Valpatel/gyropup/software/README.md

# Software

Code that controls the robot, runs experiments and presents the project. Firmware belongs here alongside its host tools.

| Home | What belongs here |
|---|---|
| [firmware/](firmware/) | Balance and turret firmware; the Feather rig node |
| [control/rig/](control/rig/) | CAN drivers, bridge, calibration and bench control |
| [simulation/](simulation/) | Robot, leg and turret models and numerical studies |
| [learning/](learning/) | Learning environments, training and learning-owned vendor fixtures |
| [site/](site/) | Browser application and website assets |
| [deploy/jetson/](deploy/jetson/) | Checkout-based Jetson installation and services |

[Contributing](../.github/CONTRIBUTING.md) explains checks and previews. [Physical progress](../docs/program/physical-progress.md) records what is actually received, printed and tested; software results do not establish hardware qualification.
