Valpatel/gyropup/tools/README.md

# Tools

Project commands grouped by their job. Run them from the repository root; heavy CAD, builds and simulations use the recorded remote-run procedure.

| Home | Purpose |
|---|---|
| [engineering/](engineering/) | CAD builders, studies, drawings and robot/leg/turret/rig helpers |
| [evidence/](evidence/) | Manufacturing packages, media and interface evidence producers and guards |
| [site/](site/) | Allowlisted website build, source locations, previews and publication checks |
| [acquisition/](acquisition/) | Supplier input acquisition and quoting |
| [audio/](audio/) | Pronunciation, recorded voice and voice-service tools |
| [operations/](operations/) | Repository and deployment operations |

[Tests](../tests/README.md) are separate from producers. A successful command does not itself qualify a physical part or release a print package.
