Valpatel/gyropup/docs/dossier/README.md

# Turret dossier sources

Start with the [current location and evidence guide](../turret/turret-sections.md#the-dossier-cad-agents-process).

- [Project requirements and interfaces](project.yaml)
- [Section cards](sections/)
- [Decisions](decisions.yaml) and [gate declarations](gate-declarations.yaml)

These are source declarations, with unresolved engineering acceptance. Existing geometry/status/gate records
are historical and include failures; current reconciliation remains in [program #31](https://github.com/Valpatel/gyropup/issues/31).
This folder is readable on GitHub and stays outside the generated site's document and download listings.
