Valpatel/gyropup/.agents/plans/owning-hierarchy/README.md

# Owning hierarchy migration — 2026-11-06

Working implementation under [#219](https://github.com/Valpatel/gyropup/issues/219), based on dev776d5f44 (tree equal to reviewed949b73c2). Independent map review accepted isolated implementation; final source/artifact/CI review remains required. The staged move set reduces25 root entries to15: eight conventional anchors and seven homes (.agents, .github, docs, hardware, software, tests, tools). No merge or runnable-state claim follows from a rename.

[Every tracked file](complete-file-destinations.json) has a collision-free destination. [Direct ownership](direct-file-ownership.md) explicitly groups CAD73/docs64/tools136. Supplier SOURCE/raw/normalized/frame/page bundles stay together under hardware/vendor; firmware/control/site/simulation/learning belong under software. Existing physical specs, CAD source and generated manufacturing evidence remain separate children. Docs is the reading entrance; tools and tests have populated owning domains, not flat catch-all lists.

[Service contract](service-contract.json) retains checkout deployment and fixes software.control.rig with explicit regular parent packages and actual module-origin proof. It preserves nine existing public bridge URL boundaries through a source whitelist, never a broad software directory root. [Supplier reconciliation](ignored-vendor-reconciliation.json) records211 ignored inputs without copying them; they remain unpublished with their acquisition/license/provenance boundaries. Learning vendor fixtures remain learning-owned. [Original-work reconciliation](original-work-reconciliation.json) maps and hashes200 dirty/untracked paths without adopting their payloads or touching the original checkout. The user authorized recovering paused work; missing old leases are not an indefinite permission block.

One atomic final-layout source/consumer migration is chosen because CAD reads firmware, catalog/designs, references and research; manufacturing and media receipts bind those producers. Preserve former CAD-test closure members when their tests move. Map actual producer/control commands and inputs/outputs before heavy work, run genuinely required generation/capture/slicing at the final source head, and retain failures. Old reports/ZIP/media retain their original identities and historical scope. Never reseal or weaken a guard to obtain green.

The initial2550 moves preserve every moved file byte. Imports, root discovery, project/workflow commands, publication identities and source-bound products are subsequent implementation work; this first stage is not runnable or merge-ready. Root-owned compact navigation237 is integrated normally before changing its visual files. Public source/route identities are preserved explicitly; all new private/vendor/learning homes require real all-output exclusion and sibling/link controls. #31/#219 and physical fit/run/material/HIL gaps remain open.
