Valpatel/gyropup/software/firmware/balance/README.md

# firmware/balance: Gyropup's balance controller (Nucleo-G474RE)

C for the STM32G474RE: three FDCAN buses at 1 Mbit/s (the legs' RS-04s on A and B; the VESCs and the J501 on C), the
VN-100 at 800 Hz, the INA228, the radio stop's sense and MCU_RUN, and a 1 kHz loop ported from `sim/controller_v2.py`,
with the 10S pack's windows (D65: warn, sit, the 3.0 V a cell cut-off, the jump gate; all in `include/gp/gp_config.h`),
the bus current limit, the Jetson's heartbeat and the people-near caps.
**docs/body-firmware.md** is the reference: architecture, timing, every CAN message, the safety numbers, the pins.

| Path | What |
|---|---|
| `include/gp/`, `src/core/` | the portable core: the law, the five-bar, the devices' protocols, the supervisor (no HAL) |
| `include/gp/gp_model.h` | generated by `tools/gen_model.py` from `build/sim/v2` (do not edit) |
| `src/mcu/` | the Nucleo: clocks, FDCAN, UART + DMA, I2C, timers, watchdog, `main.c`; the linker script |
| `src/host/` | the core as `libgp_host.so` for the HIL |
| `cmake/` | the arm-none-eabi toolchain file; ST's HAL and CMSIS fetched at configure time (pinned, hash-checked) |
| `tests/` | the core's unit tests (CI) |
| `hil/` | the HIL on the leg rig's emulated RS-04s and MuJoCo rig, and the robot run; `hil-results.json` its numbers |

```
cmake -S firmware/balance -B build/fw-mcu -DCMAKE_TOOLCHAIN_FILE="$PWD/firmware/balance/cmake/arm-none-eabi.cmake"
cmake --build build/fw-mcu                         # balance.elf / .bin / .hex
cmake -S firmware/balance -B build/fw-host && cmake --build build/fw-host && ctest --test-dir build/fw-host
GP_FW_HOST_LIB=build/fw-host/libgp_host.so python -m pytest firmware/balance/hil -q   # needs MuJoCo; build/sim/v2 for the robot
```
