Valpatel/gyropup/hardware/exports/rig/sendcutsend/README.md

# Carriage plate: the SendCutSend order

Generated by `cad/build_rig.py` with the plate it describes. Upload one of the two files; both are the same plate.

| | |
|---|---|
| Files | `carriage_plate.dxf` (flat, mm, 1:1, one layer, no text) or `carriage_plate.step` |
| Material | Aluminium 6061-T6, 0.250 in (6.35 mm) |
| Size | 300 x 320 mm, 6 mm corner radii; 1.611 kg |
| Quantity | 1 |
| Finish | Deburring on (both faces carry parts); no anodise, no powder coat |
| Operations | None: every hole is a clearance hole (no tapping, no countersinks, no bends) |
| Units check | The upload must read 300 x 320 mm (11.81 x 12.60 in); if it reads 25.4 times too big or small, re-upload in mm |
| Price | The instant price shown at upload (D40: no quotes); the estimate is $60-90. Backup: Xometry, instant price from the STEP |

## The holes (plate coordinates: the hip axis at 0, 0; x across, z up; seen from the front)

| Holes | Size mm | Where (x, z mm) | For |
|---|---|---|---|
| 6 x M5 clearance | 5.50 | (-83.0, 70.0); (0.0, 70.0); (83.0, 70.0); (-83.0, -70.0); (0.0, -70.0); (83.0, -70.0) | the hip frame's six flange inserts (M5 x 16 + washer from the back) |
| 16 x M4 clearance | 4.50 | (-33.0, -138.0); (-33.0, -112.0); (-7.0, -138.0); (-7.0, -112.0); (-33.0, 112.0); (-33.0, 138.0); (-7.0, 112.0); (-7.0, 138.0); (7.0, -138.0); (7.0, -112.0); (33.0, -138.0); (33.0, -112.0); (7.0, 112.0); (7.0, 138.0); (33.0, 112.0); (33.0, 138.0) | the four HGH15CA blocks (M4 x 10 from the front, into the blocks) |
| 2 x 3/8 in clearance | 10.50 | (-138.0, 40.0); (138.0, 40.0) | the two ballast posts (3/8-16 x 1 in from the front) |
| 1 x pin hole | 10.20 | (125.0, 140.0) | the drop test's quick-release pin (S4) |
| 1 x tether hole | 12.50 | (-125.0, 140.0) | the carriage tether's screwgate carabiner |
| 2 x M4 clearance | 4.50 | (-138.0, -104.0); (-138.0, -136.0) | the ToF target arm |
| 1 slot | 32.0 x 22.0 | (127.4, 22.4) | the front motor's lead (XT30 and GH plug) |
| 1 slot | 32.0 x 22.0 | (-131.3, -9.1) | the rear motor's lead (XT30 and GH plug) |

## On arrival

- Measure the thickness (6.35 mm, +-0.25) and the outline (300 x 320).
- Hold an HGH15CA block on each group of four M4 holes: the four screws must start by hand.
- With the hip frame's inserts set, the frame sits on the plate with all six M5 screws starting by hand (5.5 mm holes).
- The harness slots pass an XT30 plug and a GH plug together.
