Valpatel/gyropup/.agents/domains/mechanical-release.md

# Mechanical release coherence

Review entry point: [mechanical readiness](../../docs/architecture/mechanical-readiness.md). Keep CAD source, selected hardware, installed instances, public meshes, print files and instructions bound to one explicit configuration. Imported reports remain historical until the affected geometry and gates are rebuilt on that configuration.

`cad-agent check` reads existing reports; it is not a CAD rebuild. Run the appropriate geometry build and affected gates on the committed candidate, record source/toolkit/input/output hashes, and inspect the evidence. Keep visual completeness, assembly/clearance, fabrication readiness and physical acceptance separate. A valid solid, a successful render or an unchanged bearing boundary does not establish the other outcomes.

For articulated exports, review both conflicting and automatically merged coordinate conversions. Every cartridge-to-joint conversion is applied once. Verify actual rendered vertices against independent mechanical datums after regeneration, including attachments and effects. Preserve archived geometry for its recorded trajectory.

Portal coverage checks must compare complete identities against the served revision and BOM, rather than a hard-coded historical count. New components require their own matching geometry and thumbnail receipts; do not suppress a missing-image failure because the older release looked correct. Keep private manufacturer CAD private and identify public authored representations honestly.

Assembly verification includes preassembly, tool access and service/removal in the finished machine. A checker that only fits individual parts cannot certify a preassembled module merely by rearranging its steps. Require explicit module evidence until generic tooling can express the actual sequence. Continue to report unrepresented cables, missing measurements and unperformed physical trials.

Print packaging must use verified immutable input copies, bind resolved slicer profiles and the actual executable, reject failed/non-finite results, and derive totals only from accepted rows. Geometry-file coverage, successful slicing and physical qualification are separate states. See [the packaging incident](../inbox/2026-10-29-print-preflight-is-not-a-generation-transaction.md) and `tools/test-print-provenance.py` / `tools/test-print-packaging-mesh.py` for adversarial controls.

Resolve included printer templates as well as inheritance, and retain the actual sliced archive and G-code. Verify executed thermal waits, machine/material mapping and sliced placement; a filament label or successful time estimate can coexist with wrong startup commands. See [the included-template incident](../inbox/2026-10-30-slicer-includes-control-executed-temperatures.md).

An updated generator does not label already-published historical print files or instructions. Check direct document links and portal consumers of old print metadata, place historical status before actionable instructions, and distinguish a current bounded coupon package from an archived full kit. Keep the component register and readiness summary aligned with completed reviews and still-open qualifications. See [historical print-page status](../inbox/2026-10-29-historical-print-pages-need-local-status.md).

When withdrawing a torque, dimension or qualification claim from a generated page,
correct and test the generator as well as the published prose. Preserve source
closure rules even for prose-only CAD-directory edits; do not re-sign older reports.
See [withdraw instructions in the generator too](../inbox/2026-10-31-withdraw-instructions-in-the-generator-too.md).

Detailed thread models need source-bound mating clocking, not a generic intended-overlap waiver. Sampling may diagnose phase but cannot establish complete mating; a timed-out global check stays inconclusive. Keep seating, holes, engagement, tip clearance and physical insert coupons separate from that diagnostic. See [thread sampling limits](../inbox/2026-10-29-thread-sampling-does-not-qualify-mating.md).

Every insert joint and every printed part clamped by metal is screened in `research/insert-joints/` (pilot vs the
maker's hole and depth, screw tip vs a blind pilot's floor, boss, layer orientation, clamped plastic, pull-out from the
studies' loads). Regenerate it when a bound source line changes. A new layer in a screw stack needs the receiving
pilot and the contract's datum re-checked on both sides of the interface. See [the TM bottoming lesson](../inbox/2026-11-01-a-new-layer-in-a-stack-needs-the-receivers-pilot.md).

Insert-fit specimens must preserve their parent's local geometry and print orientation. A vertical carrier boss and horizontal base anchor need separate measurements. Record requested recipes, actual process conditions and physical observations independently; geometry-only3MF packages contain no slicer settings. See [the specimen orientation lesson](../inbox/2026-10-29-fit-specimens-must-preserve-layer-orientation.md) and `research/carrier-insert-fit/`.

Motor fasteners require actual head-seat and mounting-face measurements against the
manufacturer screw, followed by the drawing's usable-thread constraint. A deeper
STEP drill hole does not enlarge that constraint. Preserve the full parent stack
in mounting coupons and review neighboring rotating parts before changing seats.
Nominal reserve and engagement are not physical tolerance or thread-strength proof.
See [the RS-04 mounting incident](../inbox/2026-10-29-lug-depth-needs-measured-seats.md).

Treat an axial fastener-support screen as its stated geometric assumption, not
as a contact/preload solution. An interrupted ray may require a load-spreading
study; adding a washer or quoting a scalar FEA safety factor does not supply it.
Keep failed screens and unknown tightening loads explicit until suitable evidence
resolves them. See [axial support and local contact](../inbox/2026-10-30-axial-support-is-not-a-contact-model.md).

Small labels and narrow walls need inspection in actual deposited toolpaths;
source mesh preservation does not prove feature deposition or readable markings.
Keep missing-feature limits and blank physical measurement records explicit.
See [the shaft-gauge label incident](../inbox/2026-10-31-inspect-deposition-of-small-gauge-labels.md).
