Valpatel/gyropup/hardware/carrier-packaging/electrical-envelope.md

# Electrical inventory and packaging constraints — work in progress

This document owns the electrical side of [issue96](https://github.com/Valpatel/gyropup/issues/96). It does not change the native circuit or fabrication geometry. The source contract remains 15–20.5 V stand /30–42 V robot input, 12 V PAN output and a 3.25 A screening load; charged-front-output and transient bounds remain unqualified.

The initial reproducible inventory contains **47 electronic items**: 28 retained cutoff/converter candidate parts after replacing its series diode, all ten items in the LTC4359 Figure10 reference network, and nine legacy control-board parts after replacing the old converter. It is deliberately **not** a complete physical BOM yet: harness protection, actual junctions/terminations, connectors/contacts, retention and the heat path must also be assigned. [Inventory](component-inventory.json), generated by `python hardware/carrier-packaging/inventory.py`, binds the current reviewed circuit, legacy component source and catalog. P.*, I.* and L.* keep the three designator namespaces separate.

## Physical negotiation

Prefer retaining the entire PAN electronics with the removable carrier. The existing control board remains occupied; no schematic placeholder or old U2 reservation supplies extra area. An initial 18 mm assembled-height budget is a design question, not a measured envelope. No contour or physical stack is frozen.

The mechanical author's source inspection found that the current parked C3 body **and its mandatory 19.1 mm straight wire exit** obstruct a tall +Y addition during +X withdrawal. Lowering the entire board below that reservation is not sufficient: the fixed pan-base drip skirt occupies Z0..18 and is also crossed during withdrawal. These are concrete constraints on this service path, not proof that every possible layout fails.

A single alternative is being negotiated: a 90° turn of the fixed C3 housing at the outboard service position before inward parking, paired with a trial electronics region X4..48, Y53..93, Z23..41 mm. This **44×40×18 mm overall region is not allocated or validated space**. It extends beyond the current bumper; full cable, retention, seated/removal/parked geometry and thermal constraints remain to be checked. Components must be placed with real lands, per-side heights, mounting and terminal zones before accepting any board dimensions. The manufacturer's 40×40 mm thermal example is not the proposed outline's justification.

## Verified package evidence collected so far

[Primary source record](primary-envelope-sources.json) preserves observations and limits. Exact part bodies, manufacturer solder recommendations, optional library courtyards and additional design clearances must remain distinct.

- Panasonic EEUFC2A220: exact 8×11.5 mm nominal case; FC drawing tolerances give **8.5 mm maximum diameter and 12.5 mm maximum body length**, before lead/mounting and vent clearances. This exceeds a casual nominal-height-only model.
- Pololu5577: the manufacturer drawing distinguishes **6.1 mm above the PCB, 1.57 mm PCB thickness, and 1.4 mm below it** for items5570–5577. All three regions matter; profile tolerances are not supplied. Twelve electrical holes and three mounting holes require separate orientation/numbering and access checks. A zero-bottom-height box is invalid.
- TNPW0805: maximum body **2.1×1.4×0.55 mm** from the current manufacturer drawing; land recommendations are a separate input.
- WSL2512 10/20 mΩ: maximum body **6.604×3.434×0.889 mm**; the manufacturer's applicable land row gives **7.36×3.68 mm** total span. Shared Kelvin endpoints and copper routing remain additional constraints.

## Open source and interface gates

The actual LTC4359 Rev F PDF and Figure10 pixels have now been inspected independently by three agents. [Reference contract](front-reference-contract.json) binds the document and rendered schematic/pin-page hashes, exact physical U1/Q1 pin identities and every diode polarity. No new native circuit is generated. The floating VSS is separate from system GND. The 47 nF capacitor returns to floating VSS; the separately drawn CLOAD returns to system GND. The retained P.C1 sits **after the cutoff pair**, so it cannot be treated as permanently connected front-output capacitance. The front load's effective capacitance/leakage by cutoff state remains a circuit-validation obligation.

The DCB6 exposed pad is electrically NC in this paper proposal, following page11's guidance to increase effective spacing above 30 V. Pin6 still returns to floating VSS; the physical exposed metal is not omitted from the land envelope. Actual creepage, contamination/leakage and thermal behavior remain unresolved. The SHDN pin remains open as drawn in Figure10, with its leakage condition visible. This is not approval to route a compact high-voltage board merely because the IC fits.

[Package records](package-envelopes.json) currently provide primary evidence for all 47 electronic items; they distinguish maximum body dimensions, nominal module profiles and manufacturer lands. They do not establish a complete footprint/terminal inventory or a placement. Newly bound records include exact Diodes SOD523/SOD123/SMA variants, Vishay high-power1206 and Yageo axial resistor families. KEMET reflow pad extents are recorded separately from its larger placement courtyards; through-hole lead forming and solder stacks remain unresolved. The Panasonic valve requires at least 2 mm of free space: its upright maximum body plus valve allowance alone is 14.5 mm, before mounting, PCB, underside solder and insulation. The18 mm trial stack therefore cannot be accepted from nominal component heights.

The mechanical investigation now also holds the region on the bumper teardown sequence. The existing C3 support obstructs a pure upward rigid bumper lift, while some carrier/support fasteners require the bumper removed for the currently modelled straight tools. The proposed electronics overhang adds an obstruction. No new board placement is frozen while a viable rigid teardown path or explicit retention redesign is missing.

The conditional CJT A2505 servo connector from the previous carrier note has a **3 A family rating**, so it does not yet satisfy the current 3.25 A screening contract. Its OEM conductor/cavity mapping is also unverified. Do not allocate its envelope as a qualified final servo termination. Shared C2/C3 BUS remains raw BUS_HEAD_FUSED; protected PAN_INPUT must never become the slip-ring bus. CAN and TTL bypass routes still require actual endpoints and insulated retention; no unassigned pad strip can stand in for them.

Next: resolve the remaining formed-lead/delivery specifications and physical terminations, resolve the mechanical teardown gate, then create one explicit component/terminal assignment and per-side stack in agreement with the mechanical envelope. No new native circuit/CAD, purchase, powered test or fit/thermal qualification is produced by this inventory checkpoint.

## Reproduce the current bounded checks

Run `python hardware/carrier-packaging/inventory.py`, then `python hardware/carrier-packaging/allocation.py`, `python hardware/carrier-packaging/check.py` and `python -m unittest discover -s hardware/carrier-packaging -p 'test_*.py'`. Twenty-three tests include dropped/duplicate items, stale source or dimensions, improper readiness promotion, reversed clamps, grounded floating reference/capacitor and mistaken direct load-capacitor assignment, protected-PAN substitution on the raw C3 bus and a 24 AWG wire substituted into the original 28 AWG ring contact, and an omitted existing shunt lead at a junction. Exact unique interface IDs, every pin/net, all bypasses and junction members, endpoint agreement and legacy/protection ports are required before totals; deletion, substitution and duplicate controls cover each group. These are inventory/reference controls, not EDA/ERC, physical collision, thermal or waveform validation.

## Complete external net inventory, physical terminals still open

The [terminal contract](terminal-contract.json) enumerates all 21 external connector positions, three continuous CAN/TTL bypasses, the raw BUS and return junctions, the protected12 V split, nine legacy control components and adjacent F4/D8/D14/fuse-holder obligations. This is a net-to-endpoint inventory, not21 invented solder pads. Every source/return junction, physical protection-board termination, reset interface and strain-relief location remains unallocated.

The fixed C3 female43030-0010 contacts belong to the original 28 AWG ring leads; the removable male43031-0001 contacts use24 AWG tails. There is no existing24 AWG-to-female0010 qualification. Root's Alpha6712/6716 wire candidates have manufacturer5D bend figures, recorded with their exact maximum diameters and limitations. They are not selected substitutions for Pololu/Remington wire, do not define repeated-flex life, and do not change the fixed ring lead or its contacts.

## Obtainability is a dated source record

Each applicable inventory row now links the exact same-day reviewed supplier observation by source-file hash and row index. These are carried forward from the 2026-10-29 protection and architecture records; they are not a newly refreshed or reserved stock claim. Critical examples are LTC4368IMS-2#PBF (1,295 listed; one-piece tube offer), LTC4359IDCB#TRPBF (1,712 listed; cut tape; factory10 weeks) and IPB200N25N3GATMA1 (10,794 indexed; cut tape; factory52 weeks). See the linked records for exact URLs, price, pack quantities and limits.

The actual build supply remains unresolved: DDZ9699T-7 had only one cached Mouser item with refresh403 and zero DigiKey stock; Pololu5577 is rationed with no confirmed count/lead time; several exact resistors have uncertain stock or packaging. COUT now carries the exact C1206C473F1GECAUTO as an **unselected packaging candidate**:47 nF,100 V,1%,C0G, with a bound maximum body and manufacturer land record. The actual OUTsense-to-floating-VSS waveform, maximum clamp, pulse and temperature limits are unknown. A 75 V zener label does not establish a 100 V capacitor pass; a changed required rating/body requires replacement and renewed placement review. Its qualified selection remains null. No substitute, carrier/catalog selection, purchase or procurement pass is produced here.

The exact MF-R300 drawing supplies a 12 mm maximum width, 18.3 mm top-to-coating-end span and 3 mm thickness. Its bare lead length is only a minimum, and the installed flat form is not dimensioned. The legacy 12×14×3.5 mm box therefore does not establish actual fit. Its guaranteed hold-current table also drops from 3 A at 23°C to 2.04 A at 60°C; the 3.25 A load screen does not establish continuous operation through this unchanged F1. No fuse or circuit substitution is made here.

Littelfuse SMCJ150A dimensions are visually bound to the authorized 2020 mirror, with 2025 text-only corroboration distinguished. Overall terminal span8.13, width6.22 and height2.62 mm use the correct axes. Its solder dimensions combine minima and a maximum gap:9×3.3 mm is a proposed pattern, not a manufacturer maximum. Source-axis/minimum-versus-maximum negative controls preserve these distinctions.

## Retained control-board envelopes also need correction

Retaining the control function does not validate its old drawn boxes. The source-bound `cad/turret_boards.py` currently uses these simplified reservations:

| Item | Existing reservation | Exact-source limit | Contract consequence |
|---|---|---|---|
| NE555P | DIP8 height4.5 mm | TI PDIP maximum5.08 mm above its seating plane | Reserve the larger height plus actual mounting; the old box is not a complete body bound. |
| R3 RSF100 and D1 group | Height3.5 mm | RSF100 maximum body diameter5 mm | A horizontal resistor can exceed the group height before lead stand-off; actual placement and clearance remain open. |
| F1 MF-R300 | Flat12×14×3.5 mm | Manufacturer dimensions include an 18.3 mm coated span and only a minimum bare lead length | Define and validate the formed part; no flat installed maximum follows from the source. |
| R1/R2/C2/C3 group |12×5×6 mm combined box | Exact individual bodies and lead forms have separate limits | Assign every body, formed lead and pad; a group box does not prove four-part packing or routing. |

These are reservation mismatches or missing assembly evidence, not demonstrated collisions. The global11 mm legacy board height limit, tool access and solder-side space still need evaluation using real component placement. The new power-board proposal cannot silently consume the old converter box, retained control area or unallocated termination strip.

The bounded [paper allocation](paper-allocation.md) assigns all 47 electronics and lists every proposed control/power wire pad. Membership, omitted ground wires, net substitutions, erased vent/underside space and invented zero tolerances are rejected. This remains an allocation proposal without actual component placement.

The final TDK FG24 record binds the actual 2024 family drawing and exact part row. Its5.5 mm dimension reaches a formed-lead datum, and its bent leads extend outside the 4.5 mm coating width. The family pitch range4..6 mm conflicts with the older individual-sheet text range4.8..5.8 mm; both are retained by revision, and delivery-specification selection remains open. S1B uses the actual Rev24-2 SMA maximum height2.40 mm, not the older2.30 mm or neighboring SMB row. Copper land extents do not replace the complete part/lead envelope.
