Valpatel/gyropup/.agents/plans/end-packs-poster/plan.md

# Capture a fresh poster through the actual current hero hook

Source-only preparation, 2026-11-10. This branch starts at the model owner's
composed6dd7944b (reviewed media sourcec12 plus campaign target correction).
It owns only `tools/site/render-hero-poster.mjs`, focused CLI/output/identity tests
and this guidance. The renderer, current authority/converter/data, motion test,
reel source, README291 and CI fixes remain with their owners.

The existing producer captures `window.__heroPreview.capturePoster(1024)` and
hard-writes the public robot-poster.png. The hook itself is already the desired
single renderer: it restores the source `robot.info.homeHeight`, zero explosion,
reference camera/lighting and actual render. Current266 computes115/190 and hence
legMM300. Preserve that implementation; do not draw or pose a second model.

Prepare a required `--output` seam with a fresh exclusive file outside the source
checkout, reserving before any browser and preserving a failed partial rather than
truncating an existing file. Make its CLI/output checks import-safe and testable
with Node builtins only; no browser or package installation is required. Reuse the
reviewed reel checker's pure current-byte contract before a real launch, and bind
the actual hero identity/224source names/sourcehome300 and applied base position
before writing a successful image. Keep the historical acknowledgement helper exact.

The static poster must use the canonical300mm home through the existing hook.
The reel deliberately animates variable height/roll/sway; current demo center.6
maps to299mm before authored variation. Root explicitly chose to preserve that
animation, not alter product behavior for1mm. Record actual pose values and limits
per action; shared body/battery/printed-leg/native authority does not mean every
video frame has the static poster pose.

Future action preconditions: complete corrected current motion campaign and
independent acceptance; exact composed source review; separate committed current
manifest/authority adoption; fresh byte/source/runtime/capacity checks; exact
one-action packet review. Native3a, collection7c2f1905, manifest31838706 and all80
printed-leg identities must remain unchanged. Default null authority still blocks
new capture. Chrome's earlier2e90 test target filename failure and its partial
geometry samples remain a failed campaign, not media/capture acceptance.

Use the existing ephemeral server and actual browser, PNG hook, fixed-step reel
recorder, FFmpeg encoder and validators. No new framework, geometry, physics,
installer or public adoption. Proposed separate poster phase90s and full reel
capture20min/encode10min/validation5min inside45min4CPU/8GiB rendering action are
bounded proposals, not measured new-model timings or execution permission.
Historical rig/E1 inserts and original dated source/receipts remain exact.
