Valpatel/gyropup/.agents/plans/hip-study/geometry-interface-proposal.md

# Issue 8: geometry/interface-only preparation proposal

Status: read-only proposal, not source or execution clearance. The published baseline is main cacdc2e3e8ce2ed40d0b8a2369aa5455b149f65a (tree f444d949eeaa0c8f127be02b87a04f10a0ae83d4, hardware 89ae8db4a748d5b19893293fbef3c1d49eeccc2f). PR261/262 repairs only input preflight; actual production and remote retirement are independently accepted. All exact-main workflows are independently accepted SUCCESS at issue #8 comment 6714250623. No CAD source has changed and no new native run has occurred.

The current E1 result remains SF 1.60 against 2.00 required. The retained 3 mm E1 gate is 1.40 and its y-layer screening result 1.36; R3o and other layer failures also remain. The regenerated field hotspot and retained print-ready element peak are in the same knee-out backing-block region, but have different exact coordinates. No threshold, material allowable, load, mask or convergence criterion is changed by this proposal.

First finite question: what is the actual continuous backing-block foot and which edges can accept the original whole-foot blend? The current source already names this unfinished task; knife-edge extensions and the earlier boss-side revolved fillet failed. Source inspection alone does not establish a safe complete edge selection. Do not choose numeric BREP edge indices or assume that a complete foot is a single closed loop. The existing 3.5 mm STOP_EAR_FILLET is only the first eventual screening radius, not an adopted correction.

Proposed first packet is ONE import-only topology inspection of the already accepted current STEP, not a new CAD build. Pin `hardware/exports/leg/rs04-mounting-fit/hip_frame.step` (3,139,533 bytes; SHA256 `7c181d5a524cb2fd432d49ed4a990aae9e163b08402bf06be516bb37d749c8dc`) together with its exact current receipt/Git blob. All 94 receipt source hashes match current main. The actual producer exports `fb.hip_frame()` without a STEP rotation (the print rotation applies to STL only); the file declares millimetres. Its opaque DATA bytes exactly equal the root leg STEP. This supports reuse of the retained solid, not a new parametric/physical equivalence claim. The lug receipt's actual failed checks and physical limitations remain unchanged.

Import that exact STEP into owned scratch with the existing pinned CadQuery/OCP runtime. Do not import the product CAD builder or invoke precheck/leg_parts in this first packet. Record import validity/solid count, volume/bounds and finite face/edge connectivity in the STEP frame. Preserve the original STEP bytes; do not re-export a replacement or write engineering outputs. CAD-derived mass, if reported from catalog density, is not a weighed value. This imported topology does not establish fresh interface clearance or an exact future parametric edge selector.

Fresh `source_hashes`, source `precheck`/`interfaces` and actual baseline parameters remain separate mandatory gates before any candidate evaluation or FEA. Before a future builder baseline imports the study/fivebar module, reject inherited `GYROPUP_` variables: `use_params(out,None)` does not clear `GYROPUP_HIP_PARAMS`. Bind explicit no-parameter-file/effective HIP defaults and require a native-blocked injected-override negative. Do not substitute an imported solid for that future source-based check, and preserve a failed baseline interface result without moving BODY_ZT or clearance limits to obtain green.

The later candidate source proposal should blend the whole foot on a local solid while keeping the motor-clearance cut, inserts/mount plane, old supported material, body and bed interfaces. It must be reviewed against the actual baseline topology first, reject ambiguous/missing selections and invalid/multiple solids, and report a bounded changed-volume region plus actual interfaces. No candidate implementation, fillet sweep or automatic fallback is selected here. Its geometry-only evaluation is a separate reviewed packet, before any baseline/candidate 3 mm E1 solves.

Operational proposal for the first inspection: the same existing compute-host OS-user boundary and strictly read-only recovered v0.6.0 runtime used for the genuine E1 solve, with exact package/toolkit/interpreter and actual mapped-library checks and complete before/after environment identities. No install or permission change. Four actual affinity CPUs, 24 GiB address-space ceiling, fresh at least 32 GiB MemAvailable, 600 s native wall and CPU budget consistent with four cores, 8 GiB owned scratch watcher, outer 1800 s. These are proposed bounds, not measured inspection requirements; exact source/config/runtime/command/operator and lifecycle controls still require independent review before one invocation. No local native import/build or live GUI.

The collector must enforce clean immutable source origin, complete current 94-member receipt binding plus exact STEP/receipt/driver/config/runtime identities, and whole hardware/tracked preservation before/after, owned caches only, quiescent process groups before archive/cleanup, preserved primary plus independent guard/archive errors, regular-only sealed outputs and a nonzero failure on missing final receipt. Keep actual failed output. No automatic repeat, adoption, engineering-receipt reseal, field/media regeneration, native FE solve or physical qualification is cleared by this document. After the retained-solid topology is reviewed, prepare the smallest builder-specific candidate-selection and fresh interface-check source proposal; strength/convergence work remains separately gated.
