Valpatel/gyropup/tools/evidence/manufacturing/fit-job-requirements.txt

# Lightweight mesh/package verification; no CAD kernel, solver or printer SDK.
numpy==2.5.4
trimesh==5.2.0
matplotlib==3.11.2
PyYAML==6.0.3
scipy==1.18.1
