Valpatel/gyropup/.agents/SYMPTOM-INDEX.md

# Symptom index

- Retained fit CI rejects an old full source closure after a body change: [separate historical integrity from current geometry correspondence](inbox/2026-11-10-archival-integrity-needs-explicit-input-ownership.md).

| Symptom | Canonical guidance |
| --- | --- |
| A current Print disclosure stalls at native actionability despite stationary visible samples | [Explicit pointer and keyboard coverage with exact-target checks](inbox/2026-11-10-browser-harnesses-need-current-and-archive-bindings.md#2026-11-11--diversify-redundant-print-disclosure-input-coverage) |
| A container build stops at Git dubious ownership before browser arms start | [Mounted workspace Git identity](inbox/2026-11-11-mounted-workspaces-need-git-identity.md) |
| Instructions are delivered to a completed worker but no new turn or progress follows | [Wake completed workers explicitly](inbox/2026-11-11-handoffs-must-wake-idle-workers.md) |
| Diagnostic controls pass but temporary paths, WebSocket endpoints or about-query values survive serialization | [Diagnostic redaction formats](domains/loading-readiness.md) |
| Layout completes its views but simulator readiness times out with no current scene or request evidence | [Readiness failure observations](domains/loading-readiness.md) |
| HTML has a deep evidence link but generated Markdown drops it after a semantic nav change | [Content navigation conversion](domains/static-build.md) |
| A capture packet pins the new source but a live phase still accepts an archived served revision | [Live phase source binding](domains/structural-media.md) |
| A functional homepage check passes but a resting capture shows a displaced skip link, blank canvas or lazy offscreen picture | [Landing capture preconditions and claim limits](domains/landing-preview.md) |
| A first-load failure route sees no request after a model round trip, and the selection never reverts | [Loading fixture cache ownership](domains/loading-readiness.md) |
| A cached CAD illustration has new source headers but old body membership, or native and projection runtimes are conflated | [Bind original collection and new projection consumer separately](inbox/2026-11-10-cached-projections-need-separate-consumer-provenance.md) |
| Small mode-switch doubles pass but recorded-only model construction fails or metadata remains on the previous body | [Exercise the real archived constructor and atomic holder](inbox/2026-11-10-atomic-model-switches-need-real-archive-construction.md) |
| A collection differs from an isolated module default, or sampled bounds suggest a changed nominal radius | [Trace effective overrides and actual bound geometry first](inbox/2026-11-10-collection-geometry-needs-effective-runtime-parameters.md) |
| Removing a model factory breaks unrelated quotes, a fresh-output guard breaks simulation callers, or pack bounds move sensor effects | [Trace actual caller contracts and canonical sensor datums](inbox/2026-11-10-current-labels-need-the-current-body-model.md#model-api-changes-need-real-consumer-call-paths) |
| A latest/current robot view retains a belly battery despite a front/rear-pack plan | [Trace actual current body geometry and preserve historical recordings](inbox/2026-11-10-current-labels-need-the-current-body-model.md) |
| A screenshot times out after “fonts loaded” while interaction observations pass | [Time the original capture phases without clearing its failure](inbox/2026-11-10-screenshot-deadlines-need-timed-capture-phases.md) |
| Fonts/layout return but Page.captureScreenshot has no observed reply at the deadline | [Localize the observed boundary without claiming a cause or retrying](inbox/2026-11-10-screenshot-deadlines-need-timed-capture-phases.md#a-sent-native-capture-without-an-observed-reply-localizes-only-a-boundary) |
| A preparation manifest preflight tries to open schema as a file | [Read the envelope before its file-hash entries](inbox/2026-11-11-review-preflights-must-follow-the-repository-contract.md#read-the-manifest-schema-before-iterating-its-file-hashes) |
| Screenshot production needs a different budget from product interaction readiness | [Keep a finite artifact bound and verify the actual timeout path](inbox/2026-11-10-screenshot-deadlines-need-timed-capture-phases.md#2026-11-11--distinguish-an-artifact-budget-from-product-readiness) |
| A held-font screenshot control times out in Chromium but returns an image in WebKit | [Treat demonstrated stalls as engine-specific evidence](inbox/2026-11-10-screenshot-deadlines-need-timed-capture-phases.md#a-demonstrated-stall-is-engine-specific) |
| A playing→paused contextual click moves even though status height and scroll range stay constant | [Preserve existing playback text nodes during genuine pause](inbox/2026-11-10-playing-pause-must-preserve-text-nodes.md) |
| Flip/Rotate miss after a capture-time pause refresh despite a valid initial hit | [Leave unchanged native controls untouched during playback refresh](inbox/2026-11-10-no-op-playback-renders-must-preserve-native-controls.md) |
| A Reset button gets pointerdown/focus but leaves old model or section state | [Keep pointer-focused actions fixed until native click completes](inbox/2026-11-10-pointer-focus-must-not-move-panel-actions.md) |
| Isolate succeeds, but the selected-part popup intercepts the real model point | [Keep selected details inside reserved viewer space](inbox/2026-11-10-selection-details-need-reserved-viewer-space.md) |
| Projected vertices are unoccluded and hit tests pass, but the model is still tiny | [Require useful model space as well as non-overlap](inbox/2026-11-10-camera-acceptance-needs-useful-model-space.md) |
| A sideways phone keeps three desktop panels despite touch emulation | [Use actual input and height when choosing the compact layout](inbox/2026-11-10-phone-landscape-needs-input-aware-layout.md) |
| Desktop instructions jump to a bottom sheet, an expanded card covers panel controls, or intermediate widths leave too little model space | [Budget all desktop docks together across window modes](inbox/2026-11-10-desktop-docks-need-a-shared-space-budget.md) |
| A CLI writes a failed gate report but its shell exit is zero | [Propagate failure returns through the actual process entry point](inbox/2026-11-10-cli-failure-returns-must-reach-the-process.md) |
| A build part passes through installed geometry despite a clean final pose, or flipping its direction hits a different obstruction | [Bind arrival paths to installed dependencies](inbox/2026-11-10-clean-final-assembly-pose-does-not-validate-arrivals.md) |
| A build viewer looks blank during mesh downloads, or a progress bar counts the pending part as complete | [Count validated loader completions](inbox/2026-11-10-loader-progress-must-count-completed-parts.md) |
| A robot is tiny despite a large canvas, stable guide rectangles hide controls, or narrow screenshots use desktop height | [Fit visible geometry and test actual overlay hit targets](inbox/2026-11-09-assembly-overlays-need-visible-bounds-and-hit-tests.md) |
| A named, hashed manufacturing original is offered as matching a newly collected assembly part | [Keep file identity separate from accepted geometry correspondence](inbox/2026-11-10-manufacturing-links-need-geometry-correspondence.md) |
| A native identity guard rejects a known package file after resolving it outside the venv | [Bind the predeclared file link and exact target identity](inbox/2026-11-07-native-origins-must-bind-declared-symlinks.md) |
| A baseline caller passes no parameters but inherits an earlier HIP variant | [Reject inherited scenario variables before CAD import](inbox/2026-11-07-baseline-builds-must-reject-inherited-parameters.md) |
| A fleet request with `--node cpu-a` is refused before a job exists | [Use the actual scheduler selector privately and the alias publicly](inbox/2026-11-05-ci-classification-needs-phase-evidence.md#fleet-aliases-are-reporting-labels-not-scheduler-selectors) |
| A current CAD package reader still dynamically imports an old flat module name | [Fix canonical consumers and refresh their actual source-bound evidence](inbox/2026-11-05-root-moves-need-consumer-and-publication-maps.md#dynamic-imports-need-canonical-package-paths-too) |
| A check summary says failed but the executed phase may be provisioning, a global cancellation, or a true assertion | [Classify phases and actual attempts before changing a check](inbox/2026-11-05-ci-classification-needs-phase-evidence.md) |
| A final retrieval still contains `probe-incomplete.json` from an earlier live fetch | [Preserve partials and extract the sealed final product freshly](inbox/2026-11-05-ci-classification-needs-phase-evidence.md#incremental-retrieval-can-retain-an-earlier-partial-product) |
| A native study reads current reports but fails while hashing legacy receipt paths afterward | [Preflight study input identities before native work](inbox/2026-11-05-root-moves-need-consumer-and-publication-maps.md#study-input-identities-must-be-checked-before-the-native-solve) |
| A passing media guard emits historical negative-control stderr before its JSON | [Keep structured output and diagnostics in separate streams](inbox/2026-11-05-ci-classification-needs-phase-evidence.md#structured-guard-output-must-stay-separate-from-seeded-negative-stderr) |
| A retrieved product omits nested `src` files, or generated engineering indexes differ only in version queries | [Verify complete retrieval and bound generated-query comparisons](inbox/2026-11-05-ci-classification-needs-phase-evidence.md#compare-generated-cache-queries-without-exempting-engineering-outputs) |
| Production reports a new version but a changed document still has preceding-source bytes | [Verify actual version, bytes and routes together](inbox/2026-11-05-ci-classification-needs-phase-evidence.md#a-new-version-response-is-not-complete-publication-evidence) |
| An asynchronous Playwright wait predicate returns false but polling finishes immediately | [Use synchronous acceptance polling and bounded native completion states](inbox/2026-11-05-layout-readiness-must-wait-for-fonts-not-global-load.md) |
| A paused PR says its dependency or implementation is missing, but later commits/reports may already exist | [Resume from the actual tree and reports](inbox/2026-11-05-paused-work-needs-the-actual-head.md) |
| A draft's numeric limits are described as already released on main | [Keep each limit tied to its own branch](inbox/2026-11-05-paused-work-needs-the-actual-head.md#keep-draft-limits-separate-from-the-published-branch) |
| A logical directory move changes public files/pages or breaks a module/service despite unchanged contents | [Map ownership, publication and import contracts before moving](inbox/2026-11-05-root-moves-need-consumer-and-publication-maps.md) |
| A research move turns a historical-file notice back into a broken catalogue link while text checks pass | [Check retired targets in their moved source context](inbox/2026-11-06-retired-links-need-their-moved-source-context.md) |
| Production RS-04 shutdown returns while its reader is alive, or Python 3.12 cancellation waits on connected clients | [Runtime ownership](domains/rs04-runtime-lifecycle.md), [production shutdown incident](inbox/2026-11-06-runtime-shutdown-must-finish-before-loop-closure.md) |
| Tests report OK, then Python aborts with `_enter_buffered_busy`, or teardown leaves daemon threads/accepted sockets alive | [Test-owned asynchronous resources](domains/test-lifecycle.md), [RS-04 shutdown incident](inbox/2026-11-06-test-close-must-finish-owned-threads.md) |
| A motor-day picture refresh changes STL bytes while keeping old slice estimates | [Preserve the independent mesh/slice snapshot](inbox/2026-11-05-picture-refresh-can-change-retained-slice-inputs.md) |
| `motor_day --no-render` keeps stale pictures after an explode-offset or camera edit | [Bind all step visual inputs before reuse](inbox/2026-11-05-render-reuse-needs-explode-and-camera-inputs.md) |
| Layout checks time out on a small pending resource despite visible content and loaded fonts | [Measure after real font readiness, not global load](inbox/2026-11-05-layout-readiness-must-wait-for-fonts-not-global-load.md) |
| `?sound=0` is briefly ignored while talk mounts and an optional import is delayed | [Apply the audio query before mounting consumers](inbox/2026-11-05-audio-query-must-precede-optional-imports.md) |
| Pages rejects a relocated Wrangler file with “custom paths” unsupported | [Find the config through the command working directory](inbox/2026-11-05-pages-deploy-needs-config-working-directory.md) |
| A README image is broken, oversized, or hides its ordinary navigation links on the site | [README images and single-URL picture alternatives](inbox/2026-11-02-readme-images-need-src-not-srcset.md) |
| A browser reports an untrusted certificate while a DNS firewall names a blocked domain or name server | [Failing-path evidence and domain-age limits](inbox/2026-10-30-dns-filter-warnings-need-the-failing-path.md), [public HTTPS receipt](../docs/validation/public-https.md) |
| Local services fill with old branch previews, or dependency symlinks look like unfinished work | [One shared preview and bounded test listeners](domains/site-preview.md), [incident](inbox/2026-10-29-preview-servers-need-one-owner.md) |
| Valid supplier connector solids overlap when mated or omit wire-entry holes, contacts or latch details | [Vendor solids can omit functional cavities](inbox/2026-10-29-valid-vendor-solids-can-omit-connector-cavities.md) |
| A TVS breakdown or nominal cutoff looks safe but peak voltage, recovery or shared-branch loads remain unbounded | [Electrical protection limits and evidence](domains/electrical-protection.md) |
| Reverse-input rating looks sufficient but a charged output violates differential limits, or startup trips despite a nominal current margin | [Charged reverse stress and actual startup budget](inbox/2026-10-29-charged-output-changes-reverse-input-stress.md) |
| Supervisor startup passes using a headline delay despite an installed delay capacitor or different pullup/loading | [Timing test conditions and actual topology](inbox/2026-10-29-charged-output-changes-reverse-input-stress.md#review-correction-startup-timing-depends-on-the-installed-delay-network) |
| A low-loss reference circuit appears to fit, but its floating clamps, startup or thermal copper are omitted | [Complete reference topology and actual thermal/fit boundaries](inbox/2026-10-29-reference-circuit-thermal-area-is-not-carrier-fit.md) |
| A datasheet supplies only flattened labels, or a PDF download returns an HTML viewer despite HTTP 200 | [Inspect actual schematic source pixels](inbox/2026-10-29-schematic-connectivity-needs-actual-source-pixels.md) |
| Hidden power pin, unexpected VIN net, generated schematic differs from intended net map | [Exported EDA connectivity](domains/electrical-protection.md), [incident and regression](inbox/2026-10-29-hidden-power-pins-can-create-unintended-global-nets.md) |
| Supplier stock exists but exact rating, wire seal, retail pack or part identity does not match the assembly | [Supplier evidence and exact part identity](domains/supplier-evidence.md) |
| CAD branches merge but the model, print kit, BOM or validation reports describe different revisions | [Mechanical release coherence](domains/mechanical-release.md) |
| A motor screw engagement comment disagrees with its actual seats, a drill-depth model overstates usable thread, or a fit coupon omits parent features | [Measure seats and preserve the parent specimen](inbox/2026-10-29-lug-depth-needs-measured-seats.md) |
| Regenerating an assembly page restores a withdrawn torque, dimension or qualification claim | [Withdraw instructions in their generator too](inbox/2026-10-31-withdraw-instructions-in-the-generator-too.md) |
| A fastener support ray crosses a factory recess, or an old torque value has no joint-validation source | [Axial support is not a contact model](inbox/2026-10-30-axial-support-is-not-a-contact-model.md) |
| Repeated exact relation queries stall without checkpoints, or a broad-phase bound is presented as measured clearance | [Batch relations with explicit distance bounds](inbox/2026-10-31-batch-relations-with-explicit-distance-bounds.md) |
| Entry warning loses focus, hides controls, or changes saved audio/scene state | [Prototype notice](domains/prototype-notice.md) |
| A page shows large blank stretches on a phone, or a full-page screenshot shows empty picture boxes | [Empty space is measured per screen](inbox/2026-11-03-empty-space-is-measured-per-screen.md) |
| Home repeats stale CAD, mass or study status despite intact source records | [Keep the entrance evergreen and the engineering state on its evidence routes](inbox/2026-11-10-home-should-link-to-engineering-state.md) |
| Motto or landing graphics feel cheesy despite passing layout checks | [Gyropup visual character](domains/brand-presentation.md) |
| A motor, wheel, feed dial or flap orbits outside its assembly while animating; static bounds still pass | [Rendered mechanism frames](domains/rendered-mechanisms.md) |
| A simulated motion sample wait times out after the applied pose passes | [Retain animation state and frame progress at the failed wait](inbox/2026-11-11-simulated-samples-need-frame-evidence.md) |
| Upper links move while output adapters or their screws remain fixed to the robot body | [Output-adapter ownership](inbox/2026-10-29-output-adapters-belong-to-upper-links.md) |
| Static build succeeds but a new simulator module returns 404 or the page never initializes | [Static build module references](domains/static-build.md) |
| A network-failure test passes but its fixture never intercepts a versioned module | [Versioned imports and verified fixtures](domains/static-build.md) |
| Buttons appear correct but keyboard, pause, overlays or reload behave differently | [Playground interactions](domains/playground-interactions.md) |
| A fresh simulator clips the robot above the screen, but resizing or switching models repairs it | [Late overlay layout and camera insets](domains/playground-interactions.md) |
| Loading poster and interactive hero jump in pose, scale or background | [Landing preview handoff](domains/landing-preview.md) |
| Hero handoff assertion changes by a fraction of a pixel after font loading or a screenshot | [Separate font/capture setup from the handoff](inbox/2026-10-29-measure-handoff-after-font-and-capture-setup.md) |
| Loading-hero test sees the hero move by whole pixels (e.g. 20 px at 844×390) only on CI or under load | [Take the baseline after the screenshot](inbox/2026-11-02-loading-hero-baseline-before-screenshot.md) |
| Current pages show different robot versions, or archived balls miss a newly swapped barrel | [Current models and physics archives](domains/rendered-mechanisms.md#current-models-and-physics-archives) |
| Model bounds pass but speech hides the robot, or a fresh wide phone looks worse than resized tests | [Visible mechanism layout checks](domains/rendered-mechanisms.md) |
| A Talk landscape check projects portrait model bounds into the new CSS canvas | [Observe the viewport change and a real draw before measuring](inbox/2026-10-29-fresh-layouts-must-test-fixed-overlays.md#resize-observations-need-the-committed-camera-and-draw) |
| A failed download looks unpublished, a partial model looks ready, or a retry overwrites newer data | [Loading readiness and report availability](domains/loading-readiness.md) |
| An immediate archived-model retry reuses a failed sibling download | [Finish the failed archive cohort before retry](inbox/2026-11-11-failed-archive-cohorts-must-settle-before-retry.md) |
| A study shows a zero-second player, or a valid encoded movie is frozen or mislabels static analysis as transient physics | [Structural media and recorded evidence](domains/structural-media.md) |
| Video works in local Chrome but CI Chromium reports no supported streams or never reaches ready | [Chrome and Chromium codec coverage](inbox/2026-10-29-chrome-and-chromium-do-not-share-video-codecs.md) |
| Highlights reject `Source changed: software/site/designer/kit/stage.js` after a lifecycle correction | [Capture changed renderer inputs freshly](inbox/2026-11-10-stage-lifecycle-changes-need-fresh-media.md) |
| Copied rendering dependencies match by hash but Node cannot resolve a sibling import | [Smoke-test the real staged package layout](inbox/2026-11-10-stage-lifecycle-changes-need-fresh-media.md#smoke-test-the-real-staged-package-layout) |
| A movie's neighboring report or current model has changed, or a capture has the wrong aspect ratio | [Recorded evidence and capture dimensions](domains/structural-media.md) |
| Video plays initially but WebKit replay fails with an unexpected HTTP 200 range response | [Local and production media ranges](domains/structural-media.md) |
| Isolated video tests pass but real-page autoplay stalls or times out CAD parts on a slow connection | [Integrated media loading and buffering](domains/structural-media.md) |
| Replay stalls with a full buffer, or late readiness starts an offscreen movie download | [Native recovery and current visibility](domains/structural-media.md) |
| A moving replay hits its recovery timeout, or a fresh motion preference precedes its change event | [Frame-progress watchdogs and current preferences](domains/structural-media.md) |
| Playback and replay work but the finished player presents duplicate actions or loses keyboard focus | [Distinct player-action ownership](inbox/2026-10-30-player-actions-need-distinct-state-ownership.md) |
| A second virtual-clock fixture fails inside Playwright before navigation | [Isolate virtual-clock browser contexts](inbox/2026-10-29-virtual-clocks-need-isolated-browser-contexts.md) |
| A native navigation works but its test rejects Cloudflare canonicalization or a queryless static Back link | [Exact canonical navigation routes](inbox/2026-10-29-hosted-navigation-must-accept-the-canonical-route.md) |
| An FEA gate differs between compute hosts, or a coarse-mesh peak passes and then fails when refined | [Name the mesher and check the winner finer](inbox/2026-10-31-a-gate-at-one-mesh-needs-its-mesher-and-a-finer-check.md) |
| A toolkit's material data change and the FEA safety factors are projected by rescaling the record, or a projection's counts do not match the repository | [Rescale the stress, re-run for the design](inbox/2026-11-01-rescale-the-stress-rerun-for-the-design.md) |
| A mesher fails with OpenSSL symbols despite gmsh-first imports, or runtime version lookup fails after solving | [Select the mesher runtime before Python starts](inbox/2026-10-29-mesher-runtime-must-be-selected-before-python-starts.md) |
| A STEP worker surfaces a null-reference error despite empty HTTP/page-error arrays, or a fresh rerun passes after a reader failure | [Imported assembly errors and unresolved WebKit investigation](inbox/2026-10-29-review-the-imported-assembly-not-only-the-export.md#a-later-passing-import-does-not-erase-an-intermittent-reader-error) |
| A model reports ready but disappears or contains non-finite transforms after valid JSON loads | [Loading readiness and report availability](domains/loading-readiness.md) |
| A viewer's error/retry controls clip off a phone despite hidden page overflow | [Grid tracks and header minimums](inbox/2026-10-29-shrink-grid-tracks-before-truncating-headers.md) |
| Build thumbnails are missing, show unrelated parts, or disappear after publishing | [Part image identity and provenance](domains/part-images.md) |
| Sheet thickness or dimensional bounds change after STL export without a CAD edit | [Tessellation bounds versus stock dimensions](inbox/2026-10-29-tessellated-bounds-are-not-stock-dimensions.md) |
| Part status moves to another row after sorting, retries duplicate controls, or a model preview loses its original download | [Parts retain their identity when their table changes](domains/build-portal.md) |
| A newly integrated CAD viewer opens but disposal throws or its animation keeps running after removal | [Parts retain their identity when their table changes](domains/build-portal.md) |
| A page or panel stays light in the dark theme, light text vanishes on a pale panel, the theme flashes on load, or a 3D sky/diagram ignores the theme button | [Light and dark themes from one token file](domains/site-theme.md) |
| The 3D file viewer looks unrelated to the main site or its controls lose contrast | [Original-file viewer theme](domains/file-viewer-theme.md) |
| Phone status checkboxes remain reachable but their part names disappear, despite sticky cell styling | [Sticky identity and the scroll wrapper](inbox/2026-10-29-sticky-part-identity-needs-the-scroll-wrapper.md) |
| Wheel tests fail after a fixed sleep under software rendering | [Wait for rendered camera targets](inbox/2026-10-29-camera-tests-must-wait-for-rendered-targets.md) |
| A PCB is seated without overlap but cannot be installed, reached with a driver, or removed | [Final pose does not prove electronics service](inbox/2026-10-29-final-pose-does-not-prove-electronics-service.md) |
| A removable board has wire lengths but no verified disconnect travel, retained slack or wire exit | [Cutting allowance is not service slack](inbox/2026-10-29-wire-allowance-is-not-service-slack.md) |
| A bounded CAD check stays green after a configuration edit, or invalid Boolean geometry reports zero overlap | [Full input closure and valid Booleans](inbox/2026-10-29-bounded-cad-checks-need-full-inputs-and-valid-booleans.md) |
| A manufacturer check turns green when its private CAD cache is missing | [Manufacturer checks must reject missing inputs](inbox/2026-10-29-manufacturer-checks-must-reject-missing-inputs.md) |
| A McMaster lookup reports no specification table or no CAD controls | [Verify the rendered cause](inbox/2026-10-29-missing-product-table-needs-rendered-evidence.md) |
| Print hashes pass but package mixes revisions, slicer settings or stale totals | [Preflight is not a generation transaction](inbox/2026-10-29-print-preflight-is-not-a-generation-transaction.md) |
| Slicer reports success but executable temperatures or placement differ from the declared profiles | [Included printer templates and executable checks](inbox/2026-10-30-slicer-includes-control-executed-temperatures.md) |
| Old print instructions look current even though source guards reject their exports | [Label historical print pages at their entry points](inbox/2026-10-29-historical-print-pages-need-local-status.md) |
| Demo hit counts increase but targets stay upright, detach, or clip through the floor | [Hits must produce visible, validated motion](inbox/2026-10-29-target-hits-need-visible-motion.md) |
| Published notes show Mermaid source instead of a diagram | [Validate the published diagram consumer](inbox/2026-10-29-mermaid-needs-the-published-renderer.md) |
| Thread-ray samples improve after rotation but the complete mating relation is unproved or times out | [Sampled thread alignment is not complete mating](inbox/2026-10-29-thread-sampling-does-not-qualify-mating.md) |
| A STEP loads but all parts/reservations look identical, or an unexplained ready-only timeout loses its diagnostics | [Review the imported assembly](inbox/2026-10-29-review-the-imported-assembly-not-only-the-export.md) |
| Native design files are downloadable but notes are unlisted, or a drawing opens cropped at paper width | [Engineering files need a usable portal](inbox/2026-10-29-downloadable-cad-notes-still-need-a-usable-portal.md) |
- Insert coupon passes but parent fit is unknown; horizontal versus vertical pilot; geometry-only3MF confused with a sliced print → [Preserve parent specimen orientation](inbox/2026-10-29-fit-specimens-must-preserve-layer-orientation.md), `research/carrier-insert-fit/`.
- A failed CAD receipt passes after its failed check or output manifest is deleted → [Require complete evidence membership](inbox/2026-10-29-receipt-coverage-must-not-be-optional.md), `tools/test-carrier-connector-support.py`.
| Progress looks stale, the useful simulation is buried, or links cannot open collapsed reports | [Progress publication and readable history](domains/progress-publication.md) |
| A leg-rig movie has the right scenario filename but may belong to an older report | [Recorded movies need report identity](inbox/2026-11-05-recorded-rig-movies-need-their-report-identity.md), [Progress publication](domains/progress-publication.md) |
- Terminal count stays correct after a CAN bypass, return, protected feed or interface identity is corrupted → [Require complete terminal membership](inbox/2026-10-29-receipt-coverage-must-not-be-optional.md#terminal-inventories-need-membership-checks-before-counts), `hardware/carrier-packaging/test_inventory.py`.
| A valid gauge STL and successful slice lose small raised labels | [Inspect actual small-feature deposition](inbox/2026-10-31-inspect-deposition-of-small-gauge-labels.md) |
| A screw stack gains a layer (plinth, spacer, washer) and its screws bottom in blind insert pilots; a mount contract's centre of mass or receiving depth disagrees with the parts on either side; insert, boss, orientation or clamped-plastic margins are unknown | [Re-check the receiving pilot](inbox/2026-11-01-a-new-layer-in-a-stack-needs-the-receivers-pilot.md), `research/insert-joints/` |
| A generated export, log or note names a home directory, compute host, LAN or tailnet address, or private repository; `npm run test:privacy` fails | [Write repository-relative paths and name machines by role](inbox/2026-11-01-generated-exports-carried-home-paths.md), `tools/privacy-ratchet.txt` |

| Exact helper hash fails on one newline, or linked-worktree ancestry loses parents after a depth fetch | [Materialize exact bytes and preserve shared Git history](inbox/2026-11-05-ci-classification-needs-phase-evidence.md#materialize-exact-helper-bytes-before-expensive-setup) |

| A fleet comparison worktree unexpectedly falls inside its run directory | [Select the temporary parent before setup](inbox/2026-11-05-ci-classification-needs-phase-evidence.md#select-the-temporary-worktree-parent-before-dependency-setup) |

| Isolated KiCad ERC raises footprint-link warnings; a verifier reports only the first stale binding; native replay leaves personal project state | [Prepare real library configuration and account for every output](inbox/2026-11-05-ci-classification-needs-phase-evidence.md#native-verification-needs-its-real-library-configuration-and-full-output-accounting) |

- A help-only edit is assumed to stale every generated study: distinguish archived collection membership from actual semantic/digest contracts in [CI phase evidence](inbox/2026-11-05-ci-classification-needs-phase-evidence.md#separate-the-collection-inventory-from-each-producers-actual-freshness-contract).

- `python -I` unexpectedly has `sitecustomize`/Apport: check the observed system startup identity and toolkit module origins in [CI phase evidence](inbox/2026-11-05-ci-classification-needs-phase-evidence.md#isolated-python-still-has-a-system-startup-identity).

- A relocated Python module works but a test rejects an old import spelling: [check the shared runtime object and checkout origin](inbox/2026-11-05-ci-classification-needs-phase-evidence.md#check-shared-runtime-identity-instead-of-a-particular-import-spelling).

- A post-adoption consumer fails because its toolkit is absent: [preflight every reader runtime before copying targets](inbox/2026-11-05-ci-classification-needs-phase-evidence.md#provision-every-post-adoption-reader-before-mutating-its-targets).

- A moved source directory sends an existing local listing link to GitHub despite a published index: [preserve directory navigation using actual index membership](inbox/2026-11-05-root-moves-need-consumer-and-publication-maps.md#preserve-existing-directory-navigation-through-actual-published-indexes).

- A model key looks ready but selecting a recorded activity does nothing: [wait for the selected model recording list](inbox/2026-11-06-recorded-activities-need-the-selected-model-list.md).

- A cold landing reel stays paused without a source while near-viewport history pictures download: [keep history previews out of the hero startup budget](inbox/2026-11-06-recorded-activities-need-the-selected-model-list.md#history-cards-must-not-consume-the-hero-startup-budget).
- A cold landing reel reaches Play now with the hero still downloading and no movie source: [verify the bounded override and measure the hero transfer budget](inbox/2026-11-10-cold-hero-transfers-need-a-separate-reel-contract.md).
- A manual reel test remains paused after its supposed Play click while the hero loads successfully: [observe and cancel automatic intent before activating the named Play action](inbox/2026-11-10-cold-hero-transfers-need-a-separate-reel-contract.md#manual-playback-tests-must-observe-the-action-they-activate).

- README scene JSON is unchanged but renderer parity/SVG digest differs: [persisted scene paint order](inbox/2026-11-05-ci-classification-needs-phase-evidence.md#render-the-persisted-scene-representation-before-claiming-parity).

- A local fleet runner or skill link disappears while a remote job is active: [check remote state before dispatching again](inbox/2026-11-05-ci-classification-needs-phase-evidence.md#a-missing-local-runner-does-not-establish-remote-job-state).

- Browser model placement is correct but a nested parser node-order assertion fails: [verify parser and browser order](inbox/2026-11-05-ci-classification-needs-phase-evidence.md#verify-parser-and-browser-ordering-with-the-same-actual-document).

- An image is visible but wall measurement counts no visual inside its inline picture wrapper: [match the real picture/image boxes](inbox/2026-11-02-readme-images-need-src-not-srcset.md#a-picture-wrapper-must-have-the-visible-images-real-box).

- A compact attribution badge overlaps the brand only without JavaScript: [use real no-script flow and boundary checks](inbox/2026-11-02-readme-images-need-src-not-srcset.md#test-badge-flow-with-scripting-disabled-as-well-as-a-delayed-script).

- A Made with badge link returns200 but belongs to an unrelated site: [verify the actual project origin](inbox/2026-11-02-readme-images-need-src-not-srcset.md#a-badge-link-needs-the-verified-project-origin-not-merely-http-success).

- A landing name sounds joined despite a correct pronunciation JSON field: [trace the selected recorded audio](inbox/2026-11-05-ci-classification-needs-phase-evidence.md#a-correct-spoken-text-field-does-not-establish-the-sound-a-visitor-hears).

- An unmerged historical branch reuses an already-decided ID: [preserve old evidence without overwriting current decisions](inbox/2026-11-07-historical-branches-need-decision-identity-checks.md).

- An issue must stay open but the PR description contains a closing keyword: [state the open scope directly and verify parsed references](inbox/2026-11-07-historical-branches-need-decision-identity-checks.md#keep-closing-keywords-out-of-prose-that-must-leave-an-issue-open).

- A recovered feature resurrects legacy root imports or new files miss the publication map: [reconcile feature additions with current ownership contracts](inbox/2026-11-05-root-moves-need-consumer-and-publication-maps.md#recover-feature-additions-into-the-current-package-and-publication-contracts).

- Recovered positive aim commands stay at level, or absent feed metadata widens firing permission: [check the applied servo and separate firing bounds](inbox/2026-11-05-root-moves-need-consumer-and-publication-maps.md#recovered-commands-must-reach-the-actual-servo-and-retain-separate-firing-bounds).

- Fleet submission says a public repository is not anonymously readable before any job is assigned: [classify the no-job boundary without bypassing authentication checks](inbox/2026-11-05-ci-classification-needs-phase-evidence.md#a-no-job-readability-refusal-is-not-a-producer-failure-or-an-authentication-diagnosis).

- A fresh scene would describe old stops, an unverified module class, or broader clearance than sampled: [freeze generated explanations with actual mechanical constraints](inbox/2026-11-05-root-moves-need-consumer-and-publication-maps.md#freeze-generated-explanations-alongside-mechanical-constraints).

- Independent pivots still permit a copied manifest owner or stale landmark indices: [bind source-audited ownership to actual loaded asset bytes](inbox/2026-10-28-rendered-joints-need-independent-datums.md#reference-ownership-and-asset-identity-must-also-be-independent).

- Cleanup or record-writing masks the original producer error: [persist phase evidence independently and retain the primary exception](inbox/2026-11-05-ci-classification-needs-phase-evidence.md#cleanup-failures-must-not-replace-the-producers-original-error).

- A clearance report matches height but omits the current upper stop or firmware bounds: [require both tilt boundaries and complete sampled grids](inbox/2026-10-28-rendered-joints-need-independent-datums.md#clearance-freshness-needs-both-current-tilt-boundaries-and-complete-sampled-grids).

- A private Xvfb run fails Snap cgroup tracking after private-bus systemd activation fails: [separate display isolation from session-bus setup](inbox/2026-11-05-ci-classification-needs-phase-evidence.md#a-private-display-and-a-private-session-bus-are-different-isolation-boundaries).
- A depth-one worker has the correct current files but `git show` cannot read its separately recorded component source: [fetch the exact recorded source object in the disposable clone](inbox/2026-11-05-ci-classification-needs-phase-evidence.md#an-isolated-depth-one-worker-needs-the-recorded-source-object-too).
- Native work never starts because an optional `/usr/bin/time` wrapper is absent: [separate measurement tooling from the actual bounded producer](inbox/2026-11-05-ci-classification-needs-phase-evidence.md#optional-measurement-tools-must-not-block-the-actual-producer).
- A valid sealed input archive is refused by fleet staging: [stage its verified unpacked files through the actual transport policy](inbox/2026-11-05-ci-classification-needs-phase-evidence.md#pass-the-actual-staging-policy-before-dispatching-an-archive-derived-input).
- Encoding completes but the E1 guard cannot read the renderer's historical commit: [derive both field and video receipt revisions before encoding](inbox/2026-11-05-ci-classification-needs-phase-evidence.md#fetch-both-the-solved-field-and-rendered-video-history-before-encoding).
- A notebook catalogue grows beyond the existing text-wall backlog: [fold optional navigation while preserving every link and strict measurements](inbox/2026-11-05-ci-classification-needs-phase-evidence.md#a-growing-navigation-catalogue-is-still-subject-to-the-text-wall-gate).
- Runtime uses current stops but an active introduction still asserts a zero-degree rule: [keep current descriptions tied to shared bounds](inbox/2026-11-05-root-moves-need-consumer-and-publication-maps.md#current-descriptions-must-follow-shared-limits-too).

- NaN or infinite requested motor torque becomes a limit command or a non-finite output: [reject it before saturation, and distinguish historical media validity from unfinished regeneration](inbox/2026-11-07-nonfinite-torque-is-not-a-saturation-command.md).
- Sparse finite-element assembly raises an allocation error under `RLIMIT_AS` despite host memory headroom: [distinguish virtual-address bounds from resident-memory evidence](inbox/2026-11-07-fem-address-space-cap-is-not-resident-memory.md).
- An adoption checksum raises `str has no attribute read_bytes` before intent/copy: [normalize the actual path argument at the checksum boundary](inbox/2026-11-07-nonfinite-torque-is-not-a-saturation-command.md#a-checksum-preflight-must-accept-the-path-type-actually-supplied).
- Reusing sealed frames fails only because a genuine E1 insert changed, or a pin test expects old literal revisions: [keep historical stage bindings separate from current inserts](inbox/2026-11-07-capture-history-and-refreshed-inserts-need-separate-bindings.md).
- A submit wrapper exits zero despite a failed client or cannot identify one accepted job: [propagate failure and preserve ambiguous submission state](inbox/2026-11-05-ci-classification-needs-phase-evidence.md#a-submission-wrapper-must-propagate-client-failure-and-identify-one-accepted-job).
- E1 rendering and full media validation pass but the joined rig companion test cannot read historical Git paths: [fetch both rig producer/converter objects before rendering](inbox/2026-11-05-ci-classification-needs-phase-evidence.md#a-joined-media-suite-needs-the-rig-producer-and-converter-history-too).
- Valid artifact tests pass but an adoption preservation guard rejects only intended changed targets: [align exclusions with the inventory root](inbox/2026-11-05-root-moves-need-consumer-and-publication-maps.md#inventory-exclusions-must-use-the-inventorys-own-relative-root).

- Assembly part IDs match but stop instructions/pictures are old; a guide aborts its active scene during switching, clamps an underside camera, a text-only version is blocked, touch emulation reports zero contacts, layout scans before the guide finishes, or a held-mesh test waits on incidental progress wording: [bind recipe and mesh snapshots together](inbox/2026-11-09-assembly-guides-need-recipe-and-mesh-binding.md).
- An invalid initial assembly URL cannot recover through enabled choices, mobile navigation covers those choices before a viewer exists, history/disposal disappears after recovery, or static Markdown omits hidden Buy/Setup panels: [initialize recovery independently and reveal intentional static workstreams](inbox/2026-11-09-assembly-overlays-need-visible-bounds-and-hit-tests.md#recover-initialization-before-the-first-successful-model).
- A fullscreen click is followed by a null mode even though a later capture fills the viewport: [await actual native fullscreen completion before Print assertions](inbox/2026-11-09-assembly-overlays-need-visible-bounds-and-hit-tests.md#recover-initialization-before-the-first-successful-model).

- A diagram inventory reports `13 !== 11`, or a full layout job reaches its time bound with only some page/size/theme views: [bind diagram sources and prove partition coverage](inbox/2026-11-05-ci-classification-needs-phase-evidence.md#diagram-inventories-must-name-the-sources-they-cover).

- A native checkbox Space assertion fails without focused-element or key-target evidence: [record focus and native event ownership](inbox/2026-11-05-ci-classification-needs-phase-evidence.md#native-keyboard-assertions-need-focus-and-event-ownership-evidence).

- Browser installation consumes most of a CI job, or the presentation command list reaches its time bound: [keep provisioning outside executable test budgets and preserve command unions](inbox/2026-11-05-ci-classification-needs-phase-evidence.md#browser-provisioning-must-leave-time-for-executable-checks).

- A playback observation loses its execution context while a later screenshot still looks coherent: [record document identity and navigation before changing runtime](inbox/2026-11-09-assembly-overlays-need-visible-bounds-and-hit-tests.md#2026-11-10-context-destruction-needs-document-identity-evidence).

- A retained input fails full inventory comparison with unchanged bytes after a fleet job ends: [check the documented post-job permission freeze](inbox/2026-11-10-retained-artifact-modes-follow-the-fleet-freeze.md).

- A native study is killed at its cap with no final unchecked IDs or CLI exit receipt: [derive coverage from the full plan and retained completed prefix](inbox/2026-11-10-capped-native-studies-need-observed-prefixes.md).
- A supplier-photo fallback times out while the screenshot shows a loaded image: [arm and witness the actual request failure before navigation](inbox/2026-11-10-photo-failure-tests-must-intercept-the-request.md).

- An audit accepts unrelated prior query IDs while reporting unchanged combined coverage: [bind the prior byte seal and ordered plan membership before counting](inbox/2026-11-10-combined-coverage-needs-sealed-prior-evidence.md).

- Browser speech is null after a volume adjustment while a scheduled greeting fires: [preserve conversation ownership across the real greeting deadline](inbox/2026-11-10-scheduled-greetings-must-respect-conversations.md).

- A held mesh request times out despite a rendered model, or an error fixture never intercepts its part: [resolve actual mesh filenames from the hash-bound manifest](inbox/2026-11-10-mesh-request-controls-need-manifest-file-identities.md).
- Talk becomes ready while an archived fault is armed, a badge samples equal animated frames, or a tilt sweep exhausts its wall deadline: [bind active requests and observe rendered frames or stage progress](inbox/2026-11-10-browser-controls-need-active-requests-and-observable-frames.md).
- A reel says current while only its turret names or legacy rig meshes are bound: [bind the complete current body and observe its actual holder](inbox/2026-11-10-current-captures-need-complete-body-bindings.md).

- A retry readiness wait throws on `document.body.dataset` during navigation: [wait through bodyless documents without suppressing page errors](inbox/2026-11-10-readiness-observers-must-wait-through-bodyless-documents.md).

- A ready simulator produces a blank recovery screenshot during its opening fade: [observe canvas visibility and real draw counters before visual capture](inbox/2026-11-10-canvas-readiness-needs-observed-presentation.md).
- A gamepad hop times out with wheels down but jump still recovering, or wall time diverges from clamped stage time: [observe the actual stage clock and keep separate completion/wall/stall caps](inbox/2026-11-10-hop-completion-needs-the-actual-stage-clock.md).
- The adopted Robot hop advances steadily and exceeds the CI wall cap: [compare the existing touch rendering profile at the same viewport](inbox/2026-11-10-hop-completion-needs-the-actual-stage-clock.md#exercise-gamepad-controls-with-the-existing-touch-renderer).

- Context-wide page-error capture finds sessionStorage denied only on about:blank initial documents: [guard the fixture's intended HTTP security origin before reading storage](inbox/2026-11-10-browser-init-fixtures-need-an-http-origin.md).
- A current Build browser test expects171/233 parts, waits for the recorded rig manifest, or confuses index order with the bare-page default: [bind current defaults separately from explicit archives](inbox/2026-11-10-browser-harnesses-need-current-and-archive-bindings.md).
- A fresh media candidate retains about:blank local/session storage errors despite successful child commands: [guard each actual init callback and bind the reused helper](inbox/2026-11-10-browser-init-fixtures-need-an-http-origin.md#a-fresh-media-capture-must-guard-every-context-init-before-storage-access).
- Highlight-media source validation rejects a newly edited shared test helper: [preserve recorded fixture bytes and narrow the caller fix](inbox/2026-11-10-browser-init-fixtures-need-an-http-origin.md#historical-capture-fixtures-can-require-a-narrower-caller-fix).
- A poster utility overwrites its public PNG before artifact review, or pure import starts a browser: [reserve fresh candidate output and preserve the actual hero hook](inbox/2026-11-10-poster-captures-need-fresh-candidate-output.md).

- A retired simulator option remains reachable through old queries or restored form state: [gate public availability at the actual loader and preserve historical fixtures](inbox/2026-11-11-public-retirement-needs-loader-enforcement.md).
- A dynamically constructed probe regex passes syntax checking but fails before capture, or collection mistakes a retained worker error for a missing terminal marker: [exercise actual extraction and separate byte verification from worker success](inbox/2026-11-10-browser-init-fixtures-need-an-http-origin.md#compile-the-actual-extractor-and-keep-byte-collection-separate-from-worker-success).

- A shared table adoption loses pagination/filtering despite syntax checks: [compare consumer extensions before replacement](inbox/2026-11-11-table-adoption-must-preserve-consumer-extensions.md).
- Header/cell alignment passes on a hidden table: [activate the actual panel and require positive box widths](inbox/2026-11-11-table-adoption-must-preserve-consumer-extensions.md#compare-real-visible-boxes-not-equal-zero-size-deltas).
- A PDF fits the page but splits numbers/short headers, or printable labels omit pending exports: [check actual token readability and retain row warnings](inbox/2026-11-11-table-adoption-must-preserve-consumer-extensions.md#staying-inside-pdf-bounds-does-not-establish-readable-numeric-cells).
- A successful transient job loses property readback after completion (`LoadState=not-found`, default infinity limits): [capture effective properties while loaded and preserve collector failure](inbox/2026-11-11-successful-transient-units-can-lose-readback.md).

- A BOM has complete IDs but hundreds of pages or one-character names: [budget annotated numbers and same-part sourcing notes](inbox/2026-11-11-table-adoption-must-preserve-consumer-extensions.md#rich-procurement-notes-need-their-own-printable-space).

- Complete IDs/layout pass while setup, uses or fabrication details disappear: [bind fidelity before adapter enhancement](inbox/2026-11-11-table-adoption-must-preserve-consumer-extensions.md#source-fidelity-must-be-measured-before-the-adapter-can-discard-it).

- Positive table widths pass but the PNG shows a footer, or root clip bottom becomes negative after scrolling: [distinguish root viewport and real nested clips](inbox/2026-11-10-screenshot-deadlines-need-timed-capture-phases.md#root-viewport-coordinates-and-nested-clips-are-different-evidence).
- Compiled HTML differs only after deployment while six JS/CSS hashes match: [bind exact deployment bytes before capture](plans/printable-parts/public-acceptance/README.md#bind-source-and-delivered-identity-separately).
- Required PNGs return but graceful browser close times out although the owned cgroup is empty: [retain the failed lifetime contract](inbox/2026-11-10-screenshot-deadlines-need-timed-capture-phases.md#a-completed-capture-does-not-establish-graceful-shutdown).
- One parallel worker returning accidentally releases the coordinator's combined issue lease: [checkpoint scope without releasing the shared claim](inbox/2026-11-11-successful-transient-units-can-lose-readback.md#shared-coordination-claims-outlive-one-worker).
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
