Valpatel/gyropup/hardware/exports/body/body-frame-iso.png

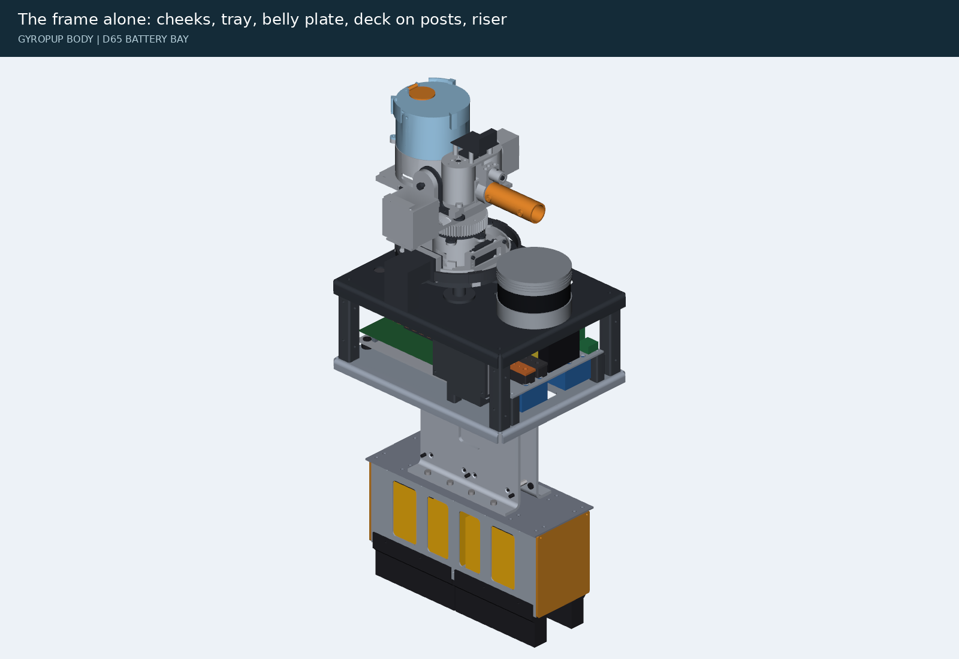
hardware/exports/body/body-frame-iso.png
