Valpatel/gyropup/hardware/exports/body/body-p1-front.png

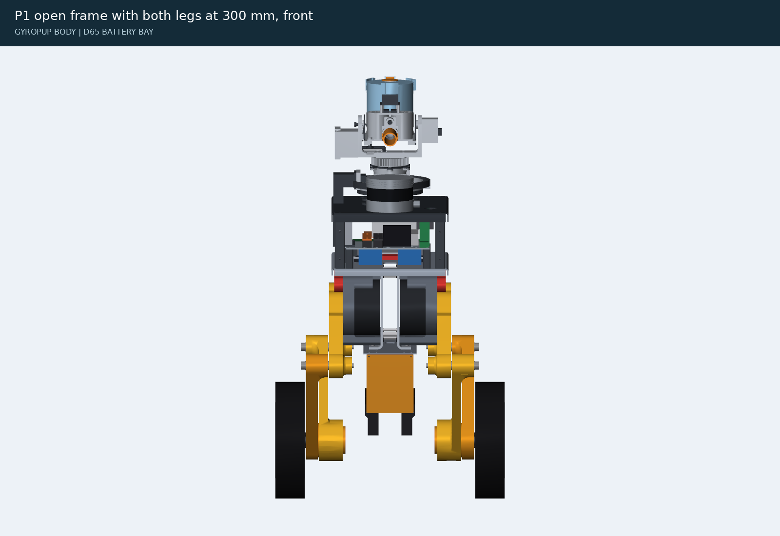
hardware/exports/body/body-p1-front.png
