Valpatel/gyropup/hardware/exports/body/body-p1-iso.png

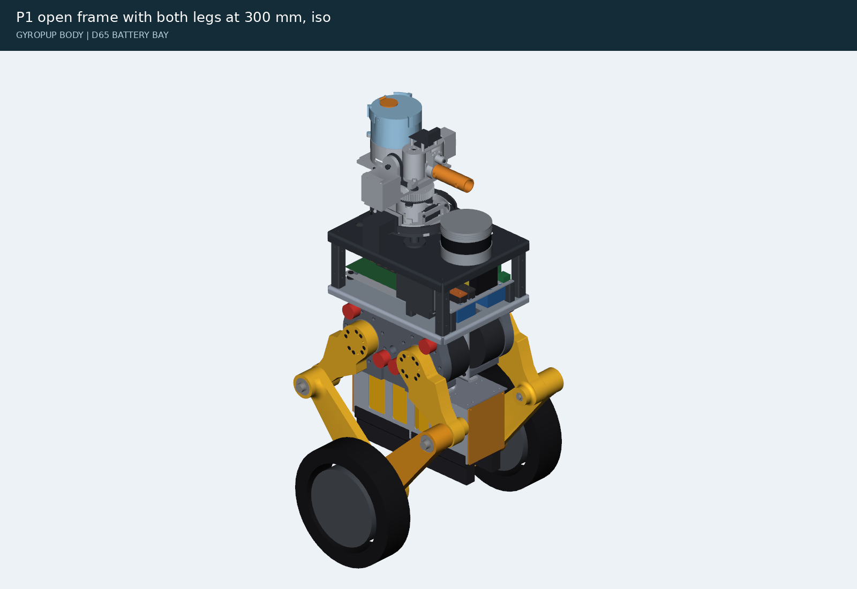
hardware/exports/body/body-p1-iso.png
