Valpatel/gyropup/hardware/exports/body/body-spine-iso.png

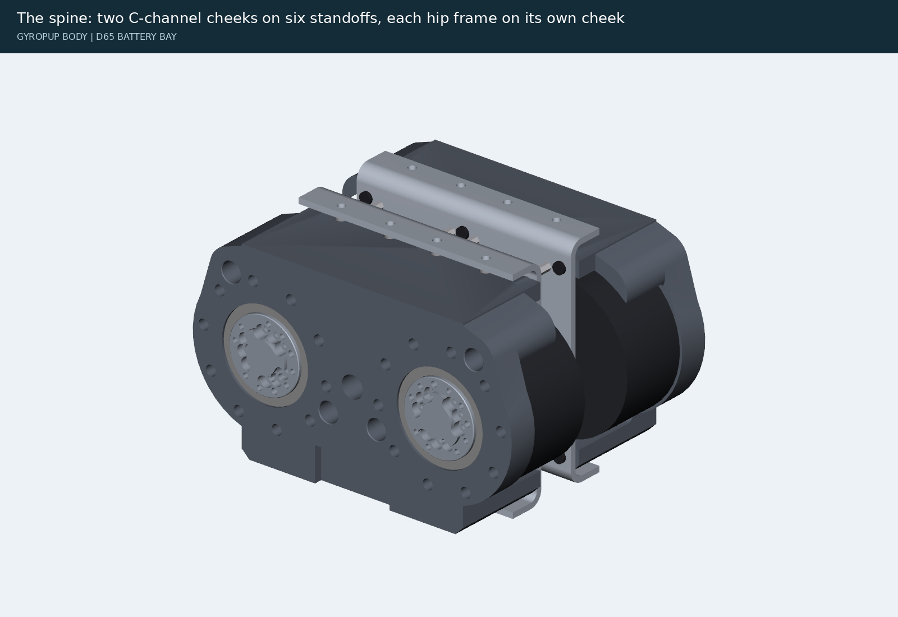
hardware/exports/body/body-spine-iso.png
