Valpatel/gyropup/hardware/exports/body/fea/D1-hand-front.png

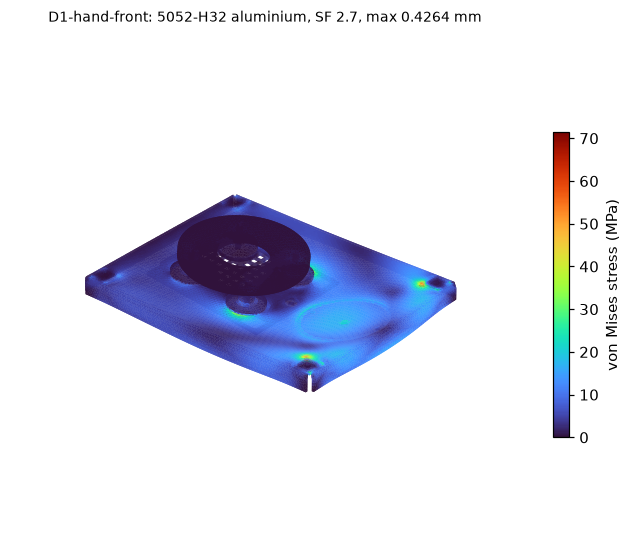
hardware/exports/body/fea/D1-hand-front.png
