Valpatel/gyropup/hardware/exports/body/fea/D2-turret-fall.png

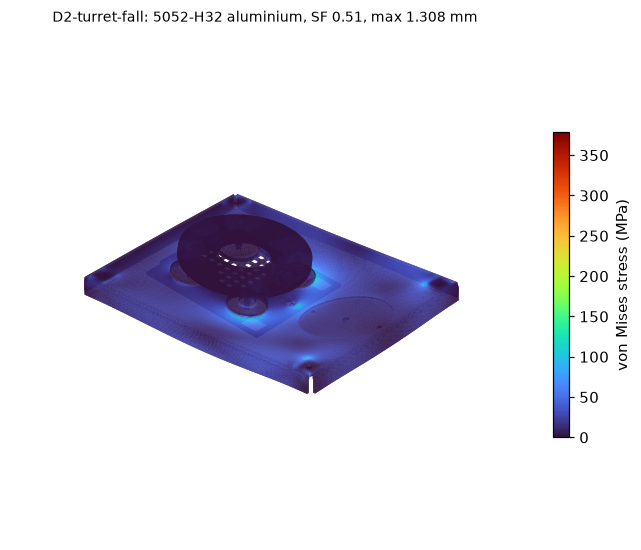
hardware/exports/body/fea/D2-turret-fall.png
