Valpatel/gyropup/hardware/exports/body/flat-bay_floor.png

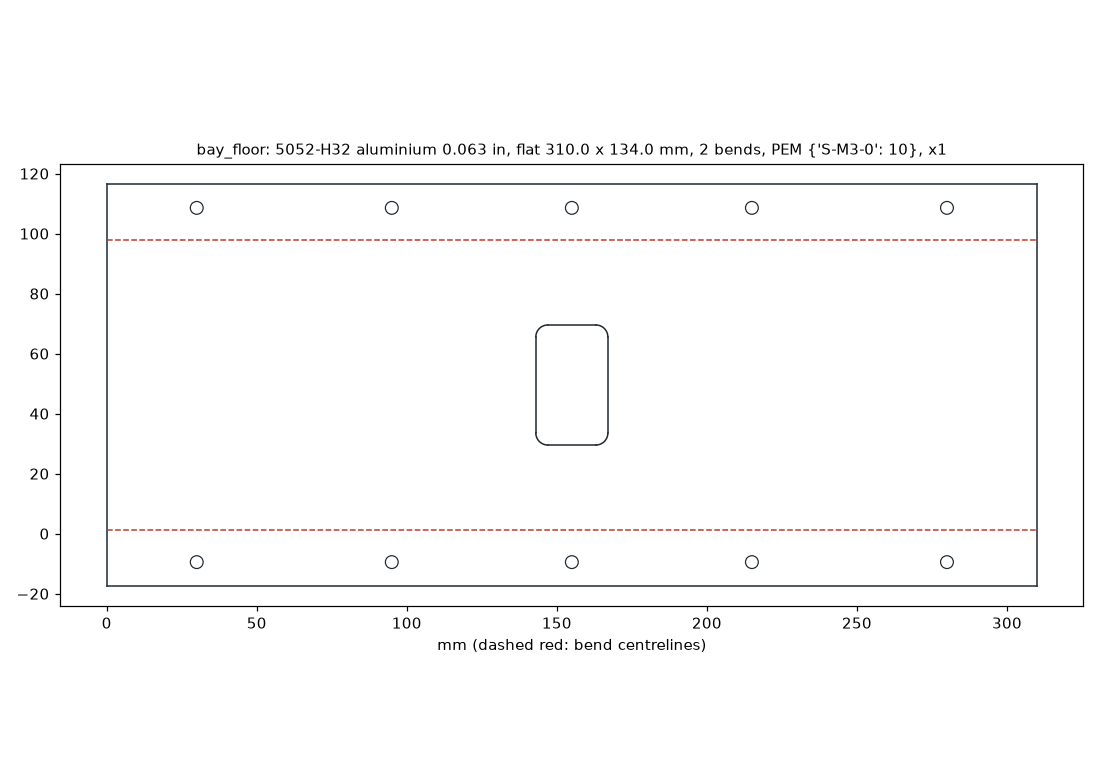
hardware/exports/body/flat-bay_floor.png
