Valpatel/gyropup/hardware/exports/body/flat-belly_plate.png

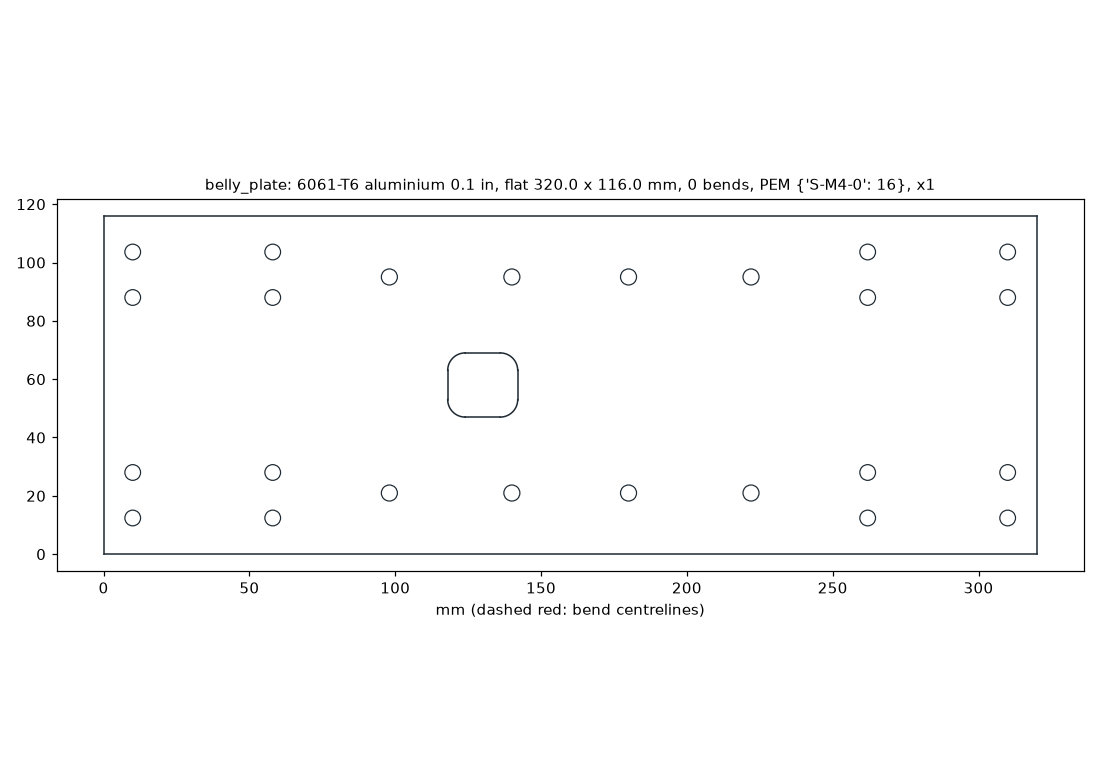
hardware/exports/body/flat-belly_plate.png
