Valpatel/gyropup/hardware/exports/body/flat-bus_bar.png

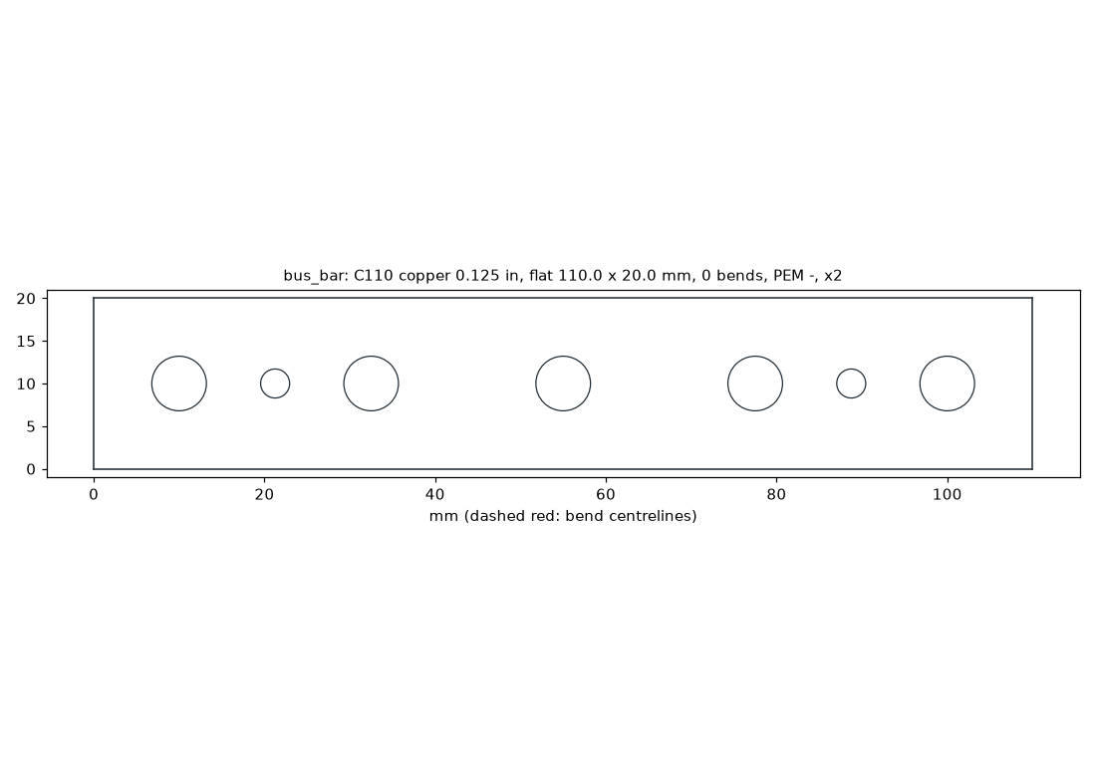
hardware/exports/body/flat-bus_bar.png
