Valpatel/gyropup/hardware/exports/body/flat-cheek.png

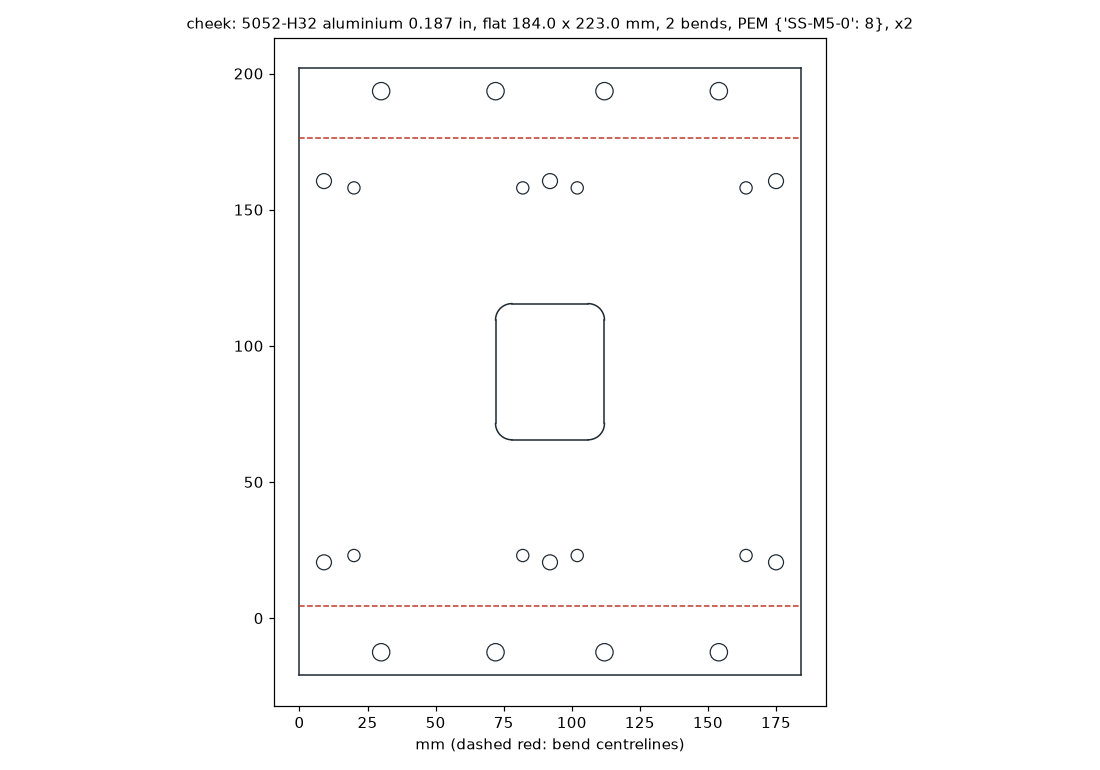
hardware/exports/body/flat-cheek.png
