Valpatel/gyropup/hardware/exports/body/flat-deck.png

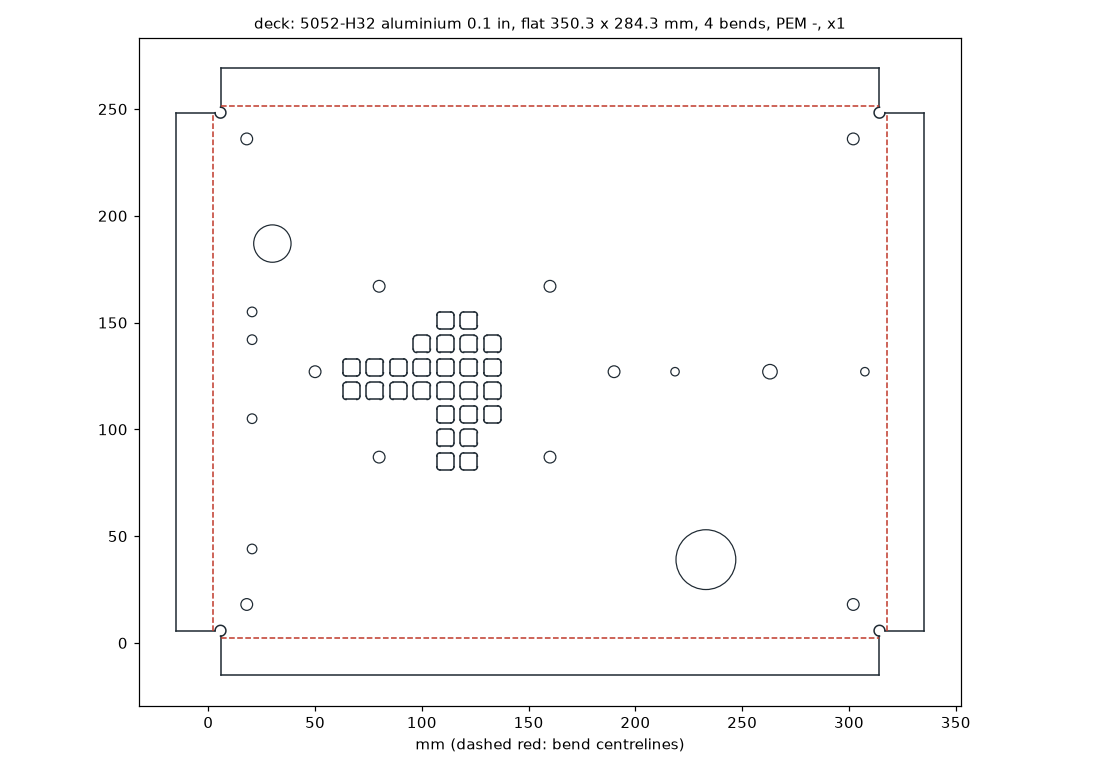
hardware/exports/body/flat-deck.png
