Valpatel/gyropup/hardware/exports/body/flat-floor_tray.png

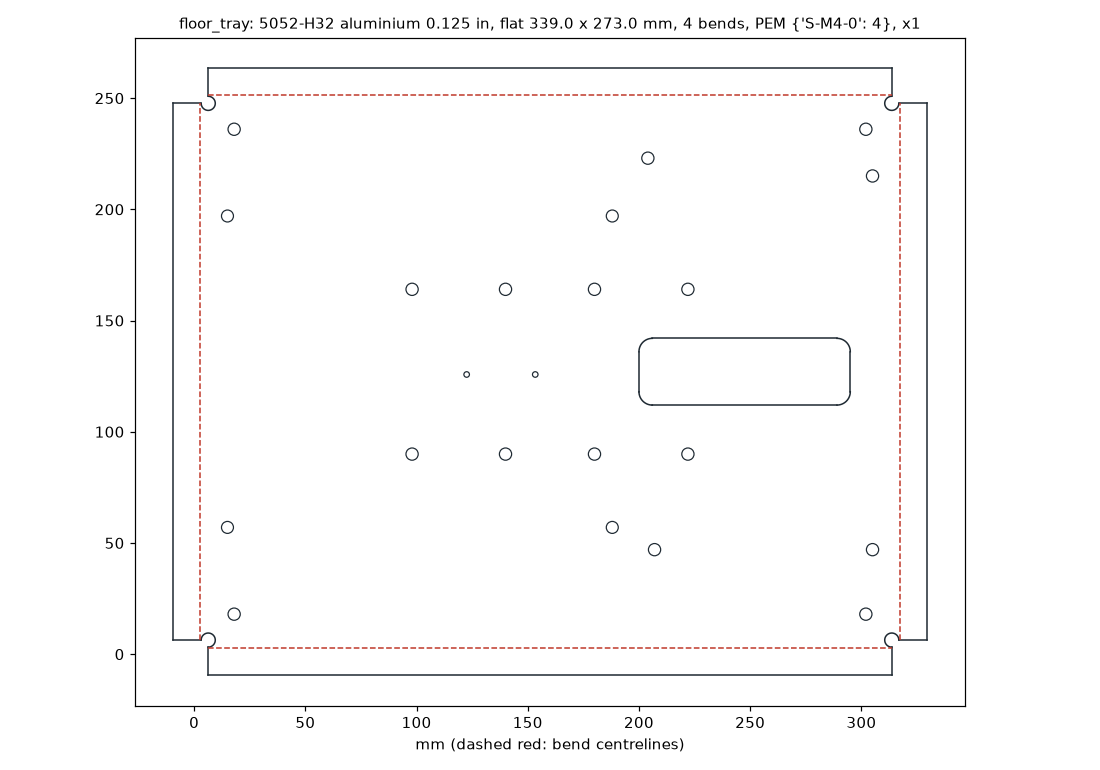
hardware/exports/body/flat-floor_tray.png
