Valpatel/gyropup/hardware/exports/body/flat-power_plate.png

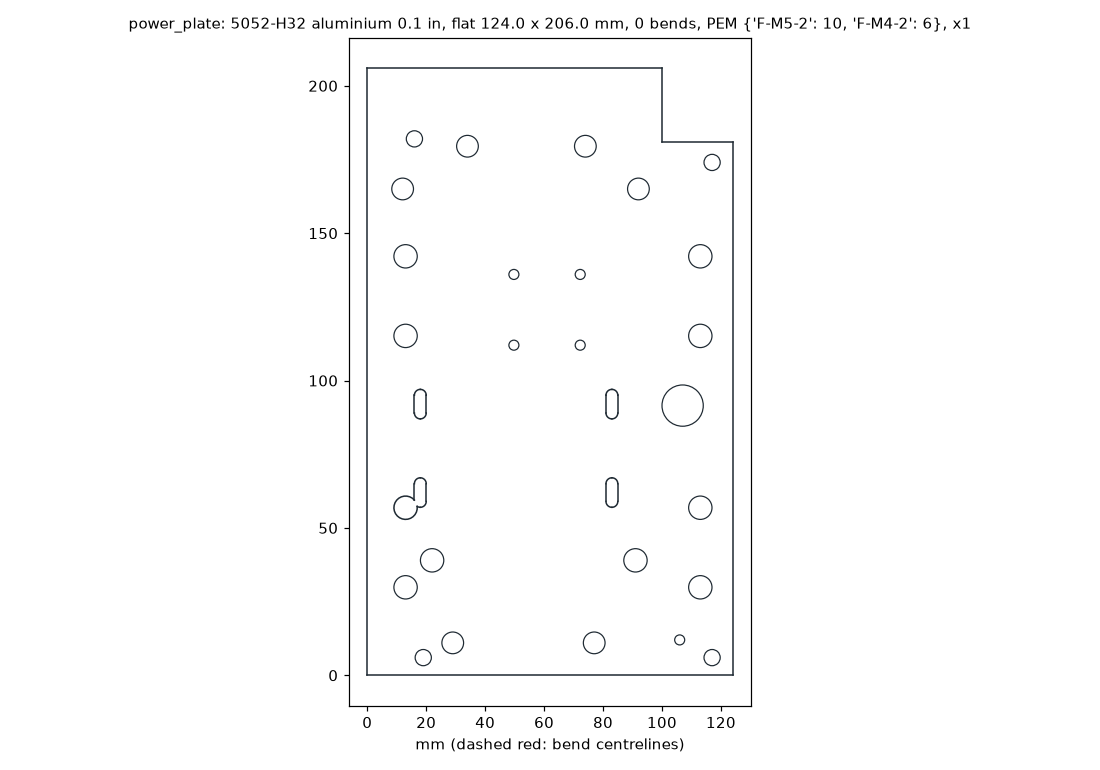
hardware/exports/body/flat-power_plate.png
