Valpatel/gyropup/hardware/exports/body/flat-turret_plate.png

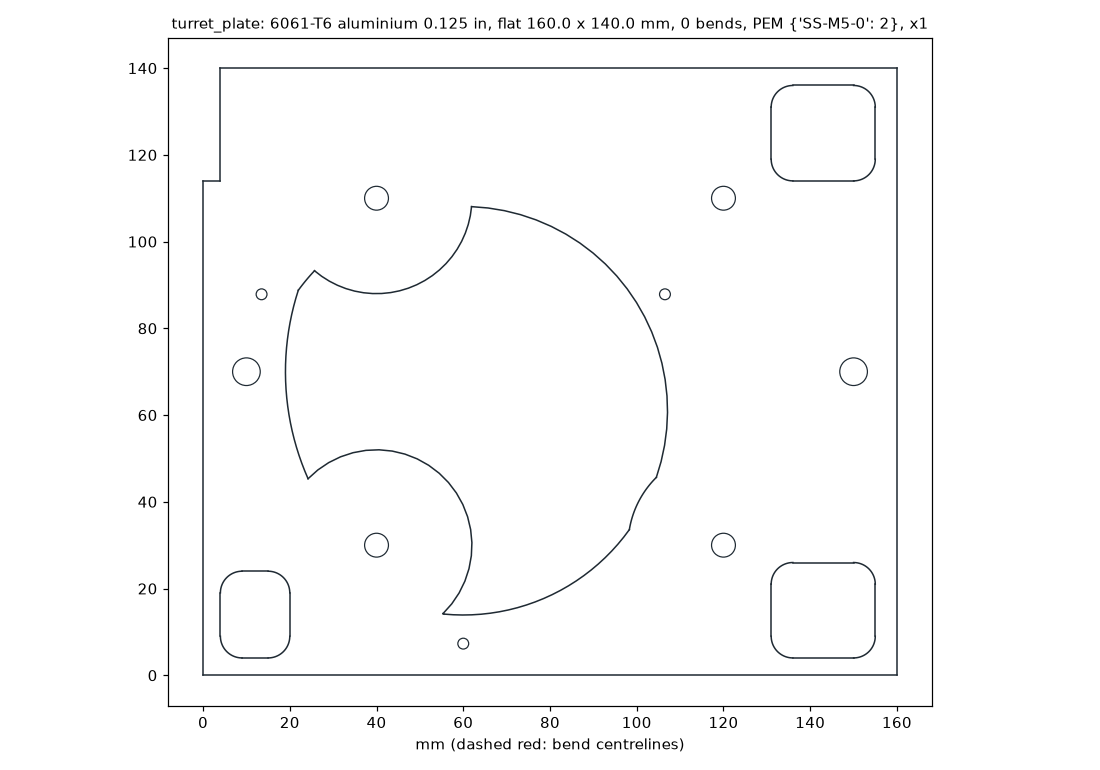
hardware/exports/body/flat-turret_plate.png
