Valpatel/gyropup/hardware/exports/body/views/exploded-bay.png

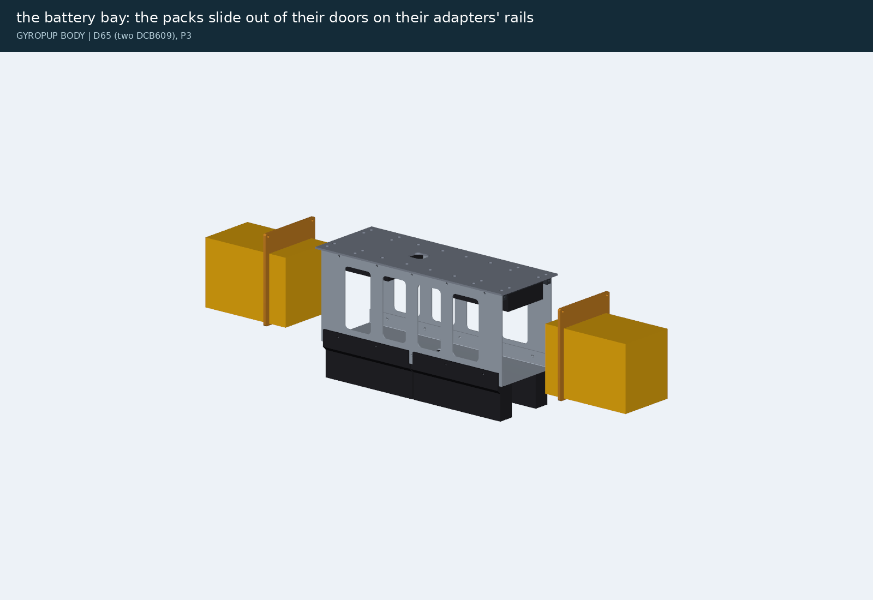
hardware/exports/body/views/exploded-bay.png
