Valpatel/gyropup/hardware/exports/fea/motor_plate-P1.png

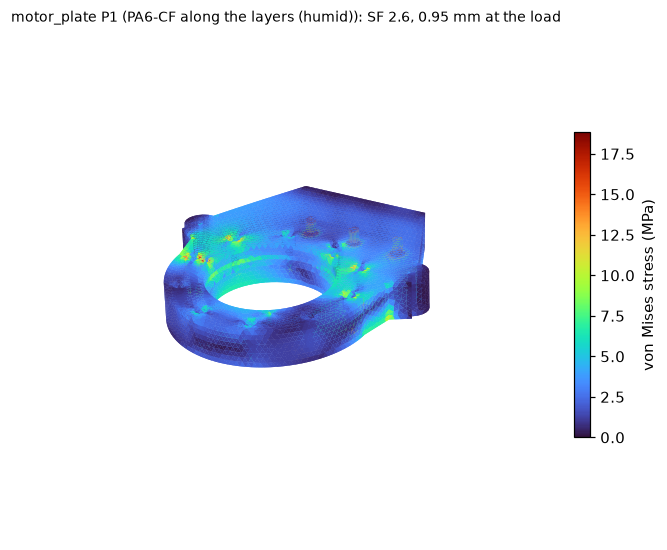
hardware/exports/fea/motor_plate-P1.png
