Valpatel/gyropup/hardware/exports/fea/output_adapter-A1.png

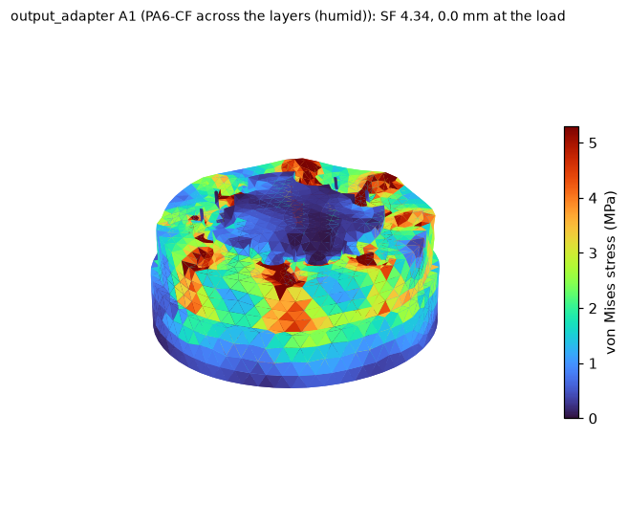
hardware/exports/fea/output_adapter-A1.png
