Valpatel/gyropup/hardware/exports/fea/shin-S1.png

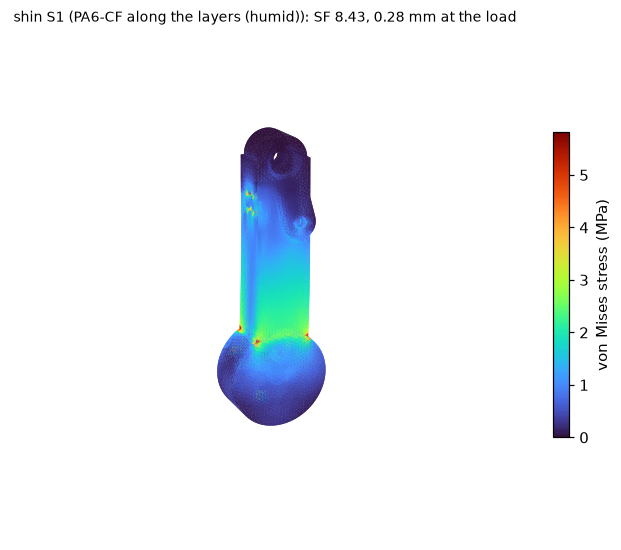
hardware/exports/fea/shin-S1.png
