Valpatel/gyropup/hardware/exports/fea/thigh-T1-fall.png

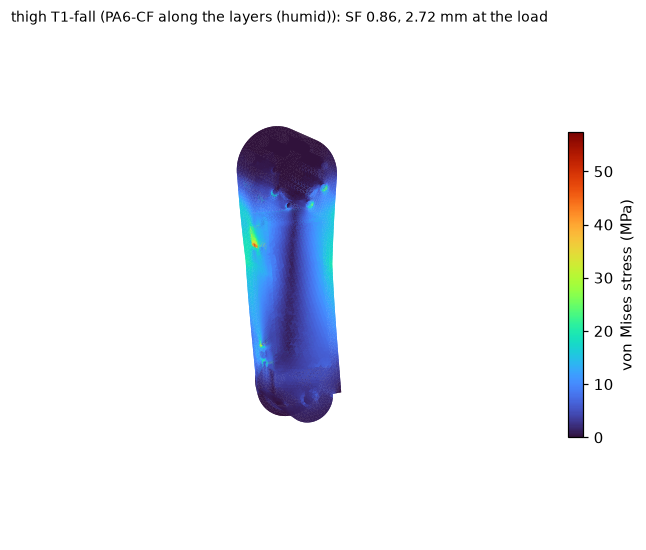
hardware/exports/fea/thigh-T1-fall.png
