Valpatel/gyropup/hardware/exports/fea/thigh-T2.png

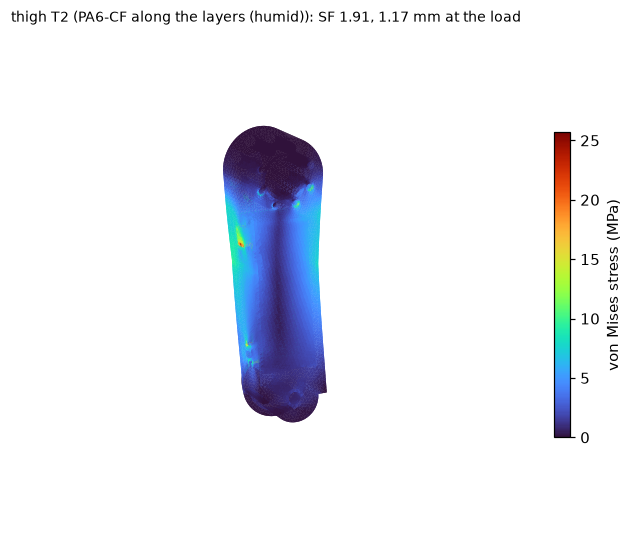
hardware/exports/fea/thigh-T2.png
