Valpatel/gyropup/hardware/exports/fea/yoke_bracket-Y1.png

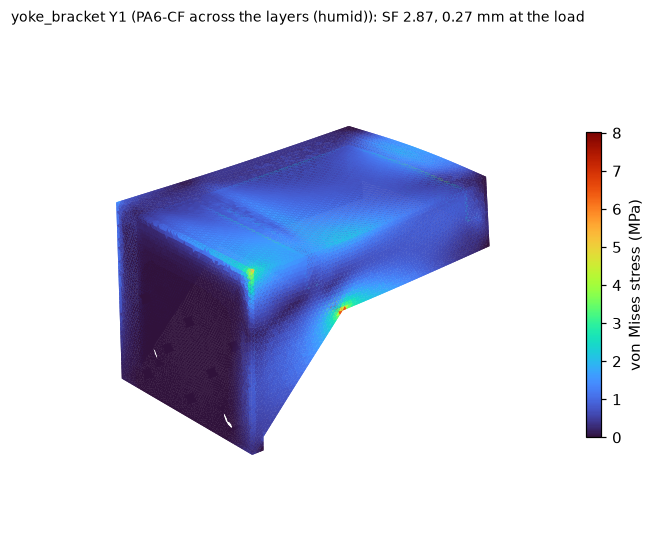
hardware/exports/fea/yoke_bracket-Y1.png
