Valpatel/gyropup/hardware/exports/leg/fea/front_link-R1.png

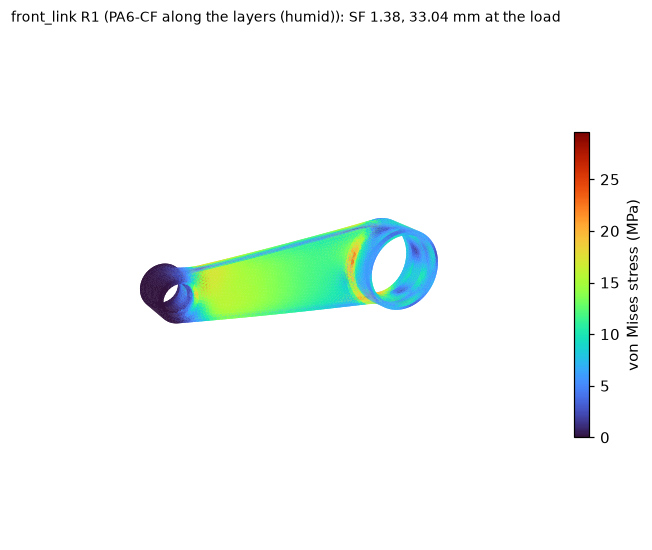
hardware/exports/leg/fea/front_link-R1.png
