Valpatel/gyropup/hardware/exports/leg/fea/hip-frame-29/hip_frame-E1-before-after.png

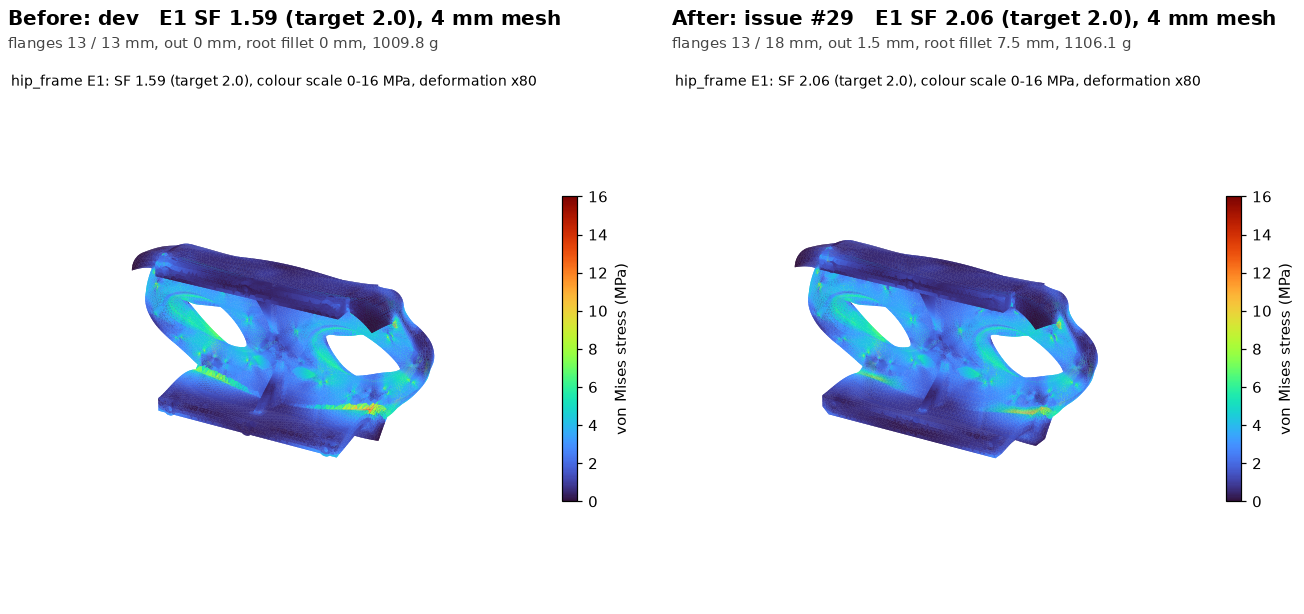
hardware/exports/leg/fea/hip-frame-29/hip_frame-E1-before-after.png
