Valpatel/gyropup/hardware/exports/leg/fea/hip-frame-29/hip_frame-R3o-before-after.png

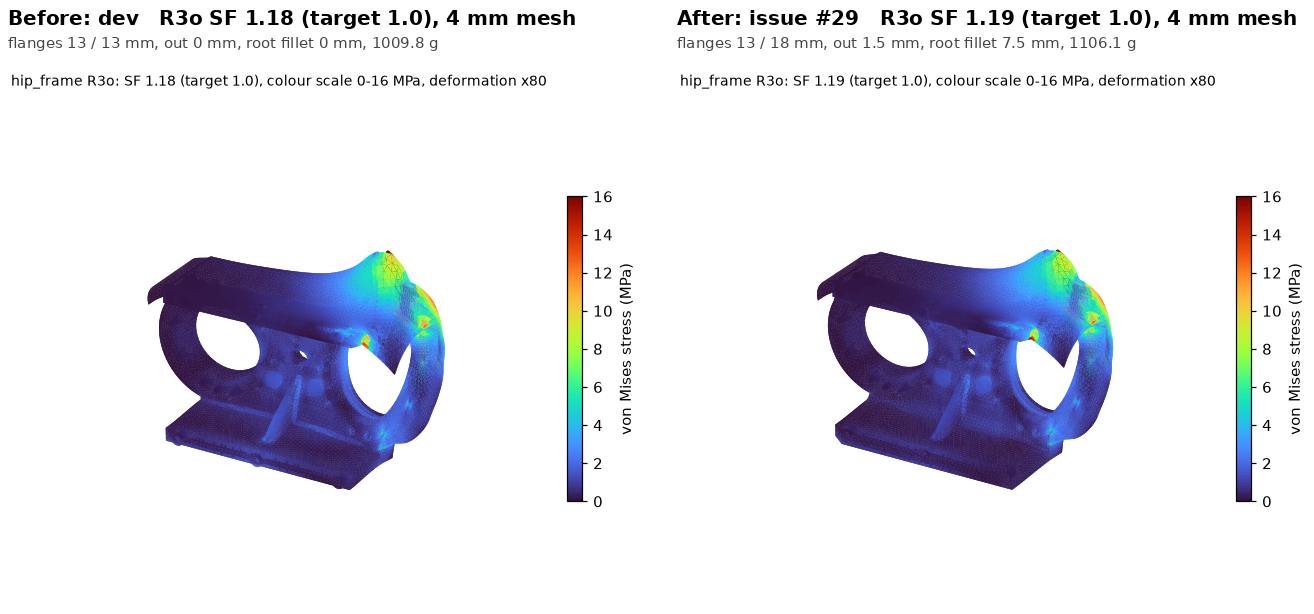
hardware/exports/leg/fea/hip-frame-29/hip_frame-R3o-before-after.png
