Valpatel/gyropup/hardware/exports/leg/fea/hip-frame-29/sweep-chart.png

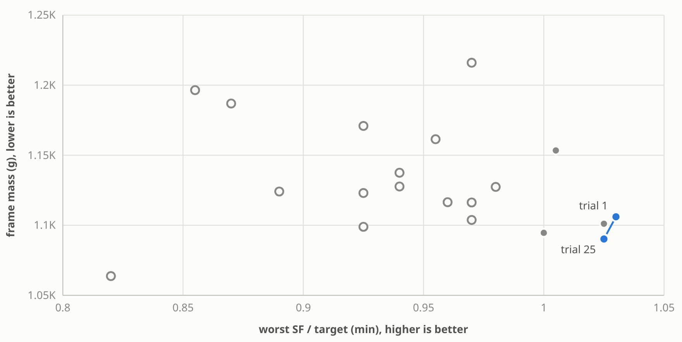
hardware/exports/leg/fea/hip-frame-29/sweep-chart.png
