Valpatel/gyropup/hardware/exports/leg/fea/hip-frame-e1-media/hip-frame-e1-poster.png

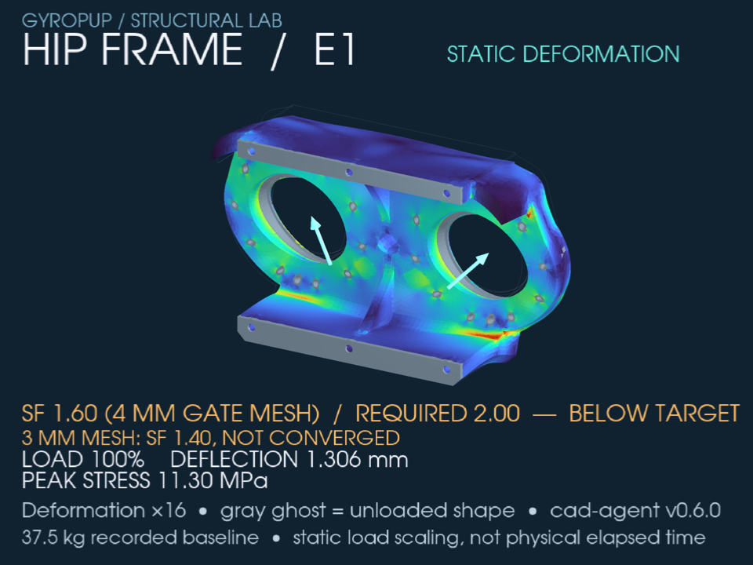
hardware/exports/leg/fea/hip-frame-e1-media/hip-frame-e1-poster.png
