Valpatel/gyropup/hardware/exports/leg/fea/hip_frame-E3o.png

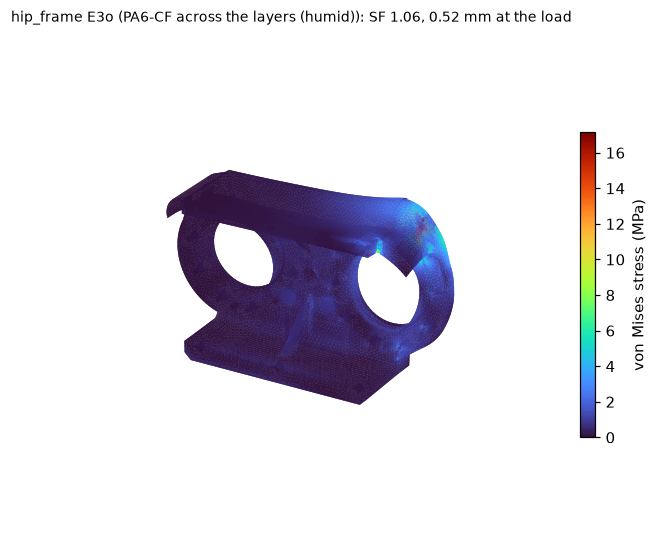
hardware/exports/leg/fea/hip_frame-E3o.png
