Valpatel/gyropup/hardware/exports/leg/fea/hip_frame-R1.png

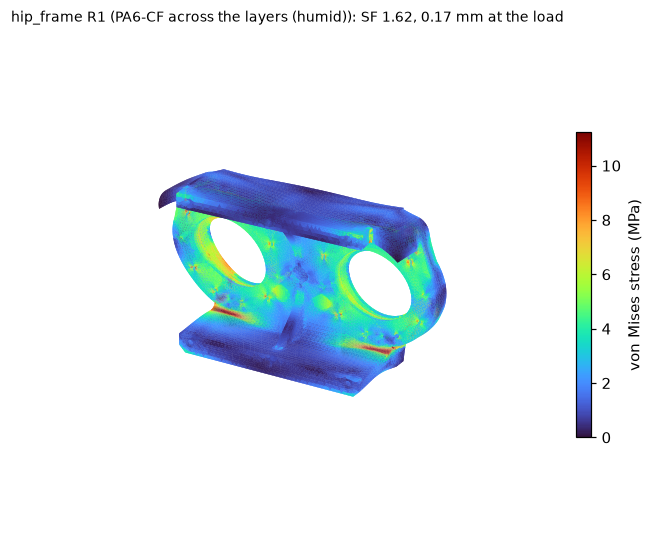
hardware/exports/leg/fea/hip_frame-R1.png
