Valpatel/gyropup/hardware/exports/leg/fea/leg-E1.png

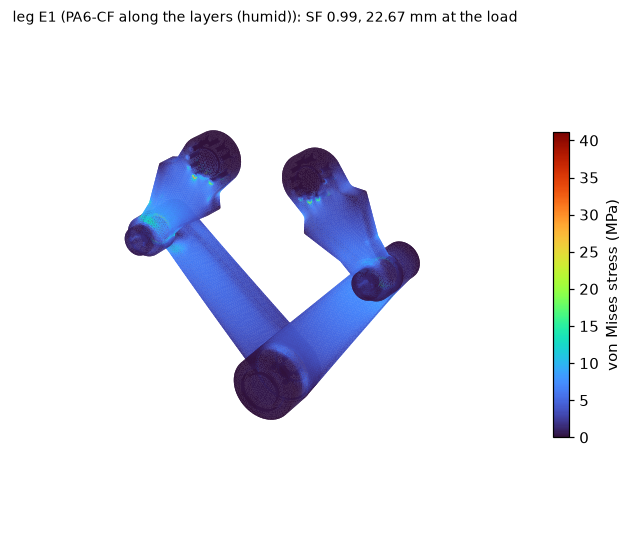
hardware/exports/leg/fea/leg-E1.png
