Valpatel/gyropup/hardware/exports/leg/fea/leg-R1.png

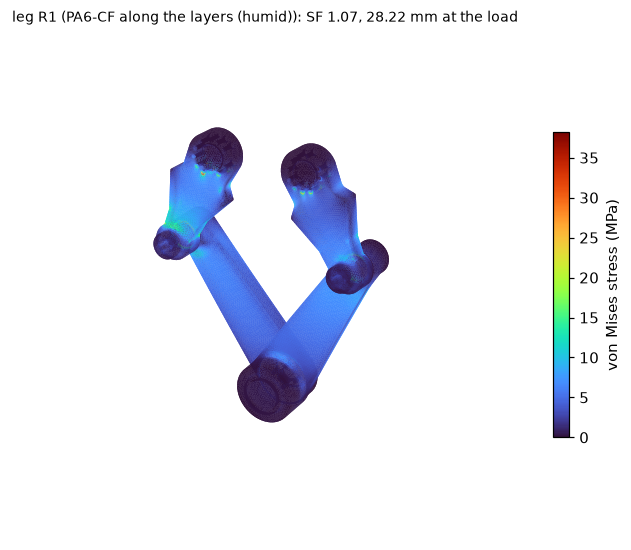
hardware/exports/leg/fea/leg-R1.png
