Valpatel/gyropup/hardware/exports/leg/fea/leg-R3.png

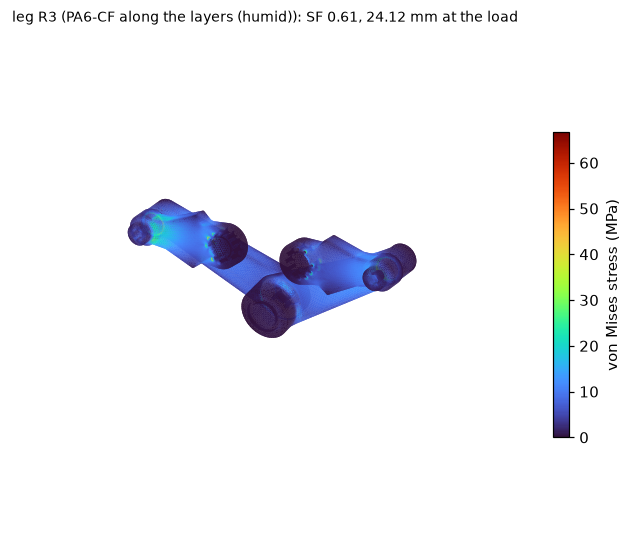
hardware/exports/leg/fea/leg-R3.png
