Valpatel/gyropup/hardware/exports/leg/fea/output_adapter-E1.png

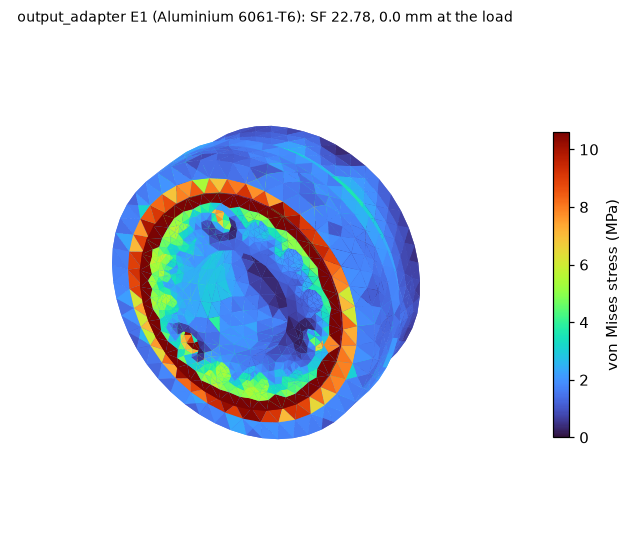
hardware/exports/leg/fea/output_adapter-E1.png
