Valpatel/gyropup/hardware/exports/leg/fea/output_adapter-R1.png

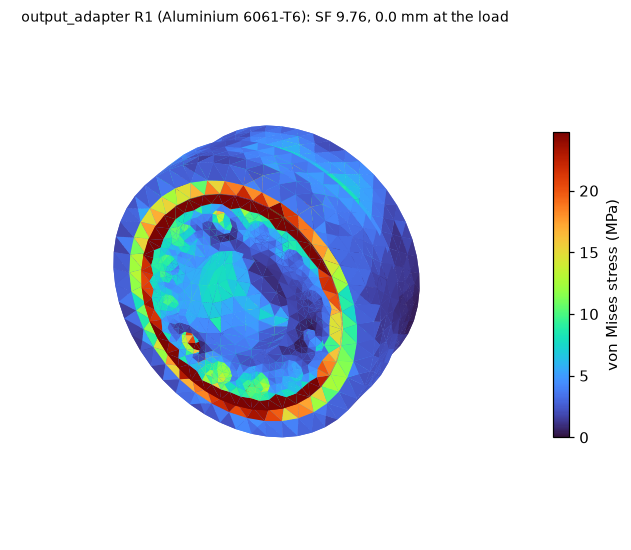
hardware/exports/leg/fea/output_adapter-R1.png
