Valpatel/gyropup/hardware/exports/leg/fea/output_adapter-R2.png

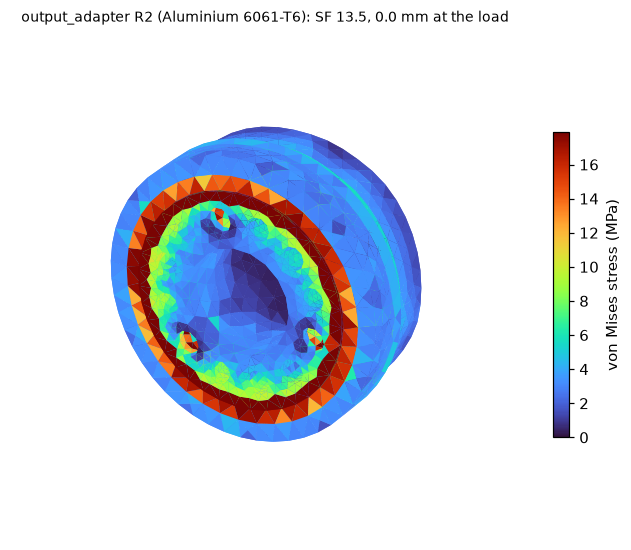
hardware/exports/leg/fea/output_adapter-R2.png
