Valpatel/gyropup/hardware/exports/leg/fea/upper_link-E1F.png

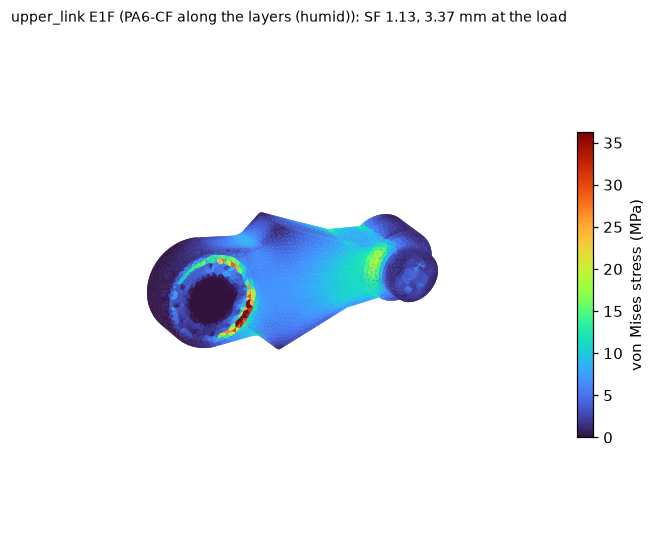
hardware/exports/leg/fea/upper_link-E1F.png
