Valpatel/gyropup/hardware/exports/leg/fea/upper_link-R2.png

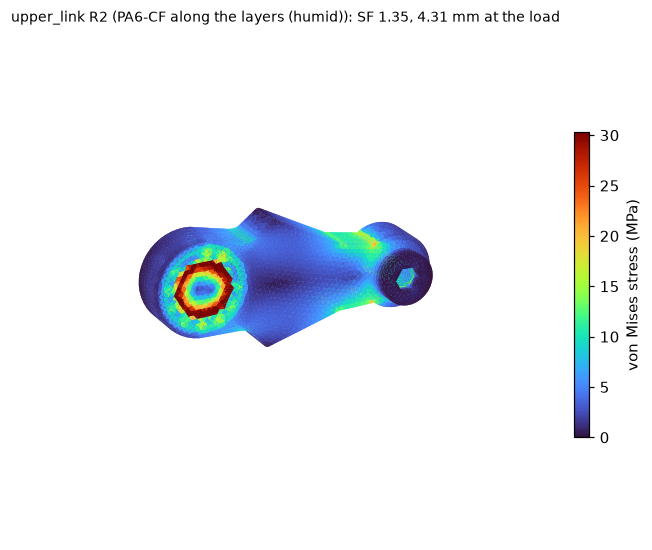
hardware/exports/leg/fea/upper_link-R2.png
