Valpatel/gyropup/hardware/exports/leg/leg-crouch-outside.png

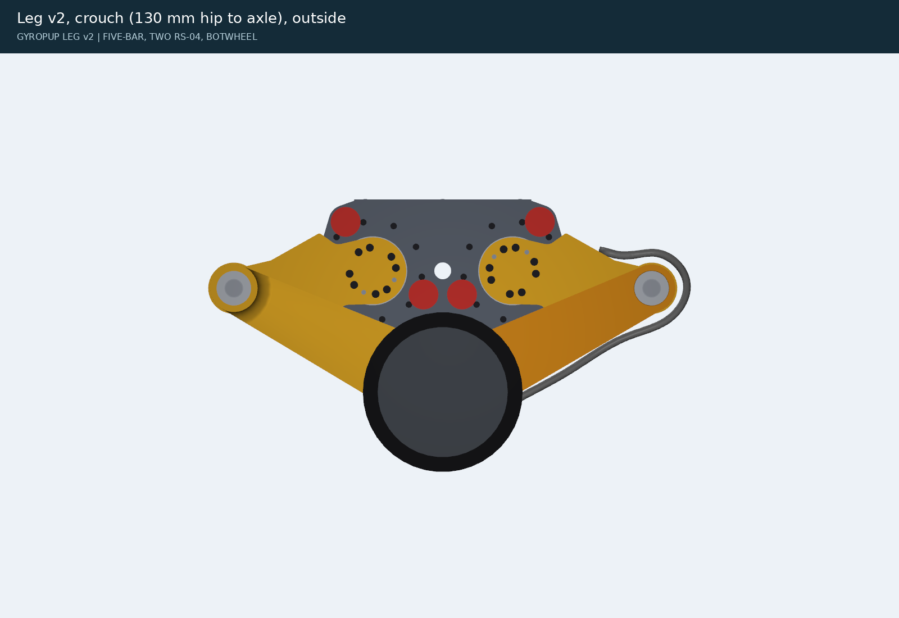
hardware/exports/leg/leg-crouch-outside.png
