Valpatel/gyropup/hardware/exports/leg/leg-exploded.png

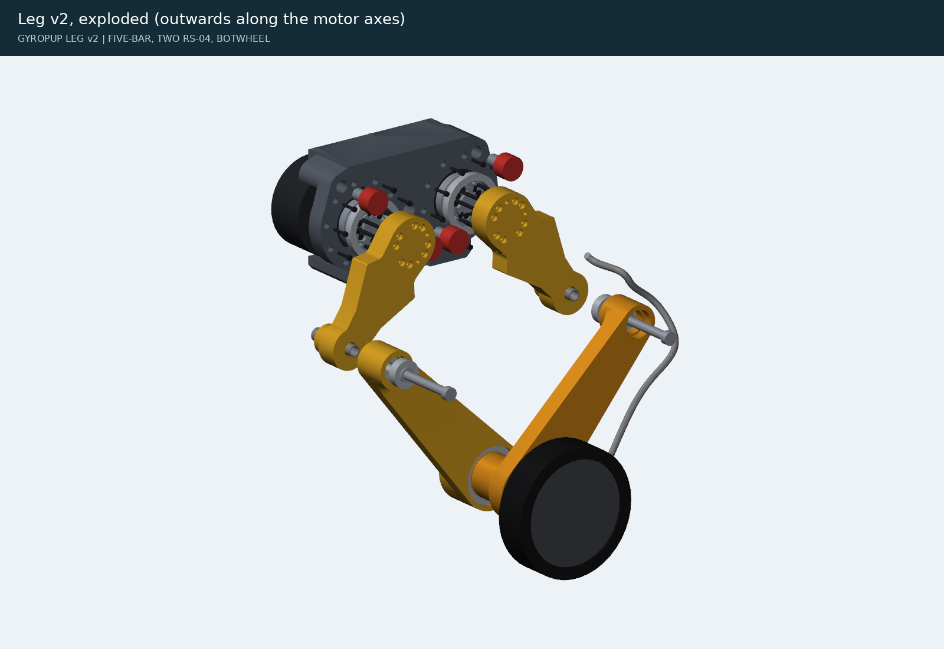
hardware/exports/leg/leg-exploded.png
