Valpatel/gyropup/hardware/exports/leg/leg-stand-front.png

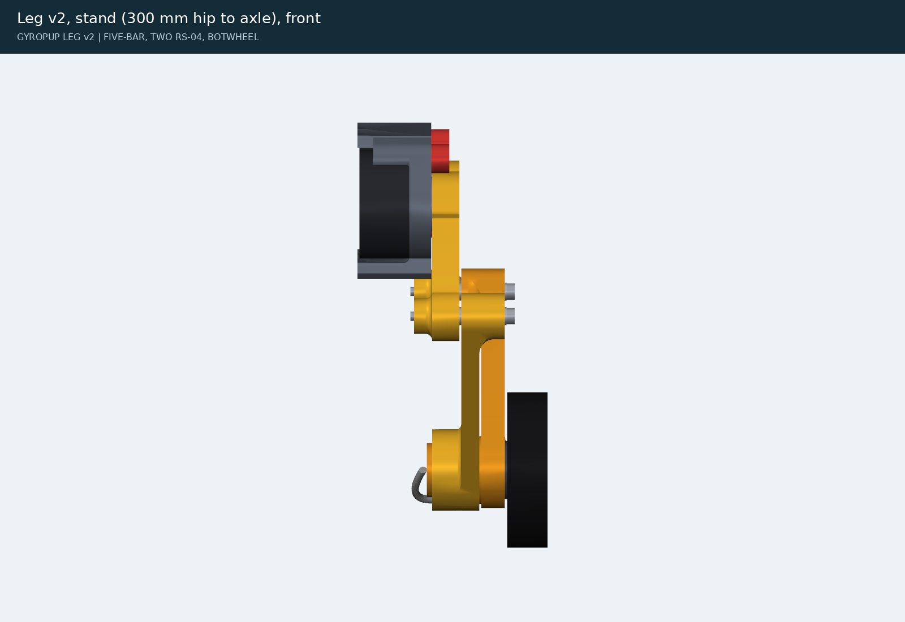
hardware/exports/leg/leg-stand-front.png
