Valpatel/gyropup/hardware/exports/leg/leg-stand-inside.png

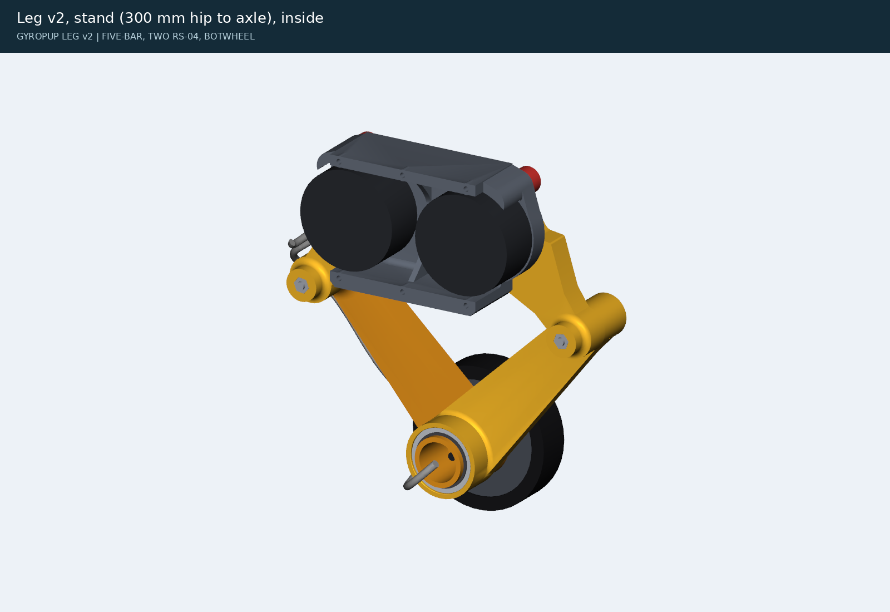
hardware/exports/leg/leg-stand-inside.png
