Valpatel/gyropup/hardware/exports/leg/leg-tall-outside.png

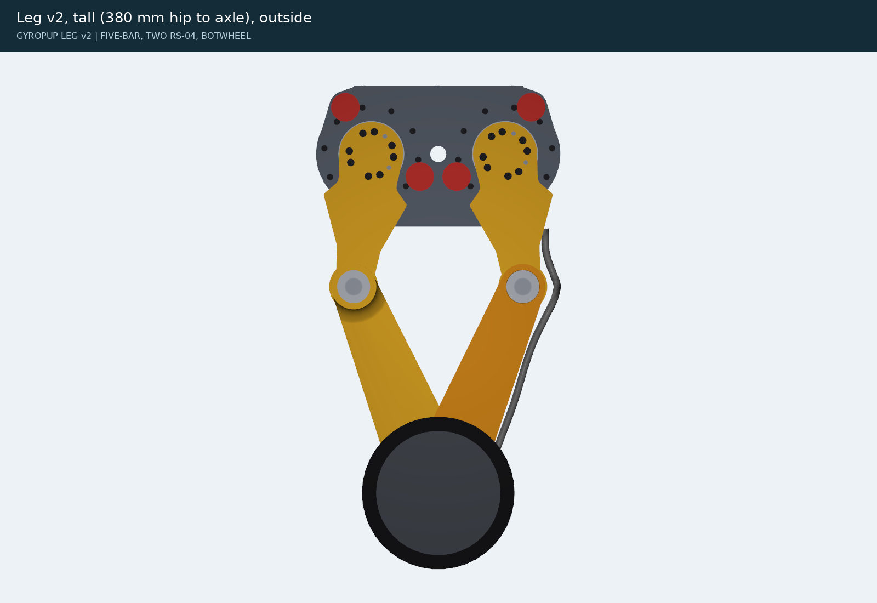
hardware/exports/leg/leg-tall-outside.png
