Valpatel/gyropup/hardware/exports/leg/rs04-fit-job/critical-layers.png

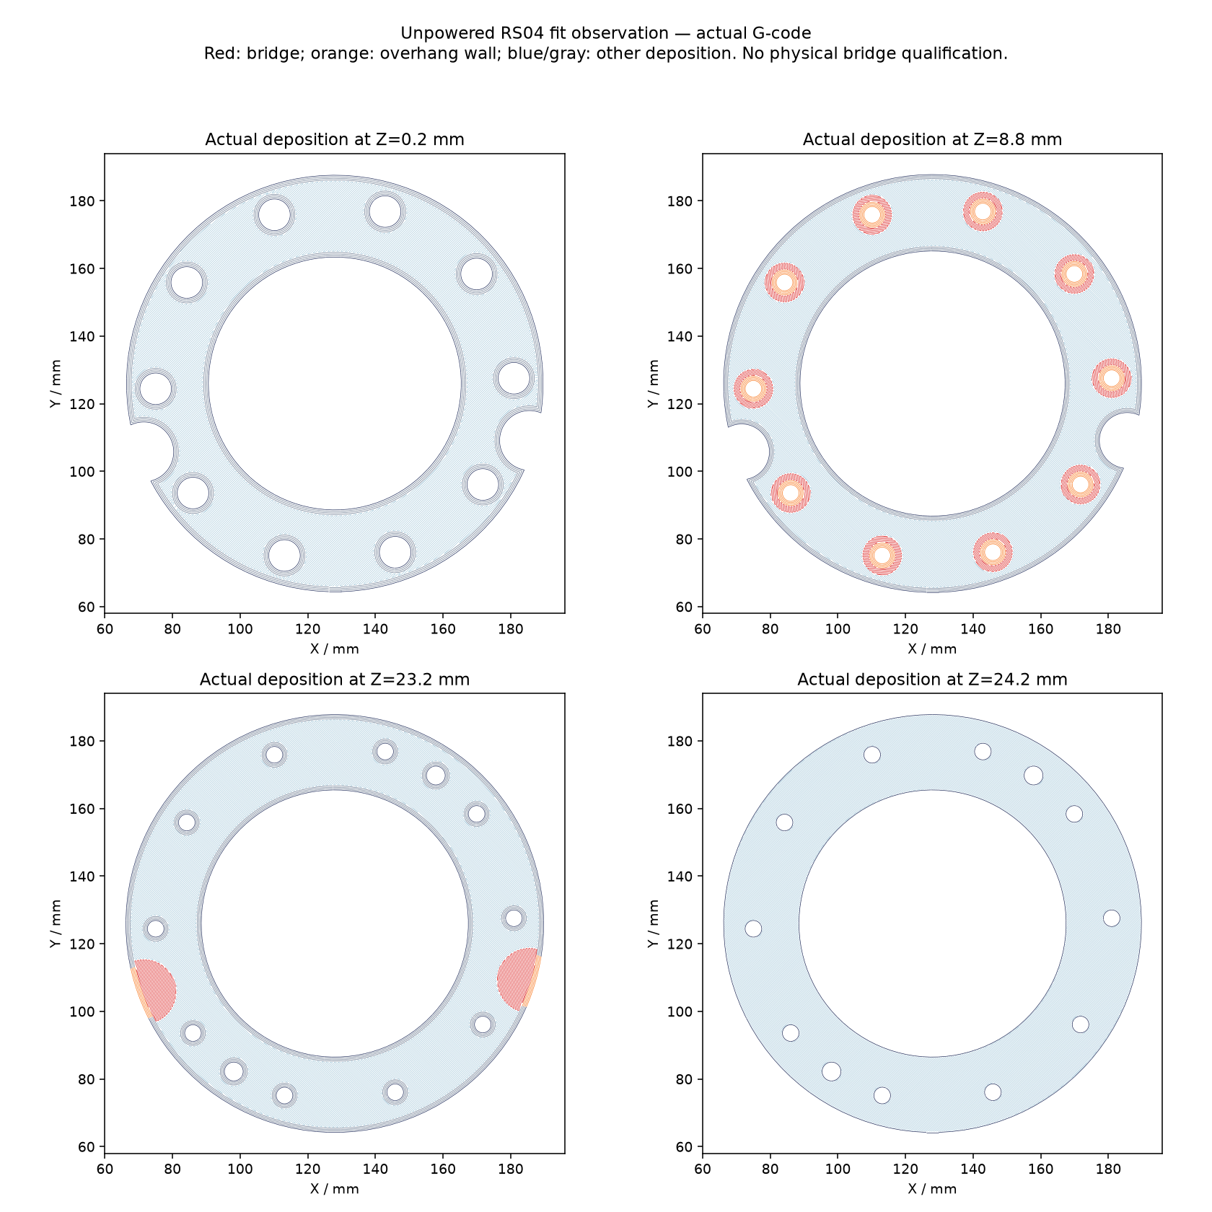
hardware/exports/leg/rs04-fit-job/critical-layers.png
