Valpatel/gyropup/hardware/exports/leg/springs/drop-scan-knee.png

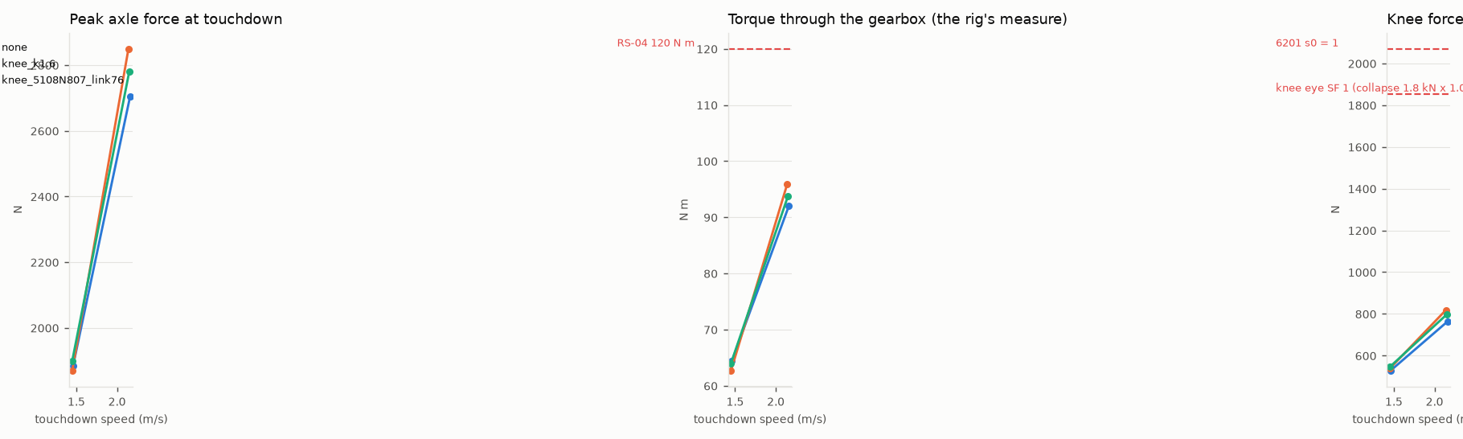
hardware/exports/leg/springs/drop-scan-knee.png
