Valpatel/gyropup/hardware/exports/leg/springs/drop-scan.png

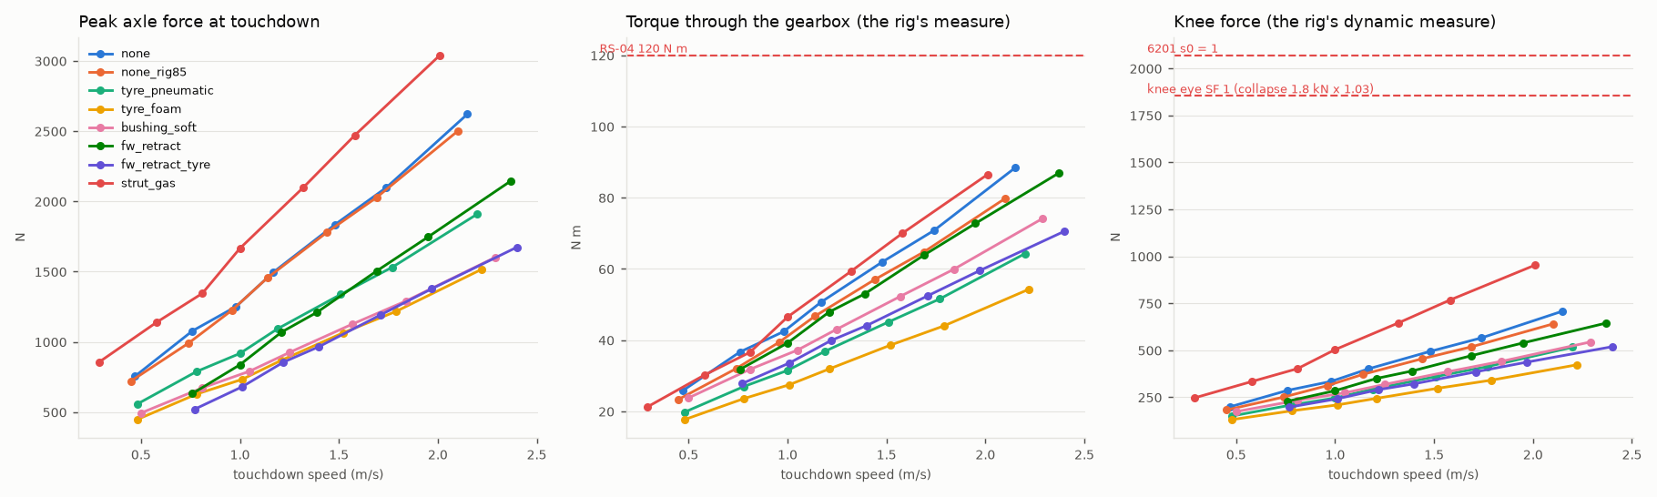
hardware/exports/leg/springs/drop-scan.png
