Valpatel/gyropup/hardware/exports/leg/springs/impact-150.png

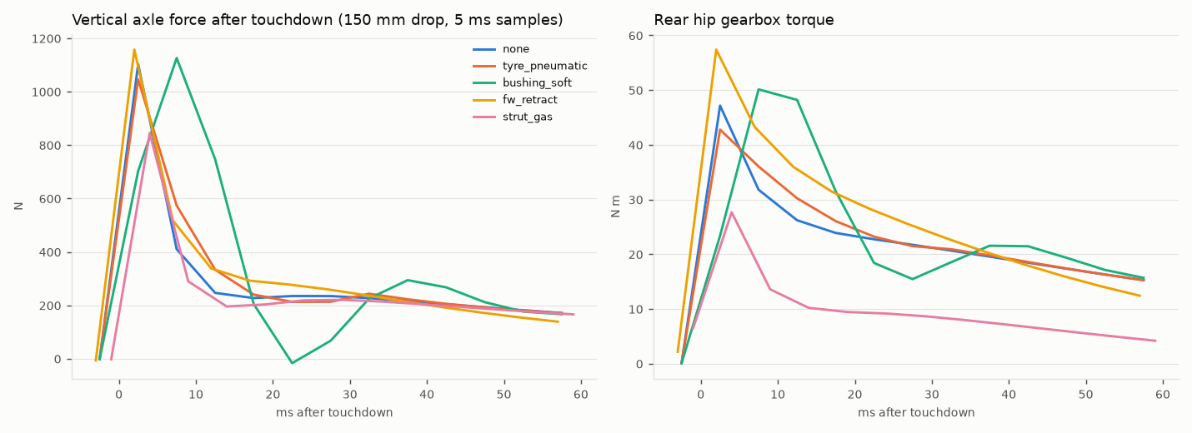
hardware/exports/leg/springs/impact-150.png
