Valpatel/gyropup/hardware/exports/leg/springs/knee-spring-layout.png

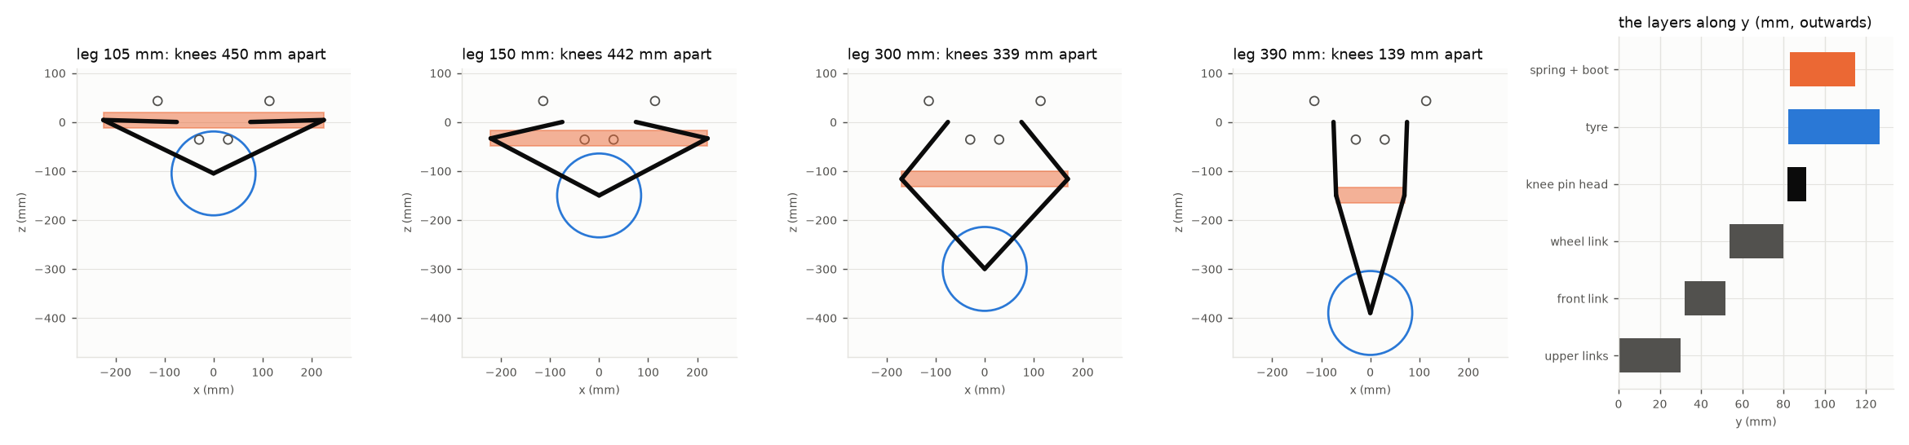
hardware/exports/leg/springs/knee-spring-layout.png
