Valpatel/gyropup/hardware/exports/leg/springs/ride-knee.png

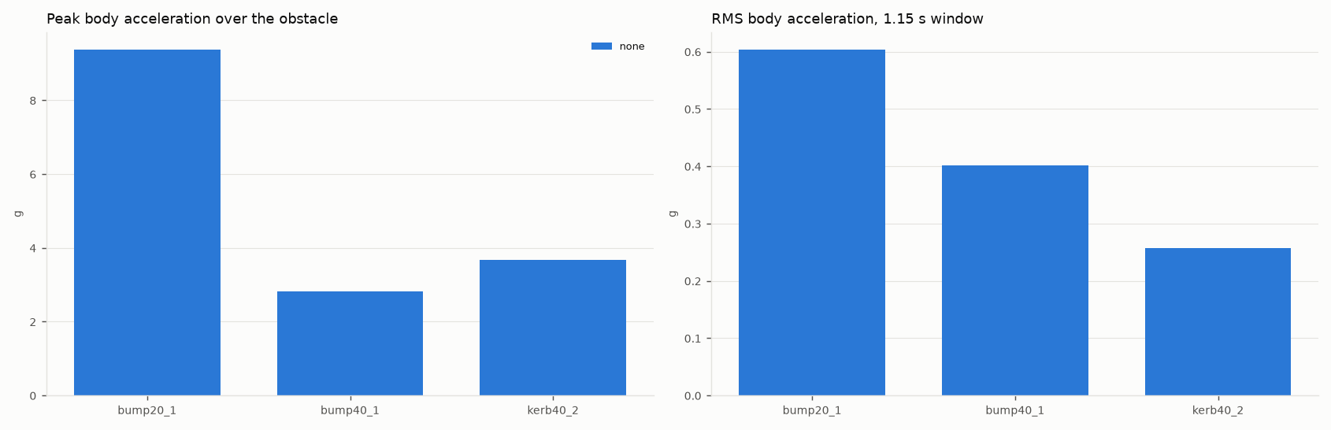
hardware/exports/leg/springs/ride-knee.png
