Valpatel/gyropup/hardware/exports/leg/springs/ride.png

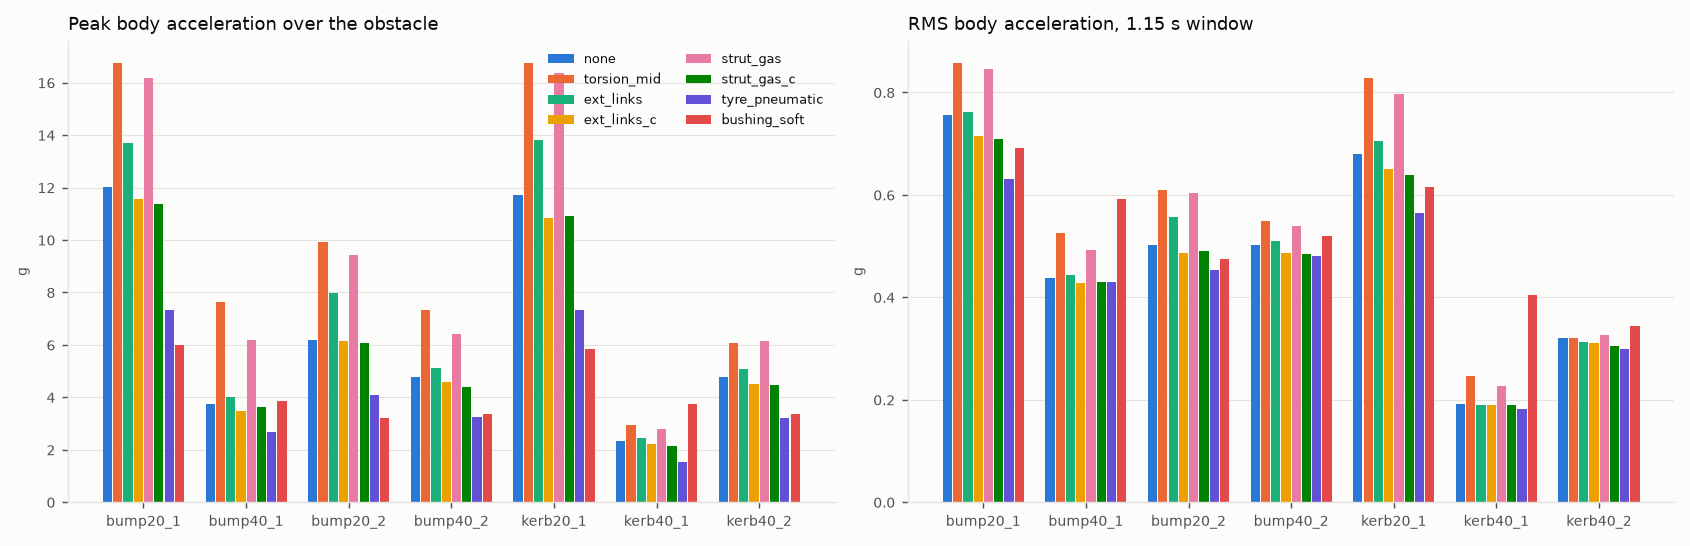
hardware/exports/leg/springs/ride.png
