Valpatel/gyropup/hardware/exports/leg/springs/scorecard-knee.png

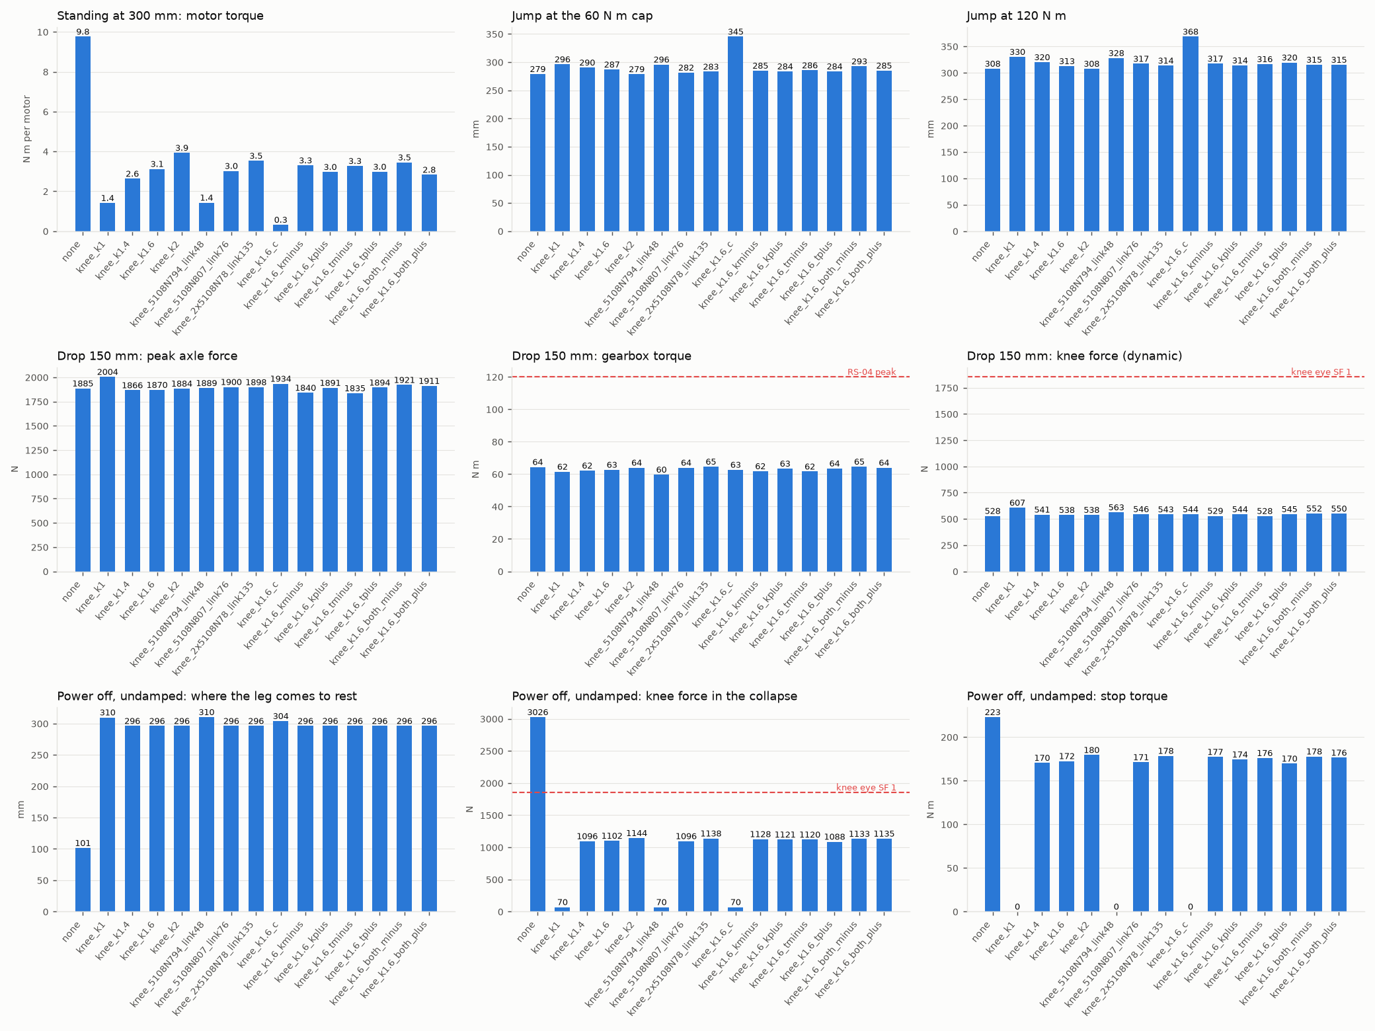
hardware/exports/leg/springs/scorecard-knee.png
