Valpatel/gyropup/hardware/exports/leg/springs/scorecard.png

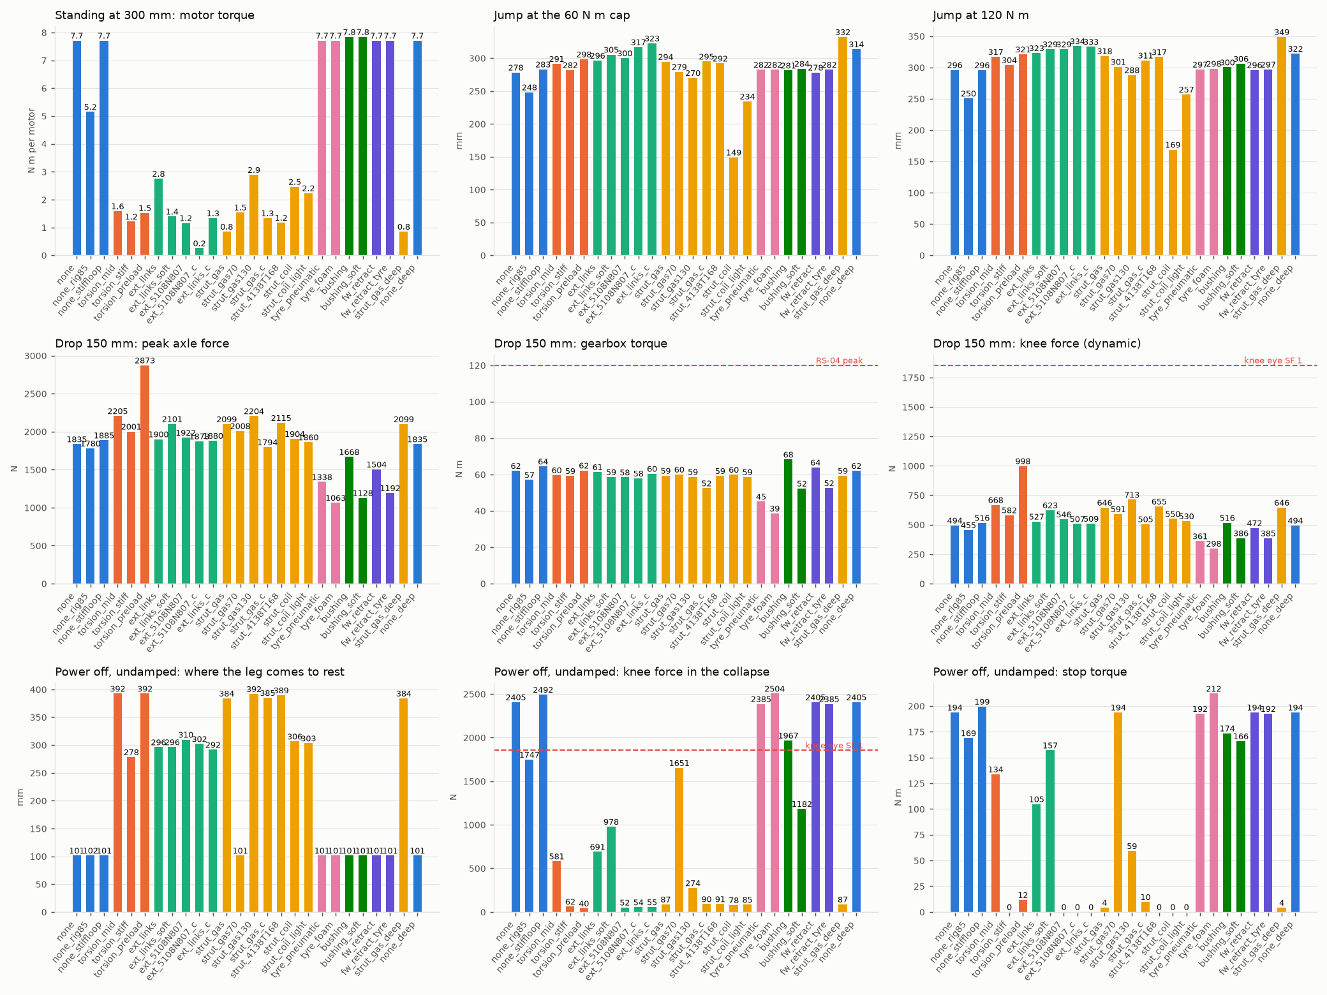
hardware/exports/leg/springs/scorecard.png
