Valpatel/gyropup/hardware/exports/leg/springs/static-curves-knee.png

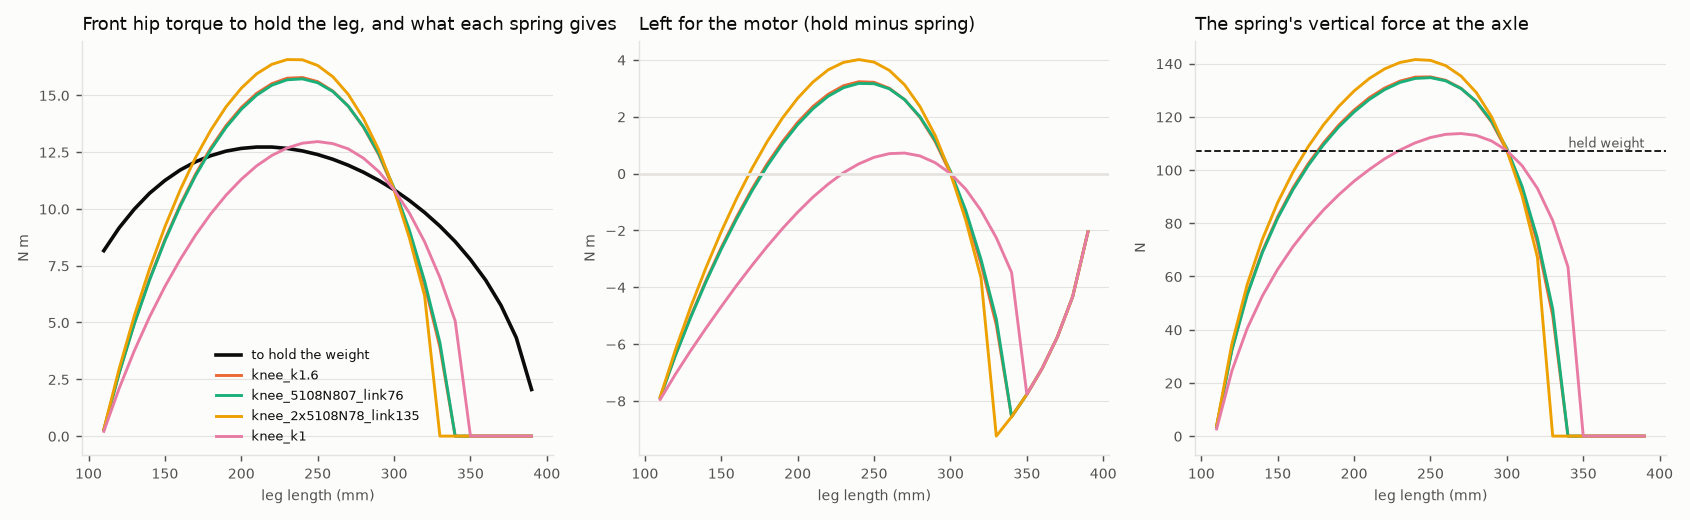
hardware/exports/leg/springs/static-curves-knee.png
