Valpatel/gyropup/hardware/exports/leg/springs/static-curves.png

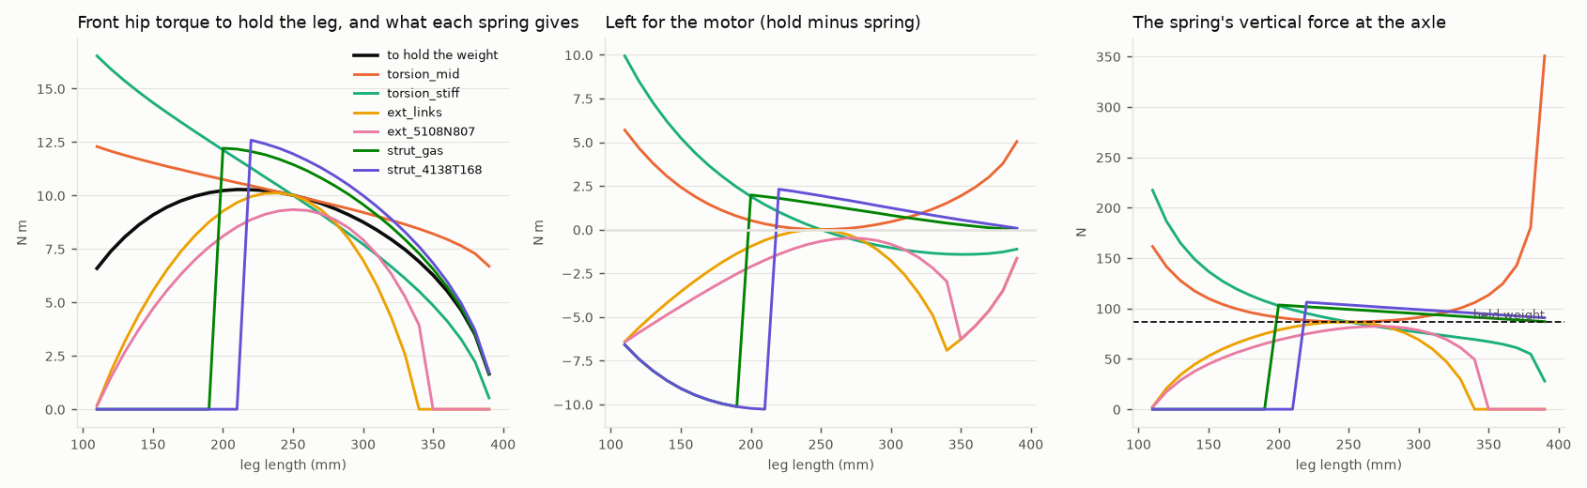
hardware/exports/leg/springs/static-curves.png
