Valpatel/gyropup/hardware/exports/leg/springs/sweep-ext.png

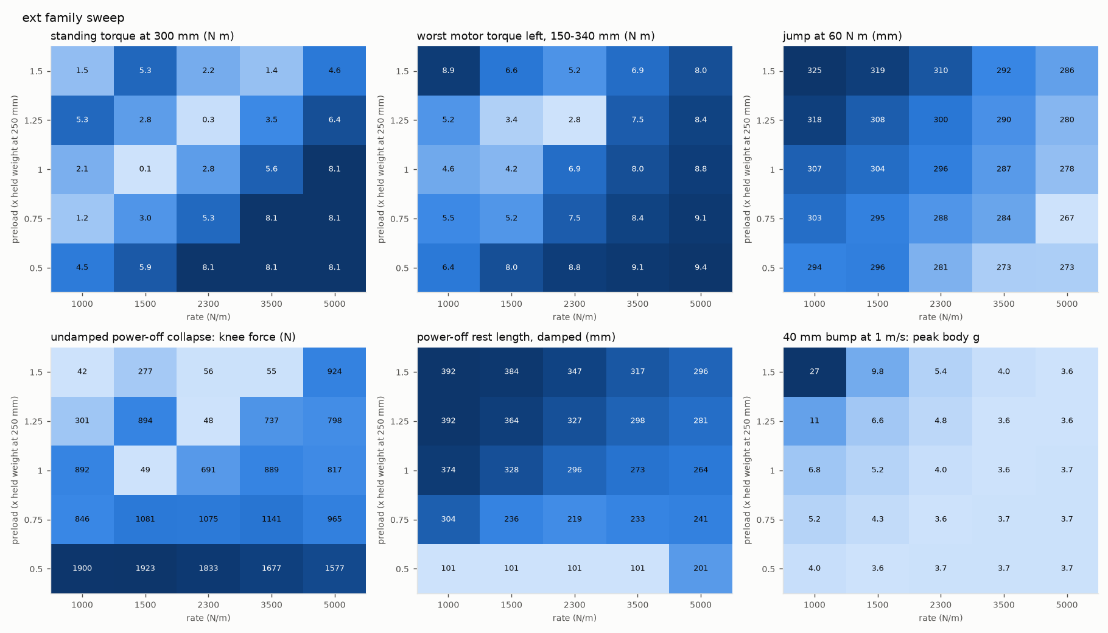
hardware/exports/leg/springs/sweep-ext.png
