Valpatel/gyropup/hardware/exports/leg/springs/sweep-knee-knee.png

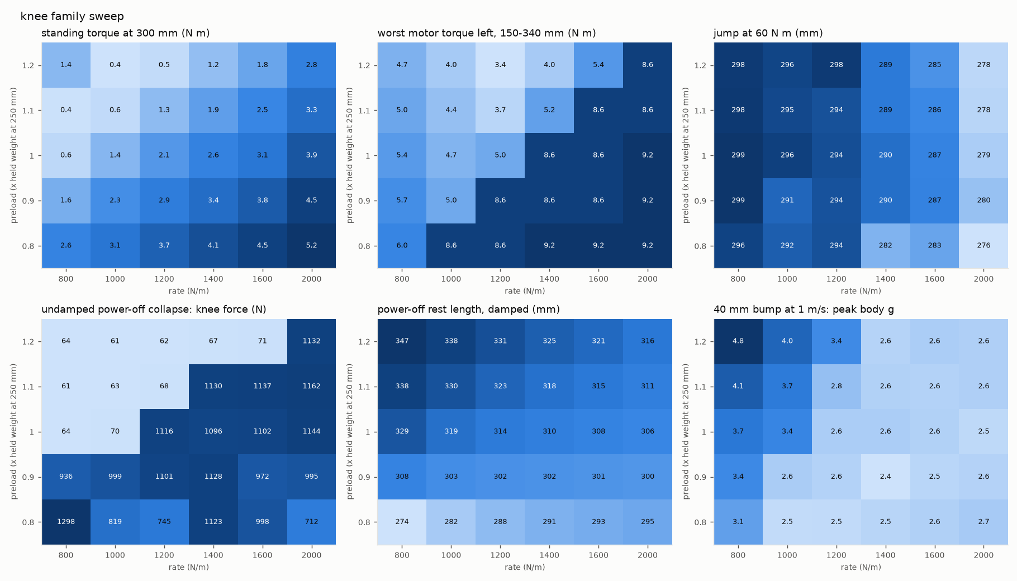
hardware/exports/leg/springs/sweep-knee-knee.png
