Valpatel/gyropup/hardware/exports/leg/springs/sweep-torsion.png

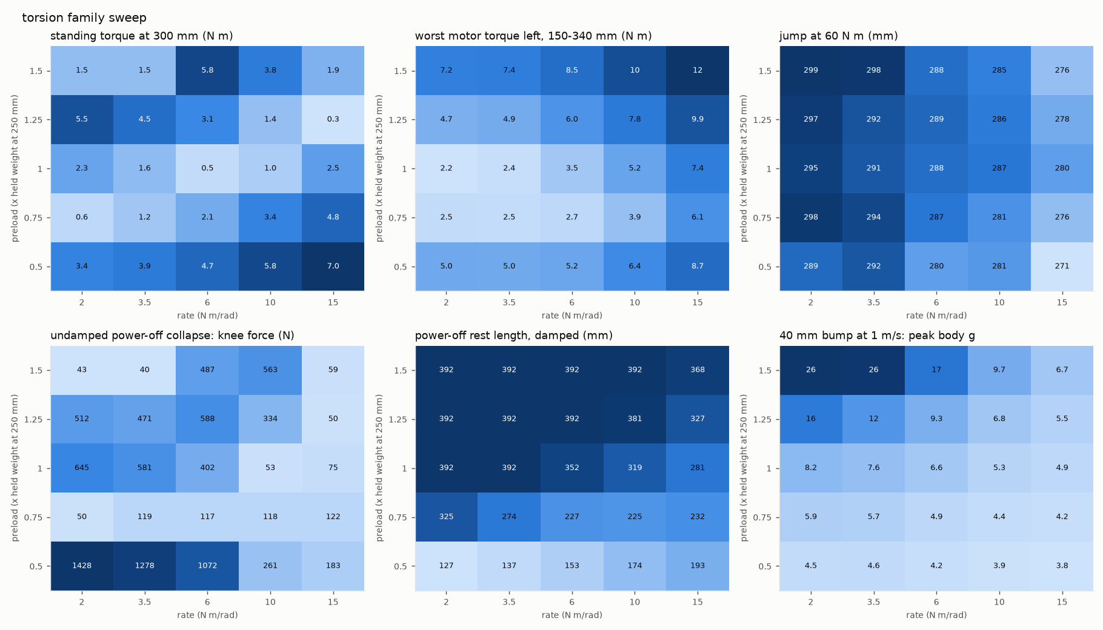
hardware/exports/leg/springs/sweep-torsion.png
