Valpatel/gyropup/hardware/exports/motor-day/drawings/MD-01.png

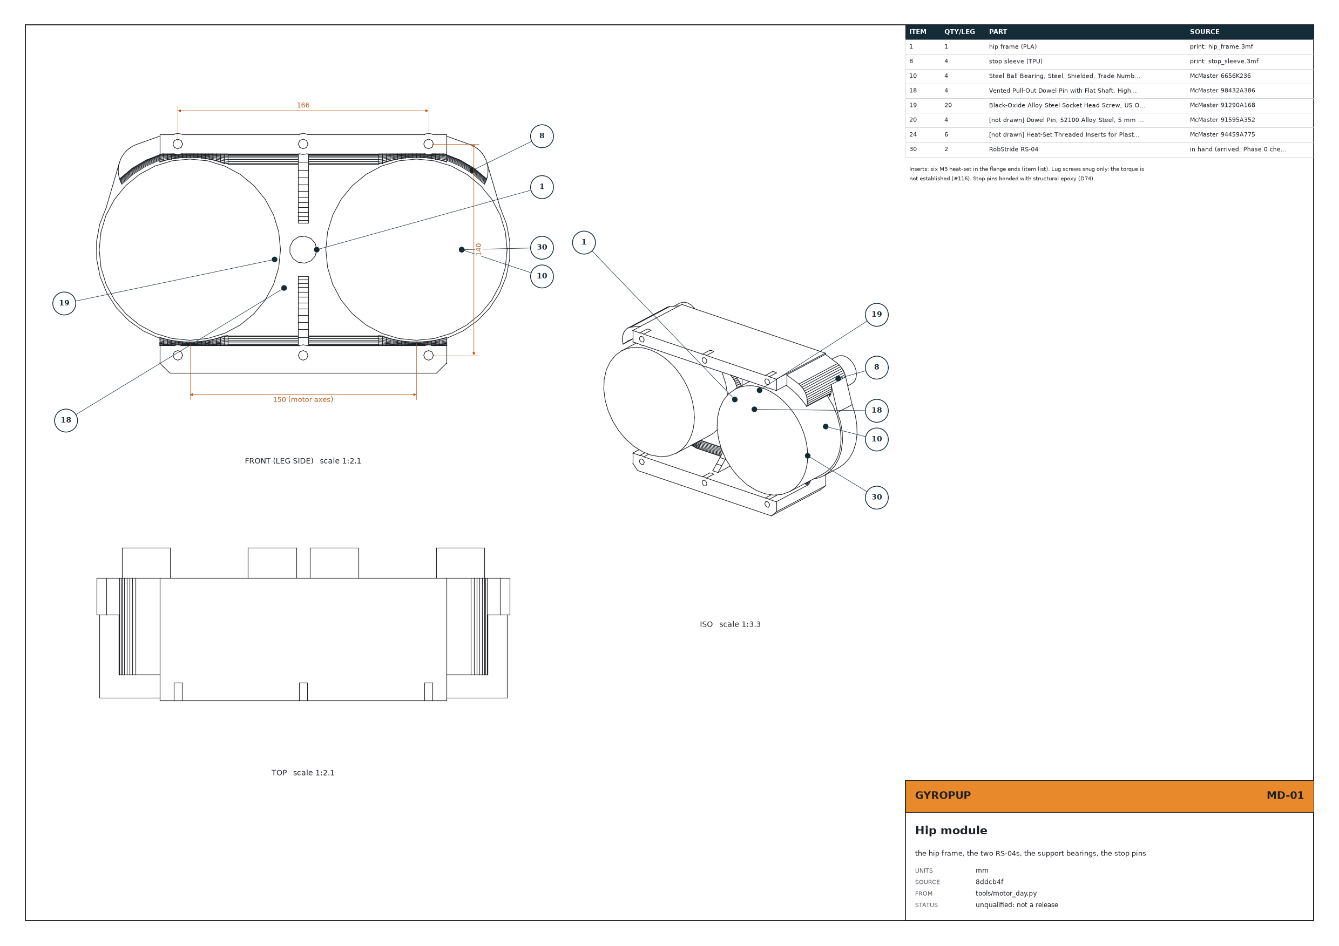
hardware/exports/motor-day/drawings/MD-01.png
