Valpatel/gyropup/hardware/exports/motor-day/drawings/MD-02.png

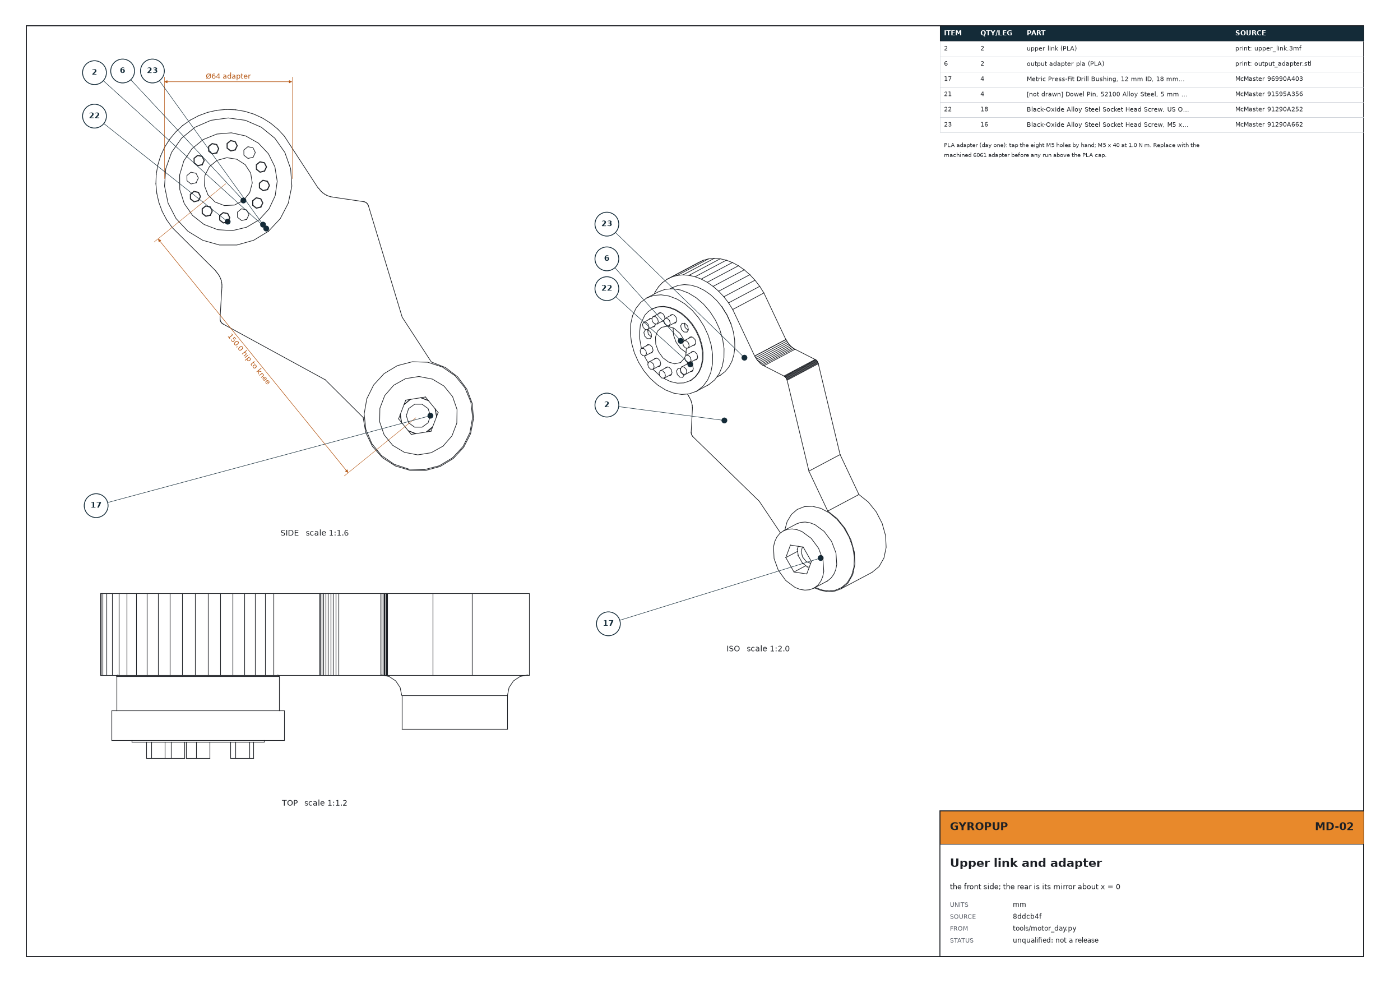
hardware/exports/motor-day/drawings/MD-02.png
