Valpatel/gyropup/hardware/exports/motor-day/drawings/MD-03.png

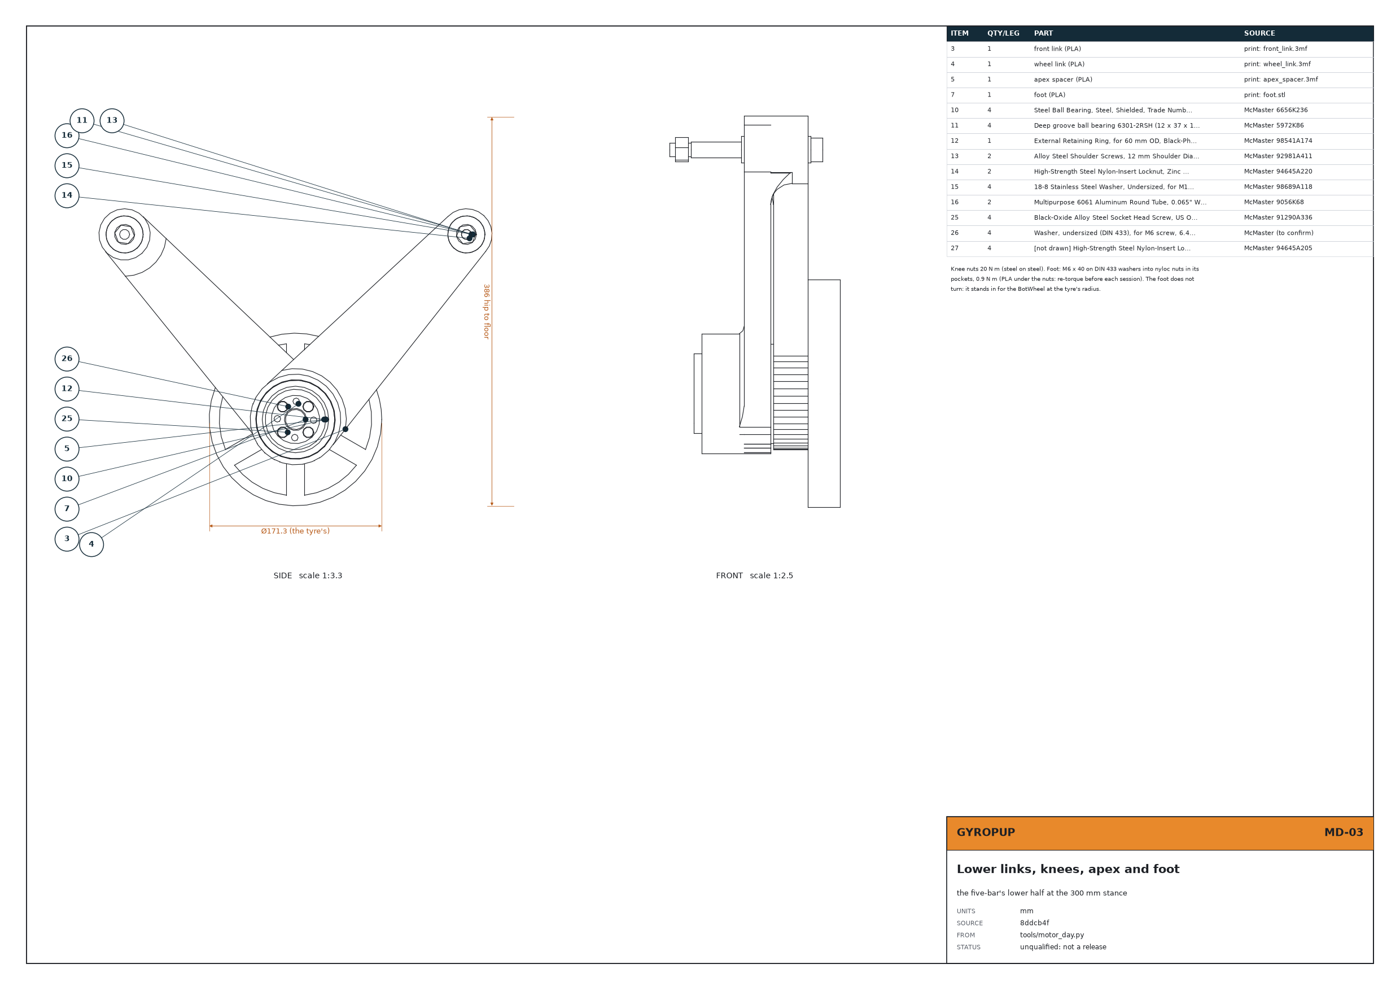
hardware/exports/motor-day/drawings/MD-03.png
