Valpatel/gyropup/hardware/exports/motor-day/drawings/MD-04.png

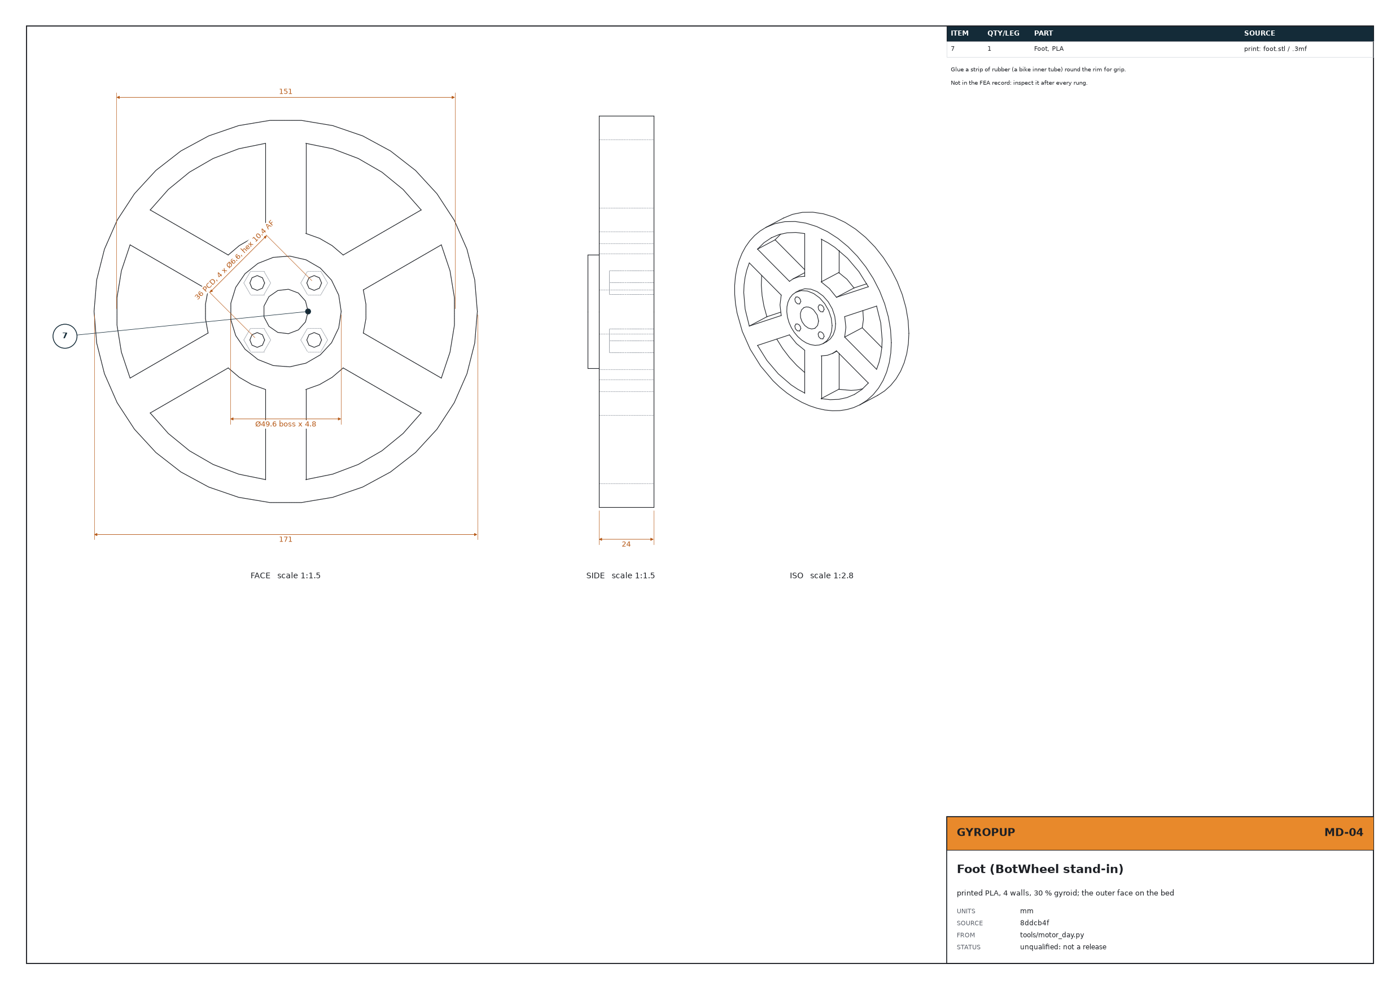
hardware/exports/motor-day/drawings/MD-04.png
