Valpatel/gyropup/hardware/exports/motor-day/drawings/MD-05.png

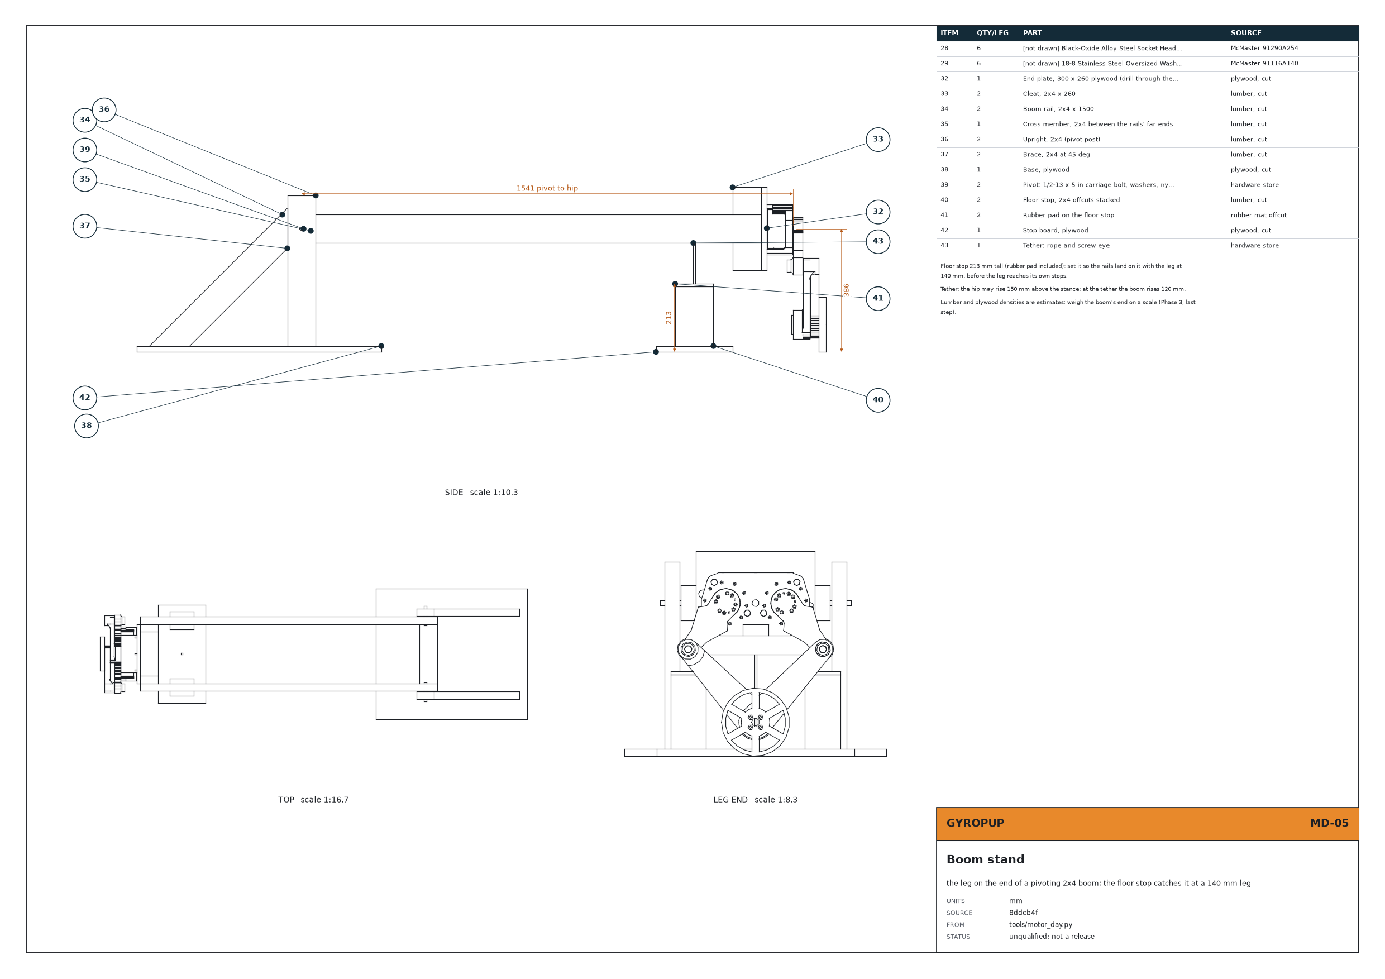
hardware/exports/motor-day/drawings/MD-05.png
