Valpatel/gyropup/hardware/exports/rig/rig-back.png

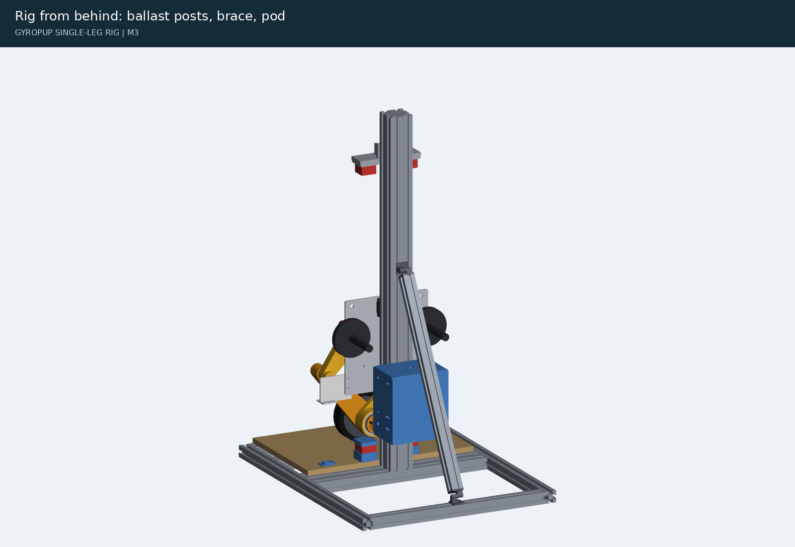
hardware/exports/rig/rig-back.png
