Valpatel/gyropup/hardware/exports/rig/rig-crouch.png

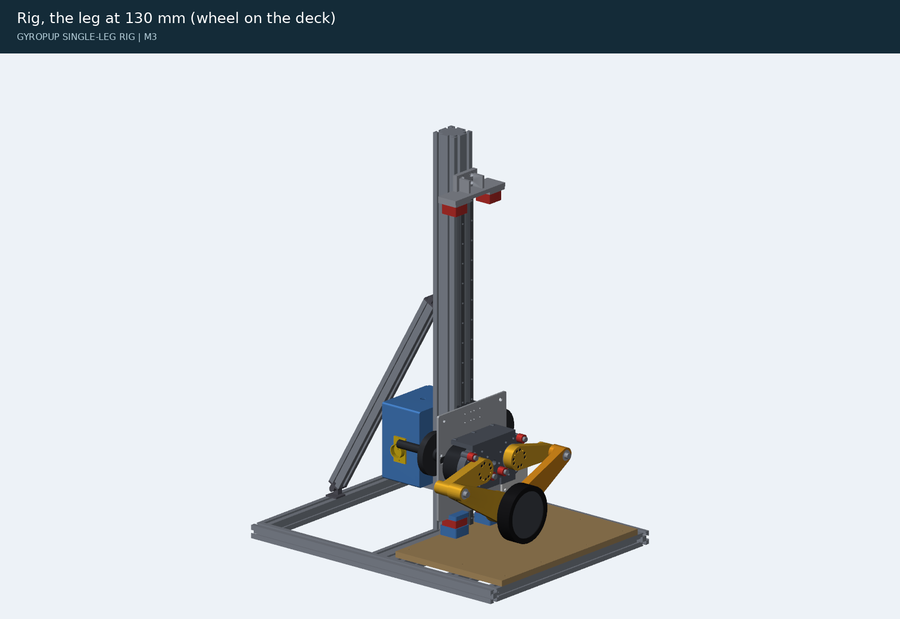
hardware/exports/rig/rig-crouch.png
