Valpatel/gyropup/hardware/exports/rig/runs/2026-11-02-200603-sim-jump-prediction.png

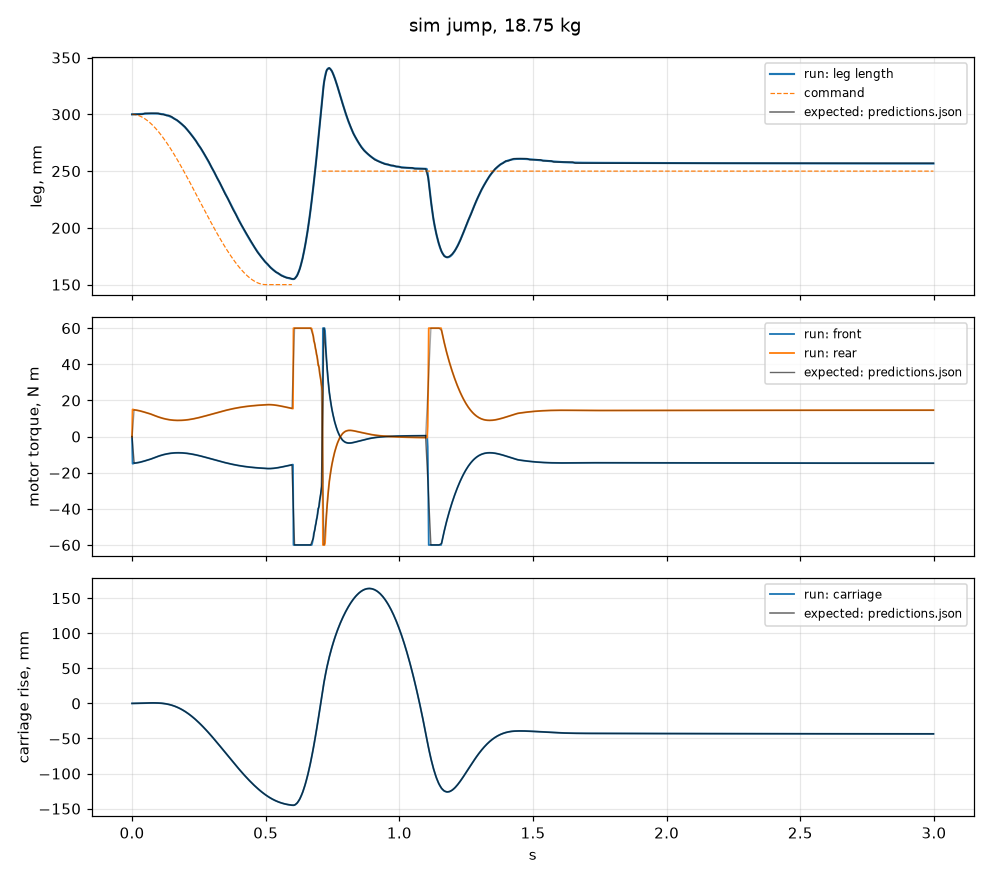
hardware/exports/rig/runs/2026-11-02-200603-sim-jump-prediction.png
