Valpatel/gyropup/hardware/exports/rig/views/carriage-front.png

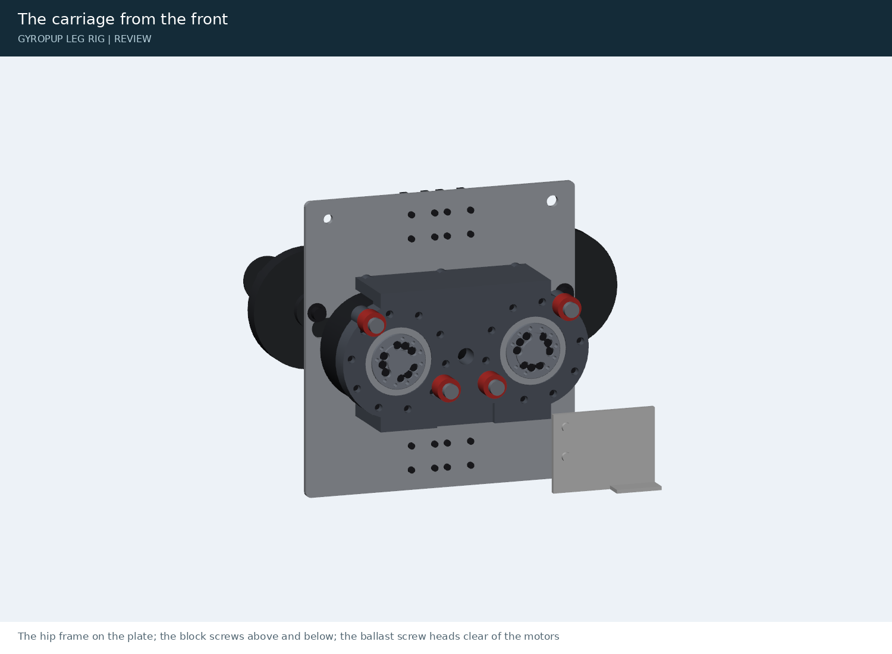
hardware/exports/rig/views/carriage-front.png
