Valpatel/gyropup/hardware/exports/rig/views/rig-exploded.png

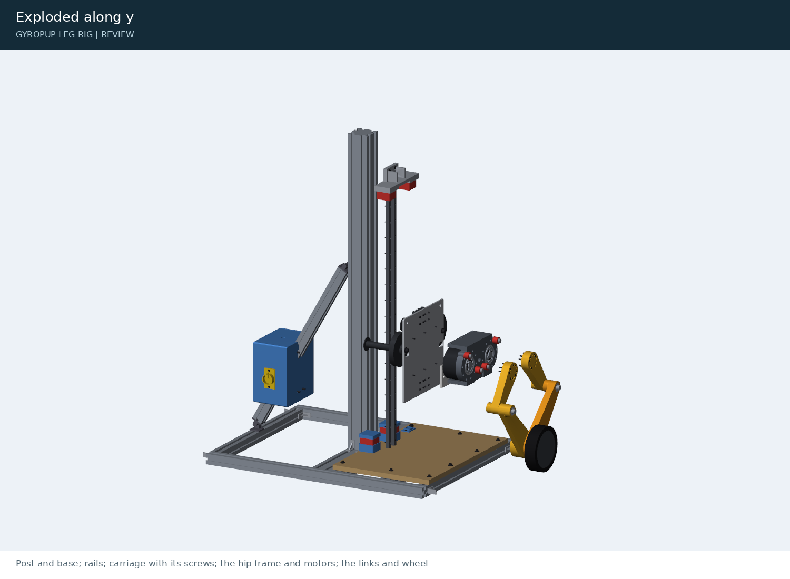
hardware/exports/rig/views/rig-exploded.png
