Valpatel/gyropup/hardware/exports/rig/views/rig-section-plan.png

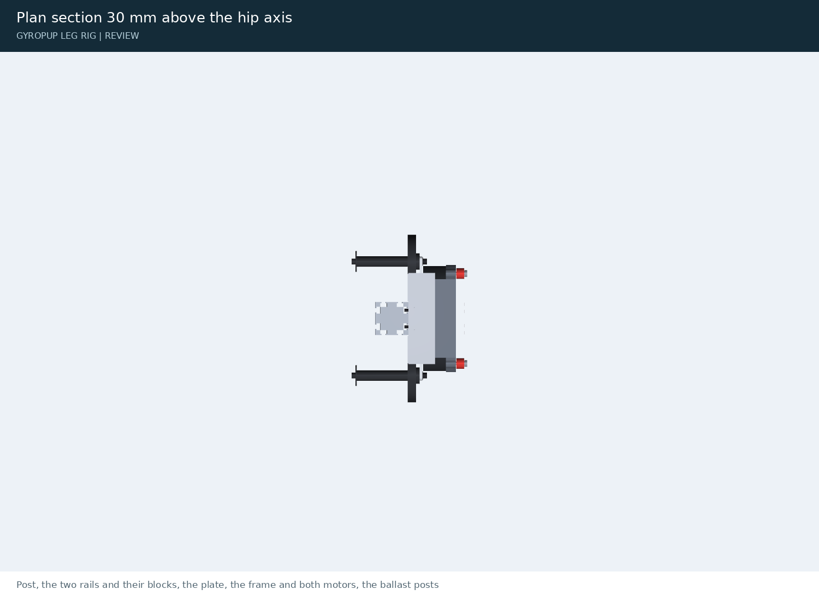
hardware/exports/rig/views/rig-section-plan.png
