Valpatel/gyropup/hardware/exports/rig/views/rig-section.png

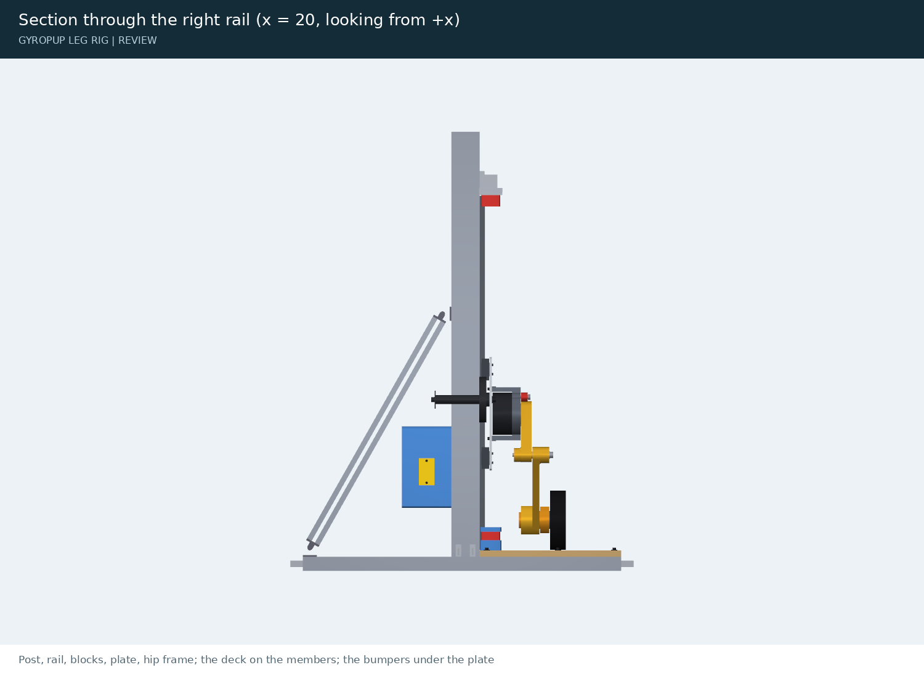
hardware/exports/rig/views/rig-section.png
