Valpatel/gyropup/hardware/exports/rig/views/rig-solid-back.png

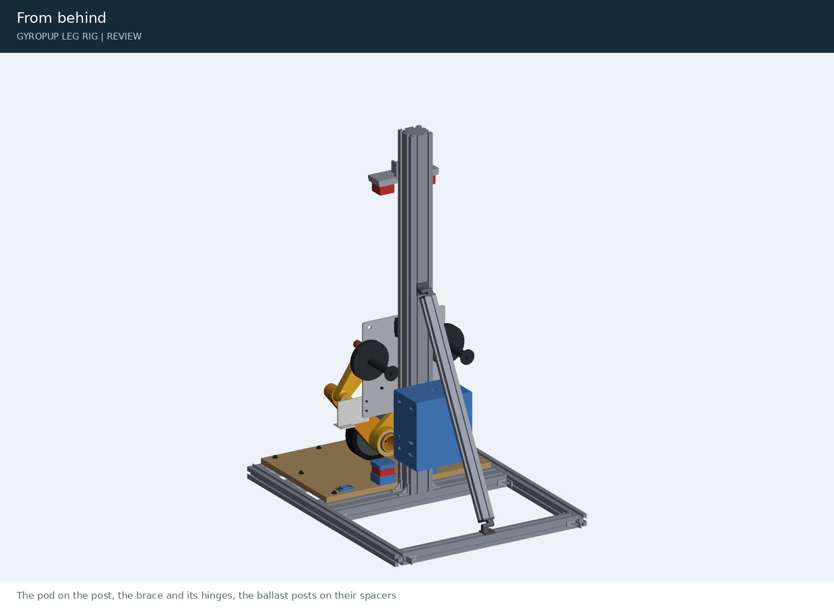
hardware/exports/rig/views/rig-solid-back.png
