Valpatel/gyropup/hardware/exports/thumbs/barrel.png

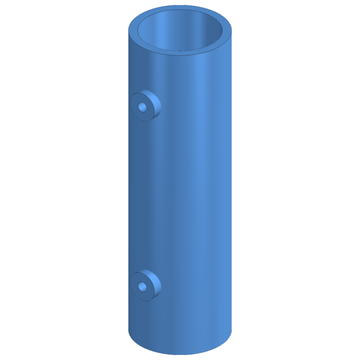
hardware/exports/thumbs/barrel.png
