Valpatel/gyropup/hardware/exports/thumbs/bearing_disc.png

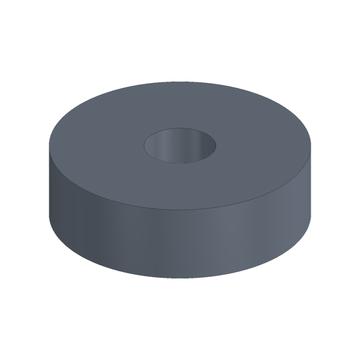
hardware/exports/thumbs/bearing_disc.png
