Valpatel/gyropup/hardware/exports/thumbs/board_bay.png

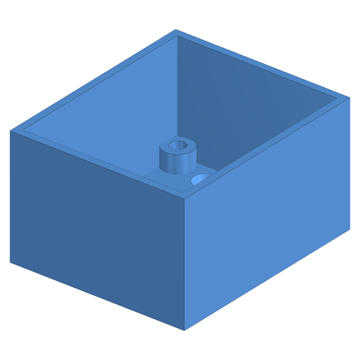
hardware/exports/thumbs/board_bay.png
