Valpatel/gyropup/hardware/exports/thumbs/body--adapter_plate_front.png

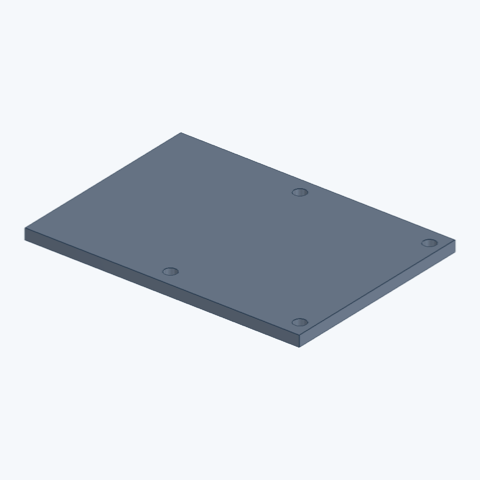
hardware/exports/thumbs/body--adapter_plate_front.png
