Valpatel/gyropup/hardware/exports/thumbs/body--bay_floor.png

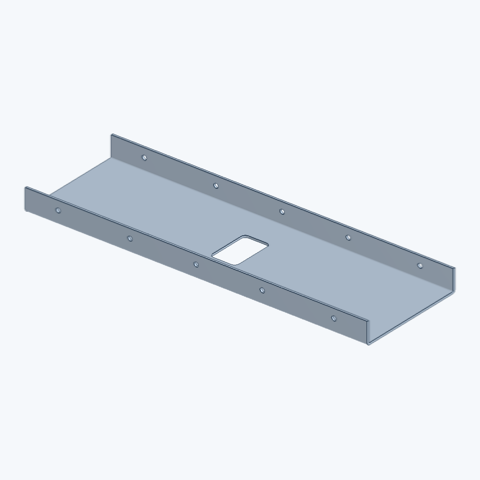
hardware/exports/thumbs/body--bay_floor.png
