Valpatel/gyropup/hardware/exports/thumbs/body--bay_rail_r.png

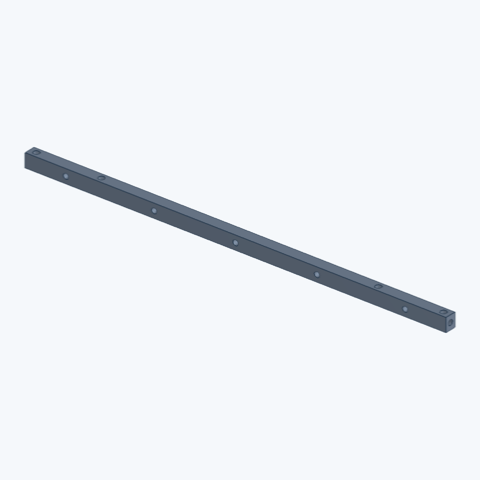
hardware/exports/thumbs/body--bay_rail_r.png
