Valpatel/gyropup/hardware/exports/thumbs/body--bay_skid.png

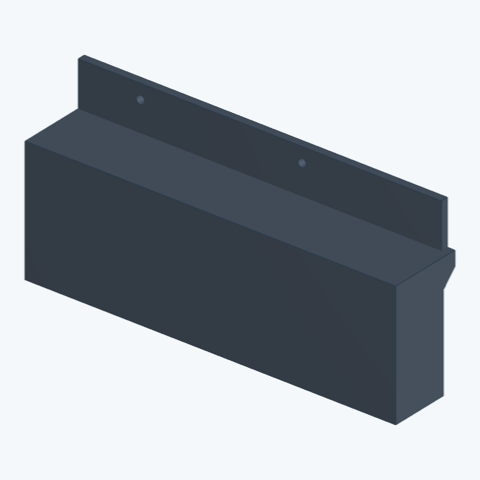
hardware/exports/thumbs/body--bay_skid.png
