Valpatel/gyropup/hardware/exports/thumbs/body--bus_insulator.png

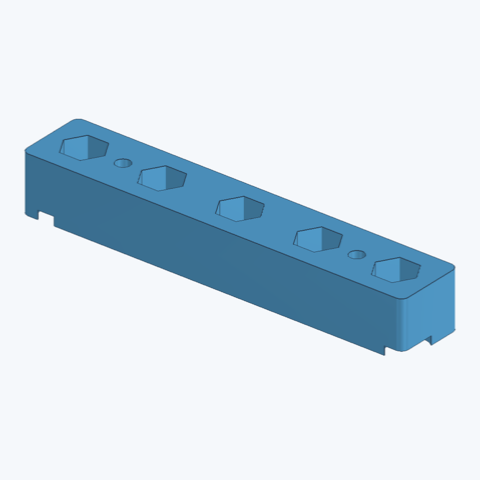
hardware/exports/thumbs/body--bus_insulator.png
