Valpatel/gyropup/hardware/exports/thumbs/body--cheek.png

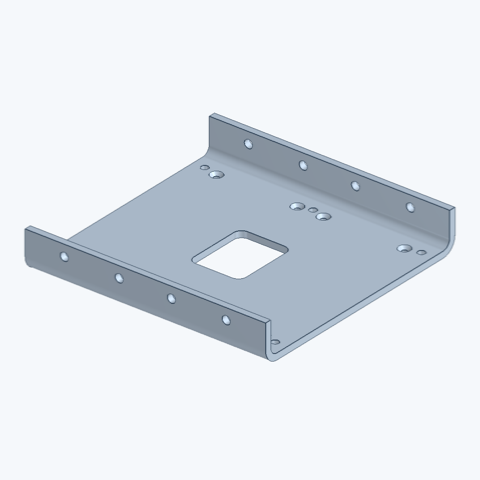
hardware/exports/thumbs/body--cheek.png
