Valpatel/gyropup/hardware/exports/thumbs/body--dcdc_bracket.png

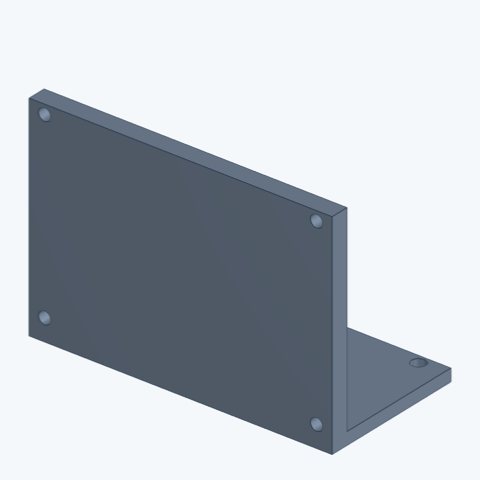
hardware/exports/thumbs/body--dcdc_bracket.png
