Valpatel/gyropup/hardware/exports/thumbs/body--plate_post.png

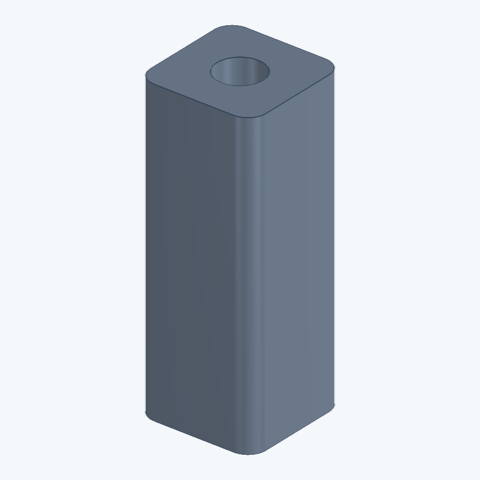
hardware/exports/thumbs/body--plate_post.png
