Valpatel/gyropup/hardware/exports/thumbs/body--power_plate.png

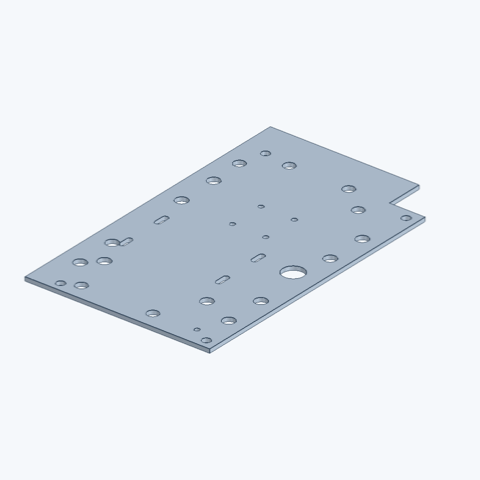
hardware/exports/thumbs/body--power_plate.png
