Valpatel/gyropup/hardware/exports/thumbs/body--riser.png

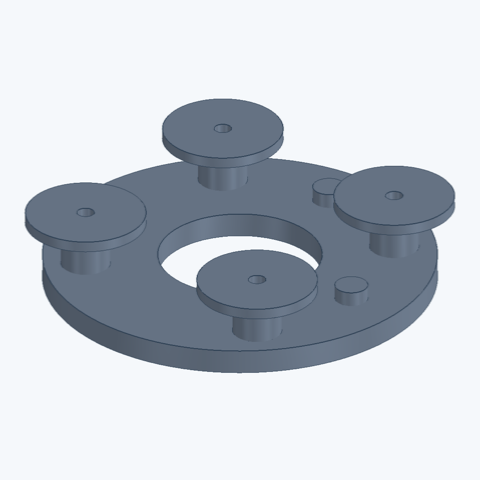
hardware/exports/thumbs/body--riser.png
