Valpatel/gyropup/hardware/exports/thumbs/bumper_base.png

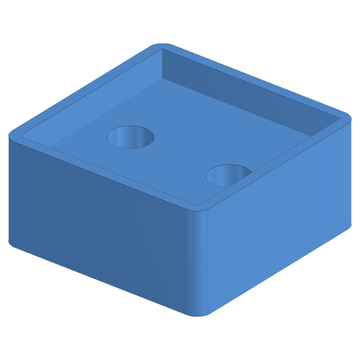
hardware/exports/thumbs/bumper_base.png
