Valpatel/gyropup/hardware/exports/thumbs/bumper_cap.png

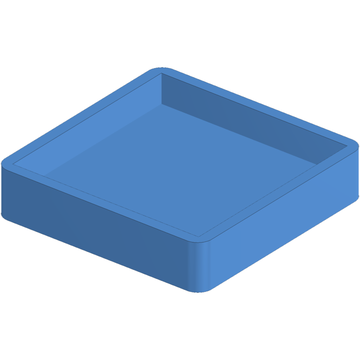
hardware/exports/thumbs/bumper_cap.png
