Valpatel/gyropup/hardware/exports/thumbs/bumper_tpu.png

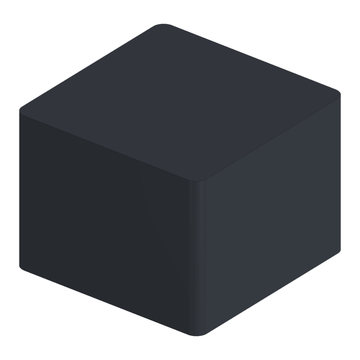
hardware/exports/thumbs/bumper_tpu.png
