Valpatel/gyropup/hardware/exports/thumbs/cartridge_body.png

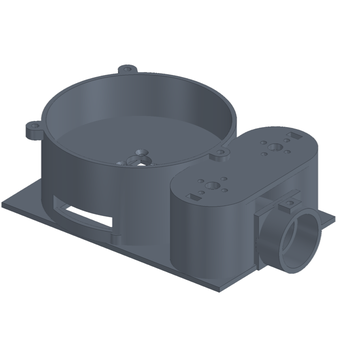
hardware/exports/thumbs/cartridge_body.png
