Valpatel/gyropup/hardware/exports/thumbs/coupon_apex_eye_m01.png

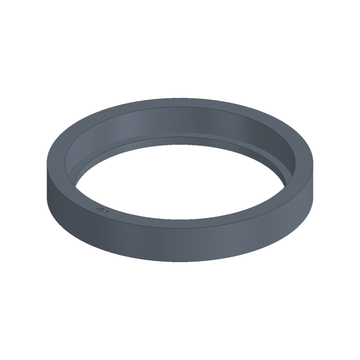
hardware/exports/thumbs/coupon_apex_eye_m01.png
