Valpatel/gyropup/hardware/exports/thumbs/coupon_frame_ring_nom.png

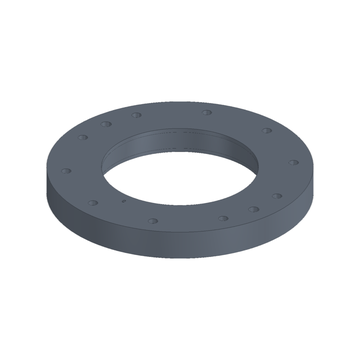
hardware/exports/thumbs/coupon_frame_ring_nom.png
