Valpatel/gyropup/hardware/exports/thumbs/coupon_hub_stub_nom.png

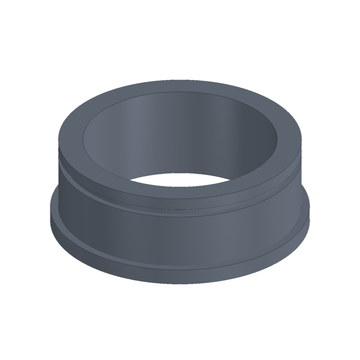
hardware/exports/thumbs/coupon_hub_stub_nom.png
