Valpatel/gyropup/hardware/exports/thumbs/coupon_knee_boss_m01.png

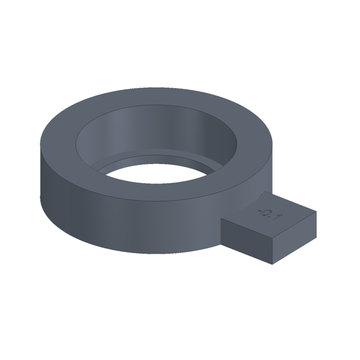
hardware/exports/thumbs/coupon_knee_boss_m01.png
