Valpatel/gyropup/hardware/exports/thumbs/coupon_knee_eye_m01.png

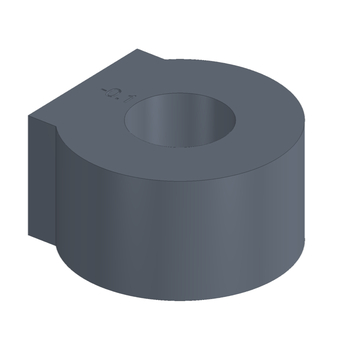
hardware/exports/thumbs/coupon_knee_eye_m01.png
