Valpatel/gyropup/hardware/exports/thumbs/dial.png

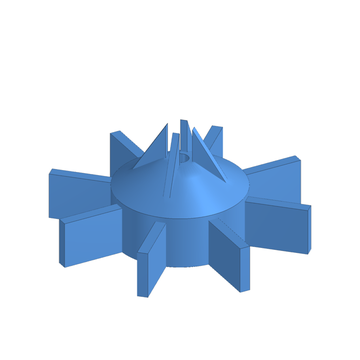
hardware/exports/thumbs/dial.png
