Valpatel/gyropup/hardware/exports/thumbs/drop_bracket.png

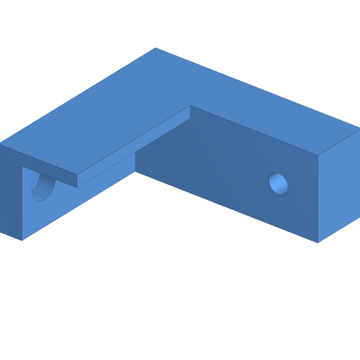
hardware/exports/thumbs/drop_bracket.png
