Valpatel/gyropup/hardware/exports/thumbs/dyno_lug_plate.png

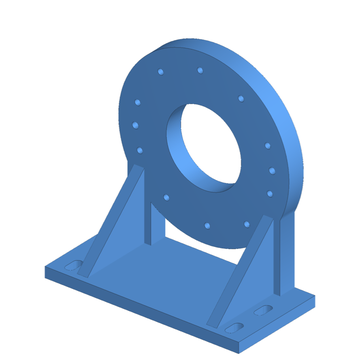
hardware/exports/thumbs/dyno_lug_plate.png
