Valpatel/gyropup/hardware/exports/thumbs/front_link.png

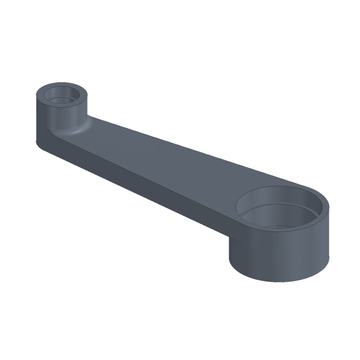
hardware/exports/thumbs/front_link.png
