Valpatel/gyropup/hardware/exports/thumbs/hopper.png

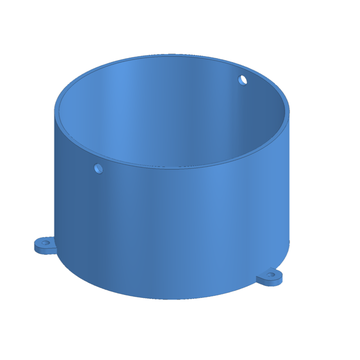
hardware/exports/thumbs/hopper.png
