Valpatel/gyropup/hardware/exports/thumbs/hopper_lid.png

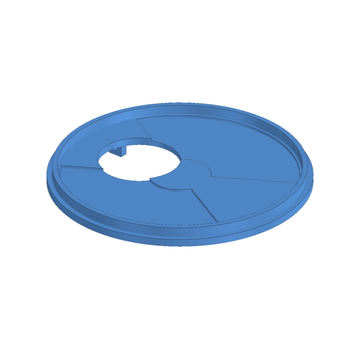
hardware/exports/thumbs/hopper_lid.png
