Valpatel/gyropup/hardware/exports/thumbs/leg--output_adapter.png

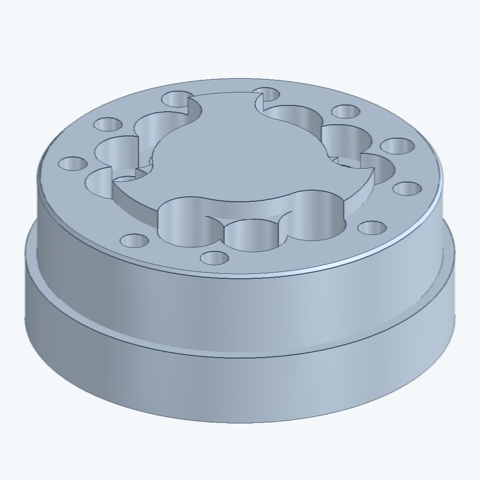
hardware/exports/thumbs/leg--output_adapter.png
