Valpatel/gyropup/hardware/exports/thumbs/load_cell_mount.png

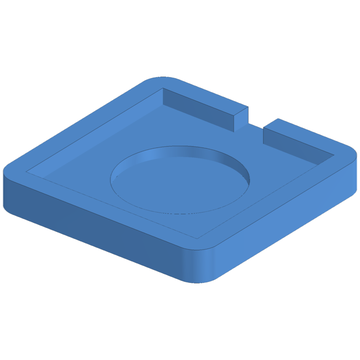
hardware/exports/thumbs/load_cell_mount.png
