Valpatel/gyropup/hardware/exports/thumbs/pan_base.png

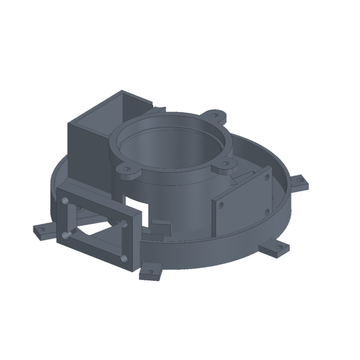
hardware/exports/thumbs/pan_base.png
