Valpatel/gyropup/hardware/exports/thumbs/pan_pinion.png

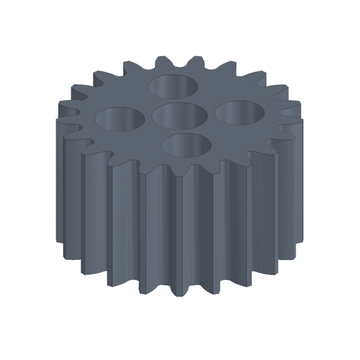
hardware/exports/thumbs/pan_pinion.png
