Valpatel/gyropup/hardware/exports/thumbs/pendant_clip.png

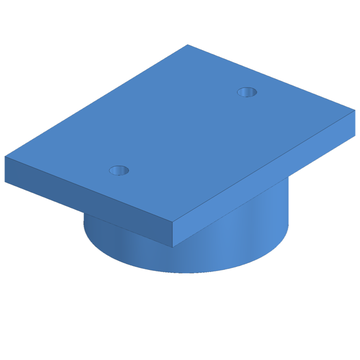
hardware/exports/thumbs/pendant_clip.png
