Valpatel/gyropup/hardware/exports/thumbs/pod.png

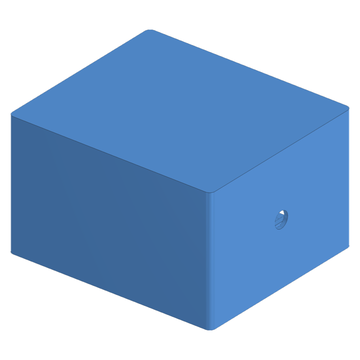
hardware/exports/thumbs/pod.png
