Valpatel/gyropup/hardware/exports/thumbs/pod_lid.png

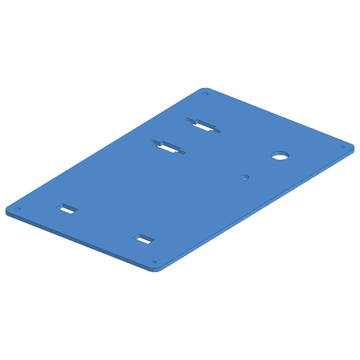
hardware/exports/thumbs/pod_lid.png
