Valpatel/gyropup/hardware/exports/thumbs/press_base.png

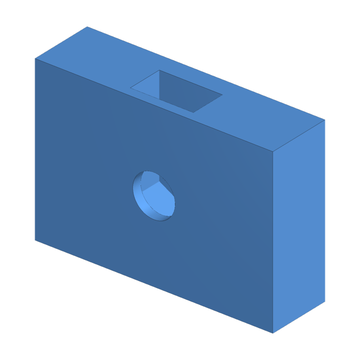
hardware/exports/thumbs/press_base.png
