Valpatel/gyropup/hardware/exports/thumbs/puller_m5.png

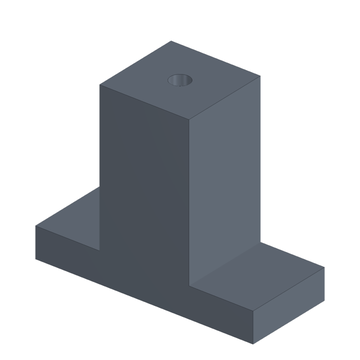
hardware/exports/thumbs/puller_m5.png
