Valpatel/gyropup/hardware/exports/thumbs/rig--carriage_plate.png

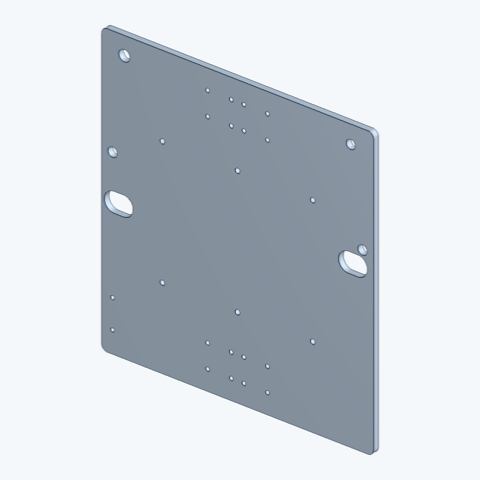
hardware/exports/thumbs/rig--carriage_plate.png
