Valpatel/gyropup/hardware/exports/thumbs/ring_driver.png

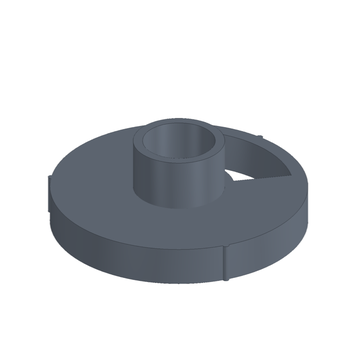
hardware/exports/thumbs/ring_driver.png
