Valpatel/gyropup/hardware/exports/thumbs/sleeve_anvil.png

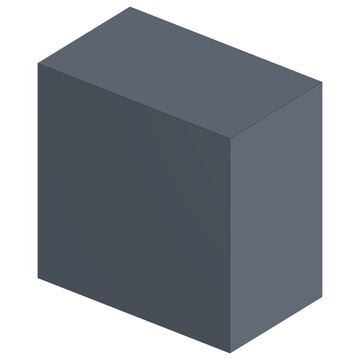
hardware/exports/thumbs/sleeve_anvil.png
