Valpatel/gyropup/hardware/exports/thumbs/sleeve_block.png

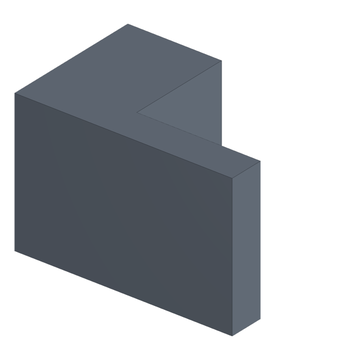
hardware/exports/thumbs/sleeve_block.png
