Valpatel/gyropup/hardware/exports/thumbs/stand_box.png

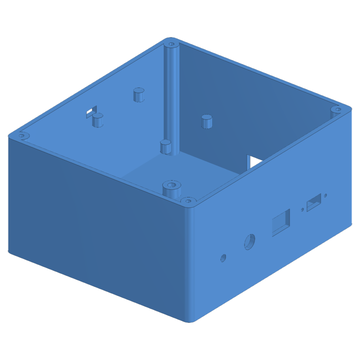
hardware/exports/thumbs/stand_box.png
