Valpatel/gyropup/hardware/exports/thumbs/tilt_yoke.png

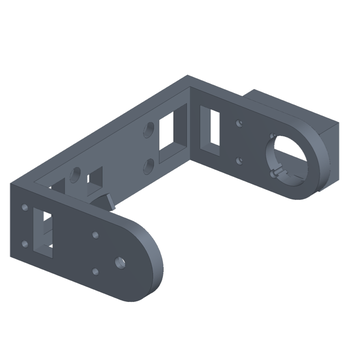
hardware/exports/thumbs/tilt_yoke.png
