Valpatel/gyropup/hardware/exports/thumbs/tof_arm.png

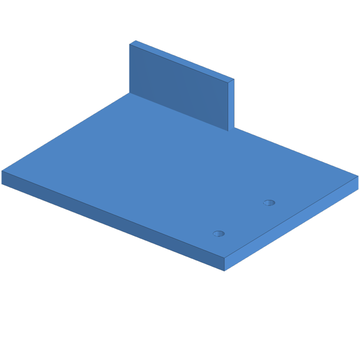
hardware/exports/thumbs/tof_arm.png
