Valpatel/gyropup/hardware/exports/thumbs/tof_mount.png

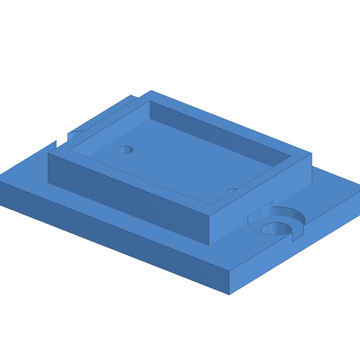
hardware/exports/thumbs/tof_mount.png
