Valpatel/gyropup/hardware/exports/thumbs/top_stop_bracket.png

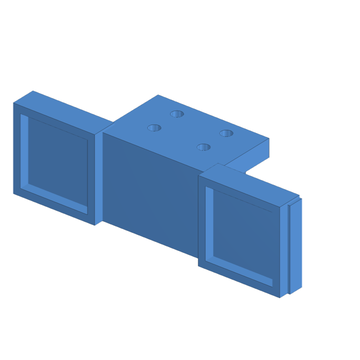
hardware/exports/thumbs/top_stop_bracket.png
