Valpatel/gyropup/hardware/exports/thumbs/turret--cradle_plate_l.png

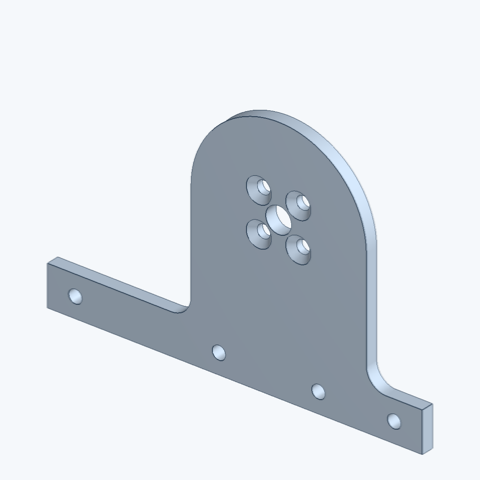
hardware/exports/thumbs/turret--cradle_plate_l.png
