Valpatel/gyropup/hardware/exports/thumbs/turret--pan_clamp.png

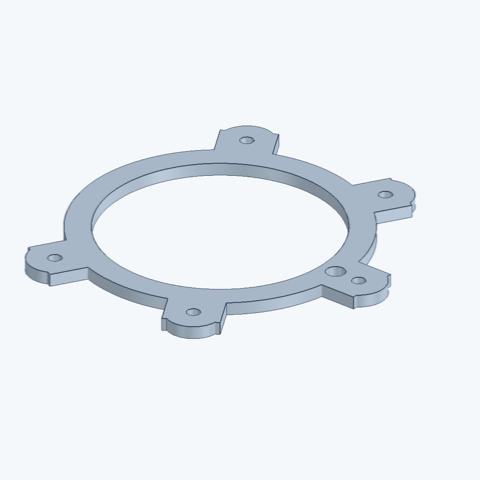
hardware/exports/thumbs/turret--pan_clamp.png
