Valpatel/gyropup/hardware/exports/thumbs/turret--stop_lug.png

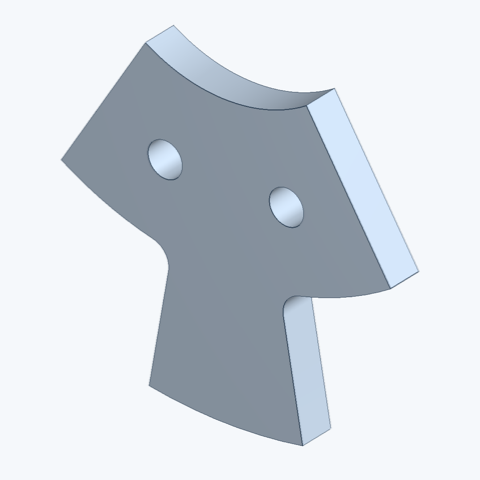
hardware/exports/thumbs/turret--stop_lug.png
