Valpatel/gyropup/hardware/exports/thumbs/upper_link.png

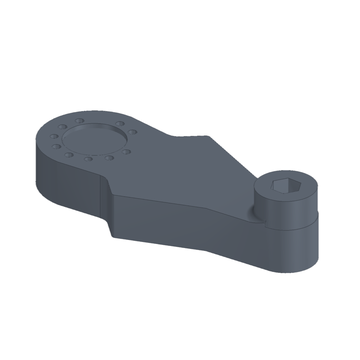
hardware/exports/thumbs/upper_link.png
