Valpatel/gyropup/hardware/exports/thumbs/wheel_link.png

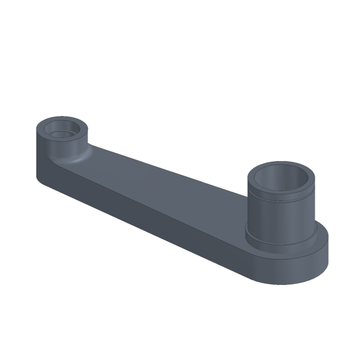
hardware/exports/thumbs/wheel_link.png
