Valpatel/gyropup/hardware/exports/turret/bench/turret-bench-aimed-iso.png

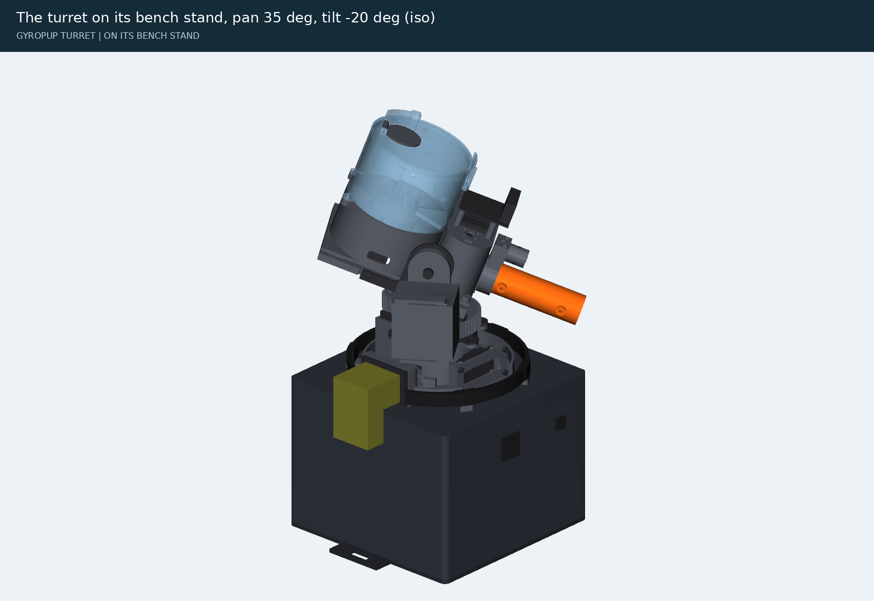
hardware/exports/turret/bench/turret-bench-aimed-iso.png
