Valpatel/gyropup/hardware/exports/turret/e2e/e2e.png

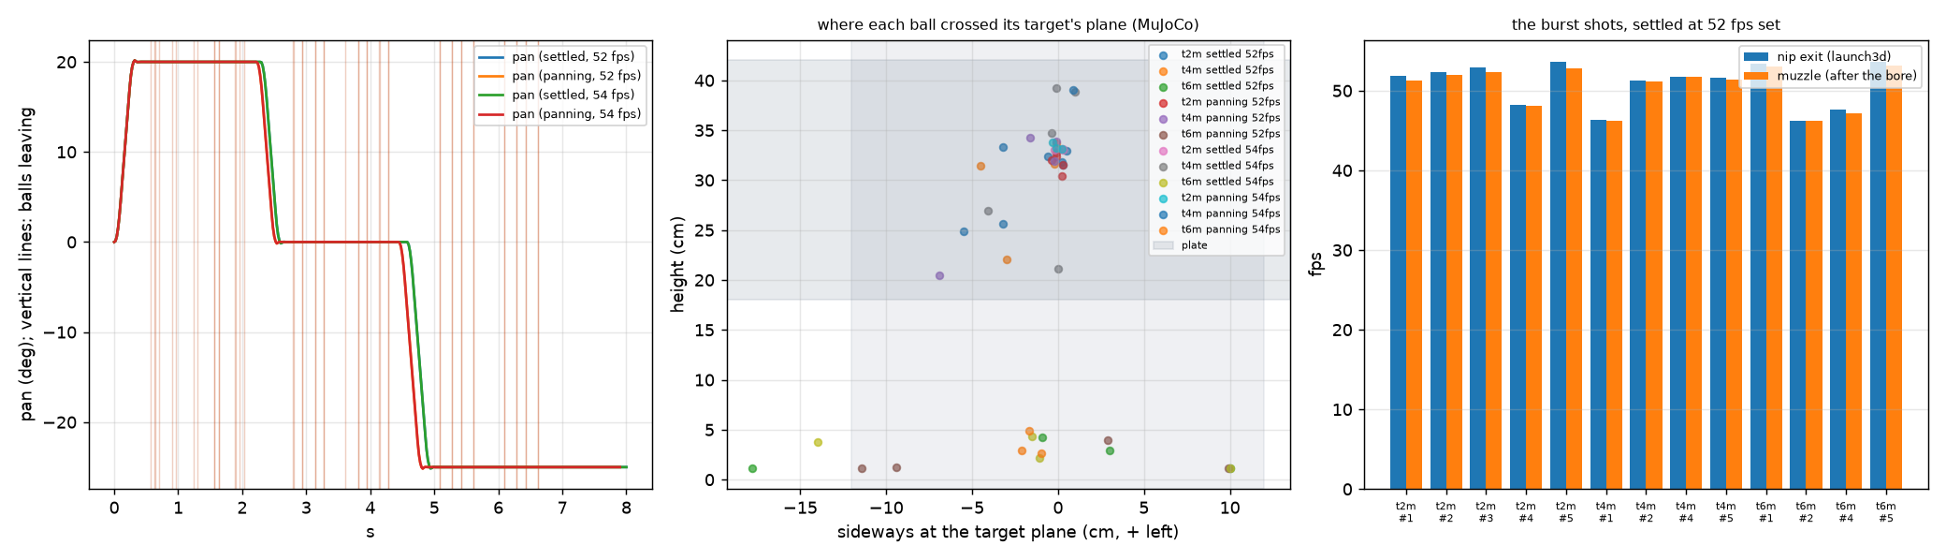
hardware/exports/turret/e2e/e2e.png
