Valpatel/gyropup/hardware/exports/turret/e2e/e2e_panning_55fps-frame-0061.png

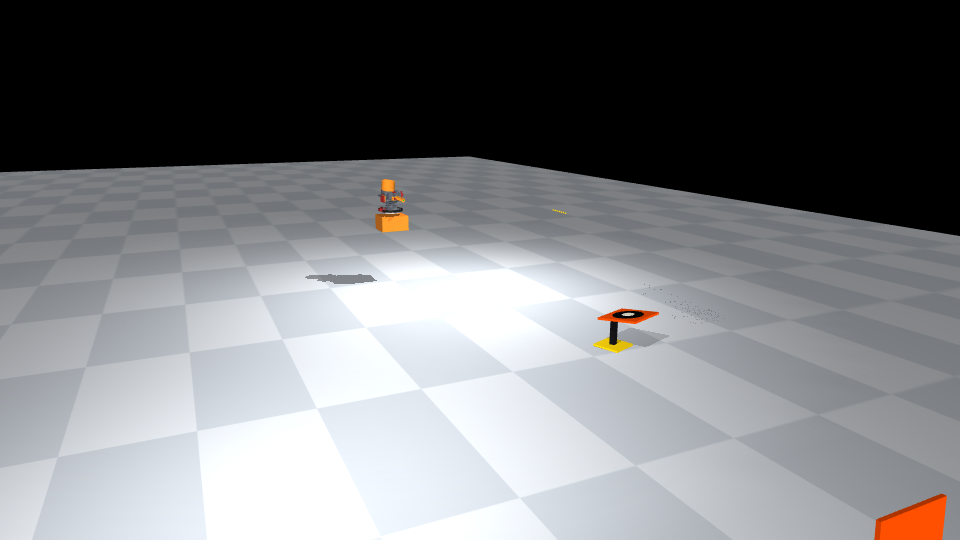
hardware/exports/turret/e2e/e2e_panning_55fps-frame-0061.png
