Valpatel/gyropup/hardware/exports/turret/e2e/power.png

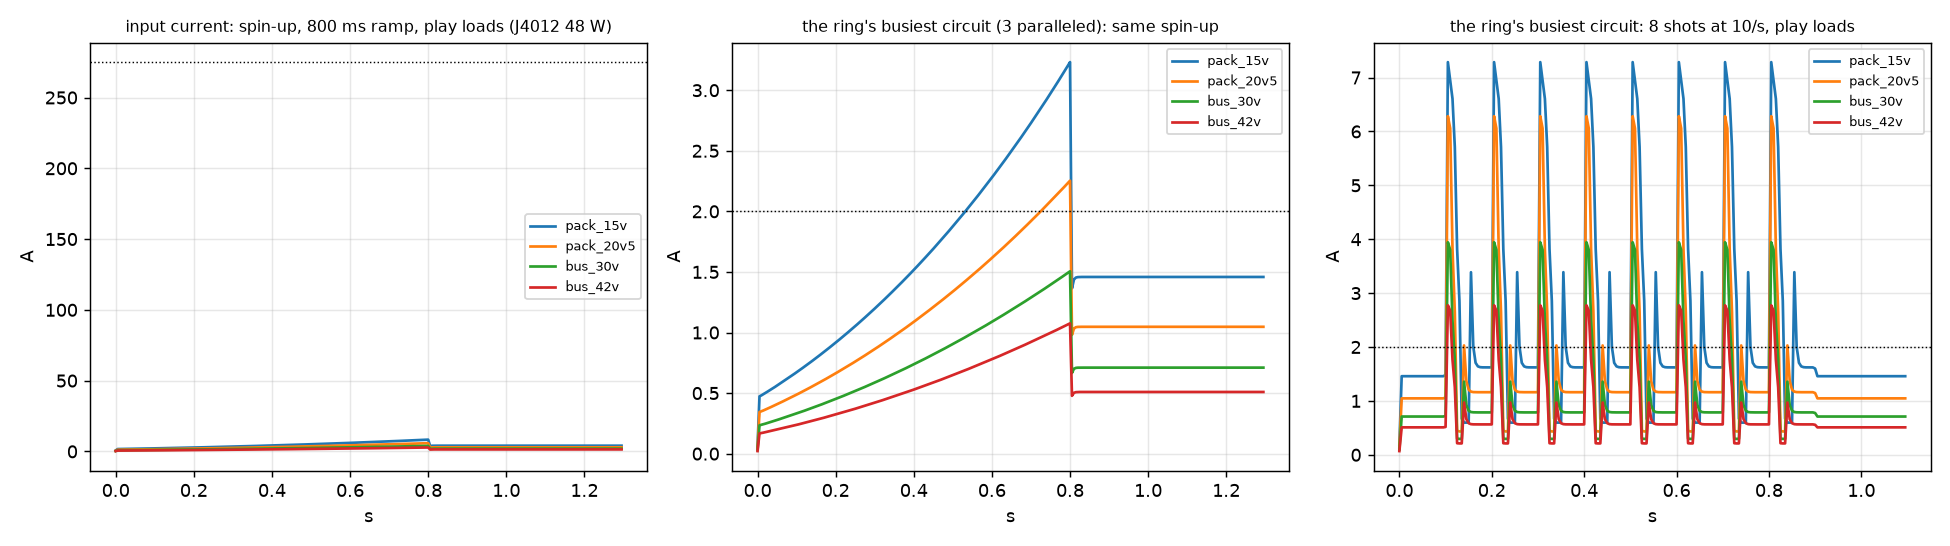
hardware/exports/turret/e2e/power.png
