Valpatel/gyropup/hardware/exports/turret/fea/cartridge_body-E-recoil.png

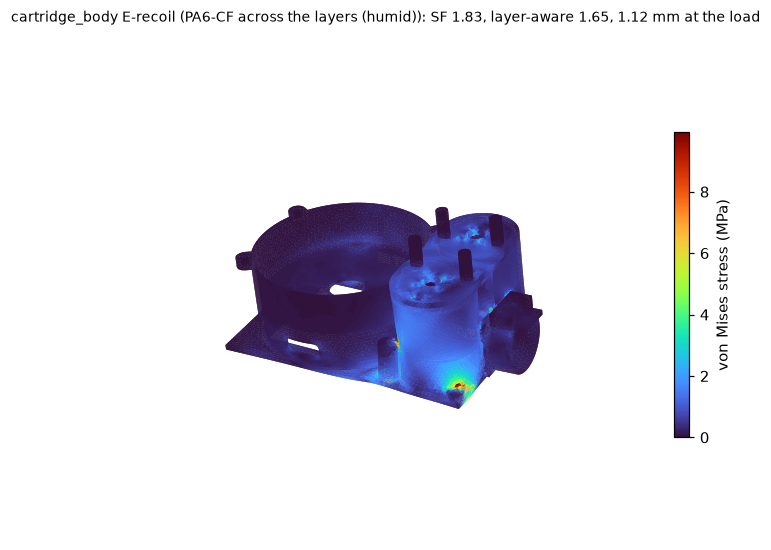
hardware/exports/turret/fea/cartridge_body-E-recoil.png
