Valpatel/gyropup/hardware/exports/turret/fea/cartridge_body-R-fall-down.png

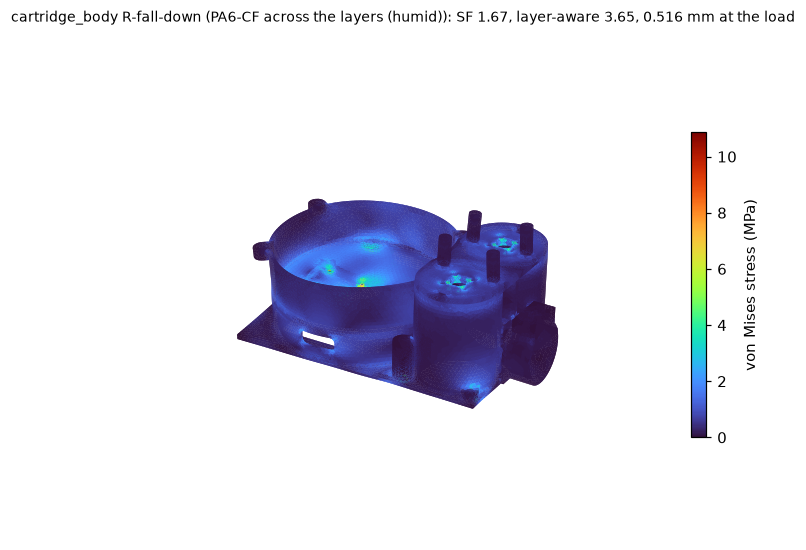
hardware/exports/turret/fea/cartridge_body-R-fall-down.png
