Valpatel/gyropup/hardware/exports/turret/fea/cradle-R-fall-down.png

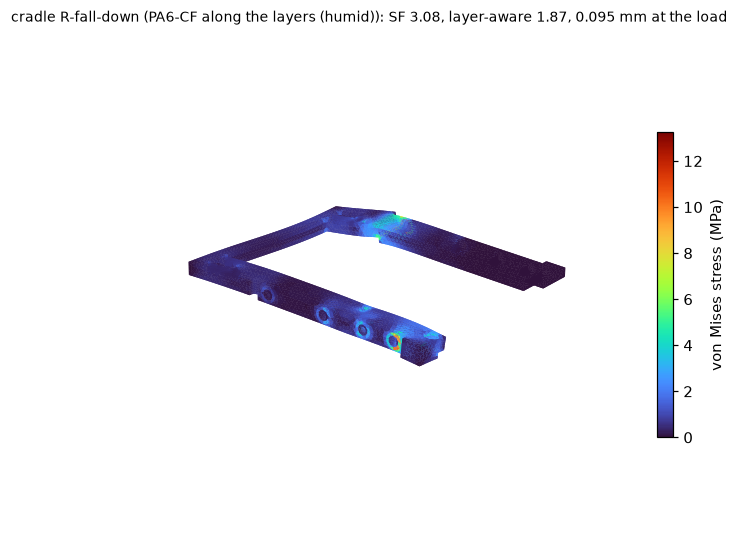
hardware/exports/turret/fea/cradle-R-fall-down.png
