Valpatel/gyropup/hardware/exports/turret/fea/cradle_plate_l-R-fall-down.png

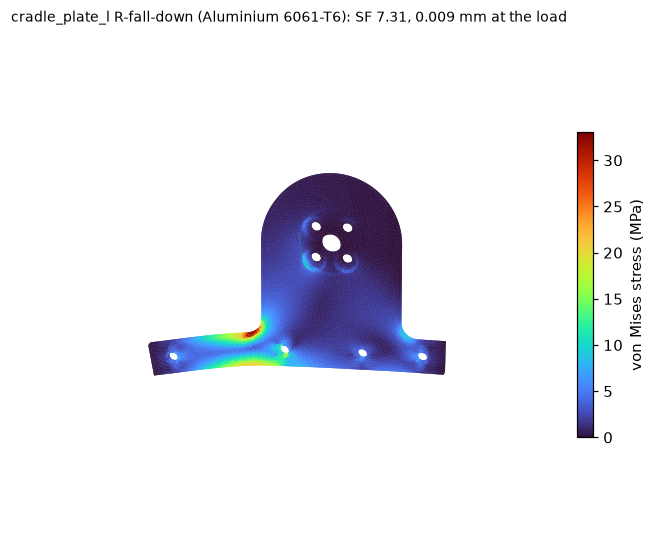
hardware/exports/turret/fea/cradle_plate_l-R-fall-down.png
