Valpatel/gyropup/hardware/exports/turret/fea/cradle_plate_l-R-fall-out.png

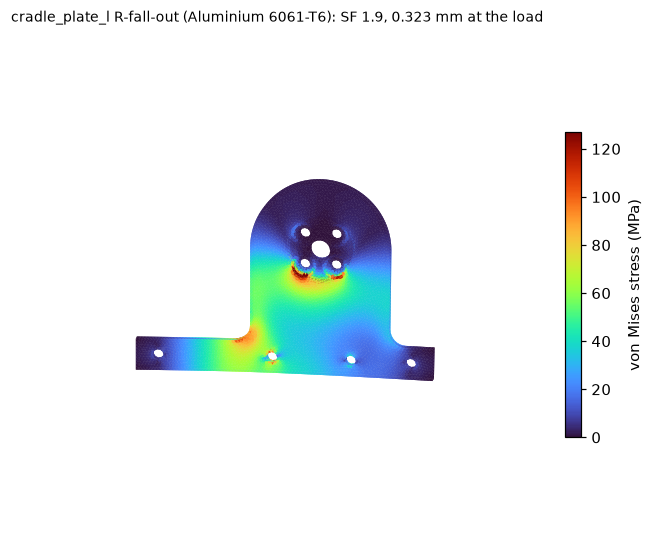
hardware/exports/turret/fea/cradle_plate_l-R-fall-out.png
