Valpatel/gyropup/hardware/exports/turret/fea/dial-E-jam-capped.png

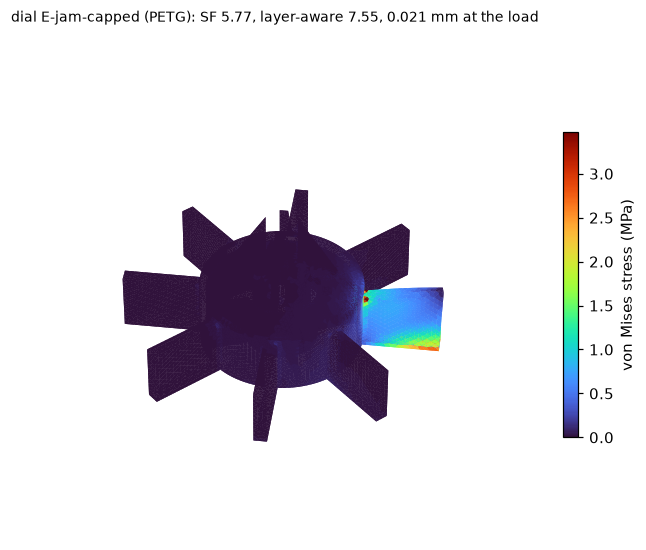
hardware/exports/turret/fea/dial-E-jam-capped.png
