Valpatel/gyropup/hardware/exports/turret/fea/pan_base-E-cap-servo.png

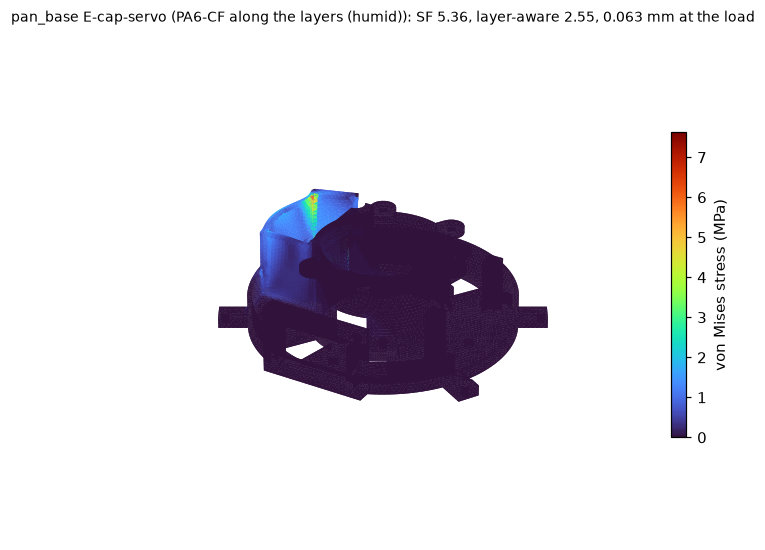
hardware/exports/turret/fea/pan_base-E-cap-servo.png
