Valpatel/gyropup/hardware/exports/turret/fea/pan_pinion-E-cap.png

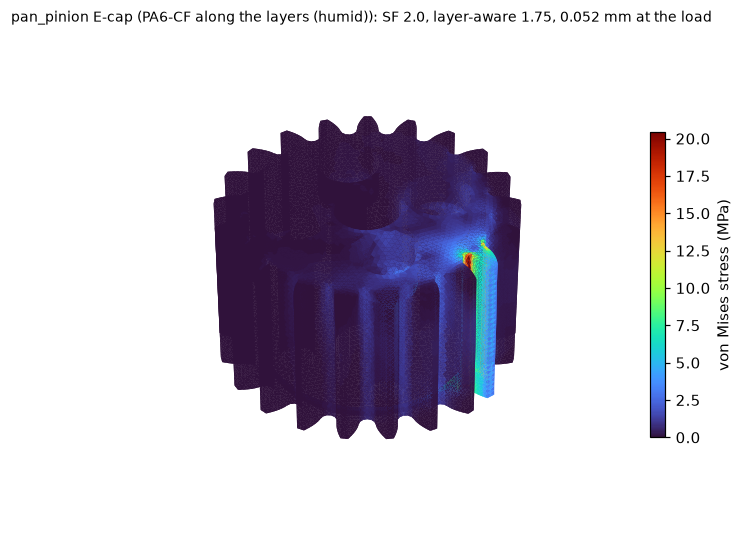
hardware/exports/turret/fea/pan_pinion-E-cap.png
