Valpatel/gyropup/hardware/exports/turret/fea/pan_pinion-R-stall.png

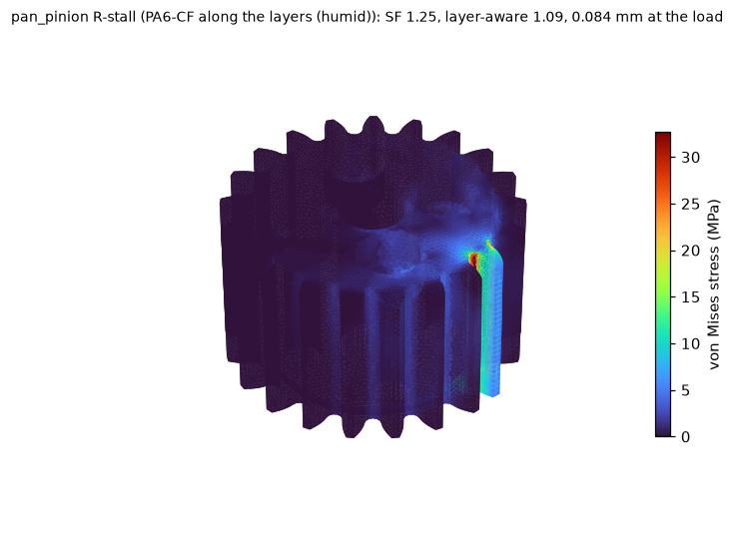
hardware/exports/turret/fea/pan_pinion-R-stall.png
