Valpatel/gyropup/hardware/exports/turret/fea/pan_ring-E-cap-teeth.png

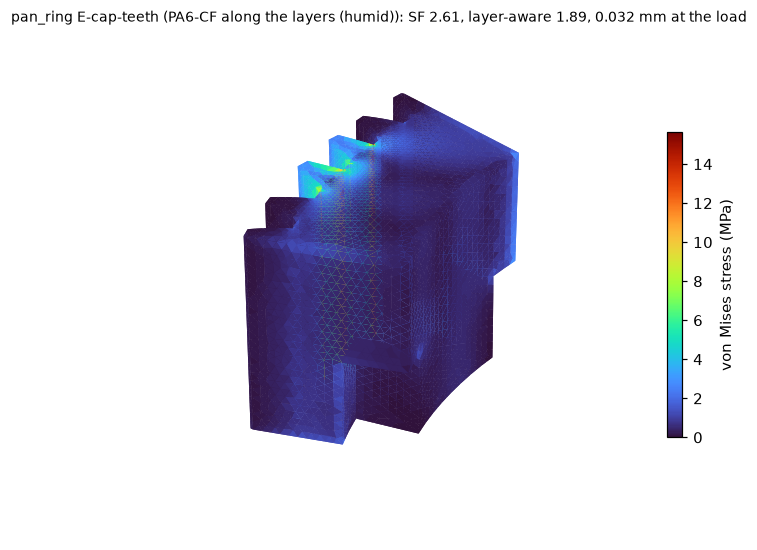
hardware/exports/turret/fea/pan_ring-E-cap-teeth.png
