Valpatel/gyropup/hardware/exports/turret/fea/pan_ring-R-fall-down.png

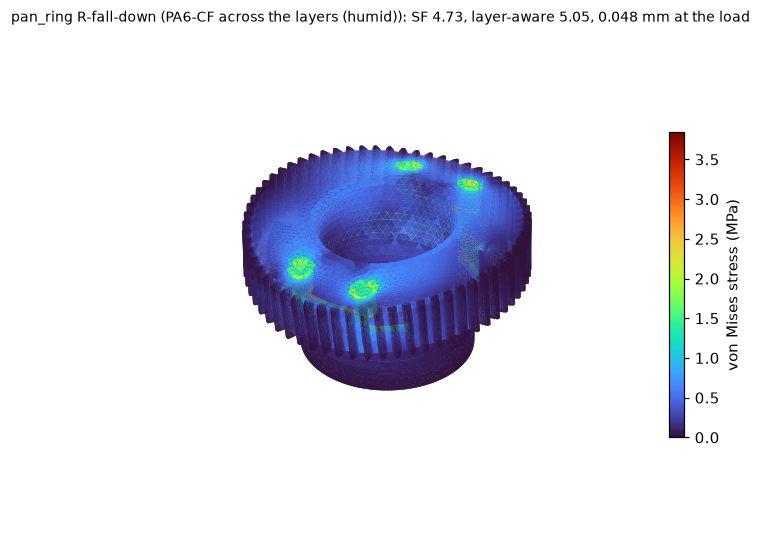
hardware/exports/turret/fea/pan_ring-R-fall-down.png
