Valpatel/gyropup/hardware/exports/turret/fea/pan_ring-R-fall-side.png

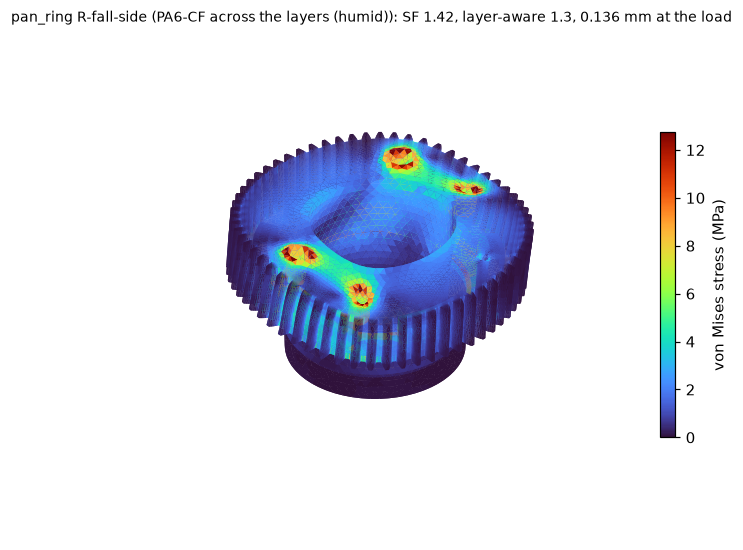
hardware/exports/turret/fea/pan_ring-R-fall-side.png
