Valpatel/gyropup/hardware/exports/turret/fea/stop_lug-E-push-up.png

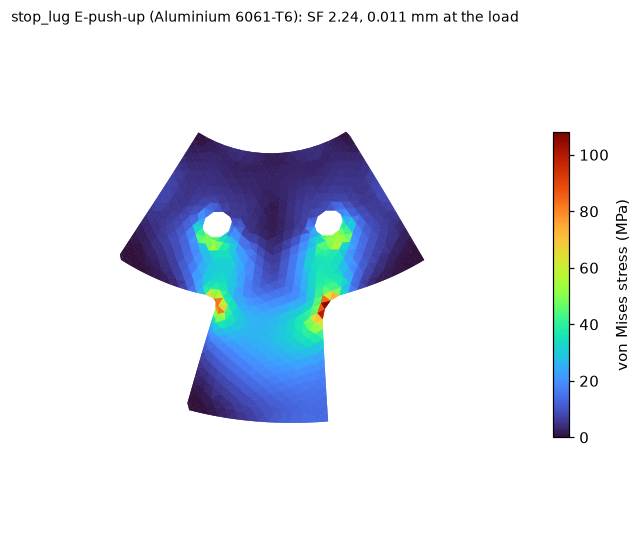
hardware/exports/turret/fea/stop_lug-E-push-up.png
