Valpatel/gyropup/hardware/exports/turret/fea/tilt_yoke-E-push-up.png

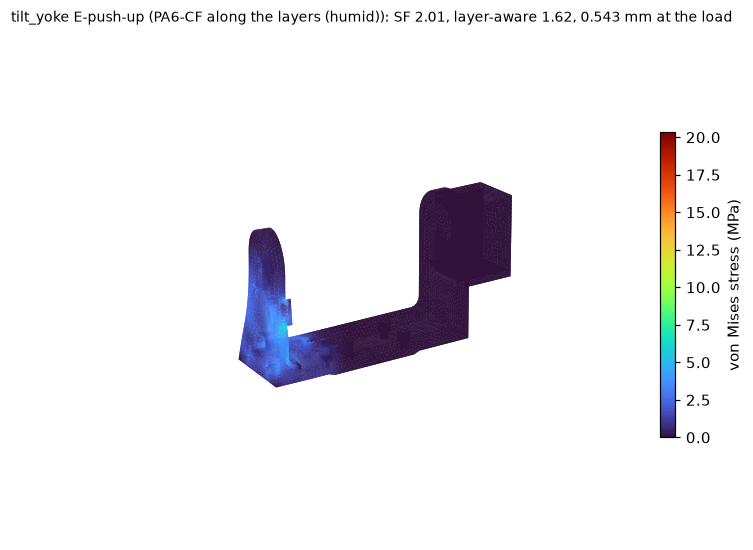
hardware/exports/turret/fea/tilt_yoke-E-push-up.png
