Valpatel/gyropup/hardware/exports/turret/fea/tilt_yoke-R-fall-side+.png

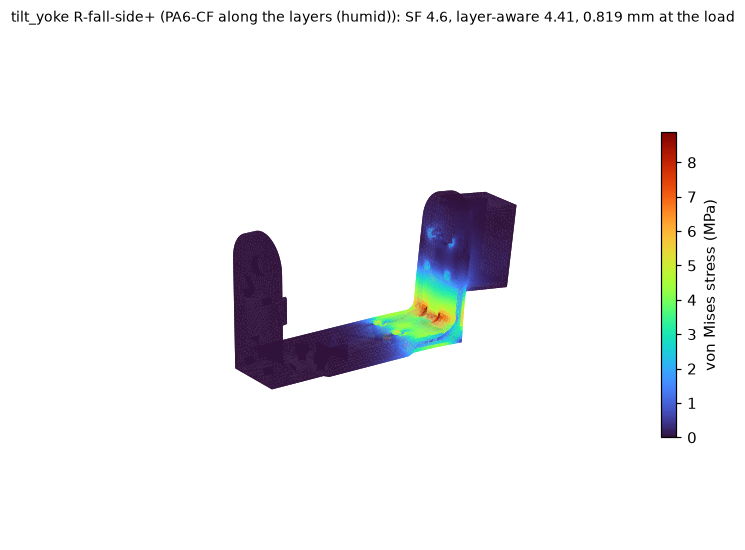
hardware/exports/turret/fea/tilt_yoke-R-fall-side+.png
