Valpatel/gyropup/hardware/exports/turret/feed/feed_dyn-frame-0000.png

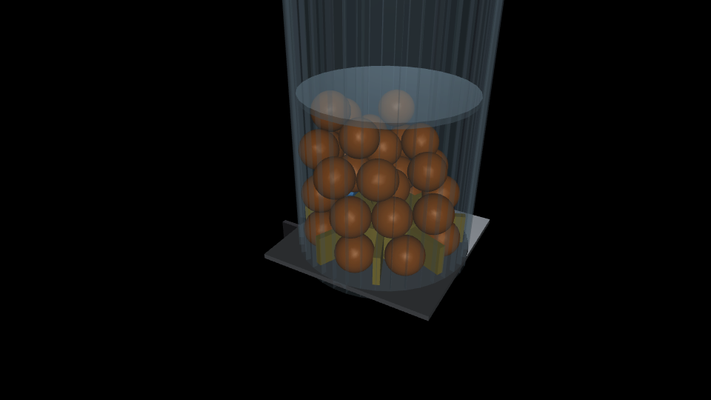
hardware/exports/turret/feed/feed_dyn-frame-0000.png
