Valpatel/gyropup/hardware/exports/turret/feed/feed_dyn.png

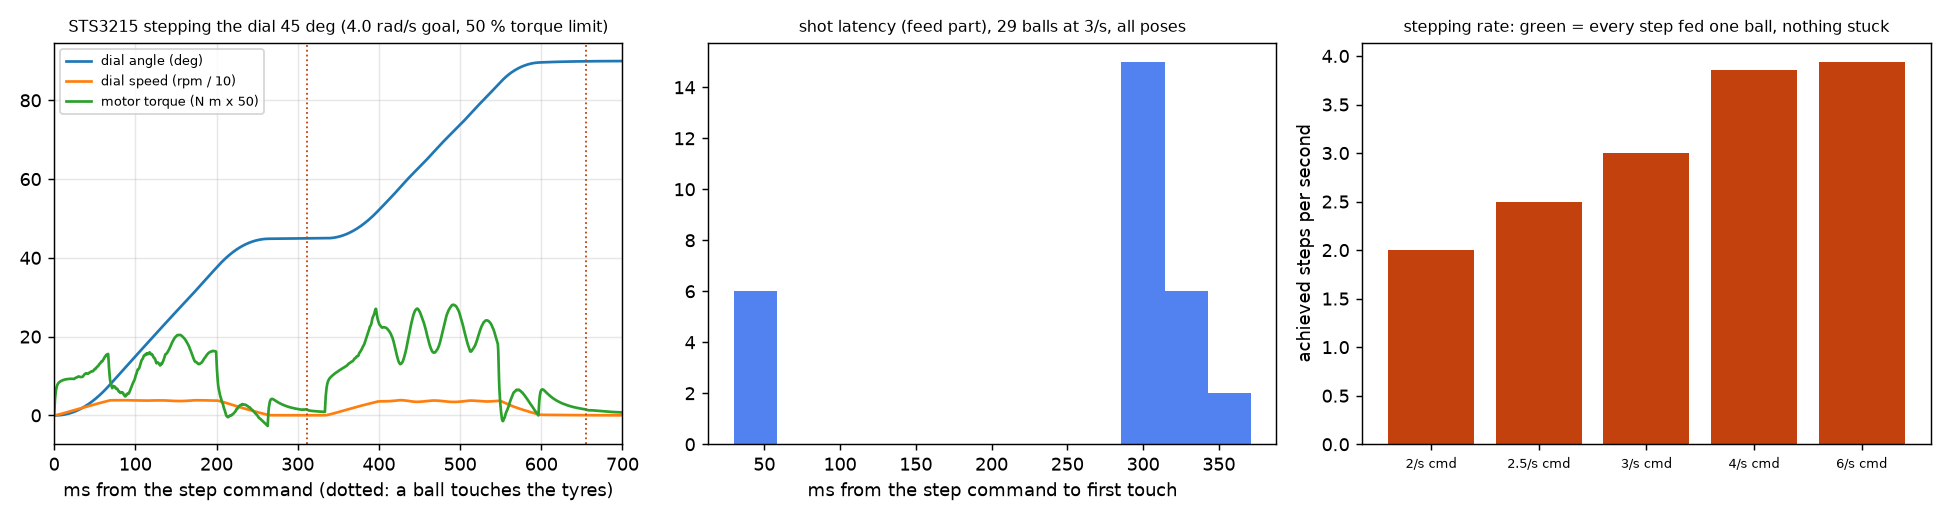
hardware/exports/turret/feed/feed_dyn.png
