Valpatel/gyropup/hardware/exports/turret/flight/flight.png

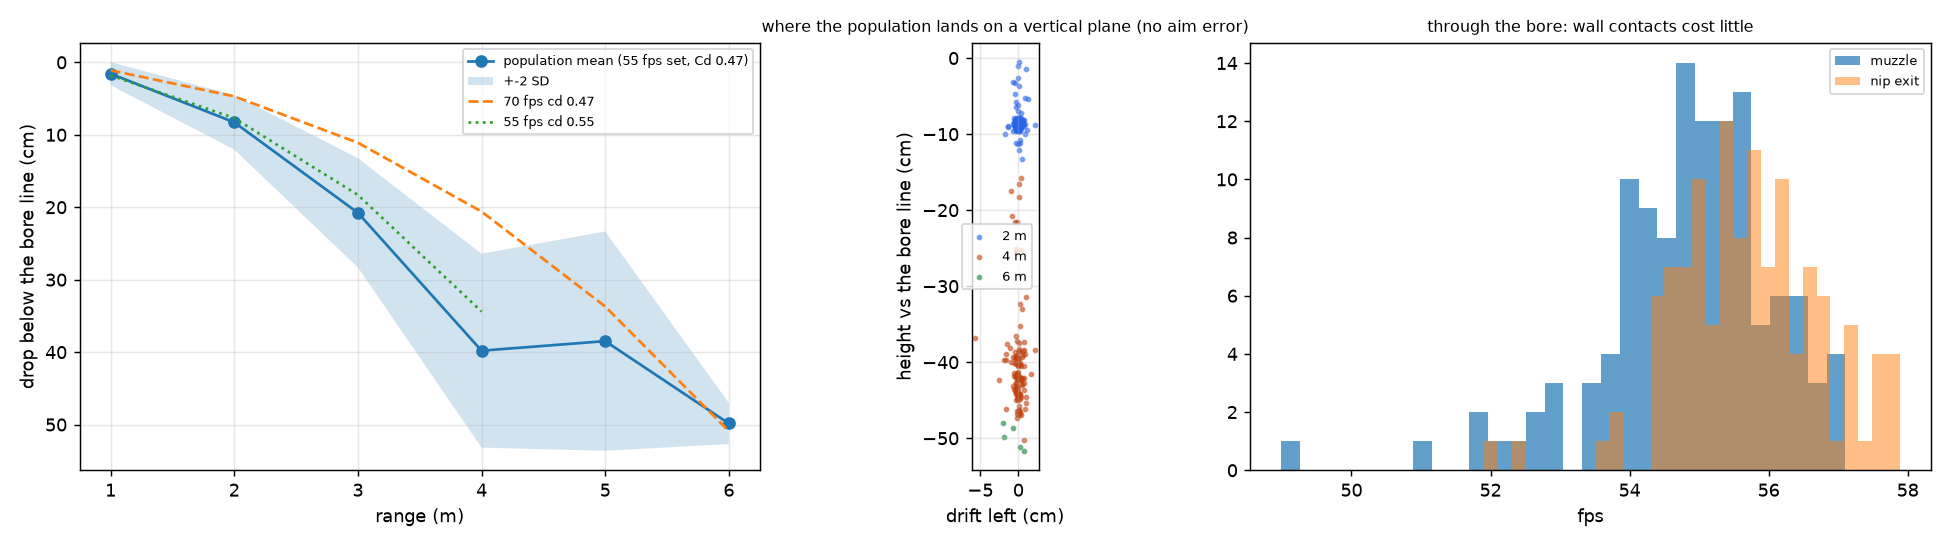
hardware/exports/turret/flight/flight.png
