Valpatel/gyropup/hardware/exports/turret/launch/launch3d.png

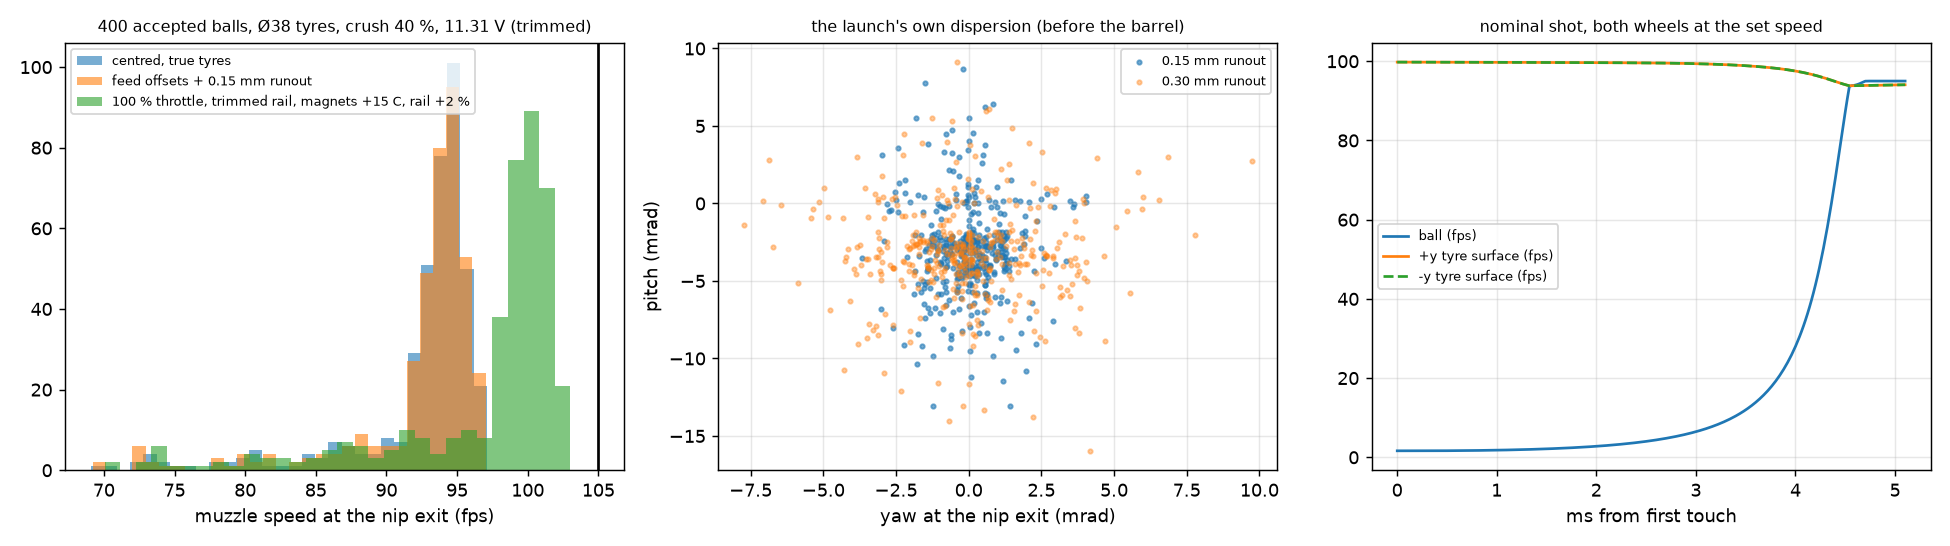
hardware/exports/turret/launch/launch3d.png
