Valpatel/gyropup/hardware/exports/turret/launch/launch-shot.png

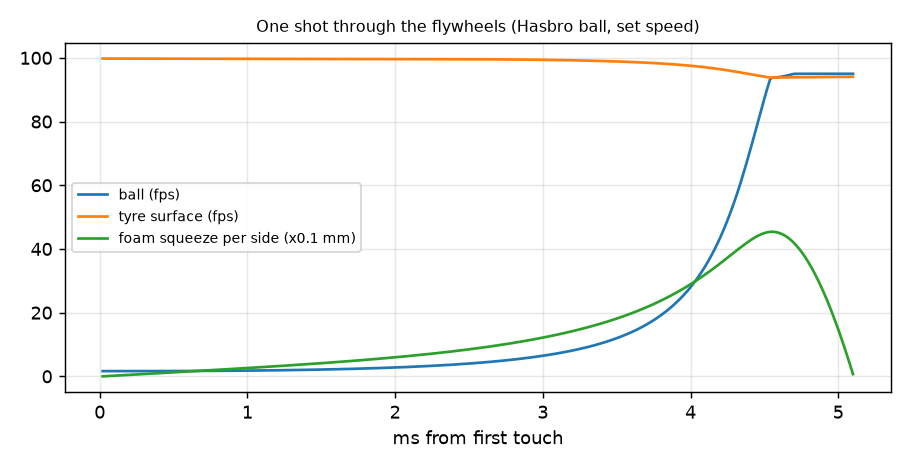
hardware/exports/turret/launch/launch-shot.png
