Valpatel/gyropup/hardware/exports/turret/launch/launch.png

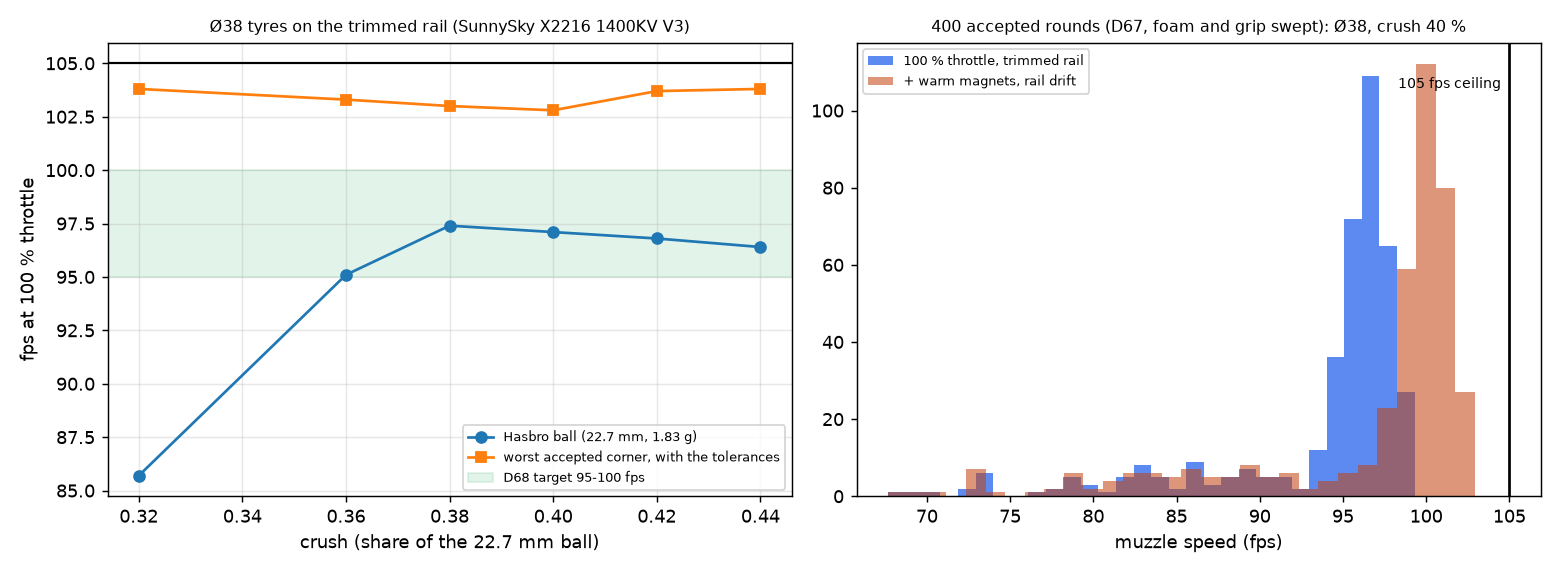
hardware/exports/turret/launch/launch.png
