Valpatel/gyropup/hardware/exports/turret/lidar/lidar-map.png

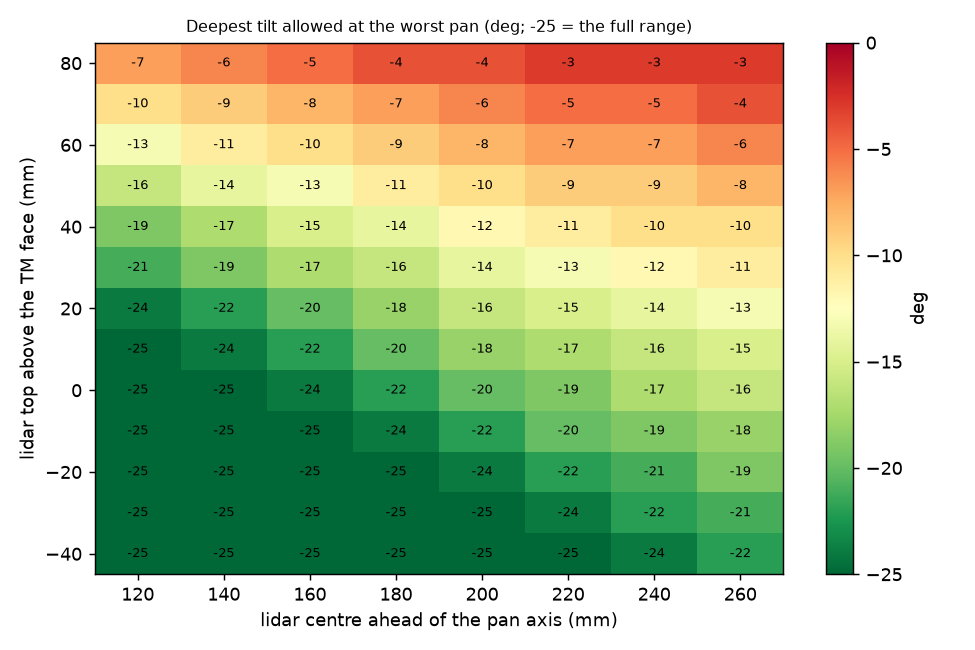
hardware/exports/turret/lidar/lidar-map.png
