Valpatel/gyropup/hardware/exports/turret/target/target.png

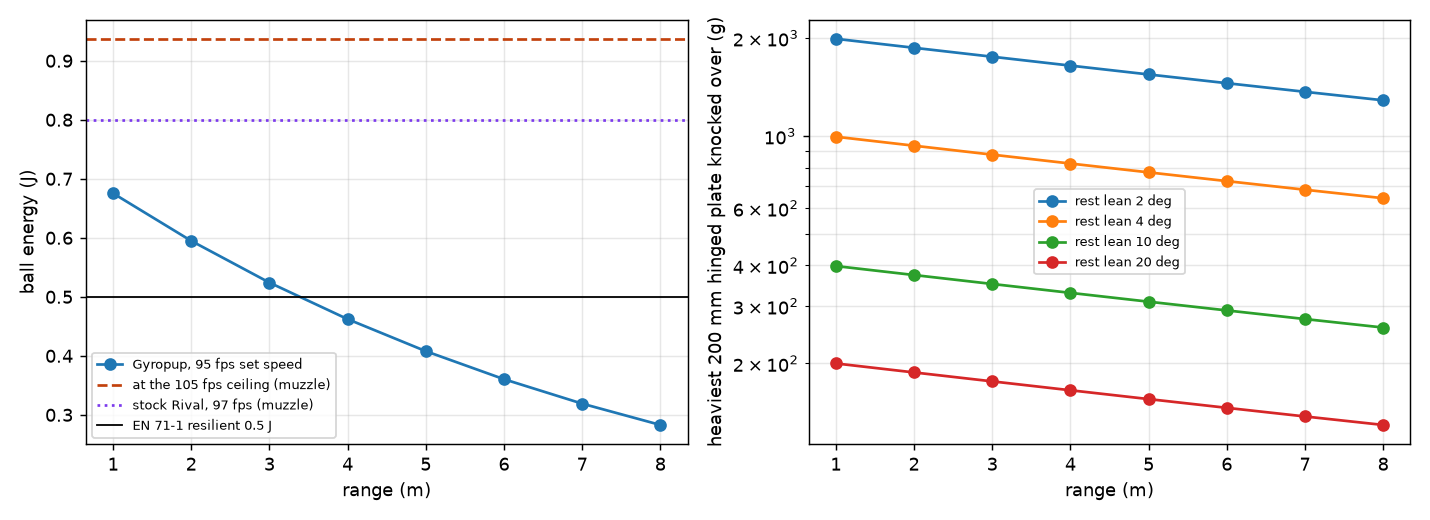
hardware/exports/turret/target/target.png
