Valpatel/gyropup/hardware/exports/turret/turret-pan-joint.png

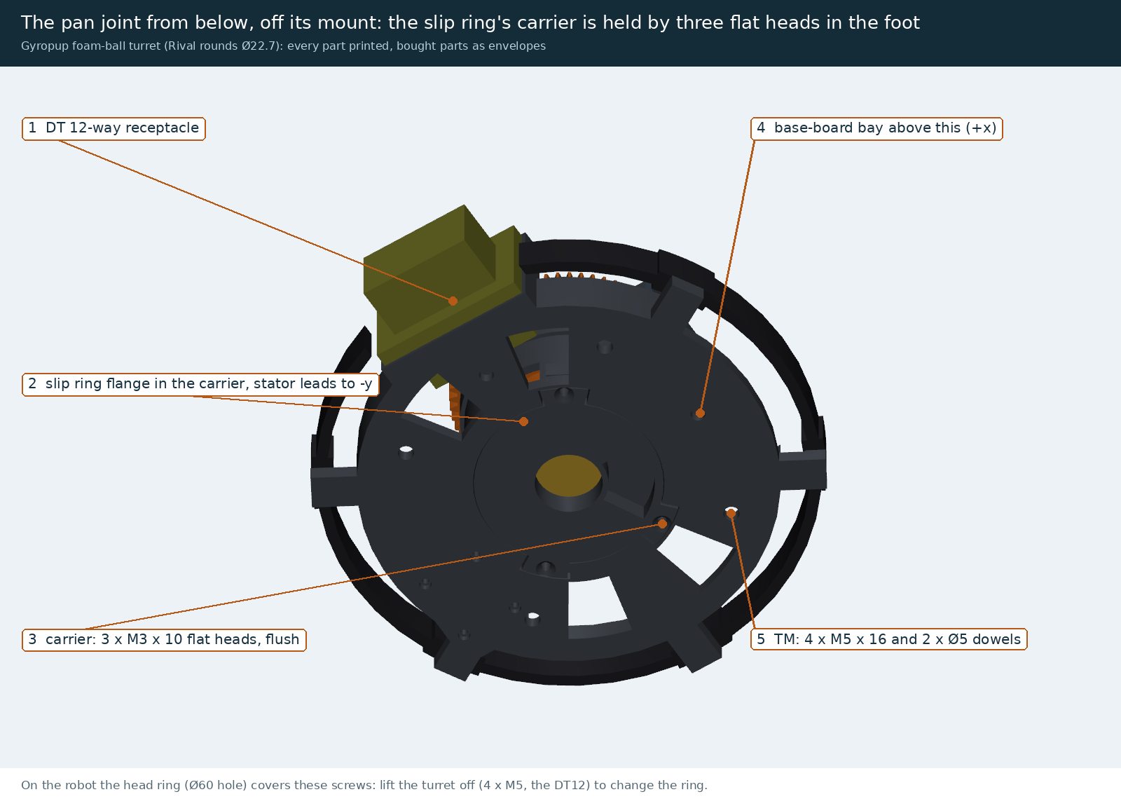
hardware/exports/turret/turret-pan-joint.png
