Valpatel/gyropup/hardware/exports/turret/turret-section.png

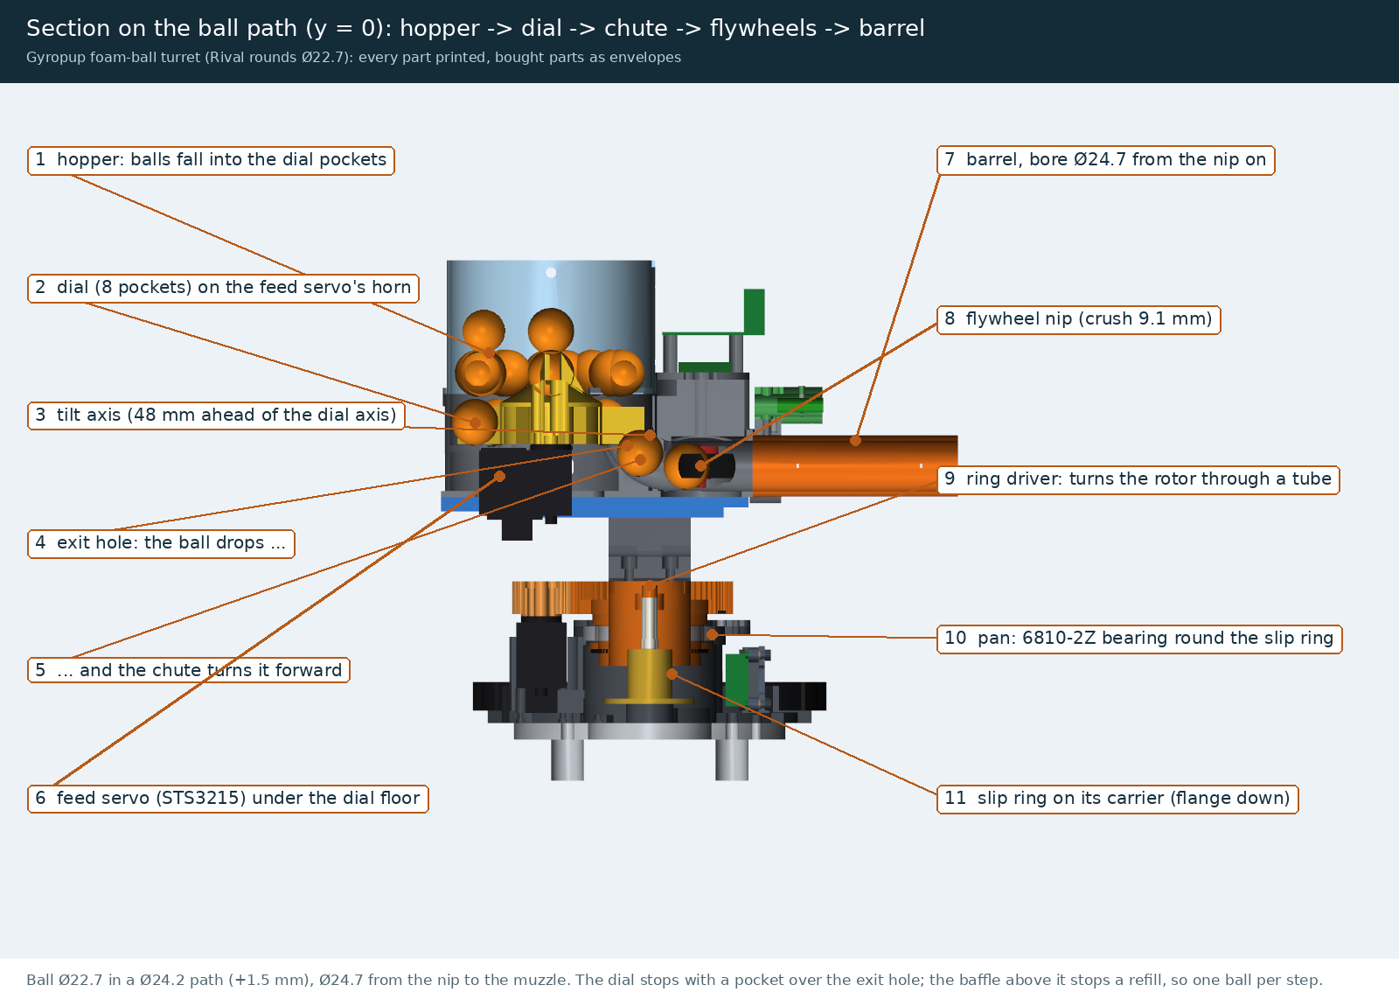
hardware/exports/turret/turret-section.png
