Valpatel/gyropup/hardware/fuse-board/pictures/angle.png

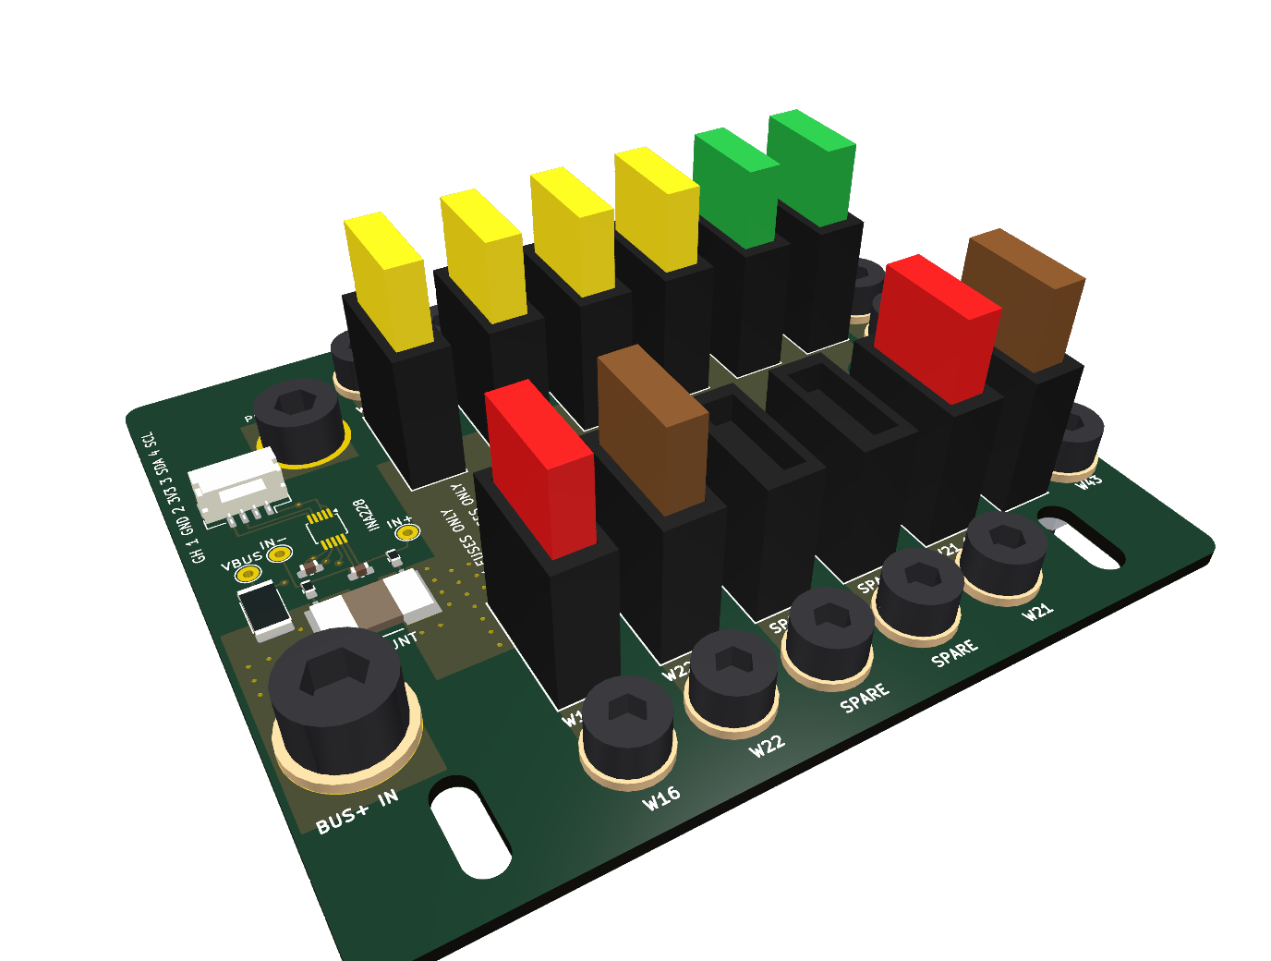
hardware/fuse-board/pictures/angle.png
