Valpatel/gyropup/hardware/fuse-board/pictures/bottom.png

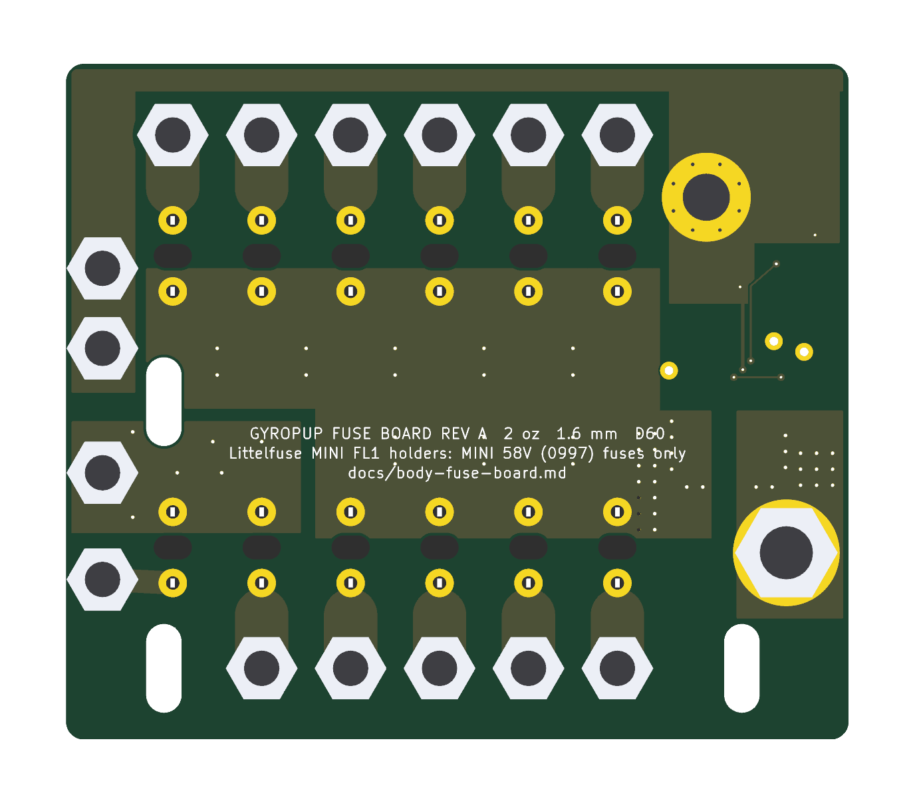
hardware/fuse-board/pictures/bottom.png
