Valpatel/gyropup/hardware/fuse-board/pictures/top.png

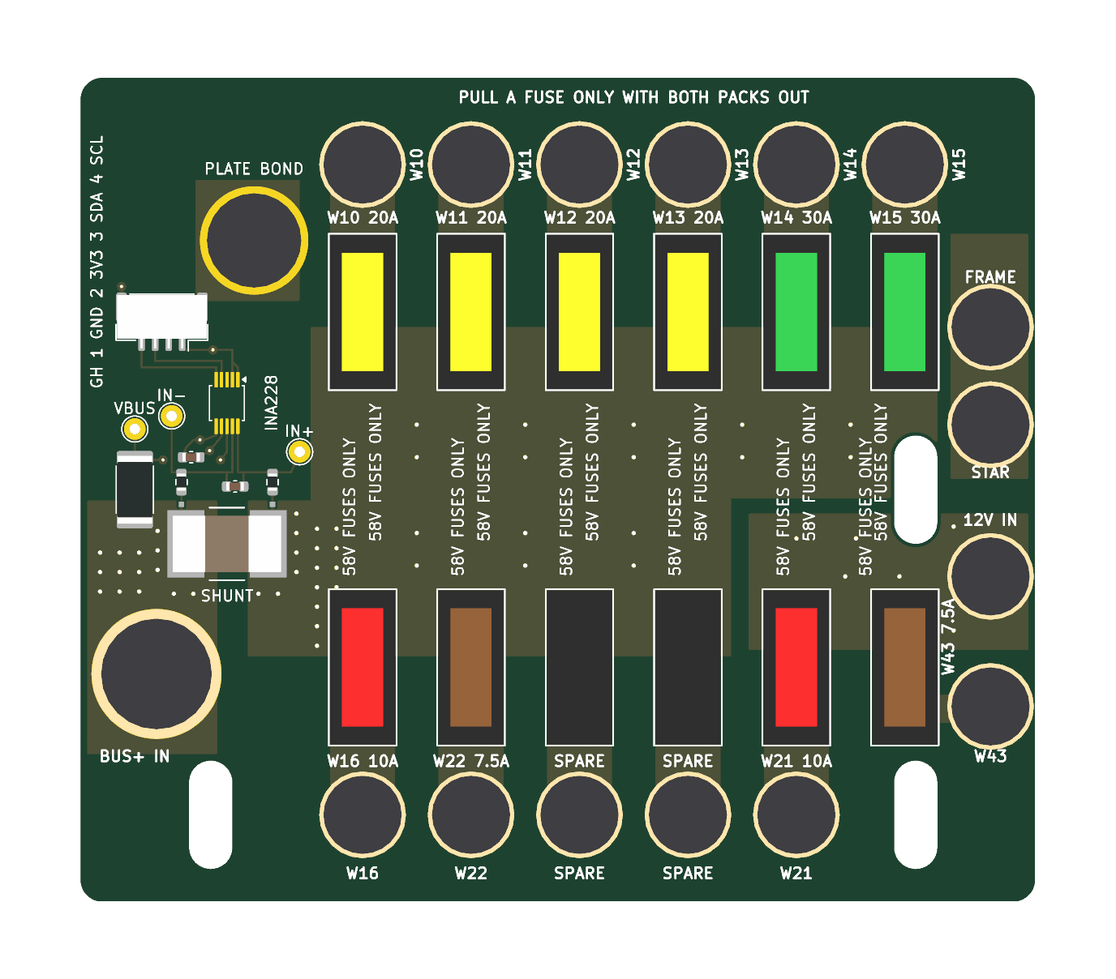
hardware/fuse-board/pictures/top.png
