Valpatel/gyropup/software/site/assets/robot-poster.png

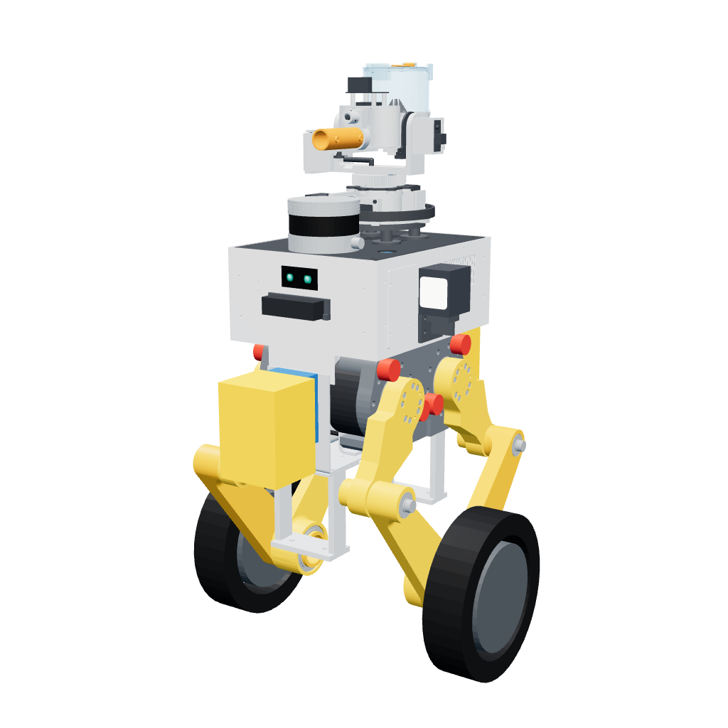
software/site/assets/robot-poster.png
