Valpatel/gyropup/docs/research/ordered-turret-motor/README.md

# Ordered turret motor: interface and unpowered fit preparation

The owner confirmed the **Deeahdah PRO 3115-900KV** motor from
[Amazon B0GJNX17YX](https://www.amazon.com/dp/B0GJNX17YX) on 2026-10-30.
This is the confirmation date, not an inferred order or delivery date. The listing
is a four-pack; the purchased pack quantity is unknown. See [purchases](../../program/purchases.md)
and [acceptance issue #124](https://github.com/Valpatel/gyropup/issues/124).

This lane establishes the exact motor's mounting, shaft and seating interfaces
before adapting the flywheel cartridge. It preserves seller claims separately
from manufacturer drawings and measurements of the delivered samples. Other
brands' 3115 dimensions, SunnySky's shaft adapter, and inferred thread pitch or
handedness are not evidence for this motor.

Existing candidate research remains in [draft PR #46](https://github.com/Valpatel/gyropup/pull/46).
The purchased identity is now settled; dimensional fit, retention, tolerances,
mass, wire exits, and physical acceptance remain open. An unpowered fit specimen
will not qualify rotating retention, balance, strength, electrical limits or
thermal performance. No current full-cartridge print is released by this work.

Start with the [human survey and design plan](../../turret/ordered-turret-motor.md).
The source packet is [seller-claims.json](seller-claims.json); actual observations
belong in a copy of [measurements.template.json](measurements.template.json).
The [mounting-pattern survey](mount-pattern-survey.svg) is a scale-checkable
measurement aid, not a qualified mounting drawing. Regenerate these with
`tools/ordered-turret-motor.py`; the kernel-free controls are in
`tools/test-ordered-turret-motor.py`.
