Valpatel/gyropup/docs/research/ordered-turret-motor/rejected-label-slice/README.md

# Rejected small-label slice

[Original complete job](job-1544582.zip), generated at `057c69f` and retained at
`1544582`, is **rejected for label printability; do not print it as the labelled
survey tool**. The original 2.8 mm regular width labels and 3.2 mm regular caption
mostly disappear with the 0.4 mm PA6-CF trial: only eleven tiny deposition segments
remain at each upper layer, Z=3.2 and 3.4 mm. The archived actual toolpaths/image,
settings and receipt preserve this failure. A successful slice and unchanged
source mesh did not prove the marked measuring-tool function.

The labelled replacement needs larger explicit bold-font geometry, a fresh remote
CAD export, per-label deposited-path coverage and direct visual reading. No motor
measurements, calibration, physical print or mounting qualification follow from
this diagnostic. Its old source receipt becomes stale when the gauge changes;
no identities in this archive were re-signed.
