Valpatel/gyropup/hardware/exports/turret/bench/orders/README.md

# Ordering the bench turret (v0)

Generated by `cad/turret_orders.py` from `exports/turret/bench/bom.json` and the catalogue: every bought line of the bench turret, its stand and the tools, by seller, in the order to place them. Nothing has been ordered. The robot-only (v1) lines are listed at the end and are not in the totals.

| Order | Seller | Lines | Total | When |
|---|---|---|---|---|
| [1](01-waveshare.md) | Waveshare | 2 | $70.96 | Day one |
| [2](02-sunnysky-usa.md) | SunnySky USA | 1 | $49.98 | Day one |
| [3](03-palm-beach-bots.md) | Palm Beach Bots | 1 | $49.98 | with the first batch |
| [4](04-racedayquads.md) | RaceDayQuads | 1 | $62.98 | Day one, with the Repeat ESCs (D51) |
| [5](05-pololu.md) | Pololu | 4 | $156.14 | with the first batch |
| [6](06-adafruit.md) | Adafruit | 2 | $34.95 | with the first batch |
| [7](07-sparkfun.md) | SparkFun | 3 | $56.95 | with the first batch |
| [8](08-digi-key.md) | Digi-Key | 31 | $198.71 | with the first batch |
| [9](09-mouser.md) | Mouser | 41 | $89.09 | with the first batch |
| [10](10-mcmaster-carr.md) | McMaster-Carr | 39 | $513.58 | with the first batch |
| [11](11-vxb-bearings.md) | VXB Bearings | 2 | $74.98 | with the first batch |
| [12](12-sendcutsend.md) | SendCutSend | 4 | on upload | Day one |
| [13](13-the-power-tool-store.md) | The Power Tool Store | 1 | $259.00 | with the first batch |
| [14](14-caldwell.md) | Caldwell | 1 | $168.99 | with the first batch |
| [15](15-ablenet.md) | AbleNet | 1 | $75.00 | with the first batch |
| [16](16-walmart.md) | Walmart | 3 | $67.10 | with the first batch |
| [17](17-out-of-darts.md) | Out of Darts | 1 | $29.98 | with the first batch |
| [18](18-iwiss.md) | IWISS | 1 | $24.99 | with the first batch |
| [19](19-fysetc.md) | FYSETC | 1 | $8.00 | with the first batch |
| [20](20-newark.md) | Newark | 2 | $4.04 | with the first batch |
| [21](21-rockauto.md) | RockAuto | 1 | $2.28 | with the first batch |
| [22](22-lcsc.md) | LCSC | 2 | $1.43 | with the first batch |
| [23](23-jameco.md) | Jameco | 1 | $0.99 | with the first batch |

**Total: $2,000.10** before shipping and tax (whole packs; the McMaster packs and the tools are most of the gap to the "parts used" figure).

## The custom parts (SendCutSend, one cart)

Each DXF is the part seen from the face its countersinks are cut in (the face a screw head goes into): upload it face up, as drawn, so the countersinks land on that face. Tapped holes are drawn at their tap drill (M5: Ø4.2, M3: Ø2.5).

- `pan_clamp`: upload `exports/turret/pan_clamp.dxf` at https://sendcutsend.com/materials/6061-t6-aluminum/ as **6061-T6 aluminium, 0.125 in (3.175 mm)**, quantity 1, deburred, no finish. The instant price shows on upload.
- `cradle_plate_l`: upload `exports/turret/cradle_plate_l.dxf` at https://sendcutsend.com/materials/6061-t6-aluminum/ as **6061-T6 aluminium, 0.125 in (3.175 mm)**, quantity 1, deburred, no finish; **4 holes countersunk 90 deg to Ø6.4 on the face drawn (the face on the rail; DIN 7991 M3 flat heads)**. The instant price shows on upload.
- `cradle_plate_r`: upload `exports/turret/cradle_plate_r.dxf` at https://sendcutsend.com/materials/6061-t6-aluminum/ as **6061-T6 aluminium, 0.125 in (3.175 mm)**, quantity 1, deburred, no finish; **the Ø4.2 hole tapped M5 x 0.8; 2 holes countersunk 90 deg to Ø6.4 on the face drawn (the face on the rail)**. The instant price shows on upload.
- `stop_lug`: upload `exports/turret/stop_lug.dxf` at https://sendcutsend.com/materials/6061-t6-aluminum/ as **6061-T6 aluminium, 0.1 in (2.54 mm)**, quantity 1, deburred, no finish; **2 holes tapped M3 x 0.5**. The instant price shows on upload.

## Bought outside the parts rule's seller list

No Digi-Key, Mouser, SparkFun, Adafruit, Pololu or McMaster listing was found for these sellers' lines (docs/decisions.yaml D40): Jameco, LCSC, Newark, Out of Darts, RockAuto, The Power Tool Store, Walmart. Each has a listed price and a link; check the backup column.

## Lines without a second seller yet

DCB609 FLEXVOLT 20V/60V MAX 9.0Ah.

## Not ordered now: the robot (v1) lines

| Part | For | Qty |
|---|---|---|
| Black-Oxide Alloy Steel Socket Head Screw, US Origin, M3 x 0.5 mm Thread Size, 20 mm Long | hw_bumper_screws | 5 |
| 18-8 Stainless Steel Oversized Washer, for M3 Screw, 3.2mm ID, 9.0mm OD, 0.7mm to 0.9mm Thick | hw_bumper_washers | 5 |
| Heat-Set Threaded Inserts for Plastic, Standard, Brass, M3 x 0.5 mm Thread Size, 4.3 mm Installed Length | hw_bumper_inserts | 5 |
| 316 Stainless Steel Dowel Pin, 2mm Diameter, 20mm Long | hw_flap_pin | 1 |
| Torsion Spring, 90 Degree Left-Hand Wound, 0.16" OD | hw_flap_spring | 1 |
| IR Break Beam Sensor - 3mm LEDs | el_hopper_beam | 1 |
| NeoPixel Ring - 12 x 5050 RGB LED | el_lights | 1 |
