Valpatel/gyropup/docs/body/body-orders.md

# Body orders: everything to buy, cut and print for the first prototype (P0 power skid, P1 open frame)

Generated by `cad/body_bom.py` from `exports/body/bom.json` (the CAD and `catalog/body.json`) and the print plan;
regenerate it rather than editing it. One robot. The task numbers are the body plan's (docs/body-plan.md section 5):
T2 the frame, T5 the electrics, T8 this list. Prices were read on the sellers' own pages (or their public store JSON)
on 2026-10-27; McMaster's one product page at a time (cadagent.mcmaster). Every line has a backup (D40): the second
seller in `bom.json`, shown in the last column.

How to order:

1. **SendCutSend** (section 1): upload each DXF from `exports/body/sendcutsend/` at app.sendcutsend.com, pick the
   material and thickness in its file name, add the bends (the app reads the DXF's BEND layer: 90 deg, UP), PEM nuts,
   countersinks and tapping listed, deburring, and the quantity. The prices below were read that way in the app
   (`tools/sendcutsend_quote.py`, no account needed for a price); re-read them before the cart goes.
2. **McMaster-Carr** (section 2, first table): one cart, next-day.
3. **The other sellers** (section 2): the ones that ship from China first (LCSC, Daly, Flipsky): one to three weeks.
4. **Print** (section 5) while the orders arrive.

## 1. SendCutSend (T2: the frame and the power plate): custom parts at an instant price

| Part | Qty | Material | Flat (mm) | Operations | Files | Price each | Line |
|---|---|---|---|---|---|---|---|
| cheek | 2 | 5052-H32 aluminium 0.187 in | 184.0 x 223.0 | 2 bends, 90 deg, SendCutSend's 0.25 in radius (K 0.43, bend deduction 0.356 in): the DXF's BEND layer marks the lines (the app reads them; each 90 deg UP); flanges as the STEP; 8 x PEM SS-M5-0 pressed by SendCutSend (hardware insertion), positions as the STEP; 8 x 90 deg countersinks for M4 flat heads (SendCutSend countersinking), the side the STEP shows | [DXF](../../hardware/exports/body/sendcutsend/cheek_5052-H32_0.187in_x2.dxf), [STEP](../../hardware/exports/body/sendcutsend/cheek_5052-H32_0.187in_x2.step) | $63.87 (read 2026-10-27) | $127.74 |
| floor_tray | 1 | 5052-H32 aluminium 0.125 in | 339.0 x 273.0 | 4 bends, 90 deg, SendCutSend's 0.125 in radius (K 0.44, bend deduction 0.216 in): the DXF's BEND layer marks the lines (the app reads them; each 90 deg UP); flanges as the STEP; 4 x PEM S-M4-0 pressed by SendCutSend (hardware insertion), positions as the STEP; tapping: the two Ø2.5 holes M3 x 0.5 (the VN-100) | [DXF](../../hardware/exports/body/sendcutsend/floor_tray_5052-H32_0.125in_x1.dxf), [STEP](../../hardware/exports/body/sendcutsend/floor_tray_5052-H32_0.125in_x1.step) | $80.62 (read 2026-10-27) | $80.62 |
| belly_plate | 1 | 6061-T6 aluminium 0.1 in | 320.0 x 116.0 | 16 x PEM S-M4-0 pressed by SendCutSend (hardware insertion), positions as the STEP | [DXF](../../hardware/exports/body/sendcutsend/belly_plate_6061-T6_0.100in_x1.dxf), [STEP](../../hardware/exports/body/sendcutsend/belly_plate_6061-T6_0.100in_x1.step) | $62.16 (read 2026-10-27) | $62.16 |
| deck | 1 | 5052-H32 aluminium 0.1 in | 350.3 x 284.3 | 4 bends, 90 deg, SendCutSend's 0.125 in radius (K 0.4, bend deduction 0.191 in): the DXF's BEND layer marks the lines (the app reads them; each 90 deg UP); flanges as the STEP | [DXF](../../hardware/exports/body/sendcutsend/deck_5052-H32_0.100in_x1.dxf), [STEP](../../hardware/exports/body/sendcutsend/deck_5052-H32_0.100in_x1.step) | $79.11 (read 2026-10-28) | $79.11 |
| compute_pallet | 1 | 6061-T6 aluminium 0.125 in | 194.0 x 158.0 | 8 x 90 deg countersinks for M3 flat heads (SendCutSend countersinking), the side the STEP shows | [DXF](../../hardware/exports/body/sendcutsend/compute_pallet_6061-T6_0.125in_x1.dxf), [STEP](../../hardware/exports/body/sendcutsend/compute_pallet_6061-T6_0.125in_x1.step) | $49.40 (read 2026-10-27) | $49.40 |
| power_plate | 1 | 5052-H32 aluminium 0.1 in | 124.0 x 206.0 | 10 x PEM F-M5-2 pressed by SendCutSend (hardware insertion), positions as the STEP; 6 x PEM F-M4-2 pressed by SendCutSend (hardware insertion), positions as the STEP | [DXF](../../hardware/exports/body/sendcutsend/power_plate_5052-H32_0.100in_x1.dxf), [STEP](../../hardware/exports/body/sendcutsend/power_plate_5052-H32_0.100in_x1.step) | $47.48 (read 2026-10-27) | $47.48 |
| bus_bar | 2 | C110 copper 0.125 in | 110.0 x 20.0 | cut only: the five Ø6.4 holes take the lugs' M6 screws into nuts held in the printed insulator (SendCutSend does no service on a part under 1 in wide) | [DXF](../../hardware/exports/body/sendcutsend/bus_bar_C110_0.125in_x2.dxf), [STEP](../../hardware/exports/body/sendcutsend/bus_bar_C110_0.125in_x2.step) | $18.22 (read 2026-10-27) | $36.44 |
| bay_floor | 1 | 5052-H32 aluminium 0.063 in | 310.0 x 134.0 | 2 bends, 90 deg, SendCutSend's 0.035 in radius (K 0.42, bend deduction 0.096 in): the DXF's BEND layer marks the lines (the app reads them; each 90 deg UP); flanges as the STEP; 10 x PEM S-M3-0 pressed by SendCutSend (hardware insertion), positions as the STEP | [DXF](../../hardware/exports/body/sendcutsend/bay_floor_5052-H32_0.063in_x1.dxf), [STEP](../../hardware/exports/body/sendcutsend/bay_floor_5052-H32_0.063in_x1.step) | $51.12 (read 2026-10-27) | $51.12 |
| bay_side | 2 | 5052-H32 aluminium 0.063 in | 310.0 x 128.6 |  | [DXF](../../hardware/exports/body/sendcutsend/bay_side_5052-H32_0.063in_x2.dxf), [STEP](../../hardware/exports/body/sendcutsend/bay_side_5052-H32_0.063in_x2.step) | $22.05 (read 2026-10-27) | $44.10 |

**SendCutSend: $578.17** for the set (instant prices read 2026-10-27 in SendCutSend's app); the plan's estimate was ~$459. Shipping is free over SendCutSend's threshold. Backup: OSH Cut (oshcut.com), which prices the same DXF instantly and also bends and inserts PEM nuts. The bus bars can instead be two Victron VBB115040020 (150 A, 70 V, $17.82 each, in catalog/body.json), which need no insulators.

## 2. Bought parts, by seller

### McMaster-Carr (mcmaster.com): $176.50

| Task | Part | Used | Order | Price | Line | For | Backup |
|---|---|---|---|---|---|---|---|
| T2 | [94459A140](https://www.mcmaster.com/94459A140/): Heat-Set Threaded Inserts for Plastic, Standard, Brass, M3 x 0.5 mm Thread Size, 5.7 mm In | 26 | 1 x 50-pack | $10.91 | $10.91 | P1: 4 power dcdc, 2 bus insulator 1, 2 bus bar 1, 2 bus insulator 2, 2 bus bar 2, 5 bay side l high, | 3DJake $11.18 ([link](https://www.3djake.com/cnc-kitchen/threaded-inserts-m3-standard)): In stock |
| T2 | [94459A775](https://www.mcmaster.com/94459A775/): Heat-Set Threaded Inserts for Plastic, Standard, Brass, M5 x 0.8 mm Thread Size, 7.9 mm In | 32 | 2 x 25-pack | $6.82 | $13.64 | P1: 6 hip frame left, 6 hip frame right, 1 post 1 foot, 1 post 1 head, 1 post 2 foot, 1 post 2 head, | 3DJake $11.18 ([link](https://www.3djake.com/cnc-kitchen/threaded-inserts-m5-short)): In stock |
| T2 | [91290A111](https://www.mcmaster.com/91290A111/): Black-Oxide Alloy Steel Socket Head Screw, US Origin, M3 x 0.5 mm Thread Size, 6 mm Long | 20 | 1 x 100-pack | $11.59 | $11.59 | P1: 4 power dcdc, 1 bay side l low, 5 bay side l high, 1 bay side r low, 5 bay side r high (cad/body | Belmetric $0.12 ([link](https://belmetric.com/m3x0-5-socket-head-cap-screw-din-912-class-12-9/)): in stock |
| T2 | [91290A113](https://www.mcmaster.com/91290A113/): Black-oxide alloy steel socket head screw, M3 x 0.5 x 8 mm (the bus bars to their insulato | 8 | 1 x 100-pack | $13.28 | $13.28 | P1: 2 bus insulator 1, 2 bus bar 1, 2 bus insulator 2, 2 bus bar 2 (cad/body_joints.py) | McMaster-Carr $13.23 ([link](https://www.mcmaster.com/91290A115/)): M3 x 10 of the same series |
| T2 | [91294A190](https://www.mcmaster.com/91294A190/): Black-oxide alloy steel flat head hex drive screw, 90 deg, M4 x 0.7 x 10 mm (the spine sta | 16 | 1 x 100-pack | $6.38 | $6.38 | P1: 8 standoff left, 8 standoff right (cad/body_joints.py) | McMaster-Carr $6.25 ([link](https://www.mcmaster.com/91294A188/)): M4 x 8 of the same series (engages 3.3 mm in the standoff) |
| T2 | [91290A148](https://www.mcmaster.com/91290A148/): Black-oxide alloy steel socket head screw, M4 x 0.7 x 12 mm | 10 | 1 x 100-pack | $12.30 | $12.30 | P1: 2 dcdc bracket, 4 adapter plate front, 4 adapter plate rear (cad/body_joints.py) | McMaster-Carr $14.23 ([link](https://www.mcmaster.com/91290A150/)): M4 x 14 of the same series (a stack of three lugs) |
| T2 | [91290A168](https://www.mcmaster.com/91290A168/): Black-Oxide Alloy Steel Socket Head Screw, US Origin, M4 x 0.7 mm Thread Size, 20 mm Long | 12 | 1 x 100-pack | $14.47 | $14.47 | P1: 1 isolator 1, 1 isolator 2, 1 isolator 3, 1 isolator 4, 4 bay rail l, 4 bay rail r (cad/body_joi | Belmetric $0.20 ([link](https://belmetric.com/m4x0-7-socket-head-cap-screw-din-912-class-12-9/)): In stock |
| T2 | [91239A224](https://www.mcmaster.com/91239A224/): Black-oxide class 10.9 button head hex drive screw, ISO 7380, M5 x 0.8 x 10 mm (tray, bell | 16 | 1 x 100-pack | $11.79 | $11.79 | P1: 1 plate post 1 foot, 1 plate post 1 head, 1 plate post 2 foot, 1 plate post 2 head, 1 plate post | McMaster-Carr $12.06 ([link](https://www.mcmaster.com/91239A228/)): M5 x 12 of the same series |
| T2 | [91239A228](https://www.mcmaster.com/91239A228/): Black-oxide class 10.9 button head hex drive screw, ISO 7380, M5 x 0.8 x 12 mm (the hip fr | 40 | 1 x 100-pack | $12.06 | $12.06 | P1: 6 hip frame left, 4 tray flange left, 4 belly flange left, 6 hip frame right, 4 tray flange righ | McMaster-Carr $11.79 ([link](https://www.mcmaster.com/91239A224/)): M5 x 10 of the same series (engages 5.3 mm: only if the 12 is out) |
| T2 | [91290A115](https://www.mcmaster.com/91290A115/): Black-Oxide Alloy Steel Socket Head Screw, US Origin, M3 x 0.5 mm Thread Size, 10 mm Long | 8 | 1 x 100-pack | $13.23 | $13.23 | P1: 2 bay pad 1, 2 bay pad 2, 2 bay pad 3, 2 bay pad 4 (cad/body_joints.py) | Belmetric $0.14 ([link](https://belmetric.com/m3x0-5-socket-head-cap-screw-din-912-class-12-9/)): in stock |
| T2 | [91116A120](https://www.mcmaster.com/91116A120/): 18-8 Stainless Steel Oversized Washer, for M3 Screw, 3.2mm ID, 9.0mm OD, 0.7mm to 0.9mm Th | 8 | 1 x 100-pack | $4.81 | $4.81 | P1: 2 bay pad 1 (washer), 2 bay pad 2 (washer), 2 bay pad 3 (washer), 2 bay pad 4 (washer) (cad/body | Belmetric $0.08 ([link](https://belmetric.com/fender-washer-a2-stainless-din-9021/)): in stock |
| T2 | [95947A065](https://www.mcmaster.com/95947A065/): Lightweight aluminium female-threaded hex standoff, 6 mm hex, M4 x 31 mm (the spine: betwe | 8 | 8 | $1.46 | $11.68 | the spine: between the cheeks in the hip frames' bolt rows | McMaster-Carr $1.35 ([link](https://www.mcmaster.com/95947A062/)): M4 x 30 of the same series, with a printed 1 mm washer at one end |
| T2 | [95947A048](https://www.mcmaster.com/95947A048/): Lightweight aluminium female-threaded hex standoff, 6 mm hex, M3 x 16 mm (the J501 carrier | 4 | 4 | $0.81 | $3.24 | the J501 carrier on the compute pallet | McMaster-Carr $0.81 ([link](https://www.mcmaster.com/95947A051/)): M3 x 19 of the same series (the carrier 3 mm higher) |
| T2 | [91294A126](https://www.mcmaster.com/91294A126/): Black-Oxide Alloy Steel Hex-Drive Flat Head Screw, 90 Degree Countersink, M3 x 0.5 mm Thre | 4 | 1 x 100-pack | $5.45 | $5.45 | the carrier standoffs up through the pallet's countersinks | Belmetric $0.18 ([link](https://belmetric.com/m3x0-5-flat-head-cap-screw-steel-10-9-din-7991/)): in stock |
| T2 | [9307K884](https://www.mcmaster.com/9307K884/): Buna-N Rubber Grommet, for 11/16" Hole Diameter and 1/4" Material Thickness, 7/16" ID | 1 | 1 x 10-pack | $10.82 | $10.82 | the turret harness through the deck | printed $0.00 ([link](https://www.mcmaster.com/9307K884/)): print a split TPU 95A grommet (as the deck's lidar pass) |
| T2 | [91290A667](https://www.mcmaster.com/91290A667/): Black-Oxide Alloy Steel Socket Head Screw, M6 x 1 mm Thread Size, 16 mm Long, Fully Thread | 10 | 1 x 100-pack | $8.59 | $8.59 | the bus bars' lug stacks: down through the lug(s) and the bar into the insulator's nut | Belmetric $0.20 ([link](https://belmetric.com/m6x1-0-socket-head-cap-screw-din-912-class-12-9/)): in stock: DIN 912 class 12.9, black oxide, fully threaded (the |
| T2 | [94645A205](https://www.mcmaster.com/94645A205/): High-Strength Steel Nylon-Insert Locknut, Zinc Plated, M6 x 1 mm Thread Size | 10 | 1 x 100-pack | $12.26 | $12.26 | held in the bus insulators' hex pockets under the bars' holes (they cannot turn) | Global Industrial $25.95 ([link](https://www.globalindustrial.com/p/m6-x-1-0-nylon-insert-lock-nut-304-stainless-steel-din-985-pkg-of-100)): ships in 2 business |

### The Power Tool Store (thepowertoolstore.com): $518.00

| Task | Part | Used | Order | Price | Line | For | Backup |
|---|---|---|---|---|---|---|---|
| T5 | [DCB609 FLEXVOLT 20V/60V MAX 9.0Ah](https://thepowertoolstore.com/products/dewalt-dcb609): DeWalt DCB609 FLEXVOLT 20V/60V MAX 9.0Ah | 2 | 2 | $259.00 | $518.00 | the battery (D65): two FLEXVOLT 9.0 Ah packs in 20 V mode, in series (10S, 30-41 V); the user's own  | Ace Tool $259.00 ([link](https://acetool.com/Dewalt-DCB609-p/dew-dcb609.htm)): listed |

### Newark (newark.com): $275.99

| Task | Part | Used | Order | Price | Line | For | Backup |
|---|---|---|---|---|---|---|---|
| T5 | [TEP 150-4812WI](https://www.newark.com/search?st=TEP%20150-4812WI): TRACO TEP 150-4812WI DC-DC converter, 18-75 V in (4:1), 12 V 12.5 A (150 W), isolated 2,25 | 1 | 1 | $275.99 | $275.99 | 12 V 12.5 A, 18-75 V in, isolated (D65): the J501 and the 12 V rail, in place of the DDR-120C-24 and | Farnell $222.65 ([link](https://www.farnell.com/search?st=TEP%20150-4812WI)): listed (via the same aggregator) |

### go2marine (go2marine.com): $121.24

| Task | Part | Used | Order | Price | Line | For | Backup |
|---|---|---|---|---|---|---|---|
| T5 | [5191 MRBF Terminal Fuse Block 30-300A](https://www.go2marine.com/products/mrbf-terminal-fuse-block-30-to-300a): Blue Sea Systems 5191 MRBF Terminal Fuse Block 30-300A | 1 | 1 | $31.50 | $31.50 | the main fuse's block on the bay's + lead (on 3 mm printed PETG spacers; its M8 post insulated from  | go2marine $17.25 ([link](https://www.go2marine.com/products/mrbf-terminal-fuse-block-single-output-30-300-a-retail-pack)): available; Egis MRBF block, single ou |
| T5 | [5181](https://www.go2marine.com/products/mrbf-terminal-fuses-30-to-300-amps): Blue Sea 5181 MRBF terminal fuse 80 A, 58 V DC, 2 kA at 58 V | 2 | 2 | $20.50 | $41.00 | the main fuse (80 A, 58 V DC, 2 kA at 58 V); one spare | go2marine $13.50 ([link](https://www.go2marine.com/products/mrbf-terminal-fuse-80-a-retail-pack)): available; Egis MRBF 80 A, 58 V DC |
| T5 | [analog meter shunt 150 A / 50 mV (UPC 632085092313)](https://www.go2marine.com/products/analog-meter-shunt-150a-50mv): Blue Sea meter shunt 150 A / 50 mV (manganin), in the battery negative | 1 | 1 | $48.74 | $48.74 | the current shunt in the + lead after the MRBF (high side: the INA228 survives the switch opening) | The Solar Store $59.00 ([link](https://www.thesolarstore.com/products/shunt-mkb-100-100-100amp-100mv-shunt)): available; Deltec MKB-100-100 (100 A / 100 mV) |

### Haisstronica (haisstronica.com): $99.98

| Task | Part | Used | Order | Price | Line | For | Backup |
|---|---|---|---|---|---|---|---|
| T5 | [5000 pcs AWG 22-7](https://www.haisstronica.com/products/5000pcs-wire-ferrules-awg-22-7): Wire ferrules, 5000 pcs, AWG 22-7 (every screw terminal) | 1 | 1 | $65.99 | $65.99 | every screw terminal (the converter, the switch) | Haisstronica $33.99 ([link](https://www.haisstronica.com/products/ferrule-crimping-tool-awg-24-8)): available (the tool) |
| T5 | [HX1574](https://www.haisstronica.com/products/ferrule-crimping-tool-awg-24-8): Haisstronica ratcheting ferrule crimper, AWG 24-8 | 1 | 1 | $33.99 | $33.99 | the ferrules (once) | Haisstronica $65.99 ([link](https://www.haisstronica.com/products/5000pcs-wire-ferrules-awg-22-7)): available (the ferrule kit) |

### BNTECHGO (bntechgo.com): $96.90

| Task | Part | Used | Order | Price | Line | For | Backup |
|---|---|---|---|---|---|---|---|
| T5 | [8 AWG silicone black 10 ft](https://bntechgo.com/bntechgo-8-gauge-silicone-wire-black-10-feet-ultra-flexible-high-temp-200-c-600v-8-awg-silicone-rubber-wire-with-1650-strands-of-tinned-copper-w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): BNTECHGO 8 AWG silicone wire, black, 10 ft (the pack leads, the MRBF, the shunt, the switc | 1 | 1 | $17.98 | $17.98 | the bay's lead to the MRBF, the shunt, the switch and the bus bars (about 1.5 m; red heat-shrink on  | BNTECHGO $24.98 ([link](https://bntechgo.com/bntechgo-10-gauge-silicone-wire-spool-black-25-feet-ultra-flexible-high-temp-200-c-600v-10-awg-silicone-rubber-wire |
| T5 | [12 AWG silicone red + black 25 + 25 ft](https://bntechgo.com/): BNTECHGO 12 AWG silicone wire, red and black (VESC leads) | 1 | 1 | $32.98 | $32.98 | the two VESC branches (about 1.2 m red + black) | RaceDayQuads $2.99 ([link](https://www.racedayquads.com/products/silicone-wire-2-ft-red-and-black-pair)): 12 AWG sold out on 2026-10-27; 16/18/20 AWG in stock |
| T5 | [14 AWG silicone red + black 25 + 25 ft](https://bntechgo.com/): BNTECHGO 14 AWG silicone wire, red and black (RS-04 branches) | 1 | 1 | $24.98 | $24.98 | the four RS-04 branches, the frame bond (W33), the turret's branch and the J501's 12 V (about 4 m re | RaceDayQuads $2.99 ([link](https://www.racedayquads.com/products/silicone-wire-2-ft-red-and-black-pair)): 14 AWG sold out on 2026-10-27 |
| T5 | [18 AWG silicone red + black 10 + 10 ft](https://bntechgo.com/): BNTECHGO 18 AWG silicone wire, red and black (converters, 24 V and 12 V) | 1 | 1 | $9.48 | $9.48 | the converter's input, the 12 V loads (about 2 m red + black) | RaceDayQuads $1.99 ([link](https://www.racedayquads.com/products/silicone-wire-2-ft-red-and-black-pair)): 18 AWG in stock |
| T5 | [22 AWG silicone red + black 25 + 25 ft](https://bntechgo.com/): BNTECHGO 22 AWG silicone wire, red and black (5 V, signals; twist the CAN pairs by hand) | 1 | 1 | $11.48 | $11.48 | 5 V and signal wiring; the CAN pairs twisted by hand (about 6 m) | RaceDayQuads $1.99 ([link](https://www.racedayquads.com/products/silicone-wire-2-ft-red-and-black-pair)): 22 AWG sold out on 2026-10-27; 20 AWG in stock |

### Amazon (Terrafirma Technology) (amazon.com): $64.00

| Task | Part | Used | Order | Price | Line | For | Backup |
|---|---|---|---|---|---|---|---|
| T5 | [4pack 10AWG Adapter for DeWALT 20V (Amazon B07HYJ628S)](https://www.amazon.com/dp/B07HYJ628S): Terrafirma Technology DeWalt 20 V battery adapter, 10 AWG leads (1 ft), 30 A stated, no fu | 1 | 1 x 4-pack | $64.00 | $64.00 | the packs' rail adapters (4-pack: two used, two spare): 10 AWG leads, 30 A stated | Amazon (Terrafirma, 12 AWG single) $19.00 ([link](https://www.amazon.com/dp/B07TQFBZ6N)): listed; 12 AWG, M4/#6 mounting holes, current not stated |

### Flipsky (flipsky.net): $52.00

| Task | Part | Used | Order | Price | Line | For | Backup |
|---|---|---|---|---|---|---|---|
| T5 | [ANSIFS20SH](https://flipsky.net/products/flipsky-anti-spark-switch-smart-enhanced-300a-v2-0-for-electric-skateboard-ebike-scooter-robots): Flipsky Anti Spark Switch Smart Enhanced 300A V2.0, 12-84 V (3-20S), 100 A continuous, 16  | 1 | 1 | $52.00 | $52.00 | the main switch: low side, between the bay's - and the - bus; momentary mode (D54) | Flipsky $48.00 ([link](https://flipsky.net/products/flipsky-antispark-switch-pro-with-aluminum-pcb-case-200a-for-electric-skateboard-ebike-scooter-robots)): ava |

### Pololu (pololu.com): $43.90

| Task | Part | Used | Order | Price | Line | For | Backup |
|---|---|---|---|---|---|---|---|
| T5 | [D36V28F5 (#3782)](https://www.pololu.com/product/3782): Pololu 5 V 3.2 A step-down regulator D36V28F5 (from the 12 V rail) | 1 | 1 | $23.95 | $23.95 | 5 V from the 12 V rail: the MCU, VN-100, CAN transceivers, radio receiver | Pololu $26.95 ([link](https://www.pololu.com/product/2858)): Rationed; D24V22F5 5 V 2.5 A, 5.3-36 V in |
| T5 | [2804](https://www.pololu.com/product/2804): Pololu RC switch with relay (the radio stop: its dry contact is the STOP loop to the MCU;  | 1 | 1 | $19.95 | $19.95 | the radio's switch: its contact feeds the stop relay's coil (closed = run, open on the failsafe) | Pololu ([link](https://www.pololu.com/product/2803)): the digital-output version (no relay): backup through a MOSFET on the MCU board |

### Selterm (selterm.com): $31.16

| Task | Part | Used | Order | Price | Line | For | Backup |
|---|---|---|---|---|---|---|---|
| T5 | [MD0814P](https://selterm.com/products/8-awg-1-4-stud-tinned-copper-battery-cable-ends-wire-lugs-marine-grade-md0814p): Selterm tinned copper lug 8 AWG, 1/4 in (M6) stud, 10 pcs (crimped on 10 AWG with a sleeve | 10 | 1 x 10-pack | $15.01 | $15.01 | the bus bars' M6 taps | go2marine $4.95 ([link](https://www.go2marine.com/products/ring-terminals-adhesive-lined-heat-shrink-ancor)): available; Ancor adhesive heat-shrink rings 12-10  |
| T5 | [MD0856P](https://selterm.com/products/8-awg-5-16-stud-tinned-copper-battery-cable-ends-wire-lugs-marine-grade-md0856p): Selterm tinned copper lug 8 AWG, 5/16 in (M8) stud, 10 pcs (the MRBF block) | 4 | 1 x 10-pack | $16.15 | $16.15 | the MRBF block's M8 studs and the shunt | go2marine $4.95 ([link](https://www.go2marine.com/products/ring-terminals-adhesive-lined-heat-shrink-ancor)): available; Ancor 12-10 AWG M8 |

### RockAuto (rockauto.com): $27.36

| Task | Part | Used | Order | Price | Line | For | Backup |
|---|---|---|---|---|---|---|---|
| T5 | [HHM](https://www.rockauto.com/en/moreinfo.php?pk=1474944): Bussmann HHM inline MINI fuse holder, 2-30 A (rated 32 V DC: the 58 V fuse does the interr | 12 | 12 | $2.28 | $27.36 | one per branch (11) and a spare: labelled "58 V fuses only"; pull only with the packs out | LCSC $0.30 ([link](https://www.lcsc.com/product-detail/C3207515.html)): 0 (Keystone 3570 PCB holder: the fuse-board upgrade) |

### Adafruit (adafruit.com): $26.80

| Task | Part | Used | Order | Price | Line | For | Backup |
|---|---|---|---|---|---|---|---|
| T5 | [5832](https://www.adafruit.com/product/5832): Adafruit INA228 85 V 20-bit power monitor breakout (remove its 15 mOhm shunt; wire it to t | 1 | 1 | $14.95 | $14.95 | pack voltage and current to the MCU over I2C (its own 15 mOhm shunt removed, wired to the external s | Adafruit $10.95 ([link](https://www.adafruit.com/product/6349)): In stock; INA238 (16-bit), same board |
| T5 | [5708](https://www.adafruit.com/product/5708): Adafruit CAN Pal (TJA1051T/3) CAN transceiver, switchable 120 Ohm | 3 | 3 | $3.95 | $11.85 | CAN transceivers for the MCU's buses A, B, C | Waveshare $4.99 ([link](https://www.waveshare.com/sn65hvd230-can-board.htm)): InStock; SN65HVD230 board |

### ST eStore (estore.st.com): $19.90

| Task | Part | Used | Order | Price | Line | For | Backup |
|---|---|---|---|---|---|---|---|
| T5 | [NUCLEO-G474RE](https://estore.st.com/en/nucleo-g474re-cpn.html): ST Nucleo-64 NUCLEO-G474RE (the balance and power MCU: 3 FDCAN) | 1 | 1 | $19.90 | $19.90 | the balance and power MCU (three FDCAN: buses A, B, C) | SparkFun $31.50 ([link](https://www.sparkfun.com/teensy-4-1.html)): In stock; Teensy 4.1 (3 CAN) as the backup MCU |

### Pyrodrone (pyrodrone.com): $17.95

| Task | Part | Used | Order | Price | Line | For | Backup |
|---|---|---|---|---|---|---|---|
| T5 | [XT60H-F](https://www.pyrodrone.com/products/amass-xt60h-connector-5pcs-female): Amass XT60H female, 5-pack (the robot's live ends: the charge port and the 48 V branch lea | 6 | 2 x 5-pack | $3.99 | $7.98 | sockets on the robot, no live pins (D58, hazard 11): the six bus branch leads' ends (W10-W15) | RaceDayQuads $0.99 ([link](https://www.racedayquads.com/products/xt60-connector-1pc-choose-your-version)): available (single) |
| T5 | [XT60H-M 5-pack](https://www.pyrodrone.com/products/xt60h-male-xt60-upgrade-amass): Amass XT60H male, 5-pack (the devices' end: the VESC leads; D58) | 2 | 1 x 5-pack | $3.99 | $3.99 | the two VESC leads' plugs (the devices carry the pins; the RS-04 pigtails' XT60H-M come with the leg | RaceDayQuads $0.99 ([link](https://www.racedayquads.com/products/xt60-connector-1pc-choose-your-version)): available (single) |
| T5 | [XT30U-F 8-pack](https://www.pyrodrone.com/products/yellow-xt30u-f-8-pack-female-battery): Amass XT30U female, 8-pack (the robot's live ends: the 24 V and 12 V branch leads; D58) | 3 | 1 x 8-pack | $2.99 | $2.99 | sockets on the robot: the J501 (W21), the lidar box (W24); one spare (D76: the turret takes its powe | RaceDayQuads $0.99 ([link](https://www.racedayquads.com/products/xt30-connector-male-or-female)): available (single) |
| T5 | [XT30U-M 8-pack](https://www.pyrodrone.com/products/yellow-xt30u-m-8-pack-male-device): Amass XT30U male, 8-pack (the devices' end: the J501 and lidar box adapter leads; D58) | 4 | 1 x 8-pack | $2.99 | $2.99 | the devices' pins: the J501's DC-IN and the lidar box's adapter leads, two spare | RaceDayQuads $0.99 ([link](https://www.racedayquads.com/products/xt30-connector-male-or-female)): available (single) |

### RadioMaster (radiomasterrc.com): $16.99

| Task | Part | Used | Order | Price | Line | For | Backup |
|---|---|---|---|---|---|---|---|
| T5 | [ER3C-i 2.4 GHz ELRS PWM](https://radiomasterrc.com/products/er3c-i-2-4ghz-elrs-pwm-receiver): RadioMaster ER3C-i ExpressLRS 2.4 GHz PWM receiver (the radio stop, D37: one PWM channel d | 1 | 1 | $16.99 | $16.99 | the radio stop's receiver (D37), on the 5 V rail | RadioMaster $18.99 ([link](https://radiomasterrc.com/products/rp1-expresslrs-2-4ghz-nano-receiver)): available; RP1 V2 nano, PWM on its UART pads (ELRS 3 settin |

### Sky RC Hobby on Amazon (amazon.com): $12.98

| Task | Part | Used | Order | Price | Line | For | Backup |
|---|---|---|---|---|---|---|---|
| T5 | [XT90-S](https://www.amazon.com/dp/B074PTHZ3M): Amass XT90-S anti-spark connector, male + female, 5 pairs | 2 | 1 x 5-pack | $12.98 | $12.98 | the bay's lead (anti-spark: female on the bay, male on the robot) and the series link between the pa | FLYRC on Amazon $14.99 ([link](https://www.amazon.com/dp/B08L3S2ZK8)): In Stock; 3 pairs with 150 mm 10 AWG pigtails |

### LCSC (lcsc.com): $10.59

| Task | Part | Used | Order | Price | Line | For | Backup |
|---|---|---|---|---|---|---|---|
| T5 | [0997020.WXN](https://www.lcsc.com/product-detail/C207028.html): Littelfuse MINI 58V blade fuse 20 A (the RS-04 branches) | 8 | 8 | $0.61 | $4.88 | the four RS-04 branches (14 AWG); four spares | element14 ([link](https://nz.element14.com/littelfuse/0997020-wxn/auto-blade-fuse-2a-58v/dp/2748837)): listed (snippet) |
| T5 | [0997030.WXN](https://www.lcsc.com/product-detail/C207030.html): Littelfuse MINI 58V blade fuse 30 A (the VESC branches) | 4 | 4 | $0.44 | $1.76 | the two VESC branches (12 AWG; the VESCs' battery current limit 20 A); two spares | LCSC $0.49 ([link](https://www.lcsc.com/product-detail/C207029.html)): 1,743 (25 A) |
| T5 | [0997010.WXN](https://www.lcsc.com/product-detail/C207026.html): Littelfuse MINI 58V blade fuse 10 A (DDR-120C-24 input, the charge port) | 4 | 4 | $0.41 | $1.64 | the TRACO input (W16) and the J501 (W21); two spares | LCSC $0.66 ([link](https://www.lcsc.com/product-detail/C207027.html)): 2,950 (15 A) |
| T5 | [099707.5WXN](https://www.lcsc.com/product-detail/C2680610.html): Littelfuse MINI 58V blade fuse 7.5 A (the turret's feed W22 and the 12 V rail W43, D66) | 4 | 4 | $0.58 | $2.31 | the turret's branch (W22: the stop relay's contact carries 8 A) and the 12 V loads (W43); two spares | LCSC (other suppliers) $0.31 ([link](https://www.lcsc.com/product-detail/C2680610.html)): 3,000 (5-7 business days) |

### DigiKey (digikey.com): $8.28

| Task | Part | Used | Order | Price | Line | For | Backup |
|---|---|---|---|---|---|---|---|
| T5 | [G2RL-2-DC12](https://www.digikey.com/en/products/detail/omron-electronics-inc-emc-div/G2RL-2-DC12/368870): Omron G2RL-2 DC12 power relay, DPDT, 12 V coil, 8 A at 30 V DC (the stop relay: the turret | 2 | 2 | $4.14 | $8.28 | the stop relay (one spare): pole A the turret's safety loop, pole B its bus branch (D66); on the MCU | LCSC ([link](https://www.lcsc.com/product-detail/C61458.html)): listed as C61458 (price shown on the live page) |

### TLC Electronics (tlcelectronics.com): $4.16

| Task | Part | Used | Order | Price | Line | For | Backup |
|---|---|---|---|---|---|---|---|
| T5 | [AGHGH28K305](https://tlcelectronics.com/products/detail/JST/AGHGH28K305): JST GH 1.25 pre-crimped lead, socket to socket, 300 mm (CAN, UART) | 8 | 8 | $0.52 | $4.16 | CAN and I2C leads to the transceivers and the INA228 | TLC Electronics $0.48 ([link](https://tlcelectronics.com/products/detail/JST/AGHGH28K152)): 6,000 (150 mm) |

### Farnell (il.farnell.com): $1.96

| Task | Part | Used | Order | Price | Line | For | Backup |
|---|---|---|---|---|---|---|---|
| T5 | [0997005.WXN](https://il.farnell.com/littelfuse/0997005-wxn/auto-blade-fuse-5a-58v/dp/2748834): Littelfuse MINI 58V blade fuse 5 A (DDR-60L-12 input; the 24 V J501 and turret branches) | 2 | 2 | $0.98 | $1.96 | the INA228's VBUS sense lead (W32, 22 AWG); one spare | Dasenic $0.39 ([link](https://www.dasenic.com/product/littelfuse-0997005wxn)): 17,902 in stock, $0.3878 at 25+ (search result, 2026-10-27) |

**Bought parts: $1626.64** (whole packs at the first seller's price; shipping and tax extra).

## 3. Listed, not in this order

- Seeed Studio / NVIDIA reServer Industrial J501 carrier + Jetson AGX Orin 32GB + Seeed heatsink with fan, in the j501-agx printed enclosure x 1: the compute (R13: listed at retail, bought with the sensor head) ($1,328.00 at Seeed Studio (carrier))
- Velodyne Lidar (now Ouster) VLP-16 Puck (datasheet 63-9229 Rev K) x 1: the lidar (R13) ($4,000.00 at eBay (used))
- VectorNav VN-100 Rugged x 1: the balance IMU (R13, R17)
- Flipsky 75100 (single) x 2: the wheels' drivers, hung under the power plate: on the leg workstream's order (docs/body-plan.md 8) ($65.00 at Flipsky)

## 4. Still to source (not tied to a listed product page yet)

- M3 x 35 flat head, ISO 10642 (the cooler tie-down: the j501-agx rule, 4 mm into the module-to-heatsink standoffs) x 4: the J501 cooler tie-down up through the pallet. McMaster's 91294A flat heads stop at M3 x 25 (91294A138); the fallback is an M3 x 35 socket head (DIN 912: Belmetric BSH3X35 on its M3 page, belmetric.com/m3x0-5-socket-head-cap-screw-din-912-class-12-9/) with its head under the pallet, in the 8 mm the isolators leave
- 1/4-20 UNC x 3/8 in socket button head (the VLP-16 to the deck) x 1: the lidar. any hardware store
- 5/16-18 nylon-insert locknut (the SSC1 pods' feet in the ear brackets, P3) x 2: the ears. McMaster's 95615A (grade 5, zinc) has it; the product page for 5/16-18 is still to read (A120 is 1/4-20, A140 3/8-16)
- Switchcraft TB4M mini-XLR 4-pin panel receptacle (the radio-stop jack, P3: STOP A/B, +12 V, GND) x 1: the rear face. a listed part (DigiKey, Mouser); price to read; the turret's pendant uses its 3-pin TB3M (catalog/turret.json)
- RP-SMA bulkhead pigtails x 4 (the J501's radios to the rear face, P3) x 4: the rear face's D-flat holes. with the J501's Wi-Fi module when it is chosen (the j501-agx project's antenna note)
- Ø4 x 10 mm dowel pin (the VLP-16's two locating holes) x 2: the lidar. McMaster 98381A series
- thumbscrew_m3x10 x 4: the bay's two doors (two each, into the rails' end inserts): tool-free. not in the catalogue yet: a product page to read (D40)
- vhb_tape_25mm x 1: the bay's TPU skids (3M VHB 5952, 25 mm). not in the catalogue yet: a product page to read (D40)
- thumbscrew_m3x10 x 4: P1: 1 bay door front l, 1 bay door front r, 1 bay door rear l, 1 bay door rear r (cad/body_joints.py). not in the catalogue yet: a product page to read (D40)
- screw_m5x16_button x 4: P2: 4 riser (cad/body_joints.py). not in the catalogue yet: a product page to read (D40)

## 5. Printed (Bambu P1S, 256 mm bed)

| Part | Qty | Material | Size (mm) | g each | Hours | How |
|---|---|---|---|---|---|---|
| post | 4 | pa6-cf | 22 x 22 x 120 | 44 | 11.4 | PA6-CF, 100 % solid, printed standing; 2 x M5 inserts |
| riser | 1 | pa6-cf | 144 x 144 x 30 | 175 | 11.4 | PA6-CF, 100 % solid, printed on its top face; 8 x M5 inserts, 2 x Ø5 dowels |
| isolator | 4 | tpu95 | 16 x 16 x 13 | 2 | 0.9 | TPU 95A: the pallet's isolator foot, neck and cap |
| plate_post | 4 | pa6-cf | 16 x 16 x 42 | 11 | 2.8 | PA6-CF, 100 %; M5 inserts both ends; printed standing |
| bus_insulator | 2 | petg | 110 x 20 x 16 | 38 | 3.0 | PETG, 100 % (never a carbon-filled filament: carbon conducts, and the plate is bonded to the - bus); 4 x M3 inserts; test: > 10 MOhm at 50 V from every lug screw to the plate before power |
| dcdc_bracket | 1 | pa6-cf | 98 x 48 x 69 | 61 | 4.0 | PA6-CF; two M4 x 12 down into the power plate's flush nuts; the converter on four M3 x 6 into the upright's inserts |
| bay_rail_l | 1 | pa6-cf | 310 x 8 x 10 | 26 | 1.7 | PA6-CF; four M4 x 20 up into the belly's nuts, five M3 inserts, two in its ends |
| bay_rail_r | 1 | pa6-cf | 310 x 8 x 10 | 26 | 1.7 | PA6-CF; four M4 x 20 up into the belly's nuts, five M3 inserts, two in its ends |
| adapter_plate_front | 1 | pa6-cf | 102 x 72 x 4 | 31 | 2.1 | PA6-CF; four M4 x 12 up into the belly's nuts; the adapter's screws into inserts set on arrival |
| bay_door_front | 1 | petg | 128 x 102 x 4 | 66 | 2.6 | PETG; two knurled M3 x 10 thumbscrews into the rails' ends |
| adapter_plate_rear | 1 | pa6-cf | 102 x 72 x 4 | 31 | 2.1 | PA6-CF; four M4 x 12 up into the belly's nuts; the adapter's screws into inserts set on arrival |
| bay_door_rear | 1 | petg | 128 x 102 x 4 | 66 | 2.6 | PETG; two knurled M3 x 10 thumbscrews into the rails' ends |
| bay_skid | 4 | tpu95-gyroid | 149 x 30 x 68 | 64 | 51.7 | crush pad (#19): TPU 95A HF gyroid lattice, 50 mm free, 30 mm stroke, 600 N plateau, on 3M VHB tape, its solid lip under the side plate's two low M3 x 10 (#26); the robot sits on these |

By material: pa6-cf 0.57 kg, 37.2 h, $45.36; tpu95 0.01 kg, 0.9 h, $0.35; petg 0.21 kg, 8.2 h, $2.91; tpu95-gyroid 0.26 kg, 51.7 h, $10.75. STLs beside the plan in `exports/body/`.

## 6. The P2 cart (the head: order it once P1 balances on its tether)

The turret's mount plate (D59) goes under the deck at the riser: the riser's four screws grow to M5 x 16 through it, and its two ends are screwed down through the deck into its PEM nuts. **In the P1 deck, drill the two Ø5.5 holes by hand** at (x, y) = (-110, 0) and (30, 0) mm (robot frame): hold the plate on the riser's four screws and spot through its PEM nuts with an M5 transfer punch. A Rev B deck (lever 3) gets them cut.

| Part | Qty | Made | Price each | Line | For |
|---|---|---|---|---|---|
| [turret_plate](../../hardware/exports/body/sendcutsend/turret_plate_6061-T6_0.125in_x1.dxf) | 1 | SendCutSend: 6061-T6 aluminium 0.125 in, 2 x PEM SS-M5-0 pressed by SendCutSend (hardware insertion), positions as the STEP | $44.11 (read 2026-10-28) | $44.11 | D59 |
| [94459A775](https://www.mcmaster.com/94459A775/): Heat-Set Threaded Inserts for Plastic, Standard, Brass, M5 x 0.8 mm Th | 4 | McMaster-Carr (1 x 25-pack) | $6.82 | $6.82 | P2: 4 riser (cad/body_joints.py) |
| [91239A224](https://www.mcmaster.com/91239A224/): Black-oxide class 10.9 button head hex drive screw, ISO 7380, M5 x 0.8 | 2 | McMaster-Carr (1 x 100-pack) | $11.79 | $11.79 | P2: 2 turret plate ends (cad/body_joints.py) |

**P2 cart: $62.72** (whole packs; a line marked as taken from an earlier pack costs nothing here).

## 6b. The P3 cart (the shell, the tub, the guards: order it with P3)

The shell and the tub's printed parts are in `exports/body/shell/` with their own print plan; the leg's knee wedges and apex fillets are envelopes for the leg workstream (`exports/body/shell/*_envelope.step`).

| Part | Qty | Made | Price each | Line | For |
|---|---|---|---|---|---|
| [94459A140](https://www.mcmaster.com/94459A140/): Heat-Set Threaded Inserts for Plastic, Standard, Brass, M3 x 0.5 mm Th | 22 | McMaster-Carr (1 x 50-pack) | $10.91 | $10.91 | P3: 2 wall l front, 2 wall l rear, 2 wall r front, 2 wall r rear, 2 shell front post l, 2 shell front post r,  |
| [90592A085](https://www.mcmaster.com/90592A085/): Steel Hex Nut, Medium-Strength, Class 8, M3 x 0.5 mm (held in the P3 s | 10 | McMaster-Carr (1 x 100-pack) | $2.94 | $2.94 | P3: 2 splice l, 2 splice r, 4 shell door, 2 shell hatch (cad/body_joints.py) |
| [94645A102](https://www.mcmaster.com/94645A102/): High-Strength Steel Nylon-Insert Locknut, Zinc Plated, M5 x 0.8 mm Thr | 8 | McMaster-Carr (1 x 100-pack) | $15.66 | $15.66 | P3: 4 ear bracket l, 4 ear bracket r (cad/body_joints.py) |
| [91290A120](https://www.mcmaster.com/91290A120/): Black-Oxide Alloy Steel Socket Head Screw, M3 x 0.5 x 16 mm (the P3 sh | 16 | McMaster-Carr (1 x 100-pack) | $12.22 | $12.22 | P3: 2 wall l front, 2 wall l rear, 2 wall r front, 2 wall r rear, 2 shell front post l, 2 shell front post r,  |
| [91290A111](https://www.mcmaster.com/91290A111/): Black-Oxide Alloy Steel Socket Head Screw, US Origin, M3 x 0.5 mm Thre | 5 | McMaster-Carr (1 x 100-pack) | $11.59 | $11.59 | P3: 2 eyes clip, 3 fan duct (cad/body_joints.py) |
| [91290A113](https://www.mcmaster.com/91290A113/): Black-oxide alloy steel socket head screw, M3 x 0.5 x 8 mm (the bus ba | 18 | McMaster-Carr (1 x 100-pack) | $13.28 | $13.28 | P3: 2 splice l, 2 splice r, 2 d435 cradle front feet, 2 d435 front back, 2 d435 cradle rear feet, 2 d435 rear  |
| [91290A230](https://www.mcmaster.com/91290A230/): Black-oxide alloy steel socket head screw, M5 x 0.8 x 14 mm (the fuse  | 8 | McMaster-Carr (1 x 100-pack) | $17.43 | $17.43 | P3: 4 ear bracket l, 4 ear bracket r (cad/body_joints.py) |

**P3 cart: $84.03** (whole packs; the bought shell parts (the SSC1 pods, the D435s, the DualEye) are in the sensor head's order).

## 7. Totals

| | |
|---|---|
| Bought (section 2) | $1626.64 |
| SendCutSend (section 1, instant prices) | $578.17 |
| Filament used (section 5) | $59.37 |
| **Body P0 + P1** | **$2264.18** |
| P2 cart (section 6) | $62.72 |
| P3 cart (section 6b) | $84.03 |

Not included: the compute and sensors (section 3, R13), the legs and their VESCs (the leg workstream's order), the turret (the turret workstream's), the shell (P3), shipping and tax.
