Valpatel/gyropup/docs/electronics/base-board-component-checklist.md

# Carrier component checklist

Audit date: 2026-10-29. Current integrated checkpoint: `fa459d09aebe416be21edc1c11ceb37fe41c3f7e`, including PR67/86/88/90/92. The original audit used `faed5f510586ab282db4a27f6453165ac56f70d2`; historical line references below still identify that original source, not current line numbers.

The [C2 interface candidate](base-board-interfaces.md) implements a wiring window and strain-relief anchors; the [C3 support candidate](carrier-service-connectors.md) adds exact screw/nut stacks, exterior disconnect/park poses and a 34-part inspectable assembly. PR86 regenerated the affected C2 and insert-specimen receipts against its complete CAD source closure. These are bounded candidates: full module/harness, printed strength, retention and physical qualification remain open. The next shared board/terminal/thermal packaging contract is [#66](https://github.com/Valpatel/gyropup/issues/66), which took over #85 and #96.

The [unpowered insert-fit specimens](../research/carrier-insert-fit/README.md) extract the actual local carrier boss and base anchor in their different print orientations. Their source-bound STEP/STL and geometry-only 3MF files provide a blank measurement workflow; no physical measurements or fit acceptance are claimed.

Scope remains the passive pan-base opening and removable electronics carrier. The original read-only audit and missing-cache reproduction are historical; subsequent PR67/86 compute runs provide the bounded source-bound evidence described here. They do not establish complete hardware fit or service. No launcher, motor, rail, torque, or other turret/leg redesign is included. Subsequent implementation must regenerate affected evidence from its own source head.

### Exact mounting inventory and placements

Coordinates are millimetres in turret frame T, not measured fit. Instance order is `(negative y, z9)`, `(negative y, z33)`, `(positive y, z9)`, `(positive y, z33)`.

| Component | Quantity / placement | Evidence and remaining gap |
|---|---|---|
| PA6-CF carrier | 1; plate x53..56, y±35, z5.5..37.5; four inward bosses x48..53, radius3.5 | `cad/turret_base_board.py:48–56`; public candidate STEP and source-derived insert-fit specimens exist. Complete print planning, measured fit and physical clearance remain unqualified. |
| PCB | 1; x46.4..48, y±25.4, z6..36; holes y±22.4, z9/33 | Resolved to custom Ø3.2 holes in cut SparkFun Wombat PRT-08619 stock; Ø3.4 remains the printed carrier retainer clearance. See the [source-backed drill plan](base-board-stock.md). Actual thickness, copper clearance and insulating hardware remain unqualified. |
| PCB screws | 4 × McMaster 91290A111 M3×6; head bearing faces `(46.4, ±22.4, 9/33)`, shaft direction +X | `cad/turret_base_board.py:108–113`; private STEP cached. Public model is authored simplified hardware. Four existing screws transfer to the carrier; not four extra purchases. |
| Carrier retainers | 4 × McMaster 91290A113 M3×8; head bearing faces `(56, ±31, 9/33)`, shaft direction −X | Same source; four additional screws. Exact private manufacturer STEP was acquired and normalized on 2026-10-29 in PR86; [source, specification and hashes](../research/carrier-service-connectors/support-hardware-catalog.json). Acquisition does not qualify detailed thread mating, torque or physical fit. |
| Board inserts | 4 × McMaster 94459A140; mouths `(48, ±22.4, 9/33)`, bodies extend +X | `cad/turret_base_board.py:130–132`; existing four transfer to carrier. Nominal total model length 5.74; recorded useful thread 5.53 with 0.105 lead-in. Heat-setting tool and actual fit not yet checked. |
| Base-anchor inserts | 4 × 94459A140; mouths `(53, ±31, 9/33)`, bodies extend −X into anchor rails x45..53 | `cad/turret_base_board.py:32–45,130–132`; four additional inserts. Ø4 pilot bores x46.5..53.1; source-derived orientation-specific specimen exists; measurements, insertion-tool access and renewed anchor/base strength qualification remain absent. |

The original carrier mounting hardware is **8 screws + 8 inserts**, three SKUs. Historical useful engagement calculations are 4.295 mm for PCB screws and 4.895 mm for carrier retainers, against the declared 3 mm minimum; these are not new measured or complete manufacturer qualification results.

The opt-in C3 support adds **2 × 91290A113 M3×8 screws and 2 × 90592A085 M3 nuts**. Screw bearing seats are `(58, ±10, 10)`, shafts toward −X; the nut bodies span X50.6..53. The nominal grip is 2 mm support + 3 mm carrier, with 2.4 mm nuts and 0.6 mm screw projection. This candidate therefore has **10 screws + 8 inserts + 2 nuts** (four SKUs); these are 20 public authored hardware shapes in the 34-part inspection assembly. Its private input catalogue records both exact supplier models. The support remains a separate candidate, not default fabrication geometry or a qualified printed load path.

The 58 bounded support checks cover original-mount preservation, screw/nut clearances, containment, tool order and exterior housing paths. A conservative 96 N connector mating-load screen is recorded separately; no conditioned printed allowable, snap-retention strength or creep qualification exists. Do not substitute geometry clearance for those missing results.

Protected regions remain foot z≤5; central tube radius≤35.5, z≤38; bearing seat x±43/y±50/z38..60; servo pocket x−85..−25/y−50..60/z0..65 (`docs/base-board-service.md:11`). The recorded symmetric-difference checks are historical and must be regenerated from the eventual final candidate.

### Required assembly and service order

1. Verify the board stock/cut size, hole diameter, screw/insert dimensions and measured printer coupons. Install four inserts in the carrier and four in the base using a specified heat-setting tip and accessible axial route. **Heat-setting access is not covered by the current screw-driver test.**
2. If using the separate C3 support candidate, install/hold its inward-facing nuts and attach the support before the PCB. The installed PCB blocks straight nut removal; the PCB must come off first for that operation. Then assemble the PCB/component assembly to the carrier with the four M3×6 screws. Components face −X. Complete soldering and strain relief while both board faces are accessible; backside solder/jumper volume in the x48..53 gap is currently unmodelled.
3. Remove the TPU bumper and its retainers before module insertion or external carrier-driver access. The bumper uses five existing M3×20 screws, five washers and five short inserts (`cad/build_turret.py:127`); the current carrier checker assumes the bumper has already been removed and does not prove its teardown/tool route.
4. With the interfaces unplugged and loose fixed tails parked clear, insert the rigid carrier/PCB/attached PCB screws/inserts along −X; then fit the four external M3×8 retainers from +X. The released generic rigid-module API is available, but the complete product route has not integrated it yet.
5. With the module mechanically retained and all sources still isolated, mate C3, the pan-servo interface and C2 at their accessible positions; secure the qualified strain relief/keeper and refit the bumper. The [C2 candidate](base-board-interfaces.md) defines its positions, straight exits and release poses. Actual retention, bends, solder insulation, C3/servo access and tail parking remain unqualified; this is not a complete installation/removal claim.
6. For removal: isolate all sources and verify stored energy is discharged under the project procedure; remove bumper; release connector keepers/ties and unplug C2, C3 and the pan-servo interface while the carrier is still retained. Park the loose fixed tails clear, remove the four external retainers, then withdraw the complete PCB/carrier along +X. Only then undo the inward-facing PCB screws on the bench. This matches S1 disconnect before S2 retainer removal/withdrawal in the C2 candidate.

The historical `cad/check_base_board_service.py` checker moves a fused module against only the base, pan ring, pan clamp and pan pinion. It is not the released rigid-module API and must not be rerun as current complete-service qualification. Its historical base route travel is 42.8772 mm, derived per obstacle by the sweep; it **does not explicitly prove a 60 mm service stroke**. The retained-bumper negative is blocked over its 50.1 mm query. A proposed service stroke must be declared and checked with the real harness/connector configuration. Pan servo, stator connector/leads, fuse holder, DT rear tails and strain-relief features are not all present in that route obstacle set.

Driver envelope currently assumed: Ø6×60mm shaft plus Ø25 × 80 mm handle, straight axial approach, no hand/finger or ratchet swing envelope (`cad/check_base_board_service.py:27`). PCB drive approach is from−X on the bench; external-retainer drive approach is from+X with the bumper removed. Match an actual tool or record this as a conservative design envelope; do not call it verified user access yet.

### Electronics and harness completeness

| Interface / group | Existing source contract | Missing hard evidence / next action |
|---|---|---|
| Board components | One each U1 NE555P; U2 D36V50F12; F1 MF-R300; R1/R2/R3; C1/C2/C3; D1, from `cad/turret_boards.py:128–142` | Seven legacy footprint/group envelopes are present; actual solder tails, leads and component retention are absent. The separate electrical candidates do not fit merely because these envelopes exist. Model the complete proposed physical inventory and terminations without shrinking their extents. |
| PAN supply candidates | [Native circuit candidate B](../../hardware/carrier-pan-protection/README.md), 29 parts / 102 leads, and the [lower-loss comparison](../research/protection/carrier-practical-architecture.md) | No protection-board area is allocated. The full reference front end, cutoff, converter, terminations and thermal assembly need one concrete packaging contract in issue96. Candidate B startup/heat margins and the proposed alternative remain unqualified; no catalogue substitution is selected. |
| Board backside | PCB rear x48, carrier front x53 (nominal5mm gap away from bosses) | No solder joints, jumper wire, insulation, or strain-relief relief pockets are represented. A bare 5 mm gap is not evidence that the wired board fits. |
| C2 incoming bundle | 2 power + 4 signal conductors; original 18/24 AWG trunk | [Candidate](base-board-interfaces.md) now specifies XT30 power with16 AWG tails and a separate4-way Micro-Fit signal interface. Window, anchors, release reservations and retained lengths exist. Real solder terminations, clamp/keeper, bend radii, complete installed termination geometry and physical fit remain open. |
| C2 protection parts | One each MF-R010,1N5408,P6KE51A in adjacent harness;10A MINI58V fuse and holder | Exact bare0FHM0001ZXJ voltage is unqualified because manufacturer revisions/distributor data conflict. It is not conclusively only32V. 0FHM0003ZXJS is a documented58V candidate, not selected. D14 maximum clamp70.1V versus U2 maximum50V is separately unresolved. |
| C3 stator plug | One43020-1200 board plug +12 × 43031-0001 male contacts on12 × 24 AWG, 60 mm tails; mates one 43025-1200 +12 × 43030-0010 on ring's28AWG leads (`docs/turret-wiring.md:177–183,240`) | PR86 records exact housing/female-contact models, mirrored cavity maps, candidate mated/unplugged/parked poses and continuous conservative housing-box sweeps. The public connector is still explicitly incomplete. Exact male-contact/installed-crimp geometry, latch qualification, routed loops and physical retention remain open. Rotor-side duplicates are outside this inventory. |
| Pan servo connection | Selected 12 V C018 / Waveshare SKU22414 supplied three-pin lead; FEETECH sheet calls out 5264-3P and 150 mm | Primary sources disagree on 2.50/2.54 mm pitch; OEM gauge/OD and minimum bend radius remain unknown. A matched CJT A2505 carrier-end retermination is conditional, not assumed cross-mating compatibility. It needs a real support/footprint, terminal mapping and service route. This is not a CAN-servo substitution. |
| DT12 interface | DT04-12PA-L012, W12P, catalog pin0460-202-16141; only signals5–8 active under current wiring | Catalog pin describes 14–16 AWG; the supplier audit reports [TE primary documentation](https://www.te.com/en/product-0460-202-16141.html) specifies 16–20 AWG, still incompatible with the planned 24 AWG signals. Reconcile the selected contact and unused-cavity policy before harness release; no alternate is selected here. DT outer envelope does not prove rear-tail/crimp access. |
| Wire bend radius | Catalog24AWG UL1007 OD1.4mm;18AWG PTFE OD1.75mm | No source-backed minimum static/service bend radius is defined for these installed bundles. Obtain wire/connector limits; reserve geometry using that radius and measured assembly, not an invented universal multiplier. |
| Slack and strain relief | C2 candidate retains 55 mm fixed / 40 mm module tails. C3 proposes 145 mm fixed / 30 mm module tails from explicit anchors | C2 necessary length bounds are sampled at 33 release positions with failing short/still-mated negatives. C3 necessary bounds peak at 135.30 / 22.11 mm, preserving a 19.1 mm straight exit; ring-to-anchor and PCB-to-anchor lengths are additional. These are not obstacle-cleared cable routes or bend-radius proof. Unknown bends and unqualified keeper/clamp prevent a harness pass; cutting allowance is not service slack. |

### Acceptance blockers and adversarial checks

- [x] Independent review confirms missing/partial manufacturer caches fail closed at the exact source head (`faed5f5`; [review](https://github.com/Valpatel/gyropup/pull/67#pullrequestreview-5695909038)). No empty-cache fallback can turn a geometry qualification green.
- [x] Acquire and normalize the exact 91290A113 private STEP and the candidate 90592A085 nut; PR86 binds their supplier files/specifications and checks the bounded support stack. Availability, detailed thread mating and physical fit remain separate.
- [ ] Integrate the reviewed generic rigid-module API, retaining exact instance identities and ordinary bench sequence; do not fuse away attached-fastener identities or use broad collision waivers.
- [x] Use the released v0.4.2 adaptive-volume/source guards in the bounded PR67/86 checks; uncertain/invalid relations fail closed. This resolves the numerical mechanism, not every intended thread mate or a full-service pass. Historical red receipts are preserved.
- [ ] Include all installed neighboring hardware/electrical envelopes in seated/insertion/removal/tool checks. Keep originals, retained bumper, attached external screws, wrong direction, missing holes, wrong screw lengths, too-short lead, blocked latch and unremoved tie as intentional failing variants.
- [ ] Prove insertion and removal independently with actual service prerequisites, explicit stroke, connector release access and no trapped module. A declared prerequisite is not teardown evidence.
- [ ] Specify and check heat-setting tip access, backing wall, PCB solder-side clearance, fastener stack and thread engagement against real hardware.
- [ ] Reconcile board/pilot/drill dimensions, print orientation/material and measurable fit-coupon acceptance; physical board/insert/PCB-hole checks remain unperformed.
- [ ] Renew affected pan-base structural qualification after the opening/anchor change. Preserved bearing surfaces alone do not establish unchanged load paths.
- [ ] Regenerate source-bound public project-authored exports after all above implementation changes, independently inspect them, and keep release_ready/physical_fit_verified false until their separate real-world evidence exists.

The reviewed [supplier audit](../research/supply/turret-carrier-2026-10-29.md) records dated stock indications and source conflicts separately from selected parts. New support inputs and conditional connector/circuit candidates retain their own source records. Continue the complete packaging contract in issue96 before a new circuit/layout generation; do not add invisible board area or ignore the parked connector and straight-wire exits. No other turret/leg redesign is part of this checkpoint.
