Valpatel/gyropup/docs/program/purchases.md

# Purchases: what has actually been ordered

The plans and the Build page list what to buy. This file records what the user has **ordered**, so no one orders a
part twice and the build plans can count on it. Add a row whenever something is ordered or arrives.

| Date | Part | Qty | Seller | Status | For | Notes |
|---|---|---|---|---|---|---|
| 2026-10-27 | RobStride RS-04 actuator | 4 | Seeed Studio (ships from CN) | arrived 2026-11-03 (4); not scanned yet: [inventory](../../hardware/actuators/rs04/inventory.json) | the robot's 4 leg motors; the single-leg rig uses 2 of them first | Ordered 4, not 5: a fifth would have put the whole order on backorder (Seeed had 11 on hand and 80 due 2026-11-14 when last read). **No spare yet**: order a fifth once Seeed's stock is back (issue #22). |
| 2026-10-30 (confirmation date) | Deeahdah PRO 3115-900KV, threaded shaft, [Amazon B0GJNX17YX](https://www.amazon.com/dp/B0GJNX17YX) | Number of packs unknown | Amazon; exact seller not recorded | ordered; arrival not confirmed | turret flywheel motor interface work, [issue #124](https://github.com/Valpatel/gyropup/issues/124) | The owner confirmed this exact previously shared listing. The listing describes four motors per pack; that does not establish the number of packs or motors purchased. Actual order date, delivery date and sample measurements remain unknown. Purchase confirmation does not establish fit with the historical SunnySky mount/hub or authorize powered operation. |
