Valpatel/gyropup/exports/turret/bench/orders/14-the-power-tool-store.md

# Order 14: The Power Tool Store

1 lines, **$259.00** before shipping and tax (whole packs). Prices as the catalogue read them (the date is per line in `catalog/*.json`); check the cart against this sheet. Each line has a backup seller in the last column.

| # | Part | Seller part no. | For | Need | Buy | Each | Line | Backup |
|---|---|---|---|---|---|---|---|---|
| 1 | [DCB609 FLEXVOLT 20V/60V MAX 9.0Ah](https://thepowertoolstore.com/products/dewalt-dcb609) | DCB609 FLEXVOLT 20V/60V MAX 9.0Ah | bench | 1 | 1 | $259.00 | $259.00 | none found |
