Valpatel/gyropup/exports/turret/bench/orders/16-ablenet.md

# Order 16: AbleNet

1 lines, **$75.00** before shipping and tax (whole packs). Prices as the catalogue read them (the date is per line in `catalog/*.json`); check the cart against this sheet. Each line has a backup seller in the last column.

| # | Part | Seller part no. | For | Need | Buy | Each | Line | Backup |
|---|---|---|---|---|---|---|---|---|
| 1 | [Specs IC switch - 1 3/8 in (3.5 cm) momentary button, 3.5 mm mono plug, 6 ft (183 cm) cord](https://www.ablenetinc.com/specs-ic/) | Product Number 10000114 (newsletter: 1000114) | bench | 1 | 1 | $75.00 | $75.00 | [Adafruit Product ID 423 (+ Product ID 2790 plug)](https://www.adafruit.com/product/423) $10.00 (not a drop-in: a foot switch (Adafruit 423, momentary, 250 VAC 10 A) wired to an Adafruit 2790 ) |
