Valpatel/gyropup/exports/turret/bench/orders/17-walmart.md

# Order 17: Walmart

3 lines, **$67.10** before shipping and tax (whole packs). Prices as the catalogue read them (the date is per line in `catalog/*.json`); check the cart against this sheet. Each line has a backup seller in the last column.

| # | Part | Seller part no. | For | Need | Buy | Each | Line | Backup |
|---|---|---|---|---|---|---|---|---|
| 1 | [DeWalt 20 V MAX battery dock adapter, 12 AWG leads (takes a FLEXVOLT pack in its 20 V mode)](https://www.walmart.com/c/kp/dewalt-adapter) | DeWalt 18/20 V MAX battery dock adapter, 12 AWG leads | bench | 1 | 1 | $12.95 | $12.95 | [Etsy (search)](https://www.etsy.com/listing/838361833) $13.50 |
| 2 | [Nerf Rival 60 Accu-Round Refill (Hasbro F5052), 60 official Rival rounds](https://www.walmart.com/c/kp/nerf-rival-balls) | F5052 | ammo | 1 | 1 | $19.99 | $19.99 | [eBay (search)](https://www.ebay.com/p/13055032602) $16.95 |
| 3 | [m-Series Mini ON-OFF battery switch, single circuit, 48 V DC, 275-300 A continuous (D70: the stand's DC power switch, 15 A or more)](https://www.walmart.com/ip/Blue-Sea-6006200-Battery-Switch-Mini-ON-OFF-Black/931742861) | 6006 | bench | 1 | 1 | $34.16 | $34.16 | [NavStore (search)](https://navstore.com/products/blue-sea-6006-m-series-mini-battery-switch-single-circuit-on-off-red-6006) $27.95 |
