Valpatel/gyropup/exports/turret/bench/orders/19-iwiss.md

# Order 19: IWISS

1 lines, **$24.99** before shipping and tax (whole packs). Prices as the catalogue read them (the date is per line in `catalog/*.json`); check the cart against this sheet. Each line has a backup seller in the last column.

| # | Part | Seller part no. | For | Need | Buy | Each | Line | Backup |
|---|---|---|---|---|---|---|---|---|
| 1 | [IWISS IWD-1620 crimper for Deutsch DT size-16 solid contacts, 16-20 AWG (tool)](https://www.iwiss.com/products/iwd-1620-deutsch-size-16-crimper-solid-barrel-contact-circular-connector-contacts-crimping-tool-8-indents-wire-crimper-awg16-20) | IWD-1620 (Shopify variant 40373778415729) | tool | 1 | 1 | $24.99 | $24.99 | [McMaster-Carr 6084T3](https://www.mcmaster.com/6084T3/) $64.98 |
