Valpatel/gyropup/exports/turret/bench/orders/20-fysetc.md

# Order 20: FYSETC

1 lines, **$8.00** before shipping and tax (whole packs). Prices as the catalogue read them (the date is per line in `catalog/*.json`); check the cart against this sheet. Each line has a backup seller in the last column.

| # | Part | Seller part no. | For | Need | Buy | Each | Line | Backup |
|---|---|---|---|---|---|---|---|---|
| 1 | [UCAN Board Based on STM32F072 USB to CAN Adapter Support with CAnable / CandleLight / Klipper firmware](https://www.fysetc.com/products/fysetc-ucan-board) | MM-U2CAN-0001 (variant 42187830067375) | bench | 1 | 1 | $8.00 | $8.00 | [BIQU / BIGTREETECH 1030000107 (variant 39762747949154, '1 Pc / U2C V2.1 -3 CAN Output')](https://biqu.equipment/products/bigtreetech-ebb36-42-can-bus-u2c-v2-1-klipper-board?variant=39762747949154) $23.99 |
