Valpatel/gyropup/exports/turret/bench/orders/23-newark.md

# Order 23: Newark

2 lines, **$4.04** before shipping and tax (whole packs). Prices as the catalogue read them (the date is per line in `catalog/*.json`); check the cart against this sheet. Each line has a backup seller in the last column.

| # | Part | Seller part no. | For | Need | Buy | Each | Line | Backup |
|---|---|---|---|---|---|---|---|---|
| 1 | [Resistor 10.0 R 1 % 1/4 W metal film (Yageo MFR-25FBF52)](https://www.newark.com/search?st=MFR-25FBF52-10R) | 49AK5972 | boards: resistors | 2 | 2 | $0.10 | $0.20 | [Quest Components (search)](https://www.questcomp.com/) $0.07 |
| 2 | [TVS diode 600 W unidirectional, 43.6 V standoff, 70.1 V clamp, DO-15 (P6KE51A)](https://www.newark.com/search?st=P6KE51A) | 99AC4212 | boards: diodes | 3 | 3 | $1.28 | $3.84 | [TME P6KE51A-DIO](https://www.tme.eu/en/details/p6ke51a-dio/) $0.47 |
