Valpatel/gyropup/exports/turret/bench/orders/25-jameco.md

# Order 25: Jameco

1 lines, **$0.99** before shipping and tax (whole packs). Prices as the catalogue read them (the date is per line in `catalog/*.json`); check the cart against this sheet. Each line has a backup seller in the last column.

| # | Part | Seller part no. | For | Need | Buy | Each | Line | Backup |
|---|---|---|---|---|---|---|---|---|
| 1 | [XT60E-M panel-mount plug (male), 2 screw holes](https://www.jameco.com/z/XT60E-M-Amass-XT60-Socket-Male-Terminals-30A-500V-2-Pin-Flanged-for-Panel-Mount_2844431.html) | 2844431 | bench | 1 | 1 | $0.99 | $0.99 | [PyroDrone F3-13155-BLK](https://pyrodrone.com/collections/electronics/products/amass-xt60e-m-mountable-xt60-male-plug-w-mounting-screws-choose-color) $11.99 |
