Valpatel/gyropup/hardware/exports/turret/wiring/parts.md

# The turret's boards, part by part (v0)

Generated by `cad/turret_boards.py` from its COMPONENTS list; the circuit is docs/turret-wiring.md section 3 and the placements are the board pictures beside this file. Resistors are 1/4 W 1 % metal film unless the value says 1 W; "X7R" capacitors are 50 V radial ceramics; "film" capacitors are the timing parts. The catalogue key is the parts list's (exports/turret/bench/bom.json).

## Base board

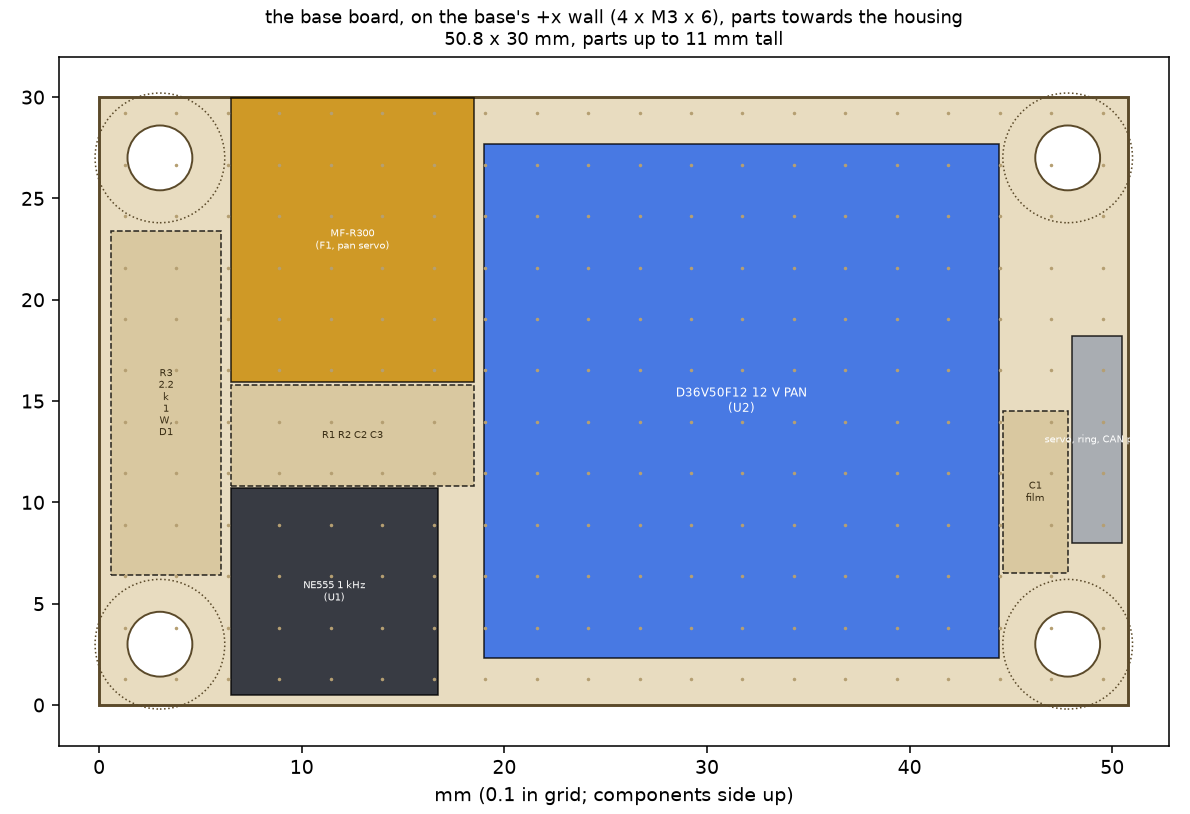
[picture p168: hardware/exports/turret/wiring/board-base.png]
base


| Ref | Value | Part (catalogue key) | Where it goes |
|---|---|---|---|
| U1 | NE555P | `ti-ne555p` | astable: 1.44 / ((R1 + 2 R2) C1) = 986 Hz, 53 %; VCC = the pendant loop (DT12 8), pin 4 to VCC |
| R1 | 1.00 k 1 % | `yageo-mfr-25fbf52-1k` | VCC to pin 7 |
| R2 | 6.8 k 1 % | `yageo-mfr-25fbf52-6k8` | pin 7 to pins 2 and 6 |
| C1 | 100 nF film 5 % | `cap-film-100n-5pct` | pins 2 and 6 to GND: the timing capacitor |
| C2 | 100 nF X7R | `cap-mlcc-100n-50v` | pin 5 (CTRL) to GND |
| C3 | 1 uF X7R | `cap-mlcc-1u-50v` | VCC to GND at pin 8 |
| D1 | 1N4148 | `onsemi-1n4148` | pin 3 (anode) to R3: a BUS fault on the line cannot drive back into the 555 |
| R3 | 2.2 k 1 W | `yageo-rsf100jb-73-2k2` | D1 to ring 7 (SAFETY+); ring 8 (SAFETY-) is the base's GND |
| U2 | D36V50F12 | `pololu-d36v50f12-4095` | 12 V PAN from BUS after the 10 A fuse |
| F1 | MF-R300 | `bourns-mf-r300` | 12 V PAN to the pan servo |

## Bay level 0

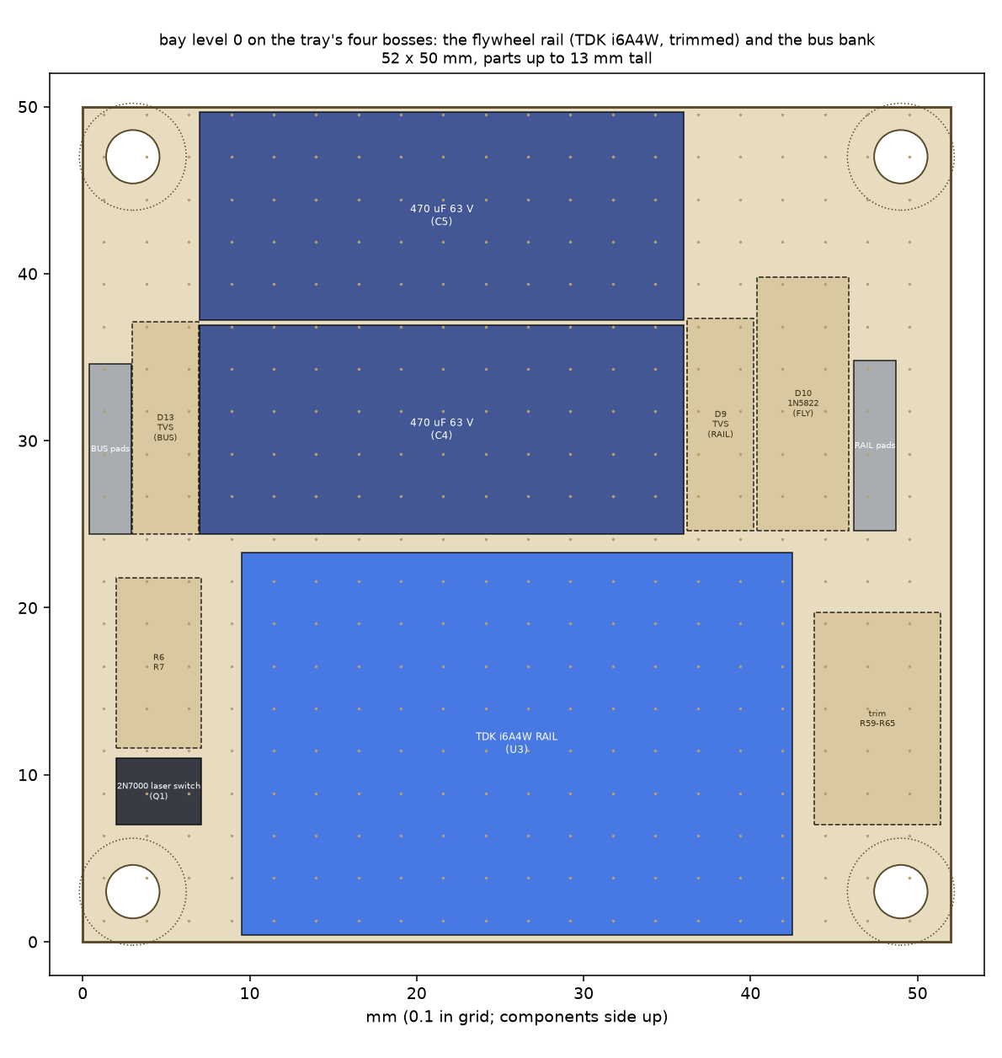
[picture p169: hardware/exports/turret/wiring/board-level0.png]
level0


| Ref | Value | Part (catalogue key) | Where it goes |
|---|---|---|---|
| U3 | i6A4W020A033V-001-R | `tdk-lambda-i6a4w020a033v-001-r` | RAIL, always on: VIN+ (1) BUS, VIN- (3) GND, ON/OFF (2) to VIN- (negative logic: on), VOUT+ (8) and SENSE+ (7) joined at the pins, VOUT- (4) GND, TRIM (6) through R59-R65 to VOUT- (4) |
| R59 | 1.33 k 1 % | `yageo-mfr-25fbf52-1k33` | TRIM (6) to R60: the trim string's fixed part (TDK i6A: Ru = 0.6 x 36.5 k / (Vo - 0.6) - 511 R; 1.53 k for 11.31 V) |
| R60 | 10.0 R 1 % | `yageo-mfr-25fbf52-10r` | in series in the trim string, a solder bridge across it: bridged = 10 R out (the rail up ~0.06 V) |
| R61 | 20.0 R 1 % | `yageo-mfr-25fbf52-20r` | likewise, 20 R |
| R62 | 40.2 R 1 % | `yageo-mfr-25fbf52-40r2` | likewise, 40.2 R |
| R63 | 80.6 R 1 % | `yageo-mfr-25fbf52-80r6` | likewise, 80.6 R |
| R64 | 162 R 1 % | `yageo-mfr-25fbf52-162r` | likewise, 162 R |
| R65 | 324 R 1 % | `yageo-mfr-25fbf52-324r` | likewise, 324 R; its far end to VOUT- (4). Bench test 4.1 starts with no bridge (1.97 k: ~9.5 V) and bridges from the largest down until the faster motor, warm, turns at or under 15,722 rpm; then the bridges are sealed (conformal coat) |
| C4 | 470 uF 63 V low ESR | `panasonic-eeu-fr1j471b` | BUS to GND at U3's VIN pins (TDK: 100 uF at the input) |
| C5 | 470 uF 63 V low ESR | `panasonic-eeu-fr1j471b` | BUS to GND |
| D13 | P6KE51A | `tvs-p6ke51a` | across BUS and GND at the BUS pads (cathode to BUS): 43.6 V standoff, 48.5-53.6 V breakdown |
| Q1 | 2N7000 | `onsemi-2n7000` | the laser's low side: drain to the laser's -, source GND; the laser's + on 5 V |
| R6 | 100 R | `yageo-mfr-25fbf52-100r` | LASER_5V (U11 2Y, level 2) to Q1's gate |
| R7 | 100 k | `yageo-mfr-25fbf52-100k` | Q1's gate to GND |
| D9 | P6KE15A | `tvs-p6ke15a` | across RAIL and GND (cathode to RAIL): the 2815's input (12.8 V standoff over the 11.9 V top of the trim) |
| D10 | 1N5822 | `schottky-1n5822` | across FLY and GND (cathode to FLY): the 2815's output when it opens on a running load |

## Bay level 1

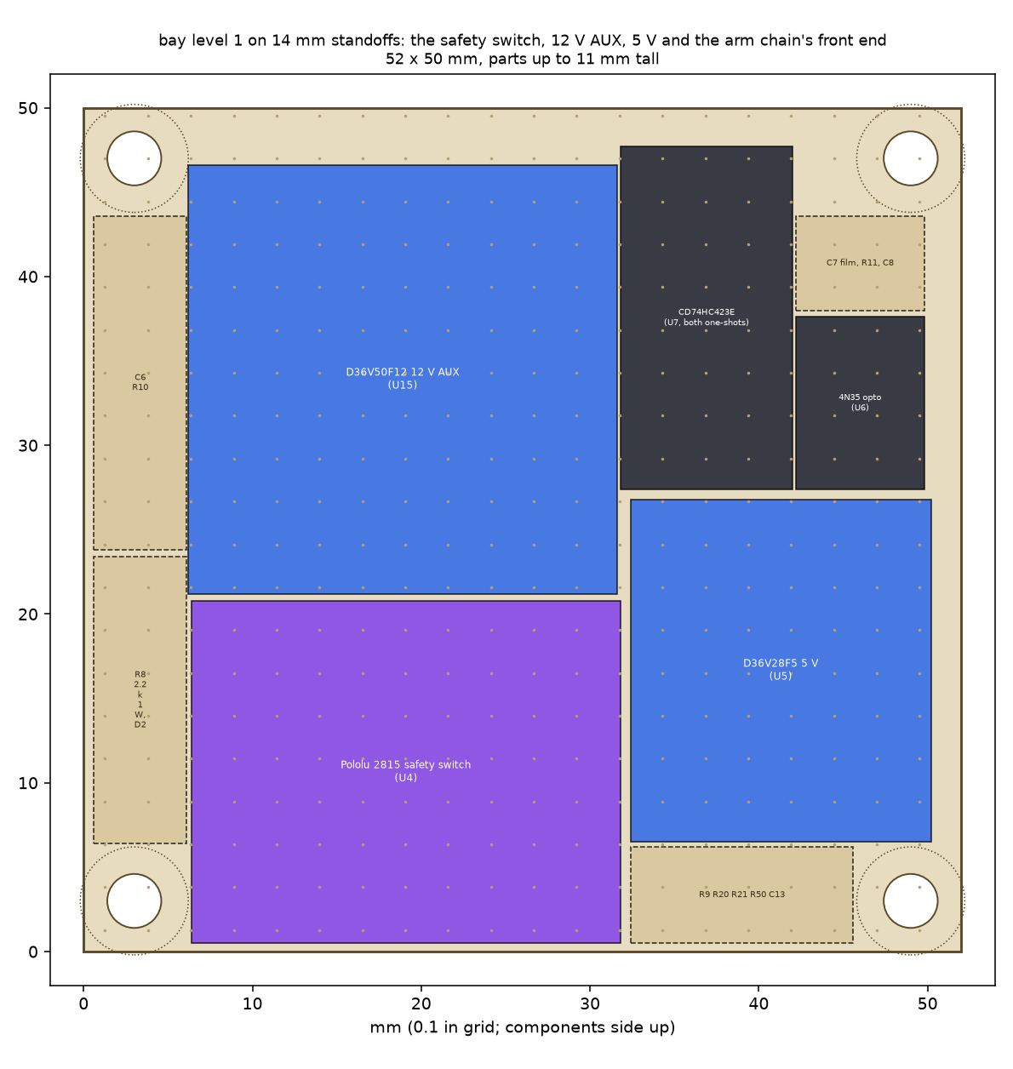
[picture p170: hardware/exports/turret/wiring/board-level1.png]
level1


| Ref | Value | Part (catalogue key) | Where it goes |
|---|---|---|---|
| U4 | Pololu 2815 | `pololu-2815` | RAIL in, FLY out, ON = ARM; the slide switch OFF (glue it there). On RAIL (<= 11.9 V), never on BUS: its 32 V maximum |
| U5 | D36V28F5 | `pololu-d36v28f5-3782` | 5 V from BUS (5.3-50 V in) |
| U15 | D36V50F12 | `pololu-d36v50f12-4095` | 12 V AUX from BUS (50 V max): the tilt servo, through an MF-R300 in its lead |
| F2 | MF-R250 | `bourns-mf-r250` | in line in the 5 V |
| U6 | 4N35 | `vishay-4n35` | pin 1 (anode) from R8, pin 2 (cathode) to ring 8; pin 5 (collector) = PULSE; pin 4 (emitter) GND; pin 6 open |
| R8 | 2.2 k 1 W | `yageo-rsf100jb-73-2k2` | ring 7 (SAFETY+) to U6 pin 1: a BUS fault on the line drives a steady 6-19 mA (0.76 W in R8 at 42 V), so no edges |
| D2 | 1N4148 | `onsemi-1n4148` | across U6's LED reversed (anode at pin 2): the LED never sees a reverse voltage |
| R9 | 39 k | `yageo-mfr-25fbf52-39k` | PULSE to 3.3 V (0.085 mA: the 4N35 at 2 mA sinks over 0.36 mA even hot) |
| R50 | 100 k | `yageo-mfr-25fbf52-100k` | PULSE to the Feather's A3 (PULSE_MON): the Feather can read PULSE but not drive it |
| U7 | CD74HC423E | `ti-cd74hc423e` | on 3.3 V. 1A (1) = PULSE, 1B (2) = 3.3 V, 1/R (3) = /CLR_PU, 1Q (13) = Q_A; 2A (9) = GND, 2B (10) = GATE_1, 2/R (11) = 3.3 V, 2Q (5) = Q_B. The 423 (not the 123): a rising /R never triggers it |
| R10 | 39 k 1 % | `yageo-mfr-25fbf52-39k` | 3.3 V to pin 15: one-shot A, K x 39 k x 1 uF = 18.5 ms (16-21 ms; K = 0.475 at 3.3 V) |
| C6 | 1 uF X7R | `cap-mlcc-1u-50v` | pin 14 to pin 15 |
| R11 | 63.4 k 1 % (from 60.4-73.2 k) | `yageo-mfr-25fbf52-63k4` | 3.3 V to pin 7: one-shot B, 0.475 x 63.4 k x 100 nF = 3.01 ms (bench test 3.3 picks it) |
| R11a | 60.4 k 1 % | `yageo-mfr-25fbf52-60k4` | one-shot B's choice, bench test 3.3 |
| R11b | 66.5 k 1 % | `yageo-mfr-25fbf52-66k5` | one-shot B's choice |
| R11c | 69.8 k 1 % | `yageo-mfr-25fbf52-69k8` | one-shot B's choice |
| R11d | 73.2 k 1 % | `yageo-mfr-25fbf52-73k2` | one-shot B's choice |
| C7 | 100 nF film 5 % | `cap-film-100n-5pct` | pin 6 to pin 7 |
| C8 | 100 nF X7R | `cap-mlcc-100n-50v` | U7 pin 16 to pin 8 |
| R20 | 182 k 1 % | `yageo-mfr-25fbf52-182k` | BUS to BUS_V |
| R21 | 10 k | `yageo-mfr-25fbf52-10k` | BUS_V to GND (19.2 : 1 to the Feather's A0: 0.78 V at 15 V, 2.19 V at 42 V, 2.81 V at D66's 54 V) |
| C13 | 100 nF X7R | `cap-mlcc-100n-50v` | across R21 |

## Bay level 2

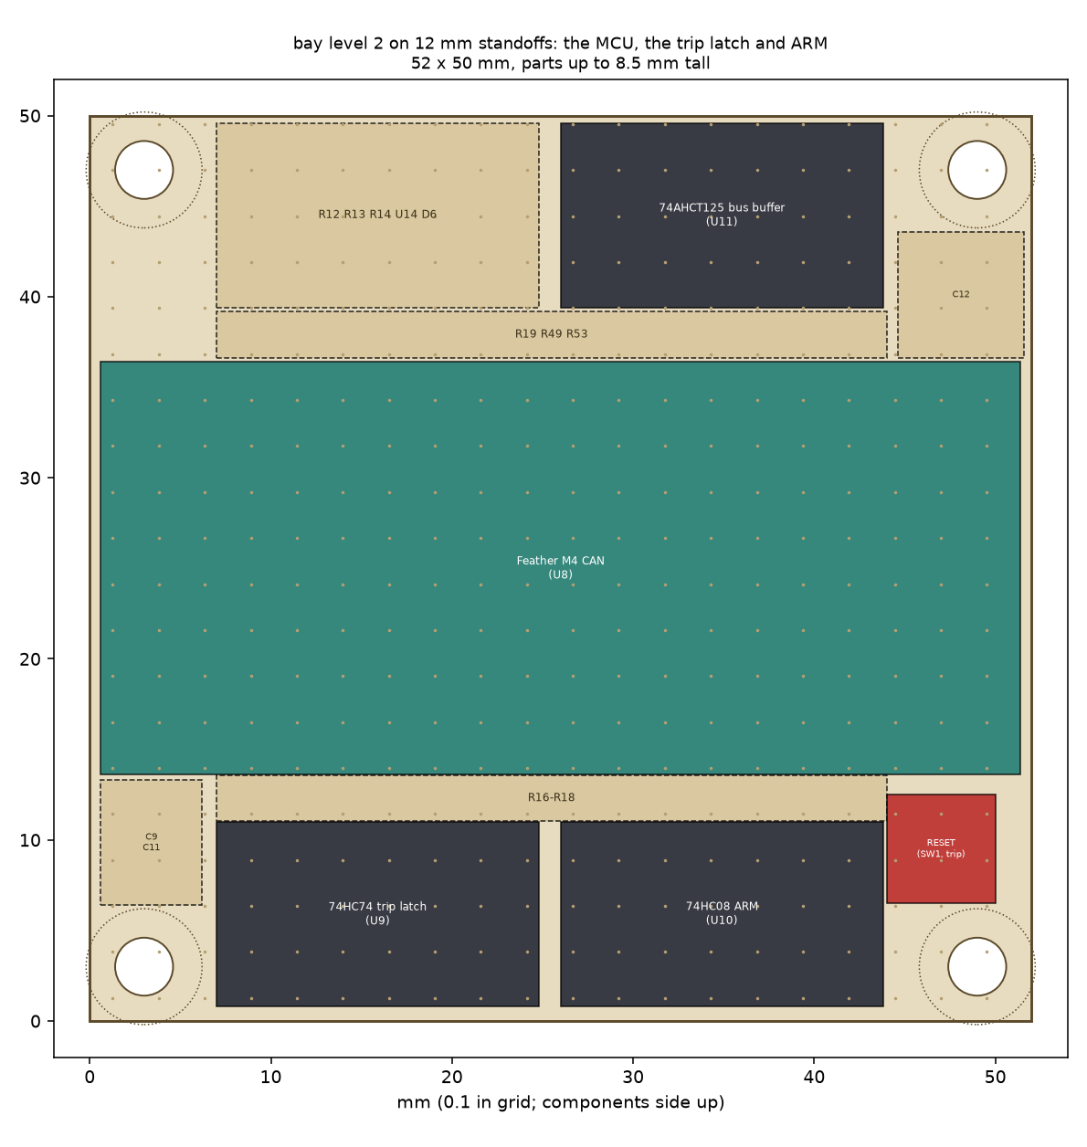
[picture p171: hardware/exports/turret/wiring/board-level2.png]
level2


| Ref | Value | Part (catalogue key) | Where it goes |
|---|---|---|---|
| U8 | Feather M4 CAN | `adafruit-feather-m4-can-4759` | USB pin from 5 V through D7; 3V pin = the logic's 3.3 V (U7, U9, U10, U14 and the pull-ups); CAN to ring 5/6 (its own 120 R) |
| U9 | SN74HC74N | `ti-sn74hc74n` | on 3.3 V, a set-only latch. 1D (2) = 3.3 V, 1CLK (3) = TRIP_CLK, 1/PRE (4) = 3.3 V, 1/CLR (1) = /CLR_PU, 1Q (5) = TRIP to A1 (TRIP_IN, polled), 1/Q (6) = /TRIP; the second flip-flop's D and CLK to GND, /PRE and /CLR to 3.3 V |
| U10 | SN74HC08N | `ti-sn74hc08n` | on 3.3 V. 1A = Q_A, 1B = /TRIP, 1Y = ARM (to U4 ON, CT signal 5, and D12 through R53); 2A = GATE_2, 2B = Q_B, 2Y = TRIP_CLK (gate 2 while the window is open clocks the latch); 3 and 4: inputs to GND |
| U14 | MCP120 (3.0 V) | `microchip-mcp120` | the power-up reset: VDD 3.3 V, its open-drain output = /CLR_PU, held low until 3.3 V is up |
| R12 | 10 k | `yageo-mfr-25fbf52-10k` | /CLR_PU to 3.3 V (also U7 pin 3) |
| SW1 | B3F-1000 | `omron-b3f-1000` | /CLR_PU to GND: the recessed RESET |
| R53 | 100 k | `yageo-mfr-25fbf52-100k` | ARM to the Feather's D12 (ARM_IN): the Feather can read ARM but not drive it |
| U11 | SN74AHCT125N | `ti-sn74ahct125n` | on 5 V. 1A = TX (D1), 1/OE = SERVO_DIR (D4), 1Y = SERVO_BUS; 2A = LASER_EN (A5), 2/OE = GND, 2Y = LASER_5V to R6 on level 0 (the 2N7000 wants 5 V on its gate: its threshold is up to 3 V); 3 and 4: A to GND, /OE to 5 V |
| R49 | 100 k | `yageo-mfr-25fbf52-100k` | LASER_EN (A5) to GND: the laser stays off while the Feather boots |
| R13 | 10 k | `yageo-mfr-25fbf52-10k` | SERVO_DIR to 3.3 V: the buffer is off until the firmware drives it |
| R14 | 4.7 k | `yageo-mfr-25fbf52-4k7` | SERVO_BUS to 5 V |
| D6 | BAT85 | `vishay-bat85` | RX (D0, anode) to SERVO_BUS (cathode): the bus pulls RX low; a high bus (3.3 or 5 V) leaves R16's 3.3 V |
| R16 | 10 k | `yageo-mfr-25fbf52-10k` | RX (D0) to 3.3 V |
| R17 | 1 k | `yageo-mfr-25fbf52-1k` | GATE_1 to 3.3 V (fast edges into the latch's clock and the one-shot) |
| R18 | 1 k | `yageo-mfr-25fbf52-1k` | GATE_2 to 3.3 V |
| R19 | 10 k | `yageo-mfr-25fbf52-10k` | PAN_INDEX to 3.3 V |
| C9 | 100 nF X7R | `cap-mlcc-100n-50v` | U9 decoupling |
| C11 | 100 nF X7R | `cap-mlcc-100n-50v` | U10 decoupling |
| C12 | 100 nF X7R | `cap-mlcc-100n-50v` | U11 decoupling |

## Cartridge board

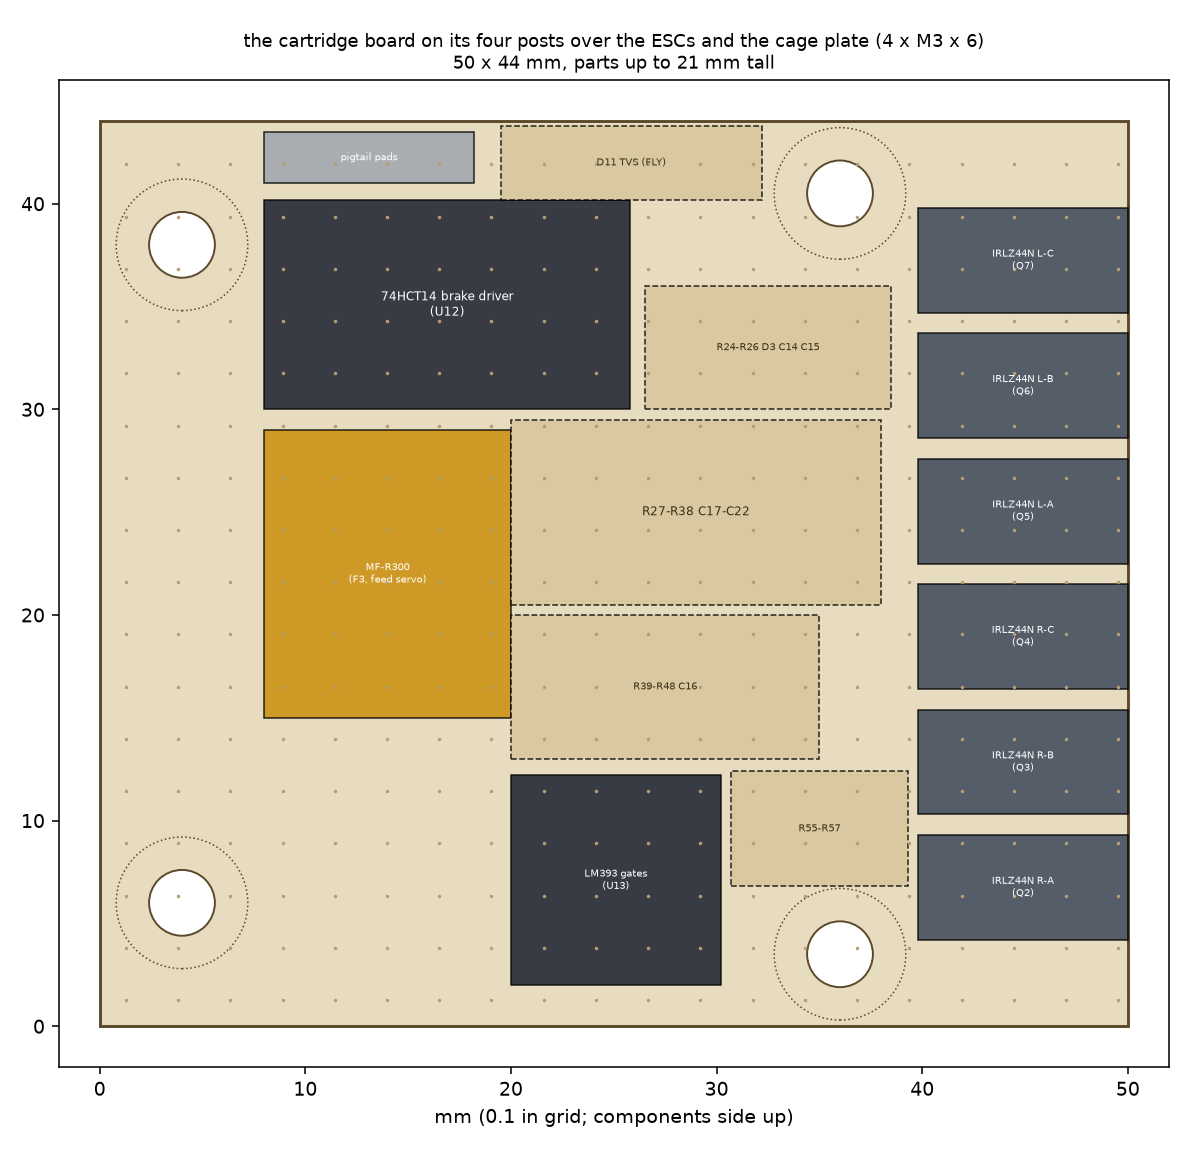
[picture p172: hardware/exports/turret/wiring/board-cartridge.png]
cartridge


| Ref | Value | Part (catalogue key) | Where it goes |
|---|---|---|---|
| U12 | SN74HCT14N | `ti-sn74hct14n` | on 5 V (CT signal 6). 1A, 2A, 3A (1, 3, 5) all = BRK_RC; 1Y, 2Y, 3Y (2, 4, 6) = BRAKE_A, _B, _C, each driving two gates; 4A-6A to GND |
| R24 | 100 k | `yageo-mfr-25fbf52-100k` | ARM (CT signal 5) to GND: unplugged reads as released |
| R25 | 6.8 k | `yageo-mfr-25fbf52-6k8` | ARM to BRK_RC: the delay, 6.8 ms x ln(3.3 / V_T-) = 5-14 ms |
| D3 | 1N4148 | `onsemi-1n4148` | anode at ARM, in series with R26 to BRK_RC: the release |
| R26 | 1 k | `yageo-mfr-25fbf52-1k` | D3 to BRK_RC (the short opens 0.6-1.4 ms after ARM rises) |
| C15 | 1 uF X7R | `cap-mlcc-1u-50v` | BRK_RC to GND |
| C14 | 100 nF X7R | `cap-mlcc-100n-50v` | U12 decoupling |
| D11 | P6KE15A | `tvs-p6ke15a` | across FLY and GND at the pigtail pads (cathode to FLY) |
| R55 | 1 k | `yageo-mfr-25fbf52-1k` | ESC_L (CT signal 1) to the left ESC's signal lead |
| R56 | 1 k | `yageo-mfr-25fbf52-1k` | ESC_R (CT signal 2) to the right ESC's signal lead |
| R57 | 1 k | `yageo-mfr-25fbf52-1k` | FEED_TTL (CT signal 3) to the feed servo's signal: an unpowered servo is not fed from the bus |
| Q2 | IRLZ44N | `infineon-irlz44npbf` | drain to the right motor's phase A, source GND |
| Q3 | IRLZ44N | `infineon-irlz44npbf` | drain to the right motor's phase B, source GND |
| Q4 | IRLZ44N | `infineon-irlz44npbf` | drain to the right motor's phase C, source GND |
| Q5 | IRLZ44N | `infineon-irlz44npbf` | drain to the left motor's phase A, source GND |
| Q6 | IRLZ44N | `infineon-irlz44npbf` | drain to the left motor's phase B, source GND |
| Q7 | IRLZ44N | `infineon-irlz44npbf` | drain to the left motor's phase C, source GND |
| R27 | 1 k | `yageo-mfr-25fbf52-1k` | BRAKE_A to Q2's gate |
| R28 | 1 k | `yageo-mfr-25fbf52-1k` | BRAKE_A to Q3's gate |
| R29 | 1 k | `yageo-mfr-25fbf52-1k` | BRAKE_B to Q4's gate |
| R30 | 1 k | `yageo-mfr-25fbf52-1k` | BRAKE_B to Q5's gate |
| R31 | 1 k | `yageo-mfr-25fbf52-1k` | BRAKE_C to Q6's gate |
| R32 | 1 k | `yageo-mfr-25fbf52-1k` | BRAKE_C to Q7's gate |
| R33 | 100 k | `yageo-mfr-25fbf52-100k` | Q2's gate to GND |
| R34 | 100 k | `yageo-mfr-25fbf52-100k` | Q3's gate to GND |
| R35 | 100 k | `yageo-mfr-25fbf52-100k` | Q4's gate to GND |
| R36 | 100 k | `yageo-mfr-25fbf52-100k` | Q5's gate to GND |
| R37 | 100 k | `yageo-mfr-25fbf52-100k` | Q6's gate to GND |
| R38 | 100 k | `yageo-mfr-25fbf52-100k` | Q7's gate to GND |
| C17 | 100 nF X7R | `cap-mlcc-100n-50v` | Q2's gate to source: the ESC's phase edges cannot lift the gate |
| C18 | 100 nF X7R | `cap-mlcc-100n-50v` | Q3's gate to source: the ESC's phase edges cannot lift the gate |
| C19 | 100 nF X7R | `cap-mlcc-100n-50v` | Q4's gate to source: the ESC's phase edges cannot lift the gate |
| C20 | 100 nF X7R | `cap-mlcc-100n-50v` | Q5's gate to source: the ESC's phase edges cannot lift the gate |
| C21 | 100 nF X7R | `cap-mlcc-100n-50v` | Q6's gate to source: the ESC's phase edges cannot lift the gate |
| C22 | 100 nF X7R | `cap-mlcc-100n-50v` | Q7's gate to source: the ESC's phase edges cannot lift the gate |
| F3 | MF-R300 | `bourns-mf-r300` | FLY to the feed servo |
| D4 | TSAL4400 | `vishay-tsal4400` | gate 1's emitter: anode from R39, cathode GND |
| D5 | TSAL4400 | `vishay-tsal4400` | gate 2's emitter |
| R39 | 100 R | `yageo-mfr-25fbf52-100r` | 5 V to D4 (37 mA) |
| R40 | 100 R | `yageo-mfr-25fbf52-100r` | 5 V to D5 |
| Q8 | TEFT4300 | `vishay-teft4300` | gate 1's receiver: collector to R41 and R43, emitter GND |
| Q9 | TEFT4300 | `vishay-teft4300` | gate 2's receiver |
| R41 | 10 k | `yageo-mfr-25fbf52-10k` | 5 V to Q8's collector (39 k if bench test 3.10's clear level stays over 1 V) |
| R42 | 10 k | `yageo-mfr-25fbf52-10k` | 5 V to Q9's collector (likewise) |
| R41a | 39 k | `yageo-mfr-25fbf52-39k` | R41's alternate, bench test 3.10 (D51: in the first order) |
| R42a | 39 k | `yageo-mfr-25fbf52-39k` | R42's alternate, bench test 3.10 |
| U13 | LM393P | `ti-lm393p` | on 5 V. IN+ (3, 5) from the collectors through R43/R44, IN- (2, 6) = REF; OUT (1, 7) = GATE_1, GATE_2 (open collector) |
| R43 | 10 k | `yageo-mfr-25fbf52-10k` | Q8's collector to U13 pin 3 |
| R44 | 10 k | `yageo-mfr-25fbf52-10k` | Q9's collector to U13 pin 5 |
| R45 | 10 k | `yageo-mfr-25fbf52-10k` | 5 V to REF |
| R46 | 10 k | `yageo-mfr-25fbf52-10k` | REF to GND (2.5 V) |
| R47 | 100 k | `yageo-mfr-25fbf52-100k` | U13 pin 1 to pin 3: 0.3 V of hysteresis |
| R48 | 100 k | `yageo-mfr-25fbf52-100k` | U13 pin 7 to pin 5 |
| C16 | 100 nF X7R | `cap-mlcc-100n-50v` | U13 decoupling |

## In the harness (soldered in line, heat-shrunk)

| Ref | Value | Part (catalogue key) | Where it goes |
|---|---|---|---|
| F4 | MF-R010 | `bourns-mf-r010` | in line in the wire from the base board's 12 V PAN to DT12 7 (the pendant loop out), heat-shrunk: a short of the loop to GND trips it |
| D8 | 1N5408 | `diode-1n5408g` | across BUS and GND right after the 10 A in-line fuse, at the base board's input pads (cathode to BUS): a reversed supply blows the fuse (1000 V, 200 A surge; the 1N5822 it replaces is a 40 V part) |
| D14 | P6KE51A | `tvs-p6ke51a` | across BUS and GND beside D8 at the base board's input pads (cathode to BUS): clamps a bus spike before U2 (50 V max) |
| D7 | 1N5817 | `schottky-1n5817` | in line in the 5 V wire to the Feather's USB pin (anode at the 5 V, cathode at the USB pin), heat-shrunk: a laptop on the USB-C port and the turret's 5 V never feed each other |
| C23 | 100 nF X7R | `cap-mlcc-100n-50v` | across the A1120's VCC and GND at the sensor, on its leads |
