Valpatel/gyropup/hardware/exports/turret/bench/orders/10-mcmaster-carr.md

# Order 10: McMaster-Carr

39 lines, **$513.58** before shipping and tax (whole packs). Prices as the catalogue read them (the date is per line in `catalog/*.json`); check the cart against this sheet. Each line has a backup seller in the last column.

| # | Part | Seller part no. | For | Need | Buy | Each | Line | Backup |
|---|---|---|---|---|---|---|---|---|
| 1 | [18-8 Stainless Steel Hex-Drive Flat Head Screw, M2 x 0.4 mm Thread Size, 6 mm Long](https://www.mcmaster.com/92125A052/) | 92125A052 | flat m2x6 | 4 | 1 x 50 | $0.24 | $12.00 | [Metric Specialties 2C6MXF2](https://metricspecialties.com/products/2c6mxf2) $0.07 |
| 2 | [18-8 Stainless Steel Hex-Drive Flat Head Screw, M3 x 0.5 mm Thread Size, 14 mm Long](https://www.mcmaster.com/92125A133/) | 92125A133 | flat m3x14 | 4 | 1 x 100 | $0.11 | $10.65 | [Belmetric SF3X14CLZ](https://belmetric.com/m3x0-5-flat-head-cap-screw-steel-10-9-din-7991/) $0.18 |
| 3 | [18-8 Stainless Steel Oversized Washer, for M3 Screw, 3.2mm ID, 9.0mm OD, 0.7mm to 0.9mm Thick](https://www.mcmaster.com/91116A120/) | 91116A120 | washer m3 large | 3 | 1 x 100 | $0.05 | $4.81 | [Belmetric WFE3X9SS](https://belmetric.com/fender-washer-a2-stainless-din-9021/) $0.08 |
| 4 | [Alloy Steel Shoulder Screws, 6 mm Shoulder Diameter, 12 mm Shoulder Length, M5 x 0.8 mm Thread](https://www.mcmaster.com/92981A101/) | 92981A101 | shoulder screw | 1 | 1 | $2.82 | $2.82 | [Aspen Fasteners ME343-508X12X6-00080](https://www.aspenfasteners.com/m5-0-8-x-12mm-shoulder-6mm-iso-7379-metric-hex-socket-drive-shoulder-screws-class-12-9-steel-plain/) $2.39 |
| 5 | [Aluminum Male-Female Threaded Hex Standoff, 4.5mm Hex, 12mm Long, M3 x 0.50 mm Thread](https://www.mcmaster.com/98952A110/) | 98952A110 | standoff m3x12 | 4 | 4 | $0.83 | $3.32 | [Mouser 761-M2107-3005-AL](https://www.mouser.com/ProductDetail/761-M2107-3005-AL) $0.53 |
| 6 | [Aluminum Male-Female Threaded Hex Standoff, 4.5mm Hex, 14mm Long, M3 x 0.50 mm Thread](https://www.mcmaster.com/98952A112/) | 98952A112 | standoff m3x14 | 4 | 4 | $0.84 | $3.36 | [Mouser 761-M2109-3005-AL](https://www.mouser.com/ProductDetail/761-M2109-3005-AL) $1.42 |
| 7 | [Black-Oxide Alloy Steel Hex-Drive Flat Head Screw, 90 Degree Countersink, M3 x 0.5 mm Thread Size, 10 mm Long](https://www.mcmaster.com/91294A130/) | 91294A130 | flat m3x10 | 3 | 1 x 100 | $0.06 | $6.36 | [Belmetric SF3X10](https://belmetric.com/m3x0-5-flat-head-cap-screw-steel-10-9-din-7991/) $0.18 |
| 8 | [Black-Oxide Alloy Steel Hex-Drive Flat Head Screw, 90 Degree Countersink, M3 x 0.5 mm Thread Size, 6 mm Long](https://www.mcmaster.com/91294A126/) | 91294A126 | flat m3x6 | 2 | 1 x 100 | $0.05 | $5.45 | [Belmetric SF3X6](https://belmetric.com/m3x0-5-flat-head-cap-screw-steel-10-9-din-7991/) $0.18 |
| 9 | [Black-Oxide Alloy Steel Hex-Drive Flat Head Screw, 90 Degree Countersink, M3 x 0.5 mm Thread Size, 8 mm Long](https://www.mcmaster.com/91294A128/) | 91294A128 | flat m3x8 | 4 | 1 x 100 | $0.06 | $5.82 | [Belmetric SF3X8](https://belmetric.com/m3x0-5-flat-head-cap-screw-steel-10-9-din-7991/) $0.18 |
| 10 | [Black-Oxide Alloy Steel Socket Head Screw, M2 x 0.4 mm Thread Size, 20 mm Long](https://www.mcmaster.com/91290A049/) | 91290A049 | screw m2x20 | 4 | 1 x 100 | $0.17 | $16.58 | [The Nutty Company MSHC220](https://www.nutty.com/m2-x-0-4-x-20-socket-head-cap-screw-12-9-din-912-blk-ox/) $0.18 |
| 11 | [Black-Oxide Alloy Steel Socket Head Screw, US Origin, M2 x 0.4 mm Thread Size, 10 mm Long](https://www.mcmaster.com/91290A017/) | 91290A017 | screw m2x10 | 4 | 1 x 100 | $0.16 | $15.89 | [The Nutty Company MSHC210](https://www.nutty.com/m2-x-0-4-x-10-socket-head-cap-screw-12-9-din-912-blk-ox/) $0.13 |
| 12 | [Black-Oxide Alloy Steel Socket Head Screw, US Origin, M3 x 0.5 mm Thread Size, 10 mm Long](https://www.mcmaster.com/91290A115/) | 91290A115 | screw m3x10 | 2 | 1 x 100 | $0.13 | $13.23 | [Belmetric BSH3X10](https://belmetric.com/m3x0-5-socket-head-cap-screw-din-912-class-12-9/) $0.14 |
| 13 | [Black-Oxide Alloy Steel Socket Head Screw, US Origin, M3 x 0.5 mm Thread Size, 16 mm Long](https://www.mcmaster.com/91290A120/) | 91290A120 | screw m3x16 | 4 | 1 x 100 | $0.12 | $12.22 | [Belmetric BSH3X16](https://belmetric.com/m3x0-5-socket-head-cap-screw-din-912-class-12-9/) $0.16 |
| 14 | [Black-Oxide Alloy Steel Socket Head Screw, US Origin, M3 x 0.5 mm Thread Size, 6 mm Long](https://www.mcmaster.com/91290A111/) | 91290A111 | screw m3x6 | 20 | 1 x 100 | $0.12 | $11.59 | [Belmetric BSH3X6](https://belmetric.com/m3x0-5-socket-head-cap-screw-din-912-class-12-9/) $0.12 |
| 15 | [Black-Oxide Alloy Steel Socket Head Screw, US Origin, M3 x 0.5 mm Thread Size, 8 mm Long](https://www.mcmaster.com/91290A113/) | 91290A113 | bench, screw m3x8 | 23 | 1 x 100 | $0.13 | $13.28 | [Belmetric BSH3X8](https://belmetric.com/m3x0-5-socket-head-cap-screw-din-912-class-12-9/) $0.13 |
| 16 | [Black-Oxide Alloy Steel Socket Head Screw, US Origin, M4 x 0.7 mm Thread Size, 10 mm Long](https://www.mcmaster.com/91290A144/) | 91290A144 | screw m4x10 | 4 | 1 x 100 | $0.14 | $13.55 | [Belmetric BSH4X10](https://belmetric.com/m4x0-7-socket-head-cap-screw-din-912-class-12-9/) $0.14 |
| 17 | [Black-Oxide Alloy Steel Socket Head Screw, US Origin, M5 x 0.8 mm Thread Size, 16 mm Long](https://www.mcmaster.com/91290A232/) | 91290A232 | tm screws | 4 | 1 x 100 | $0.17 | $17.27 | [Belmetric BSH5X16](https://belmetric.com/m5x0-8-socket-head-cap-screw-din-912-class-12-9/) $0.17 |
| 18 | [Black-oxide alloy steel socket head screw, M4 x 0.7 x 12 mm](https://www.mcmaster.com/91290A148/) | 91290A148 | screw m4x12 | 4 | 1 x 100 | $0.12 | $12.30 | [McMaster-Carr 91290A150](https://www.mcmaster.com/91290A150/) $14.23 |
| 19 | [Class 10.9 Screw, M3 x 0.5 mm Thread Size, 8 mm Long](https://www.mcmaster.com/91239A113/) | 91239A113 | button m3x8 | 8 | 1 x 100 | $0.10 | $9.82 | [Fastener Superstore 227258](https://www.fastenersuperstore.com/products/227258/button-head-socket-cap-screws) $0.31 |
| 20 | [Continuous-Flex Tpv Rubber Tube for Chemicals, 3/16" ID, 5/16" OD](https://www.mcmaster.com/51225K24/) | 51225K24 | ring coupling | 1 | 1 | $0.62 | $0.62 | [Zoro Zoro Select ZUSA-HT-3487 (Zoro # G8076328)](https://www.zoro.com/zoro-select-tubing-silicone-516-in-id-716-in-od-zusa-ht-3487/i/G8076328/) $12.49 |
| 21 | [Corrosion-Resistant 440C Stainless Steel Ball Bearing, Shielded, Trade No. 126-2Z, for 6 mm Shaft Diameter](https://www.mcmaster.com/7804K112/) | 7804K112 | tilt bearing | 1 | 1 | $8.89 | $8.89 | [Bearings Direct MR126-2RS](https://bearingsdirect.com/mr126-2rs-mini-ball-bearing-6x12x4-sealed-r1260-2rs/) $4.56 |
| 22 | [Dowel Pin, 52100 Alloy Steel, 4 mm Diameter, 8 mm Long](https://www.mcmaster.com/91595A150/) | 91595A150 | dow4x8 | 2 | 1 x 50 | $0.24 | $12.10 | [WDS Components 662-20208](https://www.wdscomponents.com/en-us/4mm-x-8mm-steel-precision-dowel-pin) $0.49 |
| 23 | [Dowel Pin, 52100 Alloy Steel, 5 mm Diameter, 16 mm Long](https://www.mcmaster.com/91595A352/) | 91595A352 | tm dowels | 2 | 1 x 50 | $0.38 | $19.22 | [WDS Components 662-20316](https://www.wdscomponents.com/en-us/5mm-x-16mm-steel-precision-dowel-pin) $0.60 |
| 24 | [External Retaining Ring, for 50 mm OD, Black-Phosphate Spring Steel](https://www.mcmaster.com/98541A167/) | 98541A167 | circlip 50 | 1 | 1 x 5 | $3.10 | $15.50 | [Metric Specialties 50NCRE](https://metricspecialties.com/products/50ncre) $0.71 |
| 25 | [Heat-Set Threaded Inserts for Plastic, Standard, Brass, M3 x 0.5 mm Thread Size, 5.7 mm Installed Length](https://www.mcmaster.com/94459A140/) | 94459A140 | bench, insert m3 | 49 | 1 x 50 | $0.22 | $10.91 | [ruthex RX-M3x5.7 (SKU GE-M3x57-001)](https://www.ruthex.de/products/ruthex-gewindeeinsatz-m3-100-stuck-rx-m3x5-7-messing-gewindebuchsen) |
| 26 | [Heat-Set Threaded Inserts for Plastic, Standard, Brass, M4 x 0.7 mm Thread Size, 6.4 mm Installed Length](https://www.mcmaster.com/94459A160/) | 94459A160 | insert m4 | 9 | 1 x 50 | $0.23 | $11.73 | [ruthex RX-M4x8.1 (SKU GE-M4x81-001)](https://www.ruthex.de/products/ruthex-gewindeeinsatz-m4-50-stuck-rx-m4x8-1-messing-gewindebuchsen) (not a drop-in: NOT drop-in: 8.1 mm long vs McMaster 6.4 mm (1.7 mm longer, needs a deeper boss)) |
| 27 | [High-Strength Steel Nylon-Insert Locknut, Zinc Plated, M5 x 0.8 mm Thread Size](https://www.mcmaster.com/94645A102/) | 94645A102 | hub nuts | 2 | 1 x 100 | $0.16 | $15.66 | [Belmetric NN5CLZ](https://belmetric.com/nylon-locking-nut-class-8-steel-din-985/) $0.09 |
| 28 | [Neodymium Magnet, Magnetized Through Thickness, 1/8" Thick, 3/16" OD](https://www.mcmaster.com/5862K102/) | 5862K102 | index magnet | 1 | 1 | $1.00 | $1.00 | [K&J Magnetics D32-N52](https://www.kjmagnetics.com/d32-n52-neodymium-disc-magnet) $0.35 |
| 29 | [Nylon-Tip 18-8 Stainless Steel Set Screw, M3 x 0.5 mm Thread, 6 mm Long](https://www.mcmaster.com/93285A115/) | 93285A115 | setscrew m3x6 | 4 | 1 x 5 | $3.46 | $17.31 | [Belmetric SS3X6NYTPSS](https://belmetric.com/m3x0-5-nylon-point-allen-set-screw-stainless/) $3.25 |
| 30 | [Oil-Resistant Buna-N O-Ring, 1/16 Fractional Width, Dash Number 006](https://www.mcmaster.com/9452K14/) | 9452K14 | oring ct | 1 | 1 x 100 | $0.03 | $2.79 | [The O-Ring Store LLC B70006](https://www.theoringstore.com/store/index.php?main_page=product_info&products_id=1102) $0.03 |
| 31 | [Steel Raised Knurled-Head Thumb Screw, M4 x 0.7mm Thread Size, 12mm Long](https://www.mcmaster.com/92581A250/) | 92581A250 | ct thumbscrew | 1 | 1 | $4.64 | $4.64 | [Belmetric BTHUMB4X12SS](https://belmetric.com/m4x0-7-thumb-screw-knurled-a2-stainless-din-464-high-type/) $2.46 |
| 32 | [Black-Oxide Alloy Steel Socket Head Screw, US Origin, M2.5 x 0.45 mm Thread Size, 8 mm Long](https://www.mcmaster.com/91290A102/) | 91290A102 | bench | 2 | 1 x 50 | $0.25 | $12.30 | [The Nutty Company MSHC2.58](https://www.nutty.com/m2-5-x-0-45-x-8-socket-head-cap-screw-12-9-din-912-blk-ox/) $0.12 |
| 33 | [Chucking reamer, 5 mm, turned by hand in a tap wrench (tool)](https://www.mcmaster.com/8851A18/) | 8851A18 | tool | 1 | 1 | $26.23 | $26.23 | [McMaster-Carr 2822A37](https://www.mcmaster.com/2822A37/) $106.53 |
| 34 | [Corrosion-Resistant 18-8 Stainless Steel Hex Nut, M2.5 x 0.45 mm Thread Size](https://www.mcmaster.com/91828A113/) | 91828A113 | bench | 2 | 1 x 100 | $0.07 | $7.10 | [Belmetric NR2.5SS](https://belmetric.com/hex-nut-a2-stainless-din-934/) $0.06 |
| 35 | [Dial indicator with a jointed-arm magnetic base (tool)](https://www.mcmaster.com/products/dial-indicators/economy-dial-plunger-variance-indicators-with-jointed-arm-magnetic-base-holder~~/) | 5518N11 | tool | 1 | 1 | $79.62 | $79.62 | [McMaster-Carr 6302N12](https://www.mcmaster.com/products/dial-indicators/economy-dial-plunger-variance-indicators-with-flexible-arm-magnetic-base-holder~~/) $84.93 |
| 36 | [External retaining-ring pliers for a 50 mm ring (tool)](https://www.mcmaster.com/5449A83/) | 5449A83 | tool | 1 | 1 | $37.25 | $37.25 | [McMaster-Carr 5449A82](https://www.mcmaster.com/5449A82/) $33.48 |
| 37 | [Heat-Set Threaded Inserts for Plastic, Standard, Brass, M3 x 0.5 mm Thread Size, 4.3 mm Installed Length](https://www.mcmaster.com/94459A130/) | 94459A130 | bench | 2 | 1 x 50 | $0.22 | $10.91 | [ruthex RX-M3Sx4.0 (SKU GE-M3Sx40-002)](https://www.ruthex.de/products/ruthex-gewindeeinsatz-m3s-100stuck-rx-m3x4-0-short-messing-gewindebuchsen-fur-3d-druck) |
| 38 | [Heat-Set Threaded Inserts for Plastic, Standard, Brass, M5 x 0.8 mm Thread Size, 7.9 mm Installed Length](https://www.mcmaster.com/94459A775/) | 94459A775 | bench | 4 | 1 x 25 | $0.27 | $6.82 | [ruthex RX-M5x9.5 (SKU GE-M5x95-001)](https://www.ruthex.de/products/ruthex-gewindeeinsatz-m5-50-stuck-rx-m5x9-5-messing-gewindebuchsen) (not a drop-in: NOT drop-in: 9.5 mm long vs McMaster 7.9 mm (1.6 mm longer). The short version R) |
| 39 | [Heat-set insert installation tip set, M2-M8, for a Hakko 900M-style iron (tool)](https://www.mcmaster.com/8915N111/) | 8915N111 | tool | 1 | 1 | $22.66 | $22.66 | [McMaster-Carr 97338A140](https://www.mcmaster.com/97338A140/) $74.43 |
