Valpatel/gyropup/hardware/exports/turret/bench/orders/21-rockauto.md

# Order 21: RockAuto

1 lines, **$2.28** before shipping and tax (whole packs). Prices as the catalogue read them (the date is per line in `catalog/*.json`); check the cart against this sheet. Each line has a backup seller in the last column.

| # | Part | Seller part no. | For | Need | Buy | Each | Line | Backup |
|---|---|---|---|---|---|---|---|---|
| 1 | [Bussmann HHM inline MINI fuse holder, 2-30 A (rated 32 V DC: the 58 V fuse does the interrupting; label it "58 V fuses only")](https://www.rockauto.com/en/moreinfo.php?pk=1474944) | HHM | bench | 1 | 1 | $2.28 | $2.28 | [LCSC (search)](https://www.lcsc.com/product-detail/C3207515.html) $0.30 |
