Valpatel/gyropup/hardware/exports/turret/bench/orders/22-lcsc.md

# Order 22: LCSC

2 lines, **$1.43** before shipping and tax (whole packs). Prices as the catalogue read them (the date is per line in `catalog/*.json`); check the cart against this sheet. Each line has a backup seller in the last column.

| # | Part | Seller part no. | For | Need | Buy | Each | Line | Backup |
|---|---|---|---|---|---|---|---|---|
| 1 | [Littelfuse MINI 58V blade fuse 10 A (DDR-120C-24 input, the charge port)](https://www.lcsc.com/product-detail/C207026.html) | C207026 | fuse | 2 | 2 | $0.41 | $0.82 | [LCSC C207027](https://www.lcsc.com/product-detail/C207027.html) $0.66 |
| 2 | [Littelfuse MINI 58V blade fuse 20 A (the RS-04 branches)](https://www.lcsc.com/product-detail/C207028.html) | C207028 | bench | 1 | 1 | $0.61 | $0.61 | [element14 (search)](https://nz.element14.com/littelfuse/0997020-wxn/auto-blade-fuse-2a-58v/dp/2748837) |
