Valpatel/gyropup/hardware/exports/turret/bench/orders/02-sunnysky-usa.md

# Order 2: SunnySky USA

Day one: the flywheel motors (the cartridge is printed after the motor is measured in hand, plan T2).

1 lines, **$49.98** before shipping and tax (whole packs). Prices as the catalogue read them (the date is per line in `catalog/*.json`); check the cart against this sheet. Each line has a backup seller in the last column.

| # | Part | Seller part no. | For | Need | Buy | Each | Line | Backup |
|---|---|---|---|---|---|---|---|---|
| 1 | [SunnySky X2216 1400KV V3 outrunner, short shaft, with its bolt-on prop adapter and X-mount](https://sunnyskyusa.com/products/sunnysky-x2216?variant=27868073427038) | SS-XV3-X2216-S-1400-V3 (variant 27868073427038, '1400 Short') | flywhemotor l, flywhemotor r | 2 | 2 | $24.99 | $49.98 | [ReadyMadeRC SS-XV3-X2216-S-1400-V3 (RMRC 84546, GTIN 680306447800)](https://www.readymaderc.com/products/details/sunnysky-x-series-v3-x2216-brushless-motor-short-shaft-1400kv) $24.99 |
