Valpatel/gyropup/hardware/exports/turret/bench/orders/04-racedayquads.md

# Order 4: RaceDayQuads

Day one, with the Repeat ESCs (D51): the backup AM32 pair, so the first bench hour (plan N10) can pick the pair that returns eRPM.

1 lines, **$62.98** before shipping and tax (whole packs). Prices as the catalogue read them (the date is per line in `catalog/*.json`); check the cart against this sheet. Each line has a backup seller in the last column.

| # | Part | Seller part no. | For | Need | Buy | Each | Line | Backup |
|---|---|---|---|---|---|---|---|---|
| 1 | [Lumenier Razor Pro F4 45A 2-6S AM32 single ESC (the flywheel ESC's backup)](https://www.racedayquads.com/products/lumenier-razor-pro-f4-45a-2-6s-am32-esc) | 22300 (UPC 724376363650) | esc backup pair | 2 | 2 | $31.49 | $62.98 | [GetFPV not read](https://www.getfpv.com/lumenier-razor-pro-f4-45a-2-6s-am32-esc.html) $31.49 |
