Valpatel/gyropup/hardware/exports/turret/bench/orders/05-pololu.md

# Order 5: Pololu

4 lines, **$156.14** before shipping and tax (whole packs). Prices as the catalogue read them (the date is per line in `catalog/*.json`); check the cart against this sheet. Each line has a backup seller in the last column.

| # | Part | Seller part no. | For | Need | Buy | Each | Line | Backup |
|---|---|---|---|---|---|---|---|---|
| 1 | [12V, 4.5A Step-Down Voltage Regulator D36V50F12](https://www.pololu.com/product/4095) | 4095 (D36V50F12) | 12v regulators | 2 | 2 | $39.95 | $79.90 | [Pololu 5577](https://www.pololu.com/product/5577) $47.95 |
| 2 | [5V, 3.2A Step-Down Voltage Regulator D36V28F5](https://www.pololu.com/product/3782) | 3782 (D36V28F5) | 5v regulator | 1 | 1 | $23.95 | $23.95 | [Pololu 2858](https://www.pololu.com/product/2858) $26.95 (not a drop-in: D24V22F5: 2.5 A against 3.2 A, input at most 36 V (fine on 24 V); a different fo) |
| 3 | [Big MOSFET Slide Switch with Reverse Voltage Protection, HP](https://www.pololu.com/product/2815) | 2815 | safety switch | 1 | 1 | $8.49 | $8.49 | [Pololu 2813](https://www.pololu.com/product/2813) $8.95 (not a drop-in: the 2813 Big Pushbutton Power Switch HP: the same HP ratings, but its control is) |
| 4 | [Stranded hook-up wire, 24 AWG UL1007, 60 ft spool](https://www.pololu.com/product/2630) | 2630 | wire 24awg | 4 | 4 | $10.95 | $43.80 | [Digi-Key (search)](https://www.digikey.com/en/products/detail/remington-industries/24UL1007STRKIT/11613669) $31.63 |
