Valpatel/gyropup/hardware/exports/turret/bench/orders/07-sparkfun.md

# Order 7: SparkFun

3 lines, **$56.95** before shipping and tax (whole packs). Prices as the catalogue read them (the date is per line in `catalog/*.json`); check the cart against this sheet. Each line has a backup seller in the last column.

| # | Part | Seller part no. | For | Need | Buy | Each | Line | Backup |
|---|---|---|---|---|---|---|---|---|
| 1 | [Double-sided prototype board 50 x 70 mm, cut to size](https://www.sparkfun.com/protoboard-wombat-pth.html) | PRT-08619 | base board, cartridge board, turret board | 5 | 3 x 2 | $3.62 | $21.75 | [Tayda Electronics (search)](https://www.taydaelectronics.com/double-side-prototyping-board-50x70mm.html) |
| 2 | [Slip Ring - 12 Wire (2A)](https://www.sparkfun.com/products/13065) | ROB-13065 | slip ring | 1 | 1 | $27.95 | $27.95 | [Adafruit 1196](https://www.adafruit.com/product/1196) $19.95 |
| 3 | [Double Side Prototyping Board 50x70mm](https://www.sparkfun.com/protoboard-wombat-pth.html) | PRT-08619 | bench | 1 | 1 | $7.25 | $7.25 | [Tayda Electronics (search)](https://www.taydaelectronics.com/double-side-prototyping-board-50x70mm.html) |
