Valpatel/gyropup/hardware/exports/turret/bench/orders/08-digi-key.md

# Order 8: Digi-Key

31 lines, **$198.71** before shipping and tax (whole packs). Prices as the catalogue read them (the date is per line in `catalog/*.json`); check the cart against this sheet. Each line has a backup seller in the last column.

| # | Part | Seller part no. | For | Need | Buy | Each | Line | Backup |
|---|---|---|---|---|---|---|---|---|
| 1 | [Aluminium electrolytic, 470 uF, 63 V, low ESR (FR), 12.5 x 25 mm radial](https://www.digikey.com/en/products/result?keywords=EEU-FR1J471B) | P15300CT-ND | capacitors | 2 | 2 | $1.54 | $3.08 | [Newark 62W8085](https://www.newark.com/search?st=EEU-FR1J471B) $2.13 |
| 2 | [CONN PLUG HSG 12POS - DT 12-way plug (socket side), key A](https://www.digikey.com/en/products/detail/te-connectivity-deutsch-ict-connectors/DT06-12SA/6566568) | DT06-12SA (+ W12S wedge + 12 x 0462-201-16141 sockets) | dt plug | 1 | 1 | $8.50 | $8.50 | [Chief Enterprises AT06-12SA plug + AW12S wedge + 12 x AT62-201-16141 sockets (Amphenol Sine Systems)](https://www.chiefenterprises.com/amphenol-sine-at06-12sa-12pos-plug-connector) $3.22 |
| 3 | [DT size 16 pin contact, nickel, 14-16 AWG](https://www.digikey.com/en/products/detail/te-connectivity-deutsch-ict-connectors/0460-202-16141/7200926) | 1734-1328-ND | dt pins | 12 | 12 | $0.45 | $5.40 | [Mouser 571-0460-202-16141](https://www.mouser.com/ProductDetail/571-0460-202-16141) $0.45 |
| 4 | [DT wedgelock for the 12-way receptacle](https://www.digikey.com/en/products/detail/te-connectivity-deutsch-ict-connectors/W12P/6566598) | 1734-1034-ND | dt wedge | 1 | 1 | $0.88 | $0.88 | [Mouser 571-W12P-P004](https://www.mouser.com/ProductDetail/571-W12P-P004) $0.88 |
| 5 | [Dual D flip-flop, DIP-14](https://www.digikey.com/en/products/detail/texas-instruments/SN74HC74N/277248) | 296-1602-5-ND | trip latch | 1 | 1 | $1.13 | $1.13 | [Mouser 595-SN74HC74N](https://www.mouser.com/ProductDetail/595-SN74HC74N) $1.11 |
| 6 | [Dual comparator, DIP-8](https://www.digikey.com/en/products/detail/texas-instruments/LM393P/277045) | 296-1398-5-ND | gate comparator | 1 | 1 | $0.53 | $0.53 | [Mouser 595-LM393P](https://www.mouser.com/ProductDetail/595-LM393P) $0.53 |
| 7 | [Hook-up wire 18 AWG stranded PTFE, 600 V, 25 ft](https://www.digikey.com/en/products/detail/remington-industries/18PTFESTRBLA25/11613433) | 18PTFESTRBLA25 (black) / 18PTFESTRRED25 (red) | wire 18awg | 1 | 1 | $64.56 | $64.56 | [Mouser 602-6825-100-02](https://www.mouser.com/ProductDetail/602-6825-100-02) $120.87 |
| 8 | [IR emitting diode 940 nm, T-1 (3 mm)](https://www.digikey.com/en/products/detail/vishay-semiconductor-opto-division/TSAL4400/1681336) | 751-1201-ND | gate emitters | 2 | 2 | $0.48 | $0.96 | [Mouser 782-TSAL4400](https://www.mouser.com/ProductDetail/782-TSAL4400) $0.48 |
| 9 | [Logic-level N-MOSFET 55 V 47 A, TO-220](https://www.digikey.com/en/products/detail/infineon-technologies/IRLZ44NPBF/811808) | IRLZ44NPBF-ND | brake fets | 6 | 6 | $1.80 | $10.80 | [Mouser 942-IRLZ44NPBF](https://www.mouser.com/ProductDetail/942-IRLZ44NPBF) $1.80 |
| 10 | [Micro-Fit 3.0 female crimp terminal, 18 AWG, tin, 8.5 A](https://www.digikey.com/en/products/detail/molex/0430300038/6098602) | WM13070CT-ND | microfit f18 | 8 | 8 | $0.16 | $1.28 | [Mouser 538-43030-0038-LP](https://www.mouser.com/ProductDetail/538-43030-0038-LP) $0.16 |
| 11 | [Micro-Fit 3.0 female crimp terminal, 20-24 AWG, tin](https://www.digikey.com/en/products/detail/molex/0430300001/467796) | WM1837CT-ND | microfit f24 | 14 | 14 | $0.07 | $1.05 | [Mouser 538-43030-0001-CT](https://www.mouser.com/ProductDetail/538-43030-0001-CT) $7.50 |
| 12 | [Micro-Fit 3.0 male crimp terminal, 18 AWG, tin, 8.5 A](https://www.digikey.com/en/products/detail/molex/0430310021/9520956) | WM22521CT-ND | microfit m18 | 8 | 8 | $0.16 | $1.28 | [Mouser 538-43031-0021-LP](https://www.mouser.com/ProductDetail/538-43031-0021-LP) $0.16 |
| 13 | [Micro-Fit 3.0 male crimp terminal, 20-24 AWG, tin](https://www.digikey.com/en/products/detail/molex/0430310001/467798) | WM1841CT-ND | microfit m24 | 40 | 40 | $0.09 | $3.40 | [Mouser 538-43031-0001-CT](https://www.mouser.com/ProductDetail/538-43031-0001-CT) $8.50 |
| 14 | [Micro-Fit 3.0 plug housing, dual row, 10 circuits](https://www.digikey.com/en/products/detail/molex/0430201000/252494) | WM1781-ND | ct signal plug | 1 | 1 | $0.97 | $0.97 | [Mouser 538-43020-1000](https://www.mouser.com/ProductDetail/538-43020-1000) $0.97 |
| 15 | [Micro-Fit 3.0 plug housing, dual row, 12 circuits](https://www.digikey.com/en/products/detail/molex/0430201200/252495) | WM1782-ND | ring plugs | 2 | 2 | $0.82 | $1.64 | [Mouser 538-43020-1200](https://www.mouser.com/ProductDetail/538-43020-1200) $0.82 |
| 16 | [Micro-Fit 3.0 plug housing, dual row, 6 circuits](https://www.digikey.com/en/products/detail/molex/0430200600/252492) | WM1779-ND | ct power plug | 1 | 1 | $0.40 | $0.40 | [Mouser 538-43020-0600](https://www.mouser.com/ProductDetail/538-43020-0600) $0.40 |
| 17 | [Micro-Fit 3.0 receptacle housing, dual row, 10 circuits](https://www.digikey.com/en/products/detail/molex/0430251000/252500) | WM1787-ND | ct signal receptacle | 1 | 1 | $0.75 | $0.75 | [Mouser 538-43025-1000](https://www.mouser.com/ProductDetail/538-43025-1000) $0.75 |
| 18 | [Micro-Fit 3.0 receptacle housing, dual row, 12 circuits](https://www.digikey.com/en/products/detail/molex/0430251200/252501) | WM1788-ND | ring receptacles | 2 | 2 | $0.81 | $1.62 | [Mouser 538-43025-1200](https://www.mouser.com/ProductDetail/538-43025-1200) $0.81 |
| 19 | [Micro-Fit 3.0 receptacle housing, dual row, 6 circuits](https://www.digikey.com/en/products/detail/molex/0430250600/252498) | WM1785-ND | ct power receptacle | 1 | 1 | $0.51 | $0.51 | [Mouser 538-43025-0600](https://www.mouser.com/ProductDetail/538-43025-0600) $0.51 |
| 20 | [N-channel MOSFET 60 V 200 mA, TO-92](https://www.digikey.com/en/products/detail/onsemi/2N7000/244278) | 2N7000FS-ND | laser switch | 1 | 1 | $1.23 | $1.23 | [Mouser 512-2N7000](https://www.mouser.com/ProductDetail/512-2N7000) $1.23 |
| 21 | [Optocoupler, phototransistor output, DIP-6](https://www.digikey.com/en/products/detail/vishay-semiconductor-opto-division/4N35/1738522) | 4N35-ND | opto | 1 | 1 | $1.58 | $1.58 | [Mouser 859-4N35](https://www.mouser.com/ProductDetail/859-4N35) $0.64 |
| 22 | [PTC resettable fuse, 30 V, 2.5 A hold, 5.0 A trip, radial](https://www.digikey.com/en/products/detail/bourns-inc/MF-R250/1232772) | MF-R250-ND | polyfuse 2a | 1 | 1 | $0.49 | $0.49 | [Mouser 652-MFR250](https://www.mouser.com/ProductDetail/652-MFR250) $0.49 |
| 23 | [Precision timer, DIP-8](https://www.digikey.com/en/products/detail/texas-instruments/NE555P/277057) | 296-NE555P-ND | 555 | 1 | 1 | $0.59 | $0.59 | [Mouser 595-NE555P](https://www.mouser.com/ProductDetail/595-NE555P) $0.59 |
| 24 | [Quad 2-input AND, DIP-14](https://www.digikey.com/en/products/detail/texas-instruments/SN74HC08N/277216) | 296-1570-5-ND | and | 1 | 1 | $0.79 | $0.79 | [Mouser 595-SN74HC08N](https://www.mouser.com/ProductDetail/595-SN74HC08N) $0.78 |
| 25 | [Quad buffer, 3-state, TTL inputs, DIP-14](https://www.digikey.com/en/products/detail/texas-instruments/SN74AHCT125N/375798) | 296-4655-5-ND | bus buffer | 1 | 1 | $0.95 | $0.95 | [Mouser 595-SN74AHCT125N](https://www.mouser.com/ProductDetail/595-SN74AHCT125N) $0.98 |
| 26 | [Red dot laser module 650 nm, < 1 mW (Class 2), 2.6-6 V, Ø7 x 22.5 mm](https://www.digikey.com/en/products/detail/quarton-inc/VLM-650-03-LPT/1010454) | VLM-650-03-LPT-ND | laser | 1 | 1 | $25.03 | $25.03 | [Digi-Key VLM-635-03LPT-ND](https://www.digikey.com/en/products/result?keywords=VLM-635-03LPT-ND) $28.91 |
| 27 | [Resettable PTC fuse, 3 A hold, 30 V](https://www.digikey.com/en/products/detail/bourns-inc/MF-R300/259975) | MF-R300-ND | polyfuse 3a | 3 | 3 | $0.50 | $1.50 | [Mouser 652-MFR300](https://www.mouser.com/ProductDetail/652-MFR300) $0.50 |
| 28 | [Silicon NPN phototransistor, T-1 (3 mm)](https://www.digikey.com/en/products/detail/vishay-semiconductor-opto-division/TEFT4300/1681175) | 751-1041-ND | gate receivers | 2 | 2 | $0.70 | $1.40 | [Mouser 782-TEFT4300](https://www.mouser.com/ProductDetail/782-TEFT4300) $0.70 |
| 29 | [Unipolar hall-effect switch, 3-24 V, SIP-3 (UA)](https://www.digikey.com/en/products/detail/allegro-microsystems/A1120LUA-T/2075330) | 620-1330-ND | hall switch | 1 | 1 | $1.79 | $1.79 | [Mouser 250-A1120LUA-T](https://www.mouser.com/ProductDetail/250-A1120LUA-T) $1.79 |
| 30 | [i6A4W 250 W non-isolated buck, 9-53 V in, 3.3-15 V out by one trim resistor, 20 A (1/16 brick, horizontal through-hole)](https://www.digikey.com/en/ptm/t/tdk-lambda-americas-inc/i6a-series-of-non-isolated-dc-dc-converters) | I6A4W020A033V-001-R | flywheregulator | 1 | 1 | $47.46 | $47.46 | [Newark 81Y1493](https://www.newark.com/tdk-lambda/i6a4w020a033v-001-r/dc-dc-converter-3-3v-to-40v-20a/dp/81Y1493) $40.32 |
| 31 | [FUSE HLDR CART 250V 10A PNL MNT - 345 series shock-safe panel holder, 5 x 20 mm, low-profile body, screwdriver-slot knob, 3/16 in right-angle dual-purpose solder/QC terminals](https://www.digikey.com/en/products/detail/littelfuse-inc/03455LS1H/553826) | 03455LS1H | bench | 1 | 1 | $7.16 | $7.16 | [LCSC 03455LS1HX020 (Littelfuse; LCSC C206937)](https://www.lcsc.com/product-detail/C206937.html) $1.40 (not a drop-in: Same 345-series holder as the primary (the page does not explain the X020 suffix) |
