Valpatel/gyropup/hardware/exports/turret/bench/orders/09-mouser.md

# Order 9: Mouser

41 lines, **$89.09** before shipping and tax (whole packs). Prices as the catalogue read them (the date is per line in `catalog/*.json`); check the cart against this sheet. Each line has a backup seller in the last column.

| # | Part | Seller part no. | For | Need | Buy | Each | Line | Backup |
|---|---|---|---|---|---|---|---|---|
| 1 | [Capacitor 1 uF 50 V X7R radial ceramic, 5 mm leads](https://www.mouser.com/ProductDetail/810-FG24X7R1H105KRT6) | 810-FG24X7R1H105KRT6 | boards: capacitors | 4 | 4 | $0.54 | $2.16 | [Digi-Key 445-173374-1-ND](https://www.digikey.com/en/products/detail/tdk/FG24X7R1H105KRT06/5802988) $0.51 |
| 2 | [Capacitor 100 nF 50 V X7R radial ceramic, 2.5 mm leads](https://www.mouser.com/ProductDetail/594-K104K15X7RF53L2) | 594-K104K15X7RF53L2 | boards: capacitors | 18 | 18 | $0.25 | $4.50 | [Digi-Key BC3324-ND](https://www.digikey.com/en/products/detail/vishay-beyschlag-draloric-bc-components/K104K15X7RF53L2/2820506) $0.29 |
| 3 | [Capacitor 100 nF 63 V +-5 % PET film, 5 mm leads](https://www.mouser.com/ProductDetail/WIMA/MKS2-1-63-5/?qs=ISKKXg98%252B1lWN2VQKHfGJg%3D%3D) | 505-MKS2.1/63/5 | boards: capacitors | 3 | 3 | $0.70 | $2.10 | [Newark 46T6775](https://www.newark.com/search?st=46T6775) $0.45 |
| 4 | [DT 12-way receptacle (pin side), key A, grey, flange mount (L012 mod) - LCSC C6423585](https://www.mouser.com/ProductDetail/571-DT04-12PA-L012) | 571-DT04-12PA-L012 | dt receptacle | 1 | 1 | $7.38 | $7.38 | [LCSC C6423585](https://www.lcsc.com/product-detail/C6423585.html) $10.36 |
| 5 | [Diode 1N4148 (DO-35)](https://www.mouser.com/ProductDetail/512-1N4148) | 512-1N4148 | boards: diodes | 4 | 4 | $0.10 | $0.40 | [Digi-Key 1N4148FS-ND](https://www.digikey.com/en/products/detail/onsemi/1N4148/458603) $0.10 |
| 6 | [Dual retriggerable monostable, 74HC423 (no trigger on a rising reset), PDIP-16](https://www.mouser.com/ProductDetail/595-CD74HC423E) | 595-CD74HC423E | monostables | 1 | 1 | $1.25 | $1.25 | [Digi-Key 296-9229-5-ND](https://www.digikey.com/en/products/detail/texas-instruments/CD74HC423E/376955) $1.22 |
| 7 | [Hex Schmitt-trigger inverter SN74HCT14N (DIP-14)](https://www.mouser.com/ProductDetail/595-SN74HCT14N) | 595-SN74HCT14N | brake driver | 1 | 1 | $0.92 | $0.92 | [Digi-Key 296-8394-5-ND](https://digikey.com/product-detail/en/texas-instruments/SN74HCT14N/296-8394-5-ND/376852) $0.87 |
| 8 | [In-line holder for a MINI blade fuse, black leads (MINI FHM series)](https://www.mouser.com/ProductDetail/576-0FHM0001ZXJ) | 576-0FHM0001ZXJ | fuse holder | 1 | 1 | $9.47 | $9.47 | [Digi-Key (search)](https://www.digikey.com/en/products/detail/littelfuse-commercial-vehicle-products/0FHM0001ZXJ/2004060) |
| 9 | [Micro-Fit 3.0 female crimp terminal, tin, 26-30 AWG](https://www.mouser.com/ProductDetail/538-43030-0010) | 538-43030-0010 | microfit f28 | 30 | 30 | $0.20 | $6.00 | [Digi-Key WM1838-ND](https://www.digikey.com/en/products/detail/molex/0430300010/252480) |
| 10 | [Rectifier 3 A 1000 V, DO-201AD (1N5408)](https://www.mouser.com/ProductDetail/863-1N5408G) | 863-1N5408G | boards: diodes | 2 | 2 | $0.58 | $1.16 | [Newark 42K2941](https://www.newark.com/search?st=1N5408G) $0.62 |
| 11 | [Resettable PTC fuse 0.10 A hold, 60 V, radial (MF-R010)](https://www.mouser.com/ProductDetail/652-MFR010) | 652-MFR010 | polyfuse loop | 2 | 2 | $0.33 | $0.66 | [Digi-Key MF-R010-ND](https://www.digikey.com/en/products/detail/bourns-inc/MF-R010/259959) $0.40 |
| 12 | [Resistor 1.00 k 1 % 1/4 W metal film (Yageo MFR-25FBF52)](https://www.mouser.com/ProductDetail/603-MFR-25FBF52-1K) | 603-MFR-25FBF52-1K | boards: resistors | 16 | 16 | $0.10 | $1.60 | [Digi-Key 1.00KXBK-ND](https://www.digikey.com/en/products/detail/yageo/MFR-25FBF52-1K/1.00KXBK-ND/13011) $0.10 |
| 13 | [Resistor 1.33 k 1 % 1/4 W metal film (Yageo MFR-25FBF52)](https://www.mouser.com/ProductDetail/603-MFR-25FBF52-1K33) | 603-MFR-25FBF52-1K33 | boards: resistors | 2 | 2 | $0.10 | $0.20 | [Arrow V99:2348_17668792](https://www.arrow.com/en/products/mfr-25fbf52-1k33/yageo) $0.02 |
| 14 | [Resistor 10 k 1 % 1/4 W metal film (Yageo MFR-25FBF52)](https://www.mouser.com/ProductDetail/603-MFR-25FBF52-10K) | 603-MFR-25FBF52-10K | boards: resistors | 14 | 14 | $0.10 | $1.40 | [Digi-Key 10.0KXBK-ND](https://www.digikey.com/en/products/detail/yageo/MFR-25FBF52-10K/13219) $0.10 |
| 15 | [Resistor 100 R 1 % 1/4 W metal film (Yageo MFR-25FBF52)](https://www.mouser.com/ProductDetail/603-MFR-25FBF52-100R) | 603-MFR-25FBF52-100R | boards: resistors | 4 | 4 | $0.10 | $0.40 | [Digi-Key 100XBK-ND](https://digikey.com/product-detail/en/yageo/MFR-25FBF52-100R/100XBK-ND/12795) |
| 16 | [Resistor 100 k 1 % 1/4 W metal film (Yageo MFR-25FBF52)](https://www.mouser.com/ProductDetail/603-MFR-25FBF52-100K) | 603-MFR-25FBF52-100K | boards: resistors | 16 | 16 | $0.10 | $1.60 | [Digi-Key 100KXBK-ND](https://www.digikey.com/en/products/detail/yageo/MFR-25FBF52-100K/100KXBK-ND/13473) |
| 17 | [Resistor 162 R 1 % 1/4 W metal film (Yageo MFR-25FBF52)](https://www.mouser.com/ProductDetail/603-MFR-25FBF52-162R) | 603-MFR-25FBF52-162R | boards: resistors | 2 | 2 | $0.10 | $0.20 | [Arrow V99:2348_17733694](https://www.arrow.com/en/products/mfr-25fbf52-162r/yageo) $0.02 |
| 18 | [Resistor 182 k 1 % 1/4 W metal film (Yageo MFR-25FBF52)](https://www.mouser.com/ProductDetail/603-MFR-25FBF52-182K) | 603-MFR-25FBF52-182K | boards: resistors | 2 | 2 | $0.10 | $0.20 | [Quest Components (search)](https://www.questcomp.com/) $0.04 |
| 19 | [Resistor 2.2k 1 W 5 % metal oxide (RSF100)](https://www.mouser.com/ProductDetail/603-RSF100JB-73-2K2) | 603-RSF100JB-73-2K2 | boards: resistors | 3 | 3 | $0.20 | $0.60 | [Digi-Key 2.2KW-1-ND](https://www.digikey.com/product-detail/en/yageo/RSF100JB-73-2K2/2.2KW-1-ND/18091) |
| 20 | [Resistor 20.0 R 1 % 1/4 W metal film (Yageo MFR-25FBF52)](https://www.mouser.com/ProductDetail/603-MFR-25FBF52-20R) | 603-MFR-25FBF52-20R | boards: resistors | 2 | 2 | $0.10 | $0.20 | [Arrow V99:2348_17665225](https://www.arrow.com/en/products/mfr-25fbf52-20r/yageo) $0.02 |
| 21 | [Resistor 324 R 1 % 1/4 W metal film (Yageo MFR-25FBF52)](https://www.mouser.com/ProductDetail/603-MFR-25FBF52-324R) | 603-MFR-25FBF52-324R | boards: resistors | 2 | 2 | $0.10 | $0.20 | [Arrow V99:2348_17662115](https://www.arrow.com/en/products/mfr-25fbf52-324r/yageo) $0.02 |
| 22 | [Resistor 39 k 1 % 1/4 W metal film (Yageo MFR-25FBF52)](https://www.mouser.com/ProductDetail/603-MFR-25FBF52-39K) | 603-MFR-25FBF52-39K | boards: resistors | 5 | 5 | $0.10 | $0.50 | [Digi-Key 39.0KXBK-ND](https://www.digikey.com/en/products/result?keywords=MFR-25FBF52-39K) |
| 23 | [Resistor 4.7 k 1 % 1/4 W metal film (Yageo MFR-25FBF52)](https://www.mouser.com/ProductDetail/603-MFR-25FBF52-4K7) | 603-MFR-25FBF52-4K7 | boards: resistors | 2 | 2 | $0.11 | $0.22 | [Digi-Key (search)](https://www.digikey.com/en/products/result?keywords=MFR-25FBF52-4K7) |
| 24 | [Resistor 40.2 R 1 % 1/4 W metal film (Yageo MFR-25FBF52)](https://www.mouser.com/ProductDetail/603-MFR-25FBF52-40R2) | 603-MFR-25FBF52-40R2 | boards: resistors | 2 | 2 | $0.10 | $0.20 | [Quest Components (search)](https://www.questcomp.com/) $0.06 |
| 25 | [Resistor 6.8 k 1 % 1/4 W metal film (Yageo MFR-25FBF52)](https://www.mouser.com/ProductDetail/603-MFR-25FBF52-6K8) | 603-MFR-25FBF52-6K8 | boards: resistors | 3 | 3 | $0.10 | $0.30 | [Digi-Key 13-MFR-25FRF52-6K8CT-ND](https://www.digikey.com/en/products/detail/yageo/MFR-25FRF52-6K8/MFR-25FRF52-6K8-ND/9139107) $0.10 |
| 26 | [Resistor 60.4 k 1 % 1/4 W metal film (Yageo MFR-25FBF52)](https://www.mouser.com/ProductDetail/603-MFR-25FBF52-60K4) | 603-MFR-25FBF52-60K4 | boards: resistors | 2 | 2 | $0.10 | $0.20 | [Digi-Key 60.4KXBK-ND](https://www.digikey.com/en/products/detail/yageo/MFR-25FBF52-60K4/13430) |
| 27 | [Resistor 63.4 k 1 % 1/4 W metal film (Yageo MFR-25FBF52)](https://www.mouser.com/ProductDetail/603-MFR-25FBF52-63K4) | 603-MFR-25FBF52-63K4 | boards: resistors | 2 | 2 | $0.10 | $0.20 | [Digi-Key (search)](https://www.digikey.com/en/products/result?keywords=MFR-25FBF52-63K4) |
| 28 | [Resistor 66.5 k 1 % 1/4 W metal film (Yageo MFR-25FBF52)](https://www.mouser.com/ProductDetail/603-MFR-25FBF52-66K5) | 603-MFR-25FBF52-66K5 | boards: resistors | 2 | 2 | $0.10 | $0.20 | [Digi-Key 66.5KXBK-ND](https://www.digikey.com/product-detail/en/yageo/MFR-25FBF52-66K5/66.5KXBK-ND/13437) |
| 29 | [Resistor 69.8 k 1 % 1/4 W metal film (Yageo MFR-25FBF52)](https://www.mouser.com/ProductDetail/603-MFR-25FBF52-69K8) | 603-MFR-25FBF52-69K8 | boards: resistors | 2 | 2 | $0.10 | $0.20 | [Digi-Key 13-MFR-25FBF52-69K8-ND](https://www.digikey.com/en/products/detail/yageo/MFR-25FBF52-69K8/13442) |
| 30 | [Resistor 73.2 k 1 % 1/4 W metal film (Yageo MFR-25FBF52)](https://www.mouser.com/ProductDetail/603-MFR-25FBF52-73K2) | 603-MFR-25FBF52-73K2 | boards: resistors | 2 | 2 | $0.10 | $0.20 | [Digi-Key 13-MFR-25FBF52-73K2-ND](https://www.digikey.com/en/products/detail/yageo/MFR-25FBF52-73K2/13447) |
| 31 | [Resistor 80.6 R 1 % 1/4 W metal film (Yageo MFR-25FBF52)](https://www.mouser.com/ProductDetail/603-MFR-25FBF52-80R6) | 603-MFR-25FBF52-80R6 | boards: resistors | 2 | 2 | $0.10 | $0.20 | [Digi-Key (search)](https://www.digikey.com/en/products/result?keywords=MFR-25FBF52-80R6) |
| 32 | [Schottky diode 30 V 200 mA, DO-35 (BAT85S)](https://www.mouser.com/ProductDetail/78-BAT85S-TAP) | 78-BAT85S-TAP | boards: diodes | 2 | 2 | $0.50 | $1.00 | [Digi-Key BAT85S-TAPCT-ND](https://www.digikey.com/en/products/result?keywords=BAT85S-TAP) $0.50 |
| 33 | [Schottky rectifier 1 A 20 V, DO-41 (1N5817)](https://www.mouser.com/ProductDetail/621-1N5817) | 621-1N5817 | boards: diodes | 2 | 2 | $0.37 | $0.74 | [Digi-Key 1N5817DICT-ND](https://www.digikey.com/en/products/result?keywords=1N5817-T) $0.37 |
| 34 | [Schottky rectifier 3 A 40 V, DO-201AD (1N5822)](https://www.mouser.com/ProductDetail/863-1N5822G) | 863-1N5822G | boards: diodes | 2 | 2 | $0.83 | $1.66 | [Digi-Key 1N5822-E3/54GICT-ND](https://www.digikey.com/en/products/result?keywords=1N5822-E3%2F54) $0.91 |
| 35 | [TVS diode 600 W unidirectional, 12.8 V standoff, 21.2 V clamp, DO-15 (P6KE15A)](https://www.mouser.com/ProductDetail/625-P6KE15A-E3) | 625-P6KE15A-E3 | boards: diodes | 3 | 3 | $0.96 | $2.88 | [Digi-Key P6KE15A-E3/54GICT-ND](https://www.digikey.com/en/products/result?keywords=P6KE15A-E3%2F54) $0.96 |
| 36 | [Tactile switch 6x6 mm, 4.3 mm, 100 gf (B3F-1000)](https://www.mouser.com/ProductDetail/653-B3F-1000) | 653-B3F-1000 | boards: reset | 2 | 2 | $0.35 | $0.70 | [Digi-Key SW400-ND](https://digikey.com/product-detail/en/B3F-1000/SW400-ND/33150) $0.35 |
| 37 | [Voltage supervisor 2.93 V, open-drain active-low reset, TO-92](https://www.mouser.com/ProductDetail/579-MCP120-300DI/TO) | 579-MCP120-300DI/TO | supervisor | 1 | 1 | $0.60 | $0.60 | [Digi-Key MCP120-300DI/TO-ND](https://www.digikey.com/en/products/detail/microchip-technology/MCP120-300DI-TO/275231) $0.60 |
| 38 | [3M Bumpon SJ5003 - hemisphere, 0.440 in (11.2 mm) diameter x 0.200 in (5.1 mm) high](https://www.mouser.com/ProductDetail/517-SJ-5003BK) | 517-SJ-5003BK | bench | 4 | 1 x 56 | $0.13 | $7.17 | [Digi-Key (search)](https://www.digikey.com/en/products/detail/3m/SJ5003/26770367) |
| 39 | [5 x 20 mm time-lag fuse, 5 A, 500 V AC / 400 V DC (477 series)](https://www.mouser.com/ProductDetail/576-0477005.MXP) | 576-0477005.MXP | bench | 2 | 2 | $1.00 | $2.00 | [Digi-Key (search)](https://www.digikey.com/en/products/detail/littelfuse-inc/0477005-MXP/1979192) |
| 40 | [Mini-XLR 3-pin female cable plug (TA3FLX), latching, cable <= 4.32 mm](https://www.mouser.com/ProductDetail/502-TA3FLX) | 502-TA3FLX | bench | 1 | 1 | $14.22 | $14.22 | [Digi-Key TA3FLX-ND](https://www.digikey.com/en/products/detail/switchcraft-inc/TA3FLX/TA3FLX-ND/1290022) $14.22 |
| 41 | [Mini-XLR 3-pin male panel receptacle (TB3M), latching, keyed](https://www.mouser.com/ProductDetail/502-TB3M) | 502-TB3M | bench | 1 | 1 | $13.10 | $13.10 | [Digi-Key TB3M-ND](https://www.digikey.com/en/products/detail/switchcraft-inc/TB3M/137715) $13.24 |
