Valpatel/gyropup/hardware/exports/turret/bench/orders/11-vxb-bearings.md

# Order 11: VXB Bearings

2 lines, **$74.98** before shipping and tax (whole packs). Prices as the catalogue read them (the date is per line in `catalog/*.json`); check the cart against this sheet. Each line has a backup seller in the last column.

| # | Part | Seller part no. | For | Need | Buy | Each | Line | Backup |
|---|---|---|---|---|---|---|---|---|
| 1 | [6810-2RS Bearing 50x65x7mm - Sealed Ball Bearing - Thin Section (chrome steel)](https://vxb.com/products/6810-2rs-bearing-50x65x7mm-sealed) | Kit7458 (6810-2RS) | pan bearing | 1 | 1 | $24.99 | $24.99 | [McMaster-Carr 6656K229](https://www.mcmaster.com/6656K229/) $33.29 |
| 2 | [USB linker / ESC programming card for AM32 and BLHeli_32 ESCs (tool)](https://vxb.com/products/usb-linker-esc-programming-card-for-am32-bl32-brus) | VXB0FNQW93SR (Shopify variant 48952943968491) | tool | 1 | 1 | $49.99 | $49.99 | [Amazon ASIN B0FNQW93SR](https://www.amazon.com/dp/B0FNQW93SR) |
