Valpatel/gyropup/hardware/exports/turret/bench/orders/12-sendcutsend.md

# Order 12: SendCutSend

Day one: upload the four drawings (two thicknesses) for an instant price; 3-5 days.

4 lines, **$0.00** before shipping and tax (whole packs). Prices as the catalogue read them (the date is per line in `catalog/*.json`); check the cart against this sheet. Each line has a backup seller in the last column.

| # | Part | Seller part no. | For | Need | Buy | Each | Line | Backup |
|---|---|---|---|---|---|---|---|---|
| 1 | [Cradle cheek plate, +y (the servo's side), laser-cut 6061-T6 aluminium 0.125 in, 90 x 62 mm, 9 holes, 4 countersunk](https://sendcutsend.com/materials/6061-t6-aluminum/) | cradle_plate_l.dxf (6061-T6, 0.125 in) | cradle plate l | 1 | 1 |  | instant price on upload | [Xometry cradle_plate_l.dxf, 6061-T6 0.125 in, sheet cutting](https://www.xometry.com/capabilities/sheet-metal-manufacturing/) |
| 2 | [Cradle cheek plate, -y (the pivot's side), laser-cut 6061-T6 aluminium 0.125 in, 90 x 62 mm, 7 holes, 1 tapped M5, 2 countersunk](https://sendcutsend.com/materials/6061-t6-aluminum/) | cradle_plate_r.dxf (6061-T6, 0.125 in) | cradle plate r | 1 | 1 |  | instant price on upload | [Xometry cradle_plate_r.dxf, 6061-T6 0.125 in, sheet cutting](https://www.xometry.com/capabilities/sheet-metal-manufacturing/) |
| 3 | [Pan clamp ring, laser-cut 6061-T6 aluminium 0.125 in, 86 x 87 mm, 7 holes](https://sendcutsend.com/materials/6061-t6-aluminum/) | pan_clamp.dxf (6061-T6, 0.125 in) | pan clamp | 1 | 1 |  | instant price on upload | [Xometry pan_clamp.dxf, 6061-T6 0.125 in, sheet cutting](https://www.xometry.com/capabilities/sheet-metal-manufacturing/) |
| 4 | [Tilt hard-stop lug, laser-cut 6061-T6 aluminium 0.100 in, 24 x 23 mm, 2 holes tapped M3](https://sendcutsend.com/materials/6061-t6-aluminum/) | stop_lug.dxf (6061-T6, 0.100 in) | stop lug | 1 | 1 |  | instant price on upload | [Xometry stop_lug.dxf, 6061-T6 0.100 in, sheet cutting](https://www.xometry.com/capabilities/sheet-metal-manufacturing/) |
