Valpatel/gyropup/hardware/exports/turret/bench/orders/01-waveshare.md

# Order 1: Waveshare

Day one: the three servos are the critical path (Waveshare ships in about 3 business days, then 3-8 working days by UPS/DHL).

2 lines, **$70.96** before shipping and tax (whole packs). Prices as the catalogue read them (the date is per line in `catalog/*.json`); check the cart against this sheet. Each line has a backup seller in the last column.

| # | Part | Seller part no. | For | Need | Buy | Each | Line | Backup |
|---|---|---|---|---|---|---|---|---|
| 1 | [STS3215 / ST3215 12 V 30 kg-cm serial bus servo](https://www.waveshare.com/st3215-servo.htm?sku=22414) | 22414 | feed motor, pan servo, tilt servo | 3 | 3 | $21.99 | $65.97 | [Amazon ASIN B0CFY52HVV](https://www.amazon.com/dp/B0CFY52HVV) $30.99 |
| 2 | [USB / UART adapter for Feetech serial bus servos](https://www.waveshare.com/bus-servo-adapter-a.htm) | 25514 (MPN 'Bus Servo Adapter (A)') | tool | 1 | 1 | $4.99 | $4.99 | [Amazon ASIN B0CJ6TP3TP](https://www.amazon.com/dp/B0CJ6TP3TP) $12.99 |
