Valpatel/gyropup/hardware/exports/turret/bench/orders/03-palm-beach-bots.md

# Order 3: Palm Beach Bots

1 lines, **$49.98** before shipping and tax (whole packs). Prices as the catalogue read them (the date is per line in `catalog/*.json`); check the cart against this sheet. Each line has a backup seller in the last column.

| # | Part | Seller part no. | For | Need | Buy | Each | Line | Backup |
|---|---|---|---|---|---|---|---|---|
| 1 | [AM32 Brushless Drive ESC 35 A (bi-directional)](https://palmbeachbots.com/products/repeat-robotics-am32-brushless-drive-esc-bi-directional) | AM32 Brushless Drive ESC 35 A (bi-directional) | esc l, esc r | 2 | 2 | $24.99 | $49.98 | [Repeat Robotics RR-03-3340 (AM32 35a Single Drive ESC)](https://repeat-robotics.com/products/repeat-am32-drive-esc) $25.00 |
