Valpatel/gyropup/.agents/plans/printable-parts/amended-gyropup-A4.pdf

# Original leg prototype (milestone M3) + The single-leg test rig print queue

Gyropup retained prototype workstreams · Revision: 0b7b5f0c0ef094898259c0b6f8a6ac52cd3a5feb

### Matching parts, all pages: 54 of 54

Original leg, rig, turret and earlier body planning lists. Current front/rear-pack robot manufacturing plan remains incomplete. Checklist marks track parts, not purchased quantities. This list does not qualify fit, strength or a complete robot.

Done | Part ID | Order | Part | Material | Quantity | Grams | Hours | Printed
☐ | print/rig/pod | 1 | pod | petg | 1 | 493 | 19.7 | ☑
☐ | print/rig/dyno_lug_plate | 2 | dyno_lug_plate | petg | 2 | 417 | 16.7 | ☐
☐ | print/leg/stop_sleeve | 3 | stop_sleeve | tpu95 | 4 | 62 | 6.4 | ☐
☐ | print/leg/upper_link | 4 | upper_link | pa6-cf | 2 | 848 | 55.6 | ☐
☐ | print/leg/front_link | 5 | front_link | pa6-cf | 1 | 463 | 30.3 | ☐
☐ | print/leg/wheel_link | 6 | wheel_link | pa6-cf | 1 | 647 | 42.4 | ☐
☐ | print/leg/hip_frame | 7 | hip_frame | pa6-cf | 1 | 1106 | 72.5 | ☐
☐ | print/leg/apex_spacer | 8 | apex_spacer | pa6-cf | 1 | 14 | 0.9 | ☐
☐ | print/rig/bumper_tpu | 9 | bumper_tpu | tpu95 | 4 | 303 | 31 | ☐
☐ | print/rig/coupon_c4_pr2 | 10 | coupon_c4_pr2 | pa6-cf | 2 | 452 | 29.6 | ☐
☐ | print/rig/coupon_c4_today | 11 | coupon_c4_today | pa6-cf | 2 | 402 | 26.3 | ☐
☐ | print/rig/press_cage | 12 | press_cage | petg | 1 | 335 | 13.4 | ☐
☐ | print/rig/dyno_hub | 13 | dyno_hub | petg | 2 | 292 | 11.7 | ☐
☐ | print/rig/coupon_frame_ring_nom | 14 | coupon_frame_ring_nom | pa6-cf | 1 | 177 | 11.6 | ☐
☐ | print/rig/drop_bracket | 15 | drop_bracket | petg | 1 | 199 | 7.9 | ☐
☐ | print/rig/puller_m5 | 16 | puller_m5 | pa6-cf | 3 | 115 | 7.5 | ☐
☐ | print/rig/top_stop_bracket | 17 | top_stop_bracket | petg | 1 | 186 | 7.4 | ☐

Done | Part ID | Order | Part | Material | Quantity | Grams | Hours | Printed
☐ | print/rig/dyno_spider | 18 | dyno_spider | tpu95 | 2 | 68 | 7 | ☐
☐ | print/rig/bumper_cap | 19 | bumper_cap | petg | 4 | 116 | 4.7 | ☐
☐ | print/rig/coupon_c3_sleeved | 20 | coupon_c3_sleeved | pa6-cf | 2 | 67 | 4.4 | ☐
☐ | print/rig/coupon_c3_plain | 21 | coupon_c3_plain | pa6-cf | 2 | 67 | 4.4 | ☐
☐ | print/rig/bumper_base | 22 | bumper_base | petg | 2 | 105 | 4.2 | ☐
☐ | print/rig/sleeve_block | 23 | sleeve_block | pa6-cf | 1 | 53 | 3.5 | ☐
☐ | print/rig/pod_lid | 24 | pod_lid | petg | 1 | 65 | 2.6 | ☐
☐ | print/rig/coupon_c3_wheel | 25 | coupon_c3_wheel | pa6-cf | 2 | 39 | 2.6 | ☐
☐ | print/rig/press_base | 26 | press_base | petg | 1 | 48 | 1.9 | ☐
☐ | print/rig/coupon_frame_pins_m01 | 27 | coupon_frame_pins_m01 | pa6-cf | 1 | 29 | 1.9 | ☐
☐ | print/rig/coupon_frame_pins_nom | 28 | coupon_frame_pins_nom | pa6-cf | 1 | 28 | 1.9 | ☐
☐ | print/rig/coupon_frame_pins_p01 | 29 | coupon_frame_pins_p01 | pa6-cf | 1 | 28 | 1.9 | ☐
☐ | print/rig/tof_arm | 30 | tof_arm | petg | 1 | 46 | 1.8 | ☐
☐ | print/rig/coupon_hub_stub_p01 | 31 | coupon_hub_stub_p01 | pa6-cf | 1 | 27 | 1.8 | ☐
☐ | print/rig/coupon_knee_eye_m01 | 32 | coupon_knee_eye_m01 | pa6-cf | 1 | 25 | 1.7 | ☐
☐ | print/rig/coupon_hub_stub_m01 | 33 | coupon_hub_stub_m01 | pa6-cf | 1 | 26 | 1.7 | ☐
☐ | print/rig/coupon_hub_stub_nom | 34 | coupon_hub_stub_nom | pa6-cf | 1 | 27 | 1.7 | ☐
☐ | print/rig/coupon_frame_ring_m01 | 35 | coupon_frame_ring_m01 | pa6-cf | 1 | 25 | 1.6 | ☐
☐ | print/rig/coupon_frame_ring_p01 | 36 | coupon_frame_ring_p01 | pa6-cf | 1 | 25 | 1.6 | ☐
☐ | print/rig/coupon_knee_eye_nom | 37 | coupon_knee_eye_nom | pa6-cf | 1 | 25 | 1.6 | ☐
☐ | print/rig/coupon_knee_eye_p01 | 38 | coupon_knee_eye_p01 | pa6-cf | 1 | 25 | 1.6 | ☐
☐ | print/rig/coupon_apex_eye_m01 | 39 | coupon_apex_eye_m01 | pa6-cf | 1 | 25 | 1.6 | ☐
☐ | print/rig/coupon_apex_eye_nom | 40 | coupon_apex_eye_nom | pa6-cf | 1 | 25 | 1.6 | ☐
☐ | print/rig/coupon_apex_eye_p01 | 41 | coupon_apex_eye_p01 | pa6-cf | 1 | 25 | 1.6 | ☐

Done | Part ID | Order | Part | Material | Quantity | Grams | Hours | Printed
☐ | print/rig/coupon_hub_face_m01 | 42 | coupon_hub_face_m01 | pa6-cf | 1 | 21 | 1.4 | ☐
☐ | print/rig/coupon_hub_face_nom | 43 | coupon_hub_face_nom | pa6-cf | 1 | 21 | 1.3 | ☐
☐ | print/rig/coupon_hub_face_p01 | 44 | coupon_hub_face_p01 | pa6-cf | 1 | 21 | 1.3 | ☐
☐ | print/rig/press_slider | 45 | press_slider | petg | 1 | 29 | 1.1 | ☐
☐ | print/rig/coupon_knee_boss_m01 | 46 | coupon_knee_boss_m01 | pa6-cf | 1 | 17 | 1.1 | ☐
☐ | print/rig/coupon_knee_boss_nom | 47 | coupon_knee_boss_nom | pa6-cf | 1 | 17 | 1.1 | ☐
☐ | print/rig/coupon_knee_boss_p01 | 48 | coupon_knee_boss_p01 | pa6-cf | 1 | 16 | 1.1 | ☐
☐ | print/rig/sleeve_anvil | 49 | sleeve_anvil | pa6-cf | 1 | 13 | 0.9 | ☐
☐ | print/rig/pendant_clip | 50 | pendant_clip | petg | 1 | 18 | 0.7 | ☐
☐ | print/rig/ballast_spacer | 51 | ballast_spacer | petg | 2 | 17 | 0.7 | ☐
☐ | print/rig/load_cell_mount | 52 | load_cell_mount | petg | 4 | 17 | 0.7 | ☐
☐ | print/rig/bearing_disc | 53 | bearing_disc | pa6-cf | 3 | 6 | 0.4 | ☐
☐ | print/rig/tof_mount | 54 | tof_mount | petg | 1 | 6 | 0.2 | ☐
