Valpatel/gyropup/.agents/plans/printable-parts/amended-gyropup-pending-A4.pdf

# Turret v0 on its bench stand print queue

Gyropup retained prototype workstreams · Revision: 0b7b5f0c0ef094898259c0b6f8a6ac52cd3a5feb

### All parts: 23 of 23

Original leg, rig, turret and earlier body planning lists. Current front/rear-pack robot manufacturing plan remains incomplete. Checklist marks track parts, not purchased quantities. This list does not qualify fit, strength or a complete robot.

Done | Part ID | Order | Part | Material | Quantity | Grams | Hours | Printed
☐ | print/turret/stand_box | 1 | stand_box | petg | 1 | 402 | 16.1 | ☐
☐ | print/turret/cartridge_body | 2 | cartridge_body — Model export pending | pa6-cf | 1 | 169 | 11.1 | ☐
☐ | print/turret/tilt_yoke | 3 | tilt_yoke — Model export pending | pa6-cf | 1 | 126 | 8.3 | ☐
☐ | print/turret/pan_ring | 4 | pan_ring — Model export pending | pa6-cf | 1 | 78 | 5.1 | ☐
☐ | print/turret/pan_base | 5 | pan_base — Model export pending | pa6-cf | 1 | 70 | 4.6 | ☐
☐ | print/turret/stand_bottom | 6 | stand_bottom | petg | 1 | 98 | 3.9 | ☐
☐ | print/turret/cradle | 7 | cradle — Model export pending | pa6-cf | 1 | 48 | 3.1 | ☐
☐ | print/turret/ring_carrier | 8 | ring_carrier — Model export pending | pa6-cf | 1 | 30 | 2 | ☐
☐ | print/turret/dial | 9 | dial — Model export pending | petg | 1 | 22 | 0.9 | ☐
☐ | print/turret/flywheel | 10 | flywheel — Model export pending | pa6-cf | 2 | 12 | 0.8 | ☐
☐ | print/turret/hopper | 11 | hopper — Model export pending | petg | 1 | 20 | 0.8 | ☐
☐ | print/turret/flywheel_tyre | 12 | flywheel_tyre — Model export pending | tpu95 | 2 | 6 | 0.6 | ☐
☐ | print/turret/barrel | 13 | barrel — Model export pending | petg | 1 | 13 | 0.5 | ☐
☐ | print/turret/board_bay | 14 | board_bay — Model export pending | petg | 1 | 13 | 0.5 | ☐
☐ | print/turret/hopper_lid | 15 | hopper_lid — Model export pending | petg | 1 | 12 | 0.5 | ☐
☐ | print/turret/pan_pinion | 16 | pan_pinion — Model export pending | pa6-cf | 1 | 8 | 0.5 | ☐
☐ | print/turret/ring_driver | 17 | ring_driver — Model export pending | pa6-cf | 1 | 8 | 0.5 | ☐

Done | Part ID | Order | Part | Material | Quantity | Grams | Hours | Printed
☐ | print/turret/base_board_carrier | 18 | base_board_carrier — Model export pending | pa6-cf | 1 | 5 | 0.3 | ☐
☐ | print/turret/board_bay_lid | 19 | board_bay_lid — Model export pending | petg | 1 | 6 | 0.3 | ☐
☐ | print/turret/horn_boss | 20 | horn_boss — Model export pending | pa6-cf | 1 | 2 | 0.2 | ☐
☐ | print/turret/pan_spacer | 21 | pan_spacer — Model export pending | pa6-cf | 1 | 3 | 0.2 | ☐
☐ | print/turret/laser_mount | 22 | laser_mount — Model export pending | petg | 1 | 4 | 0.1 | ☐
☐ | print/turret/pivot_spacer | 23 | pivot_spacer — Model export pending | pa6-cf | 1 | 1 | 0.1 | ☐
