Valpatel/gyropup/.agents/plans/printable-parts/amended-shared-A4.pdf

# Assembly parts

### Fixture project · Revision: fixture-v1

### All parts: 75 of 75

### Unqualified fixture

Done | Part ID | Part | Quantity | Cost | Ordered | In hand
☐ | part-001 | Long assembly component 1 with source-specific description | 1 | $2.00 | ☑ | ☐
☐ | part-002 | Long assembly component 2 with source-specific description | 2 | $2.00 | ☑ | ☐
☐ | part-003 | Long assembly component 3 with source-specific description | 3 | $2.00 | ☑ | ☐
☐ | part-004 | Long assembly component 4 with source-specific description | 4 | $2.00 | ☑ | ☐
☐ | part-005 | Long assembly component 5 with source-specific description | 5 | $2.00 | ☑ | ☐
☐ | part-006 | Long assembly component 6 with source-specific description | 6 | $2.00 | ☑ | ☐
☐ | part-007 | Long assembly component 7 with source-specific description | 7 | $2.00 | ☑ | ☐
☐ | part-008 | Long assembly component 8 with source-specific description | 8 | $2.00 | ☑ | ☐
☐ | part-009 | Long assembly component 9 with source-specific description | 9 | $2.00 | ☑ | ☐
☐ | part-010 | Long assembly component 10 with source-specific description | 10 | $2.00 | ☑ | ☐
☐ | part-011 | Long assembly component 11 with source-specific description | 11 | $2.00 | ☑ | ☐
☐ | part-012 | Long assembly component 12 with source-specific description | 12 | $2.00 | ☑ | ☐
☐ | part-013 | Long assembly component 13 with source-specific description | 13 | $2.00 | ☑ | ☐
☐ | part-014 | Long assembly component 14 with source-specific description | 14 | $2.00 | ☑ | ☐
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
☐ | part-057 | Long assembly component 57 with source-specific description | 57 | $2.00 | ☑ | ☐
☐ | part-058 | Long assembly component 58 with source-specific description | 58 | $2.00 | ☑ | ☐
☐ | part-059 | Long assembly component 59 with source-specific description | 59 | $2.00 | ☑ | ☐
☐ | part-060 | Long assembly component 60 with source-specific description | 60 | $2.00 | ☑ | ☐
☐ | part-061 | Long assembly component 61 with source-specific description | 61 | $2.00 | ☑ | ☐
☐ | part-062 | Long assembly component 62 with source-specific description | 62 | $2.00 | ☑ | ☐
☐ | part-063 | Long assembly component 63 with source-specific description | 63 | $2.00 | ☑ | ☐
☐ | part-064 | Long assembly component 64 with source-specific description | 64 | $2.00 | ☑ | ☐
☐ | part-065 | Long assembly component 65 with source-specific description | 65 | $2.00 | ☑ | ☐

Done | Part ID | Part | Quantity | Cost | Ordered | In hand
☐ | part-066 | Long assembly component 66 with source-specific description | 66 | $2.00 | ☑ | ☐
☐ | part-067 | Long assembly component 67 with source-specific description | 67 | $2.00 | ☑ | ☐
☐ | part-068 | Long assembly component 68 with source-specific description | 68 | $2.00 | ☑ | ☐
☐ | part-069 | Long assembly component 69 with source-specific description | 69 | $2.00 | ☑ | ☐
☐ | part-070 | Long assembly component 70 with source-specific description | 70 | $2.00 | ☑ | ☐
☐ | part-071 | Long assembly component 71 with source-specific description | 71 | $2.00 | ☑ | ☐
☐ | part-072 | Long assembly component 72 with source-specific description | 72 | $2.00 | ☑ | ☐
☐ | part-073 | Long assembly component 73 with source-specific description | 73 | $2.00 | ☑ | ☐
☐ | part-074 | Long assembly component 74 with source-specific description | 74 | $2.00 | ☑ | ☐
☐ | part-075 | Long assembly component 75 with source-specific description | 75 | $2.00 | ☑ | ☐
