Valpatel/gyropup/.agents/plans/printable-parts/orders-accepted/orders-matched-A4.pdf

# All orders

Gyropup retained prototype workstreams · Revision: a781e8e1965101d5e2cd40e62bae6cb7040928f1

Matching parts, all pages: 1 of 279 · Search: tapped linear shaft 1 in x 6 in, 1050 steel, 3/8-16 x 3/4 in deep both ends

Original leg, rig, turret and earlier body planning lists. Current front/rear-pack robot manufacturing plan remains incomplete. Checklist marks track parts, not purchased quantities. This list does not qualify fit, strength or a complete robot.

Done | Part ID | Part | Supplier part number | Quantity needed | Unit price | Order cost | Alternates | Ordered | In hand
☐ | buy/ballast_ shaft | Tapped linear shaft 1 in x 6 in, 1050 steel, 3/8-16 x 3/4 in deep both ends | 6649K433 seller's no. 6649K433 McMaster-Carr | 2 | $52.94 | $105.88 | 1 alternate · 1 drop-in DROP-IN McMaster-Carr 4162N31 + 6435K18 collar · $38.42 checked 2026-10-27 | ☑ | ☐
