Valpatel/gyropup/.agents/plans/printable-parts/orders-original/orders-matched-A4.pdf

# All orders

Gyropup retained prototype workstreams · Revision: 0b7b5f0c0ef094898259c0b6f8a6ac52cd3a5feb

Matching parts, all pages: 1 of 279 · Search: tapped linear shaft 1 in x 6 in, 1050 steel, 3/8-16 x 3/4 in deep both ends

Original leg, rig, turret and earlier body planning lists. Current front/rear-pack robot manufacturing plan remains incomplete. Checklist marks track parts, not purchased quantities. This list does not qualify fit, strength or a complete robot.

Done | Part ID | Part | Supplier part number | Quantity needed | Unit price | Order cost | Alternates | Ordered | In hand
☐ | buy/balla st_shaft | Tapped linear shaft 1 in x 6 in, 1050 steel, 3/8-16 x 3/4 in deep both ends | 6649K433seller's no. 6649K433McMaster-Carr | qty2 | each$52.94 | line$105.88 | 1 alternate · 1 drop-inDROP-IN McMaster-Carr 4162N31 + 6435K18 collar · $38.42checked 2026-10-27 | ☑ | ☐
