Valpatel/gyropup/.agents/plans/printable-parts/shared-rich-accepted/rich-A4.pdf

# Annotated procurement list

### Fixture project · Revision: rich-v1

### All parts: 40 of 40

### Model export pending remains a per-part warning

Done | Part ID | Part | Supplier part number | Quantity needed | Unit price | Order cost | Alternates | Ordered | In hand
☐ | rich-001 | Tapped linear shaft with threaded ends and full source-specific assembly description — Model export pending | 6649K433 — primary supplier | 12 — buy 2 packs of 10, cut 4 per length | $9.60 — $0.096 per piece | $19.20 — used $11.52 | See note below | ☑ | ☐

Alternates: Sourcing record 001 — Source alternative retains the recorded procurement limits. Source alternative retains the recorded procurement limits. Source alternative retains the recorded procurement limits. Source alternative retains the recorded procurement limits. Source alternative retains the recorded procurement limits. Source alternative retains the recorded procurement limits. Source alternative retains the recorded procurement limits. Source alternative retains the recorded procurement limits. Source alternative retains the recorded procurement limits. Source alternative retains the recorded procurement limits. Source alternative retains the recorded procurement limits. Source alternative retains the recorded procurement limits. Source alternative retains the recorded procurement limits. Source alternative retains the recorded procurement limits. Source alternative retains the recorded procurement limits.

☐ | rich-002 | Tapped linear shaft with threaded ends and full source-specific
assembly description — Model export pending

6649K433 — primary
supplier

12 — buy

### 2 packs

of 10, cut

### 4 per

length

$9.60
—
$0.096
per
piece

$19.20
—
used
$11.52
See note below | ☑ | ☐

Alternates: Sourcing record 002 — Source alternative retains the recorded procurement limits. Source alternative retains the recorded procurement limits. Source alternative retains the recorded procurement limits. Source alternative retains the recorded procurement limits. Source alternative retains the recorded procurement limits. Source alternative retains the recorded procurement limits. Source alternative retains the recorded procurement limits. Source alternative retains the recorded procurement limits. Source alternative retains the recorded procurement limits. Source alternative retains the recorded procurement limits. Source alternative retains the recorded procurement limits. Source alternative retains the recorded procurement limits. Source alternative retains the recorded procurement limits. Source alternative retains the recorded procurement limits. Source alternative retains the recorded procurement limits.

Done | Part ID | Part | Supplier part number | Quantity needed | Unit price | Order cost | Alternates | Ordered | In hand
☐ | rich-003 | Tapped linear shaft with threaded ends and full source-specific assembly description — Model export pending | 6649K433 — primary supplier | 12 — buy 2 packs of 10, cut 4 per length | $9.60 — $0.096 per piece | $19.20 — used $11.52 | See note below | ☑ | ☐

Alternates: Sourcing record 003 — Source alternative retains the recorded procurement limits. Source alternative retains the recorded procurement limits. Source alternative retains the recorded procurement limits. Source alternative retains the recorded procurement limits. Source alternative retains the recorded procurement limits. Source alternative retains the recorded procurement limits. Source alternative retains the recorded procurement limits. Source alternative retains the recorded procurement limits. Source alternative retains the recorded procurement limits. Source alternative retains the recorded procurement limits. Source alternative retains the recorded procurement limits. Source alternative retains the recorded procurement limits. Source alternative retains the recorded procurement limits. Source alternative retains the recorded procurement limits. Source alternative retains the recorded procurement limits.

☐ | rich-004 | Tapped linear shaft with threaded ends and full source-specific
assembly description — Model export pending

6649K433 — primary
supplier

12 — buy

### 2 packs

of 10, cut

### 4 per

length

$9.60
—
$0.096
per
piece

$19.20
—
used
$11.52
See note below | ☑ | ☐

Alternates: Sourcing record 004 — Source alternative retains the recorded procurement limits. Source alternative retains the recorded procurement limits. Source alternative retains the recorded procurement limits. Source alternative retains the recorded procurement limits. Source alternative retains the recorded procurement limits. Source alternative retains the recorded procurement limits. Source alternative retains the recorded procurement limits. Source alternative retains the recorded procurement limits. Source alternative retains the recorded procurement limits. Source alternative retains the recorded procurement limits. Source alternative retains the recorded procurement limits. Source alternative retains the recorded procurement limits. Source alternative retains the recorded procurement limits. Source alternative retains the recorded procurement limits. Source alternative retains the recorded procurement limits.

☐ | rich-005 | Tapped linear shaft with threaded ends and full source-specific
assembly description — Model export pending

6649K433 — primary
supplier

12 — buy

### 2 packs

of 10, cut

### 4 per

length

$9.60
—
$0.096
per
piece

$19.20
—
used
$11.52
See note below | ☑ | ☐

Alternates: Sourcing record 005 — Source alternative retains the recorded procurement limits. Source alternative retains the recorded procurement limits. Source alternative retains the recorded procurement limits. Source alternative retains the recorded procurement limits. Source alternative retains the recorded procurement limits. Source alternative retains the recorded procurement limits. Source alternative retains the recorded procurement limits. Source alternative retains the recorded procurement limits. Source alternative retains the recorded procurement limits. Source alternative retains the recorded procurement limits. Source alternative retains the recorded procurement limits. Source alternative retains the recorded procurement limits. Source alternative retains the recorded procurement limits. Source alternative retains the recorded procurement limits. Source alternative retains the recorded procurement limits.

| | | number | needed | price | cost
☐ | rich-006 | Tapped linear shaft with threaded ends and full source-specific assembly description — Model export pending | 6649K433 — primary supplier | 12 — buy 2 packs of 10, cut 4 per length | $9.60 — $0.096 per piece | $19.20 — used $11.52 | See note below | ☑ | ☐

Alternates: Sourcing record 006 — Source alternative retains the recorded procurement limits. Source alternative retains the recorded procurement limits. Source alternative retains the recorded procurement limits. Source alternative retains the recorded procurement limits. Source alternative retains the recorded procurement limits. Source alternative retains the recorded procurement limits. Source alternative retains the recorded procurement limits. Source alternative retains the recorded procurement limits. Source alternative retains the recorded procurement limits. Source alternative retains the recorded procurement limits. Source alternative retains the recorded procurement limits. Source alternative retains the recorded procurement limits. Source alternative retains the recorded procurement limits. Source alternative retains the recorded procurement limits. Source alternative retains the recorded procurement limits.

☐ | rich-007 | Tapped linear shaft with threaded ends and full source-specific
assembly description — Model export pending

6649K433 — primary
supplier

12 — buy

### 2 packs

of 10, cut

### 4 per

length

$9.60
—
$0.096
per
piece

$19.20
—
used
$11.52
See note below | ☑ | ☐

Alternates: Sourcing record 007 — Source alternative retains the recorded procurement limits. Source alternative retains the recorded procurement limits. Source alternative retains the recorded procurement limits. Source alternative retains the recorded procurement limits. Source alternative retains the recorded procurement limits. Source alternative retains the recorded procurement limits. Source alternative retains the recorded procurement limits. Source alternative retains the recorded procurement limits. Source alternative retains the recorded procurement limits. Source alternative retains the recorded procurement limits. Source alternative retains the recorded procurement limits. Source alternative retains the recorded procurement limits. Source alternative retains the recorded procurement limits. Source alternative retains the recorded procurement limits. Source alternative retains the recorded procurement limits.

☐ | rich-008 | Tapped linear shaft with threaded ends and full source-specific
assembly description — Model export pending

6649K433 — primary
supplier

12 — buy

### 2 packs

of 10, cut

### 4 per

length

$9.60
—
$0.096
per
piece

$19.20
—
used
$11.52
See note below | ☑ | ☐

Alternates: Sourcing record 008 — Source alternative retains the recorded procurement limits. Source alternative retains the recorded procurement limits. Source alternative retains the recorded procurement limits. Source alternative retains the recorded procurement limits. Source alternative retains the recorded procurement limits. Source alternative retains the recorded procurement limits. Source alternative retains the recorded procurement limits. Source alternative retains the recorded procurement limits. Source alternative retains the recorded procurement limits. Source alternative retains the recorded procurement limits. Source alternative retains the recorded procurement limits. Source alternative retains the recorded procurement limits. Source alternative retains the recorded procurement limits. Source alternative retains the recorded procurement limits. Source alternative retains the recorded procurement limits.

| | | number | needed | price | cost
☐ | rich-009 | Tapped linear shaft with threaded ends and full source-specific assembly description — Model export pending | 6649K433 — primary supplier | 12 — buy 2 packs of 10, cut 4 per length | $9.60 — $0.096 per piece | $19.20 — used $11.52 | See note below | ☑ | ☐

Alternates: Sourcing record 009 — Source alternative retains the recorded procurement limits. Source alternative retains the recorded procurement limits. Source alternative retains the recorded procurement limits. Source alternative retains the recorded procurement limits. Source alternative retains the recorded procurement limits. Source alternative retains the recorded procurement limits. Source alternative retains the recorded procurement limits. Source alternative retains the recorded procurement limits. Source alternative retains the recorded procurement limits. Source alternative retains the recorded procurement limits. Source alternative retains the recorded procurement limits. Source alternative retains the recorded procurement limits. Source alternative retains the recorded procurement limits. Source alternative retains the recorded procurement limits. Source alternative retains the recorded procurement limits.

☐ | rich-010 | Tapped linear shaft with threaded ends and full source-specific
assembly description — Model export pending

6649K433 — primary
supplier

12 — buy

### 2 packs

of 10, cut

### 4 per

length

$9.60
—
$0.096
per
piece

$19.20
—
used
$11.52
See note below | ☑ | ☐

Alternates: Sourcing record 010 — Source alternative retains the recorded procurement limits. Source alternative retains the recorded procurement limits. Source alternative retains the recorded procurement limits. Source alternative retains the recorded procurement limits. Source alternative retains the recorded procurement limits. Source alternative retains the recorded procurement limits. Source alternative retains the recorded procurement limits. Source alternative retains the recorded procurement limits. Source alternative retains the recorded procurement limits. Source alternative retains the recorded procurement limits. Source alternative retains the recorded procurement limits. Source alternative retains the recorded procurement limits. Source alternative retains the recorded procurement limits. Source alternative retains the recorded procurement limits. Source alternative retains the recorded procurement limits.

☐ | rich-011 | Tapped linear shaft with threaded ends and full source-specific
assembly description — Model export pending

6649K433 — primary
supplier

12 — buy

### 2 packs

of 10, cut

### 4 per

length

$9.60
—
$0.096
per
piece

$19.20
—
used
$11.52
See note below | ☑ | ☐

Alternates: Sourcing record 011 — Source alternative retains the recorded procurement limits. Source alternative retains the recorded procurement limits. Source alternative retains the recorded procurement limits. Source alternative retains the recorded procurement limits. Source alternative retains the recorded procurement limits. Source alternative retains the recorded procurement limits. Source alternative retains the recorded procurement limits. Source alternative retains the recorded procurement limits. Source alternative retains the recorded procurement limits. Source alternative retains the recorded procurement limits. Source alternative retains the recorded procurement limits. Source alternative retains the recorded procurement limits. Source alternative retains the recorded procurement limits. Source alternative retains the recorded procurement limits. Source alternative retains the recorded procurement limits.

| | | number | needed | price | cost
☐ | rich-012 | Tapped linear shaft with threaded ends and full source-specific assembly description — Model export pending | 6649K433 — primary supplier | 12 — buy 2 packs of 10, cut 4 per length | $9.60 — $0.096 per piece | $19.20 — used $11.52 | See note below | ☑ | ☐

Alternates: Sourcing record 012 — Source alternative retains the recorded procurement limits. Source alternative retains the recorded procurement limits. Source alternative retains the recorded procurement limits. Source alternative retains the recorded procurement limits. Source alternative retains the recorded procurement limits. Source alternative retains the recorded procurement limits. Source alternative retains the recorded procurement limits. Source alternative retains the recorded procurement limits. Source alternative retains the recorded procurement limits. Source alternative retains the recorded procurement limits. Source alternative retains the recorded procurement limits. Source alternative retains the recorded procurement limits. Source alternative retains the recorded procurement limits. Source alternative retains the recorded procurement limits. Source alternative retains the recorded procurement limits.

☐ | rich-013 | Tapped linear shaft with threaded ends and full source-specific
assembly description — Model export pending

6649K433 — primary
supplier

12 — buy

### 2 packs

of 10, cut

### 4 per

length

$9.60
—
$0.096
per
piece

$19.20
—
used
$11.52
See note below | ☑ | ☐

Alternates: Sourcing record 013 — Source alternative retains the recorded procurement limits. Source alternative retains the recorded procurement limits. Source alternative retains the recorded procurement limits. Source alternative retains the recorded procurement limits. Source alternative retains the recorded procurement limits. Source alternative retains the recorded procurement limits. Source alternative retains the recorded procurement limits. Source alternative retains the recorded procurement limits. Source alternative retains the recorded procurement limits. Source alternative retains the recorded procurement limits. Source alternative retains the recorded procurement limits. Source alternative retains the recorded procurement limits. Source alternative retains the recorded procurement limits. Source alternative retains the recorded procurement limits. Source alternative retains the recorded procurement limits.

☐ | rich-014 | Tapped linear shaft with threaded ends and full source-specific
assembly description — Model export pending

6649K433 — primary
supplier

12 — buy

### 2 packs

of 10, cut

### 4 per

length

$9.60
—
$0.096
per
piece

$19.20
—
used
$11.52
See note below | ☑ | ☐

Alternates: Sourcing record 014 — Source alternative retains the recorded procurement limits. Source alternative retains the recorded procurement limits. Source alternative retains the recorded procurement limits. Source alternative retains the recorded procurement limits. Source alternative retains the recorded procurement limits. Source alternative retains the recorded procurement limits. Source alternative retains the recorded procurement limits. Source alternative retains the recorded procurement limits. Source alternative retains the recorded procurement limits. Source alternative retains the recorded procurement limits. Source alternative retains the recorded procurement limits. Source alternative retains the recorded procurement limits. Source alternative retains the recorded procurement limits. Source alternative retains the recorded procurement limits. Source alternative retains the recorded procurement limits.

| | | number | needed | price | cost
☐ | rich-015 | Tapped linear shaft with threaded ends and full source-specific assembly description — Model export pending | 6649K433 — primary supplier | 12 — buy 2 packs of 10, cut 4 per length | $9.60 — $0.096 per piece | $19.20 — used $11.52 | See note below | ☑ | ☐

Alternates: Sourcing record 015 — Source alternative retains the recorded procurement limits. Source alternative retains the recorded procurement limits. Source alternative retains the recorded procurement limits. Source alternative retains the recorded procurement limits. Source alternative retains the recorded procurement limits. Source alternative retains the recorded procurement limits. Source alternative retains the recorded procurement limits. Source alternative retains the recorded procurement limits. Source alternative retains the recorded procurement limits. Source alternative retains the recorded procurement limits. Source alternative retains the recorded procurement limits. Source alternative retains the recorded procurement limits. Source alternative retains the recorded procurement limits. Source alternative retains the recorded procurement limits. Source alternative retains the recorded procurement limits.

☐ | rich-016 | Tapped linear shaft with threaded ends and full source-specific
assembly description — Model export pending

6649K433 — primary
supplier

12 — buy

### 2 packs

of 10, cut

### 4 per

length

$9.60
—
$0.096
per
piece

$19.20
—
used
$11.52
See note below | ☑ | ☐

Alternates: Sourcing record 016 — Source alternative retains the recorded procurement limits. Source alternative retains the recorded procurement limits. Source alternative retains the recorded procurement limits. Source alternative retains the recorded procurement limits. Source alternative retains the recorded procurement limits. Source alternative retains the recorded procurement limits. Source alternative retains the recorded procurement limits. Source alternative retains the recorded procurement limits. Source alternative retains the recorded procurement limits. Source alternative retains the recorded procurement limits. Source alternative retains the recorded procurement limits. Source alternative retains the recorded procurement limits. Source alternative retains the recorded procurement limits. Source alternative retains the recorded procurement limits. Source alternative retains the recorded procurement limits.

☐ | rich-017 | Tapped linear shaft with threaded ends and full source-specific
assembly description — Model export pending

6649K433 — primary
supplier

12 — buy

### 2 packs

of 10, cut

### 4 per

length

$9.60
—
$0.096
per
piece

$19.20
—
used
$11.52
See note below | ☑ | ☐

Alternates: Sourcing record 017 — Source alternative retains the recorded procurement limits. Source alternative retains the recorded procurement limits. Source alternative retains the recorded procurement limits. Source alternative retains the recorded procurement limits. Source alternative retains the recorded procurement limits. Source alternative retains the recorded procurement limits. Source alternative retains the recorded procurement limits. Source alternative retains the recorded procurement limits. Source alternative retains the recorded procurement limits. Source alternative retains the recorded procurement limits. Source alternative retains the recorded procurement limits. Source alternative retains the recorded procurement limits. Source alternative retains the recorded procurement limits. Source alternative retains the recorded procurement limits. Source alternative retains the recorded procurement limits.

| | | number | needed | price | cost
☐ | rich-018 | Tapped linear shaft with threaded ends and full source-specific assembly description — Model export pending | 6649K433 — primary supplier | 12 — buy 2 packs of 10, cut 4 per length | $9.60 — $0.096 per piece | $19.20 — used $11.52 | See note below | ☑ | ☐

Alternates: Sourcing record 018 — Source alternative retains the recorded procurement limits. Source alternative retains the recorded procurement limits. Source alternative retains the recorded procurement limits. Source alternative retains the recorded procurement limits. Source alternative retains the recorded procurement limits. Source alternative retains the recorded procurement limits. Source alternative retains the recorded procurement limits. Source alternative retains the recorded procurement limits. Source alternative retains the recorded procurement limits. Source alternative retains the recorded procurement limits. Source alternative retains the recorded procurement limits. Source alternative retains the recorded procurement limits. Source alternative retains the recorded procurement limits. Source alternative retains the recorded procurement limits. Source alternative retains the recorded procurement limits.

☐ | rich-019 | Tapped linear shaft with threaded ends and full source-specific
assembly description — Model export pending

6649K433 — primary
supplier

12 — buy

### 2 packs

of 10, cut

### 4 per

length

$9.60
—
$0.096
per
piece

$19.20
—
used
$11.52
See note below | ☑ | ☐

Alternates: Sourcing record 019 — Source alternative retains the recorded procurement limits. Source alternative retains the recorded procurement limits. Source alternative retains the recorded procurement limits. Source alternative retains the recorded procurement limits. Source alternative retains the recorded procurement limits. Source alternative retains the recorded procurement limits. Source alternative retains the recorded procurement limits. Source alternative retains the recorded procurement limits. Source alternative retains the recorded procurement limits. Source alternative retains the recorded procurement limits. Source alternative retains the recorded procurement limits. Source alternative retains the recorded procurement limits. Source alternative retains the recorded procurement limits. Source alternative retains the recorded procurement limits. Source alternative retains the recorded procurement limits.

☐ | rich-020 | Tapped linear shaft with threaded ends and full source-specific
assembly description — Model export pending

6649K433 — primary
supplier

12 — buy

### 2 packs

of 10, cut

### 4 per

length

$9.60
—
$0.096
per
piece

$19.20
—
used
$11.52
See note below | ☑ | ☐

Alternates: Sourcing record 020 — Source alternative retains the recorded procurement limits. Source alternative retains the recorded procurement limits. Source alternative retains the recorded procurement limits. Source alternative retains the recorded procurement limits. Source alternative retains the recorded procurement limits. Source alternative retains the recorded procurement limits. Source alternative retains the recorded procurement limits. Source alternative retains the recorded procurement limits. Source alternative retains the recorded procurement limits. Source alternative retains the recorded procurement limits. Source alternative retains the recorded procurement limits. Source alternative retains the recorded procurement limits. Source alternative retains the recorded procurement limits. Source alternative retains the recorded procurement limits. Source alternative retains the recorded procurement limits.

| | | number | needed | price | cost
☐ | rich-021 | Tapped linear shaft with threaded ends and full source-specific assembly description — Model export pending | 6649K433 — primary supplier | 12 — buy 2 packs of 10, cut 4 per length | $9.60 — $0.096 per piece | $19.20 — used $11.52 | See note below | ☑ | ☐

Alternates: Sourcing record 021 — Source alternative retains the recorded procurement limits. Source alternative retains the recorded procurement limits. Source alternative retains the recorded procurement limits. Source alternative retains the recorded procurement limits. Source alternative retains the recorded procurement limits. Source alternative retains the recorded procurement limits. Source alternative retains the recorded procurement limits. Source alternative retains the recorded procurement limits. Source alternative retains the recorded procurement limits. Source alternative retains the recorded procurement limits. Source alternative retains the recorded procurement limits. Source alternative retains the recorded procurement limits. Source alternative retains the recorded procurement limits. Source alternative retains the recorded procurement limits. Source alternative retains the recorded procurement limits.

☐ | rich-022 | Tapped linear shaft with threaded ends and full source-specific
assembly description — Model export pending

6649K433 — primary
supplier

12 — buy

### 2 packs

of 10, cut

### 4 per

length

$9.60
—
$0.096
per
piece

$19.20
—
used
$11.52
See note below | ☑ | ☐

Alternates: Sourcing record 022 — Source alternative retains the recorded procurement limits. Source alternative retains the recorded procurement limits. Source alternative retains the recorded procurement limits. Source alternative retains the recorded procurement limits. Source alternative retains the recorded procurement limits. Source alternative retains the recorded procurement limits. Source alternative retains the recorded procurement limits. Source alternative retains the recorded procurement limits. Source alternative retains the recorded procurement limits. Source alternative retains the recorded procurement limits. Source alternative retains the recorded procurement limits. Source alternative retains the recorded procurement limits. Source alternative retains the recorded procurement limits. Source alternative retains the recorded procurement limits. Source alternative retains the recorded procurement limits.

☐ | rich-023 | Tapped linear shaft with threaded ends and full source-specific
assembly description — Model export pending

6649K433 — primary
supplier

12 — buy

### 2 packs

of 10, cut

### 4 per

length

$9.60
—
$0.096
per
piece

$19.20
—
used
$11.52
See note below | ☑ | ☐

Alternates: Sourcing record 023 — Source alternative retains the recorded procurement limits. Source alternative retains the recorded procurement limits. Source alternative retains the recorded procurement limits. Source alternative retains the recorded procurement limits. Source alternative retains the recorded procurement limits. Source alternative retains the recorded procurement limits. Source alternative retains the recorded procurement limits. Source alternative retains the recorded procurement limits. Source alternative retains the recorded procurement limits. Source alternative retains the recorded procurement limits. Source alternative retains the recorded procurement limits. Source alternative retains the recorded procurement limits. Source alternative retains the recorded procurement limits. Source alternative retains the recorded procurement limits. Source alternative retains the recorded procurement limits.

| | | number | needed | price | cost
☐ | rich-024 | Tapped linear shaft with threaded ends and full source-specific assembly description — Model export pending | 6649K433 — primary supplier | 12 — buy 2 packs of 10, cut 4 per length | $9.60 — $0.096 per piece | $19.20 — used $11.52 | See note below | ☑ | ☐

Alternates: Sourcing record 024 — Source alternative retains the recorded procurement limits. Source alternative retains the recorded procurement limits. Source alternative retains the recorded procurement limits. Source alternative retains the recorded procurement limits. Source alternative retains the recorded procurement limits. Source alternative retains the recorded procurement limits. Source alternative retains the recorded procurement limits. Source alternative retains the recorded procurement limits. Source alternative retains the recorded procurement limits. Source alternative retains the recorded procurement limits. Source alternative retains the recorded procurement limits. Source alternative retains the recorded procurement limits. Source alternative retains the recorded procurement limits. Source alternative retains the recorded procurement limits. Source alternative retains the recorded procurement limits.

☐ | rich-025 | Tapped linear shaft with threaded ends and full source-specific
assembly description — Model export pending

6649K433 — primary
supplier

12 — buy

### 2 packs

of 10, cut

### 4 per

length

$9.60
—
$0.096
per
piece

$19.20
—
used
$11.52
See note below | ☑ | ☐

Alternates: Sourcing record 025 — Source alternative retains the recorded procurement limits. Source alternative retains the recorded procurement limits. Source alternative retains the recorded procurement limits. Source alternative retains the recorded procurement limits. Source alternative retains the recorded procurement limits. Source alternative retains the recorded procurement limits. Source alternative retains the recorded procurement limits. Source alternative retains the recorded procurement limits. Source alternative retains the recorded procurement limits. Source alternative retains the recorded procurement limits. Source alternative retains the recorded procurement limits. Source alternative retains the recorded procurement limits. Source alternative retains the recorded procurement limits. Source alternative retains the recorded procurement limits. Source alternative retains the recorded procurement limits.

☐ | rich-026 | Tapped linear shaft with threaded ends and full source-specific
assembly description — Model export pending

6649K433 — primary
supplier

12 — buy

### 2 packs

of 10, cut

### 4 per

length

$9.60
—
$0.096
per
piece

$19.20
—
used
$11.52
See note below | ☑ | ☐

Alternates: Sourcing record 026 — Source alternative retains the recorded procurement limits. Source alternative retains the recorded procurement limits. Source alternative retains the recorded procurement limits. Source alternative retains the recorded procurement limits. Source alternative retains the recorded procurement limits. Source alternative retains the recorded procurement limits. Source alternative retains the recorded procurement limits. Source alternative retains the recorded procurement limits. Source alternative retains the recorded procurement limits. Source alternative retains the recorded procurement limits. Source alternative retains the recorded procurement limits. Source alternative retains the recorded procurement limits. Source alternative retains the recorded procurement limits. Source alternative retains the recorded procurement limits. Source alternative retains the recorded procurement limits.

| | | number | needed | price | cost
☐ | rich-027 | Tapped linear shaft with threaded ends and full source-specific assembly description — Model export pending | 6649K433 — primary supplier | 12 — buy 2 packs of 10, cut 4 per length | $9.60 — $0.096 per piece | $19.20 — used $11.52 | See note below | ☑ | ☐

Alternates: Sourcing record 027 — Source alternative retains the recorded procurement limits. Source alternative retains the recorded procurement limits. Source alternative retains the recorded procurement limits. Source alternative retains the recorded procurement limits. Source alternative retains the recorded procurement limits. Source alternative retains the recorded procurement limits. Source alternative retains the recorded procurement limits. Source alternative retains the recorded procurement limits. Source alternative retains the recorded procurement limits. Source alternative retains the recorded procurement limits. Source alternative retains the recorded procurement limits. Source alternative retains the recorded procurement limits. Source alternative retains the recorded procurement limits. Source alternative retains the recorded procurement limits. Source alternative retains the recorded procurement limits.

☐ | rich-028 | Tapped linear shaft with threaded ends and full source-specific
assembly description — Model export pending

6649K433 — primary
supplier

12 — buy

### 2 packs

of 10, cut

### 4 per

length

$9.60
—
$0.096
per
piece

$19.20
—
used
$11.52
See note below | ☑ | ☐

Alternates: Sourcing record 028 — Source alternative retains the recorded procurement limits. Source alternative retains the recorded procurement limits. Source alternative retains the recorded procurement limits. Source alternative retains the recorded procurement limits. Source alternative retains the recorded procurement limits. Source alternative retains the recorded procurement limits. Source alternative retains the recorded procurement limits. Source alternative retains the recorded procurement limits. Source alternative retains the recorded procurement limits. Source alternative retains the recorded procurement limits. Source alternative retains the recorded procurement limits. Source alternative retains the recorded procurement limits. Source alternative retains the recorded procurement limits. Source alternative retains the recorded procurement limits. Source alternative retains the recorded procurement limits.

☐ | rich-029 | Tapped linear shaft with threaded ends and full source-specific
assembly description — Model export pending

6649K433 — primary
supplier

12 — buy

### 2 packs

of 10, cut

### 4 per

length

$9.60
—
$0.096
per
piece

$19.20
—
used
$11.52
See note below | ☑ | ☐

Alternates: Sourcing record 029 — Source alternative retains the recorded procurement limits. Source alternative retains the recorded procurement limits. Source alternative retains the recorded procurement limits. Source alternative retains the recorded procurement limits. Source alternative retains the recorded procurement limits. Source alternative retains the recorded procurement limits. Source alternative retains the recorded procurement limits. Source alternative retains the recorded procurement limits. Source alternative retains the recorded procurement limits. Source alternative retains the recorded procurement limits. Source alternative retains the recorded procurement limits. Source alternative retains the recorded procurement limits. Source alternative retains the recorded procurement limits. Source alternative retains the recorded procurement limits. Source alternative retains the recorded procurement limits.

| | | number | needed | price | cost
☐ | rich-030 | Tapped linear shaft with threaded ends and full source-specific assembly description — Model export pending | 6649K433 — primary supplier | 12 — buy 2 packs of 10, cut 4 per length | $9.60 — $0.096 per piece | $19.20 — used $11.52 | See note below | ☑ | ☐

Alternates: Sourcing record 030 — Source alternative retains the recorded procurement limits. Source alternative retains the recorded procurement limits. Source alternative retains the recorded procurement limits. Source alternative retains the recorded procurement limits. Source alternative retains the recorded procurement limits. Source alternative retains the recorded procurement limits. Source alternative retains the recorded procurement limits. Source alternative retains the recorded procurement limits. Source alternative retains the recorded procurement limits. Source alternative retains the recorded procurement limits. Source alternative retains the recorded procurement limits. Source alternative retains the recorded procurement limits. Source alternative retains the recorded procurement limits. Source alternative retains the recorded procurement limits. Source alternative retains the recorded procurement limits.

☐ | rich-031 | Tapped linear shaft with threaded ends and full source-specific
assembly description — Model export pending

6649K433 — primary
supplier

12 — buy

### 2 packs

of 10, cut

### 4 per

length

$9.60
—
$0.096
per
piece

$19.20
—
used
$11.52
See note below | ☑ | ☐

Alternates: Sourcing record 031 — Source alternative retains the recorded procurement limits. Source alternative retains the recorded procurement limits. Source alternative retains the recorded procurement limits. Source alternative retains the recorded procurement limits. Source alternative retains the recorded procurement limits. Source alternative retains the recorded procurement limits. Source alternative retains the recorded procurement limits. Source alternative retains the recorded procurement limits. Source alternative retains the recorded procurement limits. Source alternative retains the recorded procurement limits. Source alternative retains the recorded procurement limits. Source alternative retains the recorded procurement limits. Source alternative retains the recorded procurement limits. Source alternative retains the recorded procurement limits. Source alternative retains the recorded procurement limits.

☐ | rich-032 | Tapped linear shaft with threaded ends and full source-specific
assembly description — Model export pending

6649K433 — primary
supplier

12 — buy

### 2 packs

of 10, cut

### 4 per

length

$9.60
—
$0.096
per
piece

$19.20
—
used
$11.52
See note below | ☑ | ☐

Alternates: Sourcing record 032 — Source alternative retains the recorded procurement limits. Source alternative retains the recorded procurement limits. Source alternative retains the recorded procurement limits. Source alternative retains the recorded procurement limits. Source alternative retains the recorded procurement limits. Source alternative retains the recorded procurement limits. Source alternative retains the recorded procurement limits. Source alternative retains the recorded procurement limits. Source alternative retains the recorded procurement limits. Source alternative retains the recorded procurement limits. Source alternative retains the recorded procurement limits. Source alternative retains the recorded procurement limits. Source alternative retains the recorded procurement limits. Source alternative retains the recorded procurement limits. Source alternative retains the recorded procurement limits.

| | | number | needed | price | cost
☐ | rich-033 | Tapped linear shaft with threaded ends and full source-specific assembly description — Model export pending | 6649K433 — primary supplier | 12 — buy 2 packs of 10, cut 4 per length | $9.60 — $0.096 per piece | $19.20 — used $11.52 | See note below | ☑ | ☐

Alternates: Sourcing record 033 — Source alternative retains the recorded procurement limits. Source alternative retains the recorded procurement limits. Source alternative retains the recorded procurement limits. Source alternative retains the recorded procurement limits. Source alternative retains the recorded procurement limits. Source alternative retains the recorded procurement limits. Source alternative retains the recorded procurement limits. Source alternative retains the recorded procurement limits. Source alternative retains the recorded procurement limits. Source alternative retains the recorded procurement limits. Source alternative retains the recorded procurement limits. Source alternative retains the recorded procurement limits. Source alternative retains the recorded procurement limits. Source alternative retains the recorded procurement limits. Source alternative retains the recorded procurement limits.

☐ | rich-034 | Tapped linear shaft with threaded ends and full source-specific
assembly description — Model export pending

6649K433 — primary
supplier

12 — buy

### 2 packs

of 10, cut

### 4 per

length

$9.60
—
$0.096
per
piece

$19.20
—
used
$11.52
See note below | ☑ | ☐

Alternates: Sourcing record 034 — Source alternative retains the recorded procurement limits. Source alternative retains the recorded procurement limits. Source alternative retains the recorded procurement limits. Source alternative retains the recorded procurement limits. Source alternative retains the recorded procurement limits. Source alternative retains the recorded procurement limits. Source alternative retains the recorded procurement limits. Source alternative retains the recorded procurement limits. Source alternative retains the recorded procurement limits. Source alternative retains the recorded procurement limits. Source alternative retains the recorded procurement limits. Source alternative retains the recorded procurement limits. Source alternative retains the recorded procurement limits. Source alternative retains the recorded procurement limits. Source alternative retains the recorded procurement limits.

☐ | rich-035 | Tapped linear shaft with threaded ends and full source-specific
assembly description — Model export pending

6649K433 — primary
supplier

12 — buy

### 2 packs

of 10, cut

### 4 per

length

$9.60
—
$0.096
per
piece

$19.20
—
used
$11.52
See note below | ☑ | ☐

Alternates: Sourcing record 035 — Source alternative retains the recorded procurement limits. Source alternative retains the recorded procurement limits. Source alternative retains the recorded procurement limits. Source alternative retains the recorded procurement limits. Source alternative retains the recorded procurement limits. Source alternative retains the recorded procurement limits. Source alternative retains the recorded procurement limits. Source alternative retains the recorded procurement limits. Source alternative retains the recorded procurement limits. Source alternative retains the recorded procurement limits. Source alternative retains the recorded procurement limits. Source alternative retains the recorded procurement limits. Source alternative retains the recorded procurement limits. Source alternative retains the recorded procurement limits. Source alternative retains the recorded procurement limits.

| | | number | needed | price | cost
☐ | rich-036 | Tapped linear shaft with threaded ends and full source-specific assembly description — Model export pending | 6649K433 — primary supplier | 12 — buy 2 packs of 10, cut 4 per length | $9.60 — $0.096 per piece | $19.20 — used $11.52 | See note below | ☑ | ☐

Alternates: Sourcing record 036 — Source alternative retains the recorded procurement limits. Source alternative retains the recorded procurement limits. Source alternative retains the recorded procurement limits. Source alternative retains the recorded procurement limits. Source alternative retains the recorded procurement limits. Source alternative retains the recorded procurement limits. Source alternative retains the recorded procurement limits. Source alternative retains the recorded procurement limits. Source alternative retains the recorded procurement limits. Source alternative retains the recorded procurement limits. Source alternative retains the recorded procurement limits. Source alternative retains the recorded procurement limits. Source alternative retains the recorded procurement limits. Source alternative retains the recorded procurement limits. Source alternative retains the recorded procurement limits.

☐ | rich-037 | Tapped linear shaft with threaded ends and full source-specific
assembly description — Model export pending

6649K433 — primary
supplier

12 — buy

### 2 packs

of 10, cut

### 4 per

length

$9.60
—
$0.096
per
piece

$19.20
—
used
$11.52
See note below | ☑ | ☐

Alternates: Sourcing record 037 — Source alternative retains the recorded procurement limits. Source alternative retains the recorded procurement limits. Source alternative retains the recorded procurement limits. Source alternative retains the recorded procurement limits. Source alternative retains the recorded procurement limits. Source alternative retains the recorded procurement limits. Source alternative retains the recorded procurement limits. Source alternative retains the recorded procurement limits. Source alternative retains the recorded procurement limits. Source alternative retains the recorded procurement limits. Source alternative retains the recorded procurement limits. Source alternative retains the recorded procurement limits. Source alternative retains the recorded procurement limits. Source alternative retains the recorded procurement limits. Source alternative retains the recorded procurement limits.

☐ | rich-038 | Tapped linear shaft with threaded ends and full source-specific
assembly description — Model export pending

6649K433 — primary
supplier

12 — buy

### 2 packs

of 10, cut

### 4 per

length

$9.60
—
$0.096
per
piece

$19.20
—
used
$11.52
See note below | ☑ | ☐

Alternates: Sourcing record 038 — Source alternative retains the recorded procurement limits. Source alternative retains the recorded procurement limits. Source alternative retains the recorded procurement limits. Source alternative retains the recorded procurement limits. Source alternative retains the recorded procurement limits. Source alternative retains the recorded procurement limits. Source alternative retains the recorded procurement limits. Source alternative retains the recorded procurement limits. Source alternative retains the recorded procurement limits. Source alternative retains the recorded procurement limits. Source alternative retains the recorded procurement limits. Source alternative retains the recorded procurement limits. Source alternative retains the recorded procurement limits. Source alternative retains the recorded procurement limits. Source alternative retains the recorded procurement limits.

| | | number | needed | price | cost
☐ | rich-039 | Tapped linear shaft with threaded ends and full source-specific assembly description — Model export pending | 6649K433 — primary supplier | 12 — buy 2 packs of 10, cut 4 per length | $9.60 — $0.096 per piece | $19.20 — used $11.52 | See note below | ☑ | ☐

Alternates: Sourcing record 039 — Source alternative retains the recorded procurement limits. Source alternative retains the recorded procurement limits. Source alternative retains the recorded procurement limits. Source alternative retains the recorded procurement limits. Source alternative retains the recorded procurement limits. Source alternative retains the recorded procurement limits. Source alternative retains the recorded procurement limits. Source alternative retains the recorded procurement limits. Source alternative retains the recorded procurement limits. Source alternative retains the recorded procurement limits. Source alternative retains the recorded procurement limits. Source alternative retains the recorded procurement limits. Source alternative retains the recorded procurement limits. Source alternative retains the recorded procurement limits. Source alternative retains the recorded procurement limits.

☐ | rich-040 | Tapped linear shaft with threaded ends and full source-specific
assembly description — Model export pending

6649K433 — primary
supplier

12 — buy

### 2 packs

of 10, cut

### 4 per

length

$9.60
—
$0.096
per
piece

$19.20
—
used
$11.52
See note below | ☑ | ☐

Alternates: Sourcing record 040 — Source alternative retains the recorded procurement limits. Source alternative retains the recorded procurement limits. Source alternative retains the recorded procurement limits. Source alternative retains the recorded procurement limits. Source alternative retains the recorded procurement limits. Source alternative retains the recorded procurement limits. Source alternative retains the recorded procurement limits. Source alternative retains the recorded procurement limits. Source alternative retains the recorded procurement limits. Source alternative retains the recorded procurement limits. Source alternative retains the recorded procurement limits. Source alternative retains the recorded procurement limits. Source alternative retains the recorded procurement limits. Source alternative retains the recorded procurement limits. Source alternative retains the recorded procurement limits.
