Valpatel/gyropup/.agents/plans/build-workspace-evidence/phone-bom-chromium-a76.png

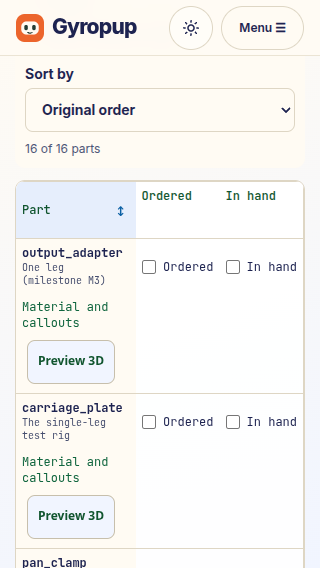
.agents/plans/build-workspace-evidence/phone-bom-chromium-a76.png
