Valpatel/gyropup/.agents/plans/build-workspace-evidence/phone-bom-webkit-a76.png

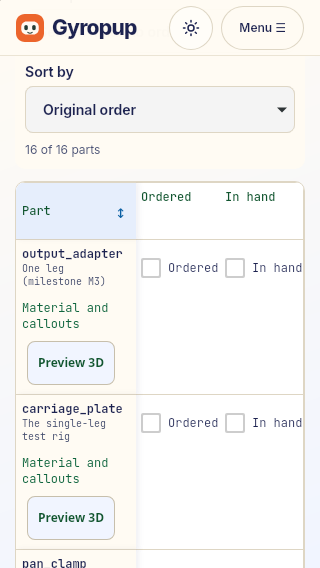
.agents/plans/build-workspace-evidence/phone-bom-webkit-a76.png
