Valpatel/gyropup/.agents/plans/printable-parts/orders-accepted/first-Letter.png

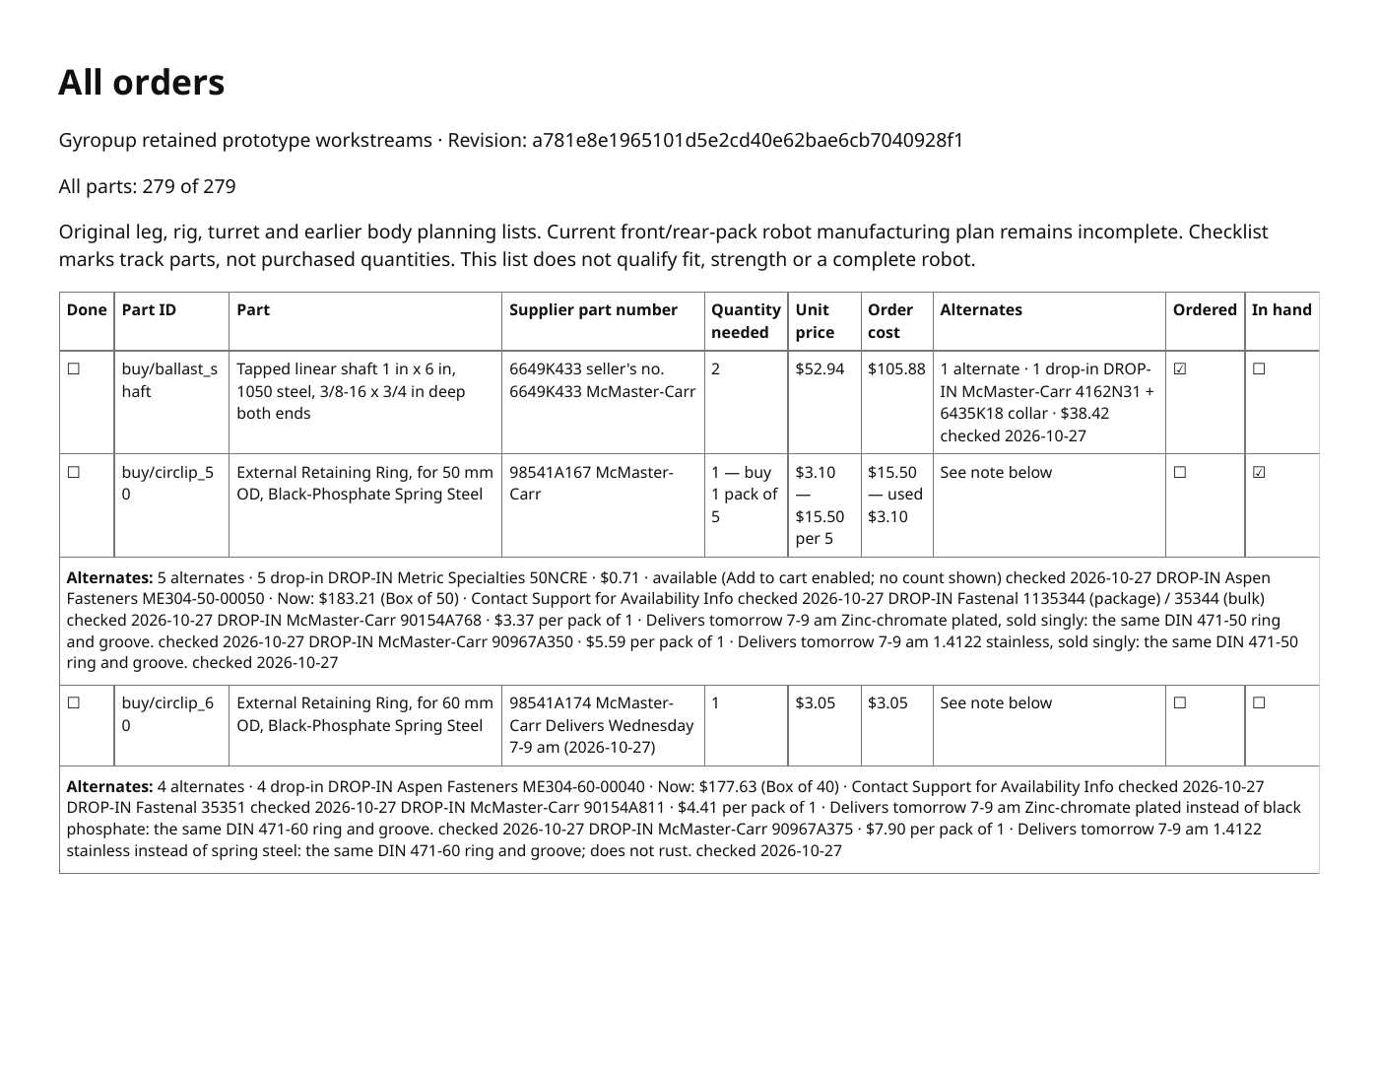
.agents/plans/printable-parts/orders-accepted/first-Letter.png
