Valpatel/gyropup/.agents/plans/printable-parts/orders-accepted/longest-A4.png

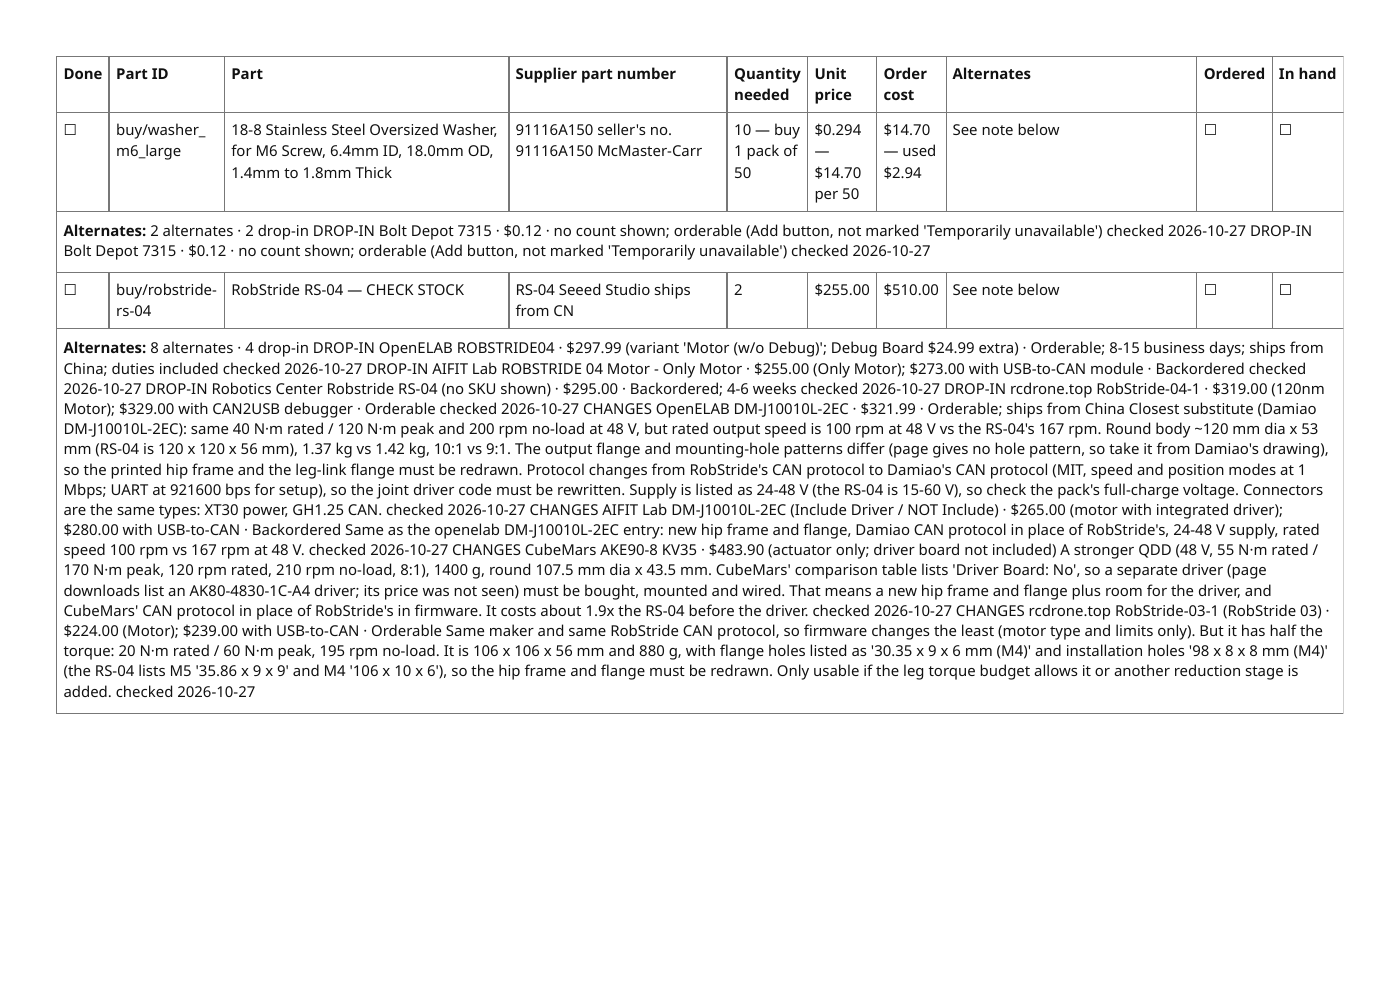
.agents/plans/printable-parts/orders-accepted/longest-A4.png
