Valpatel/gyropup/.agents/plans/printable-parts/orders-accepted/planner.png

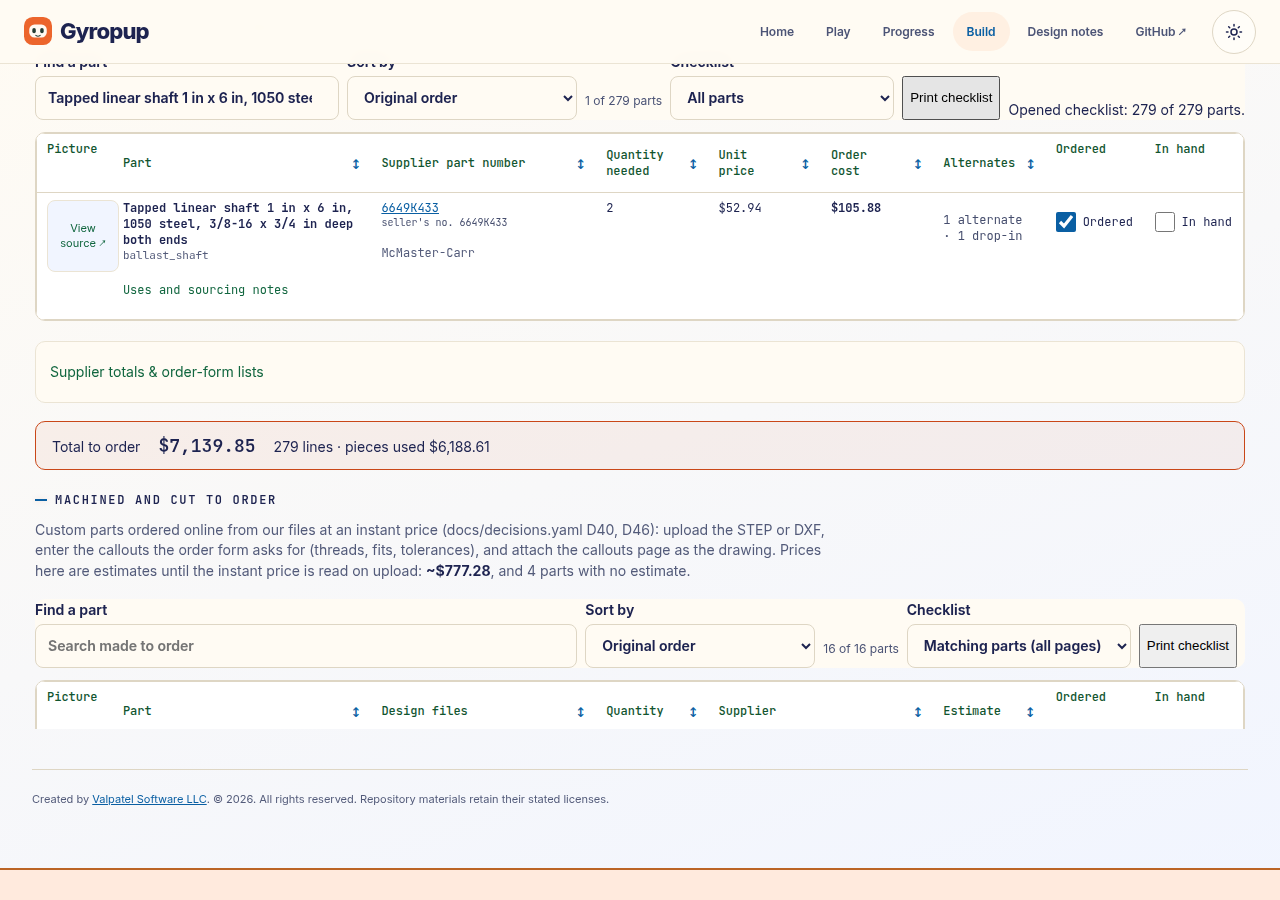
.agents/plans/printable-parts/orders-accepted/planner.png
