Valpatel/gyropup/.agents/plans/printable-parts/orders-width-only/first.png

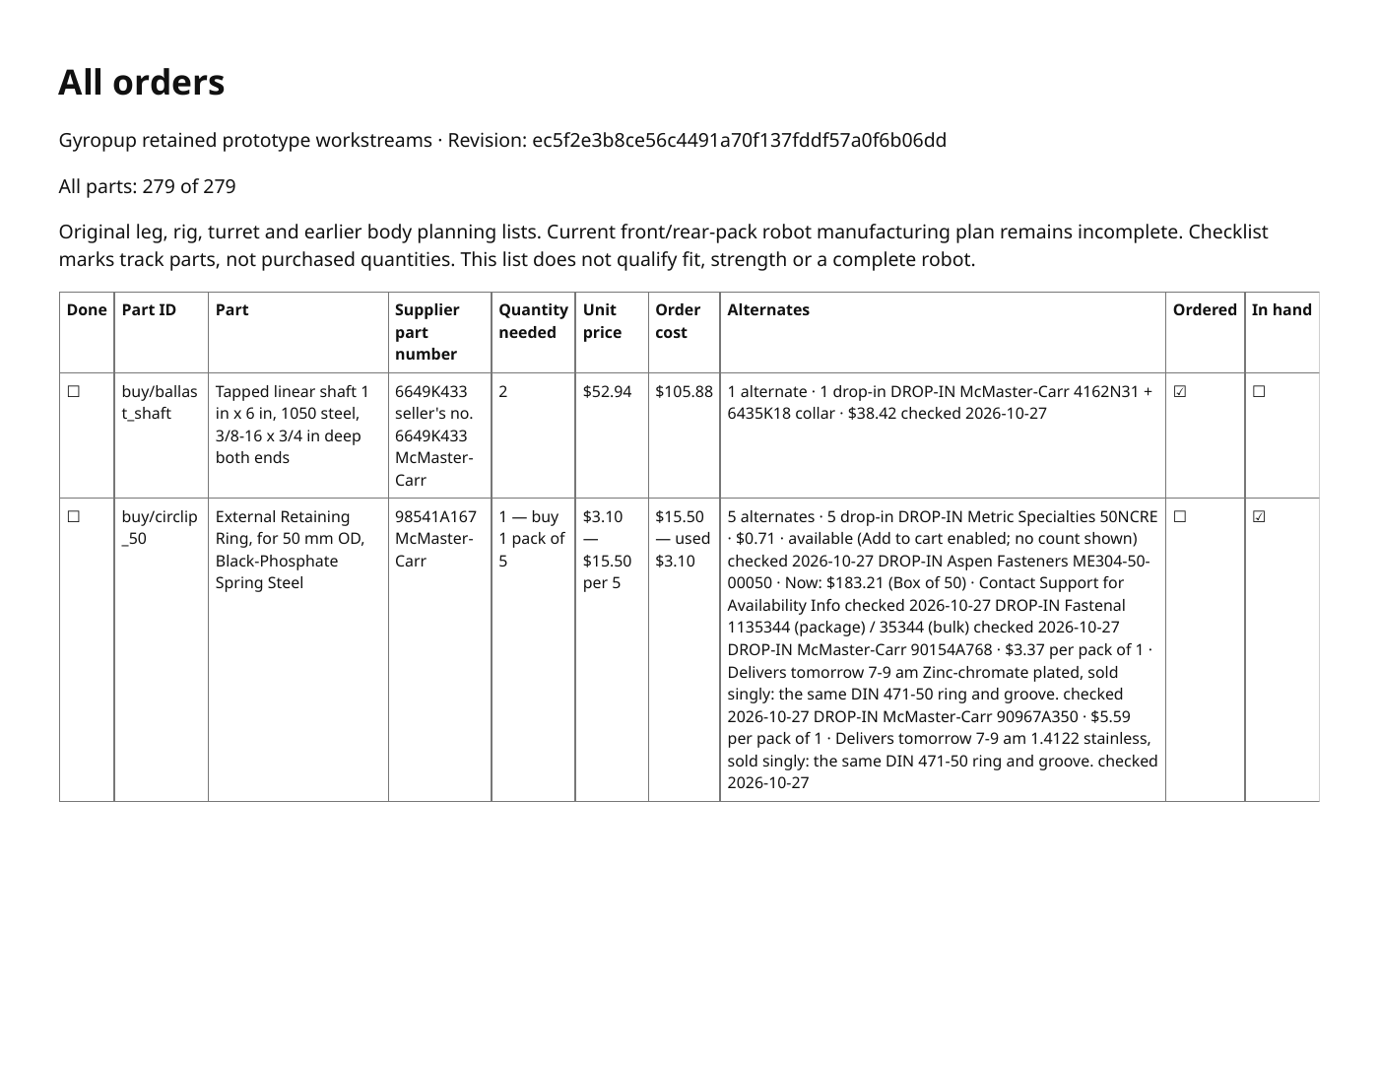
.agents/plans/printable-parts/orders-width-only/first.png
