Valpatel/gyropup/.agents/plans/printable-parts/public-observation/attempt-A-queue-misframed.png

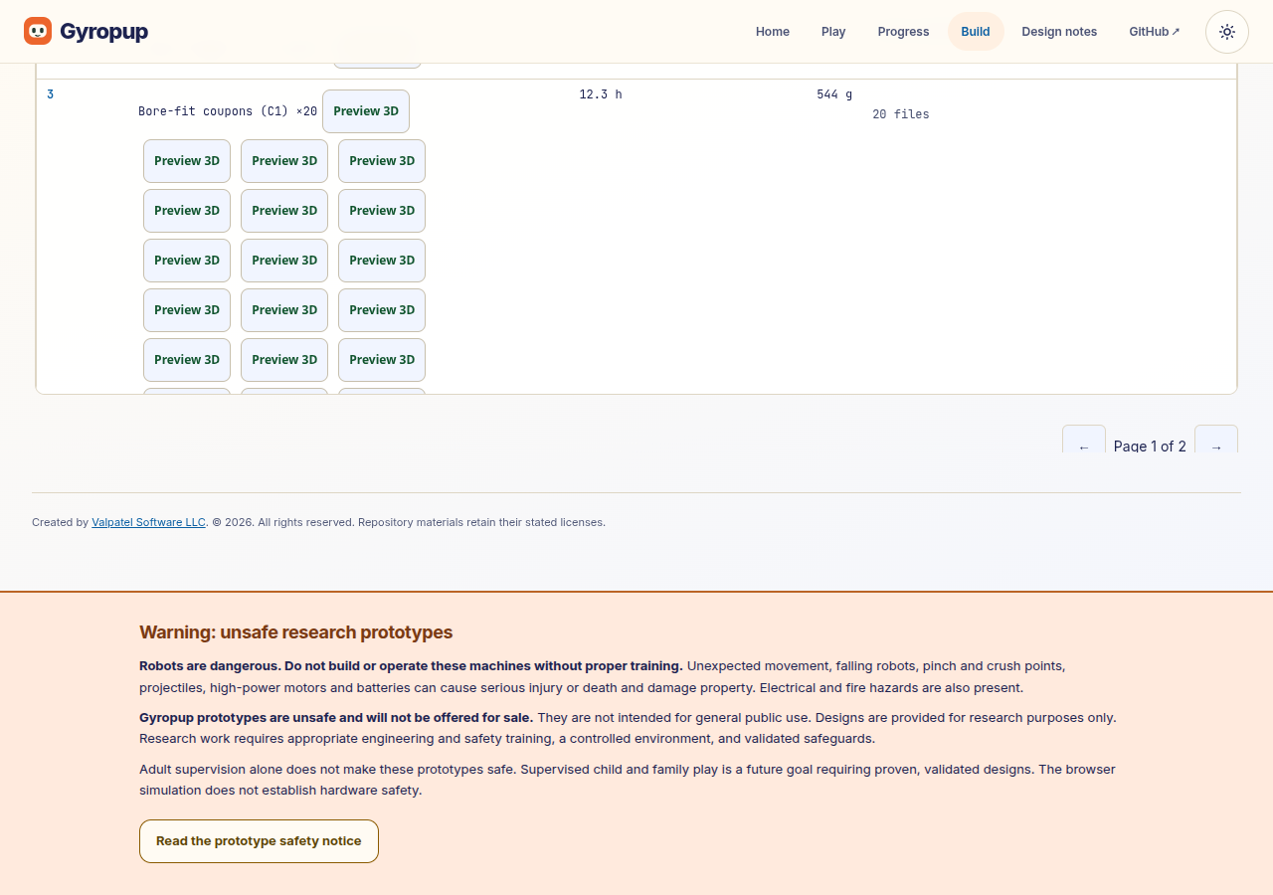
.agents/plans/printable-parts/public-observation/attempt-A-queue-misframed.png
