Valpatel/gyropup/.agents/plans/printable-parts/public-observation/V3-queue-1280.png

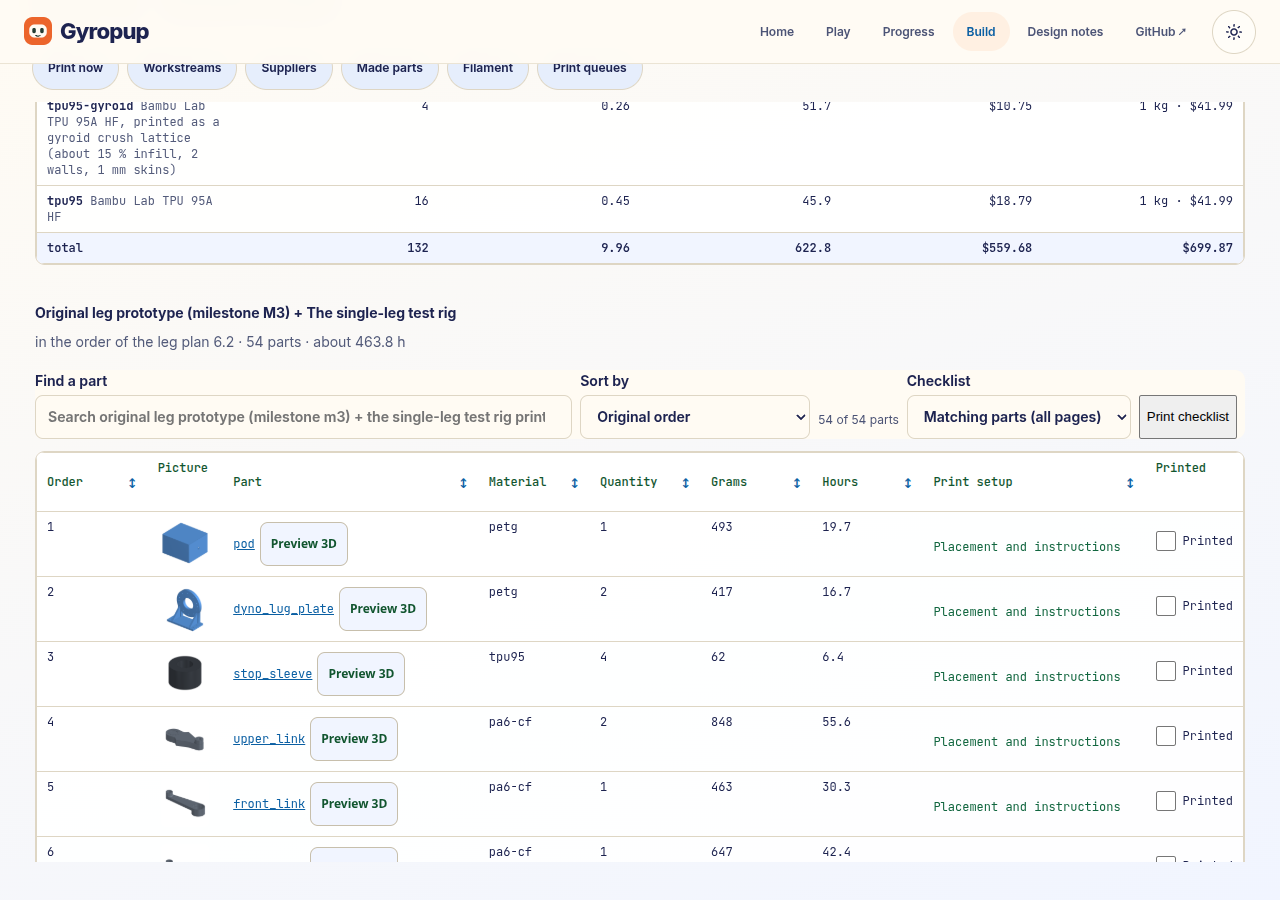
.agents/plans/printable-parts/public-observation/V3-queue-1280.png
