Valpatel/gyropup/.agents/plans/printable-parts/source-fidelity/callouts-A4.png

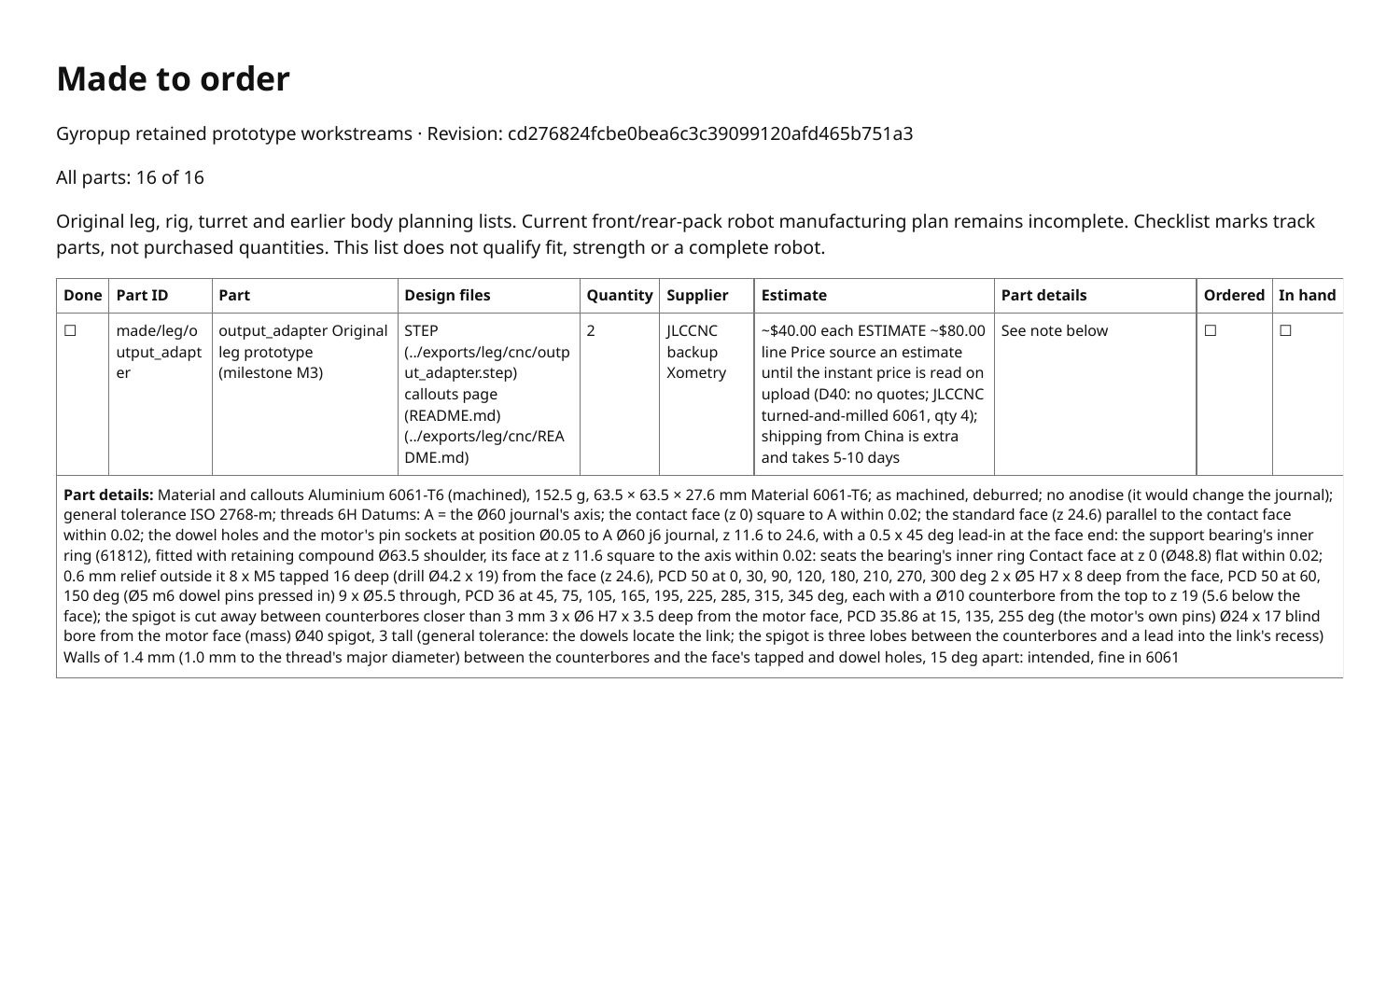
.agents/plans/printable-parts/source-fidelity/callouts-A4.png
