Valpatel/gyropup/.agents/plans/printable-parts/source-fidelity/callouts-Letter.png

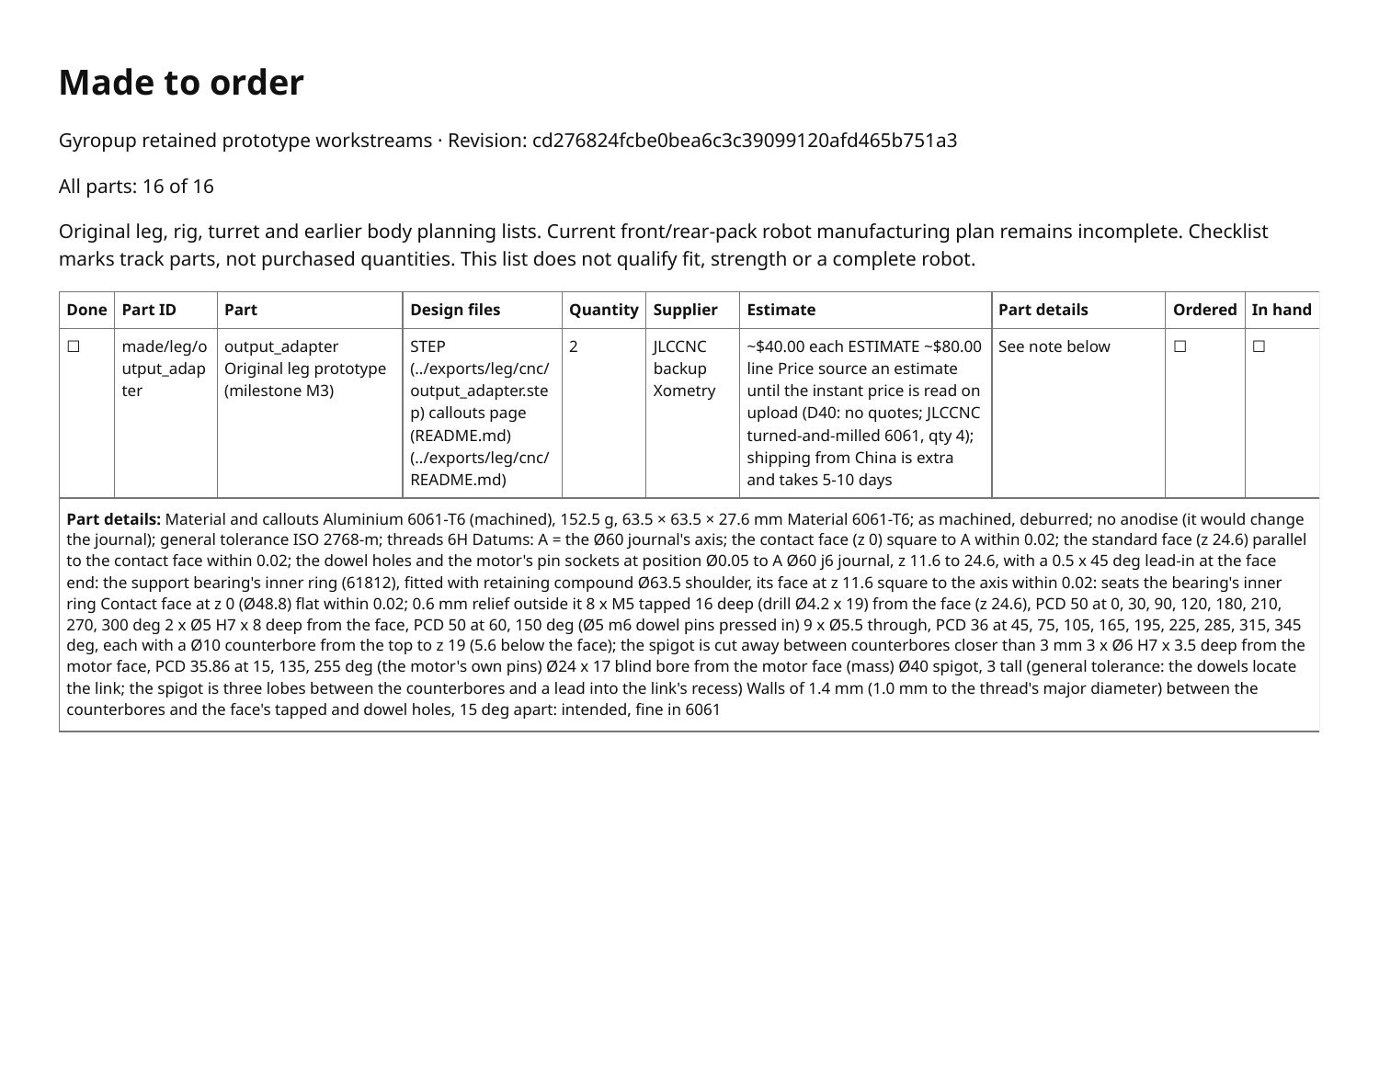
.agents/plans/printable-parts/source-fidelity/callouts-Letter.png
