Valpatel/gyropup/.agents/plans/printable-parts/source-fidelity/hip-A4.png

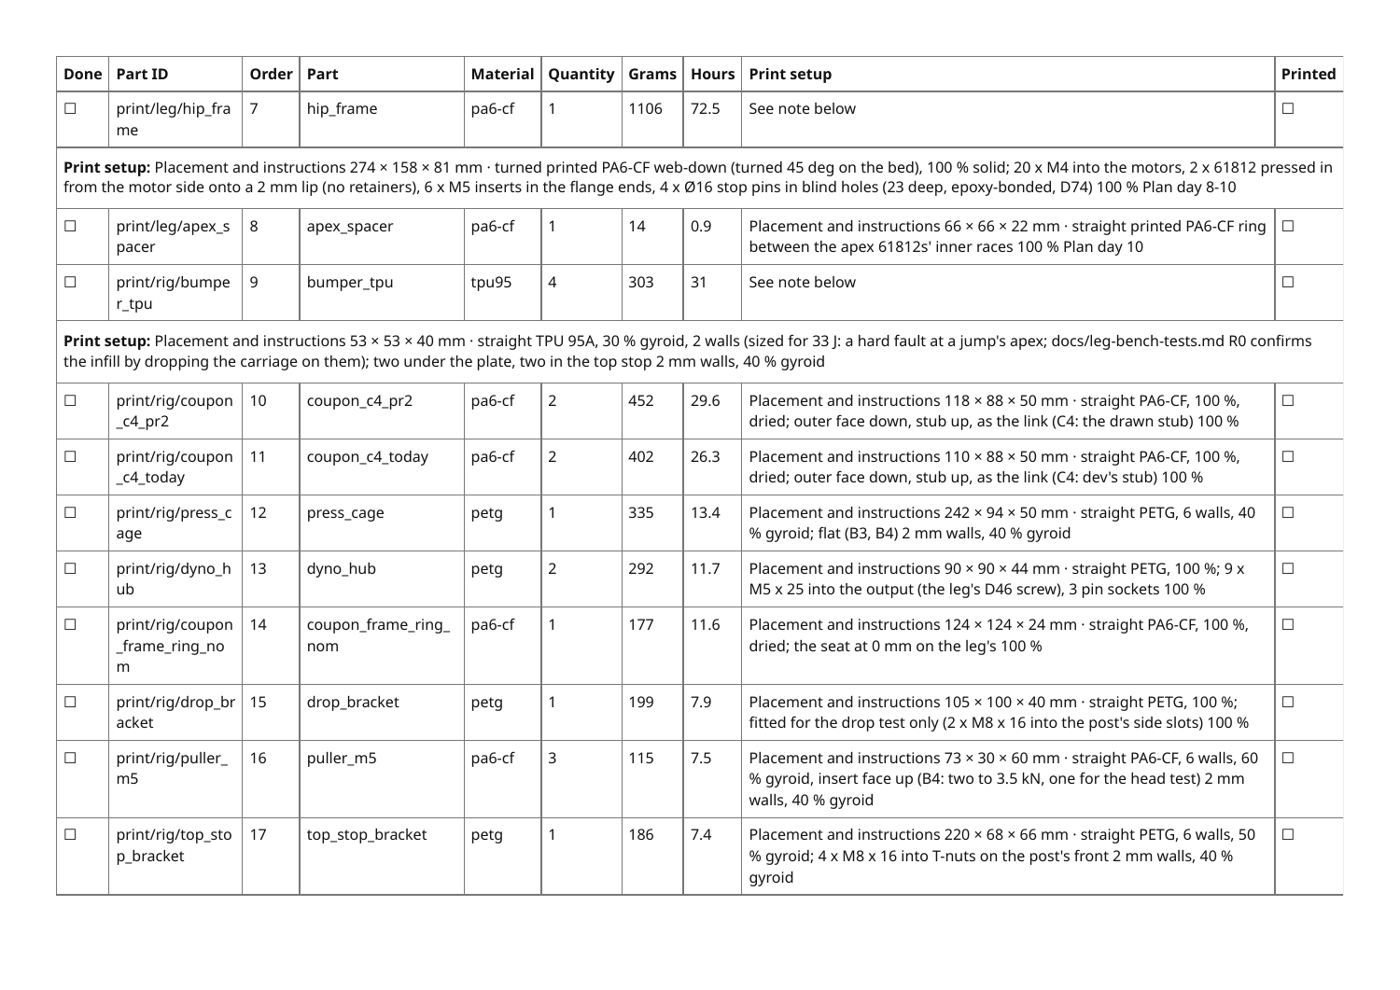
.agents/plans/printable-parts/source-fidelity/hip-A4.png
