Valpatel/gyropup/.agents/plans/printable-parts/source-fidelity/hip-Letter.png

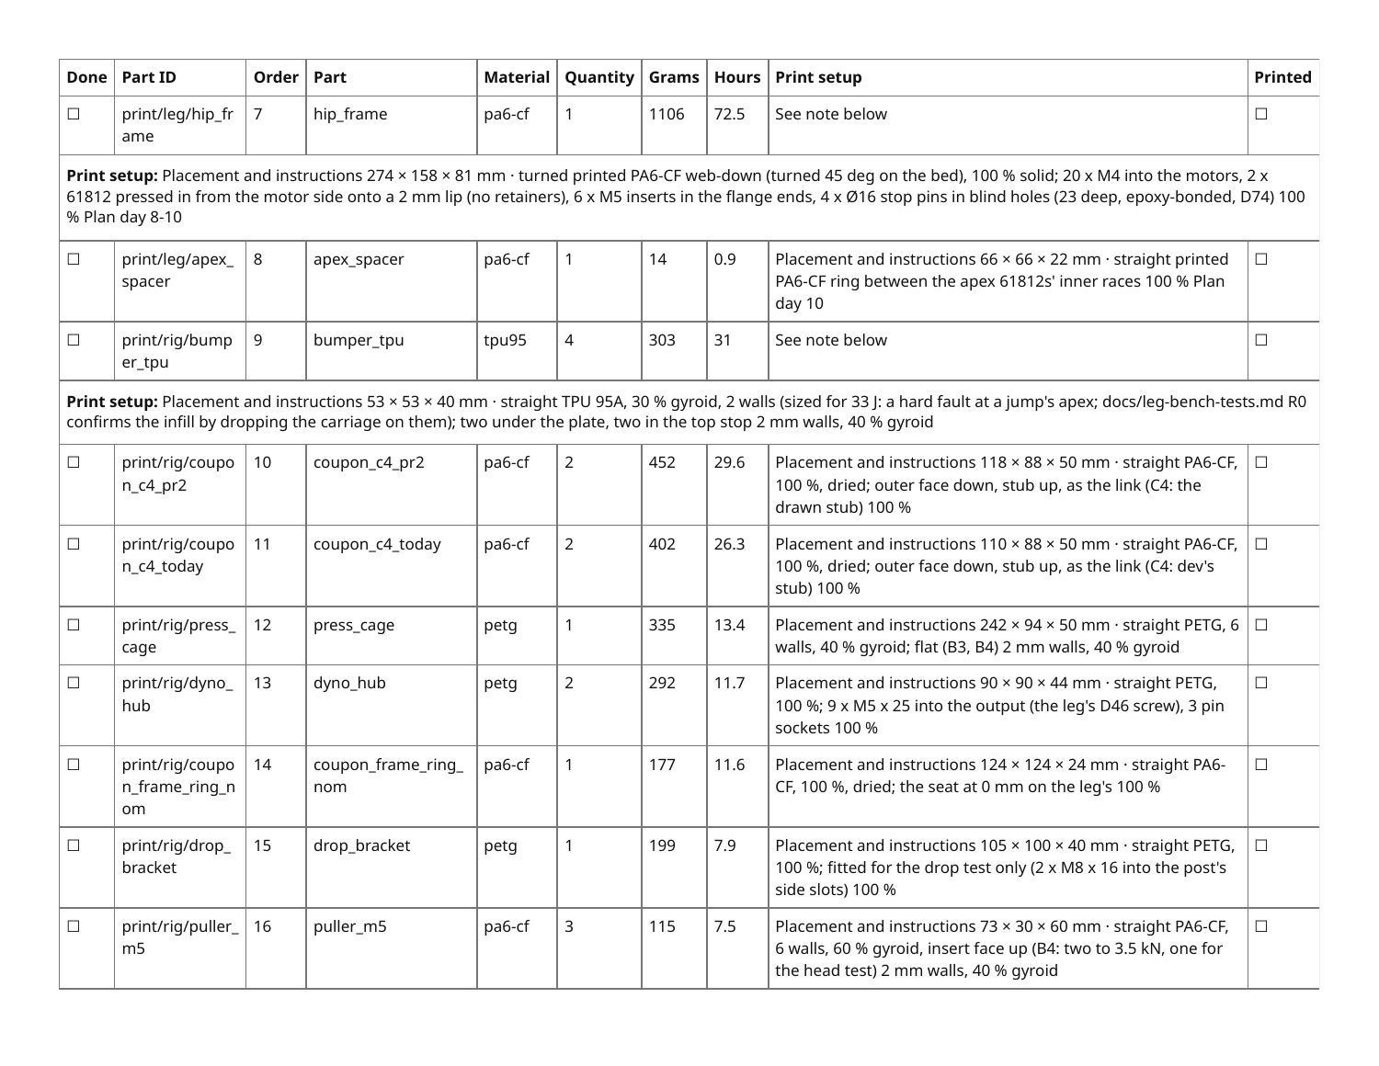
.agents/plans/printable-parts/source-fidelity/hip-Letter.png
