Valpatel/gyropup/hardware/exports/asm_hip_motor_r.step

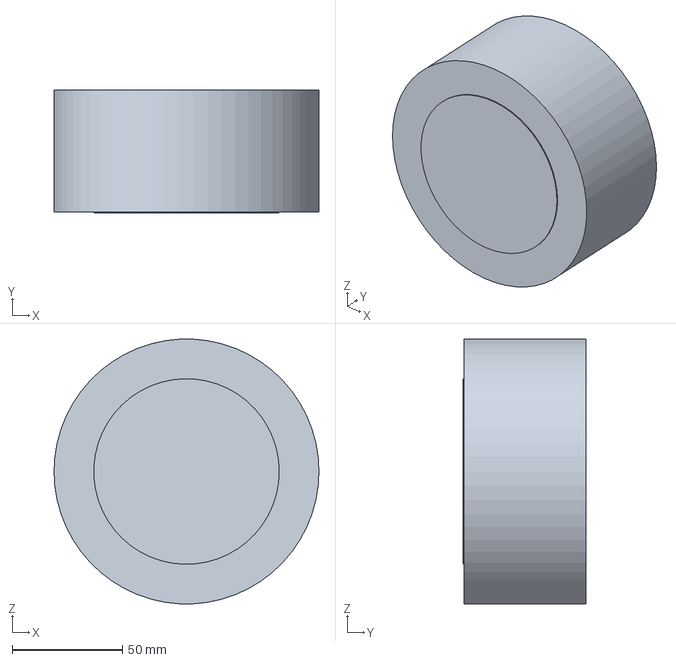
[picture p185: CAD file, 2026-10-26]
hardware/exports/asm_hip_motor_r.step
120.0 x 55.7 x 119.8 mm
