Valpatel/gyropup/hardware/exports/asm_laser_mount.step

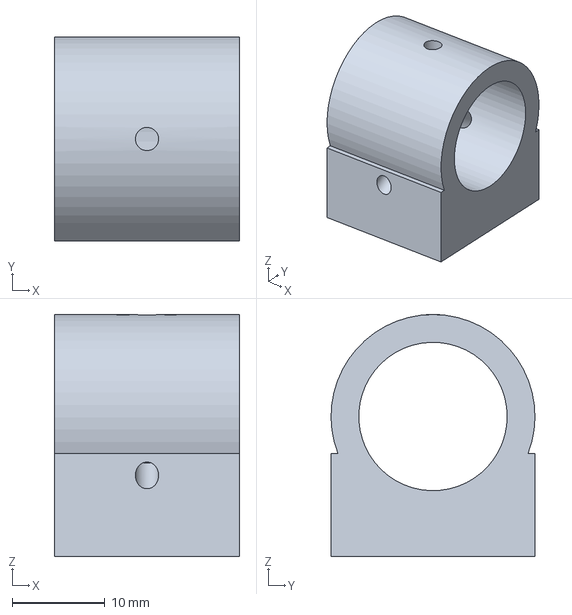
[picture p186: CAD file, 2026-10-26]
hardware/exports/asm_laser_mount.step
20.0 x 22.0 x 26.1 mm
