Valpatel/gyropup/hardware/exports/asm_pan_ring.step

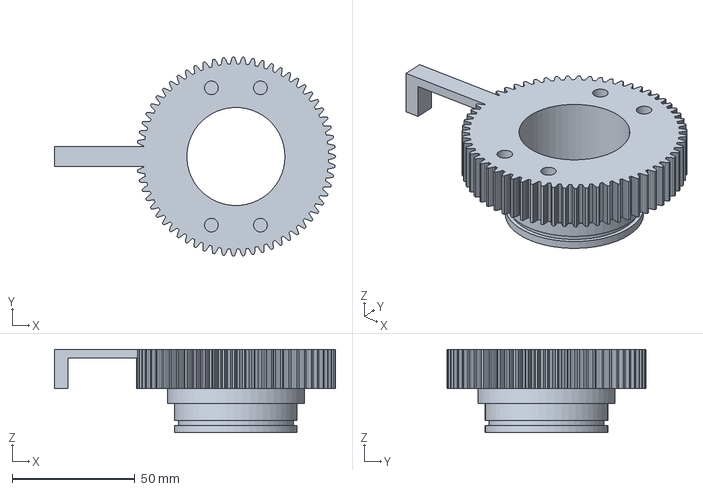
[picture p187: CAD file, 2026-10-26]
hardware/exports/asm_pan_ring.step
114.6 x 81.2 x 34.0 mm
