Valpatel/gyropup/hardware/exports/asm_thigh_r.step

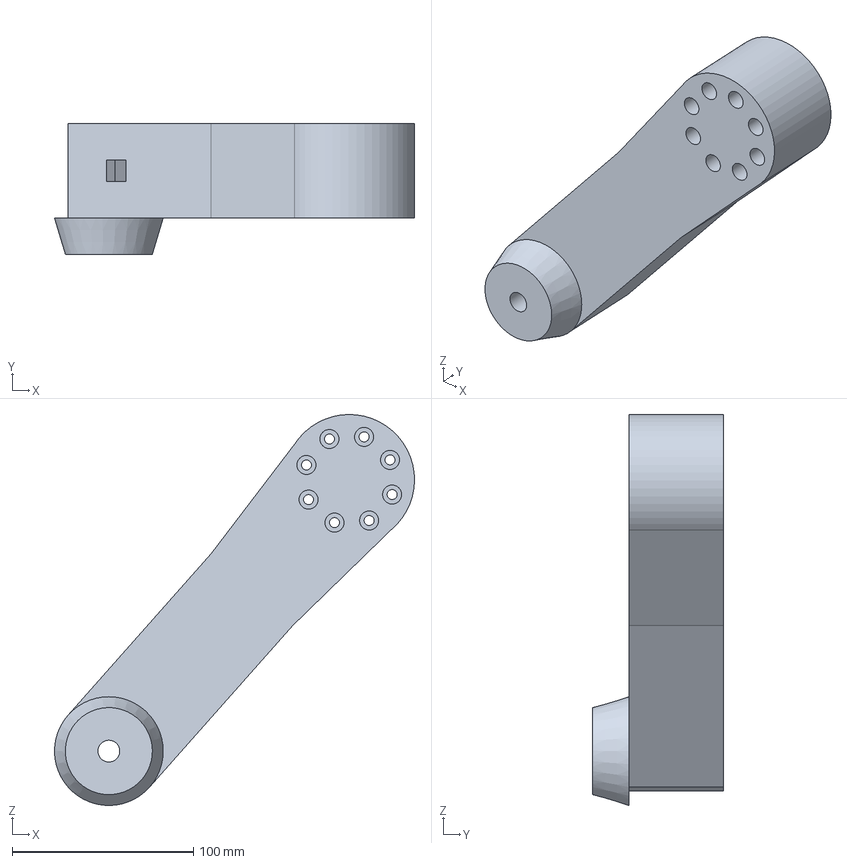
[picture p188: CAD file, 2026-10-26]
hardware/exports/asm_thigh_r.step
198.6 x 72.0 x 215.7 mm
