Valpatel/gyropup/hardware/exports/asm_pan_base.step

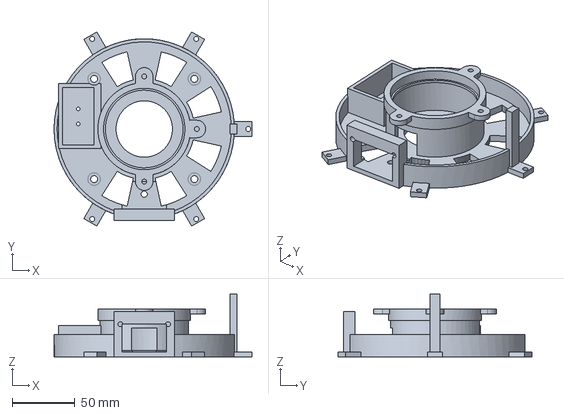
[picture p189: CAD file, 2026-10-26]
hardware/exports/asm_pan_base.step
158.0 x 155.0 x 50.0 mm
