Valpatel/gyropup/hardware/exports/asm_chassis.step

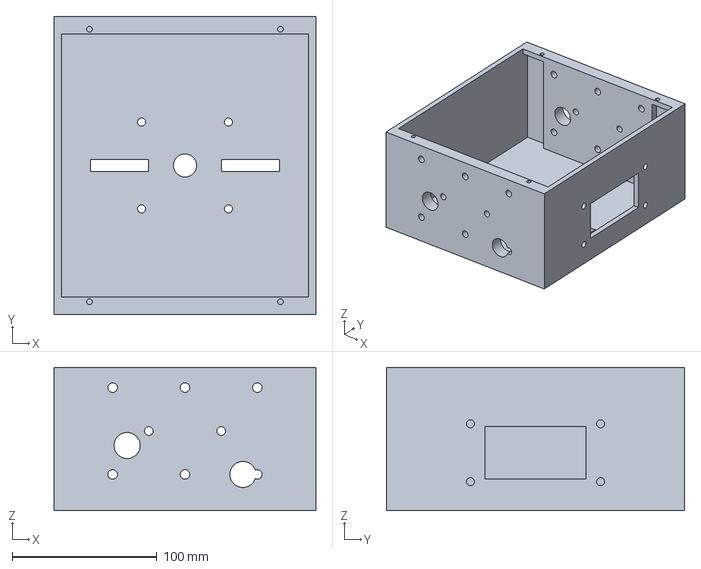
[picture p190: CAD file, 2026-10-26]
hardware/exports/asm_chassis.step
181.0 x 206.0 x 99.0 mm
