Valpatel/gyropup/hardware/exports/asm_yoke_bracket_r.step

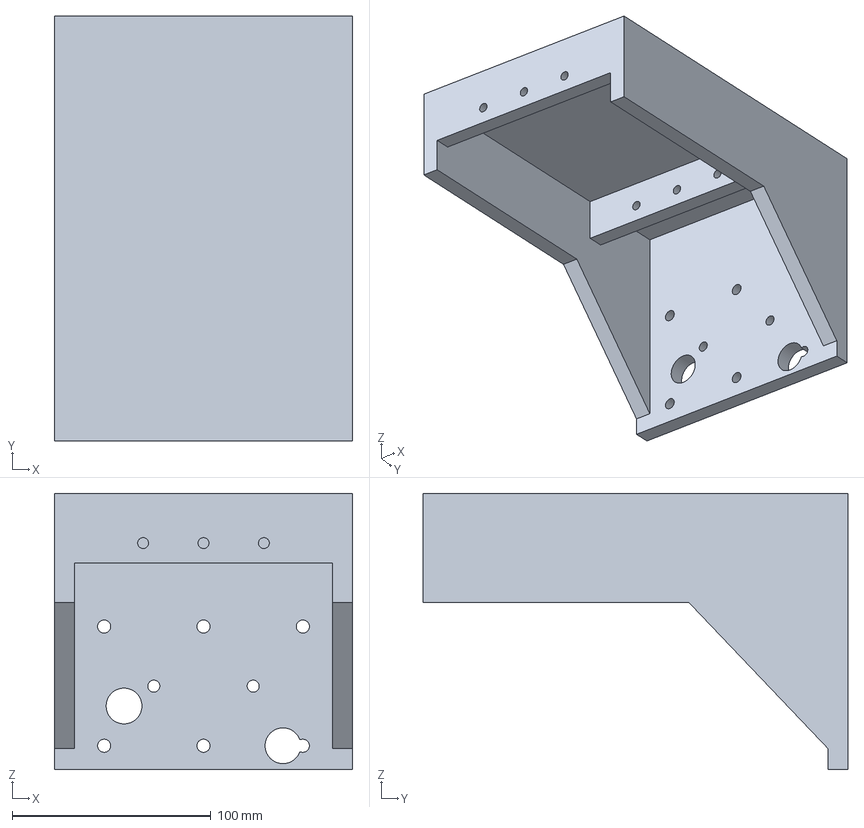
[picture p191: CAD file, 2026-10-26]
hardware/exports/asm_yoke_bracket_r.step
150.0 x 213.9 x 139.0 mm
