Valpatel/gyropup/hardware/exports/asm_hopper_flap.step

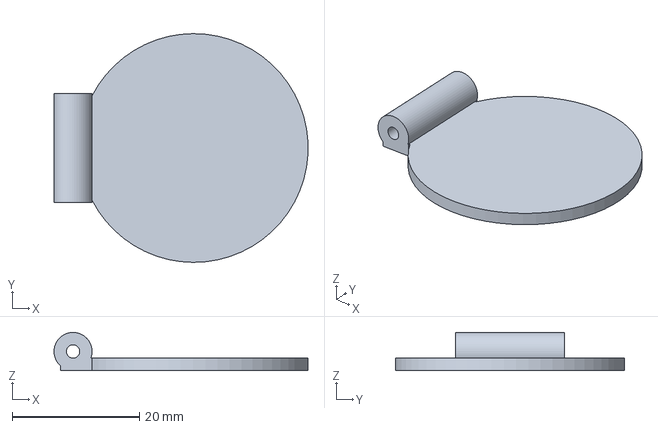
[picture p192: CAD file, 2026-10-26]
hardware/exports/asm_hopper_flap.step
40.0 x 36.0 x 5.99 mm
