Valpatel/gyropup/hardware/exports/asm_knee_output_adapter_r.step

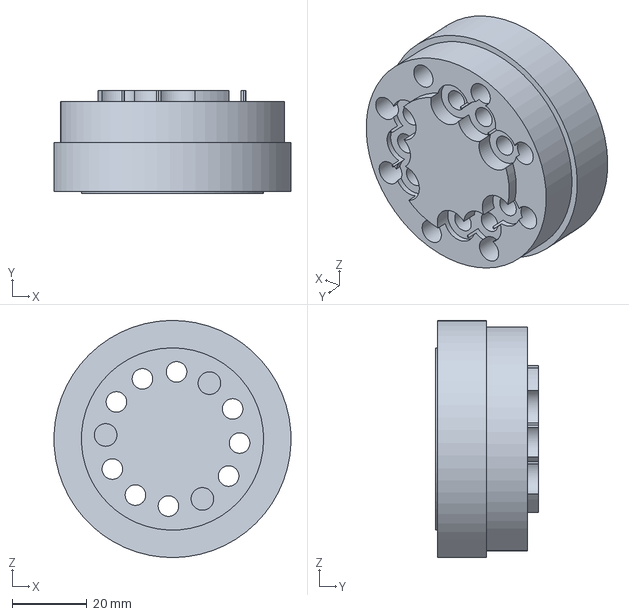
[picture p193: CAD file, 2026-10-26]
hardware/exports/asm_knee_output_adapter_r.step
63.5 x 27.6 x 63.5 mm
