Valpatel/gyropup/hardware/exports/asm_lidar.step

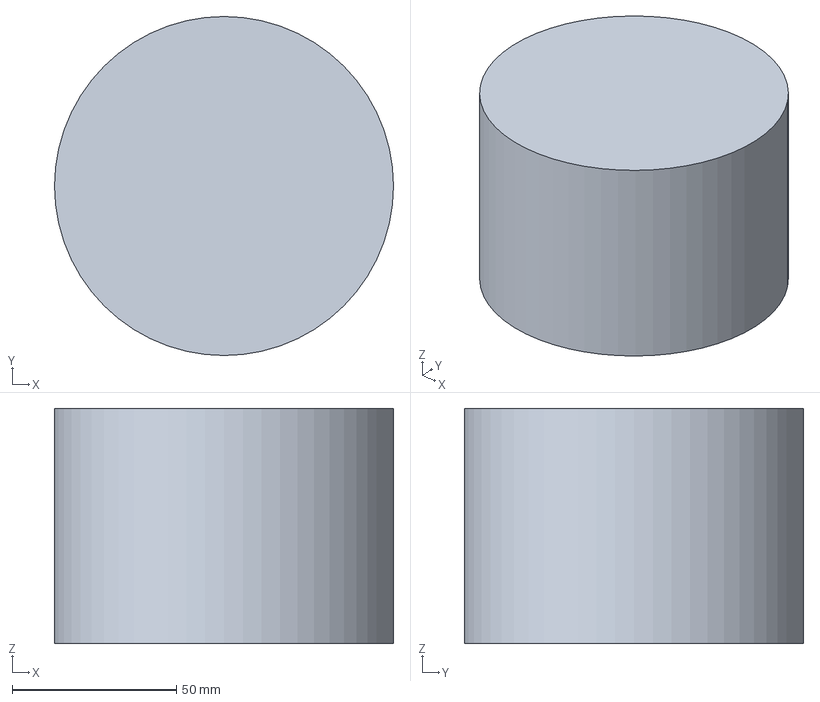
[picture p194: CAD file, 2026-10-26]
hardware/exports/asm_lidar.step
103.3 x 103.3 x 71.7 mm
