Valpatel/gyropup/hardware/exports/asm_pan_pinion.step

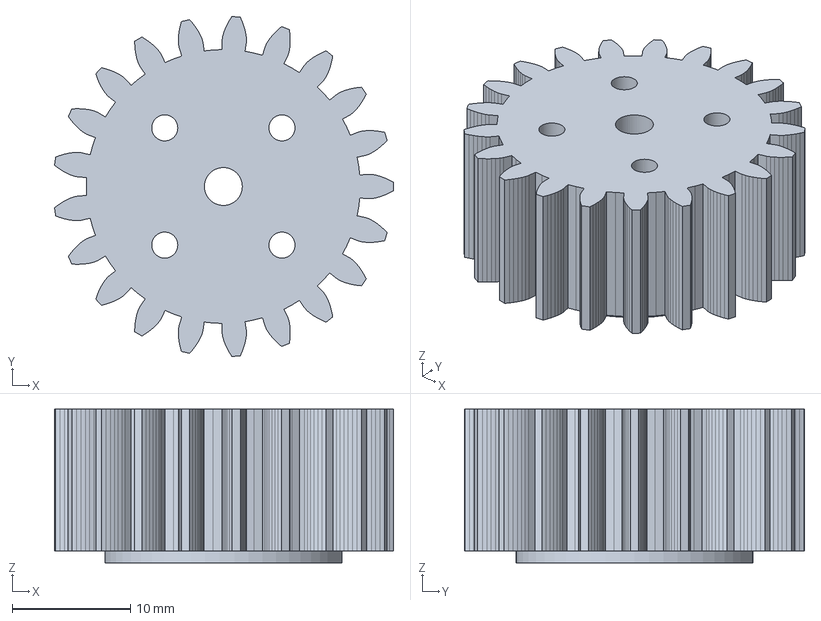
[picture p195: CAD file, 2026-10-26]
hardware/exports/asm_pan_pinion.step
28.6 x 28.7 x 13.0 mm
