Valpatel/gyropup/hardware/exports/asm_hopper.step

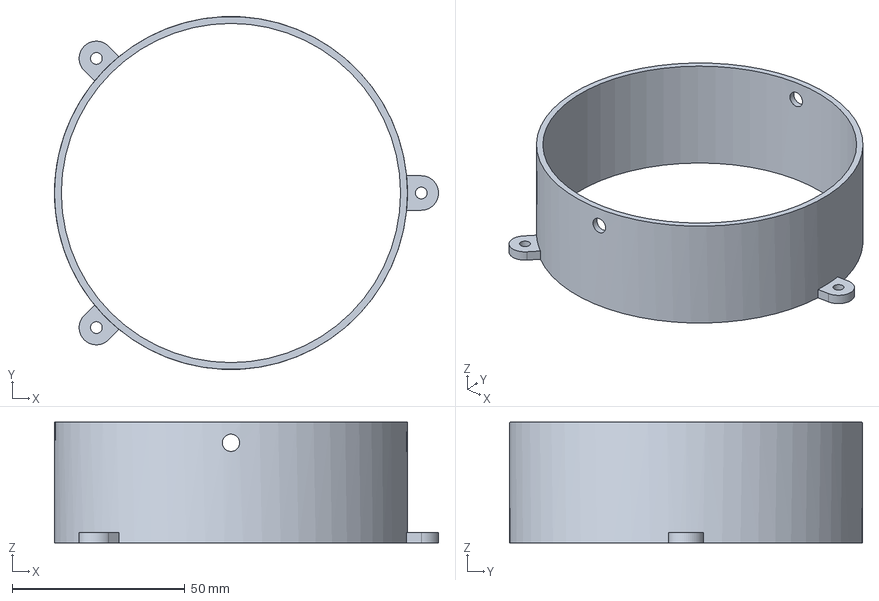
[picture p196: CAD file, 2026-10-26]
hardware/exports/asm_hopper.step
111.2 x 102.2 x 35.0 mm
