Valpatel/gyropup/hardware/exports/asm_shin_l.step

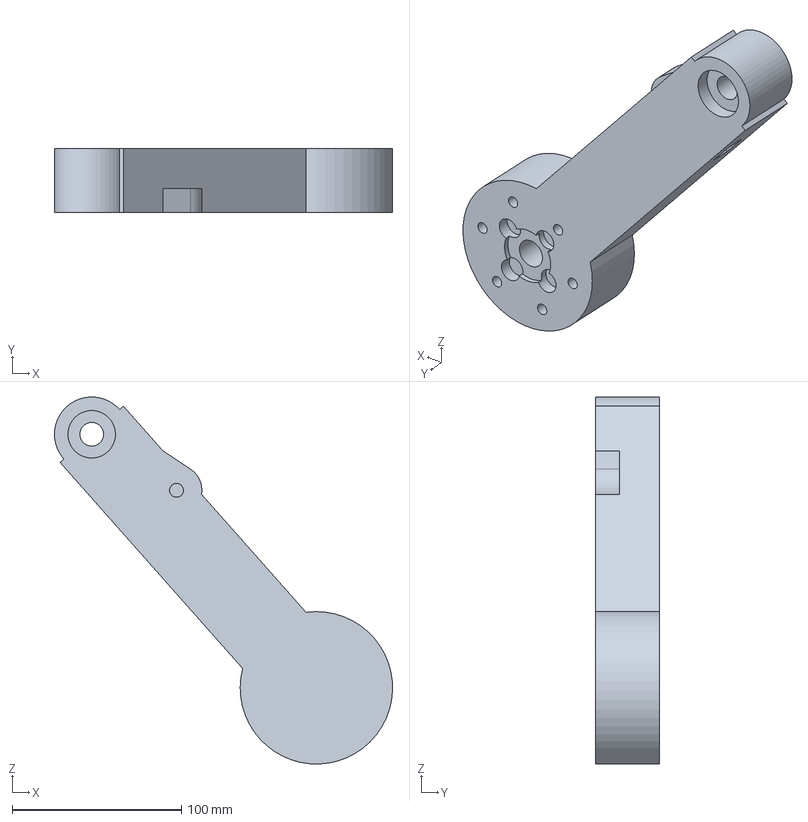
[picture p197: CAD file, 2026-10-26]
hardware/exports/asm_shin_l.step
199.6 x 37.5 x 216.7 mm
