Valpatel/gyropup/hardware/exports/asm_barrel.step

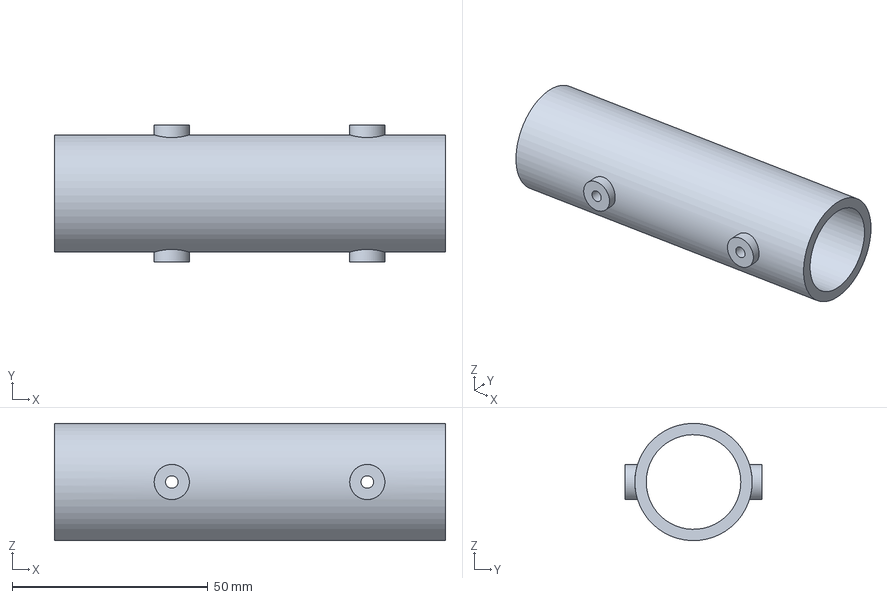
[picture p198: CAD file, 2026-10-26]
hardware/exports/asm_barrel.step
100.0 x 35.0 x 30.0 mm
