Valpatel/gyropup/hardware/exports/asm_face.step

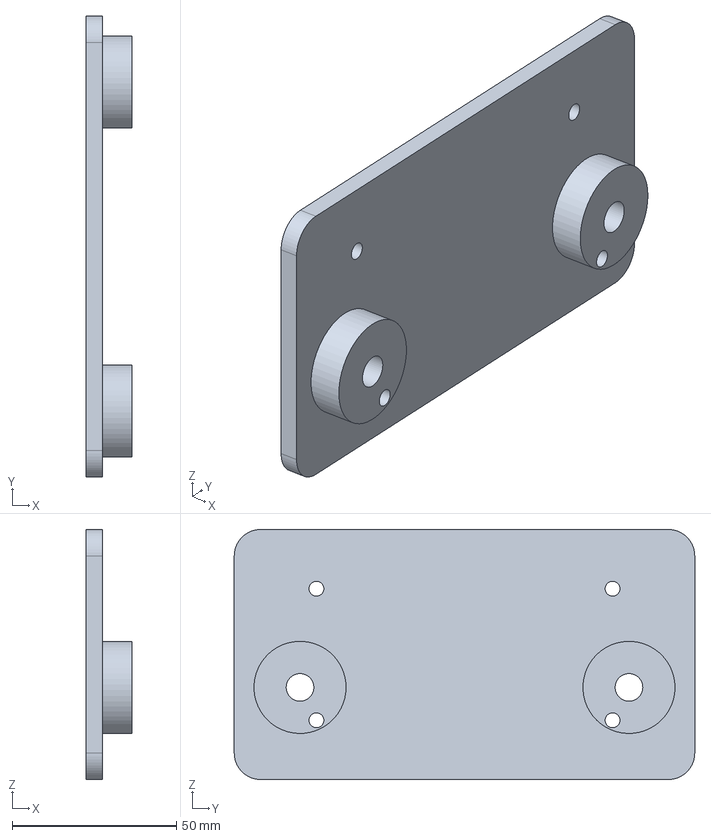
[picture p199: CAD file, 2026-10-26]
hardware/exports/asm_face.step
14.0 x 140.0 x 76.0 mm
