Valpatel/gyropup/hardware/exports/asm_lidar_guard.step

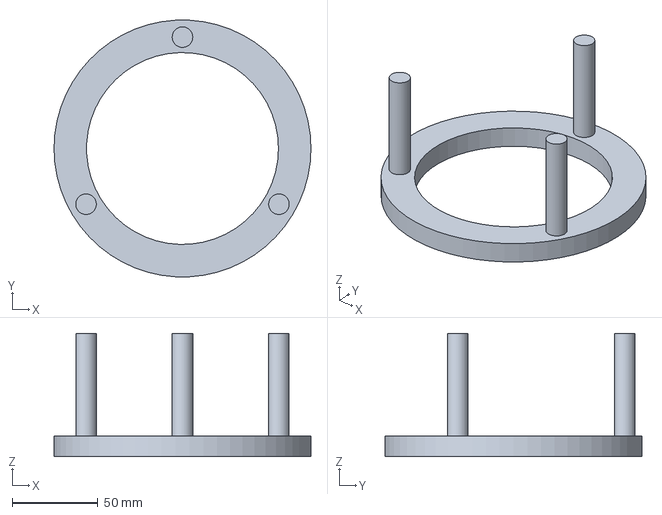
[picture p200: CAD file, 2026-10-26]
hardware/exports/asm_lidar_guard.step
150.0 x 149.8 x 72.0 mm
