Valpatel/gyropup/hardware/exports/asm_battery_cradle.step

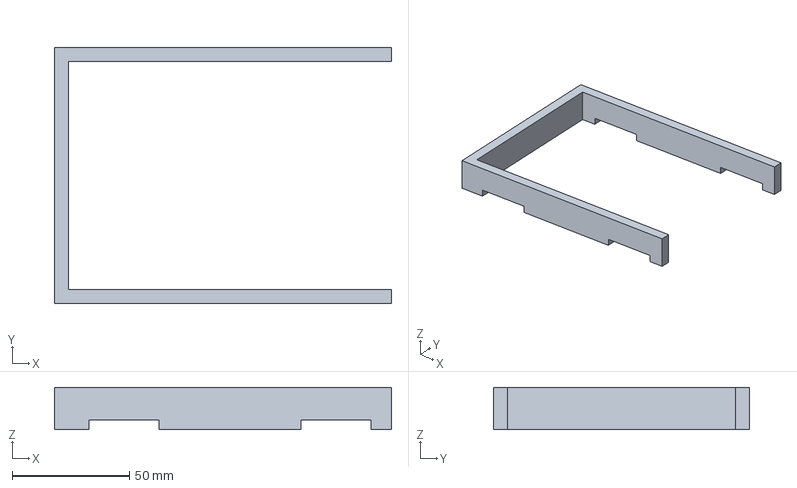
[picture p202: CAD file, 2026-10-26]
hardware/exports/asm_battery_cradle.step
144.0 x 109.4 x 18.0 mm
