Valpatel/gyropup/hardware/exports/asm_j501_box.step

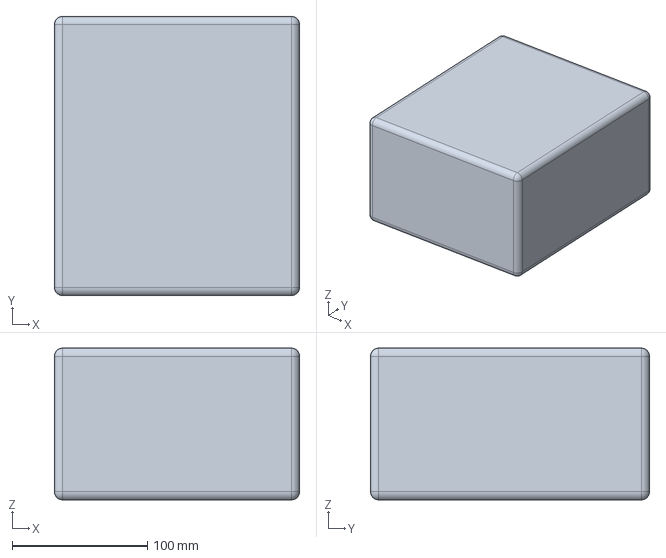
[picture p203: CAD file, 2026-10-26]
hardware/exports/asm_j501_box.step
181.0 x 206.0 x 112.0 mm
