Valpatel/gyropup/hardware/exports/asm_wheel_adapter_l.step

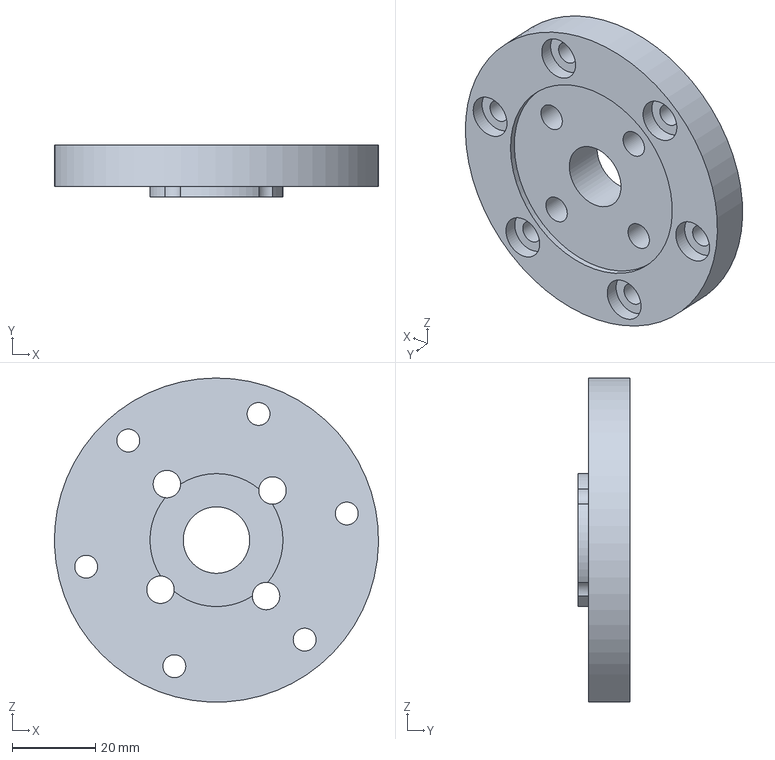
[picture p204: CAD file, 2026-10-26]
hardware/exports/asm_wheel_adapter_l.step
78.0 x 12.5 x 78.0 mm
