Valpatel/gyropup/hardware/exports/asm_cartridge_body.step

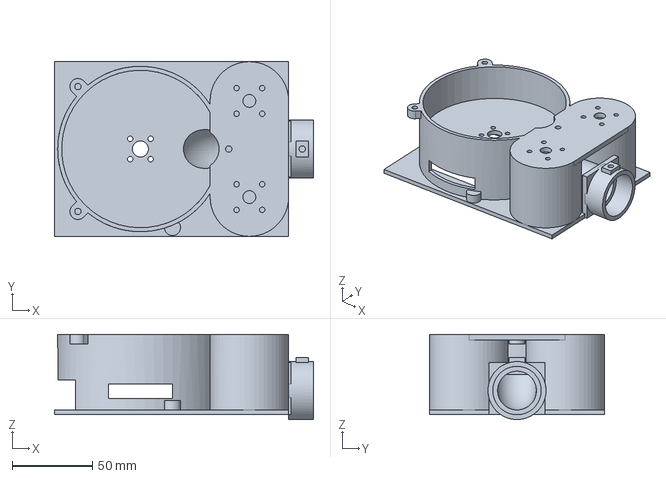
[picture p205: CAD file, 2026-10-26]
hardware/exports/asm_cartridge_body.step
161.6 x 109.0 x 53.1 mm
