Valpatel/gyropup/hardware/exports/asm_posts_r.step

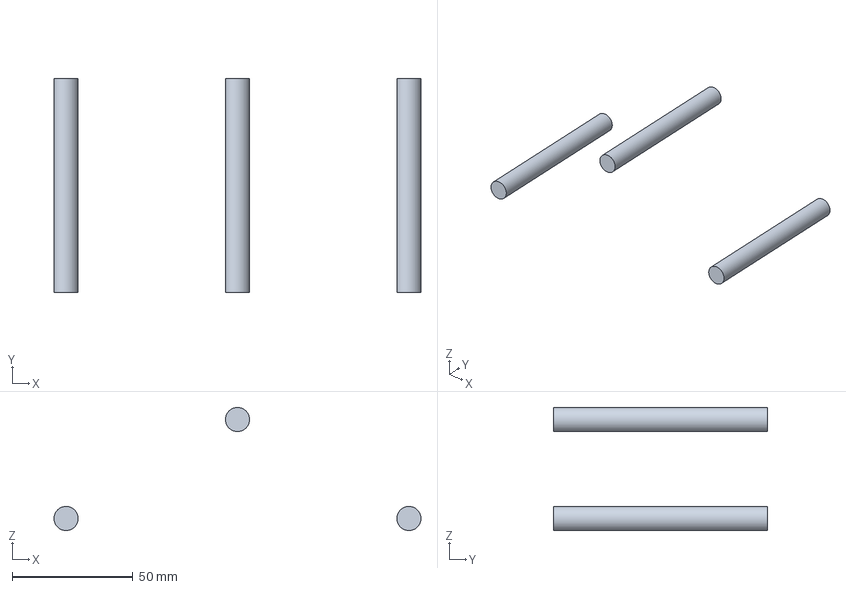
[picture p206: CAD file, 2026-10-26]
hardware/exports/asm_posts_r.step
152.0 x 88.5 x 51.0 mm
