Valpatel/gyropup/hardware/exports/asm_electronics_bay.step

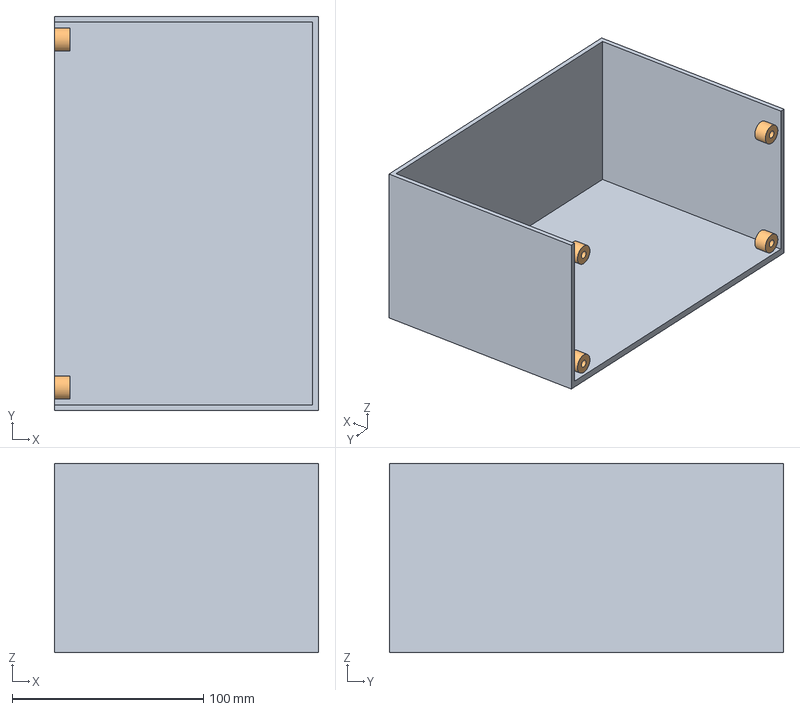
[picture p207: CAD file, 2026-10-26]
hardware/exports/asm_electronics_bay.step
138.0 x 206.0 x 99.0 mm
