Valpatel/gyropup/hardware/exports/asm_camera_cradle.step

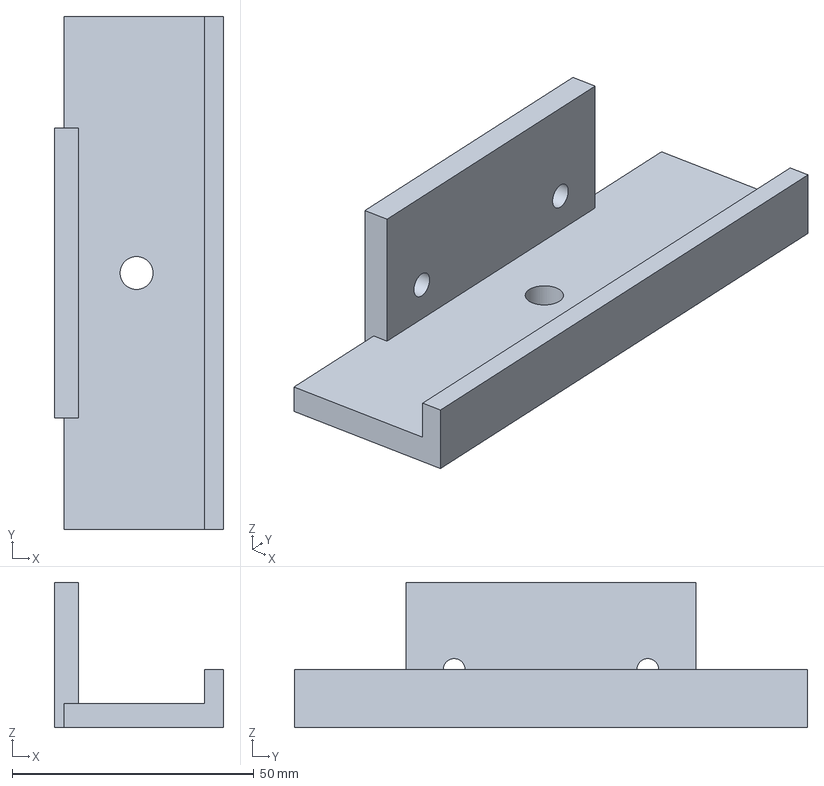
[picture p208: CAD file, 2026-10-26]
hardware/exports/asm_camera_cradle.step
35.0 x 106.0 x 30.0 mm
