Valpatel/gyropup/hardware/exports/asm_head_saddle.step

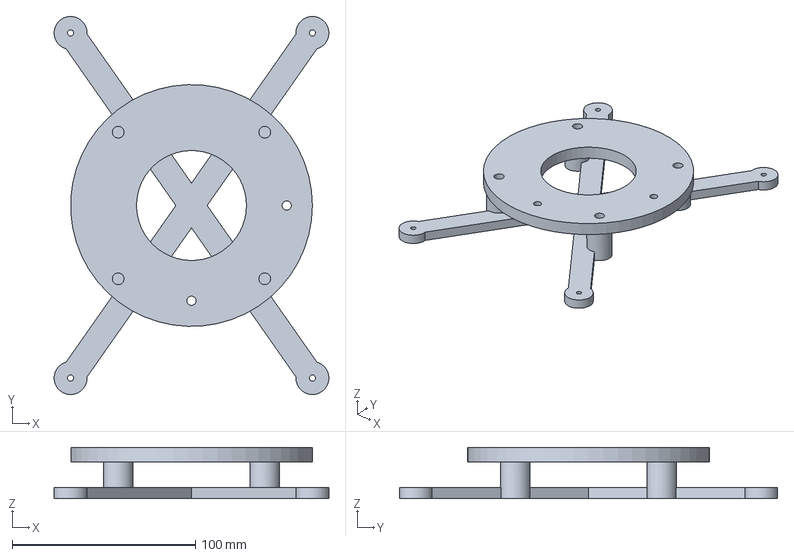
[picture p209: CAD file, 2026-10-26]
hardware/exports/asm_head_saddle.step
150.0 x 206.4 x 28.0 mm
