Valpatel/gyropup/hardware/exports/asm_tilt_yoke.step

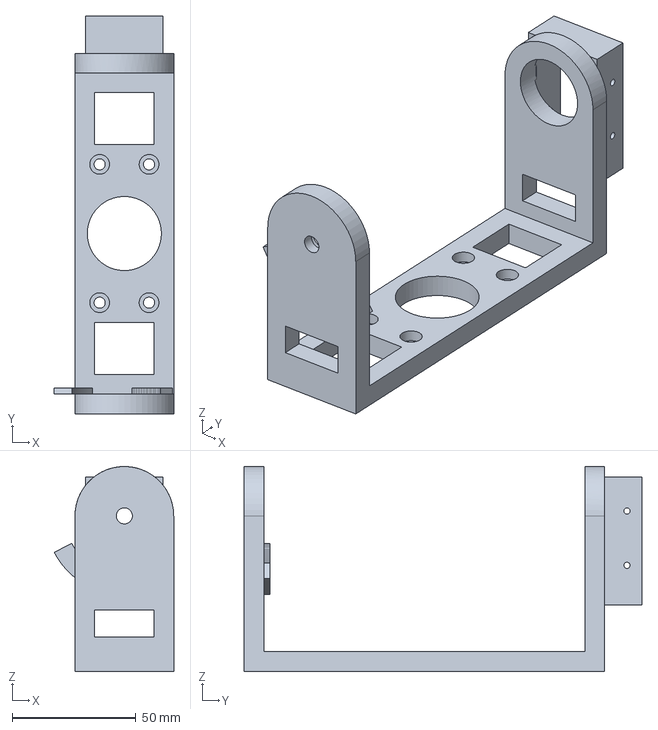
[picture p210: CAD file, 2026-10-26]
hardware/exports/asm_tilt_yoke.step
48.4 x 161.0 x 83.0 mm
