Valpatel/gyropup/hardware/exports/asm_flywheel_tyre.step

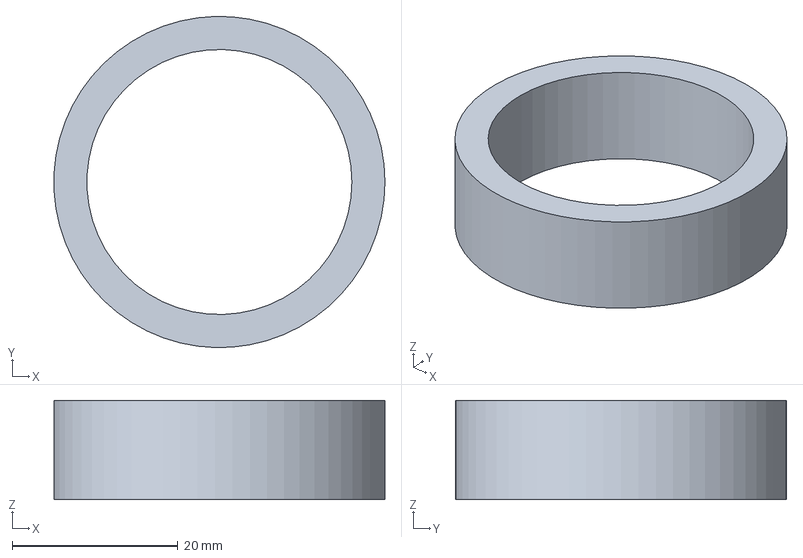
[picture p211: CAD file, 2026-10-26]
hardware/exports/asm_flywheel_tyre.step
40.0 x 40.0 x 12.0 mm
