Valpatel/gyropup/hardware/exports/asm_knee_motor_plate_l.step

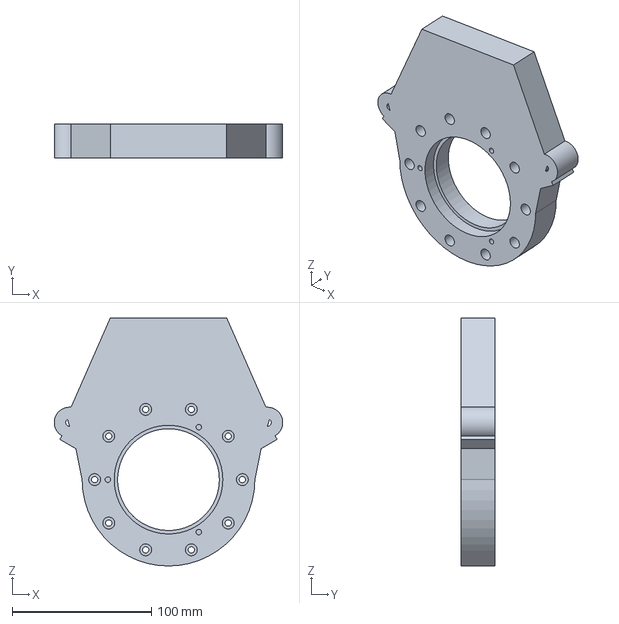
[picture p212: CAD file, 2026-10-26]
hardware/exports/asm_knee_motor_plate_l.step
164.0 x 24.1 x 178.0 mm
