Valpatel/gyropup/hardware/exports/asm_camera_front.step

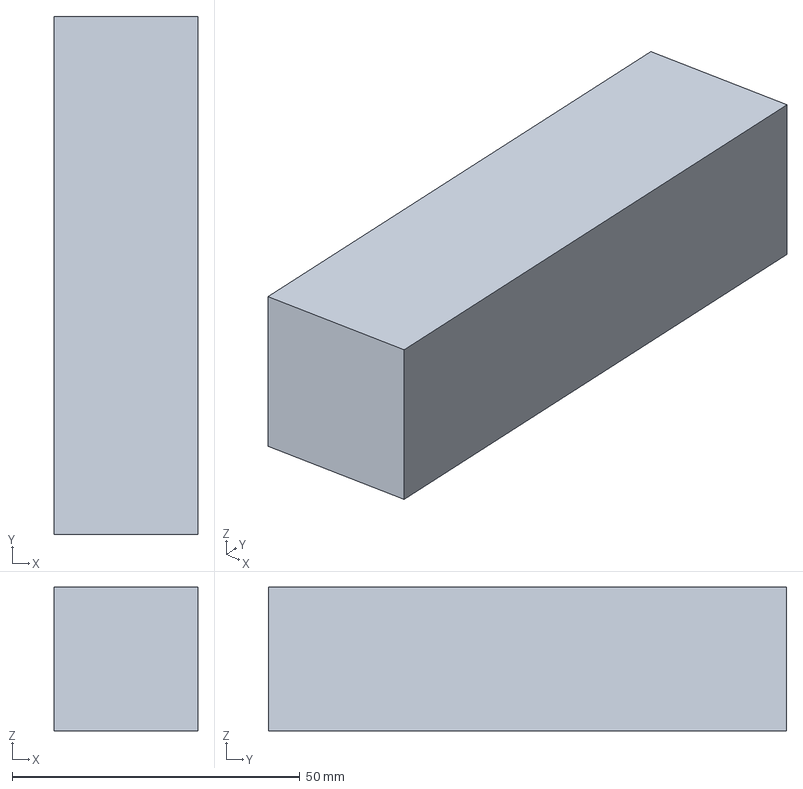
[picture p213: CAD file, 2026-10-26]
hardware/exports/asm_camera_front.step
25.0 x 90.0 x 25.0 mm
