Valpatel/gyropup/hardware/exports/asm_pushrod_l.step

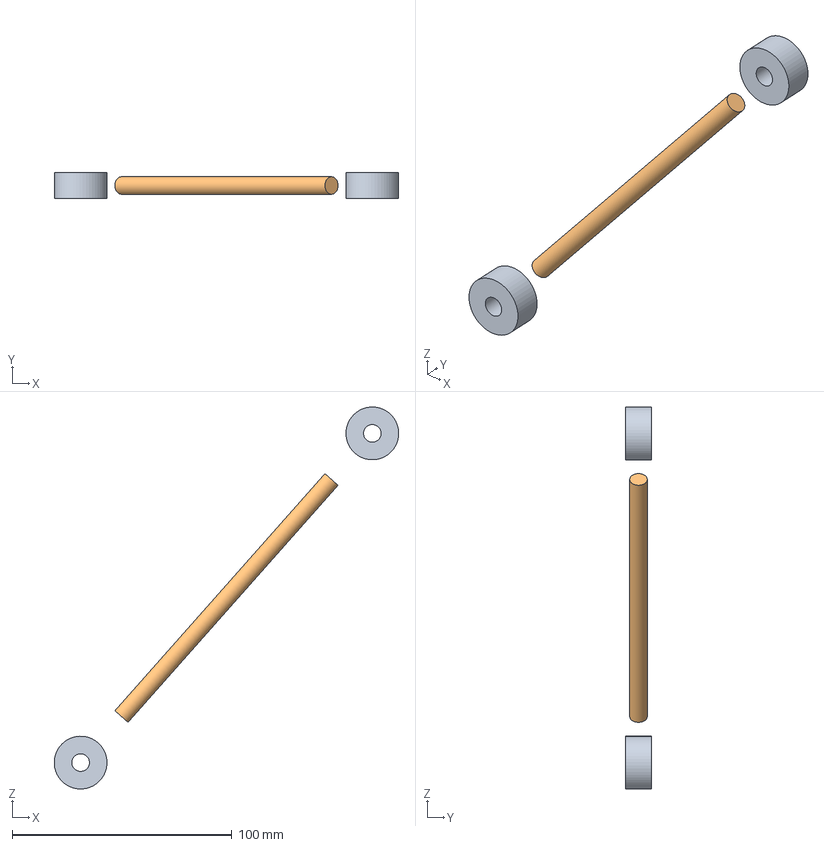
[picture p214: CAD file, 2026-10-26]
hardware/exports/asm_pushrod_l.step
156.6 x 12.0 x 173.7 mm
