Valpatel/gyropup/hardware/exports/asm_dial.step

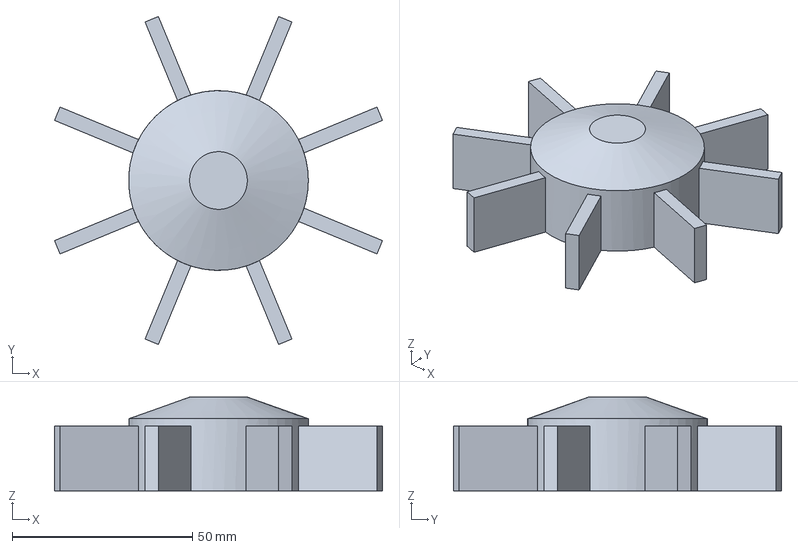
[picture p215: CAD file, 2026-10-26]
hardware/exports/asm_dial.step
90.9 x 90.9 x 26.0 mm
