Valpatel/gyropup/hardware/exports/asm_knee_crank_l.step

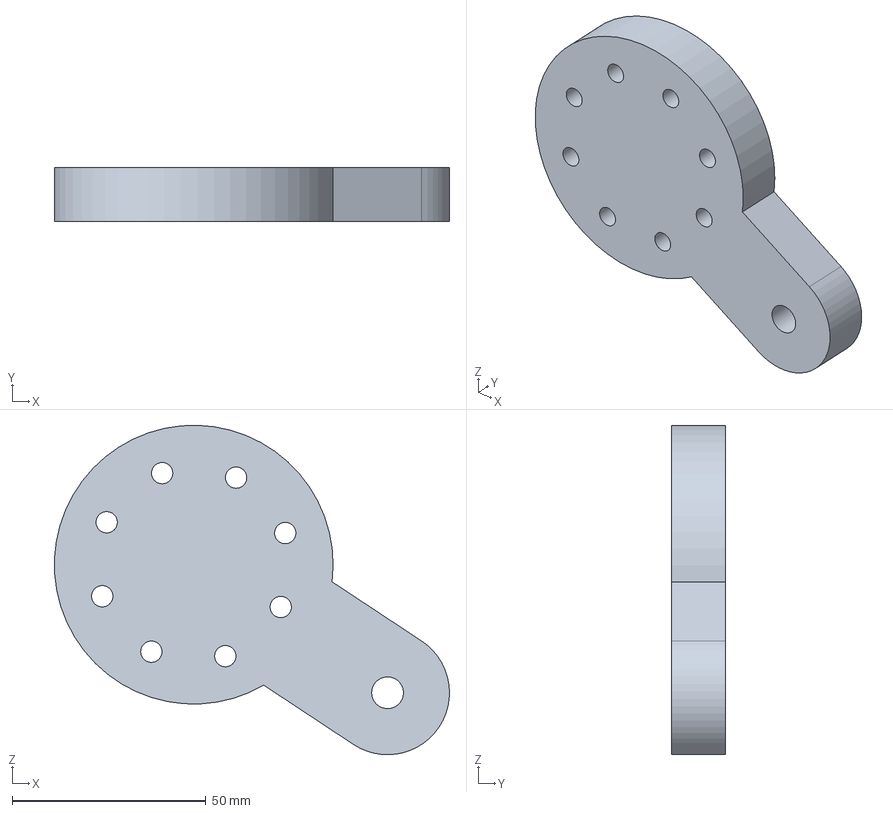
[picture p216: CAD file, 2026-10-26]
hardware/exports/asm_knee_crank_l.step
102.0 x 14.0 x 85.1 mm
