Valpatel/gyropup/hardware/exports/asm_flywheel.step

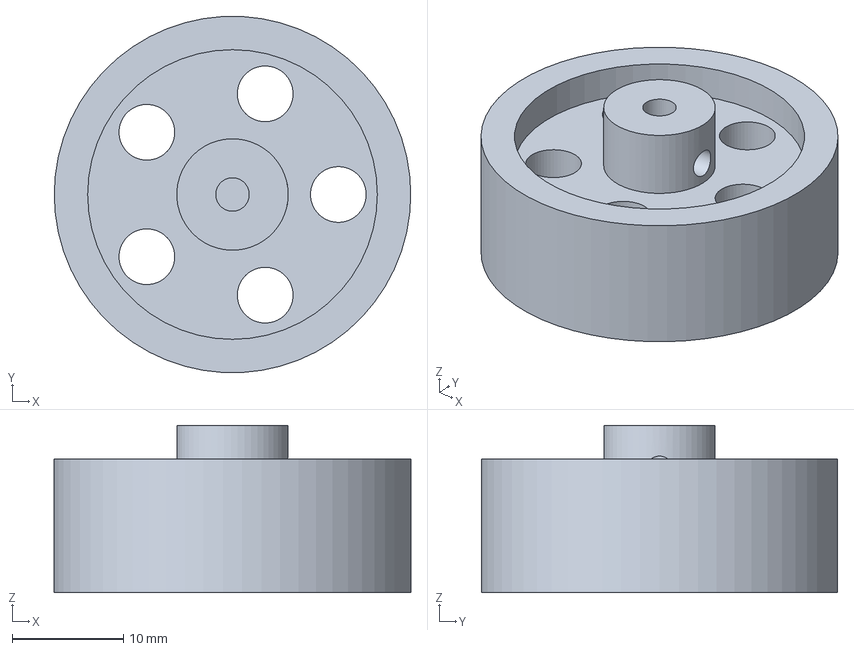
[picture p217: CAD file, 2026-10-26]
hardware/exports/asm_flywheel.step
32.0 x 32.0 x 15.0 mm
