Valpatel/gyropup/hardware/exports/asm_pan_clamp.step

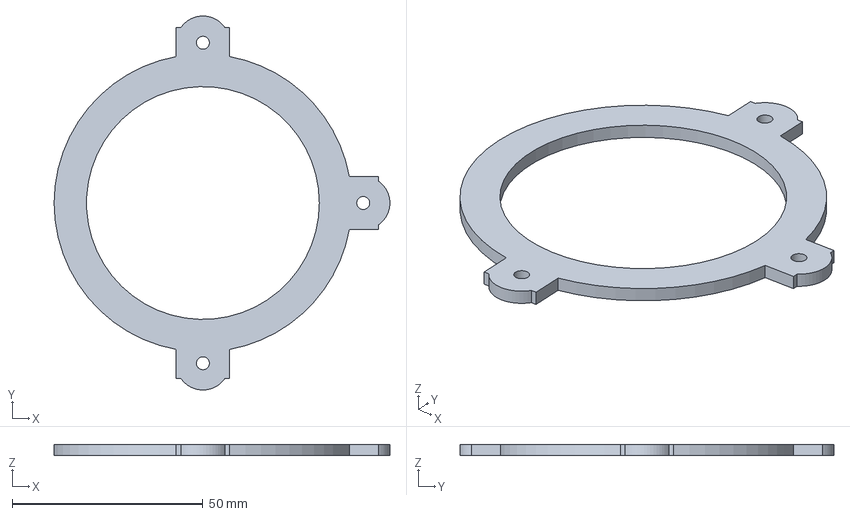
[picture p218: CAD file, 2026-10-26]
hardware/exports/asm_pan_clamp.step
88.0 x 98.0 x 3.00 mm
