Valpatel/gyropup/hardware/exports/asm_bumper_ring.step

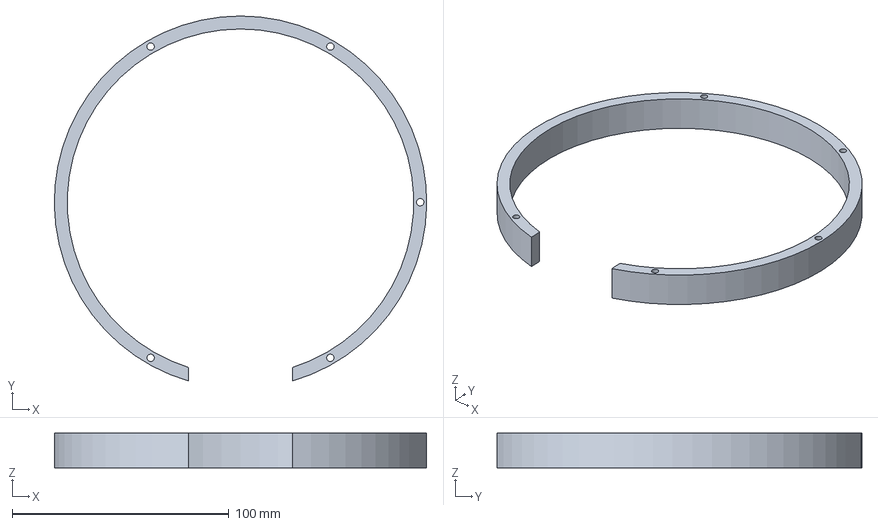
[picture p219: CAD file, 2026-10-26]
hardware/exports/asm_bumper_ring.step
172.0 x 168.6 x 16.0 mm
