Valpatel/gyropup/hardware/exports/asm_wheel_l.step

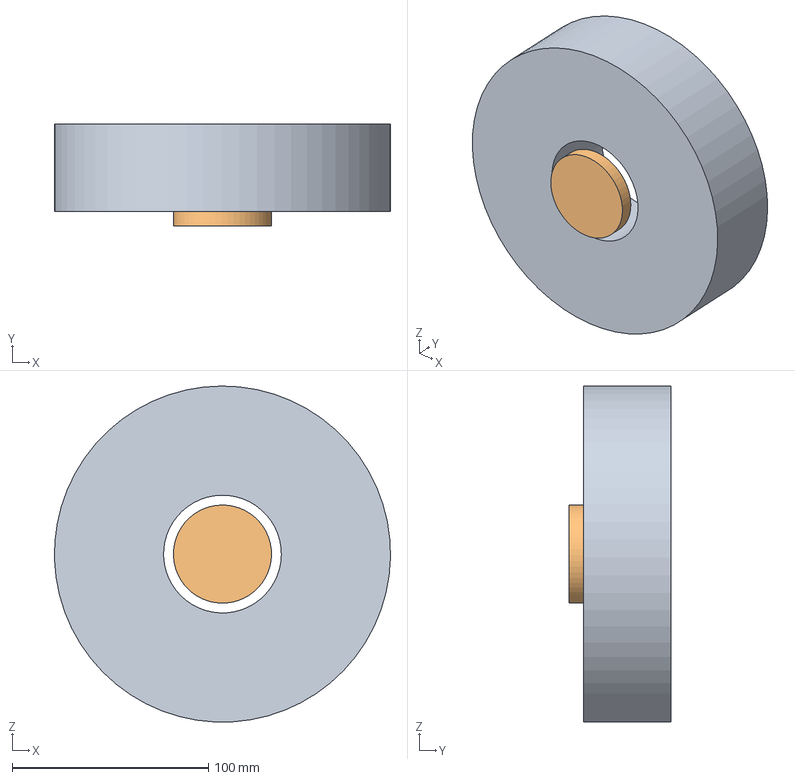
[picture p220: CAD file, 2026-10-26]
hardware/exports/asm_wheel_l.step
171.2 x 52.1 x 171.2 mm
