Valpatel/gyropup/hardware/exports/asm_lidar_hanger.step

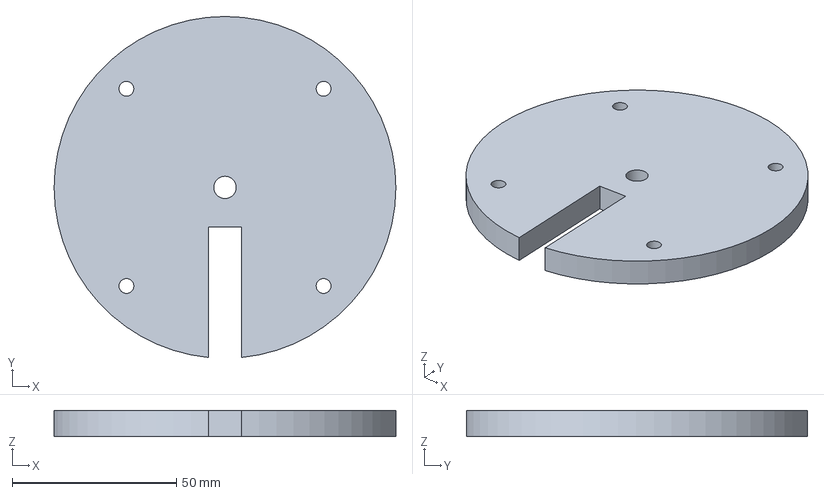
[picture p221: CAD file, 2026-10-26]
hardware/exports/asm_lidar_hanger.step
104.0 x 103.8 x 8.00 mm
