Valpatel/gyropup/hardware/exports/asm_battery_1.step

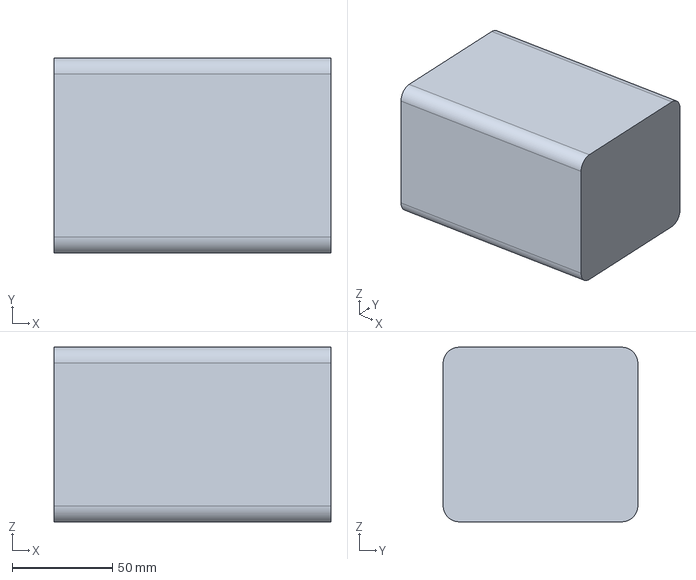
[picture p222: CAD file, 2026-10-26]
hardware/exports/asm_battery_1.step
138.0 x 97.0 x 87.0 mm
