Valpatel/gyropup/hardware/exports/asm_cradle.step

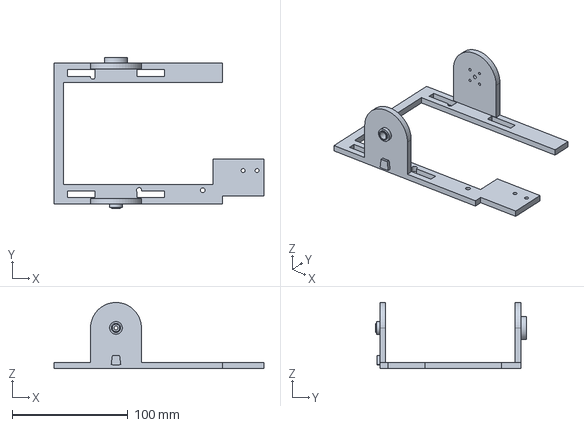
[picture p223: CAD file, 2026-10-26]
hardware/exports/asm_cradle.step
181.6 x 131.0 x 57.1 mm
