Valpatel/gyropup/hardware/exports/asm_hopper_lid.step

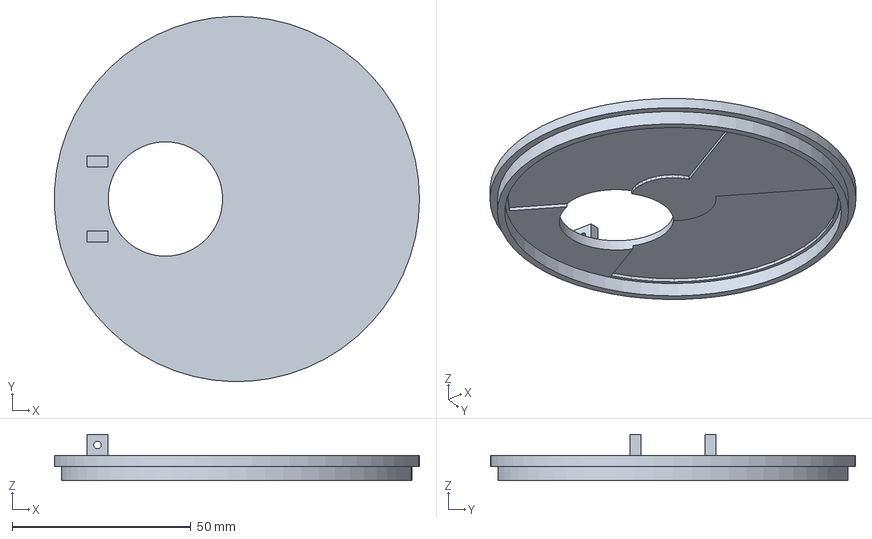
[picture p224: CAD file, 2026-10-26]
hardware/exports/asm_hopper_lid.step
102.1 x 102.2 x 13.0 mm
