Valpatel/gyropup/software/site/assets/build-guides/robot-wip-3a40891962b0/meshes/item__plate_main_switch.stl

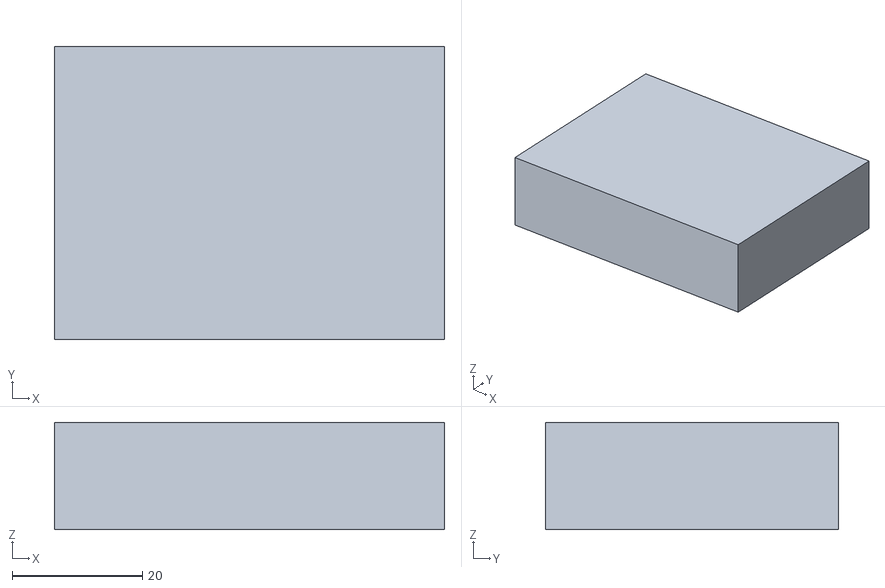
[picture p225: CAD file, 2026-11-10]
software/site/assets/build-guides/robot-wip-3a40891962b0/meshes/item__plate_main_switch.stl
60.0 x 45.0 x 16.5
