Valpatel/gyropup/docs/research/body-sheet-metal/dxf/floor_tray_5052-0.125_x1.dxf

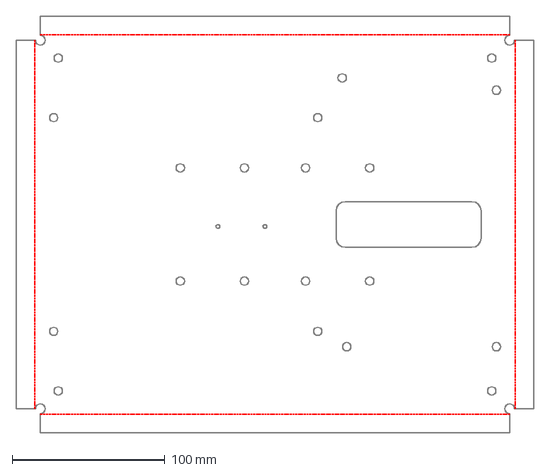
[picture p226: CAD file, 2026-11-07]
docs/research/body-sheet-metal/dxf/floor_tray_5052-0.125_x1.dxf
339.0 x 273.0 mm
