Valpatel/gyropup/docs/research/rs04-support/results/od120-id94-t2.032.step

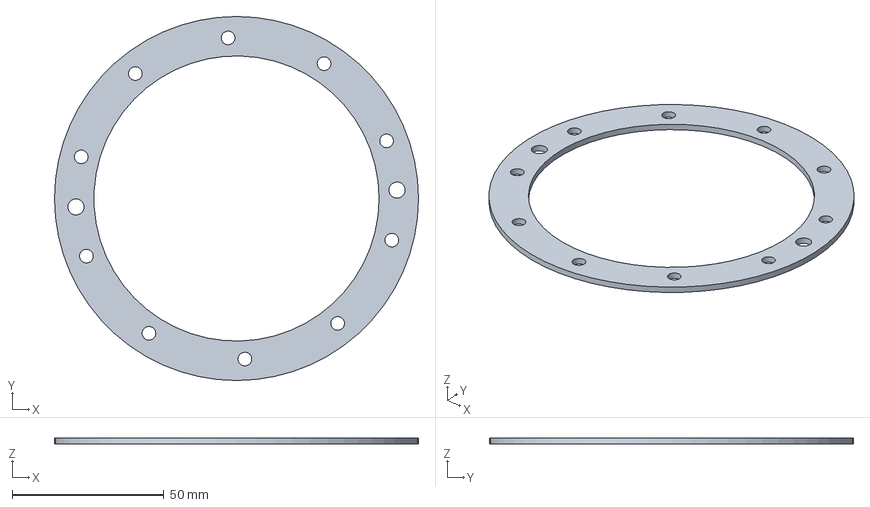
[picture p227: CAD file, 2026-11-07]
docs/research/rs04-support/results/od120-id94-t2.032.step
120.0 x 120.0 x 2.03 mm
