Valpatel/gyropup/hardware/exports/body/adapter_plate_front.step

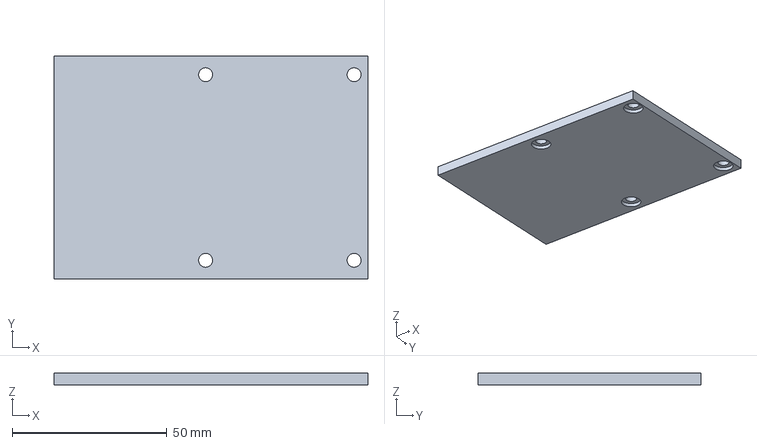
[picture p228: CAD file, 2026-11-05]
hardware/exports/body/adapter_plate_front.step
101.5 x 72.0 x 4.00 mm
