Valpatel/gyropup/hardware/exports/body/sendcutsend/bay_side_5052-H32_0.063in_x2.step

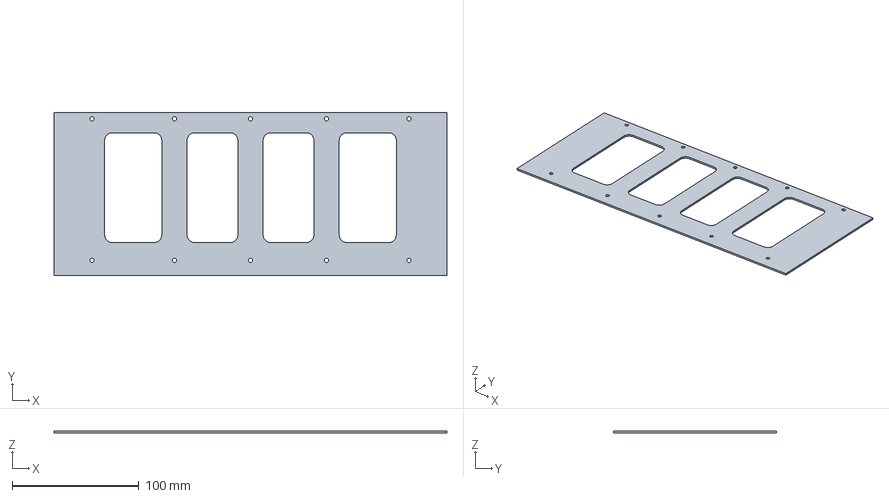
[picture p229: CAD file, 2026-11-05]
hardware/exports/body/sendcutsend/bay_side_5052-H32_0.063in_x2.step
310.0 x 128.6 x 1.60 mm
