Valpatel/gyropup/hardware/exports/body/shell/eyes_clip.step

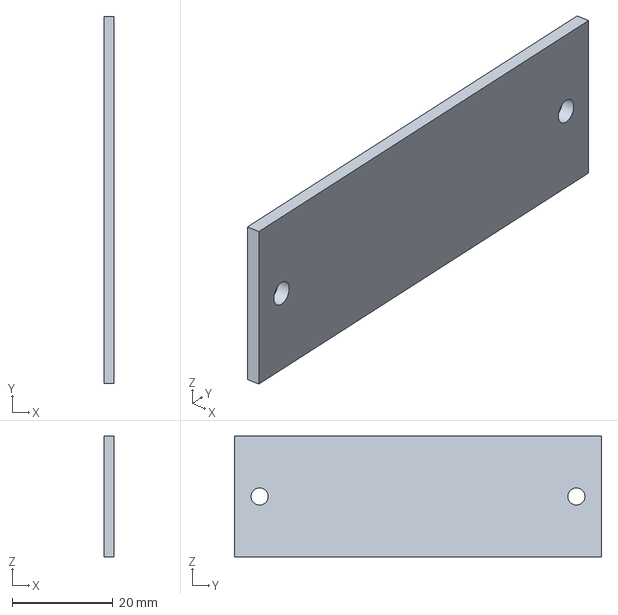
[picture p230: CAD file, 2026-11-05]
hardware/exports/body/shell/eyes_clip.step
2.00 x 73.0 x 24.0 mm
