Valpatel/gyropup/hardware/exports/leg/cnc/output_adapter.step

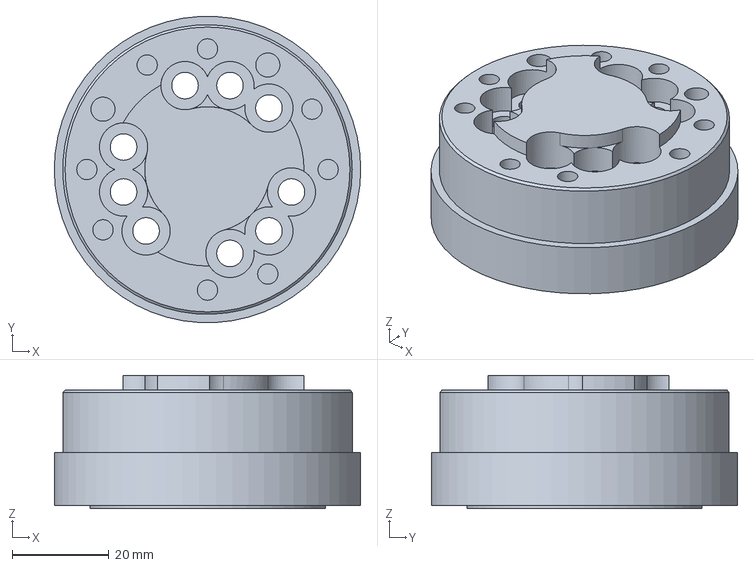
[picture p231: CAD file, 2026-10-28]
hardware/exports/leg/cnc/output_adapter.step
63.5 x 63.4 x 27.6 mm
