Valpatel/gyropup/hardware/exports/leg/rs04-fit-job/geometry.3mf

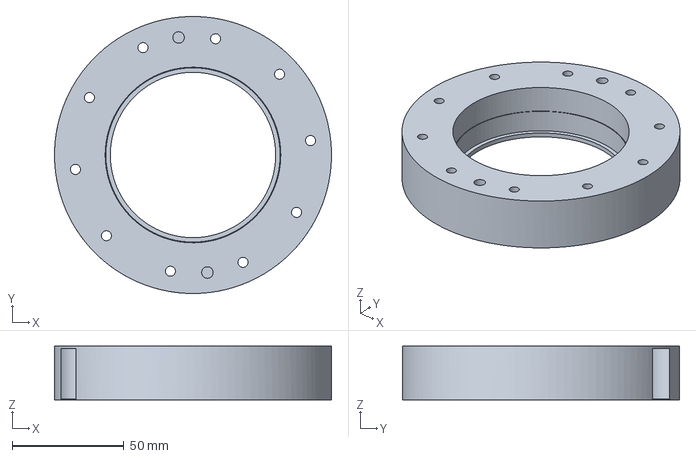
[picture p232: CAD file, 2026-11-06]
hardware/exports/leg/rs04-fit-job/geometry.3mf
124.0 x 124.0 x 24.1 mm
