Valpatel/gyropup/hardware/exports/leg/rs04-mounting-fit/hip_frame.step

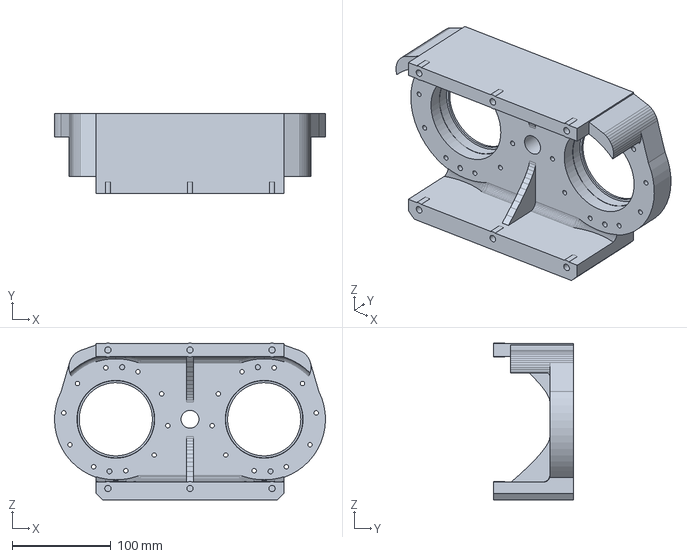
[picture p233: CAD file, 2026-11-07]
hardware/exports/leg/rs04-mounting-fit/hip_frame.step
274.0 x 81.3 x 158.5 mm
