Valpatel/gyropup/hardware/exports/leg/upper_link.step

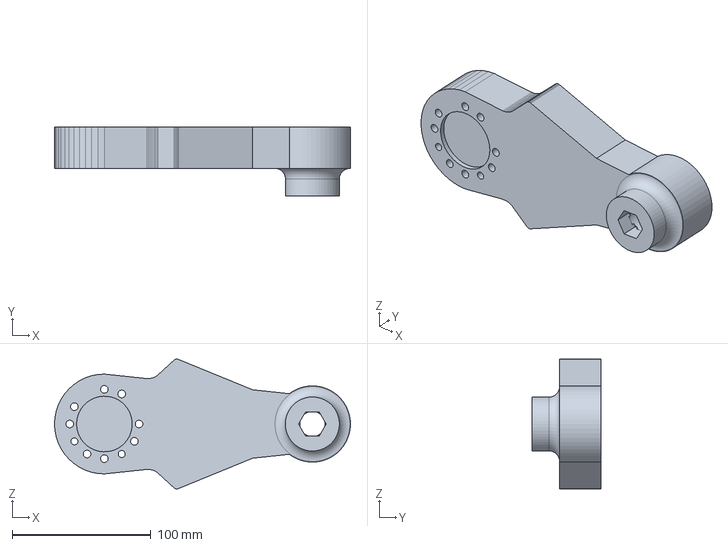
[picture p234: CAD file, 2026-11-02]
hardware/exports/leg/upper_link.step
213.5 x 50.0 x 93.6 mm
