Valpatel/gyropup/hardware/exports/motor-day/parts/foot.step

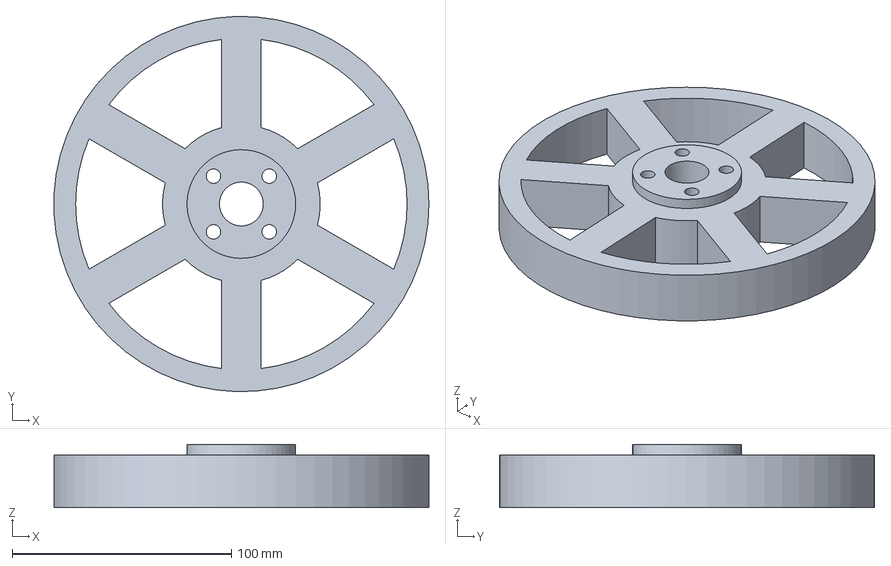
[picture p235: CAD file, 2026-11-03]
hardware/exports/motor-day/parts/foot.step
171.2 x 171.2 x 28.8 mm
