Valpatel/gyropup/hardware/exports/rig/bench/coupon_c4_today.step

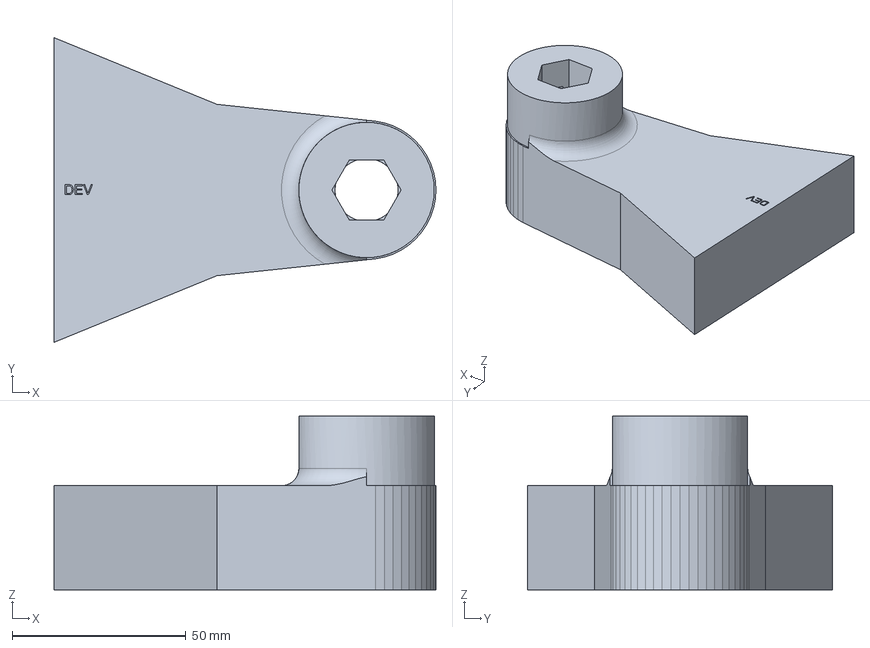
[picture p236: CAD file, 2026-11-02]
hardware/exports/rig/bench/coupon_c4_today.step
110.0 x 87.8 x 50.0 mm
