Valpatel/gyropup/hardware/exports/rig/pod.step

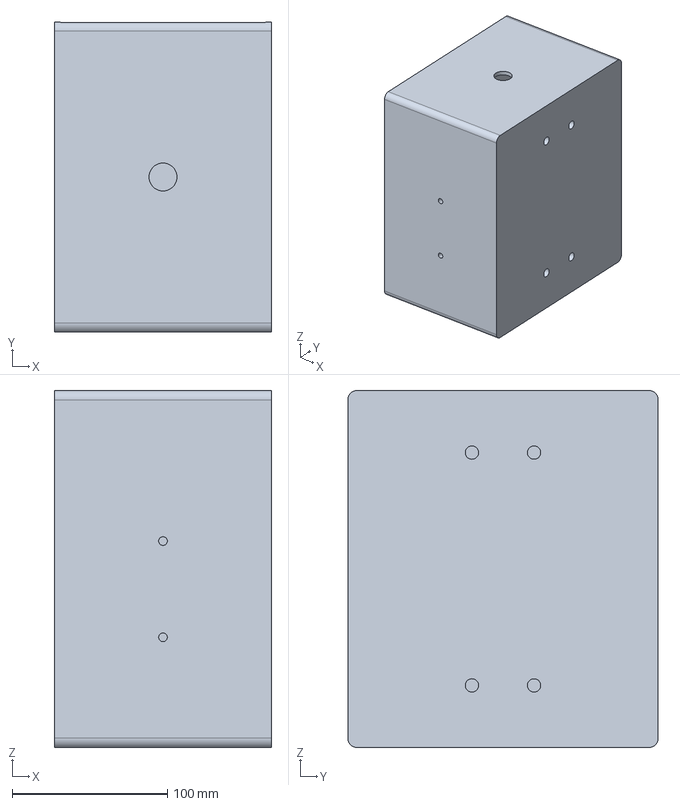
[picture p237: CAD file, 2026-10-28]
hardware/exports/rig/pod.step
140.0 x 200.0 x 230.0 mm
