Valpatel/gyropup/hardware/exports/rig/sendcutsend/carriage_plate.step

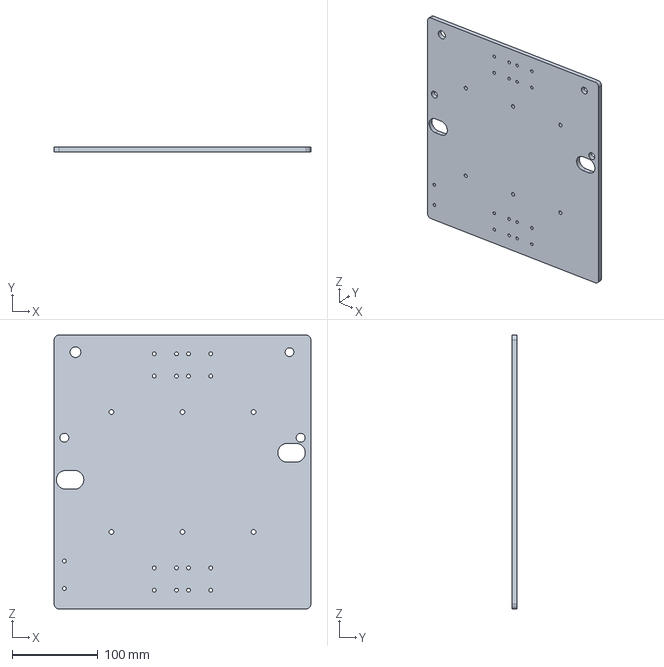
[picture p238: CAD file, 2026-10-28]
hardware/exports/rig/sendcutsend/carriage_plate.step
300.0 x 6.35 x 320.0 mm
