Valpatel/gyropup/hardware/exports/robot/lidar.step

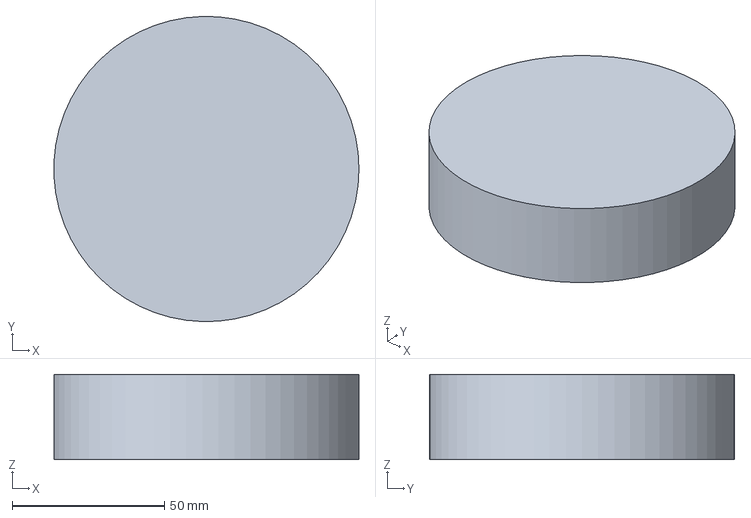
[picture p239: CAD file, 2026-11-05]
hardware/exports/robot/lidar.step
100.2 x 100.3 x 28.0 mm
