Valpatel/gyropup/hardware/exports/sim/turret_box/hopper_lid.stl

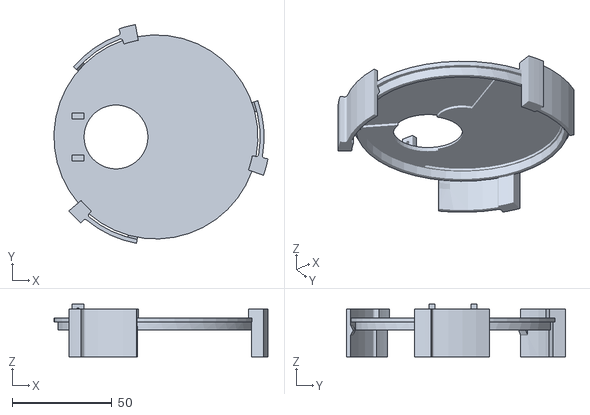
[picture p240: CAD file, 2026-11-07]
hardware/exports/sim/turret_box/hopper_lid.stl
107.2 x 109.6 x 26.5
