Valpatel/gyropup/hardware/exports/sim/v2/rig/body__fuse.stl

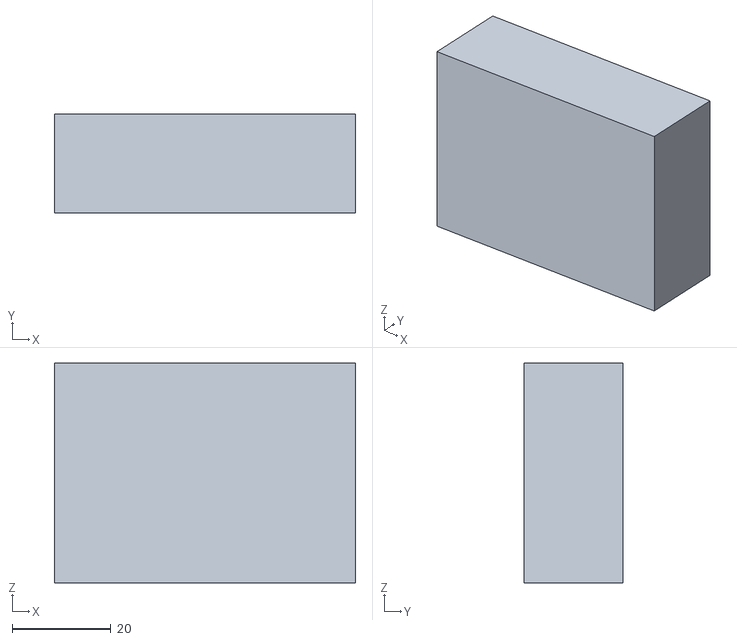
[picture p241: CAD file, 2026-10-28]
hardware/exports/sim/v2/rig/body__fuse.stl
60.9 x 20.0 x 44.5
