Valpatel/gyropup/hardware/exports/turret/base-board-service/base_board_carrier.step

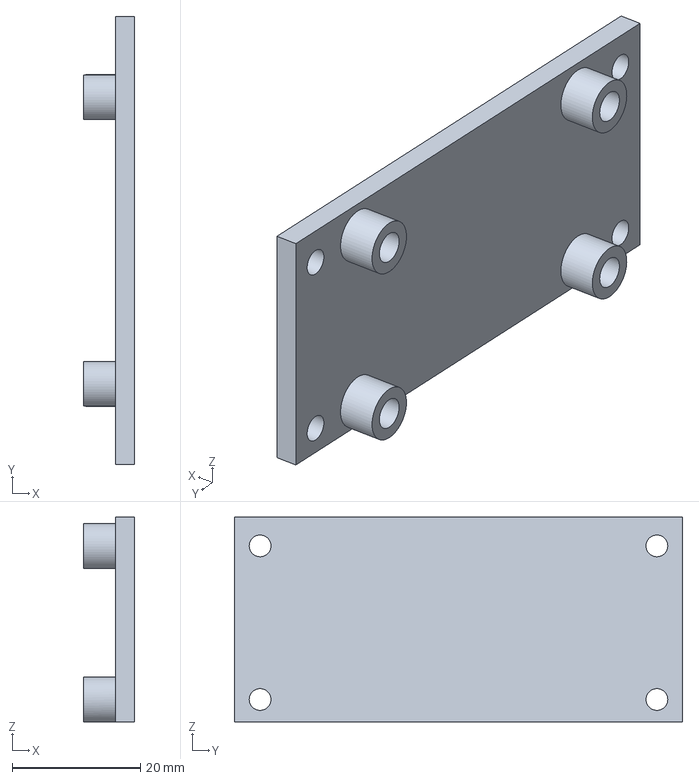
[picture p242: CAD file, 2026-10-29]
hardware/exports/turret/base-board-service/base_board_carrier.step
8.00 x 70.0 x 32.0 mm
