Valpatel/gyropup/hardware/exports/turret/base-board-service/connectors/C3-support-layout.step

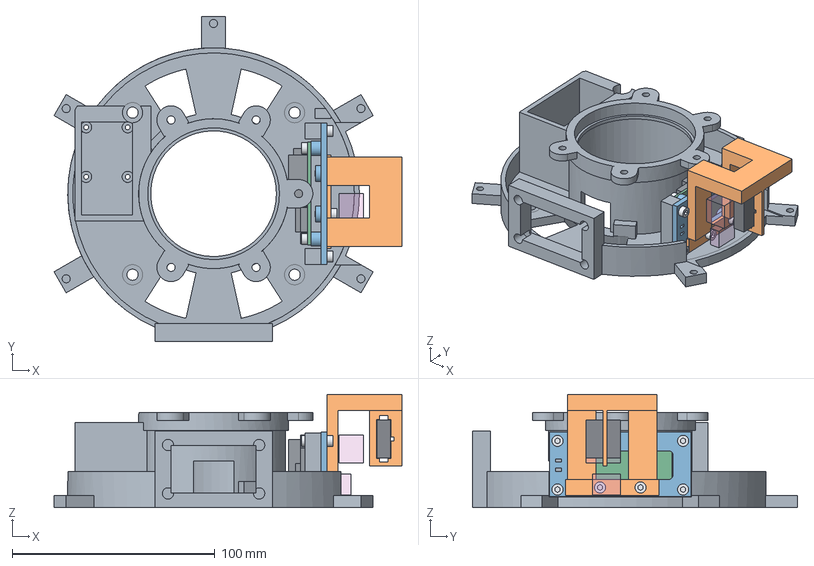
[picture p243: CAD file, 2026-11-07]
hardware/exports/turret/base-board-service/connectors/C3-support-layout.step
171.8 x 160.5 x 56.0 mm
pan_base_authored
carrier_candidate_authored
C3_support_candidate_authored
cut_PCB_nominal_stock
component_ENVELOPE_0_D36V50F12 12 V PAN (U2)
component_ENVELOPE_1_NE555 1 kHz (U1)
component_ENVELOPE_2_R1 R2 C2 C3
component_ENVELOPE_3_MF-R300 (F1, pan servo)
component_ENVELOPE_4_R3 2.2 k 1 W, D1
component_ENVELOPE_5_C1 film
component_ENVELOPE_6_servo, ring, CAN pads
authored_public_base_board_screws#0
authored_public_base_board_screws#1
authored_public_base_board_screws#2
authored_public_base_board_screws#3
authored_public_base_carrier_screws#0
authored_public_base_carrier_screws#1
authored_public_base_carrier_screws#2
authored_public_base_carrier_screws#3
authored_public_base_board_inserts#0
authored_public_base_board_inserts#1
authored_public_base_board_inserts#2
authored_public_base_board_inserts#3
authored_public_base_carrier_inserts#0
authored_public_base_carrier_inserts#1
authored_public_base_carrier_inserts#2
authored_public_base_carrier_inserts#3
authored_public_c3_support_screws#0
authored_public_c3_support_nuts#0
authored_public_c3_support_screws#1
authored_public_c3_support_nuts#1
C3_BODY_DIMENSION_ONLY_not_complete_hardware
RESERVATION_ONLY_C2_power_module
RESERVATION_ONLY_C2_signal_module
