Valpatel/gyropup/hardware/exports/turret/base-board-service/interfaces/carrier-wiring-layout.step

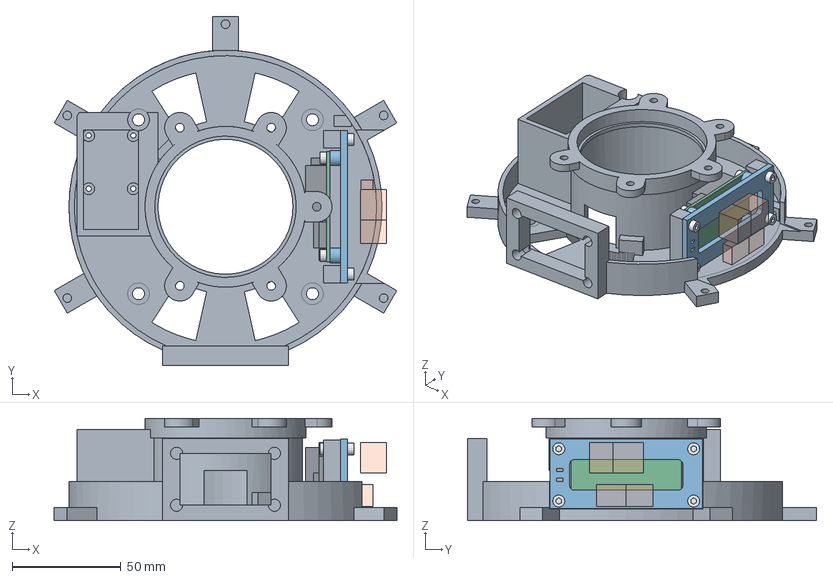
[picture p244: CAD file, 2026-11-07]
hardware/exports/turret/base-board-service/interfaces/carrier-wiring-layout.step
157.6 x 160.5 x 47.0 mm
pan_base_authored
carrier_authored
cut_PCB_nominal_stock
component_envelope_0_D36V50F12 12 V PAN (U2)
component_envelope_1_NE555 1 kHz (U1)
component_envelope_2_R1 R2 C2 C3
component_envelope_3_MF-R300 (F1, pan servo)
component_envelope_4_R3 2.2 k 1 W, D1
component_envelope_5_C1 film
component_envelope_6_servo, ring, CAN pads
authored_public_base_board_screws#0
authored_public_base_board_screws#1
authored_public_base_board_screws#2
authored_public_base_board_screws#3
authored_public_base_carrier_screws#0
authored_public_base_carrier_screws#1
authored_public_base_carrier_screws#2
authored_public_base_carrier_screws#3
authored_public_base_board_inserts#0
authored_public_base_board_inserts#1
authored_public_base_board_inserts#2
authored_public_base_board_inserts#3
authored_public_base_carrier_inserts#0
authored_public_base_carrier_inserts#1
authored_public_base_carrier_inserts#2
authored_public_base_carrier_inserts#3
RESERVATION_ONLY_C2_power_module
RESERVATION_ONLY_C2_power_fixed
RESERVATION_ONLY_C2_signal_module
RESERVATION_ONLY_C2_signal_fixed
