Valpatel/gyropup/hardware/exports/turret/bench/stand_box.step

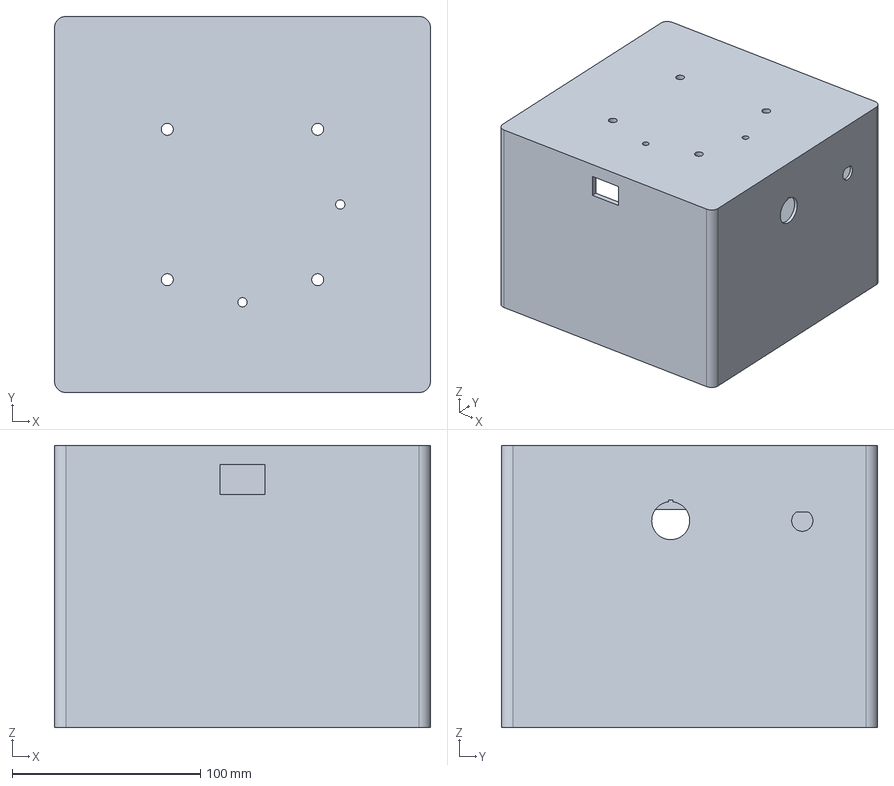
[picture p245: CAD file, 2026-11-05]
hardware/exports/turret/bench/stand_box.step
200.0 x 200.0 x 150.0 mm
