Valpatel/gyropup/hardware/exports/turret/box/pod_cover.step

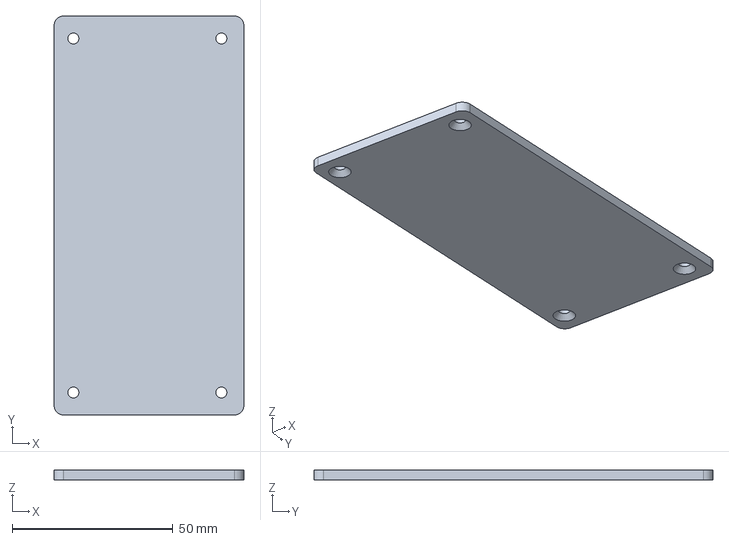
[picture p246: CAD file, 2026-11-07]
hardware/exports/turret/box/pod_cover.step
59.0 x 124.0 x 3.00 mm
