Valpatel/gyropup/hardware/exports/turret/carrier-insert-fit/base-anchor.step

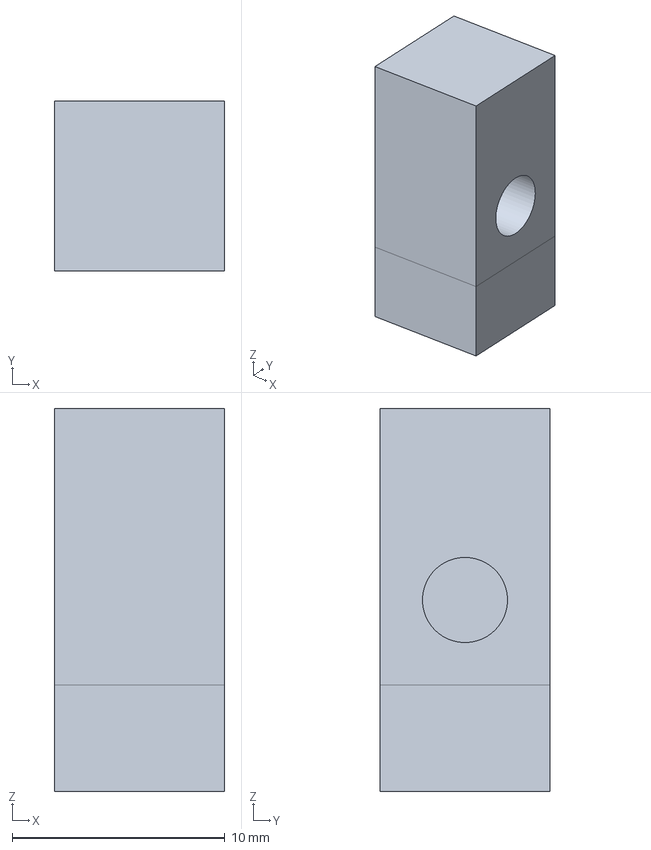
[picture p247: CAD file, 2026-11-07]
hardware/exports/turret/carrier-insert-fit/base-anchor.step
8.00 x 8.00 x 18.0 mm
