Valpatel/gyropup/hardware/exports/turret/component-preview/cradle_plate_r.step

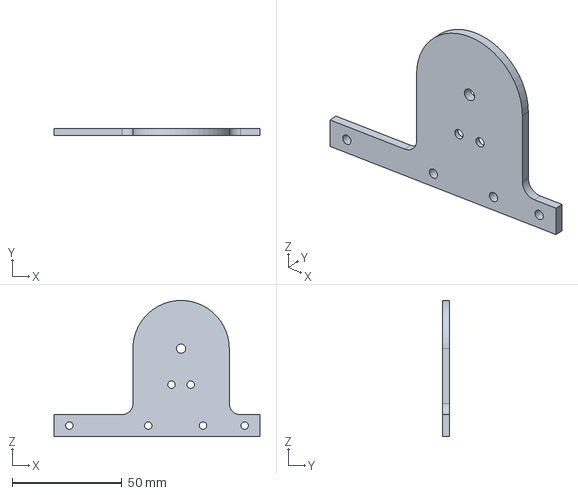
[picture p248: CAD file, 2026-11-07]
hardware/exports/turret/component-preview/cradle_plate_r.step
94.0 x 3.17 x 62.1 mm
