Valpatel/gyropup/hardware/exports/turret/ordered-motor-fit/shaft-clearance-survey.step

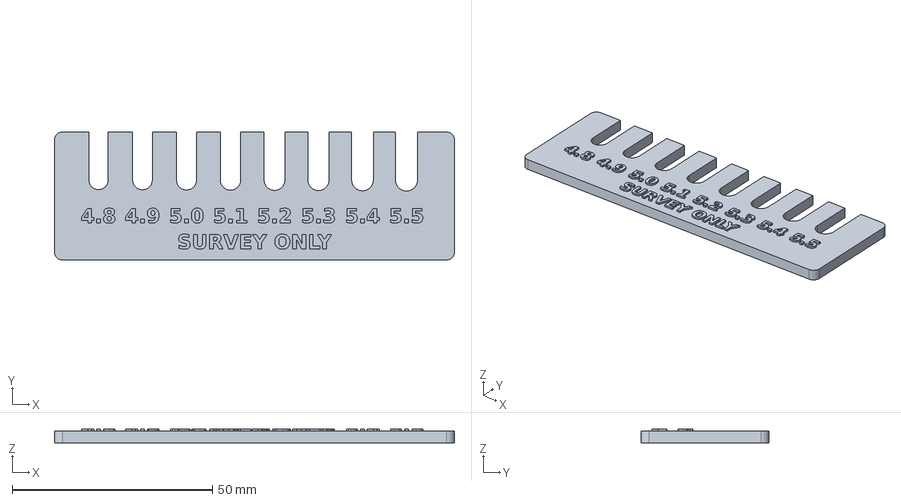
[picture p249: CAD file, 2026-11-06]
hardware/exports/turret/ordered-motor-fit/shaft-clearance-survey.step
100.0 x 32.0 x 3.50 mm
