Valpatel/gyropup/hardware/exports/turret/print/tilt_yoke.3mf

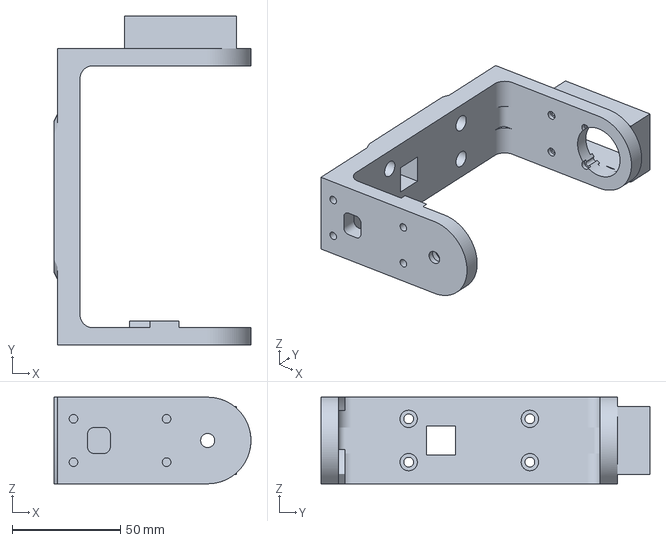
[picture p250: CAD file, 2026-10-29]
hardware/exports/turret/print/tilt_yoke.3mf
91.0 x 152.0 x 40.0 mm
