Valpatel/gyropup/hardware/exports/turret/stop_lug.dxf

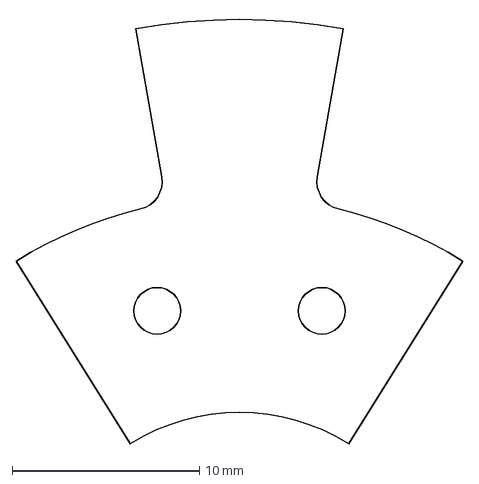
[picture p251: CAD file, 2026-10-29]
hardware/exports/turret/stop_lug.dxf
23.8 x 22.8 mm
