Valpatel/gyropup/software/site/assets/build-guides/combined-wip-3a40891962b0/meshes/turret__base_board.stl

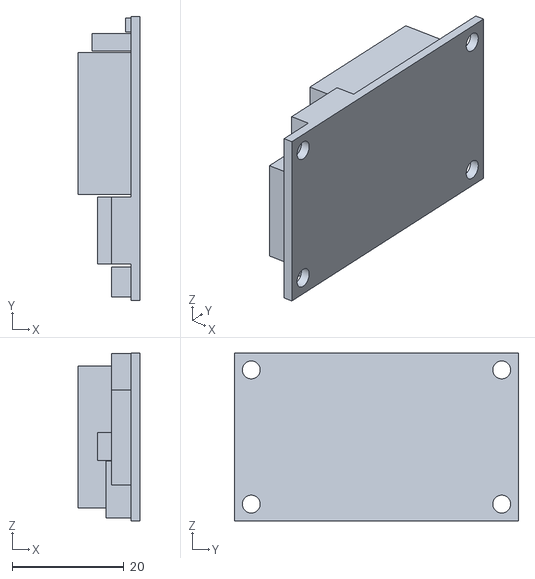
[picture p252: CAD file, 2026-11-10]
software/site/assets/build-guides/combined-wip-3a40891962b0/meshes/turret__base_board.stl
11.1 x 50.8 x 30.0
