Valpatel/gyropup/software/site/assets/build-guides/prepared-projects/82398d2679176eedd9420da8938336210a9ed6e9d4feb284390590d9a60310cd/hip-frame.geometry.3mf

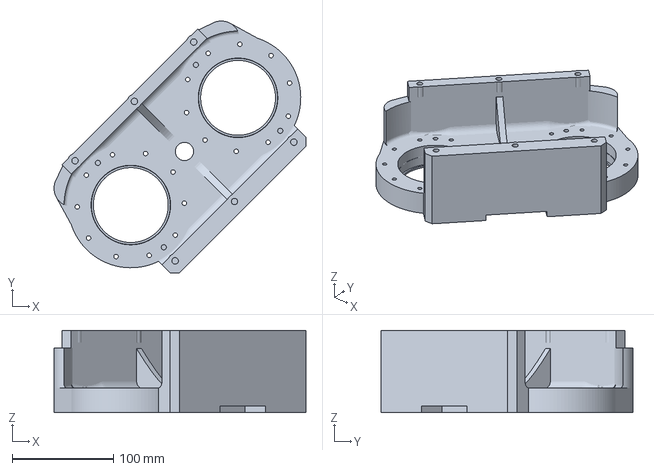
[picture p253: CAD file, 2026-11-10]
software/site/assets/build-guides/prepared-projects/82398d2679176eedd9420da8938336210a9ed6e9d4feb284390590d9a60310cd/hip-frame.geometry.3mf
249.2 x 249.2 x 81.3 mm
