Valpatel/gyropup/software/site/assets/build-guides/robot-wip-3a40891962b0/meshes/d435_cradle_front.stl

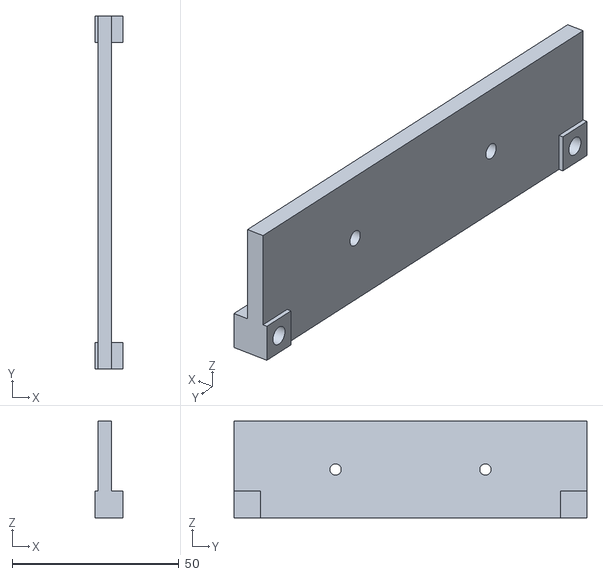
[picture p254: CAD file, 2026-11-11]
software/site/assets/build-guides/robot-wip-3a40891962b0/meshes/d435_cradle_front.stl
8.50 x 106.0 x 29.0
