Valpatel/gyropup/software/site/assets/build-guides/robot-wip-540056ba4e59/meshes/bay_rail_l.stl

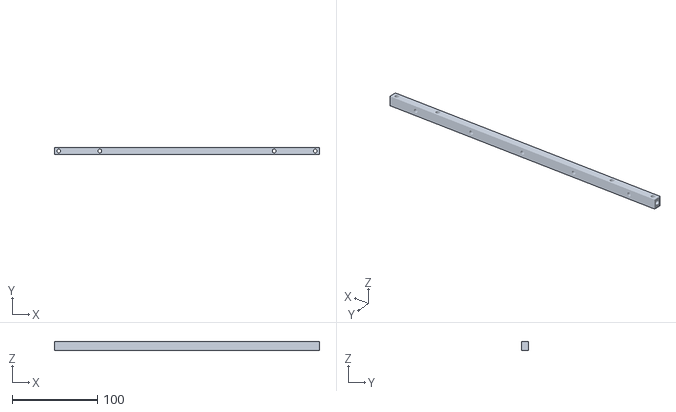
[picture p255: CAD file, 2026-11-10]
software/site/assets/build-guides/robot-wip-540056ba4e59/meshes/bay_rail_l.stl
310.0 x 8.00 x 10.0
