Valpatel/gyropup/software/site/assets/robot-current/meshes/end_foot_front.stl

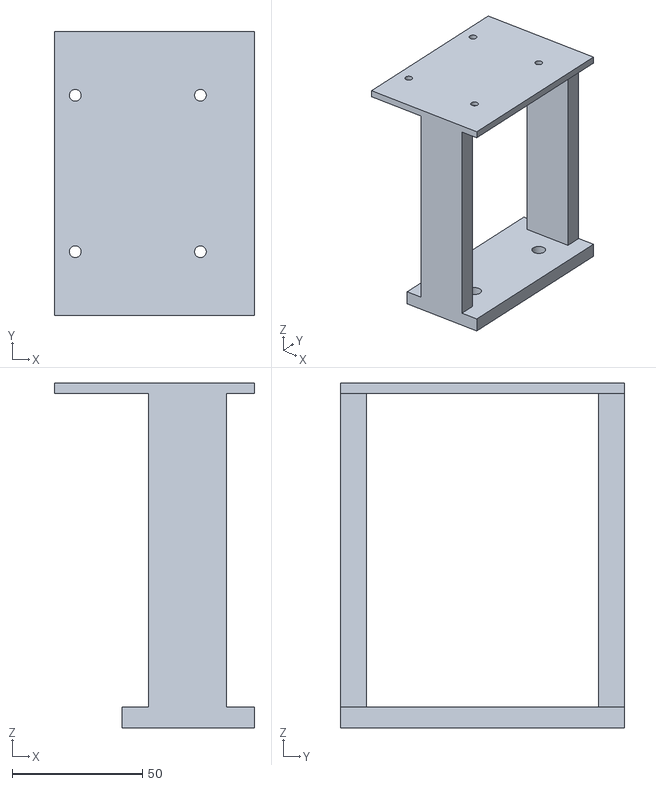
[picture p256: CAD file, 2026-11-11]
software/site/assets/robot-current/meshes/end_foot_front.stl
76.8 x 109.0 x 132.3
