Valpatel/gyropup/tests/site/assembly/fixtures/two-cap.stl

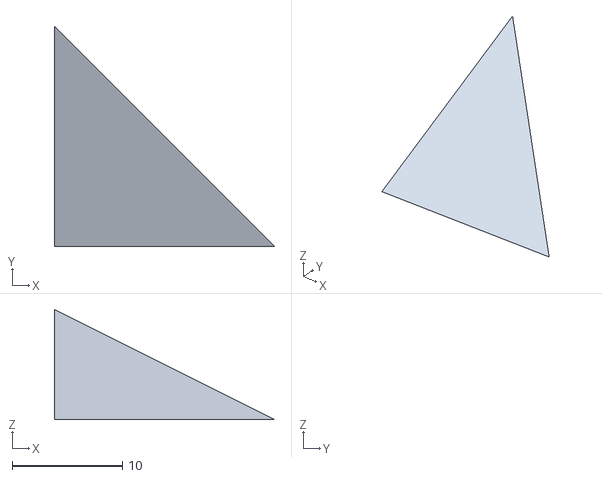
[picture p257: CAD file, 2026-11-10]
tests/site/assembly/fixtures/two-cap.stl
20.0 x 20.0 x 10.0
