Valpatel/gyropup/docs/research/body-sheet-metal/dxf/keel_half_5052-0.090_x2.dxf

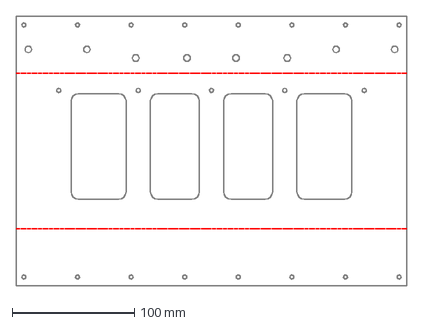
[picture p258: CAD file, 2026-11-07]
docs/research/body-sheet-metal/dxf/keel_half_5052-0.090_x2.dxf
320.0 x 220.4 mm
