Valpatel/gyropup/docs/research/rs04-support/results/od118-id80-t2.032.step

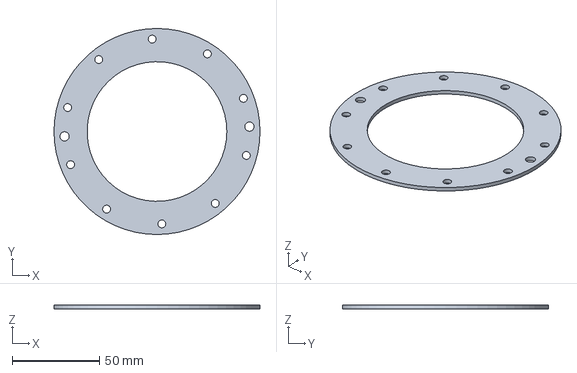
[picture p259: CAD file, 2026-11-07]
docs/research/rs04-support/results/od118-id80-t2.032.step
118.0 x 118.0 x 2.03 mm
