Valpatel/gyropup/hardware/exports/body/dcdc_bracket.step

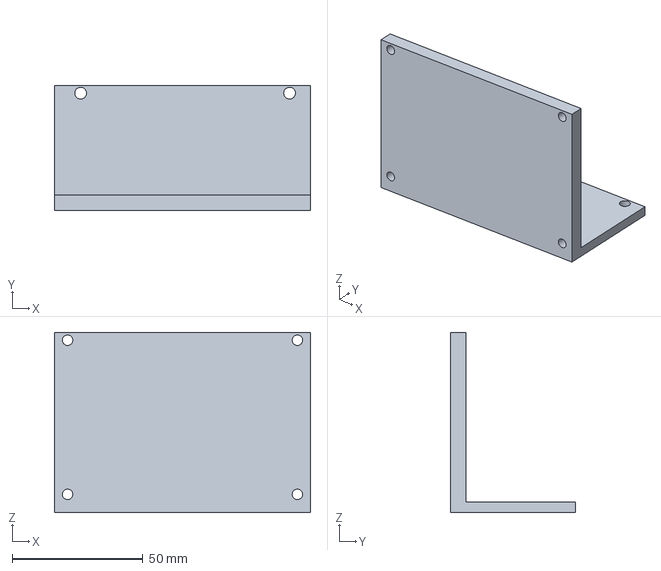
[picture p260: CAD file, 2026-11-05]
hardware/exports/body/dcdc_bracket.step
98.0 x 48.0 x 69.0 mm
