Valpatel/gyropup/hardware/exports/body/sendcutsend/deck_5052-H32_0.100in_x1.step

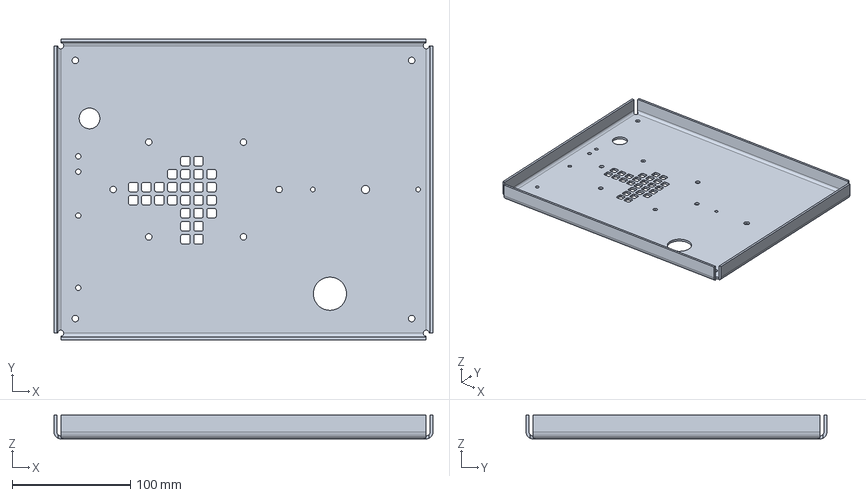
[picture p261: CAD file, 2026-11-05]
hardware/exports/body/sendcutsend/deck_5052-H32_0.100in_x1.step
320.0 x 254.0 x 20.0 mm
