Valpatel/gyropup/hardware/exports/body/shell/ear_bracket_l.step

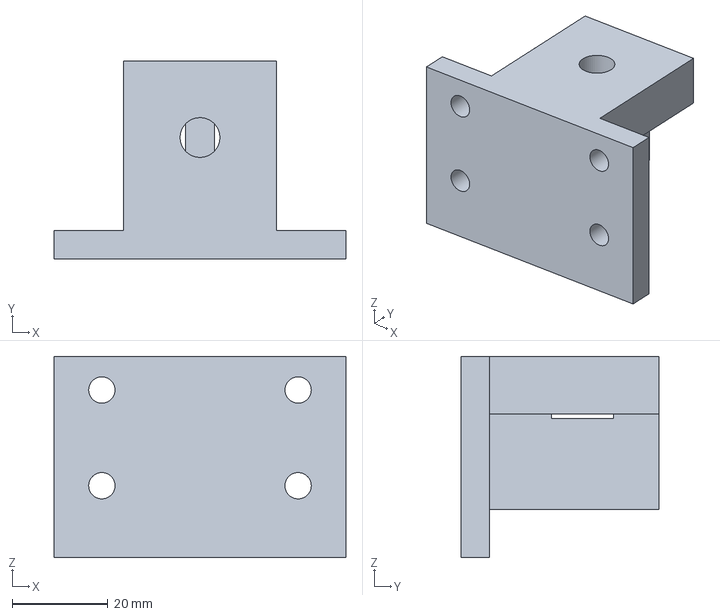
[picture p262: CAD file, 2026-11-05]
hardware/exports/body/shell/ear_bracket_l.step
61.0 x 41.4 x 42.0 mm
