Valpatel/gyropup/hardware/exports/leg/rs04-mounting-fit/dyno_lug_plate.step

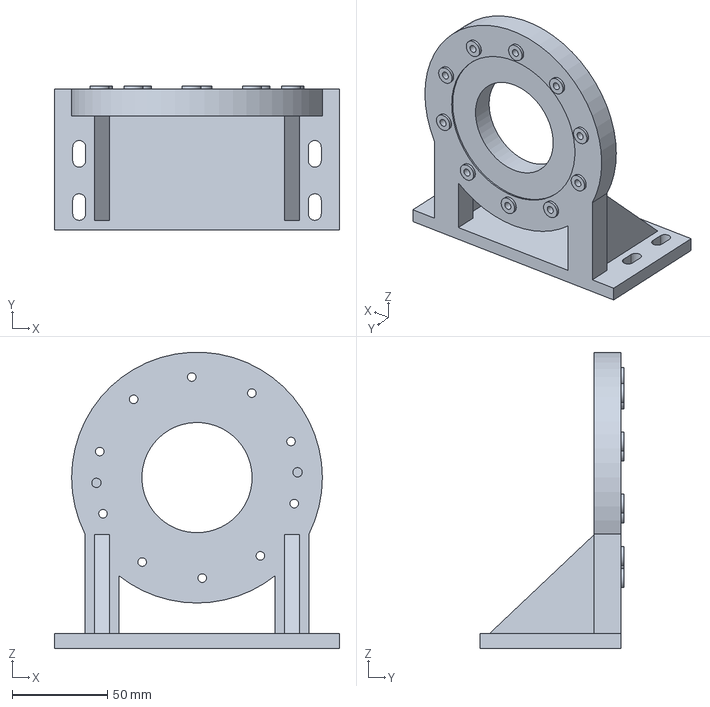
[picture p263: CAD file, 2026-11-07]
hardware/exports/leg/rs04-mounting-fit/dyno_lug_plate.step
150.0 x 75.6 x 155.9 mm
