Valpatel/gyropup/hardware/exports/motor-day/parts/end_plate.step

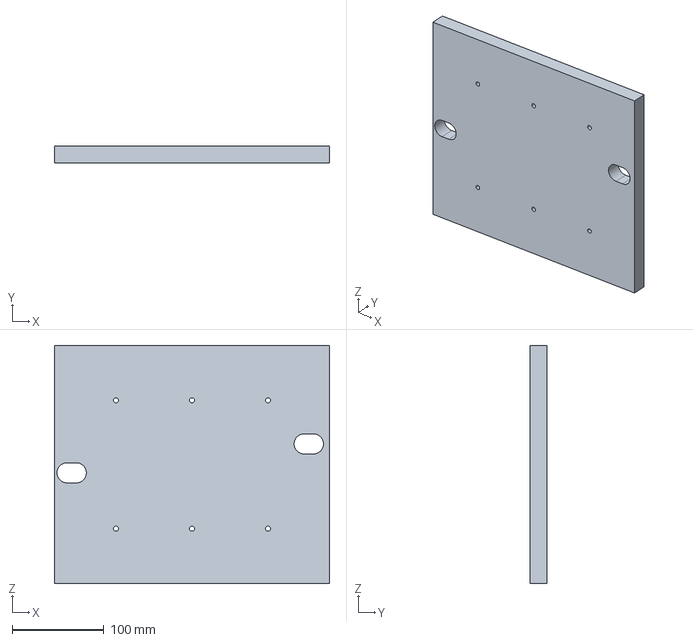
[picture p264: CAD file, 2026-11-03]
hardware/exports/motor-day/parts/end_plate.step
300.0 x 18.3 x 260.0 mm
