Valpatel/gyropup/hardware/exports/rig/bench/coupon_c3_wheel.step

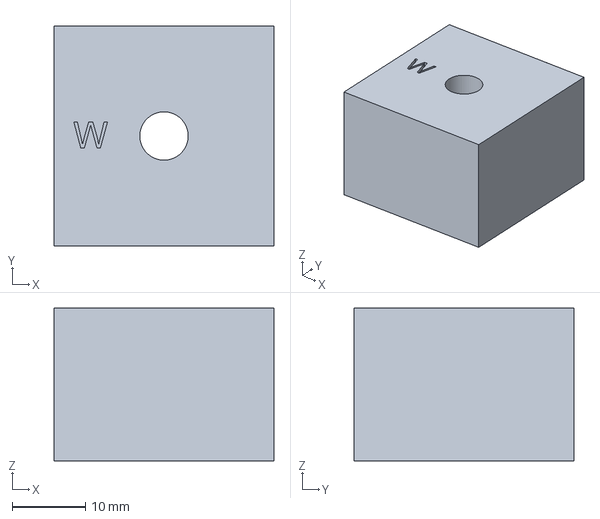
[picture p265: CAD file, 2026-11-02]
hardware/exports/rig/bench/coupon_c3_wheel.step
30.0 x 30.0 x 20.8 mm
