Valpatel/gyropup/hardware/exports/rig/load_cell_mount.step

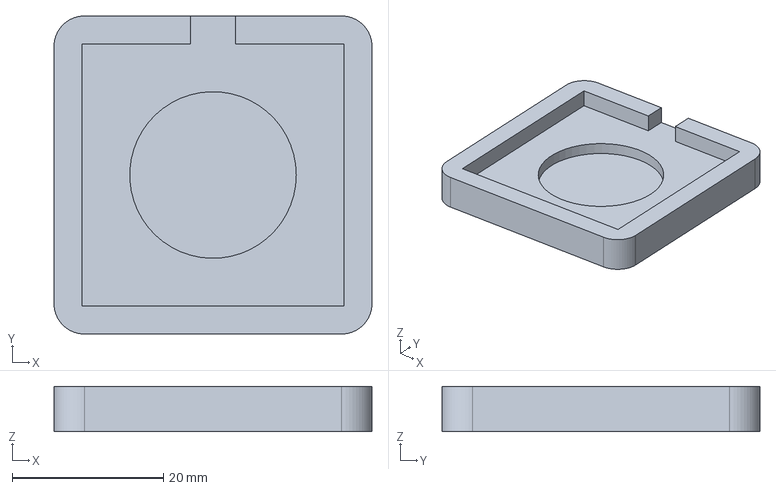
[picture p266: CAD file, 2026-10-28]
hardware/exports/rig/load_cell_mount.step
42.0 x 42.0 x 6.00 mm
