Valpatel/gyropup/hardware/exports/robot/front_link_r.step

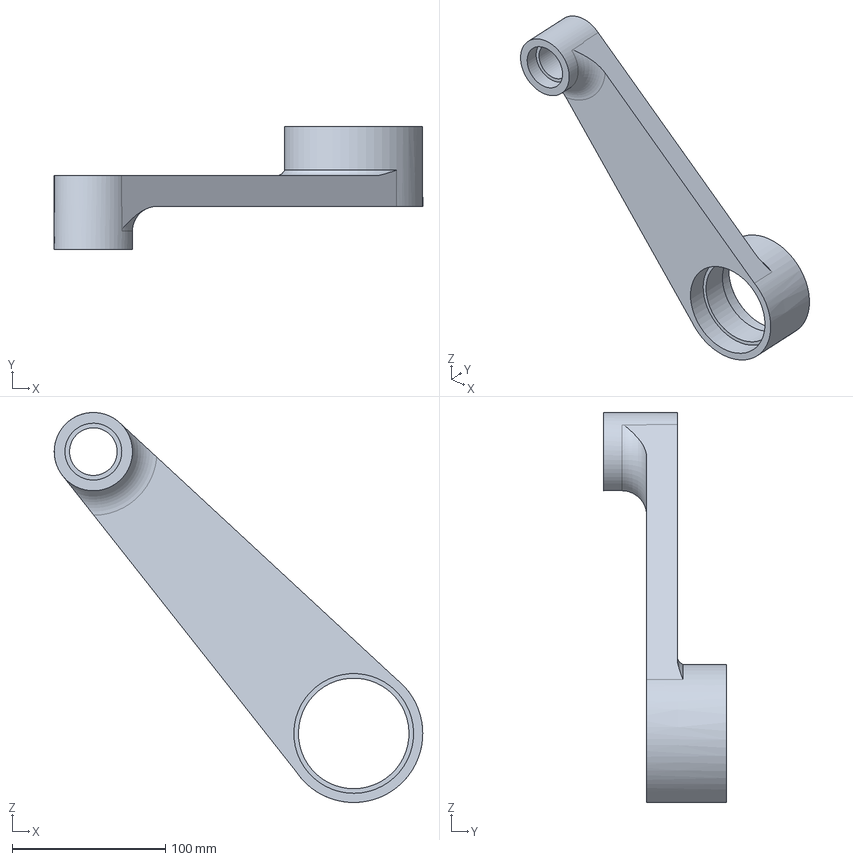
[picture p267: CAD file, 2026-11-05]
hardware/exports/robot/front_link_r.step
240.1 x 80.0 x 254.1 mm
