Valpatel/gyropup/hardware/exports/sim/turret_box/flywheel_tyre_m.stl

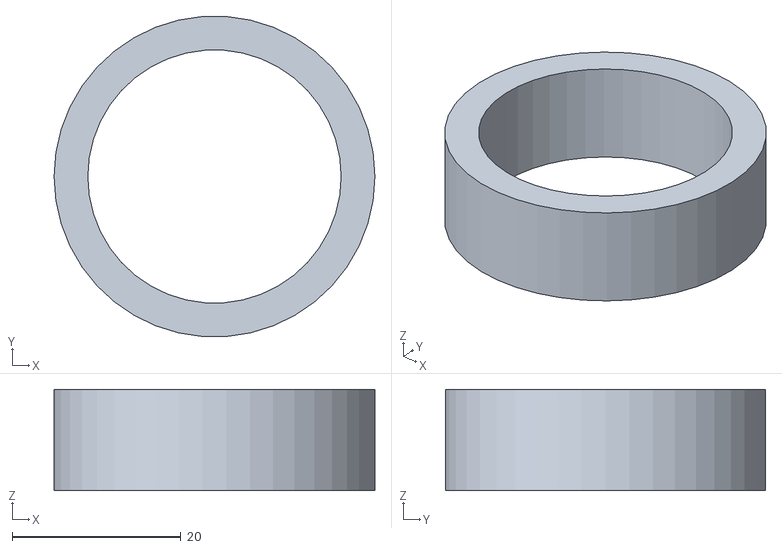
[picture p268: CAD file, 2026-11-07]
hardware/exports/sim/turret_box/flywheel_tyre_m.stl
38.0 x 37.9 x 12.0
