Valpatel/gyropup/hardware/exports/sim/v2/rig/link__front_link_m.stl

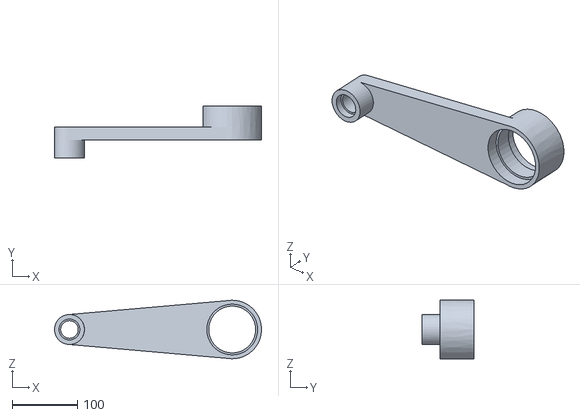
[picture p269: CAD file, 2026-10-28]
hardware/exports/sim/v2/rig/link__front_link_m.stl
318.0 x 80.0 x 90.0
