Valpatel/gyropup/hardware/exports/turret/base-board-service/connectors/carrier-support-candidate.step

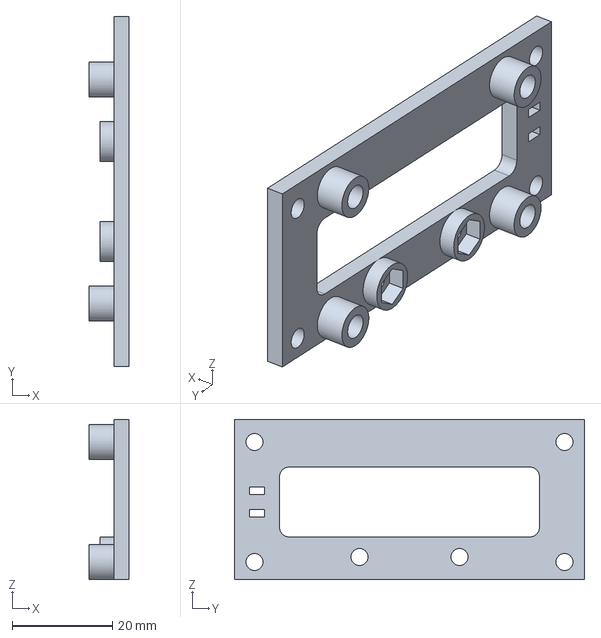
[picture p270: CAD file, 2026-11-07]
hardware/exports/turret/base-board-service/connectors/carrier-support-candidate.step
8.00 x 70.0 x 32.0 mm
