Valpatel/gyropup/hardware/exports/turret/base-board-service/interfaces/pan-base-wiring-candidate.step

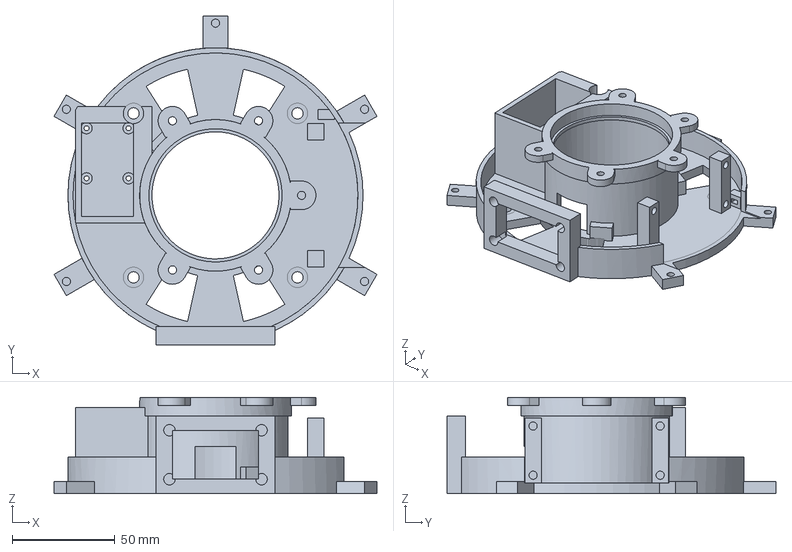
[picture p271: CAD file, 2026-11-07]
hardware/exports/turret/base-board-service/interfaces/pan-base-wiring-candidate.step
157.6 x 160.5 x 47.0 mm
