Valpatel/gyropup/hardware/exports/turret/bench/stand_bottom.step

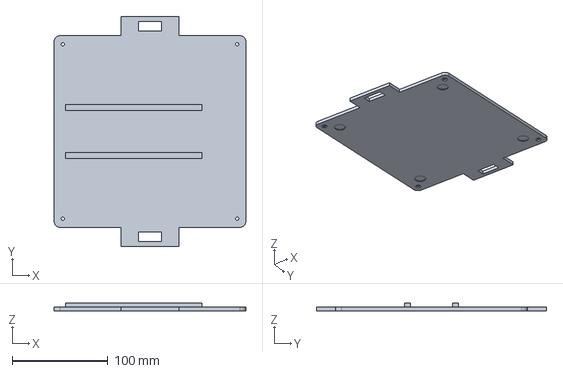
[picture p272: CAD file, 2026-11-05]
hardware/exports/turret/bench/stand_bottom.step
200.0 x 240.0 x 8.00 mm
