Valpatel/gyropup/hardware/exports/turret/box/intake_shroud.step

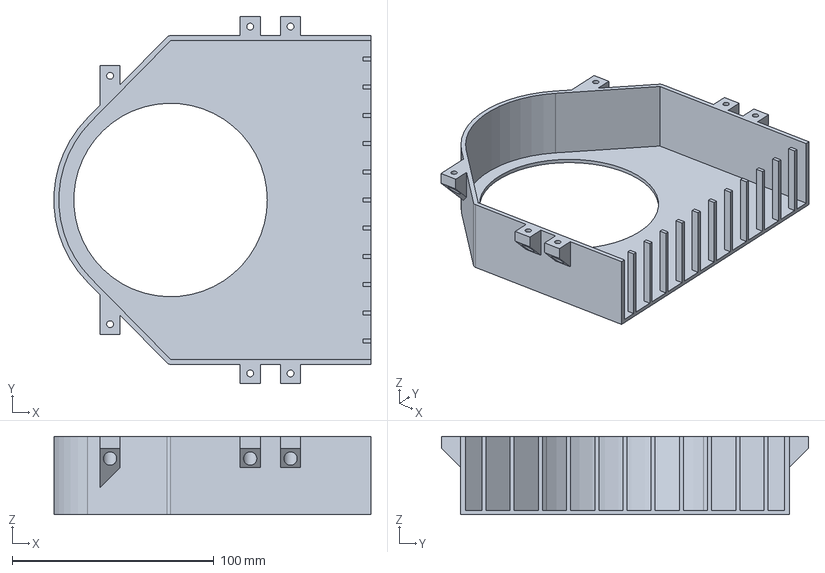
[picture p273: CAD file, 2026-11-07]
hardware/exports/turret/box/intake_shroud.step
157.2 x 182.0 x 38.8 mm
