Valpatel/gyropup/hardware/exports/turret/carrier-insert-fit/carrier-boss.step

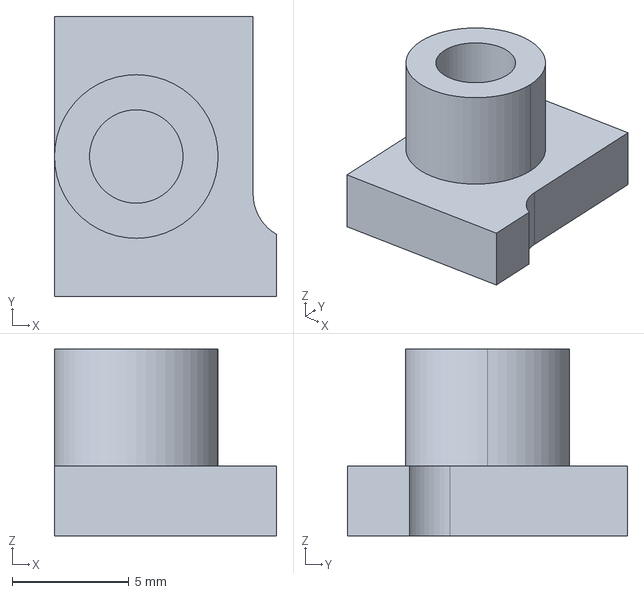
[picture p274: CAD file, 2026-11-07]
hardware/exports/turret/carrier-insert-fit/carrier-boss.step
9.50 x 12.0 x 8.00 mm
