Valpatel/gyropup/hardware/exports/turret/cradle_plate_l.dxf

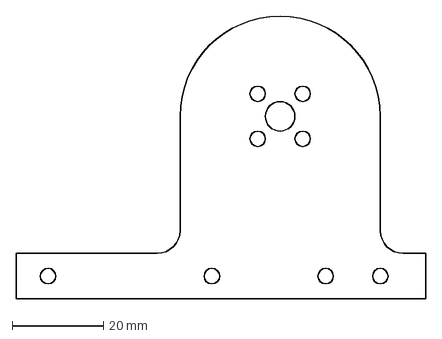
[picture p275: CAD file, 2026-10-29]
hardware/exports/turret/cradle_plate_l.dxf
90.0 x 62.1 mm
