Valpatel/gyropup/hardware/exports/turret/print/pivot_spacer.3mf

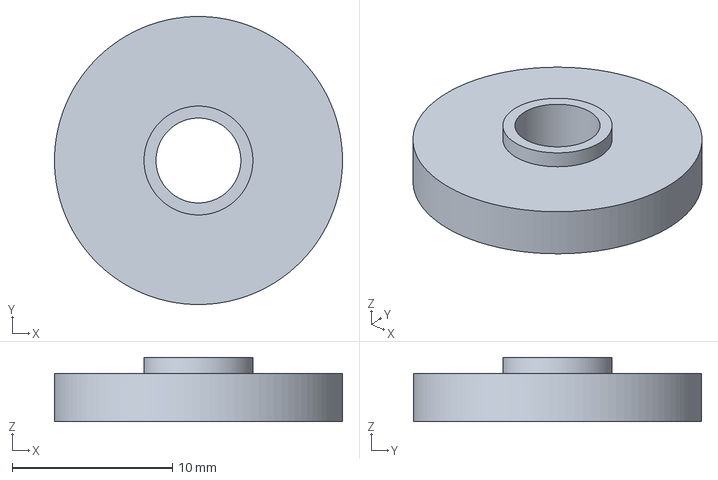
[picture p276: CAD file, 2026-10-29]
hardware/exports/turret/print/pivot_spacer.3mf
18.0 x 18.0 x 4.03 mm
