Valpatel/gyropup/software/site/assets/build-guides/combined-wip-3a40891962b0/meshes/turret__ring_driver.stl

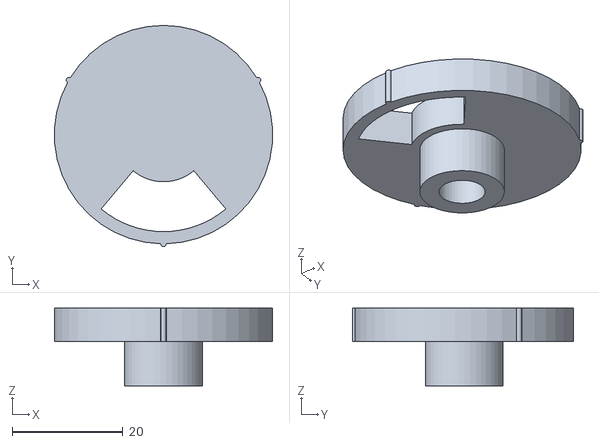
[picture p277: CAD file, 2026-11-10]
software/site/assets/build-guides/combined-wip-3a40891962b0/meshes/turret__ring_driver.stl
39.3 x 39.9 x 14.0
