Valpatel/gyropup/software/site/assets/build-guides/turret-wip-4866459e2abd/meshes/hopper.stl

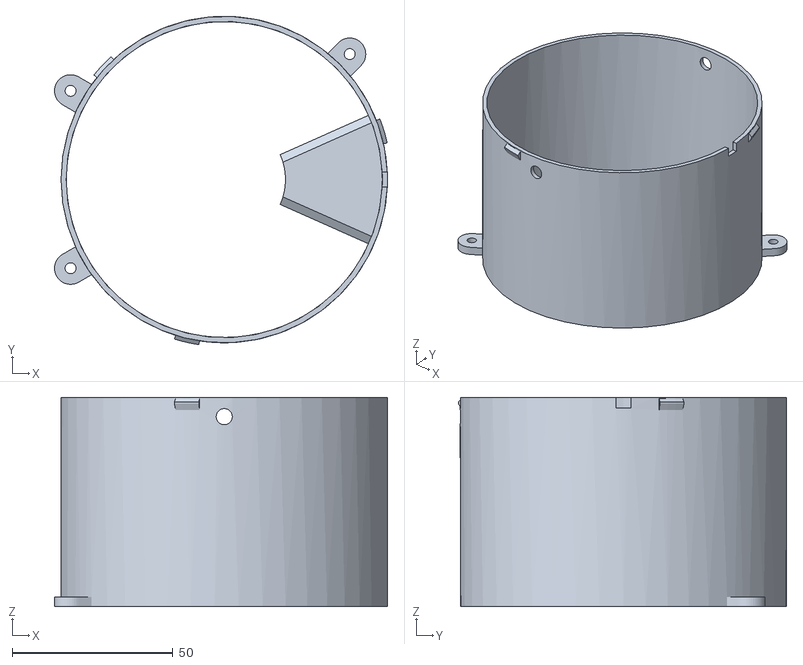
[picture p278: CAD file, 2026-11-10]
software/site/assets/build-guides/turret-wip-4866459e2abd/meshes/hopper.stl
103.4 x 102.0 x 65.0
