Valpatel/gyropup/software/site/assets/robot-current/meshes/item__battery_adapter_front.stl

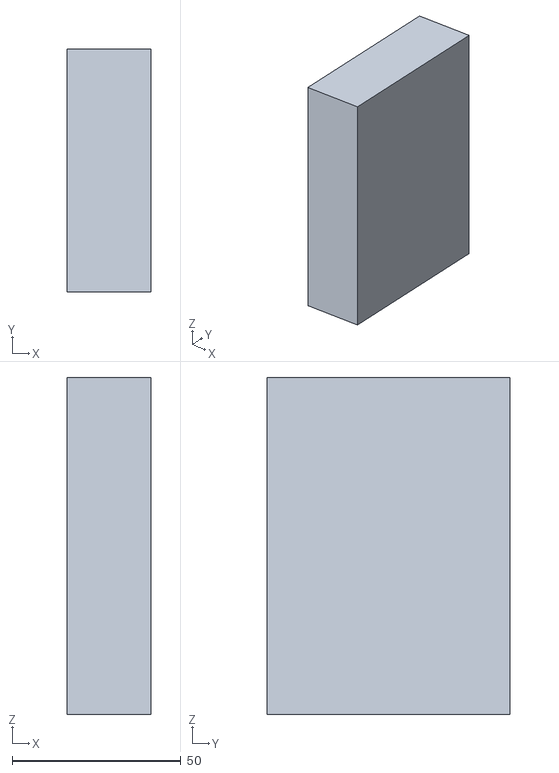
[picture p279: CAD file, 2026-11-11]
software/site/assets/robot-current/meshes/item__battery_adapter_front.stl
25.0 x 72.0 x 100.0
