Valpatel/gyropup/docs/research/body-sheet-metal/dxf/probe_2b_5052-0.125_x1.dxf

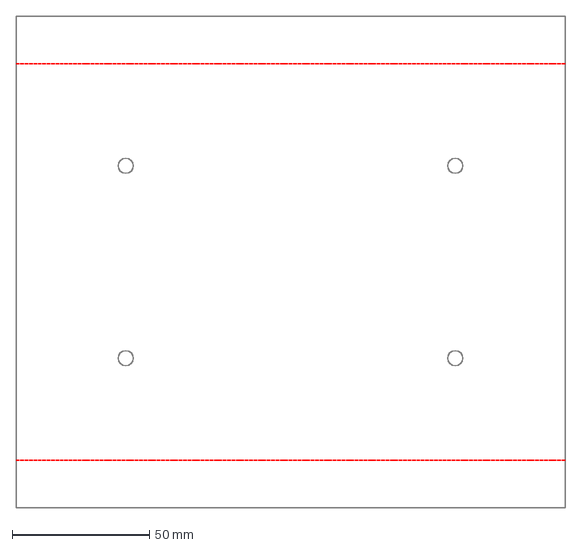
[picture p280: CAD file, 2026-11-07]
docs/research/body-sheet-metal/dxf/probe_2b_5052-0.125_x1.dxf
200.0 x 179.0 mm
