Valpatel/gyropup/docs/research/rs04-support/results/od118-id80-t3.175.step

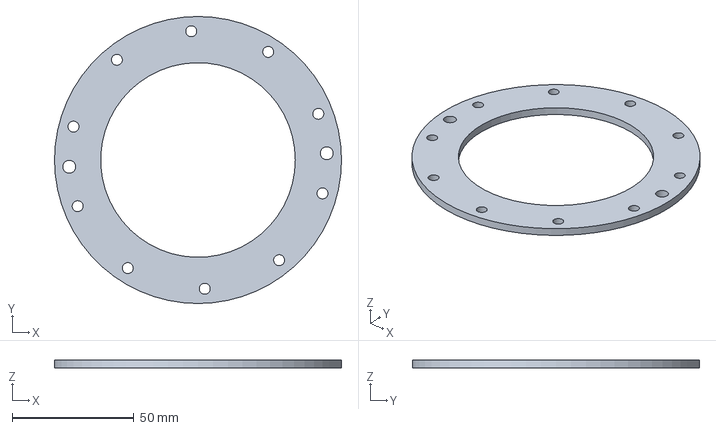
[picture p281: CAD file, 2026-11-07]
docs/research/rs04-support/results/od118-id80-t3.175.step
118.0 x 118.0 x 3.18 mm
