Valpatel/gyropup/hardware/exports/body/bus_insulator.step

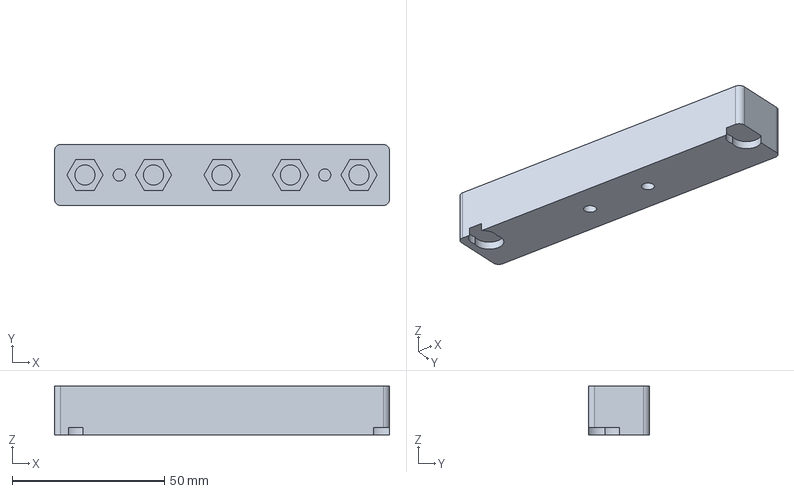
[picture p282: CAD file, 2026-11-05]
hardware/exports/body/bus_insulator.step
110.0 x 20.0 x 16.0 mm
