Valpatel/gyropup/hardware/exports/body/sendcutsend/belly_plate_6061-T6_0.100in_x1.step

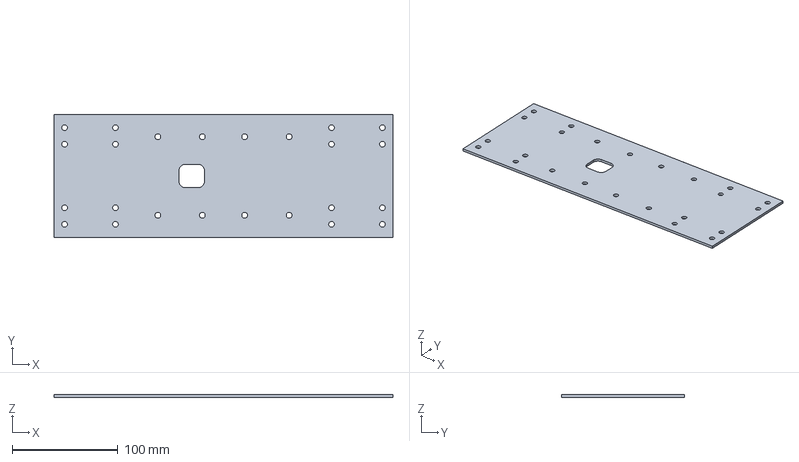
[picture p283: CAD file, 2026-11-05]
hardware/exports/body/sendcutsend/belly_plate_6061-T6_0.100in_x1.step
320.0 x 116.0 x 2.54 mm
