Valpatel/gyropup/hardware/exports/leg/leg_stand.step

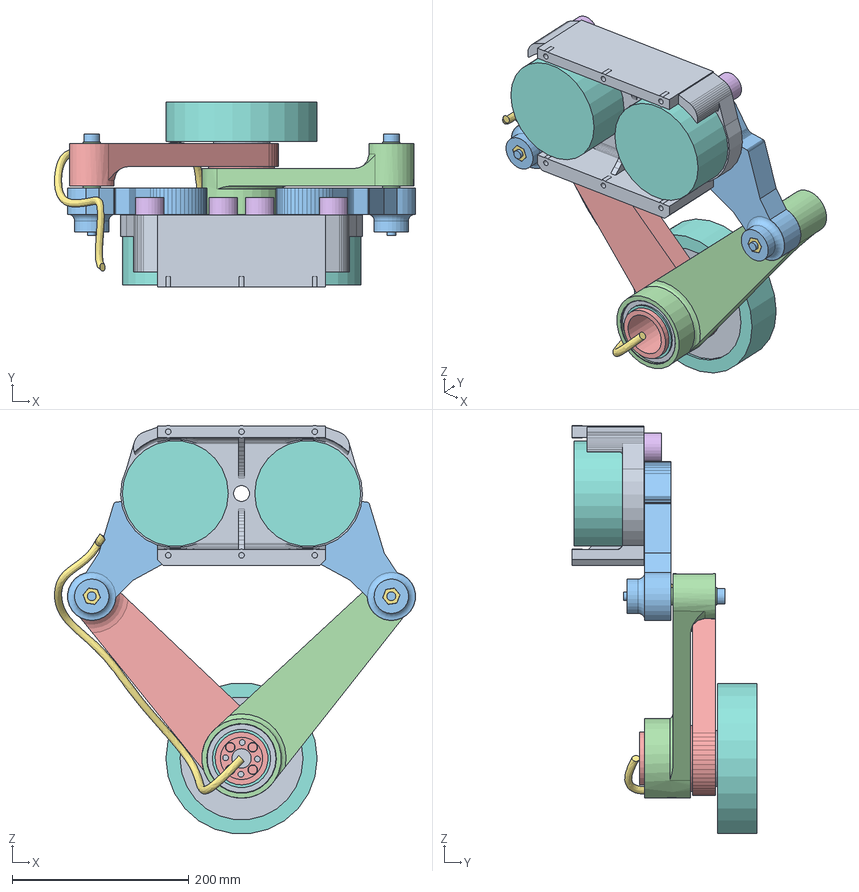
[picture p284: CAD file, 2026-11-02]
hardware/exports/leg/leg_stand.step
408.8 x 209.4 x 462.0 mm
