Valpatel/gyropup/hardware/exports/motor-day/parts/drill_template.step

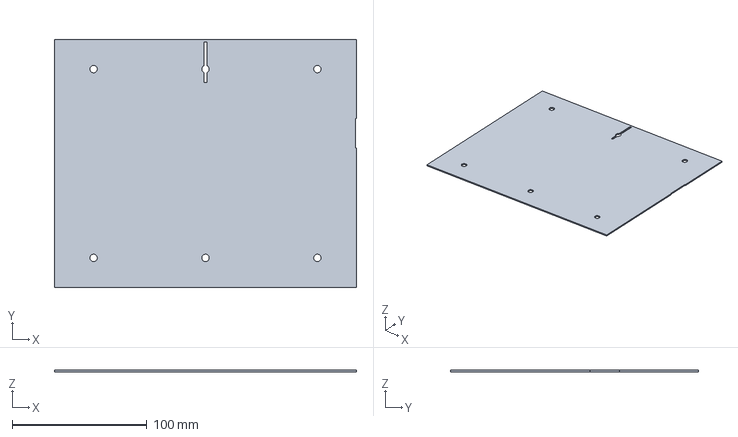
[picture p285: CAD file, 2026-11-03]
hardware/exports/motor-day/parts/drill_template.step
224.0 x 184.0 x 1.20 mm
