Valpatel/gyropup/hardware/exports/rig/pendant_clip.step

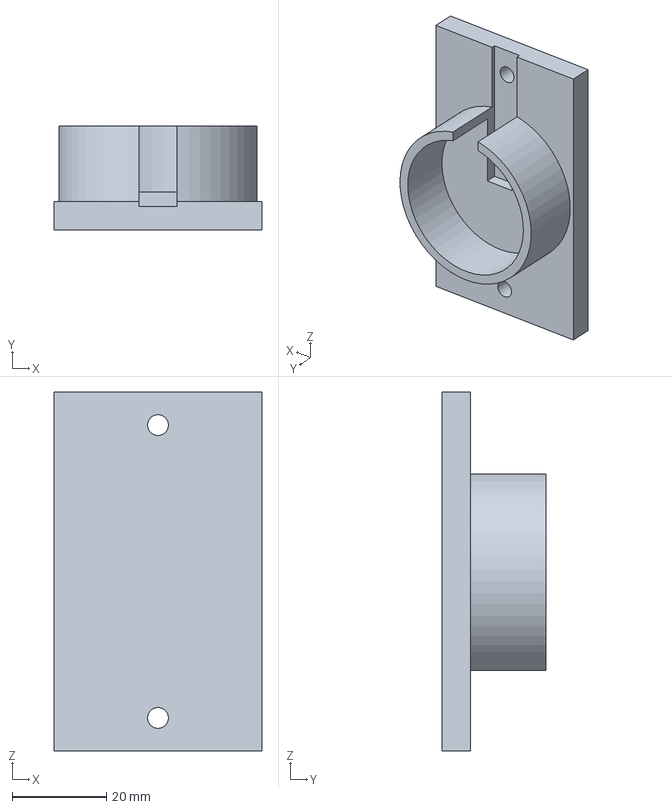
[picture p286: CAD file, 2026-10-28]
hardware/exports/rig/pendant_clip.step
44.0 x 22.0 x 76.0 mm
