Valpatel/gyropup/hardware/exports/robot/upper_links_l.step

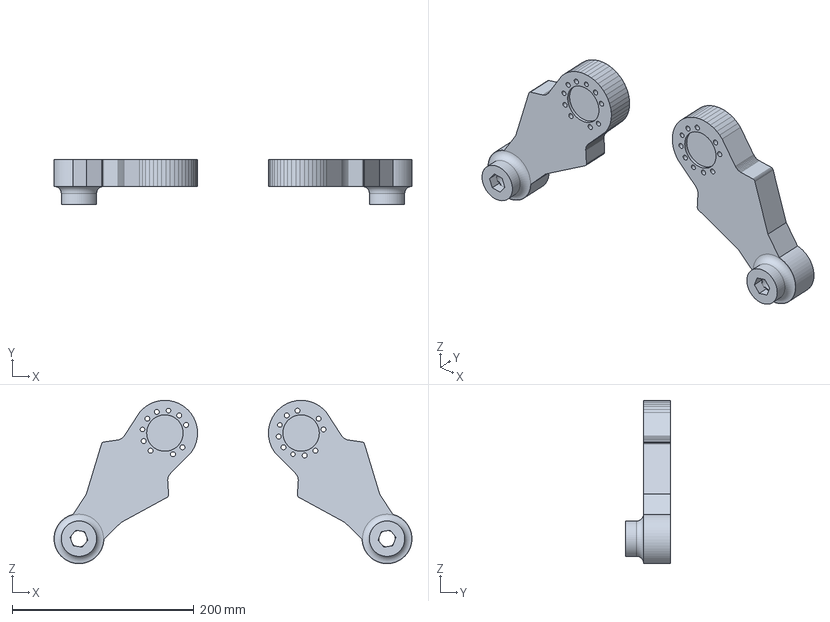
[picture p287: CAD file, 2026-11-05]
hardware/exports/robot/upper_links_l.step
394.3 x 50.0 x 179.8 mm
