Valpatel/gyropup/hardware/exports/sim/turret_box/index_magnet.stl

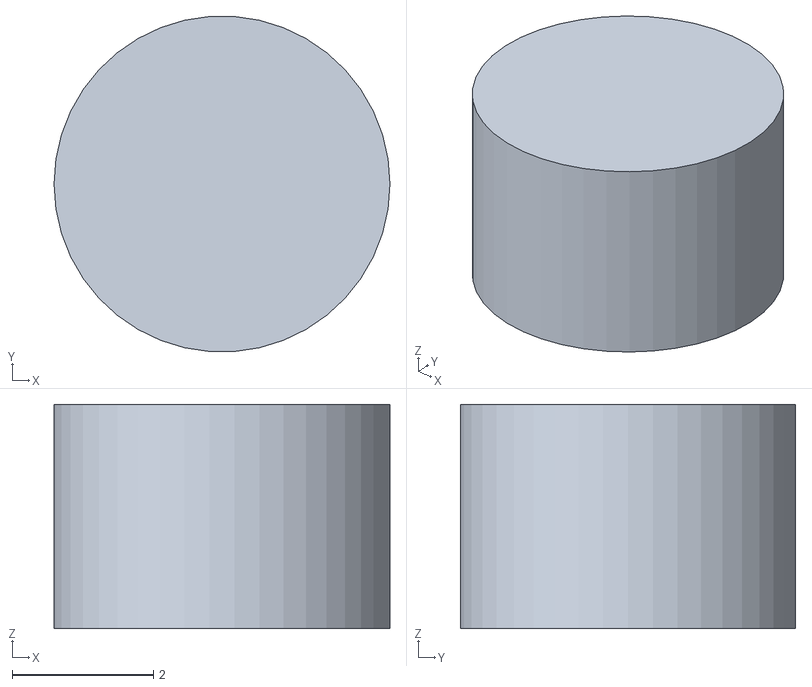
[picture p288: CAD file, 2026-11-07]
hardware/exports/sim/turret_box/index_magnet.stl
4.76 x 4.75 x 3.18
