Valpatel/gyropup/hardware/exports/sim/v2/rig/body__lidar.stl

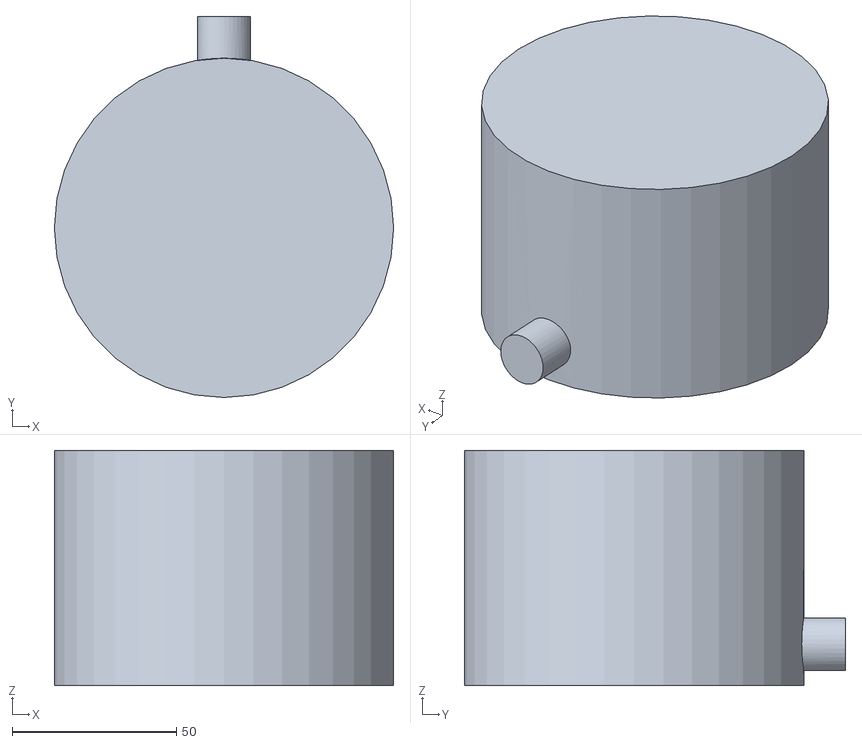
[picture p289: CAD file, 2026-10-28]
hardware/exports/sim/v2/rig/body__lidar.stl
103.3 x 116.0 x 71.7
