Valpatel/gyropup/hardware/exports/turret/base-board-service/connectors/C3-support-candidate.step

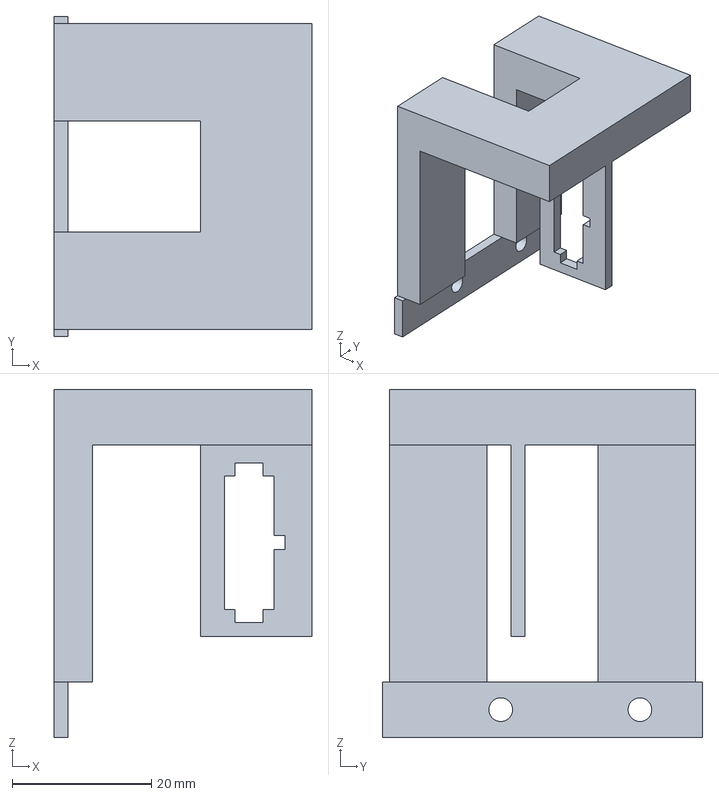
[picture p290: CAD file, 2026-11-07]
hardware/exports/turret/base-board-service/connectors/C3-support-candidate.step
37.0 x 46.0 x 50.0 mm
