Valpatel/gyropup/hardware/exports/turret/base-board-service/interfaces/carrier-wiring-candidate.step

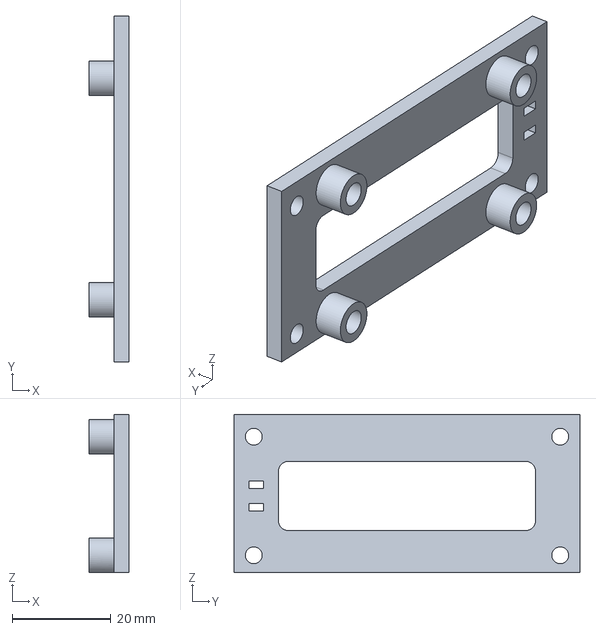
[picture p291: CAD file, 2026-11-07]
hardware/exports/turret/base-board-service/interfaces/carrier-wiring-candidate.step
8.00 x 70.0 x 32.0 mm
