Valpatel/gyropup/hardware/exports/turret/box/box_deck.step

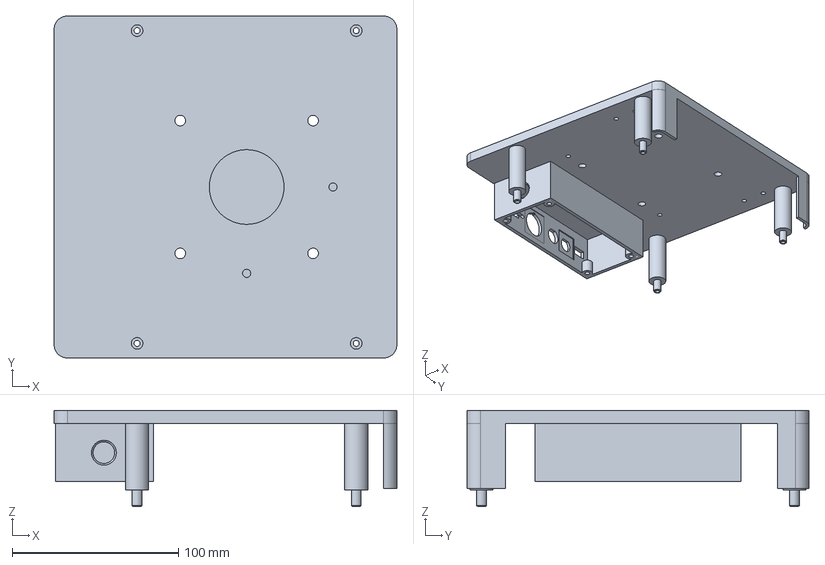
[picture p292: CAD file, 2026-11-07]
hardware/exports/turret/box/box_deck.step
206.5 x 206.0 x 58.0 mm
