Valpatel/gyropup/hardware/exports/turret/component-preview/stop_lug.step

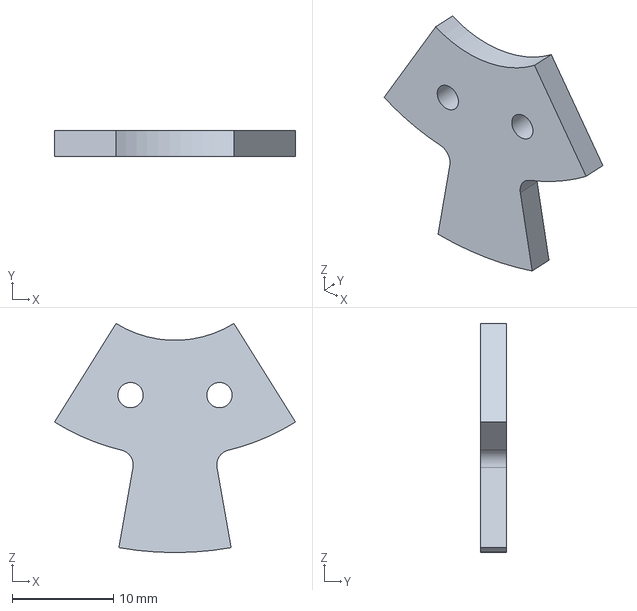
[picture p293: CAD file, 2026-11-07]
hardware/exports/turret/component-preview/stop_lug.step
23.8 x 2.54 x 22.7 mm
