Valpatel/gyropup/hardware/exports/turret/cradle_plate_r.dxf

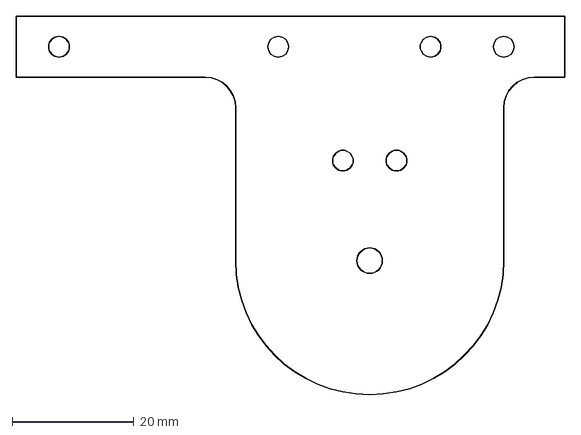
[picture p294: CAD file, 2026-10-29]
hardware/exports/turret/cradle_plate_r.dxf
90.0 x 62.1 mm
