Valpatel/gyropup/hardware/exports/turret/print/horn_boss.3mf

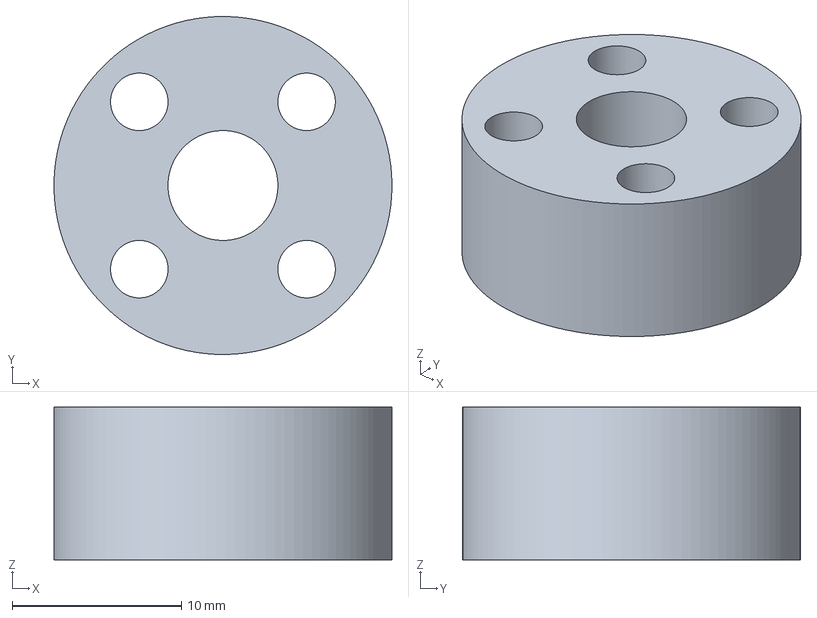
[picture p295: CAD file, 2026-10-29]
hardware/exports/turret/print/horn_boss.3mf
20.0 x 20.0 x 9.03 mm
