Valpatel/gyropup/(list of files, cad)

Other CAD files:
hardware/exports/asm_knee_output_adapter_l.step
hardware/exports/asm_yoke_bracket_l.step
hardware/exports/asm_thigh_l.step
hardware/exports/asm_shin_r.step
hardware/exports/asm_hip_motor_l.step
hardware/exports/asm_wheel_adapter_r.step
hardware/exports/asm_knee_motor_plate_r.step
hardware/exports/asm_knee_crank_r.step
hardware/exports/asm_hip_output_adapter_l.step
hardware/exports/asm_posts_l.step
hardware/exports/asm_pushrod_r.step
hardware/exports/asm_hip_motor_plate_r.step
hardware/exports/asm_hip_output_adapter_r.step
hardware/exports/asm_wheel_r.step
hardware/exports/asm_hip_motor_plate_l.step
hardware/exports/asm_camera_rear.step
hardware/exports/asm_knee_motor_l.step
hardware/exports/asm_knee_motor_r.step
hardware/exports/hopper_flap.step
hardware/exports/leg/rs04-fit-job/slice/out/sliced.3mf
hardware/exports/links/pan_pinion.stl
hardware/exports/turret/shaft-survey-fit-job/slice/out/sliced.3mf
hardware/exports/turret/shaft-survey-fit-job/source.stl
software/site/assets/build-guides/turret-wip-4866459e2abd/meshes/base_board.stl
hardware/exports/leg/hip_frame.step
hardware/exports/leg/rs04-fit-job/source.stl
hardware/exports/links/wheel.stl
hardware/exports/turret/base-board-service/base_board.step
hardware/exports/turret/component-preview/cradle_plate_l.step
hardware/exports/turret/shaft-survey-fit-job/geometry.3mf
software/site/assets/build-guides/robot-wip-3a40891962b0/meshes/d435_cradle_rear.stl
software/site/assets/build-guides/robot-wip-540056ba4e59/meshes/bay_rail_r.stl
tests/site/assembly/fixtures/one-base.stl
hardware/exports/body/shell/ear_bracket_r.step
hardware/exports/leg/rs04-mounting-fit/coupon_frame_ring_nom.step
hardware/exports/links/flywheel_tyre_1.stl
hardware/exports/rig/bench/coupon_frame_ring_nom.step
hardware/exports/turret/base-board-service/pan_base.step
docs/research/body-sheet-metal/dxf/bay_floor_5052-0.063_x1.dxf
docs/research/body-sheet-metal/dxf/bay_side_5052-0.063_x2.dxf
docs/research/body-sheet-metal/dxf/belly_plate_6061-0.100_x1.dxf
docs/research/body-sheet-metal/dxf/bus_bar_C110-0.125_x2.dxf
docs/research/body-sheet-metal/dxf/cheek_5052-0.187_x2.dxf
docs/research/body-sheet-metal/dxf/cheek_pem_5052-0.187_x2.dxf
docs/research/body-sheet-metal/dxf/compute_pallet_6061-0.125_x1.dxf
docs/research/body-sheet-metal/dxf/deck_2b_5052-0.125_x1.dxf
docs/research/body-sheet-metal/dxf/deck_5052-0.100_x1.dxf
docs/research/body-sheet-metal/dxf/floor_tray_2b_5052-0.125_x1.dxf
docs/research/body-sheet-metal/dxf/power_plate_5052-0.100_x1.dxf
docs/research/body-sheet-metal/dxf/probe_12pem_5052-0.125_x1.dxf
docs/research/body-sheet-metal/dxf/probe_4pem_5052-0.125_x1.dxf
docs/research/body-sheet-metal/dxf/probe_flat_5052-0.125_x1.dxf
docs/research/body-sheet-metal/dxf/strap_5052-0.090_x2.dxf
docs/research/body-sheet-metal/dxf/turret_plate_6061-0.125_x1.dxf
docs/research/rs04-support/results/od118-id94-t2.032.step
docs/research/rs04-support/results/od118-id94-t3.175.step
docs/research/rs04-support/results/od120-id80-t2.032.step
docs/research/rs04-support/results/od120-id80-t3.175.step
docs/research/rs04-support/results/od120-id94-t3.175.step
hardware/exports/barrel.step
hardware/exports/barrel.stl
hardware/exports/battery_cradle.step
hardware/exports/battery_cradle.stl
hardware/exports/body/adapter_plate_front.stl
hardware/exports/body/adapter_plate_rear.step
hardware/exports/body/adapter_plate_rear.stl
hardware/exports/body/bay_door_front.step
hardware/exports/body/bay_door_front.stl
hardware/exports/body/bay_door_rear.step
hardware/exports/body/bay_door_rear.stl
hardware/exports/body/bay_rail_l.step
hardware/exports/body/bay_rail_l.stl
hardware/exports/body/bay_rail_r.step
hardware/exports/body/bay_rail_r.stl
hardware/exports/body/bay_skid.step
hardware/exports/body/bay_skid.stl
hardware/exports/body/bus_insulator.stl
hardware/exports/body/dcdc_bracket.stl
hardware/exports/body/isolator.step
hardware/exports/body/isolator.stl
hardware/exports/body/plate_post.step
hardware/exports/body/plate_post.stl
hardware/exports/body/post.step
hardware/exports/body/post.stl
hardware/exports/body/riser.step
hardware/exports/body/riser.stl
hardware/exports/body/sendcutsend/bay_floor_5052-H32_0.063in_x1.dxf
hardware/exports/body/sendcutsend/bay_floor_5052-H32_0.063in_x1.step
hardware/exports/body/sendcutsend/bay_side_5052-H32_0.063in_x2.dxf
hardware/exports/body/sendcutsend/belly_plate_6061-T6_0.100in_x1.dxf
hardware/exports/body/sendcutsend/bus_bar_C110_0.125in_x2.dxf
hardware/exports/body/sendcutsend/bus_bar_C110_0.125in_x2.step
hardware/exports/body/sendcutsend/cheek_5052-H32_0.187in_x2.dxf
hardware/exports/body/sendcutsend/cheek_5052-H32_0.187in_x2.step
hardware/exports/body/sendcutsend/compute_pallet_6061-T6_0.125in_x1.dxf
hardware/exports/body/sendcutsend/compute_pallet_6061-T6_0.125in_x1.step
hardware/exports/body/sendcutsend/deck_5052-H32_0.100in_x1.dxf
hardware/exports/body/sendcutsend/floor_tray_5052-H32_0.125in_x1.dxf
hardware/exports/body/sendcutsend/floor_tray_5052-H32_0.125in_x1.step
hardware/exports/body/sendcutsend/power_plate_5052-H32_0.100in_x1.dxf
hardware/exports/body/sendcutsend/power_plate_5052-H32_0.100in_x1.step
hardware/exports/body/sendcutsend/turret_plate_6061-T6_0.125in_x1.dxf
hardware/exports/body/sendcutsend/turret_plate_6061-T6_0.125in_x1.step
hardware/exports/body/shell/apex_fillet_envelope.step
hardware/exports/body/shell/d435_cradle_front.step
hardware/exports/body/shell/d435_cradle_front.stl
hardware/exports/body/shell/d435_cradle_rear.step
hardware/exports/body/shell/d435_cradle_rear.stl
hardware/exports/body/shell/ear_bracket_l.stl
hardware/exports/body/shell/ear_bracket_r.stl
hardware/exports/body/shell/eyes_clip.stl
hardware/exports/body/shell/fan_duct.step
hardware/exports/body/shell/fan_duct.stl
hardware/exports/body/shell/knee_wedge_front_envelope.step
hardware/exports/body/shell/knee_wedge_rear_envelope.step
hardware/exports/body/shell/shell_door.step
hardware/exports/body/shell/shell_door.stl
hardware/exports/body/shell/shell_front.step
hardware/exports/body/shell/shell_front.stl
hardware/exports/body/shell/shell_hatch.step
hardware/exports/body/shell/shell_hatch.stl
hardware/exports/body/shell/shell_rear.step
hardware/exports/body/shell/shell_rear.stl
hardware/exports/body/shell/shell_side_l_front.step
hardware/exports/body/shell/shell_side_l_front.stl
hardware/exports/body/shell/shell_side_l_rear.step
hardware/exports/body/shell/shell_side_l_rear.stl
hardware/exports/body/shell/shell_side_r_front.step
hardware/exports/body/shell/shell_side_r_front.stl
hardware/exports/body/shell/shell_side_r_rear.step
hardware/exports/body/shell/shell_side_r_rear.stl
hardware/exports/bumper_ring.step
hardware/exports/bumper_ring.stl
hardware/exports/camera_cradle.step
hardware/exports/camera_cradle.stl
hardware/exports/cartridge_body.step
hardware/exports/cartridge_body.stl
hardware/exports/chassis.step
hardware/exports/chassis.stl
hardware/exports/cradle.step
hardware/exports/cradle.stl
hardware/exports/dial.step
hardware/exports/dial.stl
hardware/exports/electronics_bay.step
hardware/exports/electronics_bay.stl
hardware/exports/face.step
hardware/exports/face.stl
hardware/exports/flywheel.step
hardware/exports/flywheel.stl
hardware/exports/flywheel_tyre.step
hardware/exports/flywheel_tyre.stl
hardware/exports/head_saddle.step
hardware/exports/head_saddle.stl
hardware/exports/hip_motor_plate.step
hardware/exports/hip_motor_plate.stl
hardware/exports/hip_output_adapter.step
hardware/exports/hip_output_adapter.stl
hardware/exports/hopper.step
hardware/exports/hopper.stl
hardware/exports/hopper_flap.stl
hardware/exports/hopper_lid.step
hardware/exports/hopper_lid.stl
hardware/exports/knee_crank.step
hardware/exports/knee_crank.stl
hardware/exports/knee_motor_plate.step
hardware/exports/knee_motor_plate.stl
hardware/exports/knee_output_adapter.step
hardware/exports/knee_output_adapter.stl
hardware/exports/laser_mount.step
hardware/exports/laser_mount.stl
hardware/exports/leg/apex_spacer.3mf
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
