Valpatel/gyropup/.agents/plans/assembly-staging/native-261/README.md

# Original native geometry for the retained assembly arrivals

Job261 is the single reviewed native collection from product source
`e5b3089277448e5ae3d546fc36c549a62949856b`. Its original producer uses the unchanged
recorded `e662a1ce` CAD toolkit/runtime. It emitted233 STL and original worldshape
BREP payloads; both archive seals, all728 members, original BREP byte/content
hashes and placements,95 source inputs and preservation inventories were checked.
The independent collection receipt accepts collection identity only.

All233 actual fresh STL byte hashes equal the retained `540056ba4e59` meshes;
the95 CAD inputs, hardware tree and both guides' actual membership, installation
order, offsets, cameras, dependencies and instructions also match. Keep the
fresh and retained execution identities separate. The retained guides and
manufacturing originals were not replaced, relabelled or adopted anew.

The subsequent one-time pure binding uses reviewed core
`011a29b6fe1ddf4a6726fa01f59d710cbf1d6757`. It captures both fresh guides and
preserves233 original BREP payloads and their aarch64 producer platform. The
171/233-instance binding maps, input/execution receipts and474-file inventory
are recorded here. No validation BREP read-back, native world/frame query,
insertion sweep or physical assembly simulation ran during that binding.
Author receipts remain immutable author records; independent acceptance is
recorded separately rather than rewriting those observations.

The unchanged original payloads remain in the sealed job261 archives. Retrieve
only terminal outputs into a fresh directory and verify the seals/member maps:

```text
fleet-run fetch 261 <fresh-owned-directory> --outputs-only --max-mb 768
python3 -B .agents/plans/assembly-staging/native-261/audit.py \
  --fetched <fresh-owned-directory> --out <fresh-audit-directory> \
  --toolkit <clean-reviewed-core-011-checkout>
```

The portable audit rechecks archived and actual extracted files, source-Git
inputs,233 STL/BREP identities, actual bounds and retained guide correspondence
without executing CAD. Its genuine replay reproduced `collection-audit.json`
byte-for-byte. The raw BREP/STL payloads are not copied into this checkpoint;
the manifests/seals and standard job retrieval identify their exact bytes.
Keep the remote collection and the older provider runtime until the follow-up
native input bundles have been retrieved and reviewed.

A distinct native preflight must next verify BREP read-back, shape/world-frame
and actual captured mesh/model bounds before any potentially quadratic path
sweep. The separate core progress/preflight follow-up is being prepared to expose
starting/completed phases, pairs and operations for flushed recoverable JSONL;
it requires its own reviewed source pin. A time-limited or failed run remains incomplete, with
actual invalid shapes, unknowns and collisions retained. Do not repair geometry,
infer intended-overlap exemptions, or interpret a byte binding/zero-offset view
as a passing insertion path. Support, fixtures, compliance, tools, fastening,
wiring, physical fit, strength and manufacturing readiness remain unqualified.
