Valpatel/gyropup/.agents/plans/assembly-staging/native-264/README.md

# Keep the capped native study and its unchecked paths visible

Job 264 reached its reviewed 300s native-phase cap, reaped both child processes,
and exited 1. All ten preservation guards passed. The complete 482-member archive
retains 475 original 263 input files, the unchanged 90-query plan, and a source-bound
partial report/progress prefix. These results apply only to source 542b9a40/core 5c29
and original 261 CAD, including the old belly bay. No source or leg geometry changed.

The [author audit](artifact-audit.json) verifies archived and actual files,
input/source/case/baseline seals, all guards, cleanup and each recorded pair
against the complete [plan](../pair-study/plan.json). The [raw report](report.json)
and [phase](phase.json) remain incomplete/running; the [553-record progress prefix](progress.jsonl)
contains 42 completed pairs and one interrupted start. It records 36 clear results
and six terminal-seat overlaps; 48 queries have no completed result. The four
observed current diagnostic contexts are clear. Every old-order/wrong-side
control is still unchecked. No transient blocked result was observed in this
prefix; that does not establish an all-clear sequence.

| Moving / fixed instance | Terminal overlap mm³ |
| --- | ---: |
| L.hip_frame / cheek_left | 44.003843 |
| R.hip_frame / cheek_right | 44.003843 |
| L.screws_outputs / L.motor_front | 1060.287521 |
| L.screws_outputs / L.motor_rear | 1060.287521 |
| L.screws_wheel / L.wheel_link | 2353.555552 |
| L.screws_wheel / L.wheel_hub | 44.107961 |

A seat result returns before the transient sweep. The hip/cheek final overlap
was not exposed by the centroid mesh screen. [Baseline classification](seat-classification.json)
found the exact same volume/centroids already in retained body connectivity
records 39/46, declared by its rigid hip-frame fastener joints before the candidate
recipe. That is a pre-existing seated contact, not a new transient obstruction;
it remains unqualified and grants no playback exemption. The motor/fastener envelope contacts were already unqualified.
Do not turn either into an overlap exemption or change a printing leg to pass
this diagnostic. Of 36 clear results, 25 report a positive path gap lower bound;
11 are zero-bound/touching. These finite native checks do not qualify continuous
clearance, support, tools, physical assembly or manufacturing.

The phase reports 552 flushed and 512 file-fsync-acknowledged records; 553 complete
JSONL records are actually retained, with an uncertain tail. Preserve observed
bytes without certifying prior power-loss durability. SIGKILL ran no Python
finally: final unchecked/query-count/world-stat fields and nativeCLI exit receipt
are absent. Derive 48 uncompleted IDs from the full plan minus 42 completed pair
events: one interrupted R.hip_frame/R.motor_rear and 47 not started.

```text
fleet-run fetch 264 <fresh-owned-directory> --outputs-only --max-mb 256
python3 -B audit.py <fetched-job-directory> <product-checkout>
```

The [execution receipt](execution.json) preserves the cap/cleanup/guard facts
and raw/private argv hashes; [checkpoint seals](checkpoint.json) bind these files.
Independent [post-action review](https://github.com/Valpatel/gyropup/issues/276#issuecomment-6774431800)
accepted this partial artifact scope; the study remains incomplete. Its
[original receipt](independent-audit.json) and [portable pure audit](independent-audit.py)
are preserved. Supply fetched264, accepted263 member manifest, an independently
reconstructed full-plan file and optional fresh receipt path to that audit. The [smallest proposed next question](next-question.json)
records the hip/cheek baseline classification and proposes two currently untested
old-order/wrong-side probes, explicitly selected from the unchanged full plan.
It requires a new source/action review; no retry or next native job is authorized
by this evidence. PR279 publication remains held.
