Valpatel/gyropup/software/site/designer/assembly/README.md

# Build guide composition

Product controls and progress for the existing Build route. Generic schema,
asset verification and absolute model state belong to `../kit/assembly/guide.js`
and `../kit/viewer.js`, copied from the independently reviewed cad-agent change.
No CAD builder or simulation is imported by this page. Snapshot completion is
separate from existing procurement and printing flags.
