Valpatel/gyropup/tests/site/assembly/fixtures/README.md

# Frozen assembly contract fixtures

Version one and version two are deliberately distinct synthetic triangular
plates, text and model memberships. Their `released` schema status exercises
version-selection behaviour in tests; they are not real Gyropup releases or
published product history. They remain outside the site's publication boundary.
The browser suite offers these two fixtures alongside the actual source-bound
WIP to prove version/model/text/progress isolation.
