Valpatel/gyropup/software/site/assets/build-guides/turret-wip-4866459e2abd/README.md

# Turret assembly guide snapshot

Educational WIP only. Generated from the authored recipe and exact committed scene.
Existing legacy assembly illustrations remain historical; none are reused as fresh posters.
