Valpatel/gyropup/.agents/inbox/2026-11-09-assembly-guides-need-recipe-and-mesh-binding.md

# Bind assembly instructions to their recipe as well as mesh identities

On 2026-11-09, read-only inspection of main `4866459e` found the live Build page had procurement/printing tables but no assembly view. All 53 logical additions in the retained turret sequence resolved to the current scene, yet `hardware/exports/turret/assembly/steps.json` step 8 and `docs/turret/turret-assembly.md` still specified the old zero-degree upper stop. The actual authored `hardware/cad/turret/turret_assembly.py` STEPS already specified +12/-25. Matching part names was therefore not freshness evidence.

The guide adapter consumes the literal current recipe without importing CAD, checks every original file against the pinned Git commit and scene digest, and bakes the existing neutral joint translations exactly once. It retains all original mesh triangle order/normals and explicit coverage/exclusions. Shared guide/view loading binds the recipe/model/mesh identities; product source metadata retains BOM and original producer identities. The historical page receives only a clear archival preface; its old payload is not rewritten or relabelled current.

Corrective rule: generate interactive state, written instructions and fresh illustrations from one bound recipe, retaining camera, frame, offsets, part-instance membership and source identity. Never combine a name-compatible old step export with newer geometry without checking actual recipe/picture freshness. Existing motor-day visual-input checks provide the same precedent for parts/offsets/camera. Do not alter unrelated geometry or relax manufacturing validators merely to publish instructions.

Limits: translation and viewer presentation cannot establish assembly access, fit, safe tightening, strength, feed behaviour or laser class. This lesson accompanies an implementation draft; actual browser/poster/release/publication results remain separate gates.

## Bind immutable instruction data; validate compiled HTML semantically

The first integrated static build rejected a raw `instructions.html` digest because the existing site compiler legitimately injects prototype notices, model links and content-versioned URLs into published HTML. That build remained failed. An initial browser probe was mistakenly started before its result was inspected; its exact owned service was stopped, its listener closed and no result accepted.

The corrected consumer binds unchanged `instructions.json` bytes to the guide and checks the compiled HTML against those same stage IDs, titles, prose, parts and poster identities. It permits normal compiler furniture outside the instruction content; it rejects a changed stage heading or stop instruction. The pure regression covers both legitimate compiler transformations and actual stale-title/prose mutations. This avoids both treating source HTML bytes as served HTML and dropping meaningful instruction freshness checks.

## Keep the active scene alive while its replacement loads

The 2026-11-10 pre-poster functional probe at `678d4ba3` reached its 180-second whole-service limit while waiting for a fixture switch. Earlier executed assertions are recorded separately in `.agents/plans/versioned-build-guide-preposter-probe.json`; this is not evidence that the individual switch consumed the entire limit or that the suite passed. The owned listener and browser process group were stopped.

Source inspection then found an independent lifecycle defect: the product retained the successful viewer's abort controller as the pending request. Starting another snapshot aborted and disposed the already-active scene before its replacement was ready. Clear only the completed pending controller after committing the replacement; aborting a superseded pending request must leave the active scene intact. The real product switching control checks a corrupt replacement, a held superseded request, version-scoped progress with denied storage, and disposal only after a successful replacement. Short named scopes preserve useful failure timing without changing the full CI feature matrix. Actual corrected browser acceptance remains pending.

A WebKit probe at `872fcfab` then rejected a real projected pick target at y=24.57, under the sticky site header after a preceding part-list click had scrolled the tall step. Preserve that failure; before testing a canvas action, return the canvas vertically into view and still require the actual target to be unoccluded. A valid projected 3D coordinate is not proof of an accessible pointer target. This correction changes the test's ordinary navigation setup, not the renderer or its acceptance assertion.

## Honor an authored underside camera instead of accepting a clamped view

On 2026-11-10, final capture-source inspection found current recipe step 6 requests CAD direction `[0.6, -1, -0.35]`. The product's preserved stage sets `controls.maxPolarAngle = 1.5`; the mm/z-up to display basis maps that direction below the horizontal, so `controls.update()` clamps it. Earlier membership/material checks did not compare the actual camera direction and therefore did not establish the authored view. This is a presentation contract gap, not a geometry or clearance result.

Corrective rule: permit underside inspection only for guide-bound viewer instances, retaining ordinary viewer behavior; compare actual camera-minus-target against the authored CAD direction transformed once into the display basis. The existing product twelve-step loop and repeatable poster capture both enforce that comparison, including the underside step. Shared source correction and actual browser acceptance are recorded separately; do not capture or label a clamped view as the authored diagram.

The first legacy Build regression at `80a64f68` found 698 expected model files versus the unchanged 643-entry engineering download catalogue. The exact 55-file difference was the new neutral guide-display mesh set under `web/build-guides`; there were no other omissions or extras. The existing site deliberately copies web assets separately from its engineering catalogue roots. The corrected test excludes only the exact immutable guide/model-declared mesh set after path containment and Git/served SHA checks, retaining full engineering-original equality. An undeclared presentation STL or any missing engineering original still fails; no broad web-folder exclusion or catalogue expansion is used.

The 2026-11-10 loading regression at `4bea5d30` also retained an actual timeout caused by a copy-sensitive control: it waited for plural `parts`, while the extended viewer says `Loading model part 1 of 1…`. That prevented the test from releasing its deliberately held mesh, leading to the real bounded download timeout. The control now waits for the actual intercepted mesh request, checks loading state and no usable canvas, then releases it and still requires a real drawn frame. Readiness tests should bind actual resource/scene state rather than incidental singular/plural progress copy. No loader timeout, failure classification or renderer threshold changes.

At `1c5e119a`, an actual no-WebGL version-switch probe showed a valid new text-only guide was blocked: the current WIP had no viewer, yet selecting a valid second fixture retained the WIP and said `Your previous build remains selected`. Protect a previous **working viewer** on render failure; do not prevent validated text/poster navigation when both states are already text-only. Metadata/poster errors still reject before commit. The existing full fallback scope now checks two distinct frozen versions plus real WIP, independent completion state, no stale diagram inheritance and return to the original current diagram. No-script copy explicitly labels its ordinary immutable link as the default WIP; it does not claim URL version/step selection works without JavaScript.

## Measure the completed guide and actual touch input

On 2026-11-10, PR267 at `fc79cd99` retained two actual CI failures. WebKit's emulated phone reported `navigator.maxTouchPoints === 0`, so a capability assertion stopped before any tap. The corrected existing phone scope retains `hasTouch`, native taps, unoccluded 44px targets and actual selection/navigation assertions, and additionally requires trusted `touchstart` events on controls and the canvas. Both engines delivered six trusted touch events; the observed capability value remains recorded rather than being treated as interaction evidence.

The layout job reported a 137px band between the scope summary and appearance select while its screenshot already contained the newly loaded chapter buttons and 3D model in that interval. The existing readiness barrier waited for procurement's `body.dataset.ready`, which can precede the separate assembly guide. Wait for the actual guide's ready state before scanning its DOM. The same consumer now holds the real guide model response, verifies procurement and fonts alone cannot release measurement, then requires the completed canvas and three chapters. All existing planted gap/blank-picture/blank-canvas/missing-picture/column controls still pass. The exact Build/iPhone/light case passes with a worst gap of 0.14 screen under its unchanged 0.18 limit. No pixel threshold, product layout, model or camera was changed for these two test corrections. Full current CI and publication remain separate.

The first complete WebKit legacy Build run also failed at an offscreen Progress `#parts` summary's native locator stability check after procurement persistence/import/export passed. The isolated identical fresh click succeeded (11 sampled frames, ordinary scrolling); this does not establish the internal cause of the full-flow timeout. The existing Parts & prints navigation link is an ordinary user path that opens the native section. The corrected test follows that link, asserts the disclosure is open, and retains all following native table, original-download and actual STL/STEP/3MF controls. Both engines passed the complete regression. Failure screenshots/state are now saved if this consumer fails again. This follows the [existing visible-control lesson](https://github.com/Valpatel/cad-agent/blob/dev/.agents/inbox/2026-11-07-folder-inventories-need-explicit-owners.md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), without claiming a shared root cause, forcing clicks or increasing timeouts.
