Valpatel/gyropup/.agents/plans/end-packs/current-print-correspondence.md

# Current hip preparation through separately bound historical evidence

Implementation follows [independent RouteA design review](https://github.com/Valpatel/gyropup/issues/193#issuecomment-6775808908).
The [job266 acceptance](https://github.com/Valpatel/gyropup/issues/193#issuecomment-6775564625)
accepts collection only. The [separate measurement review](https://github.com/Valpatel/gyropup/issues/193#issuecomment-6776726093)
accepted the exact56.5317s current correspondence artifact. Its original bytes
and separate acceptance are now bound by the authority module; the measured
producer, sampler and historical validator remain unchanged. No guide/public
asset is adopted by this checkpoint. Issue193/PR287 remain open.

## Two required contracts

`tools/evidence/manufacturing/retained_fit_history.py` owns the sole bounded
offline captured-data validator. Fixed reviewed receipt/job/snapshot anchors,
96 exact regular USTAR input files and current executed helper identities are
required. It calls the unchanged strict validator against actual original
artifacts. `verify-retained-fit-history.py` additionally runs the full unchanged
packager. Counts322/40/8 and all readiness flags remain false. Matching-input
snapshotf77 is distinct from recorded slice producer017e1e03. The original
[failed CI job](https://github.com/Valpatel/gyropup/actions/runs/42866125306/job/130005097895)
stays visible. No original receipt, output, source guard or default CLI changes.

`tools/site/assembly/robot_current_print_match.py` owns a thin current contract
around the unchanged sampler. It requires exact accepted266 collection/runtime/
frame identity, exact95 current input membership and bytes, all80 protected
leg mesh hashes and actual bytes, the original hip STL, sampler and historical
validator bytes, plus the complete historical receipt contract. Its explicit
measurement compares both actual hip meshes to the print original in the
existing fixed print transform, bidirectionally sampling vertices/triangle
centres at0.3011mm and rejecting the actual3mm wrong-frame control.

The native record's SHA is checked by its exact canonical original JSON
serialization in the consumer, allowing metadata and meshes to occupy separate
tracked source locations after a separately approved adoption. The measurement
CLI additionally requires the actual original `collection.json` bytes. The
mesh root is explicit; no legacy guide or private-history lookup supplies it.

The existing manufacturing mapper selects this contract explicitly for266.
There is no historical fallback after a current-source failure. Pending or
wrong proof remains pending. Existing project verification/readback can reuse
the original immutable geometry-only3MF only after the new current match is
accepted. Scope stays L/Rhip, generic bed, unsliced and physically unqualified.
Unrelated parts are not enabled. No generic CAD/UI implementation is forked.

## Separate measurement and review before adoption

Freeze implementation; independently review an exact one-action packet with:

```text
python -B tools/site/assembly/robot_current_print_match.py
  --collection-folder <accepted266 collection and actual mesh root>
  --out <fresh external measurement directory>
```

The action uses standard-library mesh arithmetic, one CPU and a120s bound;
the prior exact two-side comparison took55.09s. This is a proposed bound, not
permission to execute. No CAD, BREP readback, slicer, native installation or
browser is needed. Require exact clean implementation SHA, before/after source
and input byte seals, fresh exclusive output, retained original stderr/status,
owned-process cleanup and recoverable per-side incomplete checkpoints.

Independently inspect actual outcomes and all control/identity evidence. A
separate acceptance record must bind the proof hash, collection, original,
current95 inventory, sampler/producer/historical helper, historical snapshot/
manifest/receipt/job anchors, both instances and false physical qualification.
Only after that review may the separate `robot_current_print_acceptance.py`
source anchors be filled. They live apart from measured producer code to avoid
a circular proof/hash update. No self-supplied proof hash grants authority.

## Required remaining acceptance

- [x] Actual strict historical receipt positive and default-current stale
  negative; full actual unchanged package/G-code/profile/metric verification.
- [x] Hidden GNU longname/longlink/PAX and ordinary member/size/alias/digest
  negatives, actual current input/frame/mesh/original byte mutations.
- [x] Reviewed exact measurement packet, genuine current measurement and
  independent artifact acceptance; source anchors populated only afterward.
- [x] Actual accepted current mapper/exporter positive and proof/acceptance
  mutations; all original protected source/output/history/firmware identities.
- [x] Current L/R actual browser Prepare actions, STL downloads, strict3MF
  readbacks, generic-bed/unsliced/historical-failure labels and corrupted
  project negative. Existing workspace harness has explicit `PRINT_CASE=current`
  for this purpose. Both Chrome/WebKit passed against the isolated520505f5
  current candidate; all owned listeners/contexts closed. See the exact
  [consumer checks](current-print-consumer-checks.json). No historical guide
  was relabelled as current, and no public assets were copied.
- [x] Status-board false print-release/blank measurement behavior retained.
- [ ] Only then replace CI ownership explicitly: historical full positive,
  default-current stale negative, current-code pure adversarial controls and
  actual accepted current consumer positive all mandatory. Preserve survey
  verification. No `--pure`/workflow waiver is introduced at this checkpoint.
- [ ] Independently reviewed guide adoption/composition and public consumers;
  no native rerun merely to relabel untouched mesh bytes.

The current exact measurement is `a293b1a24614012b894137e7edb6570316f49d279078bb1f1e40f9e9a5302f0b`;
its separate acceptance is `0ddf1fe712d5b8c114aefc072a7abfade153070d8f56986380f40d46adfda625`.
Each side sampled44,470 original-to-current and19,828 current-to-original
points, with maxima0.15697024/0.13665468mm under0.3011mm. The actual3mm
wrong-frame control failed as required. Both engine campaigns downloaded the
same original STL and existing geometry-only3MF, verified original identity
and independently read back the actual downloaded3MF topology, pose, units
and generic-bed bounds. Other parts stayed pending; corrupt project bytes
did not produce a3MF download. These are source-bound candidate checks, still
pending independent guide/consumer acceptance and adoption.

Historical integrity and sampled mesh correspondence do not qualify current
body clearance/removal, optics, supports/retention, compliance/drop, fastening,
manufacturing or physical fit. Those gates remain separate and visible.
