Valpatel/gyropup/hardware/exports/rig/print-schedule.md

# Print schedule: the first leg, its rig and the bench fixtures (Bambu P1S)

One P1S with a hardened nozzle and extruder, textured PEI with glue for PA6-CF. **355.5 h of printing** (pa6-cf 215.4 h, 3.29 kg, petg 95.5 h, 2.39 kg, tpu95 44.4 h, 0.43 kg), about **18.5 days** at 20 h a day, three weeks with drying and one reprint. The output adapters are machined (D46) and not here. Generated by `tools/print_schedule.py` from `exports/leg/print-plan.json`, `exports/rig/print-plan.json` and `exports/rig/bench/print-plan.json`.

## Drying

- **pa6-cf**: dry 8-12 h at 80 C, feed from a dry box (not the AMS); dry the next spool during the print before.
- **tpu95**: dry 6 h at 65 C; print slow, direct from the spool.
- **petg**: dry 4-6 h at 65 C if the spool was open.

## Plates, in order

| Plate | Start (h) | Material | Parts | Grams | Hours | Why now |
|---|---|---|---|---|---|---|
| A1 Fit coupons and test blocks | 0.0 | pa6-cf | coupon_frame_ring_nom, coupon_frame_ring_m01, coupon_frame_ring_p01, coupon_apex_eye_m01, coupon_knee_eye_m01, sleeve_anvil | 222 | 14.7 | first: every seat and insert dialled in on PA6-CF before any big part (the leg waits on them); B3 and B4 run on these |
| A2 Fit coupons and test blocks | 15.2 | pa6-cf | coupon_apex_eye_nom, coupon_apex_eye_p01, coupon_hub_face_m01, coupon_hub_face_nom, coupon_hub_face_p01, coupon_hub_stub_m01, coupon_hub_stub_nom, coupon_hub_stub_p01, coupon_knee_eye_nom | 218 | 14.1 | first: every seat and insert dialled in on PA6-CF before any big part (the leg waits on them); B3 and B4 run on these |
| A3 Fit coupons and test blocks | 29.8 | pa6-cf | coupon_knee_boss_m01, coupon_knee_boss_nom, coupon_knee_boss_p01, sleeve_block, coupon_knee_eye_p01 | 124 | 8.0 | first: every seat and insert dialled in on PA6-CF before any big part (the leg waits on them); B3 and B4 run on these |
| B1 The dyno and the tyre cradle | 38.3 | petg | dyno_lug_plate x 2 | 422 | 16.9 | ready before the motors land (1-3 weeks): B1 and B2 start that day |
| B2 The dyno and the tyre cradle | 55.7 | petg | dyno_hub x 2 | 292 | 11.7 | ready before the motors land (1-3 weeks): B1 and B2 start that day |
| C1 TPU | 67.9 | tpu95 | dyno_spider x 2, bumper_tpu x 4, stop_sleeve x 6 | 432 | 44.4 | the dyno's spider, B3's sleeves, the rig's bumpers (R0 picks their infill) |
| D1 Upper links | 112.8 | pa6-cf | upper_link x 2 | 724 | 47.5 | with the coupons' seat sizes |
| E1 Front link | 160.8 | pa6-cf | front_link | 442 | 29.0 | turned on the bed |
| F1 Wheel link | 190.3 | pa6-cf | wheel_link | 615 | 40.3 | turned on the bed |
| G1 The rig's printed parts | 231.1 | petg | pod | 493 | 19.7 | the rig's frame goes together from bought parts meanwhile; these finish it before the first power-up |
| G2 The rig's printed parts | 251.3 | petg | pod_lid, top_stop_bracket | 251 | 10.0 | the rig's frame goes together from bought parts meanwhile; these finish it before the first power-up |
| G3 The rig's printed parts | 261.8 | petg | drop_bracket, tof_arm, bumper_base x 2, bumper_cap x 4, load_cell_mount x 2 | 473 | 19.0 | the rig's frame goes together from bought parts meanwhile; these finish it before the first power-up |
| G4 The rig's printed parts | 281.3 | petg | pendant_clip, load_cell_mount x 2 | 26 | 1.0 | the rig's frame goes together from bought parts meanwhile; these finish it before the first power-up |
| H1 Small leg parts and spares | 282.8 | pa6-cf | apex_spacer | 14 | 0.9 |  |
| I1 Hip frame | 284.2 | pa6-cf | hip_frame | 772 | 50.6 | last: 274 x 148 x 81 turned 45 deg; a 150 x 150 PA6-CF test slab first if the P1S has not held PA6-CF flat at that size |
| Z-tof_mount Other | 335.3 | petg | tof_mount | 6 | 0.2 |  |
| Z-ballast_spacer Other | 336.0 | petg | ballast_spacer | 8 | 0.35 |  |
| Z-ballast_spacer Other | 336.8 | petg | ballast_spacer | 8 | 0.35 |  |
| Z-press_cage Other | 337.7 | petg | press_cage | 335 | 13.4 |  |
| Z-press_base Other | 351.6 | petg | press_base | 48 | 1.9 |  |
| Z-press_slider Other | 354.0 | petg | press_slider | 29 | 1.1 |  |
| Z-puller_m5 Other | 355.6 | pa6-cf | puller_m5 | 38 | 2.5 |  |
| Z-puller_m5 Other | 358.6 | pa6-cf | puller_m5 | 38 | 2.5 |  |
| Z-puller_m5 Other | 361.6 | pa6-cf | puller_m5 | 38 | 2.5 |  |
| Z-puller_m8 Other | 364.6 | pa6-cf | puller_m8 | 38 | 2.5 |  |
| Z-bearing_disc Other | 367.6 | pa6-cf | bearing_disc | 2 | 0.13 |  |
| Z-bearing_disc Other | 368.2 | pa6-cf | bearing_disc | 2 | 0.13 |  |
| Z-bearing_disc Other | 368.9 | pa6-cf | bearing_disc | 2 | 0.13 |  |

## Rules

- The coupons (A) decide every seat before the big PA6-CF parts: if a coupon's seat other than the nominal one fits best, the leg's CAD takes that offset before D-I print (the main session's files); evaluate them while B prints.
- Print the hip frame (I) only after the coupons pass and the P1S has printed PA6-CF flat at 150 x 150; the fallback for a frame that warps is a split frame (the main session).
- The motors' bench tests need B's dyno and C's spider; B3 needs C's sleeves and A's sleeve block.
- Weigh every leg part: the rig's ballast table (exports/rig/rig.json) assumes the CAD's masses.
