Valpatel/gyropup/.agents/plans/assembly-staging/ci-frame-budget/COMPOSITION.md

# Keep the accepted UI composition distinct from earlier observer records

The CI follow-up normally merged accepted cumulative286 source1a291c66, producing
immutable code22df1917. Its entire product and site-tool tree is exactly1a; the
CI changes remain test/helpers/package scripts and their evidence/guidance only.
Original27902d7/280e340 heads and every native261–265/core5c identity are preserved.

The hop runtime, existing stage and gamepad bridge remain byte-identical to the
source used by the real gated/stopped controls and full-gamepad check. Those
receipts retain their original02d7 staged-source qualification. The accepted UI
does change assembly workspace/playback/CSS/HTML, so only the full affected
WebKit guide suite was rerun on immutable22df code. Its [actual report](guide-webkit-composed.json)
passes15groups with0pageerrors and0unsupported development requests. The owned
listener closed in finally and independently refused connections afterward.

[Composition source/check receipt](composition.json) binds actual code/runtime,
helper/harness bytes and raw reports/logs.20puretests, build,11privacy,6Markdown
and the accepted twelve-poster contract passed. No visual source changed, so no
poster was recaptured; there is no new product/CAD/physical qualification. The
[initial checkpoint](checkpoint.json) remains unchanged with its original source
scope, rejected attempts and pending-composition wording. The separate
[composition seal](composition-checkpoint.json) covers the resulting evidence set.
Normal final-head CI and independent review still apply to the metadata-bearing
follow-up commit; earlier failed CI attempts are not converted to passes.
