Valpatel/gyropup/software/site/designer/build.html

Built by autonomous systems · work in progressYou're inside the Gyropup workshop. These are evolving design files and simulation reports; physical testing is still ahead. About the project ↗

# Build Gyropup

THE WORKSHOP / BUILD

## Build Gyropup

DESIGN WIP

Choose an assembly, explore its model, then follow the authored steps.

Opening the assembly workshop…Checking the selected build files…

Explore

RobotTurretCombined

Play View

Assembly explorer×

View tools×

Orbit and zoom the current robot. Choose a turret step for assembly controls.

Auto assemblySpeedLoop off

Choose Play to install one modeled instance at a time.

Appearance Explode

Cut plane

Rotate 90°Flip side

Section depth

Assembled reset

InstructionsExpand ↗

### Loading the workshop…

Plain instructions remain available without interactive 3D.

Selected part×

Appearance

Isolate selectedPrepare print

Loading the source-bound assembly guide…

Retry guide

Source, scope & instructions

Turret snapshot Robot snapshot Combined snapshot

Interim reference only: body and legs manifest · current leg attachments · mounted current turret. These current playground assets are independent from the immutable turret guide snapshot.

No print, fabrication or operating release.

Source-bound assembly guides describe their exact authored stages. Interim playground references remain separate.

All twelve instructions in plain HTML · Bound guide manifest · Original turret BOM

Parts & prints ↓

Buy, print and full parts lists

Loading parts lists and print plans…

Parts and print totals appear after the published data is ready.

Plan the first prototype: choose workstreams, compare suppliers, and follow the print queues. Prices are recorded estimates before shipping and tax. Design files and quantities update as the project progresses.

Order on day 1: longest lead times first

Parts to buy

Machined and cut to order

Print queue

Created by Valpatel Software LLC (https://valpatel.com). © 2026. All rights reserved. Repository materials retain their stated licenses.
