Valpatel/gyropup/.agents/plans/printable-parts/public-acceptance/fixtures/compiled-build.html

Built by autonomous systems · work in progressYou're inside the Gyropup workshop. These are evolving design files and simulation reports; physical testing is still ahead. About the project ↗

# Build Gyropup

THE WORKSHOP / BUILD

## Build Gyropup

DESIGN WIP

Choose an assembly, explore its model, then follow the authored steps.

Opening the assembly workshop…Checking the selected build files…

Explore

RobotTurretCombined

Play View

Assembly explorer×

View tools×

Orbit and zoom the current robot. Choose a turret step for assembly controls.

Auto assemblySpeedLoop off

Choose Play to install one modeled instance at a time.

Appearance Explode

Cut plane

Rotate 90°Flip side

Section depth

Assembled reset

InstructionsExpand ↗

### Loading the workshop…

Plain instructions remain available without interactive 3D.

Selected part×

Appearance

Isolate selectedPrepare print

Loading the source-bound assembly guide…

Retry guide

Source, scope & instructions

Turret snapshot Robot snapshot Combined snapshot

Interim reference only: body and legs manifest · current leg attachments · mounted current turret. These current playground assets are independent from the immutable turret guide snapshot.

No print, fabrication or operating release.

Source-bound assembly guides describe their exact authored stages. Interim playground references remain separate.

All twelve instructions in plain HTML · Bound guide manifest · Original turret BOM

Parts & prints ↓

Buy, print and full parts lists

Loading parts lists and print plans…

Parts and print totals appear after the published data is ready.

Plan the first prototype: choose workstreams, compare suppliers, and follow the print queues. Prices are recorded estimates before shipping and tax. Design files and quantities update as the project progresses.

Order on day 1: longest lead times first

Parts to buy

Machined and cut to order

Print queue

Created by Valpatel Software LLC (https://valpatel.com). © 2026. All rights reserved. Repository materials retain their stated licenses.

## Warning: unsafe research prototypes

Robots are dangerous. Do not build or operate these machines without proper training. Unexpected movement, falling robots, pinch and crush points, projectiles, high-power motors and batteries can cause serious injury or death and damage property. Electrical and fire hazards are also present.

Gyropup prototypes are unsafe and will not be offered for sale. They are not intended for general public use. Designs are provided for research purposes only. Research work requires appropriate engineering and safety training, a controlled environment, and validated safeguards.

Adult supervision alone does not make these prototypes safe. Supervised child and family play is a future goal requiring proven, validated designs. The browser simulation does not establish hardware safety.

Read the prototype safety notice

Warning / experimental robotics

## High-power robots. Real-world risks.

Unsafe research prototypes

Robots are dangerous. Do not build or operate these machines without proper training.

- Movement & impactUnexpected movement, falling robots, pinch and crush points, and launched projectiles can cause serious injury or death and damage property.
- Power & heatHigh-power motors, batteries and electrical systems introduce additional electrical and fire hazards.
- Trained research onlyResearch work requires appropriate engineering and safety training, a controlled environment, and validated safeguards. Adult supervision alone does not make these prototypes safe.

Gyropup prototypes are unsafe and will not be offered for sale. They are not intended for general public use. Designs are provided for research purposes only.

Supervised child and family play is a future goal requiring proven, validated designs. A working browser simulation, CAD model or test report does not establish hardware safety.

Leave this site ↗ (https://valpatel.com) I understand
