Valpatel/gyropup/software/site/assets/build-guides/combined-wip-3a40891962b0/instructions.html

# combined-wip-3a40891962b0

WIP CAD assembly study. The order explains named construction relationships; it is not a qualified fastening, fit, wiring or powered-operation procedure.

## 1. Full combined CAD reference

Assembled source CAD reference at the 300 mm stance. This overview does not mark any construction operation complete. WIP CAD assembly study. The order explains named construction relationships; it is not a qualified fastening, fit, wiring or powered-operation procedure.

## 2. Body spine and hip mounting faces

Locate the two physical cheek faces and their connecting spacer envelopes. Their CAD mounting holes establish the left/right hip-module datums.

- cheek_left ×1 modeled instances
- cheek_right ×1 modeled instances
- spacers ×1 modeled instances
- spacer_screws ×1 modeled instances

## 3. Floor tray above the spine

The floor tray approaches the top of the spine. Its rendering does not qualify the fasteners.

- floor_tray ×1 modeled instances

## 4. Belly plate below the spine

The belly plate approaches from below; the printed leg interfaces remain unchanged.

- belly_plate ×1 modeled instances

## 5. Conditional end-pack holders and rigid sit feet

These body-side supports approach from below. Purchased adapter mounting, loads and drop/retention qualification remain unresolved.

- end_pack_holder_front ×1 modeled instances
- end_pack_holder_rear ×1 modeled instances
- end_foot_front ×1 modeled instances
- end_foot_rear ×1 modeled instances

## 6. Compute and power support platforms

Identify the support posts, isolated compute pallet and separate power platform. Bus insulators and conductors remain individually identified; this is not electrical approval.

- post_1 ×1 modeled instances
- post_2 ×1 modeled instances
- post_3 ×1 modeled instances
- post_4 ×1 modeled instances
- isolator_1 ×1 modeled instances
- isolator_2 ×1 modeled instances
- isolator_3 ×1 modeled instances
- isolator_4 ×1 modeled instances
- compute_pallet ×1 modeled instances
- plate_post_1 ×1 modeled instances
- plate_post_2 ×1 modeled instances
- plate_post_3 ×1 modeled instances
- plate_post_4 ×1 modeled instances
- power_plate ×1 modeled instances
- dcdc_bracket ×1 modeled instances
- bus_insulator_1 ×1 modeled instances
- bus_insulator_2 ×1 modeled instances
- bus_bar_1 ×1 modeled instances
- bus_bar_2 ×1 modeled instances

## 7. Left stationary motor cases

Present the two motor cases before the hip support closes around them. Their outward arrival avoids passing the cases through the already-installed hip web; the cases still need temporary support. This is a WIP presentation dependency, not a fixture procedure.

- L.motor_front ×1 modeled instances
- L.motor_rear ×1 modeled instances

## 8. Left hip frame, support bearings and lug screw group

Locate the hip frame around the motor cases, then show its support bearings and retained screw groups. Lug screws follow the support and precede the upper links. The source flange screw group remains a group; bearing fits, driver access, temporary support and insert retention are unverified. No torque is specified.

- L.hip_frame ×1 modeled instances
- L.bearing_61812_front ×1 modeled instances
- L.bearing_61812_rear ×1 modeled instances
- frame_screws_left ×1 modeled instances
- cheek_nuts_left ×1 modeled instances
- L.screws_lugs ×1 modeled instances

## 9. Left output adapters and upper links

Each output adapter and its upper link share the authored rotating-link frame. The output screw group precedes the upper links so it does not arrive through their hubs. The front and rear instances are distinct; source screw groups are not individual manufactured screw models.

- L.output_adapter_front ×1 modeled instances
- L.output_adapter_rear ×1 modeled instances
- L.screws_outputs ×1 modeled instances
- L.upper_link_front ×1 modeled instances
- L.upper_link_rear ×1 modeled instances
- L.screws_links ×1 modeled instances

## 10. Left front knee and lower link

The current source uses the 6301 knee cartridge in the front lower link, with separate spacer, eye sleeve, washer, shoulder-pin and nut identities. The pin connects the upper eye and lower knee; the archived 6201-era display is not substituted for this geometry. The inboard bearing is blocked by the lower-link shoulder from outside and the upper eye from inside; this arrival remains illustrative pending subassembly validation.

- L.front_link ×1 modeled instances
- L.knee_bearing_front_in ×1 modeled instances
- L.knee_bearing_front_out ×1 modeled instances
- L.knee_spacer_front ×1 modeled instances
- L.eye_sleeve_front ×1 modeled instances
- L.knee_washer_front ×1 modeled instances
- L.knee_pin_front ×1 modeled instances
- L.knee_nut_upper_front ×1 modeled instances

## 11. Left rear knee and wheel-carrying lower link

Identify the second knee cartridge and the separate wheel-carrying lower link. Its parent/axis comes from the rear upper-link endpoint; it is not attached to the front knee.

- L.wheel_link ×1 modeled instances
- L.knee_bearing_rear_in ×1 modeled instances
- L.knee_bearing_rear_out ×1 modeled instances
- L.knee_spacer_rear ×1 modeled instances
- L.eye_sleeve_rear ×1 modeled instances
- L.knee_washer_rear ×1 modeled instances
- L.knee_pin_rear ×1 modeled instances
- L.knee_nut_upper_rear ×1 modeled instances

## 12. Left apex connection and loop closure

The two lower links meet at the source five-bar apex. The spacer, paired-bearing envelope and circlip remain separate CAD identities. The rigid circlip envelope overlaps its final groove; its illustrated arrival does not model circlip expansion. This closure does not prove physical fit or free motion.

- L.apex_spacer ×1 modeled instances
- L.apex_61812 ×1 modeled instances
- L.apex_circlip ×1 modeled instances

## 13. Left wheel hub, tyre and retained screw groups

The collected wheel hub and tyre share the authored apex/wheel datum. The D69 body collection uses a 254 mm diameter, 64 mm wide tyre-band envelope; its ordered SKU and physical dimensions remain unverified. Keep the wheel-fastener and washer source groups visible as groups. Washers precede screws, arriving from the inboard side of the hub as in the source screw stack. Thread engagement, wiring and tightening remain unqualified.

- L.wheel_hub ×1 modeled instances
- L.wheel_tyre ×1 modeled instances
- L.washers_wheel ×1 modeled instances
- L.screws_wheel ×1 modeled instances

## 14. Left stop posts and four sleeves

Show the fixed stop-post group and four separate sleeve instances after the motor-access stages. Their CAD position is not a release to bond, preload or power the mechanism.

- L.stop_posts ×1 modeled instances
- L.stop_sleeve_1 ×1 modeled instances
- L.stop_sleeve_2 ×1 modeled instances
- L.stop_sleeve_3 ×1 modeled instances
- L.stop_sleeve_4 ×1 modeled instances

## 15. Right stationary motor cases

Present the two motor cases before the hip support closes around them. Their outward arrival avoids passing the cases through the already-installed hip web; the cases still need temporary support. This is a WIP presentation dependency, not a fixture procedure.

- R.motor_front ×1 modeled instances
- R.motor_rear ×1 modeled instances

## 16. Right hip frame, support bearings and lug screw group

Locate the hip frame around the motor cases, then show its support bearings and retained screw groups. Lug screws follow the support and precede the upper links. The source flange screw group remains a group; bearing fits, driver access, temporary support and insert retention are unverified. No torque is specified.

- R.hip_frame ×1 modeled instances
- R.bearing_61812_front ×1 modeled instances
- R.bearing_61812_rear ×1 modeled instances
- frame_screws_right ×1 modeled instances
- cheek_nuts_right ×1 modeled instances
- R.screws_lugs ×1 modeled instances

## 17. Right output adapters and upper links

Each output adapter and its upper link share the authored rotating-link frame. The output screw group precedes the upper links so it does not arrive through their hubs. The front and rear instances are distinct; source screw groups are not individual manufactured screw models.

- R.output_adapter_front ×1 modeled instances
- R.output_adapter_rear ×1 modeled instances
- R.screws_outputs ×1 modeled instances
- R.upper_link_front ×1 modeled instances
- R.upper_link_rear ×1 modeled instances
- R.screws_links ×1 modeled instances

## 18. Right front knee and lower link

The current source uses the 6301 knee cartridge in the front lower link, with separate spacer, eye sleeve, washer, shoulder-pin and nut identities. The pin connects the upper eye and lower knee; the archived 6201-era display is not substituted for this geometry. The inboard bearing is blocked by the lower-link shoulder from outside and the upper eye from inside; this arrival remains illustrative pending subassembly validation.

- R.front_link ×1 modeled instances
- R.knee_bearing_front_in ×1 modeled instances
- R.knee_bearing_front_out ×1 modeled instances
- R.knee_spacer_front ×1 modeled instances
- R.eye_sleeve_front ×1 modeled instances
- R.knee_washer_front ×1 modeled instances
- R.knee_pin_front ×1 modeled instances
- R.knee_nut_upper_front ×1 modeled instances

## 19. Right rear knee and wheel-carrying lower link

Identify the second knee cartridge and the separate wheel-carrying lower link. Its parent/axis comes from the rear upper-link endpoint; it is not attached to the front knee.

- R.wheel_link ×1 modeled instances
- R.knee_bearing_rear_in ×1 modeled instances
- R.knee_bearing_rear_out ×1 modeled instances
- R.knee_spacer_rear ×1 modeled instances
- R.eye_sleeve_rear ×1 modeled instances
- R.knee_washer_rear ×1 modeled instances
- R.knee_pin_rear ×1 modeled instances
- R.knee_nut_upper_rear ×1 modeled instances

## 20. Right apex connection and loop closure

The two lower links meet at the source five-bar apex. The spacer, paired-bearing envelope and circlip remain separate CAD identities. The rigid circlip envelope overlaps its final groove; its illustrated arrival does not model circlip expansion. This closure does not prove physical fit or free motion.

- R.apex_spacer ×1 modeled instances
- R.apex_61812 ×1 modeled instances
- R.apex_circlip ×1 modeled instances

## 21. Right wheel hub, tyre and retained screw groups

The collected wheel hub and tyre share the authored apex/wheel datum. The D69 body collection uses a 254 mm diameter, 64 mm wide tyre-band envelope; its ordered SKU and physical dimensions remain unverified. Keep the wheel-fastener and washer source groups visible as groups. Washers precede screws, arriving from the inboard side of the hub as in the source screw stack. Thread engagement, wiring and tightening remain unqualified.

- R.wheel_hub ×1 modeled instances
- R.wheel_tyre ×1 modeled instances
- R.washers_wheel ×1 modeled instances
- R.screws_wheel ×1 modeled instances

## 22. Right stop posts and four sleeves

Show the fixed stop-post group and four separate sleeve instances after the motor-access stages. Their CAD position is not a release to bond, preload or power the mechanism.

- R.stop_posts ×1 modeled instances
- R.stop_sleeve_1 ×1 modeled instances
- R.stop_sleeve_2 ×1 modeled instances
- R.stop_sleeve_3 ×1 modeled instances
- R.stop_sleeve_4 ×1 modeled instances

## 23. Compute stack and sensor envelopes

Locate the tracked J501/AGX assembly and the individually named sensor mounts/envelopes. The robot model uses the tracked parameter snapshot; supplier dimensions and cable access are separate checks.

- item.j501_carrier ×1 modeled instances
- item.agx_module ×1 modeled instances
- item.agx_spreader ×1 modeled instances
- item.agx_cooler ×1 modeled instances
- item.j501_standoff_15_16.5 ×1 modeled instances
- item.j501_standoff_165_16.5 ×1 modeled instances
- item.j501_standoff_15_146.5 ×1 modeled instances
- item.j501_standoff_165_146.5 ×1 modeled instances
- item.lidar_box ×1 modeled instances
- item.lidar_coil ×1 modeled instances
- d435_cradle_front ×1 modeled instances
- d435_cradle_rear ×1 modeled instances
- d435_front ×1 modeled instances
- d435_rear ×1 modeled instances
- eyes_board ×1 modeled instances
- eyes_clip ×1 modeled instances
- ear_bracket_l ×1 modeled instances
- ear_bracket_r ×1 modeled instances
- ear_pod_l ×1 modeled instances
- ear_pod_r ×1 modeled instances
- item.vn100 ×1 modeled instances

## 24. Power electronics envelopes

These are source layout envelopes on the power platform and the conditional front/rear drop-in mounts. No adapter purchase/fit, series wiring, charging or hot-swap architecture is selected by this view.

- item.plate_vesc_r ×1 modeled instances
- item.plate_vesc_l ×1 modeled instances
- item.plate_main_switch ×1 modeled instances
- item.plate_shunt ×1 modeled instances
- item.power_dcdc ×1 modeled instances
- item.plate_mrbf_block ×1 modeled instances
- item.plate_fuses ×1 modeled instances
- item.plate_mcu_board ×1 modeled instances
- item.plate_buck_5v ×1 modeled instances

## 25. Front Azocek adapter reservation

Conditional unmeasured outline only. Mounting holes, rail, latch, ratings and positive retention remain unresolved.

- item.battery_adapter_front ×1 modeled instances

## 26. Rear Azocek adapter reservation

Conditional unmeasured outline only. Mounting holes, rail, latch, ratings and positive retention remain unresolved.

- item.battery_adapter_rear ×1 modeled instances

## 27. Front/rear vertical drop-in pack envelopes

Both packs approach down from the +188 mm reservation and remove upward. This does not establish actual rail or latch travel.

- item.battery_front ×1 modeled instances
- item.battery_rear ×1 modeled instances

## 28. Deck, turret plate and lidar mounting datum

Locate the deck, source turret support plate/riser and lidar geometry. The TM mounting face and pan-axis X coordinate are recorded from body_params.tm(), not the archived playground.

- deck ×1 modeled instances
- turret_plate ×1 modeled instances
- turret_plate_nuts ×1 modeled instances
- riser ×1 modeled instances
- item.vlp16_window ×1 modeled instances
- item.vlp16_housing ×1 modeled instances

## 29. Enclosure reference

The final reference includes the modeled doors and shell panels. Explanatory explosion is not a validated insertion path; keep access and fastening work unresolved.

- shell_side_l_front ×1 modeled instances
- shell_side_l_rear ×1 modeled instances
- shell_side_r_front ×1 modeled instances
- shell_side_r_rear ×1 modeled instances
- shell_front ×1 modeled instances
- shell_rear ×1 modeled instances
- shell_door ×1 modeled instances
- shell_hatch ×1 modeled instances
- fan_duct ×1 modeled instances

## 30. Mounted turret subassembly

The already-modeled turret subassembly is located on the actual collected P3 riser TM face and pan-axis datum. This is not the bench model transplanted at an assumed height. Its internal build order and unplaced fitting gaps remain those of the separate Turret WIP guide; this step does not qualify those fittings.

- turret.pan_base ×1 modeled instances
- turret.base_board_carrier ×1 modeled instances
- turret.pan_ring ×1 modeled instances
- turret.pan_spacer ×1 modeled instances
- turret.pan_pinion ×1 modeled instances
- turret.tilt_yoke ×1 modeled instances
- turret.cradle ×1 modeled instances
- turret.horn_boss ×1 modeled instances
- turret.pivot_spacer ×1 modeled instances
- turret.cartridge_body ×1 modeled instances
- turret.flywheel ×1 modeled instances
- turret.flywheel_2 ×1 modeled instances
- turret.flywheel_tyre ×1 modeled instances
- turret.flywheel_tyre_2 ×1 modeled instances
- turret.dial ×1 modeled instances
- turret.hopper ×1 modeled instances
- turret.hopper_lid ×1 modeled instances
- turret.hopper_flap ×1 modeled instances
- turret.barrel ×1 modeled instances
- turret.laser_mount ×1 modeled instances
- turret.bumper_ring ×1 modeled instances
- turret.ring_carrier ×1 modeled instances
- turret.ring_driver ×1 modeled instances
- turret.board_bay ×1 modeled instances
- turret.board_bay_lid ×1 modeled instances
- turret.pan_servo ×1 modeled instances
- turret.pan_bearing ×1 modeled instances
- turret.pan_bearing_inner ×1 modeled instances
- turret.circlip_50 ×1 modeled instances
- turret.pan_clamp ×1 modeled instances
- turret.cradle_plate_l ×1 modeled instances
- turret.cradle_plate_r ×1 modeled instances
- turret.stop_lug ×1 modeled instances
- turret.slip_ring ×1 modeled instances
- turret.slip_ring_rotor ×1 modeled instances
- turret.ring_coupling ×1 modeled instances
- turret.ring_leads_rotor ×1 modeled instances
- turret.base_board ×1 modeled instances
- turret.base_board_screws ×1 modeled instances
- turret.base_carrier_screws ×1 modeled instances
- turret.base_board_inserts ×1 modeled instances
- turret.base_carrier_inserts ×1 modeled instances
- turret.turret_board ×1 modeled instances
- turret.index_magnet ×1 modeled instances
- turret.hall_switch ×1 modeled instances
- turret.dt_receptacle ×1 modeled instances
- turret.dt_plug ×1 modeled instances
- turret.tilt_servo ×1 modeled instances
- turret.tilt_bearing ×1 modeled instances
- turret.tilt_bearing_inner ×1 modeled instances
- turret.shoulder_screw ×1 modeled instances
- turret.flywheel_motor_l ×1 modeled instances
- turret.flywheel_motor_r ×1 modeled instances
- turret.cartridge_board ×1 modeled instances
- turret.esc_l ×1 modeled instances
- turret.esc_r ×1 modeled instances
- turret.feed_motor ×1 modeled instances
- turret.ct_thumbscrew ×1 modeled instances
- turret.laser ×1 modeled instances
- turret.laser_screws ×1 modeled instances
- turret.laser_inserts ×1 modeled instances
- turret.hopper_inserts ×1 modeled instances
