Valpatel/gyropup/software/site/assets/build-guides/turret-wip-4866459e2abd/instructions.html

← Interactive Build guide

# Turret bench assembly · WIP

Educational WIP walkthrough. Fit, tightening, feed, laser class and safe operation remain unqualified. No print or fabrication release.

Source 4866459e2abdb6c7f5f25e9448156b6615593499. The same authored sequence feeds interactive and plain instructions.

## 1. The pan base and its inserts

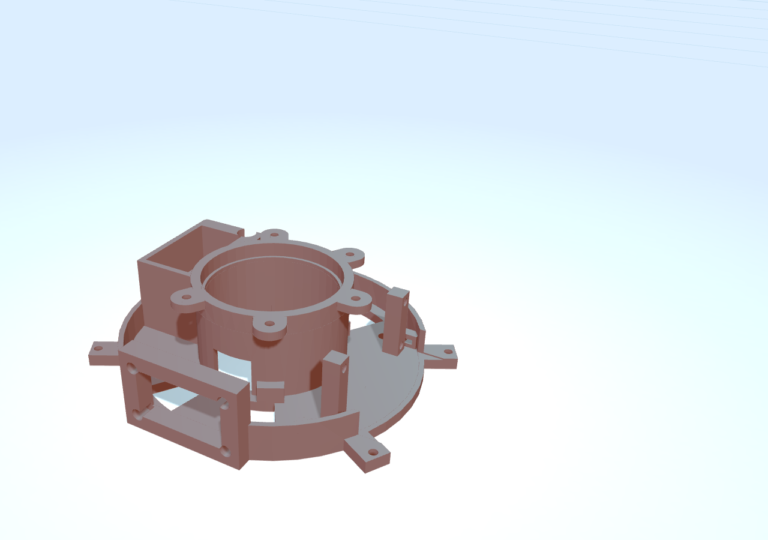
[picture p332: software/site/assets/build-guides/turret-wip-4866459e2abd/posters/step-01.png]
The pan base and its inserts


Heat-set inserts first, with the base on its foot: 5 x M3 in the clamp ears, 3 x M3 in the carrier bosses (from below), 4 x M3 in the external carrier anchors, 4 x M4 in the DT pad. The bumper tabs' 5 short M3 wait for the robot (no bumper on the bench, D42).

- Pan base ×1 modeled instances

## 2. The pan servo, its pinion and the DT12 receptacle

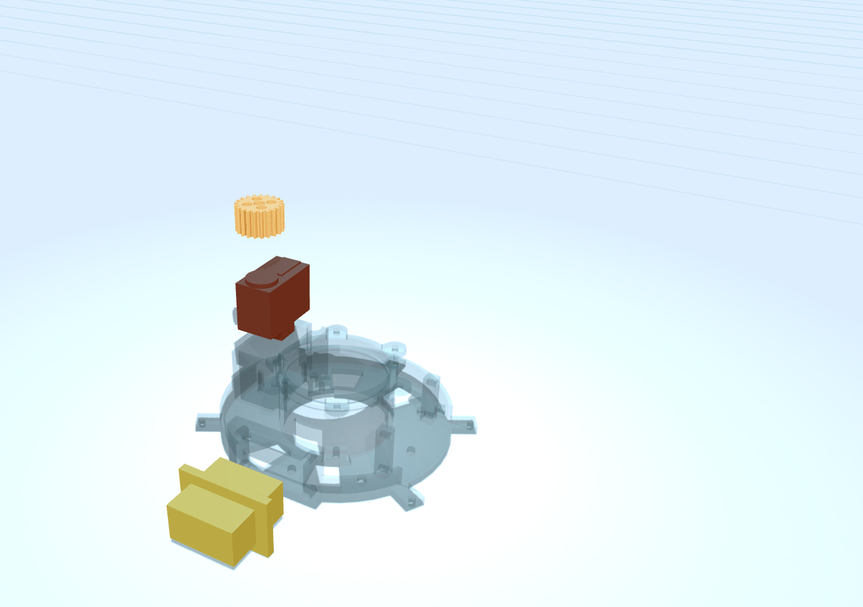
[picture p333: software/site/assets/build-guides/turret-wip-4866459e2abd/posters/step-02.png]
The pan servo, its pinion and the DT12 receptacle


The STS3215 drops into its pocket, bus plugs down, on its four posts: 4 x M2 x 20 up through the foot. The pinion on its horn: 4 x M3 x 16 (heads sunk). The DT04-12PA on the pad: 4 x M4 x 10; its 12 pins and the W12P wedge with the harness to the base board.

- Pan servo ×1 modeled instances
- Pan pinion (21 T) ×1 modeled instances
- DT12 socket ×1 modeled instances

## 3. The removable base-board module and the index magnet

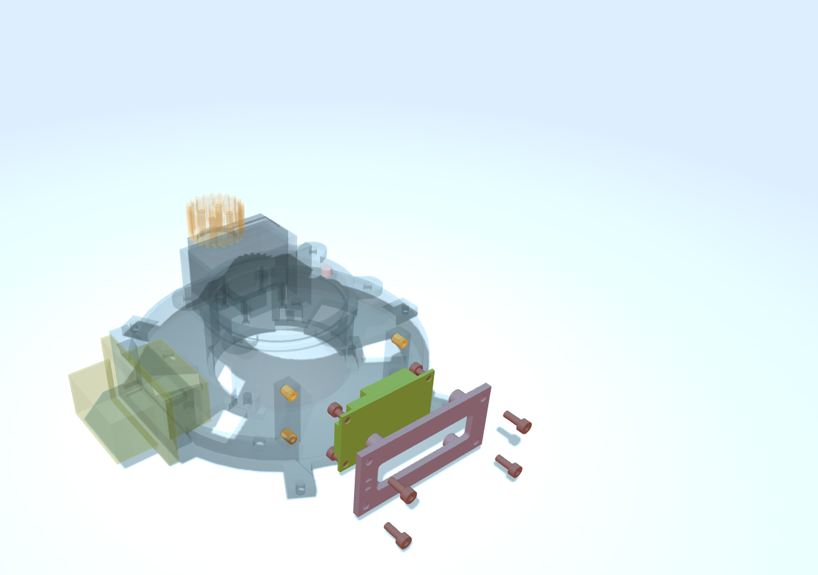
[picture p334: software/site/assets/build-guides/turret-wip-4866459e2abd/posters/step-03.png]
The removable base-board module and the index magnet


On the bench, fit four M3 inserts in the carrier and screw the drilled PCB onto its standoffs with four M3 x 6. Fit four M3 inserts in the base anchors from +x. Connect the harness, then slide the entire module in from +x and secure it with four M3 x 8 from outside. Remove the robot bumper before service; PCB screws are accessed only on the bench. Harness disconnection access and slack remain unverified: docs/base-board-service.md. Glue the index magnet in its housing pocket.

- base board carrier ×1 modeled instances
- base board ×1 modeled instances
- base board inserts ×1 modeled instances
- base board screws ×1 modeled instances
- base carrier inserts ×1 modeled instances
- base carrier screws ×1 modeled instances
- index magnet ×1 modeled instances

## 4. The pan bearing and its clamp

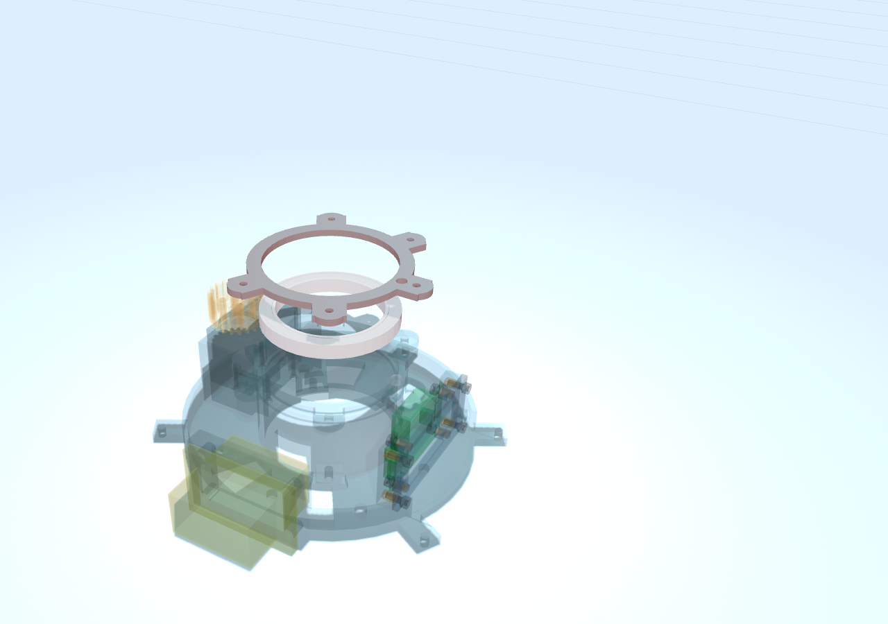
[picture p335: software/site/assets/build-guides/turret-wip-4866459e2abd/posters/step-04.png]
The pan bearing and its clamp


The 6810-2RS pressed into its seat onto the Ø62 shoulder; the aluminium clamp ring (SendCutSend) over it: 5 x M3 x 8.

- Pan bearing ×1 modeled instances
- pan bearing inner ×1 modeled instances
- Bearing clamp ×1 modeled instances

## 5. The turntable, its spacer and the circlip

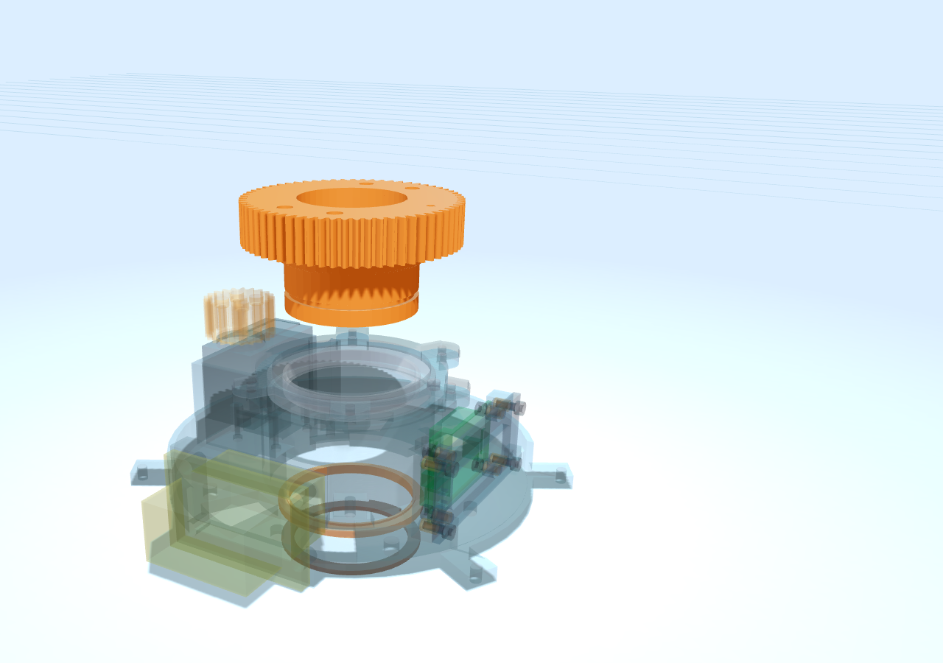
[picture p336: software/site/assets/build-guides/turret-wip-4866459e2abd/posters/step-05.png]
The turntable, its spacer and the circlip


Before it goes in: 4 x M4 inserts in its top, the hall switch glued in the pocket underneath (leads up its hole). Its journal down through the inner race, the gear in mesh with the pinion; from below, through the foot's Ø65 opening, the spacer and the DIN 471-50 circlip in its groove (circlip pliers).

- Pan ring (63 T) ×1 modeled instances
- hall switch ×1 modeled instances
- pan spacer ×1 modeled instances
- circlip 50 ×1 modeled instances

## 6. The ring driver and the slip ring on its carrier

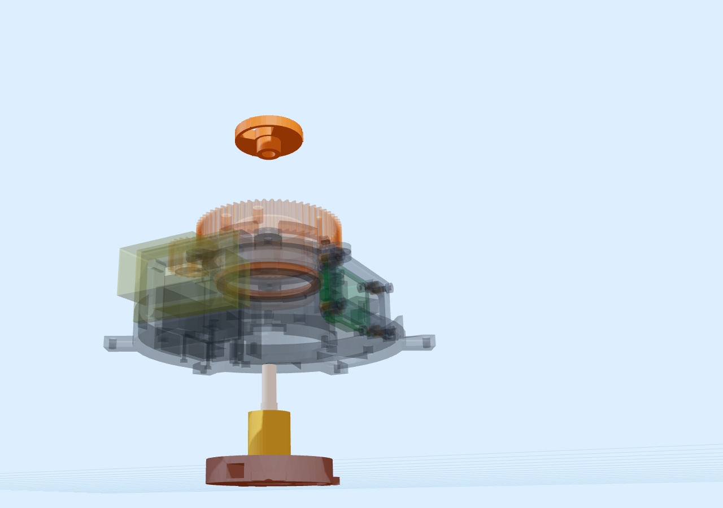
[picture p337: software/site/assets/build-guides/turret-wip-4866459e2abd/posters/step-06.png]
The ring driver and the slip ring on its carrier


The driver pressed into the top of the turntable's bore (three crush ribs and a drop of CA). The ring screwed to its carrier (3 x M3 x 8 with washers), a 25 mm length of the 5/16 in tube on its rotor stub, its rotor leads gathered; from below, the ring goes up the bore, the tube into the driver's socket and the leads out through the driver's crescent; the carrier's tabs into their pockets: 3 x M3 x 10 flat heads.

- ring driver ×1 modeled instances
- slip ring ×1 modeled instances
- slip ring rotor ×1 modeled instances
- ring coupling ×1 modeled instances
- ring carrier ×1 modeled instances

## 7. The tilt yoke and the turret-board bay

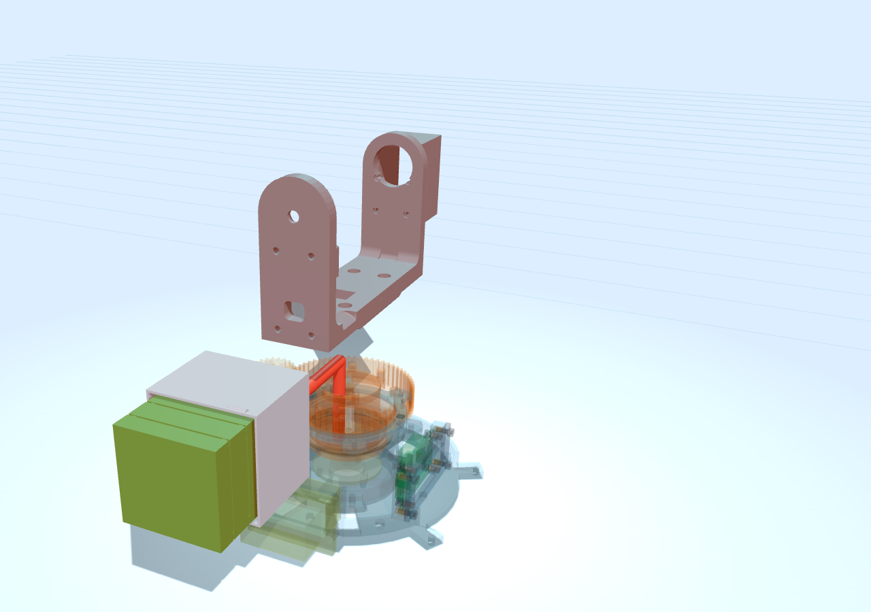
[picture p338: software/site/assets/build-guides/turret-wip-4866459e2abd/posters/step-07.png]
The tilt yoke and the turret-board bay


The rotor leads through the yoke's slot, the yoke on the turntable: 4 x M4 x 12. 4 x M3 inserts in the -y arm, the bay on them: 4 x M3 x 8 flat heads; the three boards on their standoffs (12 and 14 mm); the ring's rotor plug and the hall into level 2.

- Tilt yoke ×1 modeled instances
- ring leads rotor ×1 modeled instances
- Board bay ×1 modeled instances
- turret board ×1 modeled instances

## 8. The tilt servo and the cradle on its aluminium cheeks

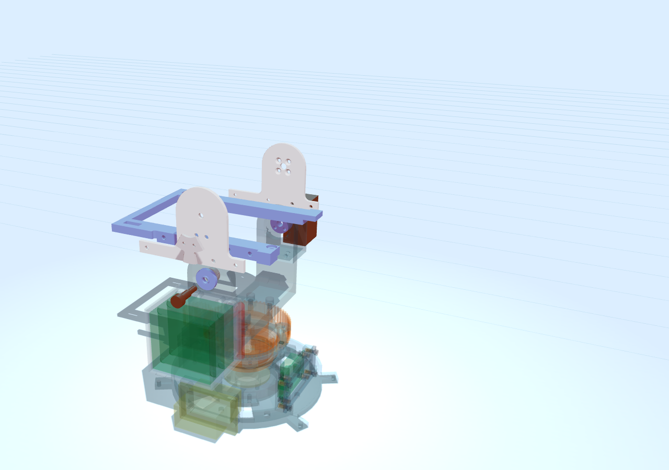
[picture p339: software/site/assets/build-guides/turret-wip-4866459e2abd/posters/step-08.png]
The tilt servo and the cradle on its aluminium cheeks


The rail frame, its two aluminium plates and the stop lug go together on the bench (D48): 8 x M3 inserts into the rail frame's two rebates, put in from the side; the aluminium stop lug onto the -y plate's outer face, 2 x M3 x 6 flat heads from the plate's inner face into its tapped holes, a drop of CA gel under it; each plate into its rail's rebate, 4 x M3 x 8 button heads. Then the STS3215 into its pocket on the +y arm, 4 x M2 x 10 from the arm's inner face, and the MR126 into the -y arm's seat. The cradle between the arms: the horn boss between the +y plate and the servo's horn, 4 x M3 x 14 flat heads from the plate's inner face into the horn (snug: 1.8 mm of thread); on the -y side the pivot spacer, its land against the bearing, and the ISO 7379 shoulder screw through the arm, the bearing and the spacer into the plate's tapped hole (snug, about 0.15 N m, a drop of CA gel on the thread). Check the +12 and -25 deg stops by hand before anything else: the lug meets the yoke's two sectors, and the barrel cannot be pushed past either.

- Tilt servo ×1 modeled instances
- Tilt bearing ×1 modeled instances
- tilt bearing inner ×1 modeled instances
- Cradle ×1 modeled instances
- cradle plate l ×1 modeled instances
- cradle plate r ×1 modeled instances
- stop lug ×1 modeled instances
- horn boss ×1 modeled instances
- pivot spacer ×1 modeled instances
- shoulder screw ×1 modeled instances

## 9. The laser

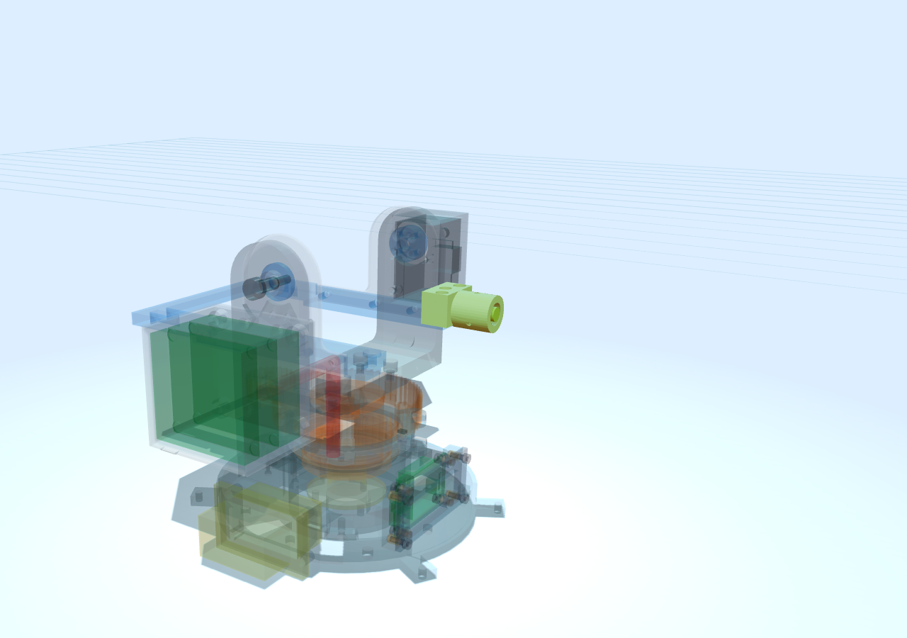
[picture p340: software/site/assets/build-guides/turret-wip-4866459e2abd/posters/step-09.png]
The laser


The mount on the cradle's tab: 2 x M3 x 10 up through it; the laser in the mount on three nylon-tip M3 set screws (boresight them on the bench).

- Laser mount ×1 modeled instances
- Aiming laser ×1 modeled instances

## 10. The cartridge: feed servo, dial, flywheel motors and the cartridge board

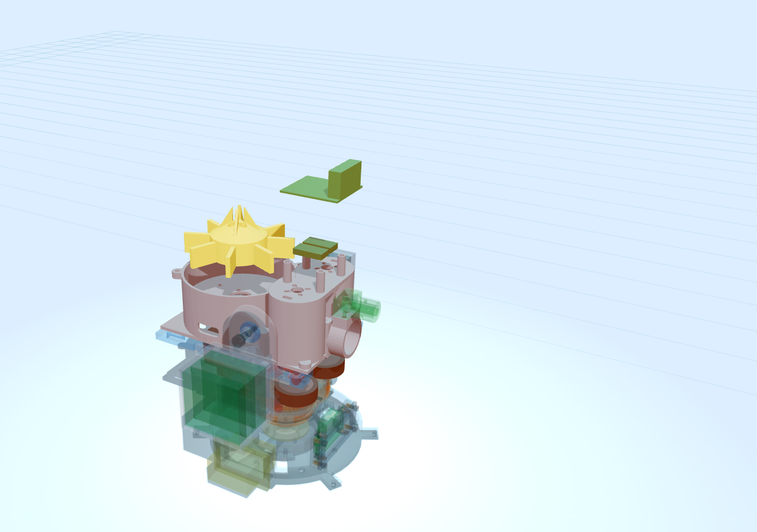
[picture p341: software/site/assets/build-guides/turret-wip-4866459e2abd/posters/step-10.png]
The cartridge: feed servo, dial, flywheel motors and the cartridge board


On the bench, not on the turret. The feed servo (its bus ID set to 3 beforehand) up against the dial floor's underside, its horn through the floor and its length to the rear: 4 x M2 x 6 flat heads from above, flush. The dial onto the horn: 4 x M3 x 8 down through the holes in its cone (the hopper off); set the servo's zero so a pocket is centred over the exit hole and write the count down. Each X2216 with its hub: the prop adapter from its box on the bell (3 x M2), the hub's flat face on the adapter's flange, its bore reamed to 5.00 on the pilot, the washer and an M5 nylon-insert nut (snug plus a quarter turn); turn it by hand with a dial indicator on the rim: under 0.15 mm, or re-seat; then the Ø34 tyre stretched on. Each motor goes up through the opening under its shell to the plate, its leads out through the slot: 4 x M3 x 6 in the radial slots (never longer: the motor has 2.8 mm of thread). The two AM32 ESCs on the cage plate on foam tape, each motor's leads to its ESC; the cartridge board on its four posts over them (4 x M3 x 6), the brake FETs' drains to the phase leads, and the pigtail to the two CT plugs (docs/turret-wiring.md).

- Ball cartridge ×1 modeled instances
- Feed servo (STS3215) ×1 modeled instances
- Feed dial ×1 modeled instances
- Flywheel motor L ×1 modeled instances
- Flywheel motor R ×1 modeled instances
- Flywheel hub ×2 modeled instances
- Flywheel tyre ×2 modeled instances
- Cartridge board ×1 modeled instances
- ESC L ×1 modeled instances
- ESC R ×1 modeled instances

## 11. The barrel, the hopper and the lid

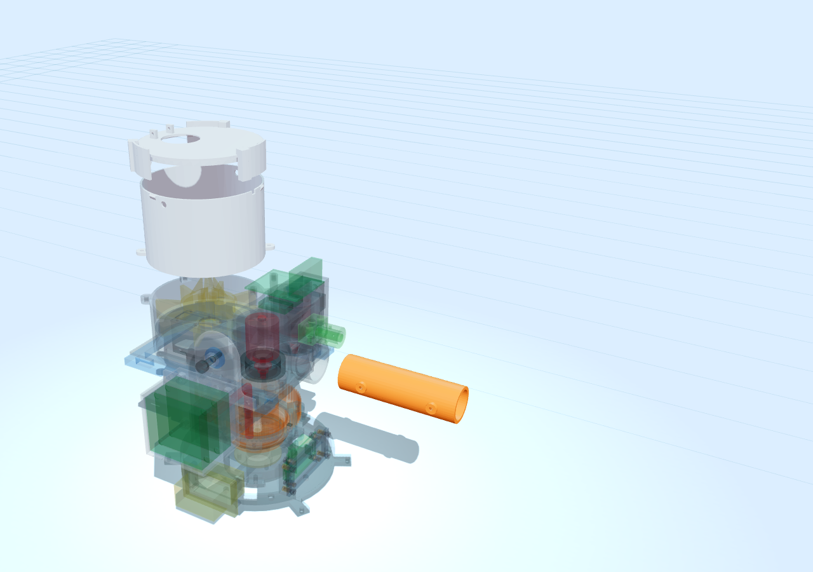
[picture p342: software/site/assets/build-guides/turret-wip-4866459e2abd/posters/step-11.png]
The barrel, the hopper and the lid


The barrel into its socket (a nylon-tip M3 set screw through the socket's insert), the gates' emitters and receivers in its bosses; the hopper on the housing (3 x M3 x 8: the front one through the hole in the cage plate); the lid. The fill flap and its spring wait for the dock (v1).

- Barrel ×1 modeled instances
- Hopper ×1 modeled instances
- Hopper lid ×1 modeled instances

## 12. The cartridge on the cradle, the mount

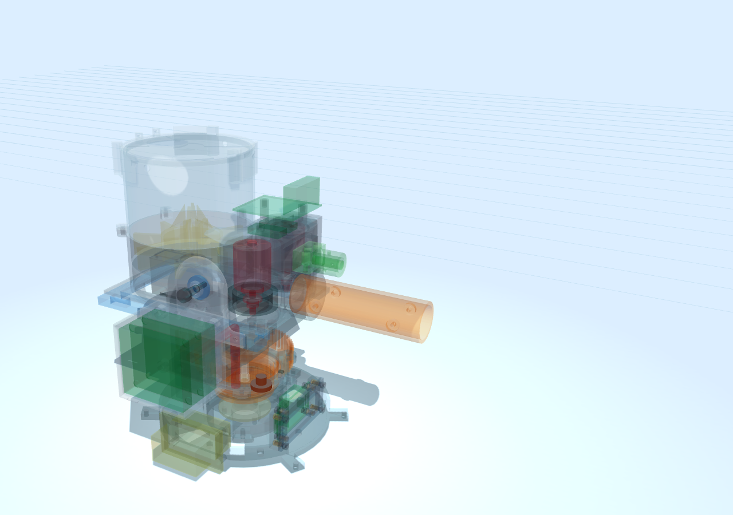
[picture p343: software/site/assets/build-guides/turret-wip-4866459e2abd/posters/step-12.png]
The cartridge on the cradle, the mount


The cartridge down onto the cradle's two dowels, the knurled thumbscrew up into its insert (its O-ring keeps it in the rail); the two CT plugs (2 x 3 power, 2 x 5 signal). Then the turret on its stand: 2 x Ø5 dowels, 4 x M5 x 16, and the DT12 plug (the stand's two dock inserts went in from below with a flat tip, the top face on a flat plate and the seat checked flat after; the dock adapter's M3s are no longer than its base + 5 mm). The TPU bumper ring (5 x M3 x 20 and oversized washers on the base's tabs) is for the robot (v1).

- ct thumbscrew ×1 modeled instances
