Valpatel/gyropup/.agents/plans/assembly-staging/native-262/README.md

# Keep the failed frame-preparation attempt visible

Job 262 exited1 before core checkout or any native query. Its candidate member
comparison included producer-time0600 permissions; the fleet epilog had frozen
all retained regular files to 0640. The guard stopped at candidate inventory
comparison, after both candidate manifest/archive seals passed. The guide,
hardware and tracked before-captures were not reached; their false terminal
summary guards do not establish drift.

The [checkpoint](checkpoint.json) binds the original source, reviewed packet,
terminal result and [read-only lifecycle audit](input-lifecycle-audit.json).
All 486 candidate and 242 guide names, hashes and sizes still match the accepted
[producer manifests](../native-261/README.md). Original archive/manifest seals
remain unchanged. The installed epilog exactly matches its retained source.
No retry or CAD result is represented here.

A separately reviewed successor must check the exact600-to640 freeze contract,
keep the original byte seals, and compare actual before/after modes unchanged.
A different mode, membership or byte change must fail. The regression lives in
`test_robot_data.py`; `verify_frozen_inventory` never modifies inputs.
