Valpatel/gyropup/.agents/plans/assembly-staging/ci-279-a9/playback-failed.png

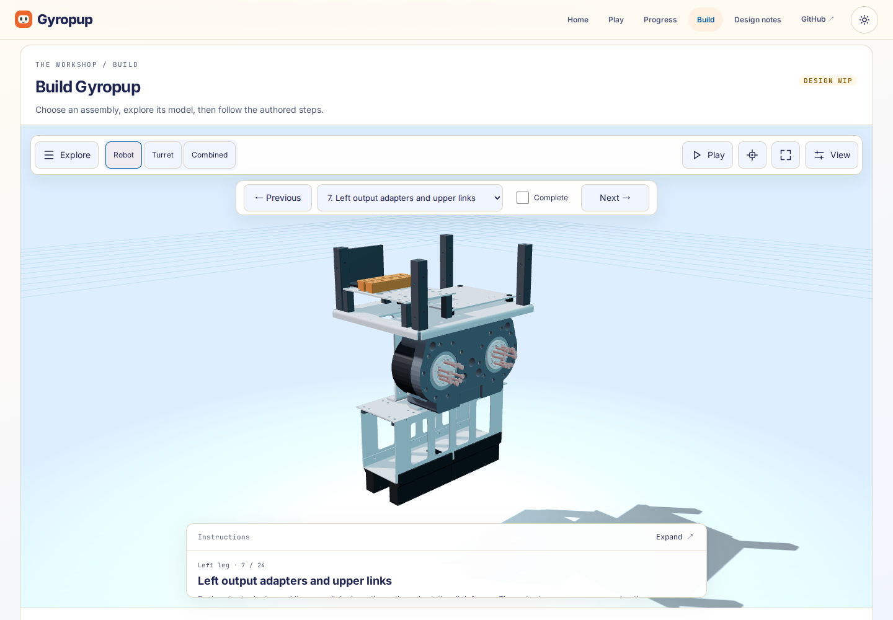
.agents/plans/assembly-staging/ci-279-a9/playback-failed.png
