Valpatel/gyropup/.agents/plans/build-workspace-evidence/playback-document-identity-chromium-1d0.png

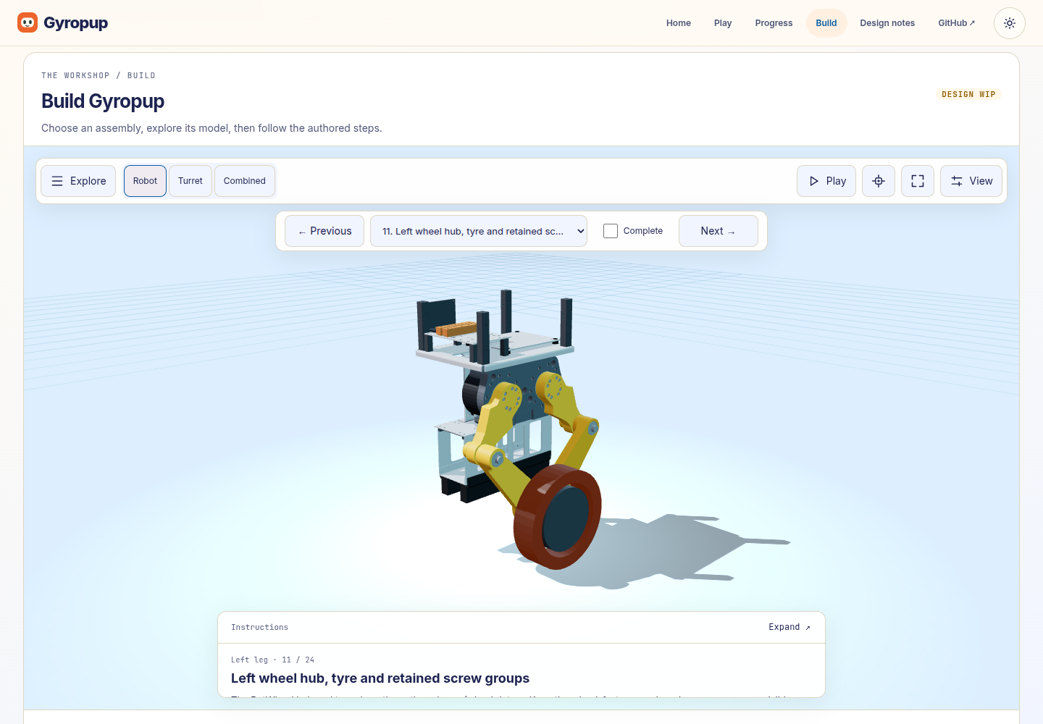
.agents/plans/build-workspace-evidence/playback-document-identity-chromium-1d0.png
