Valpatel/gyropup/.agents/plans/instruction-docking/after-390-native.png

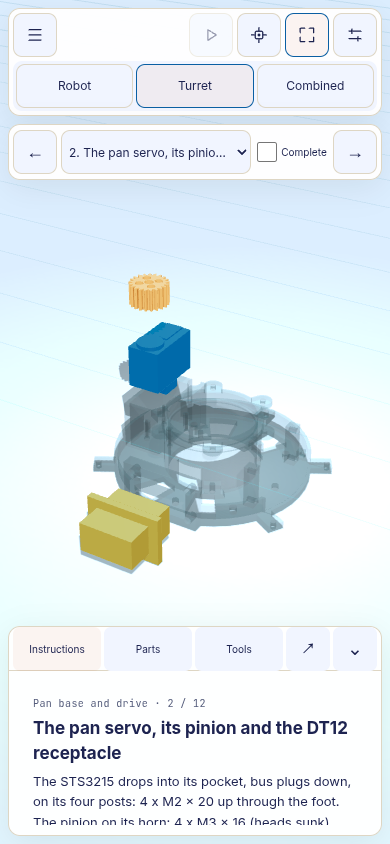
.agents/plans/instruction-docking/after-390-native.png
