Valpatel/gyropup/.agents/plans/instruction-docking/after-844-phone-native.png

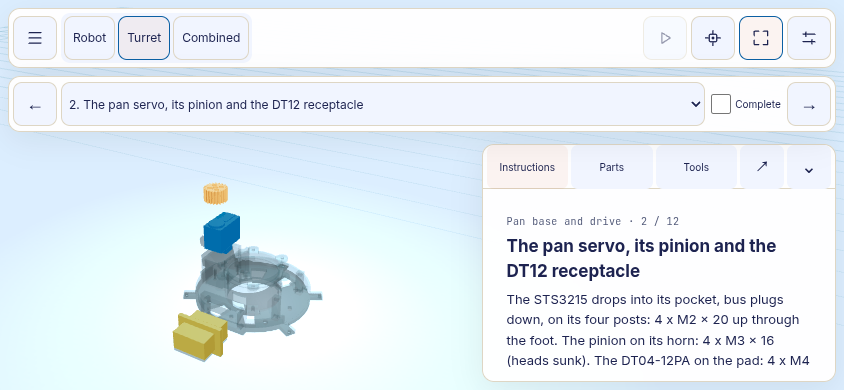
.agents/plans/instruction-docking/after-844-phone-native.png
