Valpatel/gyropup/.agents/plans/instruction-docking/after-1440-native.png

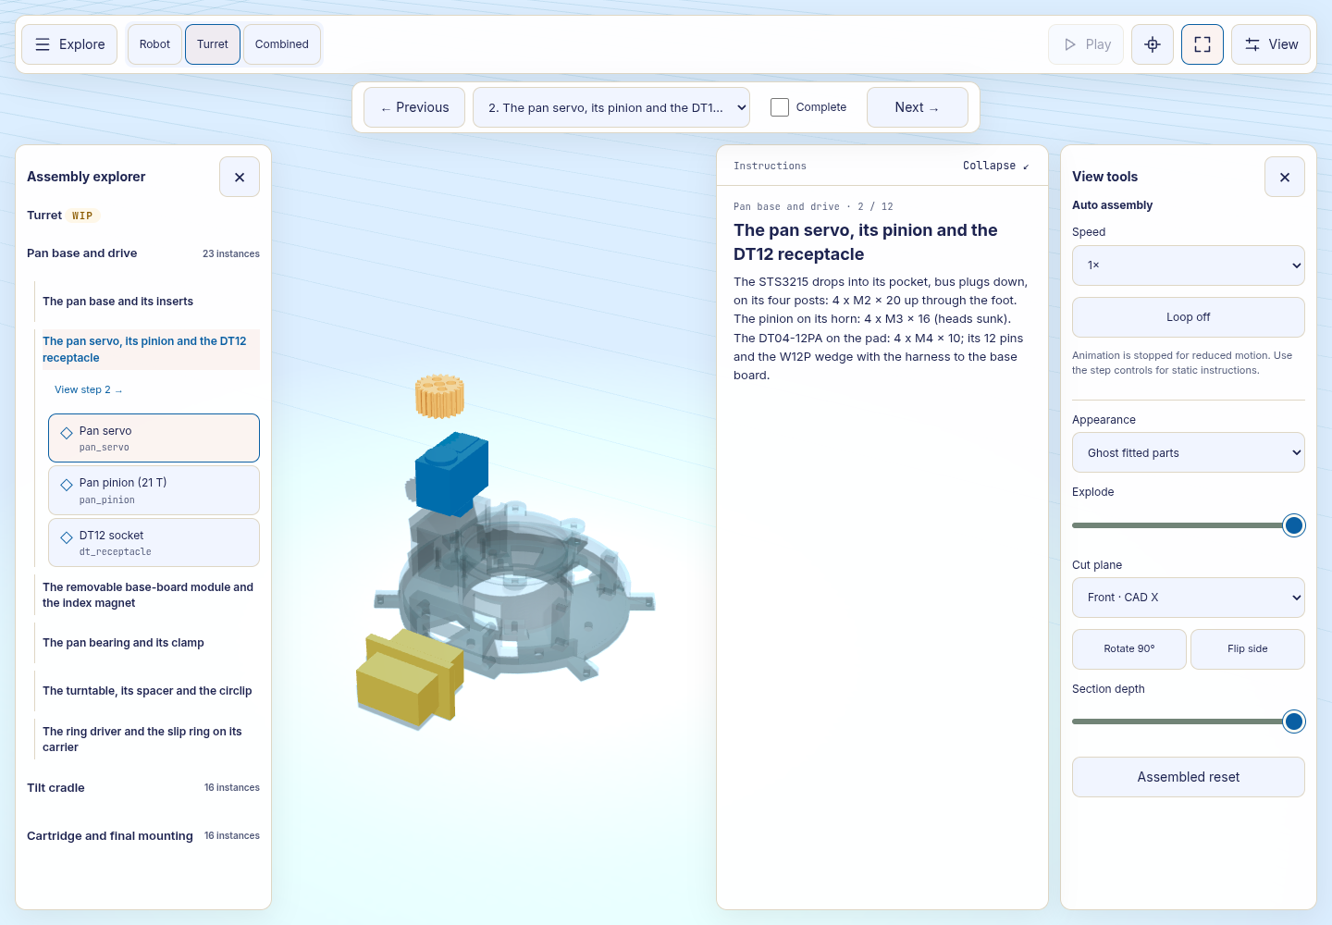
.agents/plans/instruction-docking/after-1440-native.png
