Valpatel/gyropup/.agents/plans/instruction-docking/before-1280-native.png

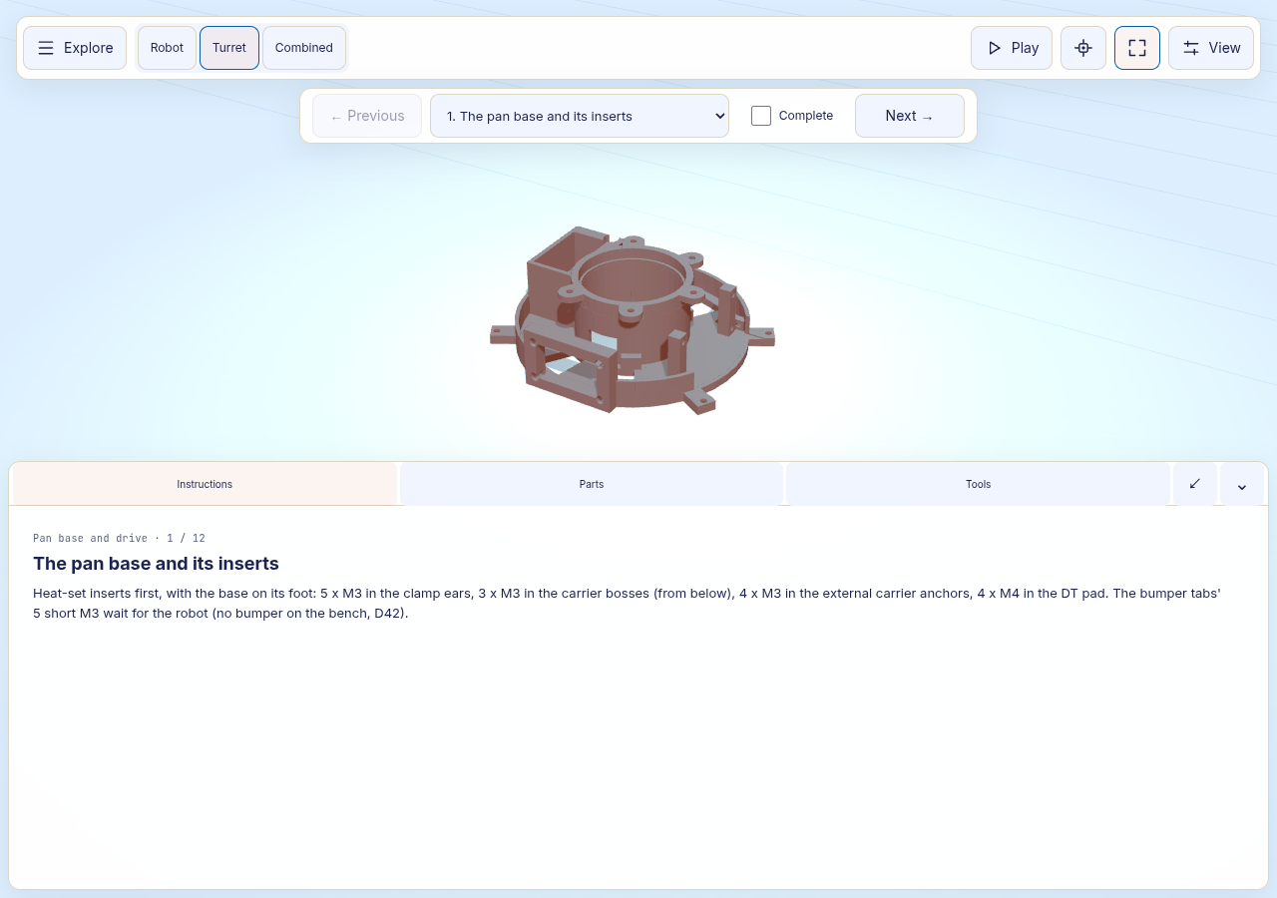
.agents/plans/instruction-docking/before-1280-native.png
