Valpatel/gyropup/.agents/plans/instruction-docking/composed-df7/chromium-native-1024-isolated-popup.png

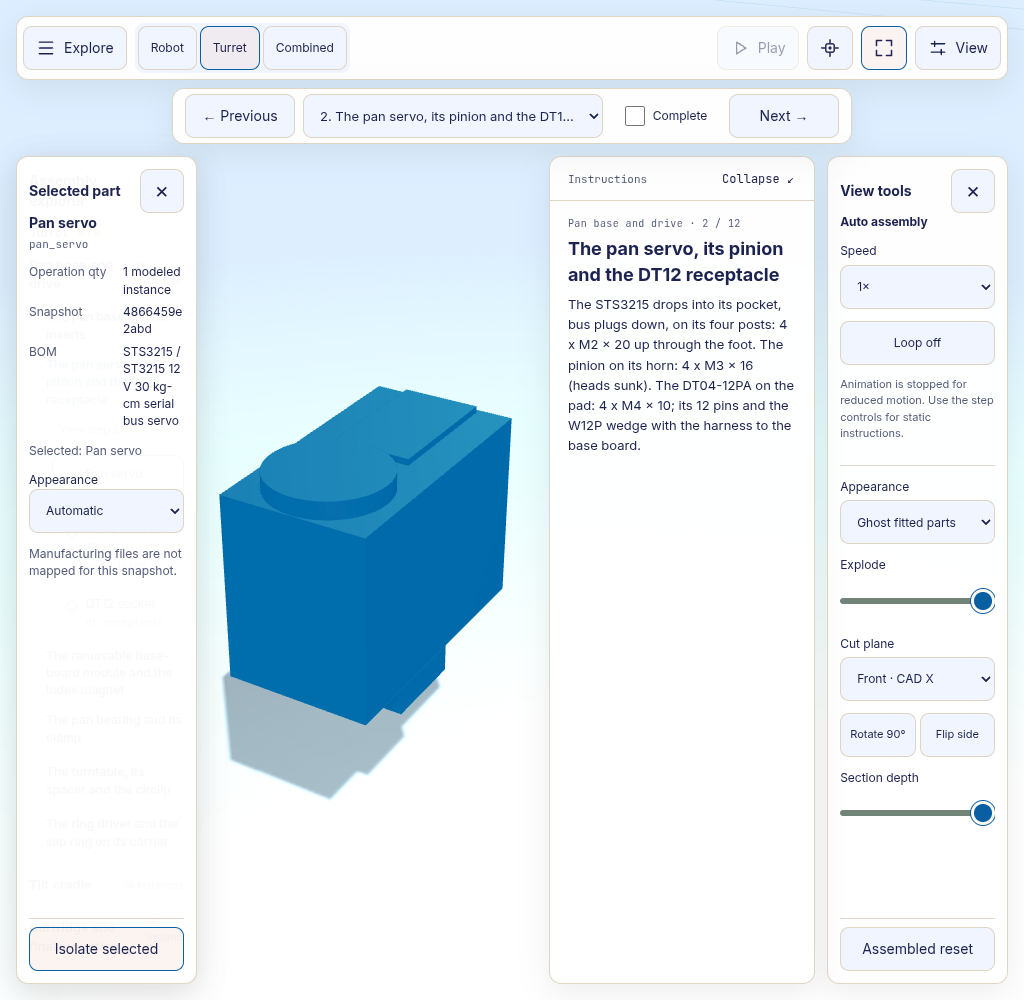
.agents/plans/instruction-docking/composed-df7/chromium-native-1024-isolated-popup.png
