Valpatel/gyropup/.agents/plans/instruction-docking/composed-df7/chromium-robot-stopped-control-activation.png

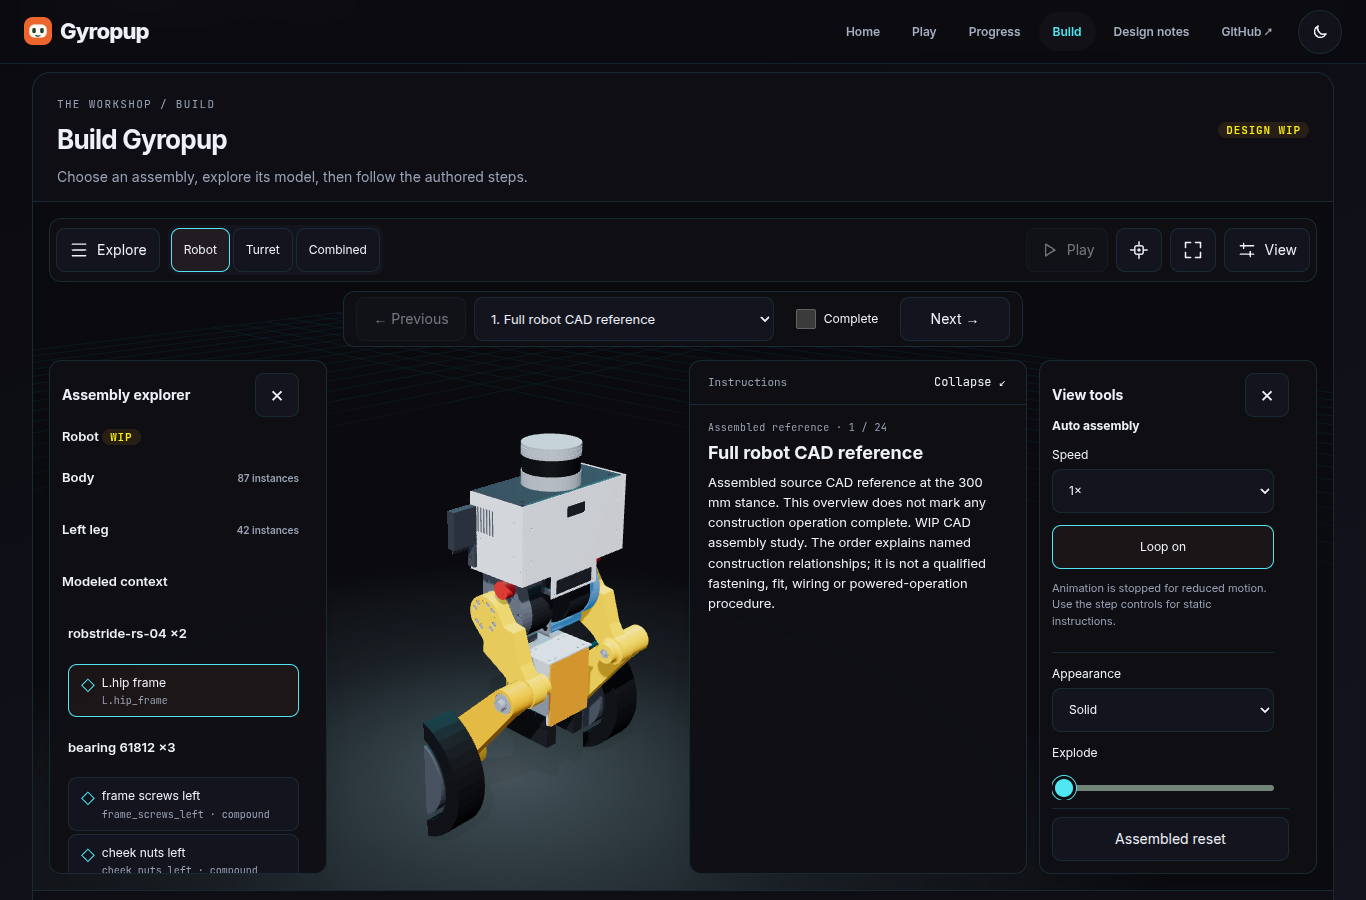
.agents/plans/instruction-docking/composed-df7/chromium-robot-stopped-control-activation.png
