Valpatel/gyropup/.agents/plans/instruction-docking/composed-df7/chromium-windowed-1440-isolated-popup.png

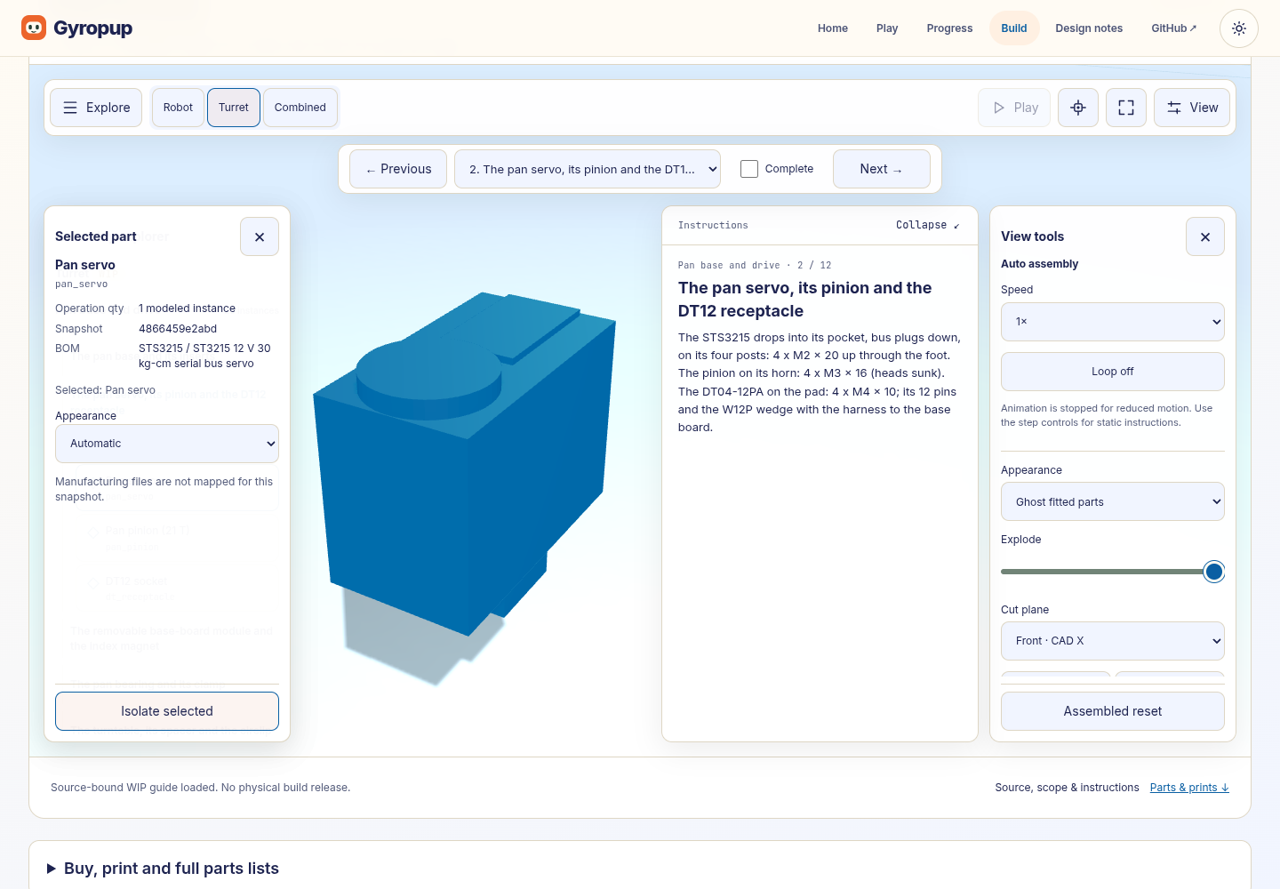
.agents/plans/instruction-docking/composed-df7/chromium-windowed-1440-isolated-popup.png
