Valpatel/gyropup/.agents/plans/instruction-docking/composed-df7/webkit-phone-actions-844.png

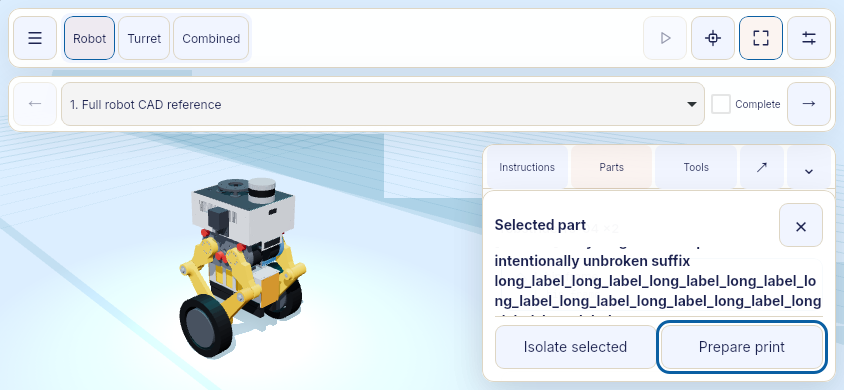
.agents/plans/instruction-docking/composed-df7/webkit-phone-actions-844.png
