Valpatel/gyropup/hardware/exports/motor-day/steps/step-01.png

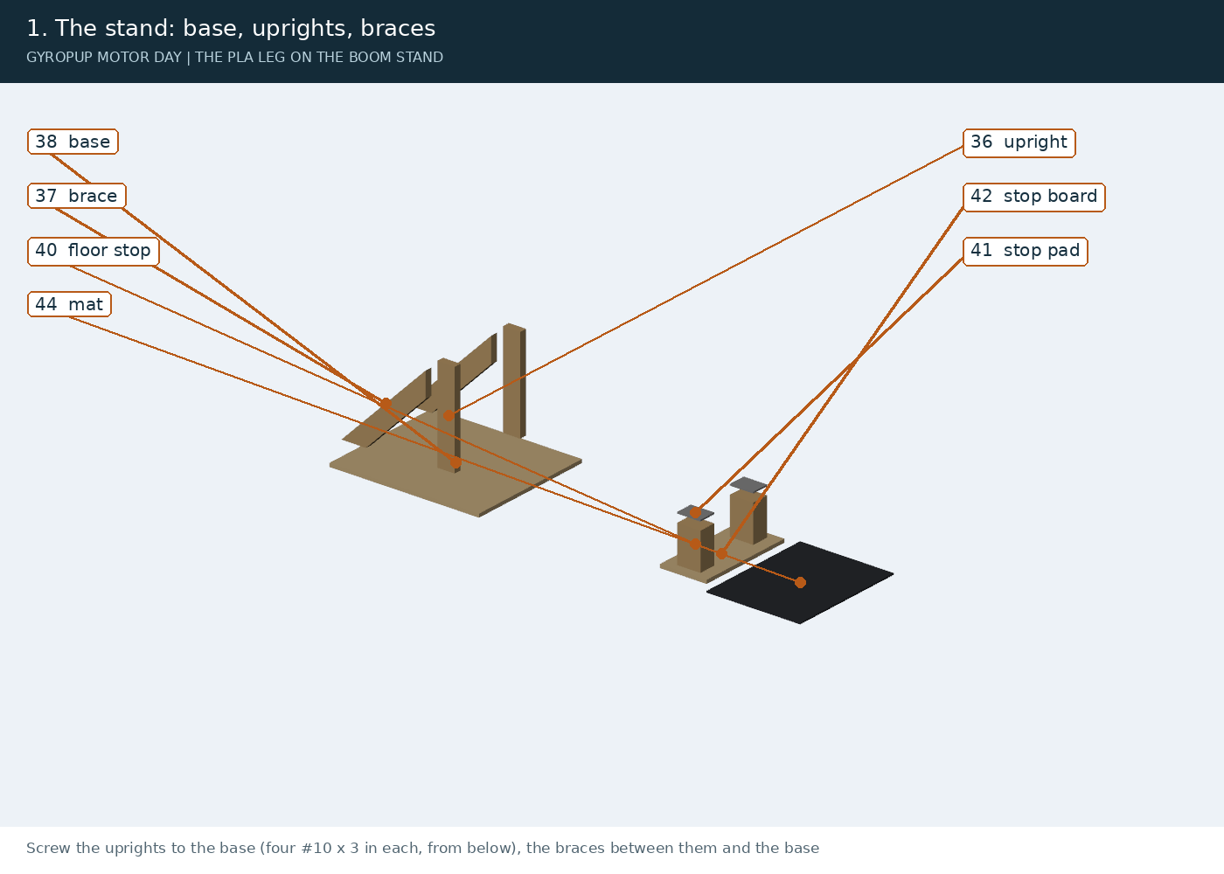
hardware/exports/motor-day/steps/step-01.png
