Valpatel/gyropup/hardware/exports/motor-day/steps/step-02.png

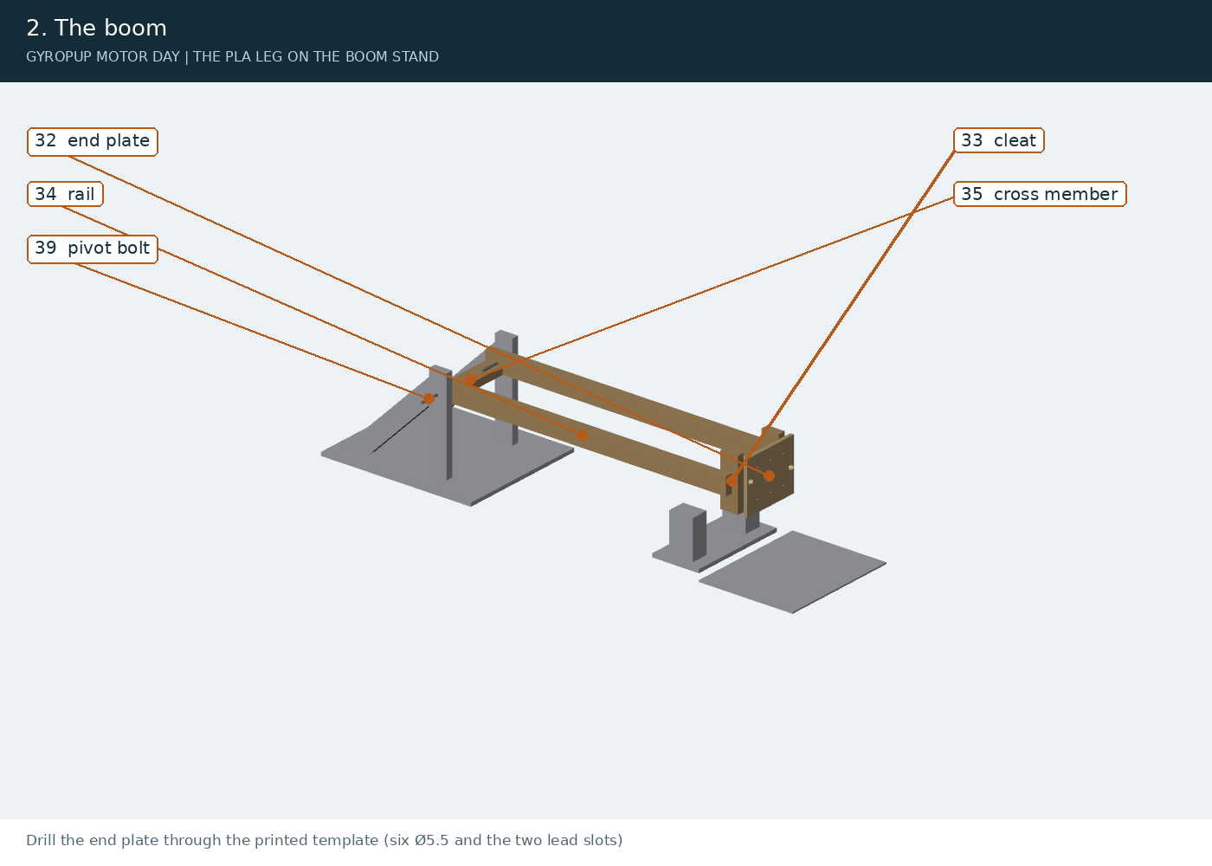
hardware/exports/motor-day/steps/step-02.png
