Valpatel/gyropup/hardware/exports/motor-day/steps/step-04.png

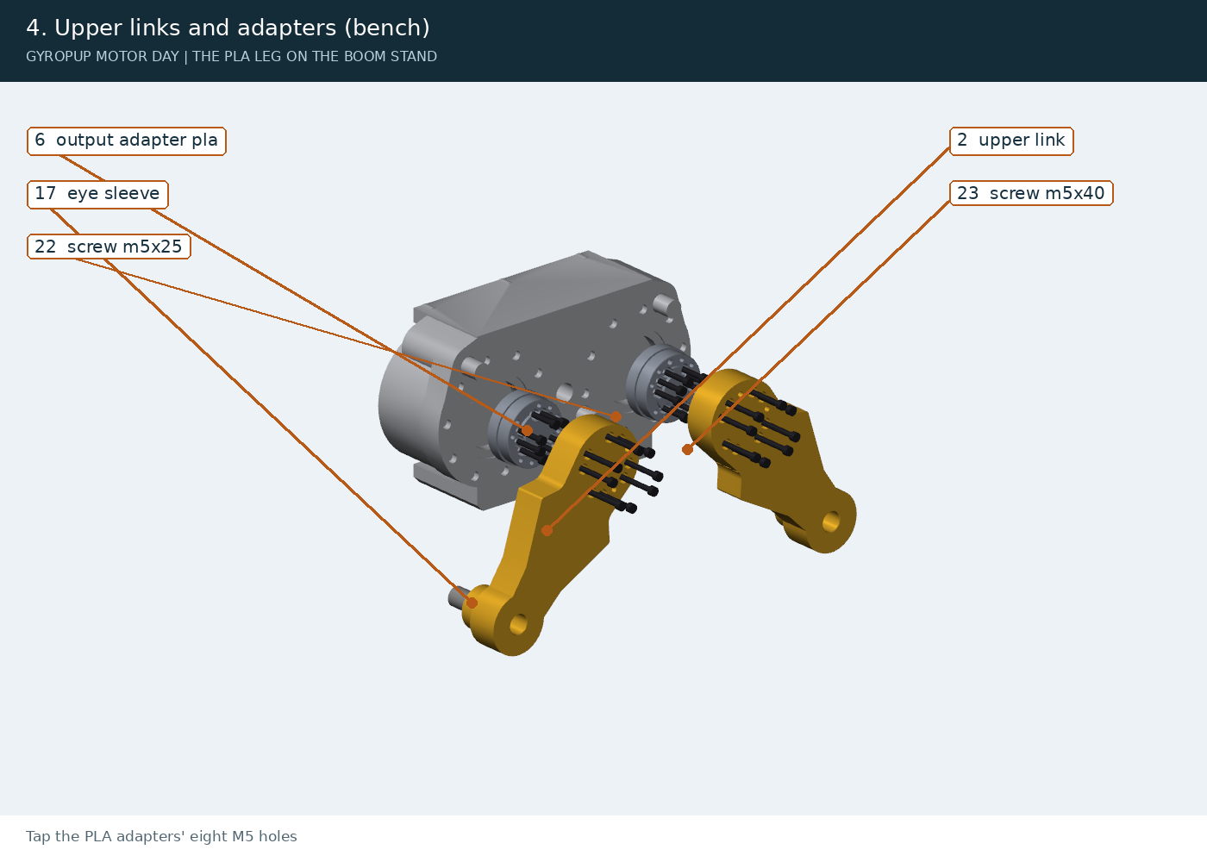
hardware/exports/motor-day/steps/step-04.png
