Valpatel/gyropup/hardware/exports/motor-day/steps/step-06.png

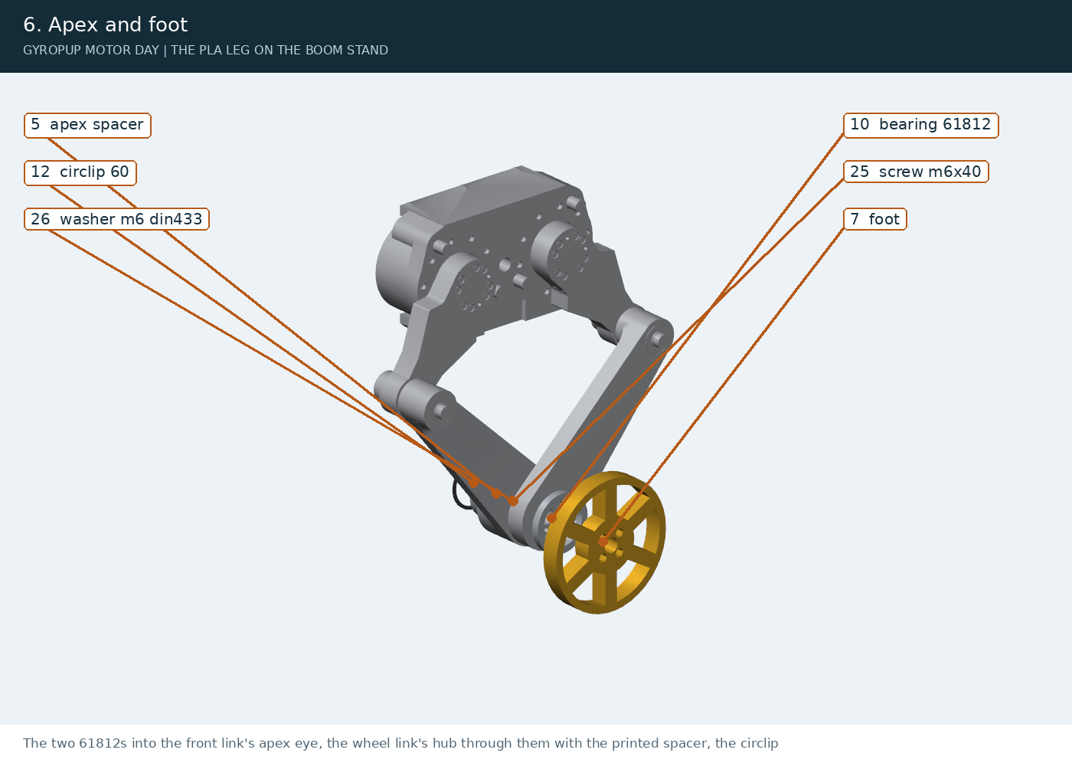
hardware/exports/motor-day/steps/step-06.png
