Valpatel/gyropup/hardware/exports/motor-day/steps/step-07.png

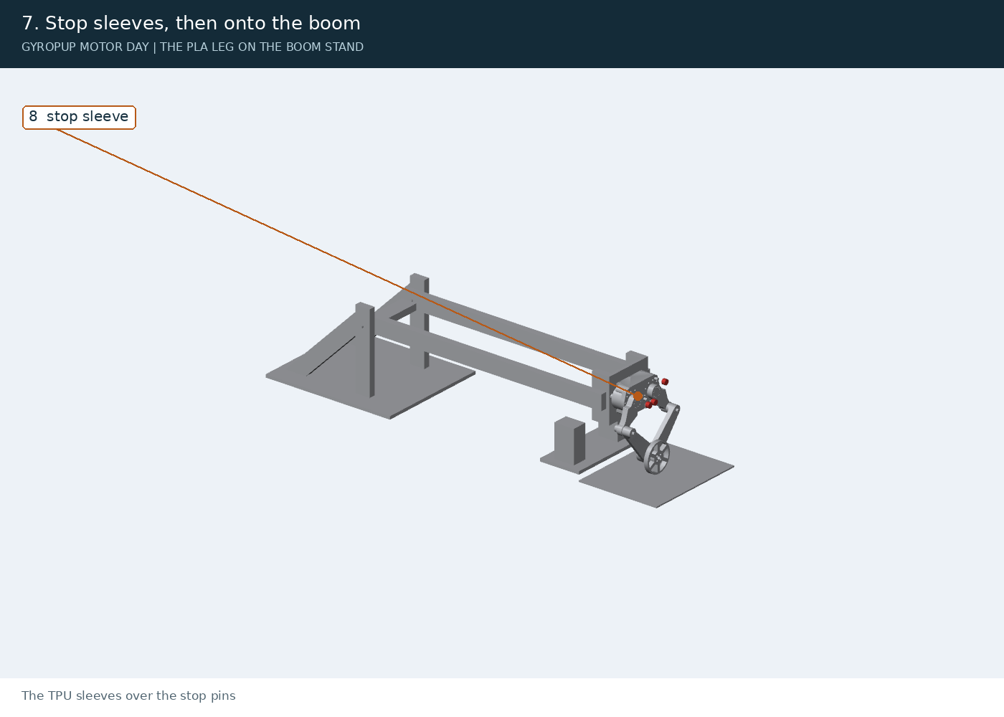
hardware/exports/motor-day/steps/step-07.png
