Valpatel/gyropup/docs/validation/landing-highlights.md

# Landing highlights reel

Issue [104](https://github.com/Valpatel/gyropup/issues/104) replaces the old
target-practice snapshot with a 22-second edit of current browser footage and
explicitly labelled engineering studies. The public turret model is shared by the landing character and simulator; the Orin bench adds its enclosure
and adapter parts. The full-robot body remains an interim export. Current demo
movement is scripted browser motion with projectile integration, not a newly
solved whole-robot physics run.

| Time | Footage | Evidence boundary |
| --- | --- | --- |
| 0–4 s | Current turret close-up | Actual public CAD, with a camera orbit and aim change |
| 4–7 s | Feed and flywheel inspection | Actual simulator callbacks and emitted balls, transparent shells |
| 7–13 s | Target practice | Three actual projectile hits and three target knockdowns |
| 13–16 s | Isolated leg-rig jump | MuJoCo single-leg rig on the current leg, 18.75 kg per leg, 36 V, 60 N·m cap |
| 16–19 s | Hip-frame E1 | Static load scaling of the recorded study (cad-agent v0.6.0 record), not transient dynamics |
| 19–22 s | Current robot | Current turret on the interim body, moving in the browser demo |

The leg movie and its report were recorded together at
`e7b512870a39259a04a4930e2908af84001bc84e` (issue 8: 18.75 kg, 36 V, the 10 in
hub-motor wheel). Until then the reel carried the 16.25 kg / 48.1 V clip of
`ae919f7211f236f398ff77cc25d00c2017c1ab9c`, labelled as archived.
E1 retains its 37.5 kg baseline, deformation ×16, SF 1.60 at the 4 mm gate mesh
(1.40 at 3 mm) versus required 2.00, and static-load labels. Its entire native frame is preserved with side bars;
the failed strength target is neither cropped nor covered. These are prototype
demonstrations, not physical testing or a print/safety release. The Progress
leg gallery's movies were re-recorded in the same run, so they now show the report
they sit beside ([issue 106](https://github.com/Valpatel/gyropup/issues/106), section 1).

## Current-body preparation (2026-11-10, not a new recording)

The published recording and dated history below retain their original76f source
and interim body. PR293 prepares the existing tools for the separately accepted
collection266 presentation. The new recorder requires a reviewed JSON-literal
`CURRENT_ROBOT_SOURCE` binding to `/web/robot-current/manifest.json`, the accepted
manifest bytes and all224 original meshes before launching a browser. Null staging
authority fails closed. The original collection and95CAD/seven conversion inputs
are local provenance; the recorder does not pretend that the renderer fetched
those provenance files. Its required browser closure covers the manifest and224
meshes plus all current renderer/shared modules, independently of optional responses.

Battle/character capture must contain the actual224 source names,62 prefixed
turret names and the correct native/collection identity in every observation.
A legacy holder whose mode merely says current is rejected. Current mass/COM,
physics and compound hub/motor internal ownership remain unresolved. Existing
shot lengths, projectile checks, raster/decoded-motion checks and historical
rig/E1 bytes, captions and failed strength limits remain unchanged. Old frames
are never re-sealed as this new recording.

Pure source/data preflight (no browser or codec) is available with
`python3 -B tools/evidence/media/check-highlights.py --capture-contract`. Source
preparation alone does not authorize capture, encoding or adoption. Wait for
actual model-motion acceptance and independent source/action review; generate
into fresh owned candidate output and inspect the genuine resulting media before
changing public assets. The historical prototype acknowledgement helper remains
byte-identical to its recorded input.

## Capture and encode

Use Node 22, the pinned Playwright package, installed Chrome (or bundled Chromium with
`PLAYWRIGHT_CHANNEL=chromium`), and FFmpeg with
libx264, libvpx-vp9, libwebp and FreeType. Build and serve the repository first,
then capture its actual browser simulation:

```sh
npm run preview:status
# Reuse the shared preview if it serves this checkout. Otherwise coordinate
# with its owner before changing the selected checkout; do not add a daemon.
npm run dev
# In another shell, with the selected checkout confirmed:
SITE_URL=http://127.0.0.1:8899 node tools/evidence/media/capture-highlights.mjs
python3 tools/evidence/media/encode-highlights.py --frames /tmp/gyropup-highlights-frames
python3 tools/evidence/media/check-highlights.py --frames /tmp/gyropup-highlights-frames
```

The recorder exposes the existing stage callback array, stops its animation
loop, advances those callbacks at 60 Hz with a seeded random source and a fixed
performance clock, and explicitly renders 30 captured frames per second.
It does not replace model, feed, projectile or target code. Real PNG dimensions
must be 1280×720; the page header's usual canvas inset cannot change the raster.

The browser frames were freshly recaptured on 2026-11-10 (UTC) for
[PR 267](https://github.com/Valpatel/gyropup/pull/267) from
`76f1e243d1e87295ce085e3db28390eed12ec224`, served assets `7c570190314c75038292`.
A real stage callback disposal change invalidated the previous source binding.
The unchanged recorder produced all 480 new frames on an isolated compute host;
the mechanism emitted nine shots and target practice recorded three shots, three
hits and three knockdowns. The normal encoder produced both 22-second companions
and the poster. Independent decoded/raw-frame validation passed, all 25 seeded
faults were rejected, and 11 binding tests passed. The leg and E1 inserts and their
limits remain unchanged. [Capture, environment, output hashes and validation](../../.agents/plans/versioned-build-guide-highlight-refresh/adoption.json)
record this native Chrome campaign; it does not establish pinned CI browser parity
or physical qualification. The earlier capture history follows unchanged.

The first release was captured from build `7b70f23f510c6b310cc8871b145cbe439f13312d`,
assets `114e495ece58fdcdacf2`. The receipt includes each loaded source's local
and served hashes, the exact callback-exposure transform, model identities,
per-frame observations, capture recipe and browser version. Original PNGs are
temporary; their hashes and dimensions are committed in `capture-frames.json`.
The recipe is reproducible, but GPU/browser/codec differences mean cross-host
byte-identical rendering is not promised.

The reel was recaptured on 2026-10-31 (UTC) from
`026020e5e18735e153ea3c2f8a8fdeab76aa79b8`, served assets
`27cf3670f8706d8372c2`, for [PR 127](https://github.com/Valpatel/gyropup/pull/127).
Regenerated leg-mount evidence had changed the attachment manifest's producer
revision and source hashes. The media guard correctly rejected the old capture
even though that manifest's geometry files and transforms were unchanged.
The existing recorder produced all 480 fresh browser frames; the mechanism
emitted nine shots, and target practice recorded three shots, three hits and
three knockdowns. The unchanged encoder produced both companions and a new
poster. Receipts were generated by those tools; the source guard and historical
study captions remain unchanged.

This capture follows the correction to the assembly-document generator's
withdrawn mounting torque and obsolete seat-depth instructions, and the completed
gauge/slicer changes. Mounting, carrier and attachment evidence was regenerated
against the settled CAD source inventory before recording these frames.

The reel was recaptured again on 2026-11-01 (UTC) from
`0d1c38eee44054663e8b40a64008781ca33b6121`, served assets `613db6c433f4b59f7964`,
for [PR 134](https://github.com/Valpatel/gyropup/pull/134) (issue 29). That PR's knee
bearing, hip-frame defaults and knee-spacer length change `cad/fivebar.py` and `catalog/hardware.json`,
which the attachment manifest pins, so the manifest and its screw envelopes were
re-exported. Their vertices are the same as before to 1 µm; only the triangle order
differs. The recorder produced all 480 browser frames through a test-owned
`serve-site.mjs --ephemeral` listener, closed afterwards. The mechanism emitted
nine shots, and target practice recorded three shots, three hits and three
knockdowns. The unchanged encoder and guard produced and passed both companions,
the poster and the receipts. The E1 and leg inserts are unchanged: that PR does
not regenerate the recorded FEA summary or the E1 movie.

The E1 insert was replaced on 2026-11-01 (UTC) for
[PR 135](https://github.com/Valpatel/gyropup/pull/135) (issue 29). That PR regenerates the
leg record on cad-agent v0.6.0 at PR 134's frame, so the E1 movie is now that record's case:
SF 1.63 at the 4 mm gate mesh and 1.41 at 3 mm, deformation ×16 (the softer humid PA6-CF
deflects 4.9 times as far as before). The browser frames were recaptured from
`afea74edf33904bf57f6bdcac6ae358e913e7aed`, served assets `9737346103cbeb1fa36c`, through a
test-owned `serve-site.mjs --ephemeral` listener, closed afterwards; none of the capture's
inputs differ from the previous capture's. The mechanism emitted nine shots, and target
practice recorded three shots, three hits and three knockdowns. The unchanged encoder and
guard produced and passed both companions, the poster and the receipts. The leg insert is
unchanged. The previous capture's note follows.

The browser frames were recaptured on 2026-11-05 (UTC) for
[PR 196](https://github.com/Valpatel/gyropup/pull/196) (D76: the turret without its own computer). Its box scene
(`exports/sim/turret_box`) was regenerated on the current turret, with the turret straight on the box deck. Dev's
scene had not been rebuilt since the stop lug, the cradle plates, the base-board carrier and its inserts and screws,
the bay lid, the horn boss, the pivot spacer and the hopper and laser inserts went in. It now carries 80 parts (62 of
them the turret's moving and base groups) against 66 and 48, so the guard's snapshot counts were reviewed against
the new frames and raised. The box was then rebuilt after the lidar study's box run it reads (its ball-path check
had said stale; the meshes did not change), and `designer/current_turret.js` now fetches the turret's parts four at a
time. The capture ran from `022627ae781ce7cf7d07669f282522397ecfa2a3`, served assets `34c5d0e6fdbb356188df`, through an
owned `serve-site.mjs --ephemeral` listener, closed afterwards. The recorder produced all 480 frames, and the unchanged
encoder and guard produced and passed both companions (MP4 1,874,211 bytes, WebM 1,494,072), the poster and the
receipts. The previous capture's note follows.

The browser frames were recaptured on 2026-11-05 (UTC) for
[PR 204](https://github.com/Valpatel/gyropup/pull/204) after it merged dev (the gamepad, #205, and the hardware
folders, #213) and took the owner's decisions: the playground's turn is now clamped to what the outer wheel and the
legs take at the speed, and the leg limits were regenerated (61 N m everywhere, the inertia bound over a locked
wheel). `designer/sim.js`, `designer/leg_limits.js` and `exports/leg/limits.json` changed, so the guard rejected the
earlier capture. No pad is connected during capture and the demo drives and turns slowly, inside the limits, so the
scenes are the same. The capture ran from `cf010ee8b6ff90e35297c65a9fa84815865b7cb8`, served assets
`b269e7b8c430ecf23b52`, through an owned `serve-site.mjs --ephemeral` listener, closed afterwards. The recorder
produced all 480 frames and its shot and knockdown assertions passed. The unchanged encoder and guard produced and
passed both companions (MP4 1,857,928 bytes, WebM 1,476,460), the poster and the receipts. The leg and E1 inserts are
unchanged. The tilt-range PR (#207) changes the same simulator and will need its own recapture when it lands. The
previous capture's note follows.

The browser frames were recaptured again on 2026-11-04 (UTC) for
[PR 204](https://github.com/Valpatel/gyropup/pull/204) after its review. The review applies the playground's reach
window to the v2 robot only (the legacy serial-leg view keeps its own reach), and the soft stops now use the whole
leg's inertia, so `designer/leg_limits.js` and `exports/leg/limits.json` changed and the guard rejected the earlier
capture. The demo runs the v2 robot inside those limits, so the footage shows the same scenes. The capture ran from
`613ac34f18671593f36f20daabf5514f1ba58e99`, served assets `8269e01942b7c677d648`, through an owned
`serve-site.mjs --ephemeral` listener, closed afterwards. The recorder produced all 480 frames and its shot and
knockdown assertions passed. The unchanged encoder and guard produced and passed both companions (MP4 1,860,113
bytes, WebM 1,477,836), the poster and the receipts. The leg and E1 inserts are unchanged. The reel must be
recaptured again once this branch merges dev after the gamepad and tilt-range PRs (#205, #207), which change the
same simulator. The previous capture's note follows.

The browser frames were recaptured on 2026-11-04 (UTC) for
[PR 204](https://github.com/Valpatel/gyropup/pull/204), the leg's over-command protection. That PR routes the
playground's live pose through `designer/leg_limits.js` (the firmware's command rates and the legs' reach window,
read from `exports/leg/limits.json`), so `designer/sim.js` changed and the guard rejected the old capture. The
demo's motions are inside those limits, so the footage shows the same scenes. The capture ran from
`00f3126e40884fe4faad05ee6edc79b53a1d7a3c`, served assets `2c98a1bfc4f63b49894d`, through an owned
`serve-site.mjs --ephemeral` listener, closed afterwards. The recorder produced all 480 frames and its shot and
knockdown assertions passed. The unchanged encoder and guard produced and passed both companions (MP4 1,858,105
bytes, WebM 1,472,734), the poster and the receipts. The leg and E1 inserts are unchanged. The reel must be
recaptured again once this branch merges dev after the gamepad and tilt-range PRs (#205, #207), which change the
same simulator. The previous capture's note follows.

The browser frames were recaptured on 2026-11-03 (UTC) for
[PR 205](https://github.com/Valpatel/gyropup/pull/205), gamepad control in the playground. That PR routes the
panel's sliders through a shared command layer in `designer/sim.js`, adds a turn rate and a hop, loads
`designer/sim_gamepad.js` and the `designer/kit/gamepad/` modules, and gives `designer/turret_bench.js` a pad
input, so the guard rejected the old capture's source hashes; no pad is connected during capture and the scenes are
the same. The capture was repeated after each round of the PR's review changed `sim.js` (the hop) and the kit; the
final one ran from `38cbb857ce5ba7c4fe29d2ec88b60ace3e97e0a4`, served assets `4f9a2c8b9ed456227a26`, through an owned
`serve-site.mjs --ephemeral` listener, closed afterwards. The recorder produced all 480 frames; the mechanism
emitted nine shots, and target practice recorded three shots, three hits and three knockdowns. The unchanged
encoder and guard produced and passed both companions (MP4 1,860,766 bytes, WebM 1,477,978), the poster
and the receipts. The leg and E1 inserts are unchanged. The previous capture's note follows.

The browser frames were recaptured on 2026-11-03 (UTC) for
[PR 185](https://github.com/Valpatel/gyropup/pull/185), the recorded voice and pronunciation key. That PR moves
Gyropup's fixed lines from `designer/character/talk.js` and `designer/sim.js` into `designer/character/lines.js` and
adds `designer/character/pronounce.js`, so the guard rejected the old capture's source hashes; the footage has no
audio and shows the same scenes. The capture was repeated after the PR's review changed `talk.js` and
`pronounce.js` again; the final one ran from `c77dc0906bfe949027141f435238293d5cd8e532`, served assets
`fcc46347341c77cd1150`, through an owned `serve-site.mjs --ephemeral` listener, closed afterwards. The recorder
produced all 480 frames and its shot and knockdown assertions passed. The unchanged encoder and guard produced and
passed both companions (MP4 1,860,644 bytes, WebM 1,477,633), the poster and the receipts. The leg and E1 inserts
are unchanged. The previous capture's note follows.

The reel was re-encoded with new frames on 2026-11-03 (UTC) for issue
[8](https://github.com/Valpatel/gyropup/issues/8). That branch re-runs the leg rig on the current leg,
re-solves the leg FEA record and re-exports the E1 field against it, so the guard rejected the old receipt's
summary, field and leg-clip hashes. The leg insert is now the 18.75 kg / 36 V jump that was recorded with its
report (`e7b512870a39259a04a4930e2908af84001bc84e`). Its captions say so; it is no longer the archived
16.25 kg clip. The E1 movie's pixels are unchanged (SF 1.60 / 1.40). The frames were captured from
`5ee1a8f2f1db9c76af4dd269f9dc8ae67336b824`, served assets `a5c8d9fdb4678f6a1601`. All 480 frames came through
an owned `serve-site.mjs --ephemeral` listener, closed afterwards. The mechanism emitted nine shots, and target
practice recorded three shots, three hits and three knockdowns. The encoder and guard produced and passed both
companions (MP4 1,857,481 bytes, WebM 1,478,016), the poster and the receipts. The previous capture's note follows.

The browser frames were recaptured again on 2026-11-03 (UTC) for
[PR 173](https://github.com/Valpatel/gyropup/pull/173), the site's new light and dark themes. The capture
ran from `0b0c8b6e7586fb674e97253299433af85d36e6ef`, served assets `50ab399d7d38a12d556a`. That PR changes the
colour tokens in `web/theme.css`, which the guard binds, so it rejected the old capture. The recorder still runs
in the light theme. All 480 frames came through an owned, temporary `createSiteServer` listener, closed afterwards.
The unchanged encoder and guard produced and passed both companions, the poster and the receipts. The leg and E1
inserts are unchanged. The previous capture's note follows.

The browser frames were recaptured on 2026-11-03 (UTC) for
[PR 166](https://github.com/Valpatel/gyropup/pull/166), the site's dark theme, from
`cb5c453da1c9c9872160fec31d5d0e830a161786`, served assets `5bdb57e4c82e65c941f1`. That PR
moves the simulator's stylesheets, stage, app bar and notice onto colour tokens and adds
`web/theme.js` and `web/theme.css` to every page, so the guard rejected the old capture's
source hashes. The recorder runs in the light theme (its browser context sets no colour
scheme), so the footage shows the same light pages as before. It produced all 480 frames
through a test-owned `serve-site.mjs --ephemeral` listener, closed afterwards; the mechanism
emitted nine shots, and target practice recorded three shots, three hits and three
knockdowns. The unchanged encoder and guard produced and passed both companions, the poster
and the receipts. The leg and E1 inserts are unchanged.

Raw frames and validation output for this capture are retained locally under
`build/motor-fit-highlights-release/`. Capture used an owned, temporary
`createSiteServer` listener, closed after validation, with `CAPTURE_OUTPUT` set to
that directory's `frames` child. Encoding and the independent full validation
used `python3 tools/encode-highlights.py --frames build/motor-fit-highlights-release/frames`
and `python3 tools/check-highlights.py --frames build/motor-fit-highlights-release/frames`.
The committed receipts contain the input, raw-frame and output identities.
Playback checks used the frozen scene build with the six validated media files
copied into it; `test-build-overlay.json` records their exact byte identities.
Production publication uses the normal complete site build.

Chromium, Chrome and WebKit each passed the existing 21 player cases across
13 layouts with no page errors. Chrome's automatic and manual full-page cases
at 150 ms latency and 1.6 Mbps download both completed the first play and full
replay with zero playback waits; hero readiness was 41.65 s and 41.47 s.
The unthrottled WebKit case also completed both plays with zero waits.
`completed.json`, the browser reports and `listener-closed.json` retain the
results. The temporary listener closed at 08:10:12 UTC; the shared preview was
untouched. Earlier diagnostic captures remain in their separate directories.

`tools/encode-highlights.py` uses lossless intermediate segments, the repository's
Inter font, and two encodings of the same edit. Outputs live in `web/highlights/`:

- H.264 High 3.1, YUV420P, 720p30, fast-start MP4: 1,857,481 bytes.
- VP9 Profile 0, YUV420P, 720p30, WebM: 1,478,016 bytes.
- A 32,516-byte WebP poster from reel frame 30, with the same framing and lower third.
- Source, edit, capture and output receipts, including the pinned leg report.

Each movie contains 660 frames and no audio. The player fetches only its supported
encoding near the viewport, pauses offscreen or when the tab is hidden, and keeps
a deliberate user pause. Reduced-motion and Data Saver visitors start it manually.
The finite reel offers replay, clear loading/error states and retry; it works even
if the independent 3D hero fails.

### Full-page loading correction

The isolated-player checks now explicitly intercept the versioned hero import
and assert the fixture was exercised. Their original exact-URL fixture missed
its version query; that original run did not establish hero-failure independence.
A separate real-hero check found that simultaneous CAD and movie downloads could fail on a
constrained connection, so main publication was held for
[issue 111](https://github.com/Valpatel/gyropup/issues/111). With Chrome at
390×844, 150 ms latency, 1.6 Mbps download and 750 kbps upload, the hero-only
baseline loaded in 37.726 s without failures. Autoplay pushed two turret requests
past their existing 20 s deadline; the reel had 20 buffering intervals totaling
21.225 s. A first decoded frame was not evidence of smooth playback.

The correction queues automatic and explicit movie loading behind the active
hero load and buffers about three seconds before playback. Queued intent remains
cancelable, and absent or failed hero modules release the independent player.
A 60-second hero wait expires to an explicit “Play now” choice with the robot's
loading state explained; it does not silently begin competing downloads. CAD geometry, physics and video
pixels are unchanged; increasing the CAD timeout alone would not address media
contention or repeated playback waits.

`npm run test:highlight-integration` exercises the actual hero and reel together,
including the constrained connection above. It requires the complete first play
and second replay, actual changing model pixels, and at least 600 additional
decoded frames after replay starts. Extending the replay exposed WebKit advancing
frames without another `playing` event: a timer previously stopped that working
replay near 20 seconds. Recovery now follows actual forward presented-frame
progress, bound to its source and play attempt. Cancellation, retries and seeks
invalidate old callbacks; a genuinely frozen decoder still times out.

Eligibility also reads the current reduced-motion preference. WebKit can expose
a new value through a fresh query before a retained query's change event arrives;
hero completion during that interval must not authorize autoplay. Deterministic
checks reproduce that ordering, offscreen hero-completion races and stale/frozen
frame recovery. Native replay checks keep real media behavior intact.

Timestamps and stall counts are browser/network emulation observations, not
physical-phone guarantees. Final correction evidence is recorded on
[PR 112](https://github.com/Valpatel/gyropup/pull/112) before the main publication
resumes.

## Validation

`npm run test:highlight-media` checks source/output identity, mandatory input
membership, pinned leg-report binding, codec/profile/raster/frame count, full
decode, MP4 atom order, transfer budgets, moving model pixels in every segment,
equivalent H.264/VP9 pixels, retained E1 labels and the matching poster. Fault
controls reject missing or changed sources, wrong leg baselines, incorrect
static labeling, changed output bytes and frozen frames. No CAD solver runs.

`npm run test:highlights` checks actual decoded moving pixels, MIME types, one
selected codec, initial and near-viewport requests, manual preferences, pause,
replay, visibility changes, a pause during a delayed response, HTTP 503/invalid
media recovery, keyboard controls and 13 phone/tablet/desktop viewports. Run it
with bundled Chromium, installed Chrome and WebKit; a codec capability query alone
is not a playback test. Both checks run in the existing presentation CI workflow.

The primary button owns Play, Pause, Replay and Retry. A separate Restart button
is available only during unfinished playback that has made progress. Both browser
harnesses inspect the rendered and accessible control names, visibility and enabled
state, including the natural first end and full second replay. Keyboard checks
preserve focus when Restart disappears. This guards the duplicate Replay buttons
reported in [issue 118](https://github.com/Valpatel/gyropup/issues/118).

Final browser and independent review results are recorded on
[PR 105](https://github.com/Valpatel/gyropup/pull/105). Production playback is checked
again after the reviewed dev/main publication.

## Startup-audio correction, 2026-11-05

The early `?sound=0` correction changes the source-bound simulator. Fleet capture **160 on cpu-b** built
`cd7d4a29b8e2cc47b5b852590730c23c869f363c`, passed the complete audio suite on that actual build, and
recorded all 480 current-scene frames with Chromium 141.0.7390.37. The strengthened audio control holds the
optional gamepad import and requires muted master/voice plus SOUND OFF at the first talk mount. Its pre-fix
negative control fails at that exact early-state assertion; no source overlay substitutes for the built page.

Encoding **163 on cpu-b**, at the same source, reused those original frames and capture receipt byte-for-byte.
All 480 raw frame hashes were checked. The mechanism emitted nine shots; target practice recorded three shots,
three hits and three knockdowns. The actual scene inventories contain 80 bench entries and 62 robot-turret entries.
The unchanged encoder produced both 660-frame, 22-second companions and the poster; the existing guard passed
all 19 negative controls, including source omissions, historical report drift and frozen segments. Raw turret and
target-practice frames were visually inspected. Historical leg/E1 identities and qualification limits remain intact.

The initial encoding attempts correctly stopped when the shallow worker lacked pinned historical evidence.
Another shallow worker must fetch the complete required commit set before encoding/checking:

```sh
git fetch --no-tags --depth=1 origin \
  e7b512870a39259a04a4930e2908af84001bc84e \
  a12cf8e73f337274174c56e14c22832250acf284 \
  1f46309c4bf4deecf1c8b825bbe35c7e2e0dbd0f
```

These supply the leg recording, E1 solved-field producer and E1 video producer evidence respectively.
No receipt was relabelled to bypass missing history, and no new physical experiment is claimed.
