Valpatel/gyropup/docs/validation/recovery-2026-11-05.md

# Recovery audit — 2026-11-05

This is a dated inventory, not a live acceptance certificate. GitHub [program #31](https://github.com/Valpatel/gyropup/issues/31) remains the handoff. Every existing worktree and uncommitted change was preserved. Closure candidates require independent review before an issue changes state.

## Evidence and limits

- `git fetch origin`: integration `dev` = `b408b59bb995c9d155e277d694749f256ad4cc88`; published branch `main` = `325a8b566456d07f6464ca75824510aee6ef9eea`. A branch ref alone does not verify production deployment.
- `gh issue list --state open --limit 200`: **24 open issues** before this work; all appear below.
- `gh pr list --state open --limit 200`: **one open PR**, #207, from `feat/turret-tilt-range` into `dev`, draft at `eeccc07bacfca95464c703f6d730f975781f1fe0`.
- `git log --branches --not --remotes` and `git stash list`: no local-only commits or stashes found. This does not inventory remote compute jobs.
- Older issue checkpoints and PR prose are historical. Actual refs, trees and latest CI must be read before resuming. No external process or compute job was stopped or assumed complete.

## Owner report — 2026-11-05

The owner reports the **first motors in hand**, and the **main motor holder and motor adapter printed**. This report does not identify the delivered motor type again, the printed source revision, quantity, material, printer settings or dimensions. The earlier dated RS-04 inventory separately records four units arriving on 2026-11-03.

Printed and received are distinct from installed, measured, fit-validated, load-tested or powered. None of those later states was reported. The canonical physical entry is [physical progress](../program/physical-progress.md).

## Every open issue

| Issue | Disposition and next acceptance step |
| --- | --- |
| [#210](https://github.com/Valpatel/gyropup/issues/210) — Hardware: one folder per electronic component, and the robot Jetson's deployment (SocketCAN, udev, the RS-04 bridge) | Closure candidate: implementation merged in [#213](https://github.com/Valpatel/gyropup/pull/213), released in #216; reconcile checklist and confirm acceptance. |
| [#206](https://github.com/Valpatel/gyropup/issues/206) — RS-04 leg motors: a browser configuration tool (scan, setid, zero, params, telemetry) over a SocketCAN bridge | Closure candidate: motor tool merged in [#209](https://github.com/Valpatel/gyropup/pull/209), released in #216. Physical scan remains owner work. |
| [#203](https://github.com/Valpatel/gyropup/issues/203) — Turret: add a compact laser rangefinder (ERDI SPD1200-series candidate) | Keep: rangefinder selection, exact-model qualification and integration remain open; follows #201. |
| [#202](https://github.com/Valpatel/gyropup/issues/202) — Legs: audit and close the gaps that let an over-commanded motor damage the five-bar legs | Keep: [#204](https://github.com/Valpatel/gyropup/pull/204) merged and released in #217, but the explicit HIL rerun remains unperformed. |
| [#201](https://github.com/Valpatel/gyropup/issues/201) — Turret tilt: limits from the real mechanical stops, not 'never above horizontal' | Keep: draft [#207](https://github.com/Valpatel/gyropup/pull/207), head eeccc07b, includes +12° hard stop and +10° firing limit; description is stale. Four CI failures and independent review remain. |
| [#200](https://github.com/Valpatel/gyropup/issues/200) — Simulator: reusable Xbox gamepad control component (kit) wired into the playground | Closure candidate: gamepad implementation merged in [#205](https://github.com/Valpatel/gyropup/pull/205), released in #216. Real-controller coverage remains explicitly limited. |
| [#198](https://github.com/Valpatel/gyropup/issues/198) — motor_day --no-render: also guard step explode offsets and camera | Implement: `--no-render` must bind explode offsets and camera as well as parts; add mutation checks. |
| [#197](https://github.com/Valpatel/gyropup/issues/197) — Hip frame: a metal heat path for the RS-04 leg motors (black 6061 web with a thermal break to the cheeks) | Keep: heat-path CAD and physical thermal calibration remain; the thermal model alone cannot qualify it. |
| [#194](https://github.com/Valpatel/gyropup/issues/194) — RS-04 leg motors: a tested thermal model of their heat into the hip frame and body, and the heat sink they need | Closure candidate for model scope: [#195](https://github.com/Valpatel/gyropup/pull/195) merged and released in #214. Calibration and CAD follow in #197. |
| [#193](https://github.com/Valpatel/gyropup/issues/193) — Body: one DCB609 slides into a holder on each end; the under-belly bay goes | Resume existing scope: end-mounted slide-in packs; released claim says survey only, no implementation branch exists remotely. |
| [#192](https://github.com/Valpatel/gyropup/issues/192) — Turret: no onboard Jetson; the pan base on the riser, a small onboard controller (supersedes D66) | Keep: architecture work [#196](https://github.com/Valpatel/gyropup/pull/196), b408b59b, merged and released in #218. Exhaust-plume owner decision and stale dossier remain here; #193 covers only the separate pack-placement change. |
| [#155](https://github.com/Valpatel/gyropup/issues/155) — Body study: cheaper SendCutSend plates (<=2 bends, PEM hardware), more printing, riveted options (proposed D75) | Keep: closed-unmerged [#158](https://github.com/Valpatel/gyropup/pull/158) study preserved on its branch; owner choice precedes CAD rebuild. |
| [#137](https://github.com/Valpatel/gyropup/issues/137) — Fasteners and inserts: phase 2 checks on cad-agent, BOM/catalogue gaps, owner decisions | Keep: phase 2 merged in #177/#180; documented load-golden and melt-band follow-ups plus BOM/owner items remain. |
| [#131](https://github.com/Valpatel/gyropup/issues/131) — Covers and enclosures: replace screws with designed snap/compliant features where justified; cut part count | Keep: wave 1 merged in #181; full cover inventory, later replacements and physical coupons remain. |
| [#124](https://github.com/Valpatel/gyropup/issues/124) — Lock turret flywheel-motor interfaces to the ordered hardware | Keep: exact flywheel sample dimensions and physical gauge calibration absent. Generic “first motors” report does not identify flywheel delivery. |
| [#116](https://github.com/Valpatel/gyropup/issues/116) — Correct and verify RS-04 lug screw stacks in the leg and arrival fixtures | Keep: RS-04 arrival is known; support/load distribution, physical fit and load qualification remain open. |
| [#106](https://github.com/Valpatel/gyropup/issues/106) — Site: bind Progress leg movies to their study, plus small site/docs follow-ups | Keep: #176 completed several small follow-ups; Progress consumer identity test remains. Navigation cleanup is a separately claimed scope. |
| [#66](https://github.com/Valpatel/gyropup/issues/66) — Turret carrier: board/harness layout, C3 and servo disconnects, removable-module service proof | Keep: complete carrier service sequence, interface qualification and physical/electrical evidence remain. |
| [#61](https://github.com/Valpatel/gyropup/issues/61) — Turret print readiness: stale gates, stop lug, thin walls, FEA cases below target | Keep: current passing gate files do not close remaining FEA/print readiness, owner decisions or component register. |
| [#31](https://github.com/Valpatel/gyropup/issues/31) — Start here: Gyropup status, priorities and handoff | Keep: live program tracker; reconcile dated decisions and all closure candidates after independent review. |
| [#26](https://github.com/Valpatel/gyropup/issues/26) — Body: crush-pad coupon drop test and pad retention (lip + M3) before printing the pads | Keep: retention CAD merged in #175; measured coupon data, material model and reruns remain acceptance gates. |
| [#24](https://github.com/Valpatel/gyropup/issues/24) — Wheels (D69): measure the hub motors (W1), then the wheel-link clamp and W2–W9 | Keep: measured wheel interfaces and W1–W9 acceptance work remain. |
| [#10](https://github.com/Valpatel/gyropup/issues/10) — Body power and packs: D71 mass decision, measured DCB609/adapter models, pack-swap hand access | Keep: D79 supersedes the old mass-budget blocker; measured pack/adapter geometry and hand-access work remain; coordinate #193. |
| [#8](https://github.com/Valpatel/gyropup/issues/8) — Leg and rig: rig at 18.75 kg, rig on cad-agent gates, leg FEA follow-ups and bench proofs | Keep: #183 regenerated rig evidence, but documented coupons, strength follow-ups, cad-agent rig gates and physical proofs remain. |

## Every branch

The table includes all local branches and remote-only topic branches observed after fetch. “Integrated” means the exact head is an ancestor of `origin/dev` or `origin/main`, not that every acceptance gate passed. Gone upstream refs are not deleted locally. No other owner’s branch is removed.

| Branch | Exact head | Integration / disposition |
| --- | --- | --- |
| `dev` | `b408b59bb995c9d155e277d694749f256ad4cc88` | Integrated; preserve owner branch/worktree. |
| `docs/historical-draft-inventory` | `6c42ee896111c8678f46d171068edca15771c0ff` | Integrated; preserve owner branch/worktree. Upstream absent. |
| `docs/motor-day-case-holes` | `18d7f0b29b1dd98fa50ae616f23690fe746cf474` | Integrated; preserve owner branch/worktree. Upstream absent. |
| `docs/motor-day-print-order` | `3738b36fe50b743df50e7708eb4bf2ddead4b72a` | Integrated; preserve owner branch/worktree. Upstream absent. |
| `docs/recovery-navigation-20261105` | `b408b59bb995c9d155e277d694749f256ad4cc88` | Owned audit/navigation work, initially based on dev; advance only via review. |
| `feat/dark-theme` | `e3ee26153cd4a30f74b2728fac4786c5ebb0d629` | Integrated; preserve owner branch/worktree. Upstream absent. |
| `feat/gamepad-control` | `c4c56671d062592bc41e2277ea43128b8b83da47` | Integrated; preserve owner branch/worktree. Upstream absent. |
| `feat/hardware-folders` | `347503def8a01b2eaf9546b21936de77989e9928` | Integrated; preserve owner branch/worktree. Upstream absent. |
| `feat/leg-command-limits` | `572a94a964e6b34421ef6440d321ceddf448642d` | Integrated; preserve owner branch/worktree. |
| `feat/rs04-motor-tool` | `54485edf5b623f02fc85bee1c5e27a7707e0009a` | Integrated; preserve owner branch/worktree. Upstream absent. |
| `feat/tts-pronunciation-key` | `b8698426ea8a5592c7b15d53c88002fe2fbf365f` | Integrated; preserve owner branch/worktree. Upstream absent. |
| `feat/turret-offboard-compute` | `c31af5ad4ff2dd8d84737747b5b12705e933f0a8` | Integrated; preserve owner branch/worktree. |
| `feat/turret-tilt-range` | `eeccc07bacfca95464c703f6d730f975781f1fe0` | Open draft PR #207; resolve current CI and review. |
| `feat/valpatel-theme` | `7e335a8c5f6e3631bb1e10f2a0900a67233cefd5` | Integrated; preserve owner branch/worktree. Upstream absent. |
| `fix/crush-pad-retention` | `a30cda349303b5f5c2625f4630719d1798921970` | Integrated; preserve owner branch/worktree. Upstream absent. |
| `fix/five-bar-pictures` | `de003d3e1636cb572b48c9f86b75f05b05ed4369` | Integrated; preserve owner branch/worktree. Upstream absent. |
| `fix/insert-joint-cad` | `f27e7382bf2ebc2c59f5329831d886500c4ad117` | Integrated; preserve owner branch/worktree. Upstream absent. |
| `fix/rig-results-current-leg` | `c7298d95d0695dacc8b28fc1a1868ccc078d0fd3` | Integrated; preserve owner branch/worktree. Upstream absent. |
| `fix/sim-camera-reload` | `545bdfea6611a38e51a44d522b7f3f25e5077475` | Integrated; preserve owner branch/worktree. Upstream absent. |
| `fix/site-followups-106` | `95069260325b7a4f151f2d0f12cf36f86007d6f9` | Integrated; preserve owner branch/worktree. Upstream absent. |
| `fix/turret-box-rebuild` | `f6785820018559faafbf53f256f9c6c873417ba9` | Integrated; preserve owner branch/worktree. |
| `fix/turret-gates-current` | `032e91ea8c93b08668dea51cb5892c0acb7a2b37` | Integrated; preserve owner branch/worktree. |
| `leg/print-ready` | `917353a4e41f24f7aa7b7ba8b36757856307f602` | Integrated; preserve owner branch/worktree. Upstream absent. |
| `main` | `a79e48cbba8ee08f9219a05dc79e642da9461efe` | Integrated; preserve owner branch/worktree. |
| `research/insert-joints-phase2` | `0755053f295101697fa4b5ec3be42e509d9afb77` | Integrated; preserve owner branch/worktree. Upstream absent. |
| `site/visual-docs` | `1e9623f1d241f328f964cb3bd83e933480940f65` | Integrated; preserve owner branch/worktree. Upstream absent. |
| `site/visual-status` | `cecc6515428fc0471ef1af26d04676b513f3f882` | Integrated; preserve owner branch/worktree. Upstream absent. |
| `site/visual-timeline` | `0f047559d6edb259f2cc3283dd64c4115b3ebcd1` | Integrated; preserve owner branch/worktree. Upstream absent. |
| `study/body-sheet-metal` | `4585596492a75a08489ef99b6b9e3b8334c5e5ee` | Closed-unmerged PR #158; preserve study and owner decisions. |
| `thermal/rs04-motor-heat` | `df3e64613e1c97cc20bd72a800aad46a59f8ca19` | Integrated; preserve owner branch/worktree. Upstream absent. |

## Linked worktrees

Names are checkout labels, not paths. Change counts include tracked modifications and untracked entries, without enumerating potentially private local inputs. These counts are the snapshot before this audit was written. All checkouts remain owned by their prior sessions.

| Checkout | Head | Changed entries | Disposition |
| --- | --- | --- | --- |
| `gyropup` | `a79e48cbba8ee08f9219a05dc79e642da9461efe` | 40 | Preserve; no reset, cleanup or checkout switch. |
| `gyropup-body-sheetmetal` | `4585596492a75a08489ef99b6b9e3b8334c5e5ee` | 0 | Preserve; no reset, cleanup or checkout switch. |
| `gyropup-draft-archive` | `6c42ee896111c8678f46d171068edca15771c0ff` | 4 | Preserve; no reset, cleanup or checkout switch. |
| `gyropup-recovery-20261105` | `b408b59bb995c9d155e277d694749f256ad4cc88` | 0 | Owned audit checkout. |
| `gyropup-shared-preview` | `2ef1d857a155eef0c7415b86bd7a4b824a73d7ec` | 0 | Preserve; no reset, cleanup or checkout switch. |
| `gyropup-sim-controls` | `545bdfea6611a38e51a44d522b7f3f25e5077475` | 0 | Preserve; no reset, cleanup or checkout switch. |
| `gyropup-visual-view` | `77f6d00bdb262f0f75a18fa0ddf0075058a649d8` | 1 | Preserve; no reset, cleanup or checkout switch. |
| `wt-gp-gamepad` | `c4c56671d062592bc41e2277ea43128b8b83da47` | 0 | Preserve; no reset, cleanup or checkout switch. |
| `wt-gp-hwfolder` | `347503def8a01b2eaf9546b21936de77989e9928` | 14 | Preserve; no reset, cleanup or checkout switch. |
| `wt-gp-leglimits` | `572a94a964e6b34421ef6440d321ceddf448642d` | 0 | Preserve; no reset, cleanup or checkout switch. |
| `wt-gp-leglimits-review` | `572a94a964e6b34421ef6440d321ceddf448642d` | 0 | Preserve; no reset, cleanup or checkout switch. |
| `wt-gp-motorday` | `18d7f0b29b1dd98fa50ae616f23690fe746cf474` | 0 | Preserve; no reset, cleanup or checkout switch. |
| `wt-gp-motorheat` | `df3e64613e1c97cc20bd72a800aad46a59f8ca19` | 0 | Preserve; no reset, cleanup or checkout switch. |
| `wt-gp-tiltrange` | `eeccc07bacfca95464c703f6d730f975781f1fe0` | 0 | Preserve; no reset, cleanup or checkout switch. |
| `wt-gp-turretcompute` | `c31af5ad4ff2dd8d84737747b5b12705e933f0a8` | 4 | Preserve; no reset, cleanup or checkout switch. |

## Root simplification sequence

Baseline `origin/dev` has **31 root entries** (including hidden configuration, excluding `.git`). Eleven are files; 20 are directories. Begin with the README and visual documentation hierarchy; then move source groups with all consumers updated.

1. Group Jetson deployment under hardware, and presentation sources under designer while retaining public URL aliases. Move the home HTML and Wrangler configuration to their owning directories. Target: **31 → 27 root entries**.
2. Evaluate research/reference material under docs, catalogue/design/dossier inputs under CAD, and rig/RL under simulation. Target after consumer/receipt migration: **about 20 root entries**, subject to canonical tool configuration requirements.
3. Each move gets its own dependency inventory, generated-output checks and independent review. Keep public download URLs stable or explicitly redirected; do not rewrite historical evidence to pretend it was generated under new paths.

The first stage does not rename CAD, catalogue, designs or generated evidence, which would invalidate source closures while other mechanical work is pending. Folder movement is authorized, but path-sensitive receipts still need genuine regeneration.

## Reviewed integration follow-up, 2026-11-05

This follow-up supplements the initial snapshot above; it does not rewrite its observed heads, worktree states or unknowns. The live program remains [#31](https://github.com/Valpatel/gyropup/issues/31).

| Work | Reviewed integration evidence | Disposition |
| --- | --- | --- |
| Visual entrance and dated physical record | [PR #220](https://github.com/Valpatel/gyropup/pull/220), dev merge `0566c6953d59714b82238434163691574c4330a9` | Integrated; no physical qualification inferred. |
| Group deployment/home/config sources; correct startup audio and readiness controls | [PR #222](https://github.com/Valpatel/gyropup/pull/222), reviewed head `0e95b67a8d02d45c6bbbcc3020fc6df61b7c2c79`, dev merge `89aa5d0b52279678bd1ced07f8269a7d060017c8` | Integrated after complete green CI and independent review. |
| Bind picture reuse to ordered visual inputs; retain truthful mesh/slice snapshot | [PR #223](https://github.com/Valpatel/gyropup/pull/223), reviewed head `e6102749c2816d0de2618b0bb399b93ee725841d`, dev merge `9b8e29988dd0e5cba639231db2dee78b6348efb1` | Integrated; all 30 original slice/source identities retained. No new sliced package or fit qualification. |

The tracked dev root at that last merge has **28 entries, down from 31**. Existing owner worktrees and edits remain preserved. Main/production publication was still pending at this checkpoint; dev integration alone is not deployment evidence.

Independent public rationales support the scoped closures of [#210](https://github.com/Valpatel/gyropup/issues/210#issuecomment-6670850316), [#206](https://github.com/Valpatel/gyropup/issues/206#issuecomment-6670849964), [#200](https://github.com/Valpatel/gyropup/issues/200#issuecomment-6670849275) and [#194](https://github.com/Valpatel/gyropup/issues/194#issuecomment-6670848905): repository/software/model acceptance only, preserving physical qualification gaps. [#192](https://github.com/Valpatel/gyropup/issues/192#issuecomment-6671517382) closes completed architecture scope; its exhaust-owner-choice and current dossier reconciliation remain explicit unchecked acceptance tasks under #31. [#202](https://github.com/Valpatel/gyropup/issues/202) remains open for actual HIL, with separate software follow-ups; no HIL result was invented.

The paused [PR #207](https://github.com/Valpatel/gyropup/pull/207) remains at `eeccc07bacfca95464c703f6d730f975781f1fe0`. Its actual tree includes PR #196, a +12-degree hard stop and +10-degree firing limit, with later feed/FEA/lidar-study exports. Its description and #201 checklist were corrected after independent documentary review on 2026-11-05; the [audit receipt](https://github.com/Valpatel/gyropup/pull/207#issuecomment-6675731285) binds the exact source and corrected texts. The former stale prose was not evidence of missing implementation. Retained elevated-feed evidence has 72 cases, 15 double feeds overall and zero parked leaks; the FEA summary keeps nine below-target rows among 28, with only yoke/stop/cradle refreshed for this stop. A remaining legacy host docstring is explicitly still open. These are no new physical or final acceptance claims. Four current failures reject source identities: retained RS-04 fit/lug receipts, the cut-part preview producer and the highlight source. The lug guard deliberately binds all Python/JSON files in cad/catalog/designs plus context/private/toolkit inputs; it is not weakened to make unrelated source edits pass. Recovery needs genuine current evidence and independent scope review; the original branch/worktree stays preserved and #201 remains open.

The complete [PR #224](https://github.com/Valpatel/gyropup/pull/224) integration includes #226 test-shutdown, #229 production-shutdown and #230 wall-readiness corrections. It merged into dev as `e9024c22be43e456972e679cf1ee31045b16cd67` after exact source `5bc667da467e722bbef2b822dd8363104c0f32c4` received [independent final review](https://github.com/Valpatel/gyropup/pull/224#pullrequestreview-5795309917), complete green CI and fleet 192 validation. That run measured all 152 wall pages and 1,520 unique layout views with zero layout findings; command time was 1,209 seconds within its 30-minute limit. The source is integrated in dev; main/production publication remains pending at this dated release-preparation checkpoint. Normal emulator STOP and successful lifecycle tests are not physical-stop or HIL evidence.
