Valpatel/gyropup/hardware/exports/leg/rs04-fit-job/measurements.csv

location | actual_screw_length_mm | remaining_grip_mm | measurement_uncertainty_mm | calculated_penetration_mm | seat_flatness_mm | contact_or_surface_notes | seat_diameter_mm | seat_depth_mm | photo | notes
motor_hole_01
motor_hole_02
motor_hole_03
motor_hole_04
motor_hole_05
motor_hole_06
motor_hole_07
motor_hole_08
motor_hole_09
motor_hole_10
bearing_seat_and_lip
dowel_1
dowel_2
outer_roof_1
outer_roof_2
