Valpatel/gyropup/hardware/exports/turret/shaft-survey-fit-job/measurements.csv

slot | cad_nominal_width_mm | actual_mouth_width_mm | actual_round_end_width_mm | measurement_uncertainty_mm | instrument_and_method | conditioning_and_humidity | surface_or_elephant_foot_notes | sample_id | smooth_shoulder_observation | photo | notes
1 | 4.8
2 | 4.9
3 | 5.0
4 | 5.1
5 | 5.2
6 | 5.3
7 | 5.4
8 | 5.5
