Valpatel/gyropup/hardware/exports/turret/carrier-insert-fit/measurements.csv

specimen | repeat | print_batch | filament_lot | drying_record | printer_nozzle | slicer_version | resolved_profile_hash | support_removal | insert_lot | measured_pilot_mouth_mm | measured_pilot_depth_mm | measured_insert_length_mm | installation_tip | tip_temperature_C | dwell_seconds | seated_depth_mm | cracks_bulging | thread_obstruction | fixture_and_method | operator_date | notes
carrier-boss | 1
carrier-boss | 2
carrier-boss | 3
base-anchor | 1
base-anchor | 2
base-anchor | 3
