Valpatel/gyropup/software/learning/results/run1_17kg/play_tracking.png

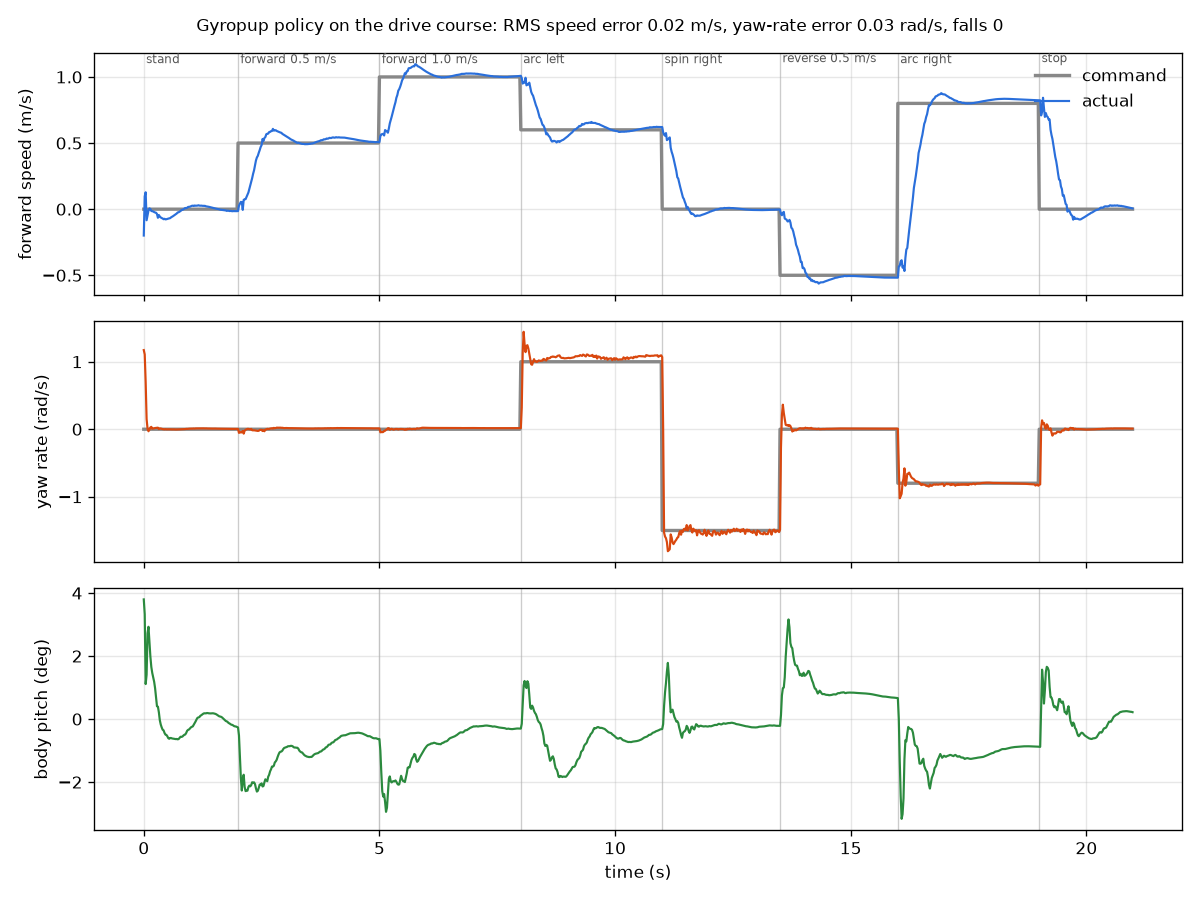
software/learning/results/run1_17kg/play_tracking.png
