Valpatel/gyropup/.agents/inbox/2026-11-07-capture-history-and-refreshed-inserts-need-separate-bindings.md

# A capture-era snapshot must not be rewritten for a refreshed media insert

On 2026-11-07, the genuine issue #8 field refresh changed E1 receipt/field bytes without changing the accepted job 253 raw capture inputs. The existing encoder collector required every one of the capture-era stage's source hashes to equal current encoding inputs. That would reject a genuine new insert despite the unchanged full source-binding guard already separating captured inputs from current insertion inputs. Rewriting the old stage metadata would falsely attribute new E1 bytes to the old capture.

The pure staging prerequisite now checks the original capture revision, complete keyset and every recorded digest against that immutable Git revision. Only the four enumerated E1 media inputs and the E1 media index may differ from current encoding inputs, after the existing full current source guard passes. Non-E1 drift, missing keys, a wrong revision and a resealed stage are rejected. The old metadata remains untouched. The collector records the actual updated insert paths separately.

A separate actual test still asserted literal old field/renderer revisions. Running its original method after genuine field adoption failed because the current field correctly records source `20643642`. The test now independently reads both actual receipt pins and requires both; distinct synthetic changed/malformed-pin controls remain. Seven selected ordinary-import prerequisite tests pass; the older AST-extracted function tests were not executed. [Commands, original failure and control logs](../plans/leg-control/encoder-reuse-preparation.json).

Limits: these are source/preparation controls. Final acceptance must demonstrate the actual complete 192-key stage against Git, the exact changed-path set, unchanged sealed 253 metadata/raw frames, genuine current video, and the full current decoded-media guard. This does not clear an encoder run, waive a captured source change, or justify relabelling a historical receipt.
