Valpatel/gyropup/.agents/plans/docking-capture-diagnostics/gy290-main-failure-log.txt

2026-11-10T19:58:04.4198784Z PHASE docking-windowed
2026-11-10T19:59:19.2060819Z PHASE docking-native
2026-11-10T20:00:43.0370508Z PHASE docking-denied
2026-11-10T20:05:05.1237205Z Owned docking listener closed
2026-11-10T20:05:05.1260499Z page.screenshot: Timeout 15000ms exceeded.
2026-11-10T20:05:05.1261379Z   - taking page screenshot
2026-11-10T20:05:05.1261717Z   - waiting for fonts to load...
2026-11-10T20:05:05.1262065Z   - fonts loaded
2026-11-10T20:05:05.1262722Z     at playbackActivationCases (tests/site/assembly/test-instruction-docking.mjs:103:13)
2026-11-10T20:05:05.1263569Z     at async file://tests/site/assembly/test-instruction-docking.mjs:155:27 {
2026-11-10T20:05:05.1264510Z Node.js v22.23.4
2026-11-10T20:05:05.1542156Z ##[error]Process completed with exit code 1.
