Valpatel/gyropup/.agents/plans/instruction-docking/playing-2949/original-failure.png

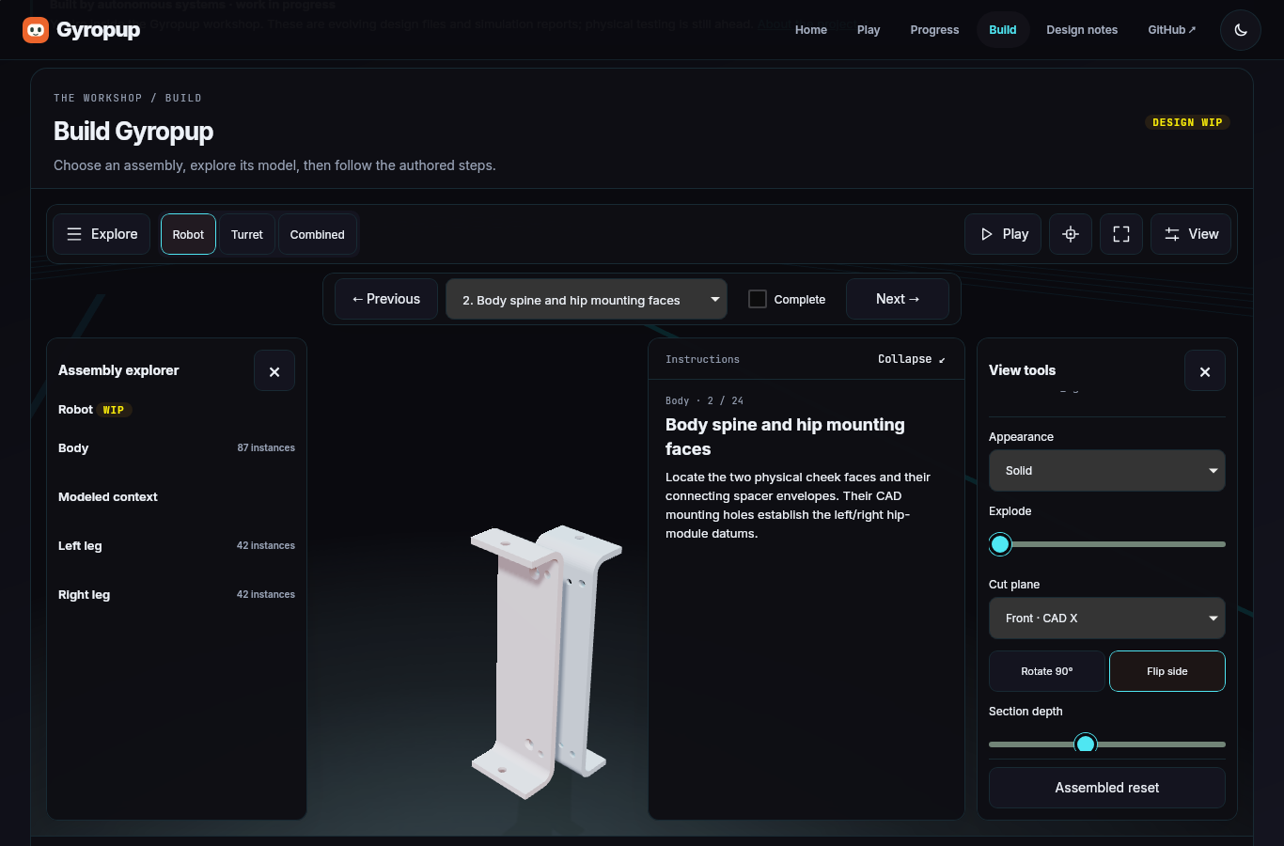
.agents/plans/instruction-docking/playing-2949/original-failure.png
