Valpatel/gyropup/software/learning/results/trained_model/robot.xml

<mujoco model="gyropup">
  <!-- Gyropup: generated by sim/model.py from default.json -->
  <compiler angle="radian" autolimits="true" />
  <option timestep="0.001" integrator="implicitfast" />
  <default>
    <default class="visual">
      <geom contype="0" conaffinity="0" group="1" density="0" />
    </default>
  </default>
  <asset>
    <texture name="grid" type="2d" builtin="checker" rgb1=".82 .80 .76" rgb2=".72 .70 .66" width="512" height="512" />
    <material name="grid" texture="grid" texrepeat="8 8" reflectance="0.05" />
  </asset>
  <worldbody>
    <light pos="0 0 4" dir="0 0 -1" diffuse=".8 .8 .8" />
    <geom name="floor" type="plane" size="0 0 0.05" material="grid" friction="1 0.005 0.0001" />
    <body name="base">
      <freejoint name="base_free" />
      <inertial pos="-0.00805965 0 0.0199676" mass="11.7401" fullinertia="0.116201 0.0683939 0.101095 2.1684e-19 -0.00851284 0" />
      <geom name="base_col0" pos="0 0 0.083" quat="1 0 0 0" type="box" size="0.0905 0.103 0.108" rgba="0.5 0.5 0.5 0" contype="2" conaffinity="1" />
      <geom class="visual" pos="0 0 0.0265" quat="1 0 0 0" type="box" size="0.0885 0.101 0.0515" rgba="0.18 0.2 0.24 1" />
      <geom class="visual" pos="0 0 0.135" quat="1 0 0 0" type="box" size="0.0905 0.103 0.056" rgba="0.960784 0.721569 0.180392 1" />
      <geom class="visual" pos="0 0.134 0" quat="0.707107 0.707107 0 0" type="cylinder" size="0.053 0.0265" rgba="0.55 0.57 0.6 1" />
      <geom class="visual" pos="0 -0.134 0" quat="0.707107 0.707107 0 0" type="cylinder" size="0.053 0.0265" rgba="0.55 0.57 0.6 1" />
      <geom class="visual" pos="0 0 -0.065" quat="1 0 0 0" type="cylinder" size="0.0515 0.03585" rgba="0.18 0.2 0.24 1" />
      <geom class="visual" pos="0.1035 0 0.093" quat="1 0 0 0" type="box" size="0.0125 0.045 0.0125" rgba="0.18 0.2 0.24 1" />
      <geom class="visual" pos="-0.1035 0 0.093" quat="1 0 0 0" type="box" size="0.0125 0.045 0.0125" rgba="0.18 0.2 0.24 1" />
      <geom class="visual" pos="0 0 0.194" quat="1 0 0 0" type="box" size="0.055 0.055 0.003" rgba="0.18 0.2 0.24 1" />
      <geom class="visual" pos="0.0925 0.0155 0.14844" quat="0.707107 0 0.707107 0" type="cylinder" size="0.0095 0.002" rgba="0.33 0.9 1 1" />
      <geom class="visual" pos="0.0925 -0.0155 0.14844" quat="0.707107 0 0.707107 0" type="cylinder" size="0.0095 0.002" rgba="0.33 0.9 1 1" />
      <site name="imu" pos="-0.00805965 0 0.0199676" />
      <body name="thigh_l" pos="0 0.167 0" quat="1 0 0 0">
        <joint name="hip_l" type="hinge" axis="0 1 0" range="-0.6 2.2" damping="0.05" frictionloss="0.05" armature="0.0171693" />
        <inertial pos="0 0 -0.087293" mass="0.20225" fullinertia="0.000701703 0.00069367 2.86875e-05 0 0 0" />
        <geom name="thigh_l_col0" pos="0 0 -0.1" quat="1 0 0 0" type="box" size="0.015 0.02 0.1" rgba="0.5 0.5 0.5 0" contype="4" conaffinity="1" />
        <geom class="visual" pos="0 0 -0.1" quat="1 0 0 0" type="box" size="0.015 0.02 0.1" rgba="0.816667 0.613333 0.153333 1" />
        <body name="shin_l" pos="0 0 -0.2" quat="1 0 0 0">
          <joint name="knee_l" type="hinge" axis="0 1 0" range="-2.44346 -0.349066" damping="0.05" frictionloss="0.05" armature="0.0171693" />
          <inertial pos="0 0.0401114 -0.181739" mass="1.05965" fullinertia="0.00324275 0.00314268 0.000925319 0 0 0.000776155" />
          <geom name="shin_l_col0" pos="0 0 -0.1" quat="1 0 0 0" type="box" size="0.015 0.02 0.1" rgba="0.5 0.5 0.5 0" contype="4" conaffinity="1" />
          <geom class="visual" pos="0 0 -0.1" quat="1 0 0 0" type="box" size="0.015 0.02 0.1" rgba="0.816667 0.613333 0.153333 1" />
          <body name="wheel_l" pos="0 0.0483 -0.2" quat="1 0 0 0">
            <joint name="wheel_l" type="hinge" axis="0 1 0" damping="0.01" frictionloss="0.02" />
            <inertial pos="0 0 0" mass="1.32" fullinertia="0.00349965 0.00656168 0.00349965 0 0 0" />
            <geom name="wheel_l_col0" pos="0 0 0" quat="0.707107 0.707107 0 0" type="cylinder" size="0.0855 0.0223" rgba="0.5 0.5 0.5 0" contype="4" conaffinity="1" friction="1 0.02 0.001" />
            <geom class="visual" pos="0 0 0" quat="0.707107 0.707107 0 0" type="cylinder" size="0.0855 0.0223" rgba="0.1 0.1 0.12 1" />
            <geom class="visual" pos="0 0 0" quat="0.707107 0.707107 0 0" type="cylinder" size="0.05301 0.0263" rgba="0.55 0.57 0.6 1" />
            <geom class="visual" pos="0 0 0" quat="1 0 0 0" type="box" size="0.047025 0.0303 0.006" rgba="0.18 0.2 0.24 1" />
          </body>
        </body>
      </body>
      <body name="thigh_r" pos="0 -0.167 0" quat="1 0 0 0">
        <joint name="hip_r" type="hinge" axis="0 1 0" range="-0.6 2.2" damping="0.05" frictionloss="0.05" armature="0.0171693" />
        <inertial pos="0 0 -0.087293" mass="0.20225" fullinertia="0.000701703 0.00069367 2.86875e-05 0 0 0" />
        <geom name="thigh_r_col0" pos="0 0 -0.1" quat="1 0 0 0" type="box" size="0.015 0.02 0.1" rgba="0.5 0.5 0.5 0" contype="4" conaffinity="1" />
        <geom class="visual" pos="0 0 -0.1" quat="1 0 0 0" type="box" size="0.015 0.02 0.1" rgba="0.816667 0.613333 0.153333 1" />
        <body name="shin_r" pos="0 0 -0.2" quat="1 0 0 0">
          <joint name="knee_r" type="hinge" axis="0 1 0" range="-2.44346 -0.349066" damping="0.05" frictionloss="0.05" armature="0.0171693" />
          <inertial pos="0 -0.0401114 -0.181739" mass="1.05965" fullinertia="0.00324275 0.00314268 0.000925319 0 0 -0.000776155" />
          <geom name="shin_r_col0" pos="0 0 -0.1" quat="1 0 0 0" type="box" size="0.015 0.02 0.1" rgba="0.5 0.5 0.5 0" contype="4" conaffinity="1" />
          <geom class="visual" pos="0 0 -0.1" quat="1 0 0 0" type="box" size="0.015 0.02 0.1" rgba="0.816667 0.613333 0.153333 1" />
          <body name="wheel_r" pos="0 -0.0483 -0.2" quat="1 0 0 0">
            <joint name="wheel_r" type="hinge" axis="0 1 0" damping="0.01" frictionloss="0.02" />
            <inertial pos="0 0 0" mass="1.32" fullinertia="0.00349965 0.00656168 0.00349965 0 0 0" />
            <geom name="wheel_r_col0" pos="0 0 0" quat="0.707107 0.707107 0 0" type="cylinder" size="0.0855 0.0223" rgba="0.5 0.5 0.5 0" contype="4" conaffinity="1" friction="1 0.02 0.001" />
            <geom class="visual" pos="0 0 0" quat="0.707107 0.707107 0 0" type="cylinder" size="0.0855 0.0223" rgba="0.1 0.1 0.12 1" />
            <geom class="visual" pos="0 0 0" quat="0.707107 0.707107 0 0" type="cylinder" size="0.05301 0.0263" rgba="0.55 0.57 0.6 1" />
            <geom class="visual" pos="0 0 0" quat="1 0 0 0" type="box" size="0.047025 0.0303 0.006" rgba="0.18 0.2 0.24 1" />
          </body>
        </body>
      </body>
      <body name="turret_pan" pos="0 0 0.197" quat="1 0 0 0">
        <joint name="turret_pan" type="hinge" axis="0 0 1" range="-3.1 3.1" damping="0.05" frictionloss="0.02" armature="0.002" />
        <inertial pos="0 0 0.015" mass="0.6" fullinertia="0.00042 0.00042 0.00075 0 0 0" />
        <geom class="visual" pos="0 0 0.015" quat="1 0 0 0" type="cylinder" size="0.05 0.015" rgba="0.18 0.2 0.24 1" />
        <geom class="visual" pos="0 0.052 0.045" quat="1 0 0 0" type="box" size="0.02 0.004 0.03" rgba="0.960784 0.721569 0.180392 1" />
        <geom class="visual" pos="0 -0.052 0.045" quat="1 0 0 0" type="box" size="0.02 0.004 0.03" rgba="0.960784 0.721569 0.180392 1" />
        <body name="turret_tilt" pos="0 0 0.058" quat="1 0 0 0">
          <joint name="turret_tilt" type="hinge" axis="0 1 0" range="-0.05 0.45" damping="0.05" frictionloss="0.02" armature="0.001" />
          <inertial pos="0.02 0 0" mass="0.9" fullinertia="0.0008775 0.0019575 0.002295 0 0 0" />
          <geom name="turret_tilt_col0" pos="0.02 0 0" quat="1 0 0 0" type="box" size="0.075 0.045 0.03" rgba="0.5 0.5 0.5 0" contype="2" conaffinity="1" />
          <geom class="visual" pos="0.02 0 0" quat="1 0 0 0" type="box" size="0.075 0.046 0.028" rgba="0.960784 0.721569 0.180392 1" />
          <geom class="visual" pos="0.115 0 0" quat="0.707107 0 0.707107 0" type="cylinder" size="0.009 0.04" rgba="0.55 0.57 0.6 1" />
          <geom class="visual" pos="0.152 0 0" quat="0.707107 0 0.707107 0" type="cylinder" size="0.011 0.006" rgba="1 0.16 0.43 1" />
          <geom class="visual" pos="-0.025 0 0.046" quat="1 0 0 0" type="cylinder" size="0.042 0.017" rgba="0.23 0.25 0.28 1" />
          <site name="muzzle" pos="0.165 0 0" size="0.004" />
        </body>
      </body>
      <body name="tail_pitch" pos="-0.1105 0 -0.07" quat="1 0 0 0">
        <joint name="tail_pitch" type="hinge" axis="0 1 0" range="-1.75 0.95" damping="0.05" frictionloss="0.05" armature="0.00835057" />
        <inertial pos="-0.0682888 0 0.00627711" mass="0.4518" fullinertia="0.000230507 0.000425084 0.000405556 0 -7.88092e-05 0" />
        <geom class="visual" pos="-0.081 0 0" quat="1 0 0 0" type="cylinder" size="0.0285 0.0255" rgba="0.55 0.57 0.6 1" />
        <geom class="visual" pos="-0.0405 0 0.0285" quat="1 0 0 0" type="box" size="0.0405 0.02 0.003" rgba="0.55 0.57 0.6 1" />
        <body name="tail" pos="-0.081 0 0" quat="1 0 0 0">
          <joint name="tail_yaw" type="hinge" axis="0 0 1" range="-0.7 0.7" damping="0.03" frictionloss="0.03" armature="0.00215916" />
          <inertial pos="-0.154075 0 -0.04" mass="0.099975" fullinertia="1.23666e-05 0.0013457 0.0013457 0 0 0" />
          <geom name="tail_col0" pos="-0.1545 0 -0.04" quat="0.707107 0 0.707107 0" type="cylinder" size="0.012 0.1245" rgba="0.5 0.5 0.5 0" contype="4" conaffinity="1" />
          <geom name="tail_col1" pos="-0.287 0 -0.04" quat="1 0 0 0" type="sphere" size="0.022" rgba="0.5 0.5 0.5 0" contype="4" conaffinity="1" friction="0.7 0.02 0.001" />
          <geom class="visual" pos="-0.1435 0 -0.04" quat="0.707107 0 0.707107 0" type="cylinder" size="0.01 0.1435" rgba="0.18 0.2 0.24 1" />
          <geom class="visual" pos="0 0 -0.02" quat="1 0 0 0" type="box" size="0.02 0.017 0.02" rgba="0.816667 0.613333 0.153333 1" />
          <geom class="visual" pos="-0.287 0 -0.04" quat="1 0 0 0" type="sphere" size="0.022" rgba="0.816667 0.613333 0.153333 1" />
          <site name="tail_tip" pos="-0.287 0 -0.04" size="0.004" />
        </body>
      </body>
    </body>
  </worldbody>
  <visual>
    <headlight ambient="0.35 0.35 0.35" diffuse="0.55 0.55 0.55" specular="0.1 0.1 0.1" />
  </visual>
  <actuator>
    <motor name="hip_l" joint="hip_l" ctrlrange="-60 60" />
    <motor name="knee_l" joint="knee_l" ctrlrange="-60 60" />
    <motor name="wheel_l" joint="wheel_l" ctrlrange="-14.3 14.3" />
    <motor name="hip_r" joint="hip_r" ctrlrange="-60 60" />
    <motor name="knee_r" joint="knee_r" ctrlrange="-60 60" />
    <motor name="wheel_r" joint="wheel_r" ctrlrange="-14.3 14.3" />
    <motor name="turret_pan" joint="turret_pan" ctrlrange="-5 5" />
    <motor name="turret_tilt" joint="turret_tilt" ctrlrange="-3 3" />
    <motor name="tail_pitch" joint="tail_pitch" ctrlrange="-36 36" />
    <motor name="tail_yaw" joint="tail_yaw" ctrlrange="-14 14" />
  </actuator>
  <sensor>
    <framequat name="imu_quat" objtype="site" objname="imu" />
    <gyro name="imu_gyro" site="imu" />
    <accelerometer name="imu_acc" site="imu" />
  </sensor>
</mujoco>
