Valpatel/gyropup/hardware/exports/motor-day/drawings/motor-day-drawings.pdf

ITEM | QTY/LEG | PART | SOURCE

8

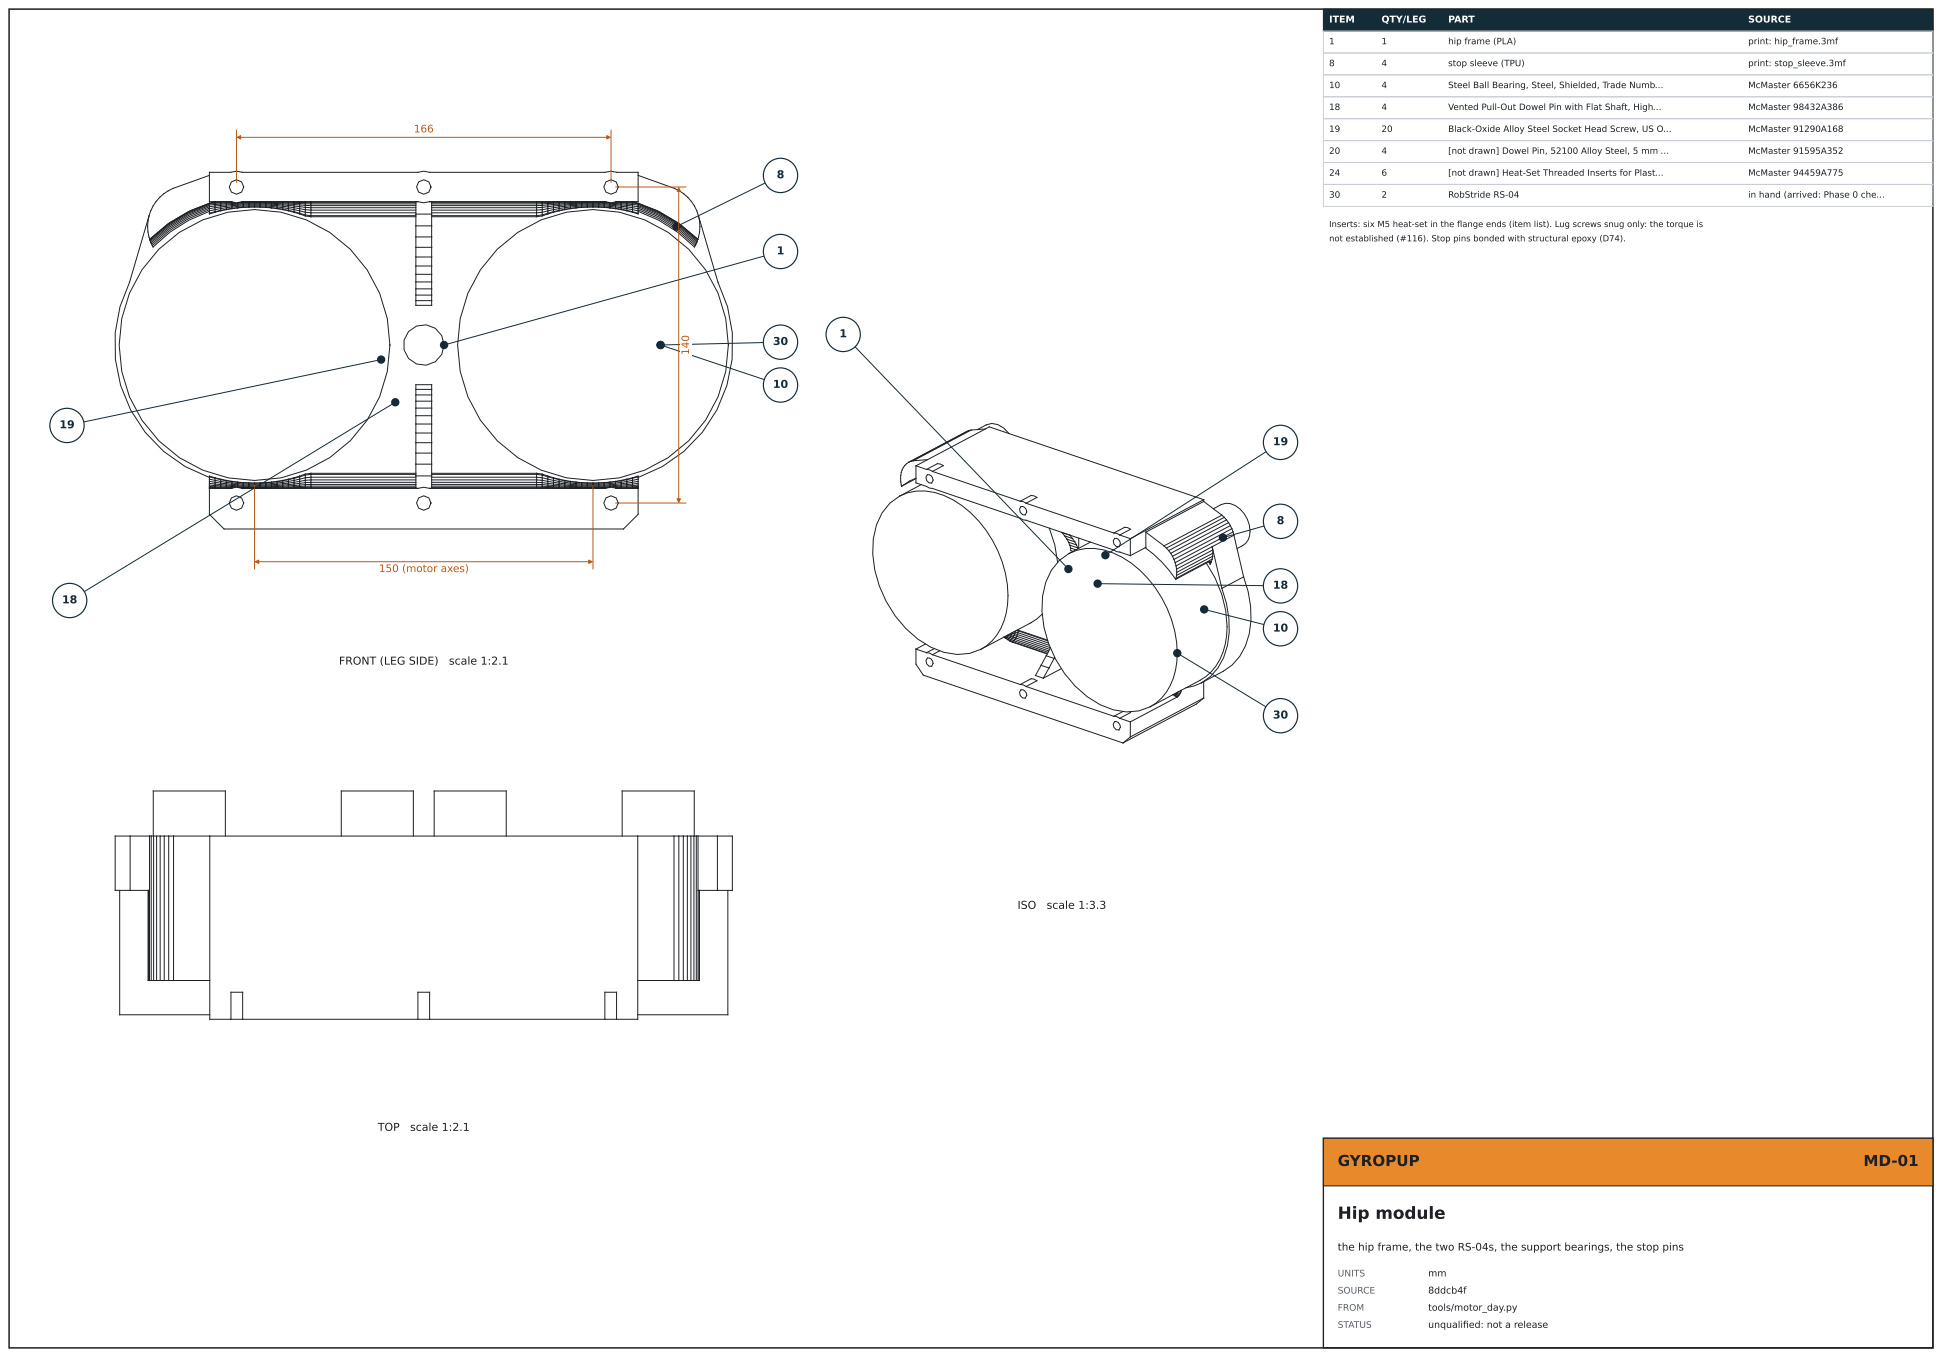
[picture p365: page 1]
150 (motor axes); TOP scale 1:2.1; ISO scale 1:3.3; hip frame (PLA); print: hip_frame.3mf; stop sleeve (TPU); print: stop_sleeve.3mf; Steel Ball Bearing, Steel, Shielded, Trade Numb…; McMaster 6656K236; Vented Pull-Out Dowel Pin with Flat Shaft, High…; McMaster 98432A386; Black-Oxide Alloy Steel Socket Head Screw, US O…; McMaster 91290A168; [not drawn] Dowel Pin, 52100 Alloy Steel, 5 mm …; McMaster 91595A352; [not drawn] Heat-Set Threaded Inserts for Plast…; McMaster 94459A775; RobStride RS-04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

Inserts: six M5 heat-set in the flange ends (item list). Lug screws snug only: the torque is

not established (#116). Stop pins bonded with structural epoxy (D74).

FRONT (LEG SIDE) scale 1:2.1

the hip frame, the two RS-04s, the support bearings, the stop pins

22

2 | 6 | 23

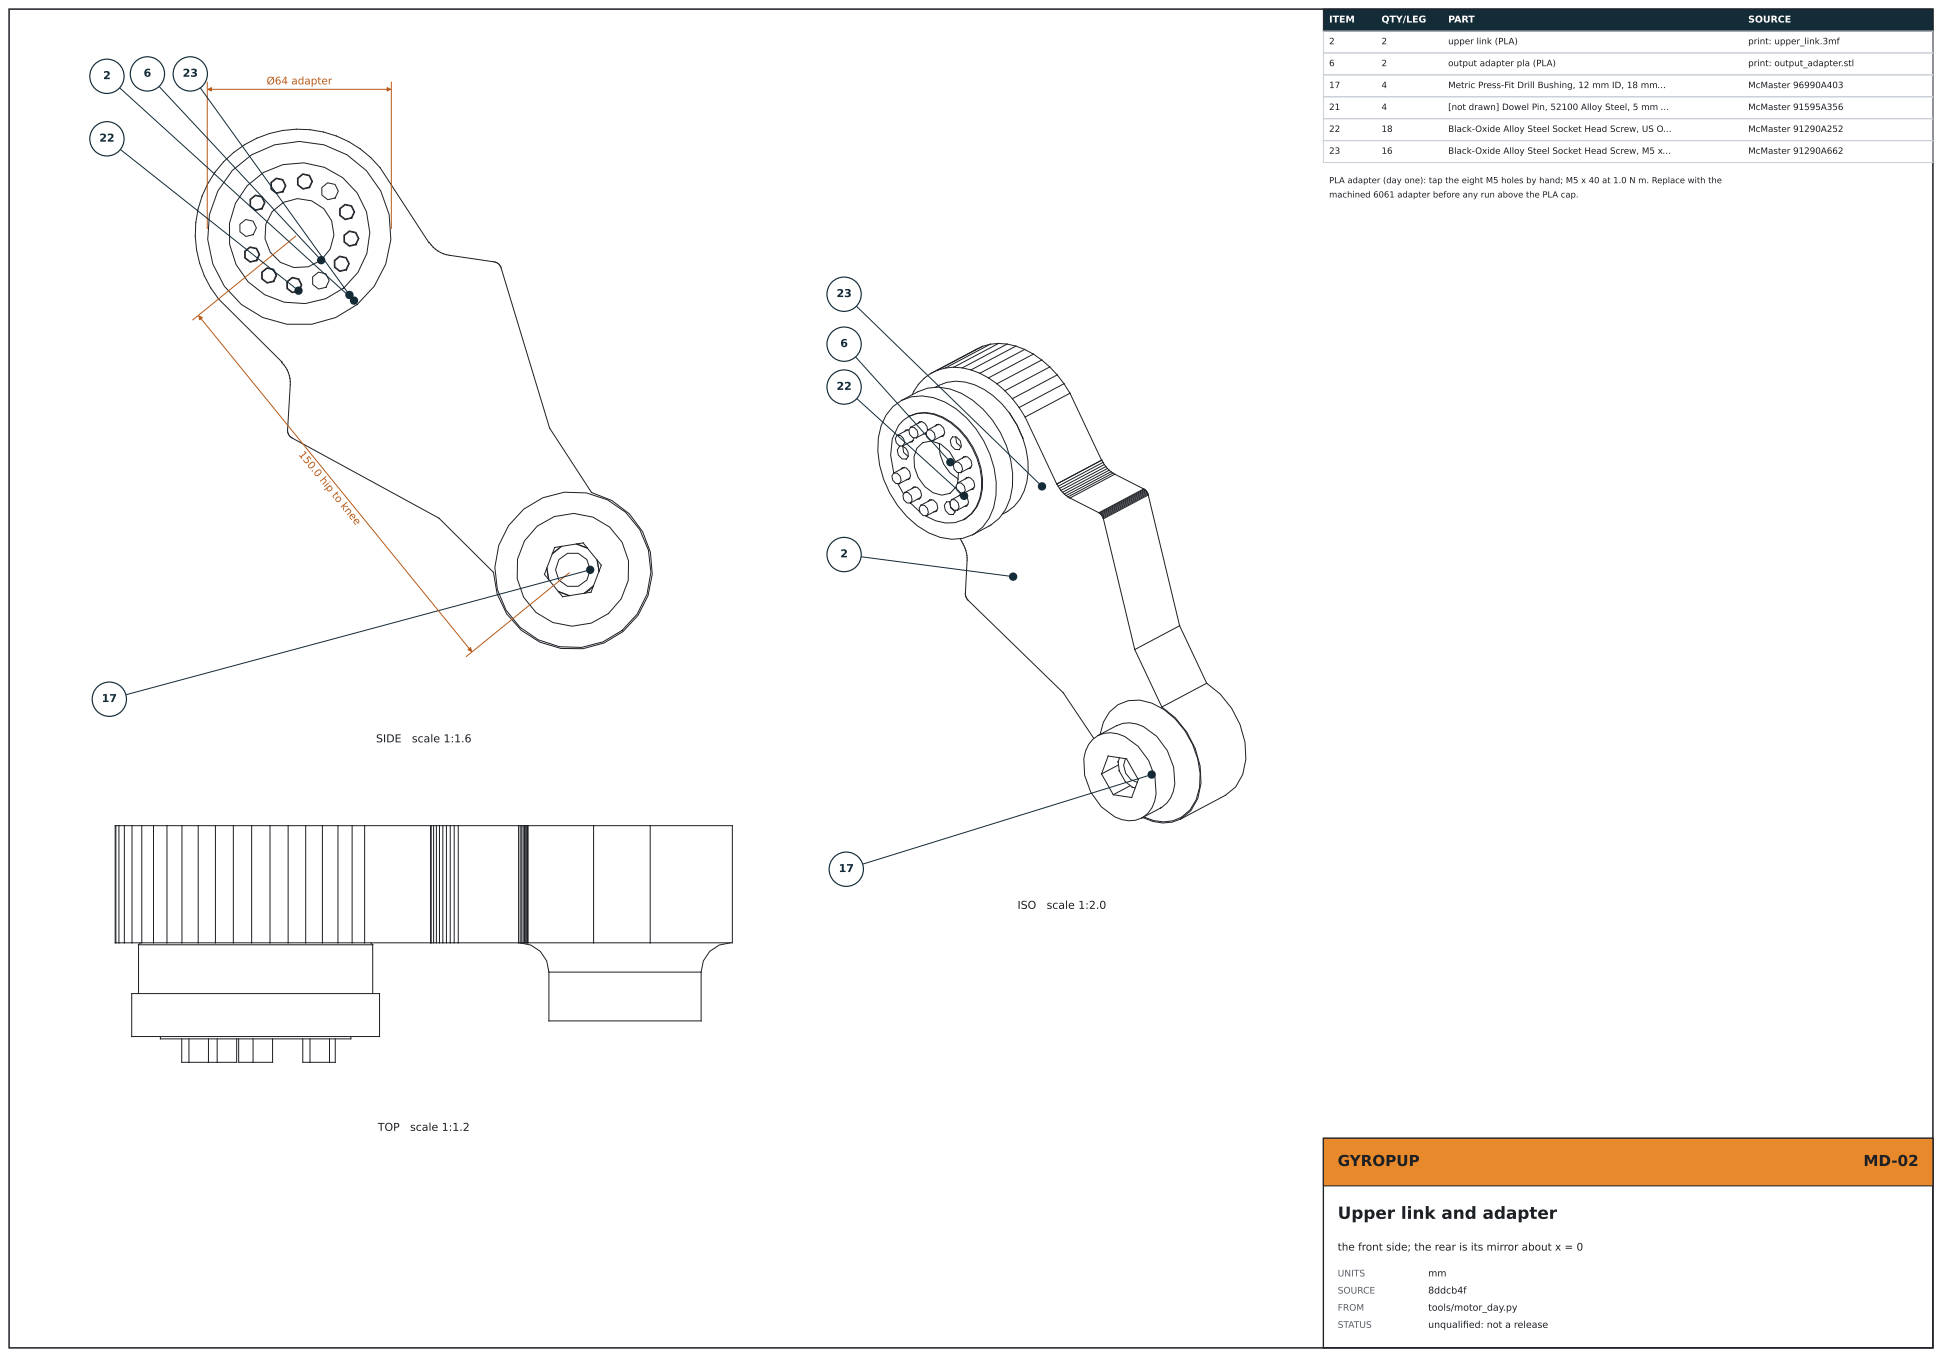
[picture p366: page 2]
SIDE scale 1:1.6; Ø64 adapter; TOP scale 1:1.2; ISO scale 1:2.0; upper link (PLA); print: upper_link.3mf; output adapter pla (PLA); print: output_adapter.stl; Metric Press-Fit Drill Bushing, 12 mm ID, 18 mm…; McMaster 96990A403; [not drawn] Dowel Pin, 52100 Alloy Steel, 5 mm …; McMaster 91595A356; Black-Oxide Alloy Steel Socket Head Screw, US O…; McMaster 91290A252; Black-Oxide Alloy Steel Socket Head Screw, M5 x…; McMaster 91290A662; GYROPUP

PLA adapter (day one): tap the eight M5 holes by hand; M5 x 40 at 1.0 N m. Replace with the
machined 6061 adapter before any run above the PLA cap.

150.0 hip to knee

Upper link and adapter

the front side; the rear is its mirror about x = 0

14

15

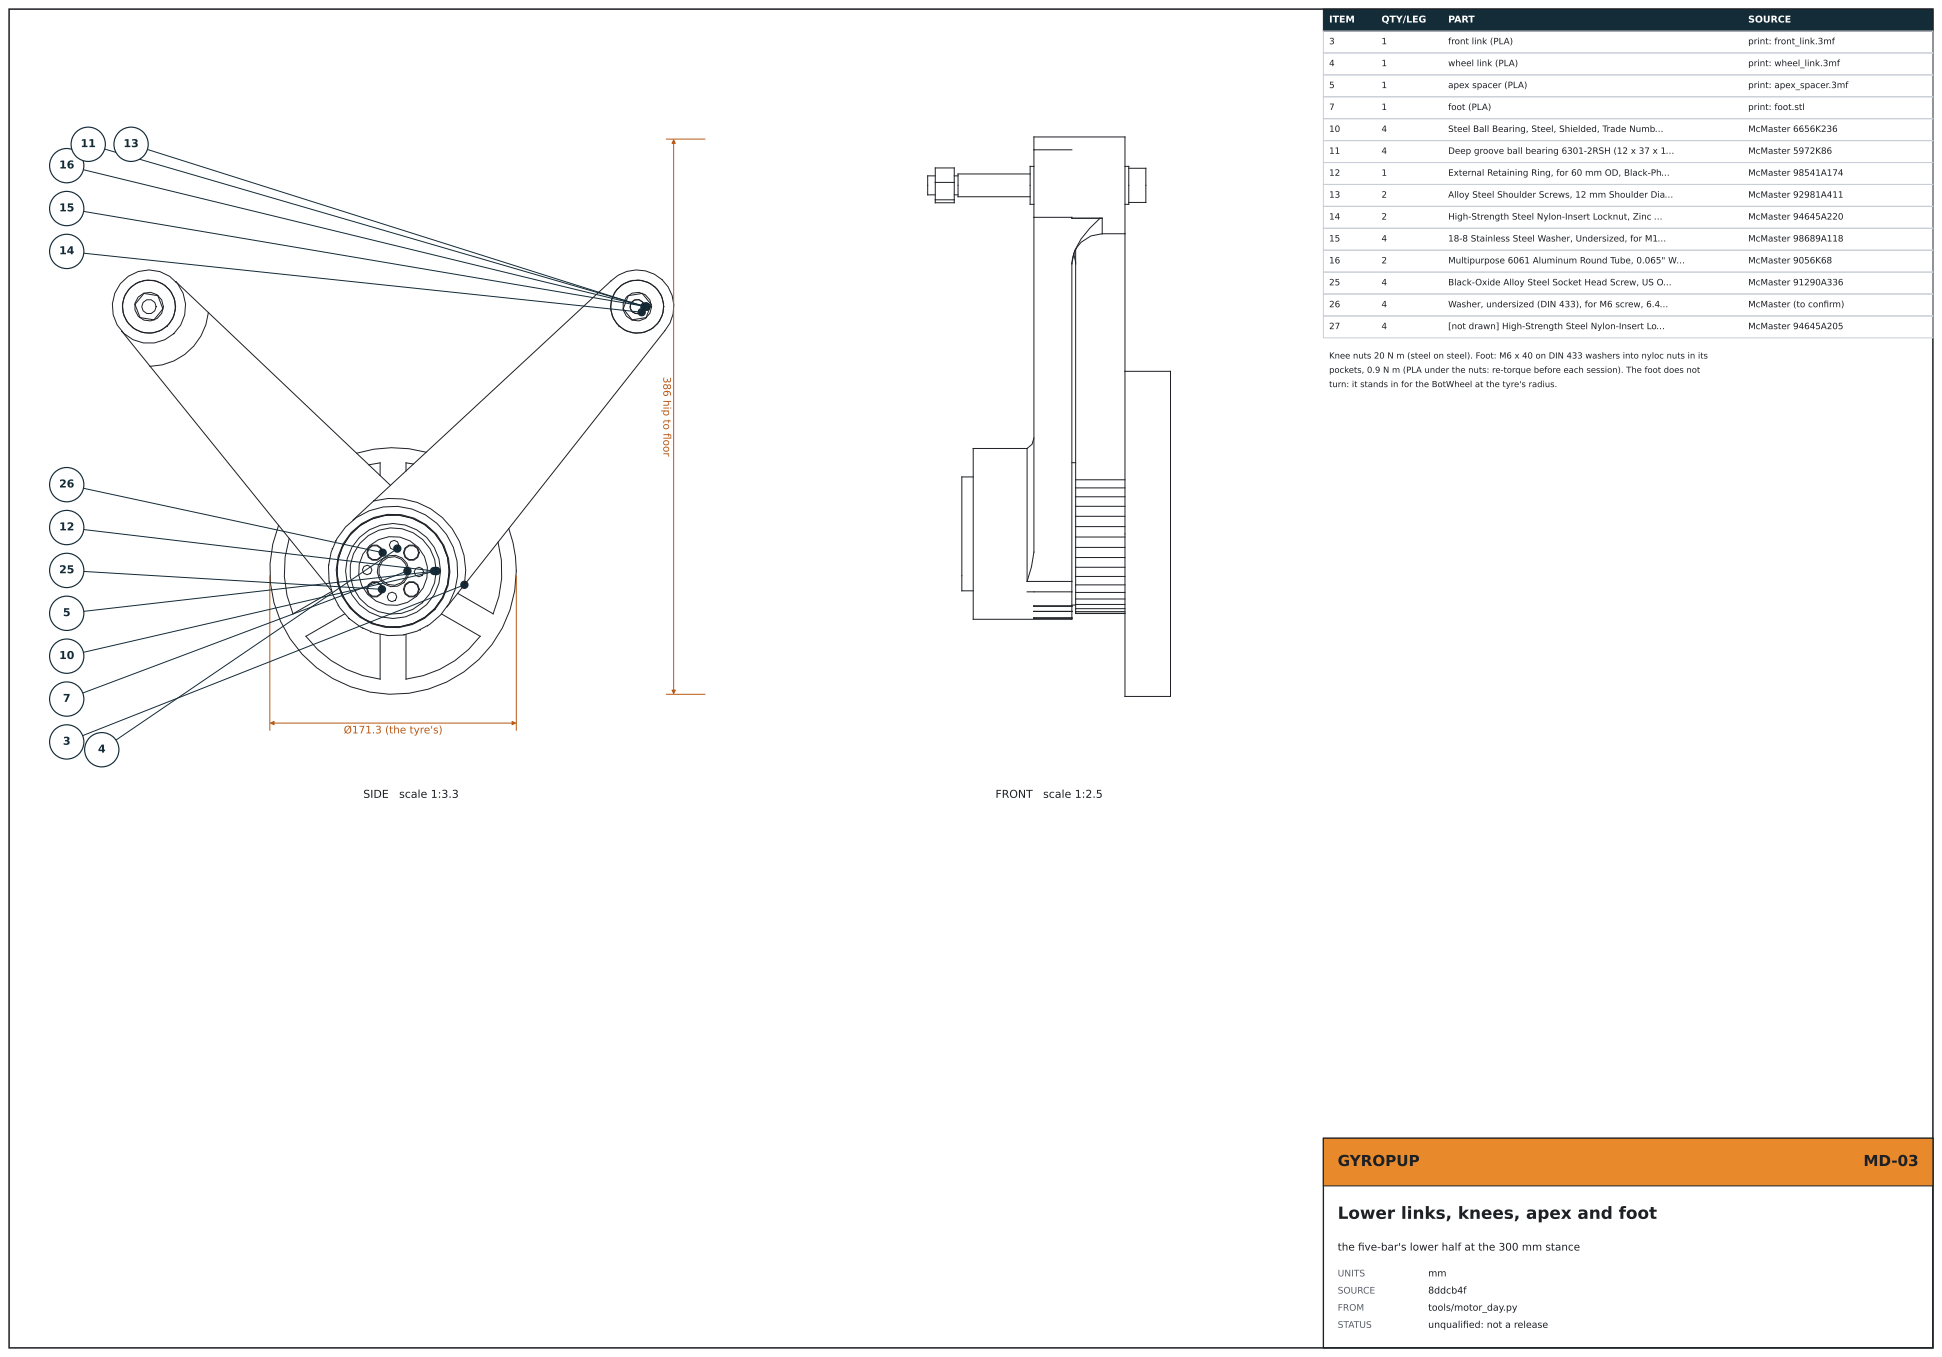
[picture p367: page 3]
SIDE scale 1:3.3; Ø171.3 (the tyre's); FRONT scale 1:2.5; front link (PLA); print: front_link.3mf; wheel link (PLA); print: wheel_link.3mf; apex spacer (PLA); print: apex_spacer.3mf; foot (PLA); print: foot.stl; Steel Ball Bearing, Steel, Shielded, Trade Numb…; McMaster 6656K236; Deep groove ball bearing 6301-2RSH (12 x 37 x 1…; McMaster 5972K86; External Retaining Ring, for 60 mm OD, Black-Ph…; McMaster 98541A174; Alloy Steel Shoulder Screws, 12 mm Shoulder Dia…; McMaster 92981A411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

Knee nuts 20 N m (steel on steel). Foot: M6 x 40 on DIN 433 washers into nyloc nuts in its
pockets, 0.9 N m (PLA under the nuts: re-torque before each session). The foot does not
turn: it stands in for the BotWheel at the tyre's radius.

386 hip to floor

Lower links, knees, apex and foot

the five-bar's lower half at the 300 mm stance

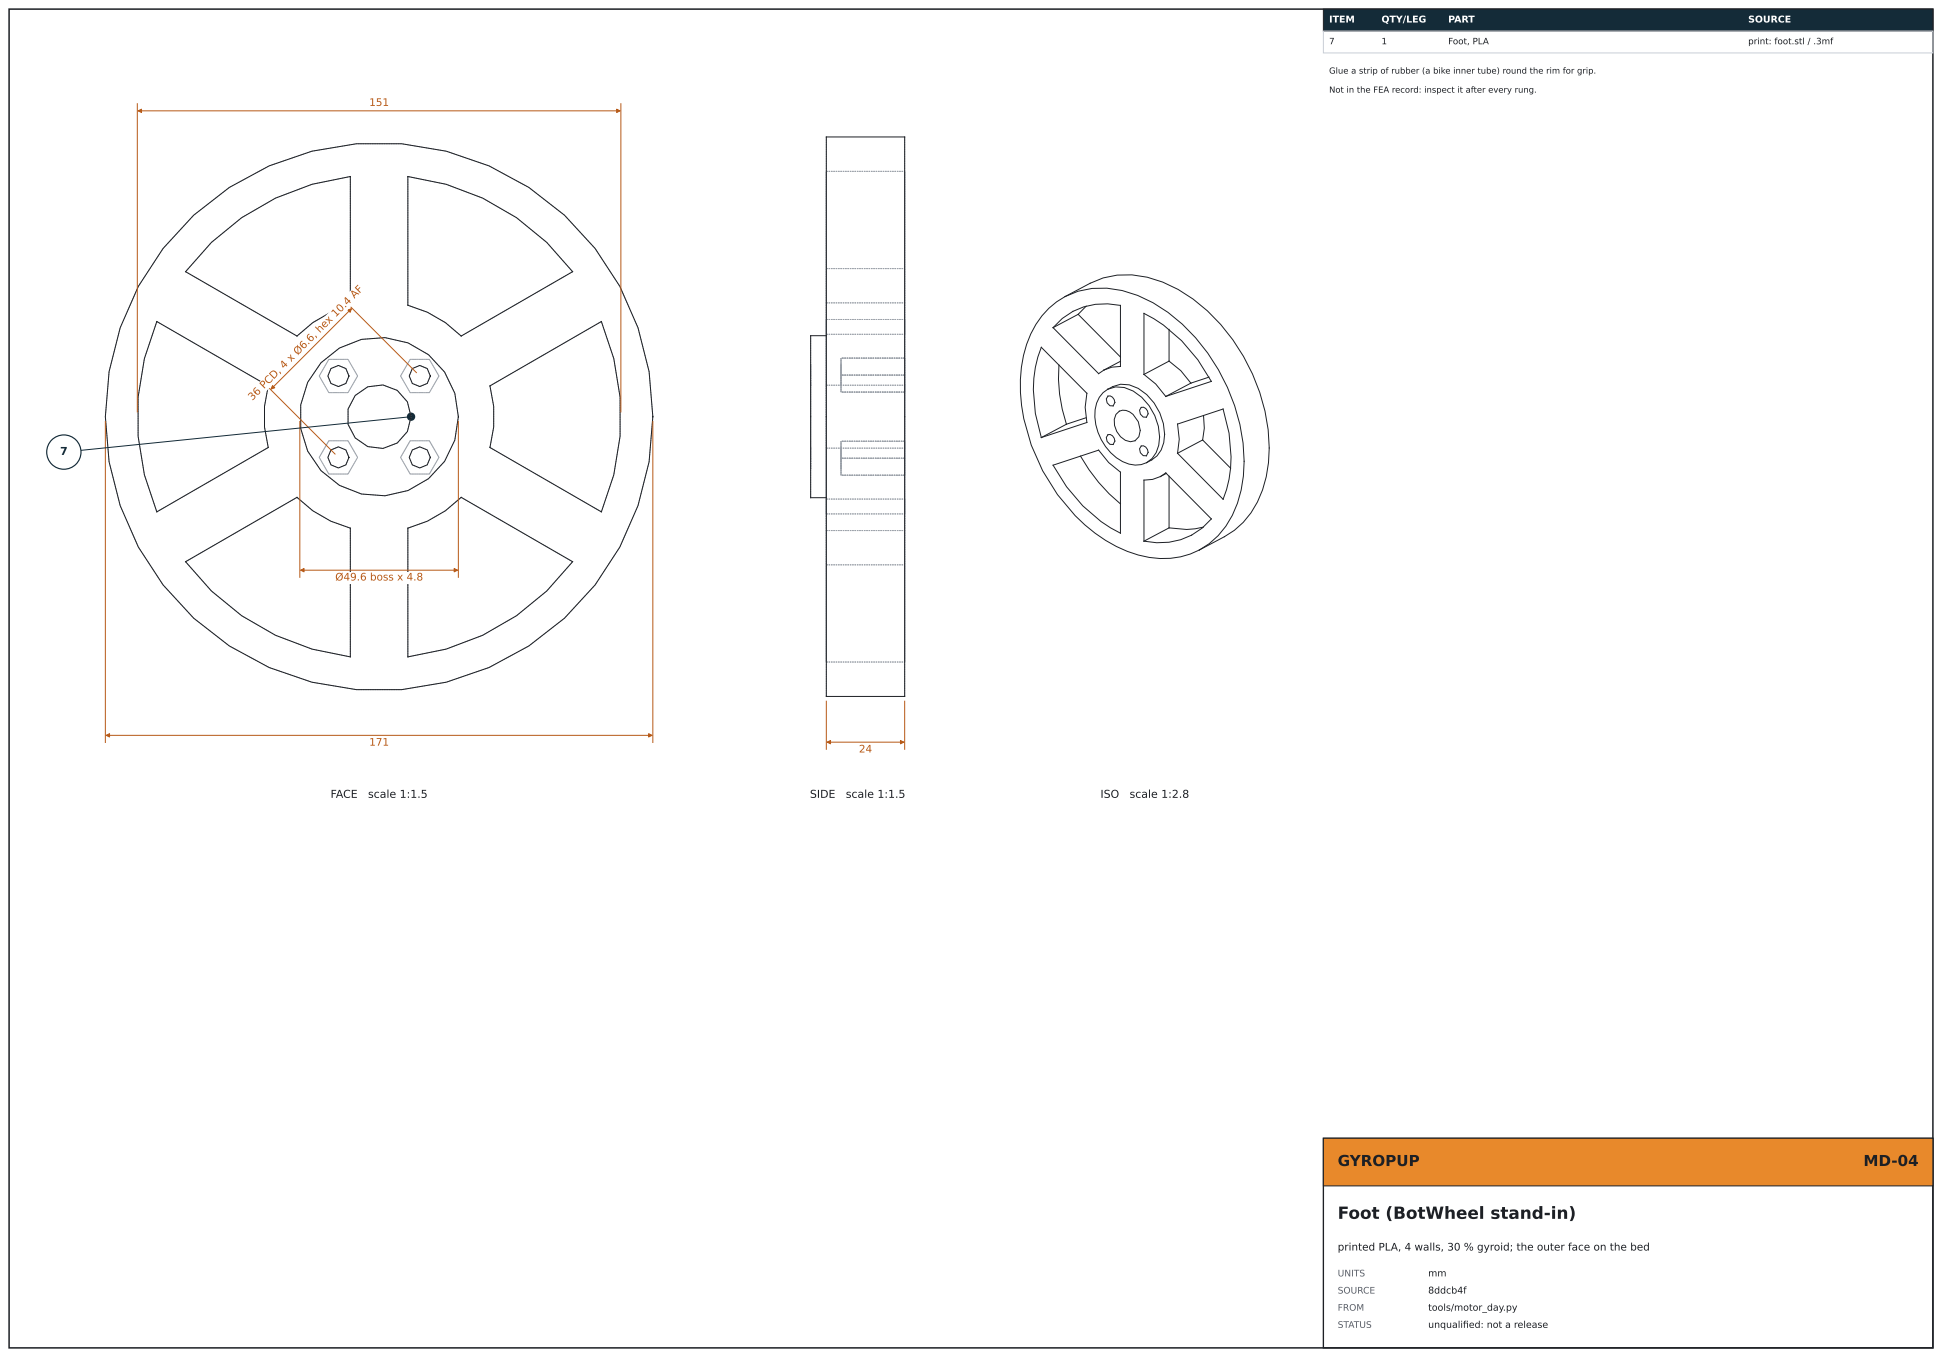
[picture p368: page 4]
FACE scale 1:1.5; Ø49.6 boss x; SIDE scale 1:1.5; ISO scale 1:2.8; Foot, PLA; print: foot.stl / .3mf; GYROPUP

Glue a strip of rubber (a bike inner tube) round the rim for grip.

Not in the FEA record: inspect it after every rung.

36 PCD, 4 x Ø6.6, hex 10.4 AF

Foot (BotWheel stand-in)

printed PLA, 4 walls, 30 % gyroid; the outer face on the bed

33

32

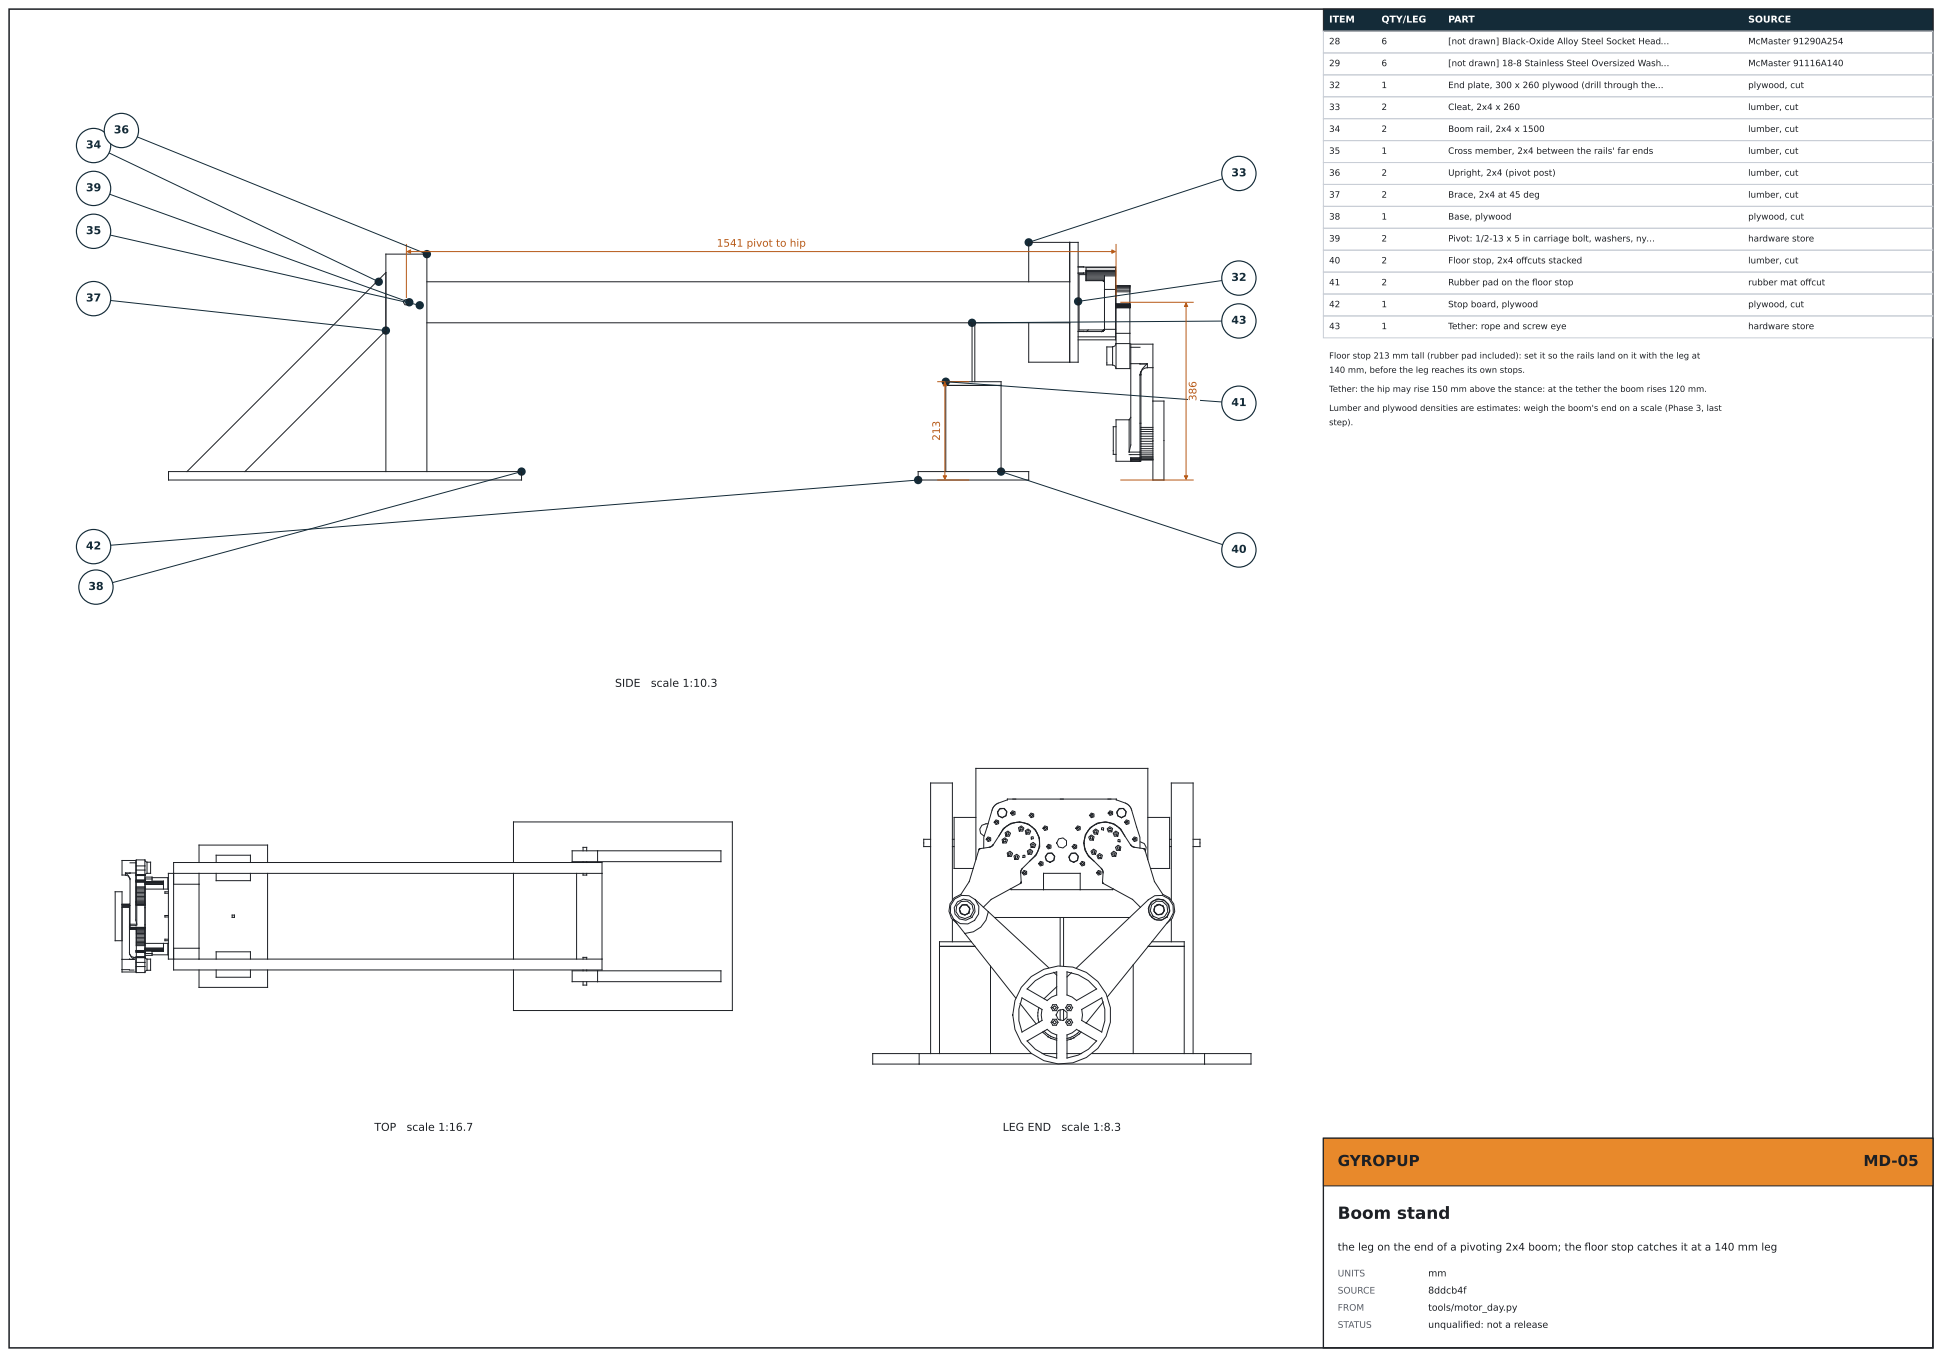
[picture p369: page 5]
SIDE scale 1:10.3; TOP scale 1:16.7; LEG END scale 1:8.3; [not drawn] Black-Oxide Alloy Steel Socket Head…; McMaster 91290A254; [not drawn] 18-8 Stainless Steel Oversized Wash…; McMaster 91116A140; End plate, 300 x 260 plywood (drill through the…; plywood, cut; Cleat, 2x4 x 260; lumber, cut; Boom rail, 2x4 x 1500; Cross member, 2x4 between the rails' far ends; Upright, 2x4 (pivot post); Brace, 2x4 at 45 deg; Base, plywood; Pivot: 1/2-13 x 5 in carriage bolt, washers, ny…; hardware store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

1541 pivot to hip

Floor stop 213 mm tall (rubber pad included): set it so the rails land on it with the leg at
140 mm, before the leg reaches its own stops.

Tether: the hip may rise 150 mm above the stance: at the tether the boom rises 120 mm.

Lumber and plywood densities are estimates: weigh the boom's end on a scale (Phase 3, last
step).

the leg on the end of a pivoting 2x4 boom; the floor stop catches it at a 140 mm leg
