Valpatel/gyropup/(list of files, drawings)

Other design files:
hardware/exports/turret/base-board-service/pcb-drill-pattern.json
hardware/exports/turret/base-board-service/pcb_bench.json
hardware/exports/turret/base-board-service/pcb_inside_base.json
