Valpatel/gyropup/hardware/fuse-board/fuse-board.kicad_pcb

## KiCad design hardware/fuse-board/fuse-board.kicad_pcb (2026-11-02)

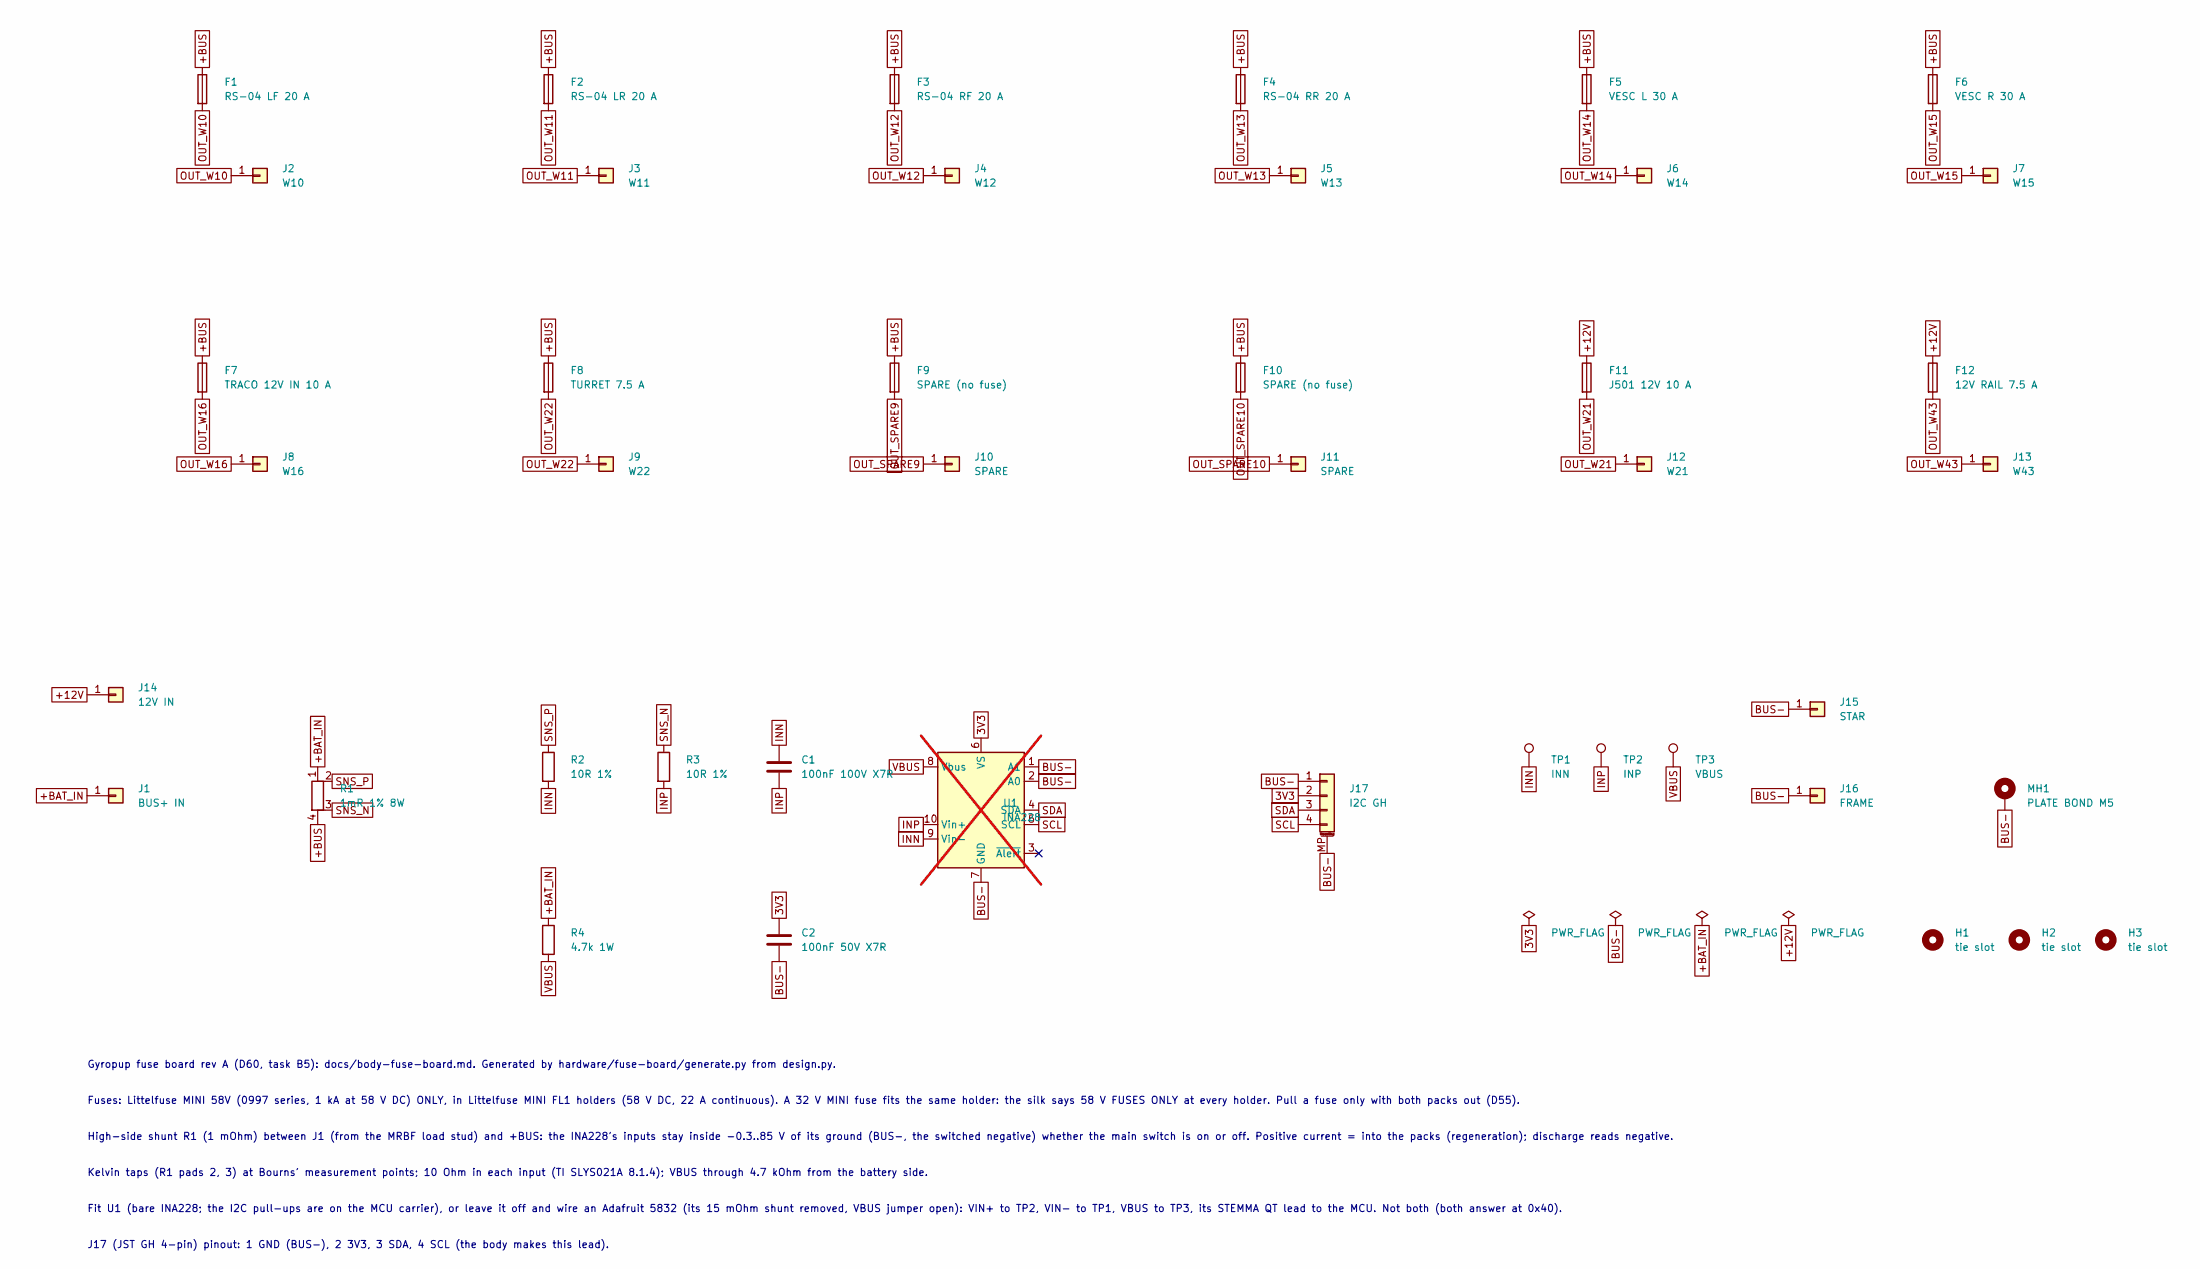
[picture p370: schematic fuse-board.kicad_sch, Gyropup fuse board]

Parts:
C1: 100nF 100V X7R; C_0603_1608Metric; LCSC C15725
C2: 100nF 50V X7R; C_0603_1608Metric; LCSC C14663
F1: RS-04 LF 20 A; Fuseholder_Blade_Mini_Littelfuse_FL1_178.6764.0001; MPN Littelfuse 178.6764.0001 (MINI FL1, 58 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; LCSC C142933
F2: RS-04 LR 20 A; Fuseholder_Blade_Mini_Littelfuse_FL1_178.6764.0001; MPN Littelfuse 178.6764.0001 (MINI FL1, 58 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; LCSC C142933
F3: RS-04 RF 20 A; Fuseholder_Blade_Mini_Littelfuse_FL1_178.6764.0001; MPN Littelfuse 178.6764.0001 (MINI FL1, 58 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; LCSC C142933
F4: RS-04 RR 20 A; Fuseholder_Blade_Mini_Littelfuse_FL1_178.6764.0001; MPN Littelfuse 178.6764.0001 (MINI FL1, 58 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; LCSC C142933
F5: VESC L 30 A; Fuseholder_Blade_Mini_Littelfuse_FL1_178.6764.0001; MPN Littelfuse 178.6764.0001 (MINI FL1, 58 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; LCSC C142933
F6: VESC R 30 A; Fuseholder_Blade_Mini_Littelfuse_FL1_178.6764.0001; MPN Littelfuse 178.6764.0001 (MINI FL1, 58 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; LCSC C142933
F7: TRACO 12V IN 10 A; Fuseholder_Blade_Mini_Littelfuse_FL1_178.6764.0001; MPN Littelfuse 178.6764.0001 (MINI FL1, 58 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; LCSC C142933
F8: TURRET 7.5 A; Fuseholder_Blade_Mini_Littelfuse_FL1_178.6764.0001; MPN Littelfuse 178.6764.0001 (MINI FL1, 58 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; LCSC C142933
F9, F10: SPARE (no fuse); Fuseholder_Blade_Mini_Littelfuse_FL1_178.6764.0001; MPN Littelfuse 178.6764.0001 (MINI FL1, 58 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; LCSC C142933
F11: J501 12V 10 A; Fuseholder_Blade_Mini_Littelfuse_FL1_178.6764.0001; MPN Littelfuse 178.6764.0001 (MINI FL1, 58 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; LCSC C142933
F12: 12V RAIL 7.5 A; Fuseholder_Blade_Mini_Littelfuse_FL1_178.6764.0001; MPN Littelfuse 178.6764.0001 (MINI FL1, 58 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; LCSC C142933
H1, H2, H3: tie slot; Slot_NPTH_4.0x10.0mm
J1: BUS+ IN; LugStud_M6_Pad12.0mm_Drill6.4mm_Via8; MPN M6 stud: socket head down through the l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
J2: W10; LugStud_M4_Pad7.0mm_Drill4.3mm_Via8; MPN M4 stud: socket head down through the l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
J3: W11; LugStud_M4_Pad7.0mm_Drill4.3mm_Via8; MPN M4 stud: socket head down through the l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
J4: W12; LugStud_M4_Pad7.0mm_Drill4.3mm_Via8; MPN M4 stud: socket head down through the l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
J5: W13; LugStud_M4_Pad7.0mm_Drill4.3mm_Via8; MPN M4 stud: socket head down through the l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
J6: W14; LugStud_M4_Pad7.0mm_Drill4.3mm_Via8; MPN M4 stud: socket head down through the l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
J7: W15; LugStud_M4_Pad7.0mm_Drill4.3mm_Via8; MPN M4 stud: socket head down through the l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
J8: W16; LugStud_M4_Pad7.0mm_Drill4.3mm_Via8; MPN M4 stud: socket head down through the l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
J9: W22; LugStud_M4_Pad7.0mm_Drill4.3mm_Via8; MPN M4 stud: socket head down through the l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
J10, J11: SPARE; LugStud_M4_Pad7.0mm_Drill4.3mm_Via8; MPN M4 stud: socket head down through the l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
J12: W21; LugStud_M4_Pad7.0mm_Drill4.3mm_Via8; MPN M4 stud: socket head down through the l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
J13: W43; LugStud_M4_Pad7.0mm_Drill4.3mm_Via8; MPN M4 stud: socket head down through the l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
J14: 12V IN; LugStud_M4_Pad7.0mm_Drill4.3mm_Via8; MPN M4 stud: socket head down through the l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
J15: STAR; LugStud_M4_Pad7.0mm_Drill4.3mm_Via8; MPN M4 stud: socket head down through the l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
J16: FRAME; LugStud_M4_Pad7.0mm_Drill4.3mm_Via8; MPN M4 stud: socket head down through the l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
J17: I2C GH; JST_GH_SM04B-GHS-TB_1x04-1MP_P1.25mm_Horizontal; MPN JST SM04B-GHS-TB; LCSC C189895
MH1: PLATE BOND M5; MountingHole_M5_Pad10.0mm_Drill5.3mm_Via8_Bond
R1: 1mR 1% 8W; R_Shunt_Bourns_CSS2H-3920_Kelvin; MPN Bourns CSS2H-3920R-1L00F; LCSC C4087295
R2, R3: 10R 1%; R_0603_1608Metric; LCSC C22859
R4: 4.7k 1W; R_2512_6332Metric; LCSC C163339
TP1: INN; TestPoint_THTPad_D2.0mm_Drill1.0mm
TP2: INP; TestPoint_THTPad_D2.0mm_Drill1.0mm
TP3: VBUS; TestPoint_THTPad_D2.0mm_Drill1.0mm
U1: INA228; TSSOP-10_3x3mm_P0.5mm; MPN TI INA228AIDGSR; LCSC C2887910; not fitted

Connections:
3V3: C2.1, J17.2, U1.6 (VS)
+12V: F11.1, F12.1, J14.1
+BAT_IN: J1.1, R1.1, R4.1
+BUS: F1.1, F2.1, F3.1, F4.1, F5.1, F6.1, F7.1, F8.1, F9.1, F10.1, R1.4
BUS-: C2.2, J15.1, J16.1, J17.1, J17.MP (MountPin), MH1.1, U1.1 (A1), U1.2 (A0), U1.7 (GND)
INN: C1.1, R2.2, TP1.1, U1.9 (Vin-)
INP: C1.2, R3.2, TP2.1, U1.10 (Vin+)
OUT_SPARE9: F9.2, J10.1
OUT_SPARE10: F10.2, J11.1
OUT_W10: F1.2, J2.1
OUT_W11: F2.2, J3.1
OUT_W12: F3.2, J4.1
OUT_W13: F4.2, J5.1
OUT_W14: F5.2, J6.1
OUT_W15: F6.2, J7.1
OUT_W16: F7.2, J8.1
OUT_W21: F11.2, J12.1
OUT_W22: F8.2, J9.1
OUT_W43: F12.2, J13.1
SCL: J17.4, U1.5 (SCL)
SDA: J17.3, U1.4 (SDA)
SNS_N: R1.3, R3.1
SNS_P: R1.2, R2.1
VBUS: R4.2, TP3.1, U1.8 (Vbus)

Notes on the sheet:
Gyropup fuse board rev A (D60, task B5): docs/body-fuse-board.md. Generated by hardware/fuse-board/generate.py from design.py.
Fuses: Littelfuse MINI 58V (0997 series, 1 kA at 58 V DC) ONLY, in Littelfuse MINI FL1 holders (58 V DC, 22 A continuous). A 32 V MINI fuse fits the same holder: the silk says 58 V FUSES ONLY at every holder. Pull a fuse only with both packs out (D55).
High-side shunt R1 (1 mOhm) between J1 (from the MRBF load stud) and +BUS: the INA228's inputs stay inside -0.3..85 V of its ground (BUS-, the switched negative) whether the main switch is on or off. Positive current = into the packs (regeneration); discharge reads negative.
Kelvin taps (R1 pads 2, 3) at Bourns' measurement points; 10 Ohm in each input (TI SLYS021A 8.1.4); VBUS through 4.7 kOhm from the battery side.
Fit U1 (bare INA228; the I2C pull-ups are on the MCU carrier), or leave it off and wire an Adafruit 5832 (its 15 mOhm shunt removed, VBUS jumper open): VIN+ to TP2, VIN- to TP1, VBUS to TP3, its STEMMA QT lead to the MCU. Not both (both answer at 0x40).
J17 (JST GH 4-pin) pinout: 1 GND (BUS-), 2 3V3, 3 SDA, 4 SCL (the body makes this lead).

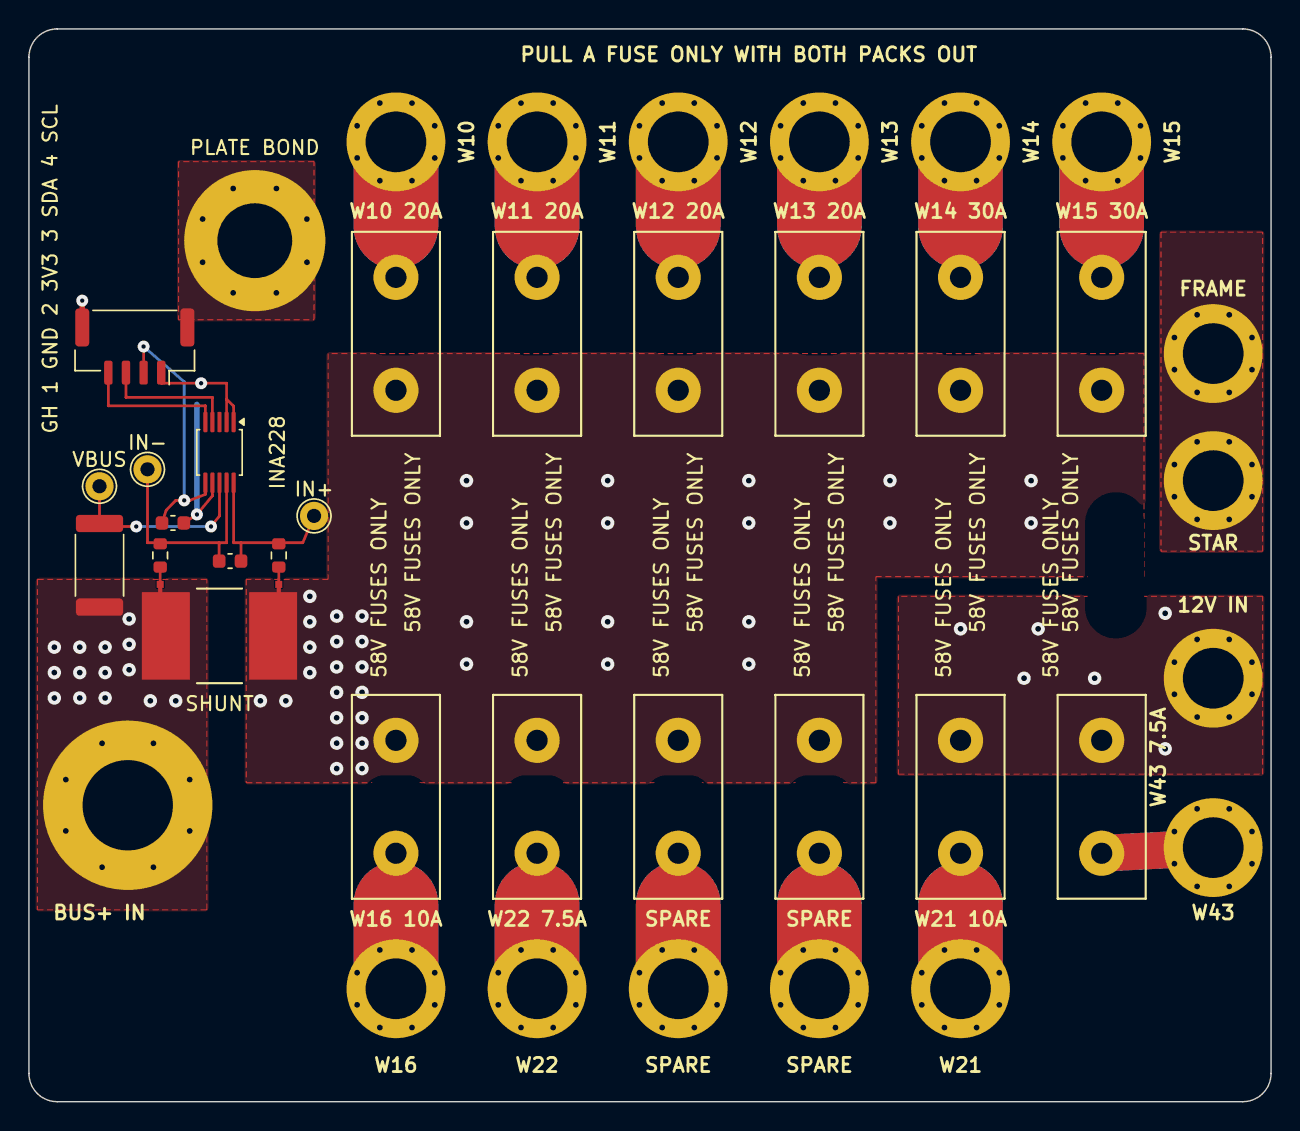
[picture p371: board fuse-board.kicad_pcb from above]

Board: 2 copper layers, 88.0 x 76.0 mm, 43 parts (0 on the bottom side), 24 nets.
