Valpatel/gyropup/hardware/cad/turret/turret.py

"""Gyropup's foam-ball turret (head payload), in CadQuery: every made part printed (D33), the bought parts as envelopes.

    .venv/bin/python hardware/cad/turret/turret.py [hardware/designs/default.json] [--no-render]

The concept is research/turret-launcher-study.md section 8 and docs/cad-plan.md section 4: Rival-size foam balls, a
gravity hopper over an 8-pocket dial on an STS3215 servo, twin SunnySky X2216 flywheels in the horizontal plane, a 100 mm
barrel, an aiming laser on the cradle, an STS3215 ring-gear pan on a 61810-2RS bearing and an STS3215 tilt with a hard
stop at 0 deg (the barrel can never point above horizontal: kid-safety rule S5 / study 6.3).

Frames (mm). Robot frame: x forward, y left, z up, origin on the hip axis. The turret is built in its own frame T (the
same axes, origin on the pan axis at the top face of the head's turret ring = the TM mounting face) and moved up by
mount_z = bodyTop + 20 + SADDLE_T. The parts that tilt are built in the cartridge frame C (x along the barrel, the ball
path on z = 0, the dial axis on x = 0); at tilt 0 C sits PATH_T above the mount face and TILT_X behind the pan axis.
Pan turns about the T z axis, tilt about a y axis through C (TILT_X, TILT_C), which lies on the pan axis. Negative
tilt = muzzle down; the hard stops allow +12 .. -25 deg (D77). The tilting group's centre of mass sits a few mm behind
the tilt axis, so unpowered the barrel rises to the upper stop (it cannot drop onto the lidar in front of the turret).

How the ball moves (turret-section.png): hopper (30 balls) -> dial pocket -> a hole in the dial-housing floor -> a
curved chute that turns it forward -> the nip of the two flywheels -> the barrel. Each shot steps the dial 45 deg and
stops it with a pocket over the hole: the ball drops while the dial stands still. A baffle in the hopper covers the
pocket over the hole, so nothing can refill it: one ball per step (no double feed), and with the dial parked no ball
can reach the wheels.

Made parts (one function each; PA6-CF = loaded, 100 % solid; PETG = 2 mm walls, 40 % infill; TPU 95A; three parts are
laser-cut 6061-T6 from SendCutSend, D40/D48: the pan clamp, the two cradle plates and the stop lug, SHEET_PARTS):
  pan_base (PA6-CF)        on the TM pattern; holds the 61810 outer race, the pan servo, the DT receptacle, the pan
                           hard-stop post, the bumper tabs
  pan_clamp (PA6-CF)       clamps the 61810 outer race down (3 x M3 into inserts)
  pan_ring (PA6-CF)        the turntable: 63 T m1.25 spur gear on its rim, journal through the inner race (DIN 471-50
                           circlip below), 40 mm open centre for the cable, pan stop finger; the yoke bolts on top
  pan_pinion (PA6-CF)      21 T m1.25 on the pan servo's horn (63:21 = 3:1)
  tilt_yoke (PA6-CF)       bridge + two arms; tilt servo on the +y arm, MR126 on the -y arm, hard stops at 0 / -25 deg
  cradle (PA6-CF)          the rail frame (D48): rails the cartridge sits on (CT: 2 dowels + a thumbscrew),
                           rebates and inserts for the two aluminium cheek plates (cradle_plate_l/r, SendCutSend 6061-T6
                           0.125 in) that carry it on the tilt axis; the hard stop is an aluminium lug (stop_lug, 0.100 in)
  horn_boss, pivot_spacer (PA6-CF)  between the plates and the tilt servo's horn (+y) and the MR126 (-y)
  cartridge_body (PA6-CF)  dial housing, drop chute, flywheel cage (motors hang under its top plate), barrel socket
  flywheel (PA6-CF)        hub on the X2216's prop adapter; flywheel_tyre (TPU 95A) Ø38 tyre bonded over it (D68)
  dial (PETG)              8 pockets, stirring cone, on the feed servo's horn
  hopper, hopper_lid, hopper_flap (PETG, translucent)  30 balls; fill port with a sprung flap for the dock spout; the lid
                           held by three snap latches on the hopper's rim (cad/turret_snaps.py, #131)
  barrel (PETG, orange tip)  Ø30 x 100, bore = ball + 1.5, two chronograph gates
  laser_mount (PETG)       ring with three M3 boresight screws, on the cartridge's top over the barrel
  bumper_ring (TPU 95A)    around the pan base
head_ring_tm(L) is the proposed replacement for the ring of build.py's head_saddle (see its docstring).
"""
from __future__ import annotations

# Support direct-file CLI execution as well as checkout package imports.
if __package__ in (None, ''):
    import sys as _checkout_sys
    from pathlib import Path as _CheckoutPath
    _checkout_sys.path.insert(0, str(_CheckoutPath(__file__).resolve().parents[3]))


import itertools
import json
import math
import subprocess
import sys
import time
from pathlib import Path

import cadquery as cq
import numpy as np

R = (Path(__file__).resolve().parents[3])
sys.path.insert(0, str((R / 'hardware/cad')))
import hardware.cad.robot.gmi as gmi  # noqa: E402
import hardware.cad.turret.turret_base_board as base_board_service  # noqa: E402
import hardware.cad.turret.turret_snaps as snaps  # noqa: E402

FAST = gmi.FAST
BED = gmi.STD['print']['bed_mm']
INSERT_DEPTH = 8.0

# ------------------------------------------------------------------------------------------------ fixed sizes (mm)
SADDLE_T = 8.0            # proposed head ring thickness (M5 inserts need 8 mm)
TM_BOLTS = [(40.0, 40.0), (-40.0, 40.0), (-40.0, -40.0), (40.0, -40.0)]      # 4 x M5 on 80 x 80
TM_DOWELS = [(52.0, 0.0), (0.0, -52.0)]                                     # 2 x Ø5, not symmetric: one way only
TM_HOLE = 45.0
# 6810-2Z (= 61810-2Z, McMaster 6656K229): 50 x 65 x 7, 52 g. Anything turning with the inner ring may bear on it only
# inside Ø52.5 and anything fixed on the outer ring only outside Ø62 (NSK 6810ZZ abutments: da 52..52.5, Da max 63); the
# shields between are recessed (0.2 mm, est).
BRG = {'d': 50.0, 'D': 65.0, 'B': 7.0, 'mass_g': 52.0, 'd_land': 52.4, 'D_land': 62.0, 'shield_recess': 0.2}
# 126-2Z (MR126 size, McMaster 7804K112): 6 x 12 x 4; lands est for a 6 x 12 miniature (inner ring to Ø7.2, outer
# ring from Ø10.6): check on the bearing in hand
MR126 = {'d': 6.0, 'D': 12.0, 'B': 4.0, 'mass_g': 1.75, 'd_land': 7.2, 'D_land': 10.6, 'shield_recess': 0.1}
# DIN 471-50 external ring (McMaster 98541A167; DIN 471:2011 table): groove Ø47 x 2.15, ring 2 thick, section b 5.1 at
# the back, lugs a 6.9 (to r 30.4 fitted), edge margin n >= 4.5 on steel. Its back and lugs overhang the 6810's shield,
# so it sits under a printed spacer (pan_spacer), 4 mm below the bearing, and the journal runs 6 mm past its groove.
CIRCLIP = {'d2': 47.0, 'm': 2.15, 's': 2.0, 'b': 5.1, 'a': 6.9, 'n_min': 4.5, 'mass_g': 11.4}
JOURNAL_LIP = 6.0
SPACER = {'h': 4.0, 'land_h': 1.0, 'r_out': 29.5}          # pan_spacer under the 61810's inner ring
# ISO 7379 shoulder screw 6 x 12, M5 x 10 (McMaster 92981A101): the tilt pivot on the -y side
SHOULDER = {'d': 6.0, 'L': 12.0, 'head_d': 10.0, 'head_h': 5.0, 'thread_d': 5.0, 'thread_L': 10.0, 'mass_g': 6.7}
# Feetech STS3215 12 V (ST-3215-C018; Feetech's drawing and datasheet, references/vendor/feetech-sts3215): case 45.2 x
# 24.7, 32 between the two mounting faces (35 over the label band on the output face and the bump on the idler face);
# the output 10.11 from the horn end, centred across; the horn Ø19.95 with 4 x M3 tapped on Ø14 and a Ø3.2 centre hole,
# its face 3.0 above the output face; the idler boss Ø6 x 4.1; 4 x M2 in each mounting face, +-10.25 across, at 8.30 and
# 29.00 (output face) or 8.30 and 32.75 (idler face) from the axis towards the far end; the two 3-pin bus sockets
# (Molex 5264) on the idler face about 14 mm from the axis, plugged straight in: 12 mm of room is kept under that face.
# 55 g bare (Feetech), 60 g with the horn and its lead.
SERVO = {'L': 45.2, 'W': 24.7, 'H': 32.0, 'band': 1.1, 'bump': 1.9, 'shaft_from_end': 10.11, 'horn_d': 19.95, 'horn_t': 3.0,
         'horn_pcd': 14.0, 'idler_boss': (6.0, 4.1), 'holes_out': (8.30, 29.00), 'holes_idler': (8.30, 32.75), 'holes_x': 10.25,
         'plugs': (9.0, 24.0, 7.5), 'plug_room': 12.0, 'mass_g': 60.0}
# The flywheel motor (D68; D42 chose the 880 KV of the same motor): SunnySky X2216 1400KV V3, short shaft. Every KV of the
# X2216 V3 is the same can, stator, shaft and prop adapter, so this drawing holds (SunnySky's drawing "X2216 short shaft" on
# en.rcsunnysky.com/x-fixedwingseries/1102.html, references/vendor/sunnysky-x2216). Ø27.7; 32 from the mount face (the
# base's end) to the bell's front face, a Ø9 boss 2.0 proud of that face (34), and the Ø3.175 shaft's rear end with its
# clip 2.5 behind the mount face (36.5 overall). The base is the first 7.5 (est from the drawing: the leads leave it
# radially, 18 AWG x 100); the bell turns from there. 4 x M3 x 0.5 in the mount face, 2.8 deep (a screw must not reach
# further: the windings), on the two diagonals 45 deg either side of the lead exit, 19 apart on one and 16 on the other.
# The bolt-on prop adapter in the box carries the hub: a Ø17 x 4 flange on 3 x M2 into the bell on Ø12 (a Ø9 recess
# over the boss centres it), a Ø5 (0/-0.03) pilot 5.5 long, then an M5 x 0.8 stud 13 long; the Ø14.8 x 2 washer (Ø5.1)
# and an M5 nylon-insert nut clamp the hub against the flange, as a propeller is. 72 g with its leads (SunnySky's
# table; RMRC lists 67.5 g), 12N14P (7 pole pairs). The 1400 KV: 55 mOhm between leads, 1.3 A at no load at 10 V, 2-4S
# (the 880 KV: 117 mOhm, 0.5 A). On the trimmed ~11.3 V flywheel rail it turns 15,722 rpm (sim/turret_launch.py).
MOTOR = {'name': 'SunnySky X2216 1400KV V3 (short shaft)', 'd': 27.7, 'len': 32.0, 'boss': (9.0, 2.0), 'stub': (7.0, 2.5),
         'base_h': 7.5, 'holes_r': (8.0, 9.5), 'flange': (17.0, 4.0), 'pilot': (5.0, 5.5), 'stud': (5.0, 13.0),
         'washer': (14.8, 2.0), 'nut': (9.2, 5.0), 'kv': 1400.0, 'pole_pairs': 7, 'R_ohm': 0.055, 'I0_a': 1.3, 'mass_g': 72.0}
# Repeat Robotics AM32 35 A (catalog repeat-robotics-am32-35a-esc): 26 x 13 x 5, 5 g with its wires. The backup ESC,
# the Lumenier Razor Pro F4 45A AM32, is 28 x 12 x 5 and fits the same place.
AM32 = {'size': (26.0, 13.0, 5.0), 'mass_g': 5.0}
# The cartridge board (docs/turret-wiring.md 6, cad/turret_boards.py): a 50 x 44 piece of perfboard over the cage plate on
# four printed posts (M3 inserts, 4 x M3 x 6), clear of the hopper by 3 mm and overhanging the cage's front over the barrel
# socket: the 6 x IRLZ44N of the phase-short brake stand in a row along its front edge (TO-220, 21 mm tall), the LM393
# gate comparator, the feed servo's polyfuse and the resistors behind them. The two ESCs lie on the cage plate under it.
CART_BOARD = {'x': (54.0, 104.0), 'y': 22.0, 'boss_h': 6.0, 'standoff': 12.0, 'parts_h': 21.0, 'board_t': 1.6, 'mass_g': 30.0,
              'bosses': ((58.0, 16.0), (58.0, -16.0), (90.0, 18.5), (90.0, -18.5))}
# Quarton VLM-650-03 LPT (D42): 650 nm, 1 mW (Class 2), Ø7.00 x 22.50, 2.6-6 V, < 35 mA (Quarton's datasheet; Digi-Key)
LASER = {'d': 7.0, 'L': 22.5, 'mass_g': 3.0, 'name': 'Quarton VLM-650-03 LPT, 650 nm, < 1 mW (Class 2)'}
# Deutsch DT04-12PA-L012 flange receptacle and its DT06-12SA plug (est; check against the TE drawings)
# TE Deutsch DT04-12PA-L012 flange receptacle (TE drawing DT04-12PX-L012 rev D2): flange 55.12 x 35.56 x 5.08, 4 x Ø4.29 on
# 44.96 x 23.88 (M4), panel cutout 41.83 x 23.52 R6.35, shroud 40.56 x 22.25 standing 19.81 proud, ~21 behind the panel.
# The robot's DT06-12SA plug goes into the shroud; a 1011-248-1205 90 deg backshell turns its harness down (est size).
DT = {'flange': (55.12, 5.08, 35.56), 'body': (40.6, 21.0, 22.3), 'front': (40.56, 19.81, 22.25), 'plug': (44.0, 45.0, 28.0),
      'holes': (44.96, 23.88), 'cutout': (41.83, 23.52), 'mass_g': 20.0,
      'sweep': 30.0}
NOT_MODELLED_G = {'wiring and the cable loops': 50, 'chronograph emitters/receivers + hopper-full beam': 10,
                  'LEDs and buzzer': 15, 'screws, inserts, dowels, springs': 17, 'CT connector pair (Micro-Fit 3.0 class)': 12}
# ---- the pan joint (docs/turret-plan.md 3.1, research/turret-slip-ring.md): a Ø22 gold capsule slip ring, flange down
# in the base on a printed carrier, its rotor turned by the turntable through a soft silicone tube. The candidates
# share the Ø22 body and the Ø44-44.5 flange (one carrier); the driver reaches each rotor stub through the tube.
# Flange hole patterns other than Servotecnica's (3 x Ø5.5 on Ø35) are not published: measure the ring in hand.
RING_MODELS = {
    'sparkfun_rob13065': {'name': 'SparkFun ROB-13065 (Senring M220 series): 12 x 2 A, Ø22 x 26.5, flange Ø44.5', 'body_l': 26.5,
                          'stub': (6.0, 5.0), 'flange': (44.5, 2.5), 'pcd': 35.0, 'mass_g': 25.0},
    'adafruit_1196': {'name': 'Adafruit 1196 (Prosper SRC022A-12): 12 x 2 A, Ø22, flange Ø44', 'body_l': 26.0,
                      'stub': (6.0, 5.0), 'flange': (44.0, 2.5), 'pcd': 35.0, 'mass_g': 20.0},
}
# D2 (decided 2026-10-27, docs/decisions.yaml D41): the SparkFun ring on the bench and on the robot; the 200 ms soft
# start keeps every circuit under 2 A (2.2 A peak at the ring, two circuits per power rail)
RING_MODEL = 'sparkfun_rob13065'
# D1 (decided): continuous pan through the ring. False brings back the stop post and finger (+-170 deg on a cable loop)
CONTINUOUS_PAN = True
# the carrier drops into the foot's Ø65 opening from below (the opening is that big so the DIN 471 circlip can pass,
# its d4 install space being Ø64.5) and is held by 3 x M3 x 10 flat heads through tabs sunk flush in the foot's
# underside into inserted bosses on the housing tube; the head ring (Ø60 hole) or the stand's top then traps it too
CARRIER = {'r': 32.25, 'h': 12.0, 'tab_angles': (60.0, 135.0, 300.0), 'tab_r': 38.5, 'tab_t': 4.0, 'screw_r': 35.75,
           'flange_seat': 2.6, 'bore': 23.1}
# the rotor coupling (McMaster 51225K24, 65A TPV): 3/16 in ID stretched 26 % over the ring's Ø6 rotor stub, so it grips
# it (the 5/16 in tube first drawn here sat 1 mm loose round the stub: cad/turret_gates.py found the rotor floating);
# its far end pushed into the driver's socket, 0.3 mm under its OD
TUBE = {'id': 4.76, 'od': 7.94, 'socket_d': 7.64, 'note': 'soft TPV rubber tube 3/16 in ID x 5/16 in OD (McMaster 51225K24)'}
MAGNET = {'d': 4.76, 'h': 3.18, 'r': 35.0, 'note': 'neodymium disc 3/16 x 1/8 in (McMaster 5862K102), the pan index: ~760 G at the hall\'s element 3.5 mm over it (Br 1.32 T, on-axis formula), 4x the A1120\'s highest operate point'}
HALL = {'size': (4.1, 3.0, 1.6), 'note': 'Allegro A1120LUA-T unipolar hall switch (UA package), on the turntable'}
DENS = {k: v['density_g_cm3'] for k, v in json.loads(((R / 'hardware/catalog/materials.json')).read_text()).items()}
PRINT_RATE_CM3_H = {'pa6-cf': 14.0, 'petg': 20.0, 'tpu95': 8.0}       # same rates as build.py's print plan


class Geo:
    """Every size that follows from the ball. ball_d: Rival rounds are 22.2-22.8 mm (study 2.1); 22.7 is the design
    ball. Bores and pockets are ball + 1.5 mm."""

    def __init__(self, ball_d: float = 22.7, wheel_d: float = 38.0, crush: float = 0.40):
        self.ball = ball_d
        self.bore = ball_d + 1.5
        self.br = self.bore / 2
        # from the nip to the muzzle the bore is ball + 2.0: with 1 mm of play the ball rides the floor and rolls up to a
        # steady topspin instead of rattling (docs/turret-physics.md finding 14: pitch scatter 11.5 -> 5 mrad, the speed
        # lost in the bore 1.0 -> 0.7 fps); the dial's pockets and the chute stay at ball + 1.5, which fed cleanly
        self.bore_out = ball_d + 2.0
        self.br_out = self.bore_out / 2
        self.wall = 2.5
        # dial: 8 pockets, spokes 4 mm; pitch radius so the gap between spokes >= the bore
        self.n_pockets = 8
        self.spoke_w = 4.0
        self.rp = math.ceil((self.bore + self.spoke_w + 0.5) * self.n_pockets / (2 * math.pi))
        self.dial_hub_r = self.rp - self.br                      # inner wall of the ball channel
        self.dial_wall_r = self.rp + self.br                     # outer wall (housing / hopper inside)
        self.housing_r = self.dial_wall_r + self.wall
        self.floor_z = 10.0                                      # top of the dial-housing floor (C frame)
        self.floor_t = 3.0
        self.dial_z0 = self.floor_z + 0.75
        self.dial_h = 20.0
        # the feed servo's output face sits in a 0.75 mm pocket in the floor's underside, so its horn's top is level with the
        # dial's underside and the dial sits flat on it (no spigot: the dial prints flat on its bottom)
        self.feed_face = self.dial_z0 - SERVO['horn_t']
        self.housing_top = 35.0
        # the lid's underside: a physics fill (sim/turret_feed.py, 40 balls jostled in) fits 15-16 balls under 70 mm,
        # 29 under 95 and 34 under 100, so 100 holds the 30-ball load with room to spare
        self.hopper_top = 100.0
        self.exit_x = float(self.rp)                             # the exit hole under the front pocket
        self.ball_z_dial = self.floor_z + ball_d / 2             # ball centre in a pocket
        self.chute_r = self.ball_z_dial                          # the chute turns the ball down to the path (z = 0)
        self.chute_cx = self.exit_x + self.chute_r               # centre of the turn, at (chute_cx, chute_r)
        # flywheels (sim/turret_launch.py, D68): Ø38 tyres squeeze the ball 40 % (to 13.6 mm), enough that a Hasbro
        # round catches the tyre and leaves near its surface speed (95-100 fps); on the trimmed flywheel rail their
        # no-load speed is the hardware ceiling (every accepted ball at 100 % throttle stays under 105 fps). The cage is
        # as wide as it was for Ø36 at 25 % (cage_y 49.3 against 49.0)
        self.wheel_d = wheel_d
        self.crush = crush
        self.wheel_c = wheel_d + ball_d * (1 - crush)            # centre distance (51.62 for Ø38 tyres at 40 %)
        self.wheel_y = self.wheel_c / 2
        self.tyre_w = 12.0
        self.tyre_t = 4.0                                        # TPU 95A on the hub's rim
        nip = math.sqrt((wheel_d / 2) ** 2 - ((self.wheel_c - ball_d) / 2) ** 2)   # ball touches both wheels here
        self.wheel_x = math.ceil(self.chute_cx + nip + 2.0)
        self.cav_r = wheel_d / 2 + 2.0                           # the cage's shells are built on this radius ...
        self.cav_cut = wheel_d / 2 + 2.5                         # ... and cut to this: the bonded TPU tyre grows 0.04 mm
                                                                  # at no-load (2.4 mm if it came loose), so 2.5 mm stays clear
        self.cage_x0 = self.wheel_x - self.cav_r - self.wall
        self.cage_x1 = self.wheel_x + self.cav_r + self.wall
        self.cage_y = self.wheel_y + self.cav_r + self.wall      # half-width of the cartridge
        self.base_z0 = -(self.br + 3.0)                          # underside of the cartridge base
        # the X2216s hang bell-down under the cage's top plate; each hub sits on its motor's prop adapter with the tyre's
        # mid-plane on the ball path, so the hub's top face (on the adapter's flange) is half a tyre above it
        self.hub_top = self.tyre_w / 2
        self.bell_z0 = self.hub_top + MOTOR['flange'][1]        # the bell's front face, under the adapter's flange
        self.plate_z0 = self.bell_z0 + MOTOR['len']              # the motors' mount face: the plate's underside
        self.plate_z1 = self.plate_z0 + 3.5
        self.barrel_od = 30.0
        self.barrel_len = 100.0
        self.socket_x0 = self.cage_x1 + 1.5                      # barrel shoulder
        self.socket_x1 = self.socket_x0 + 14.0
        self.barrel_x0 = self.socket_x0
        self.barrel_x1 = self.barrel_x0 + self.barrel_len
        # tilt and pan
        self.tilt_c = 15.0                                       # tilt axis above the ball path ...
        # ... and this far ahead of the dial axis, so the tilting group's centre of mass sits a few mm behind the axis
        # with an empty or a full hopper: unpowered, the barrel rises to the upper stop and never drops onto the lidar
        # in front of it (it was 32-35 mm ahead with the axis on the dial axis). The axis stays on the pan axis, so the
        # dial and hopper sit tilt_x behind it. 48 with the X2216s (72 g each, ahead of the axis) and the servo feed:
        # 8.5 mm behind with 30 balls, 5.2 empty (at 40 it was 0.9 behind full and 2.3 ahead empty)
        self.tilt_x = 48.0
        self.cheek_y = (self.cage_y + 1.5, self.cage_y + 7.5)              # the cheeks' envelope (v0's printed cheeks)
        self.arm_y = (self.cheek_y[1] + 4.0, self.cheek_y[1] + 12.0)
        self.rail_y = (self.cage_y - 10.5, self.cheek_y[1])
        self.rail_z = (self.base_z0 - 5.0, self.base_z0)
        # D48: the aluminium cheek plates sit in a rebate in the rails' outer faces: inner face on the rebate, outer
        # face 4.0 mm from the yoke's arm (where v0's printed cheek was)
        self.plate_y = (self.cheek_y[1] - PLATE['rebate'], self.cheek_y[1] - PLATE['rebate'] + SHEET['al6061']['thickness_mm'])
        self.foot_z = (self.rail_z[1] - PLATE['foot_h'], self.rail_z[1])
        self.stop_r = (24.0, 32.0)
        # the tilt hard stops (deg, + = muzzle up): the stop lug on the yoke's sectors. D77: the limits are the mechanism's.
        # Upper +12: cad/turret_tilt_range.py finds the feed servo under the dial 3 mm over the fixed pan pinion at
        # +14.75 (pan 0 +-20; contact past +17.25) and 3 mm from the pan ring at +18.5 elsewhere; +12 keeps 2.75 deg to
        # that margin for the lug's give and the print, and keeps 17 deg of the upper sector on the -y arm (the sector
        # runs off the arm's edge past +13.7 with 15 deg left). exports/turret/limits.json (cad/turret_limits.py)
        # carries both stops, and the feed's firing limit, to the sims and the firmware
        self.tilt_min = -25.0
        self.tilt_max = 12.0
        # pan stack (T frame, mount face z = 0)
        self.foot_t = 5.0
        self.brg_z = 40.0                                        # bottom of the 61810
        self.housing_r_out = 37.0
        self.turntable_z = (53.0, 69.0)
        self.gear = {'m': 1.25, 'z_ring': 63, 'z_pinion': 21}
        self.centre_d = self.gear['m'] * (self.gear['z_ring'] + self.gear['z_pinion']) / 2 + 0.15
        self.servo_pan_xy = (-self.centre_d, 0.0)
        # the pan servo stands on four posts with its idler face 12 mm over the foot: its bus plugs go in from below
        self.servo_z0 = self.foot_t + SERVO['plug_room']
        self.base_r = 72.0
        # 12 mm (10 in v0): the push on the muzzle twists the bridge next to the -y arm, and with the yoke printed on its
        # back that torsion is interlaminar shear (cad/turret_studies.py, layer-aware: 1.76 at 10 mm)
        self.bridge_z = (self.turntable_z[1], self.turntable_z[1] + 12.0)
        self.post_r = (68.5, 74.0)
        self.post_top = 62.0
        self.dt_y = 73.0                                         # DT pad face (flange seat)
        self.bumper_r = (82.0, 86.0)                             # 4 mm of TPU 95A (mass: it was 6)
        self.bumper_z = (6.0, 20.0)                              # on 6 mm tabs: the M3 x 4.3 inserts need 5.1 mm
        # height of the ball path above the mount face. Two limits: the feed servo's bus plugs (under the dial, tilt_x
        # behind the pan axis) 3 mm over the turntable; and the front of the cradle at full depression passing over the
        # pan pinion, whose 16 mm face reaches z 69 (it was binding with the laser tab under the cradle's front, 125
        # giving ~2 mm; the laser is on the cartridge's top now, so 125 keeps more)
        feed_bottom = self.feed_face - SERVO['H'] - SERVO['plug_room']
        self.path_t = max(math.ceil(self.turntable_z[1] + 3.0 - feed_bottom), 125)
        self.tilt_t = self.path_t + self.tilt_c


# ------------------------------------------------------------------------------------------------ small helpers

def box(x0, x1, y0, y1, z0, z1):
    (x0, x1), (y0, y1), (z0, z1) = sorted((x0, x1)), sorted((y0, y1)), sorted((z0, z1))
    return cq.Workplane('XY').box(x1 - x0, y1 - y0, z1 - z0, centered=False).translate((x0, y0, z0))


def cyl_z(r, z0, z1, x=0.0, y=0.0):
    return cq.Workplane('XY').circle(r).extrude(z1 - z0).translate((x, y, z0))


def ring_z(ro, ri, z0, z1, x=0.0, y=0.0):
    return cq.Workplane('XY').circle(ro).circle(ri).extrude(z1 - z0).translate((x, y, z0))


def cyl_y(r, y0, y1, x=0.0, z=0.0):
    return cq.Workplane('XZ', origin=(0, y1, 0)).center(x, z).circle(r).extrude(y1 - y0)


def cyl_x(r, x0, x1, y=0.0, z=0.0):
    return cq.Workplane('YZ', origin=(x0, 0, 0)).center(y, z).circle(r).extrude(x1 - x0)


def sector_y(r0, r1, a0, a1, y0, y1, cx=0.0, cz=0.0, n=24):
    """An annular sector in the x-z plane (angles in degrees from +x towards +z) between y0 and y1."""
    a = [math.radians(a0 + (a1 - a0) * k / n) for k in range(n + 1)]
    pts = [(cx + r1 * math.cos(t), cz + r1 * math.sin(t)) for t in a] + [(cx + r0 * math.cos(t), cz + r0 * math.sin(t)) for t in reversed(a)]
    return cq.Workplane('XZ', origin=(0, y1, 0)).polyline(pts).close().extrude(y1 - y0)


def arc_sector_y(r0, r1, a0, a1, y0, y1, cx=0.0, cz=0.0):
    """sector_y with true circular arcs (no facets): clipping or meeting another face leaves no sliver edges."""
    P = lambda r, d: (cx + r * math.cos(math.radians(d)), cz + r * math.sin(math.radians(d)))
    am = (a0 + a1) / 2
    w = (cq.Workplane('XZ', origin=(0, y1, 0)).moveTo(*P(r0, a0)).lineTo(*P(r1, a0)).threePointArc(P(r1, am), P(r1, a1))
         .lineTo(*P(r0, a1)).threePointArc(P(r0, am), P(r0, a0)).close())
    return w.extrude(y1 - y0)


def polar(r, a):
    return (r * math.cos(a), r * math.sin(a))


def gear_profile(m, z, backlash=0.15, n=6, round_root=True):
    """Involute spur gear outline (20 deg pressure angle, addendum m, dedendum 1.25 m) as one closed polyline.
    backlash thins every tooth at the pitch circle (printed gears). round_root: each gap's root is one circular arc
    from flank to flank through the root circle (a full-round fillet: printed teeth break at a sharp root)."""
    alpha = math.radians(20.0)
    rp, ra, rf = m * z / 2, m * z / 2 + m, m * z / 2 - 1.25 * m
    rb = rp * math.cos(alpha)
    inv = lambda x: math.tan(x) - x
    psi = (math.pi * m / 2 - backlash) / (2 * rp) + inv(alpha)
    r0 = max(rb, rf)
    flank = [(r, psi - inv(math.acos(min(1.0, rb / r)))) for r in (r0 + (ra - r0) * k / n for k in range(n + 1))]
    pitch = 2 * math.pi / z
    pts = []
    for i in range(z):
        c = i * pitch
        if not round_root and rf < rb:
            pts.append(polar(rf, c - flank[0][1]))
        pts += [polar(r, c - f) for r, f in flank]
        pts += [polar(r, c + f) for r, f in reversed(flank)]
        if not round_root:
            if rf < rb:
                pts.append(polar(rf, c + flank[0][1]))
            pts.append(polar(rf, c + pitch / 2))
            continue
        # the arc through this flank's foot, the root circle mid-gap and the next tooth's flank foot
        p1, pm, p2 = polar(r0, c + flank[0][1]), polar(rf, c + pitch / 2), polar(r0, c + pitch - flank[0][1])
        pts += _arc3(p1, pm, p2, 6)[1:-1]
    return pts


def _arc3(p1, p2, p3, n):
    """n + 1 points on the circle through p1, p2, p3, from p1 through p2 to p3."""
    (x1, y1), (x2, y2), (x3, y3) = p1, p2, p3
    d = 2 * (x1 * (y2 - y3) + x2 * (y3 - y1) + x3 * (y1 - y2))
    if abs(d) < 1e-12:
        return [p1, p2, p3]
    ux = ((x1 ** 2 + y1 ** 2) * (y2 - y3) + (x2 ** 2 + y2 ** 2) * (y3 - y1) + (x3 ** 2 + y3 ** 2) * (y1 - y2)) / d
    uy = ((x1 ** 2 + y1 ** 2) * (x3 - x2) + (x2 ** 2 + y2 ** 2) * (x1 - x3) + (x3 ** 2 + y3 ** 2) * (x2 - x1)) / d
    r = math.hypot(x1 - ux, y1 - uy)
    a1, a2, a3 = (math.atan2(y - uy, x - ux) for x, y in (p1, p2, p3))
    # go from a1 to a3 the way that passes a2
    da = (a3 - a1) % (2 * math.pi)
    if not (0 < (a2 - a1) % (2 * math.pi) < da):
        da -= 2 * math.pi
    return [(ux + r * math.cos(a1 + da * k / n), uy + r * math.sin(a1 + da * k / n)) for k in range(n + 1)]


def spur(m, z, z0, z1, x=0.0, y=0.0):
    return cq.Workplane('XY').polyline(gear_profile(m, z)).close().extrude(z1 - z0).translate((x, y, z0))


def insert_hole(x, y, z_top, size='M3', depth=INSERT_DEPTH):
    """Pilot for a heat-set insert, from a top face down."""
    return cyl_z(FAST[size]['insert_pilot'] / 2, z_top - depth, z_top + 0.1, x, y)


def through_z(x, y, d, z0=-50.0, z1=400.0):
    return cyl_z(d / 2, z0, z1, x, y)


def servo_envelope(G, shaft_xyz, axis):
    """STS3215 with its horn, the idler boss and the room its bus plugs need under the idler face. The output face is at
    shaft_xyz and the horn faces along `axis` ('+z' for the pan servo, '-y' for the tilt servo); the case runs 10.11 one
    way and 35.09 the other along its length (+y for the pan servo, -z for the tilt servo). The label band (output
    face) and the bump (idler face) are drawn over the middle of those faces (their extent is est)."""
    L, W, H = SERVO['L'], SERVO['W'], SERVO['H']
    s = SERVO['shaft_from_end']
    # built with the output axis +z, the output face at z = 0, the far end towards +y
    e = box(-W / 2, W / 2, -s, L - s, -H, 0)
    e = e.union(box(-6.5, 6.5, 12.0, L - s - 1.0, 0, SERVO['band']))
    e = e.union(box(-7.0, 7.0, 4.0, L - s - 4.0, -H - SERVO['bump'], -H))
    e = e.union(cyl_z(SERVO['idler_boss'][0] / 2, -H - SERVO['idler_boss'][1], -H))
    pg = SERVO['plugs']
    e = e.union(box(-pg[2], pg[2], pg[0], pg[1], -H - SERVO['plug_room'], -H))                 # the two bus plugs (est)
    e = e.union(cyl_z(SERVO['horn_d'] / 2, 0, SERVO['horn_t']))
    x, y, z = shaft_xyz
    if axis == '+z':
        return e.translate((x, y, z))
    # horn towards -y, length downwards: local z -> -y, local y -> -z
    return e.rotate((0, 0, 0), (1, 0, 0), 90).rotate((0, 0, 0), (0, 1, 0), 180).translate((x, y, z))


# ------------------------------------------------------------------------------------------------ fixed (pan base) parts

SERVO_END_WALL = 8.0          # mm: the pan servo pocket's end wall (3 until 2026-10-27, docs/turret-sections.md section 1)


def pan_base(G, *, board_service=True):
    """The fixed base, printed PA6-CF on its foot (100 % solid): a Ø144 x 5 foot on the TM pattern (4 x M5 x 16
    counterbored through it into the head ring's inserts, 2 x Ø5 dowel holes, a Ø65 centre opening (wider than the
    TM's Ø45 so the pan_spacer and the circlip go on from below), six lightening windows), a housing tube holding the
    61810 outer race (Ø65 seat on a Ø62 shoulder; the pan_clamp holds it down with 3 x M3 into the housing ears), the
    STS3215 pan servo in a pocket on four posts (4 x M2 x 20 up through the foot into its idler face; its bus plugs
    have 12 mm under it and the lead goes through the housing tube to the centre), a 2.5 mm drip skirt, a flat pad with the DT04-12PA flange receptacle on the -y side (window for its body, 2 x M3
    inserts), a window into the housing for the cable, three inserted bosses for the slip ring's carrier with its tabs'
    pockets under the foot, the base-board bay (a wall at +x carrying a 50 x 35 board on 4 x M3), 5 tabs with M3
    inserts that carry the TPU bumper ring, and (only with CONTINUOUS_PAN off) the pan hard-stop post at the front."""
    t = G.foot_t
    hz1 = G.brg_z + BRG['B']
    s = cyl_z(G.base_r, 0, t)
    s = s.union(ring_z(G.base_r, G.base_r - 2.5, 0, 18))                                    # drip skirt
    s = s.union(ring_z(35.5, 32.5, 0, G.brg_z - 2))                                         # housing tube
    s = s.union(ring_z(G.housing_r_out, BRG['D_land'] / 2, G.brg_z - 2, hz1))               # bearing seat ring
    for a in CLAMP_EARS:                                                                    # clamp ears
        ear = box(G.housing_r_out - 0.5, 42.0, -7, 7, hz1 - 4, hz1).rotate((0, 0, 0), (0, 0, 1), a)
        s = s.union(ear).union(cyl_z(7.0, hz1 - 4, hz1, *polar(42.0, math.radians(a))))
    # pan servo pocket (walls 3 mm up to 25 mm over its idler face, servo + 0.3 mm) and the four posts it stands on
    sx, sy = G.servo_pan_xy
    W, L, sft = SERVO['W'], SERVO['L'], SERVO['shaft_from_end']
    px0, px1, py0, py1 = sx - W / 2 - 0.3, sx + W / 2 + 0.3, sy - sft - 0.3, sy + L - sft + 0.3
    s = s.union(box(px0 - 3, px1 + 9.0, py0 - 3, py1 + 3, 0, G.servo_z0 + 25))   # inner wall runs well into the housing tube
    # the end wall the mesh's tangential force pushes the servo into (224 N at a full stall): 3 mm bent it across its
    # layers (FEA: interlaminar shear, 0.57 at a stall, 1.14 at the cap); SERVO_END_WALL thick, inside the bumper's bore
    s = s.union(box(px0 - 3, px1 + 9.0, py1, py1 + SERVO_END_WALL, 0, G.servo_z0 + 25).intersect(cyl_z(G.bumper_r[0] - 2.0, -1, 200)))
    s = s.cut(box(px0, px1, py0, py1, t, G.servo_z0 + 40))
    posts = [(sx + sgn * SERVO['holes_x'], sy + d) for sgn in (1, -1) for d in SERVO['holes_idler']]
    for (x, y) in posts:
        s = s.union(cyl_z(2.75, t - 0.01, G.servo_z0, x, y))
    s = s.union(box(-29, 29, -G.dt_y, -(G.base_r - 8), 0, DT_Z + DT['flange'][2] / 2 + 1.0))   # DT pad (-y)
    if not CONTINUOUS_PAN:
        s = s.union(box(G.post_r[0], G.post_r[1], -4, 4, 0, G.post_top))                    # hard-stop post (front)
    C = CARRIER
    for a in C['tab_angles']:                                                               # the carrier's screw bosses
        s = s.union(box(32.6, C['screw_r'] + 4.5, -6, 6, 0, C['tab_t'] + 9.0).rotate((0, 0, 0), (0, 0, 1), a))
    s = s.union(box(BB['x0'], BB['x0'] + BB['t'], -BB['w'] / 2, BB['w'] / 2, 0, BB['h']))     # the base-board bay's wall
    for (y, z) in BB['holes']:                                                              # and its 4 standoff bosses
        s = s.union(cyl_x(3.5, BB['x0'] - BB['standoff'], BB['x0'] + 0.01, y, z))
    for a in BUMPER_TABS:
        s = s.union(box(G.base_r - 1, BUMPER_LUG[1], -6, 6, 0, G.bumper_z[0]).rotate((0, 0, 0), (0, 0, 1), a))
    # --- cuts
    s = s.cut(cyl_z(BRG['D'] / 2, G.brg_z, hz1 + 1))                                       # bearing seat
    s = s.cut(cyl_z(32.5, -1, G.brg_z - 2 + 0.01))                                         # centre opening and the tube's bore
    for (x, y) in TM_BOLTS:
        s = s.cut(through_z(x, y, FAST['M5']['clear'], -1, 60)).cut(cyl_z(5.0, t - 0.01, 60, x, y))
    for (x, y) in TM_DOWELS:
        s = s.cut(cyl_z(2.5, -1, t - 1.0, x, y))
    for a in (67.5, 112.5, 247.5, 292.5):                                                  # foot windows (none under the bay)
        s = s.cut(sector_z(40.0, 63.0, a - 10, a + 10, -1, t + 1))
    for a in C['tab_angles']:                                                               # tab pockets under the foot
        s = s.cut(sector_z(C['r'] - 0.5, C['tab_r'] + 0.3, a - 13.3, a + 13.3, -1, C['tab_t']))
        x, y = polar(C['screw_r'], math.radians(a))
        s = s.cut(cyl_z(FAST['M3']['insert_pilot'] / 2, C['tab_t'] - 0.1, C['tab_t'] + 7.0, x, y))     # M3 insert from below
    for (y, z) in BB['holes']:                                                              # 4 x M3 inserts for the board
        s = s.cut(cyl_x(FAST['M3']['insert_pilot'] / 2, BB['x0'] - BB['standoff'] - 0.1, BB['x0'] - BB['standoff'] + 6.0, y, z))
    for a in CLAMP_EARS:
        x, y = polar(42.0, math.radians(a))
        s = s.cut(insert_hole(x, y, hz1, 'M3', 6.0))
    for (x, y) in posts:                                                                    # M2 up into the servo
        s = s.cut(through_z(x, y, 2.4, -1, G.servo_z0 + 1)).cut(cyl_z(2.1, -1, 2.2, x, y))
    s = s.cut(box(sx + 4, -26.0, sy - 7, sy + 7, t, G.servo_z0 - 1))                         # the servo's lead to the centre
    cw, ch = DT['cutout']
    s = s.cut(box(-cw / 2, cw / 2, -G.dt_y - 1, -(G.base_r - 30), DT_Z - ch / 2, DT_Z + ch / 2))  # the receptacle's body goes in
    for sx_ in (-1, 1):
        for sz_ in (-1, 1):
            x, z = sx_ * DT['holes'][0] / 2, DT_Z + sz_ * DT['holes'][1] / 2
            s = s.cut(cyl_y(FAST['M4']['insert_pilot'] / 2, -G.dt_y - 0.1, -G.dt_y + 8.0, x, z))     # 4 x M4 inserts
    s = s.cut(box(-10, 10, -40, 0, t, t + 18))                                              # cable window (-y)
    for a in BUMPER_TABS:
        x, y = polar(BUMPER_BOLT_R, math.radians(a))
        s = s.cut(insert_hole(x, y, G.bumper_z[0], 'M3', 5.5))                             # short insert, 4.3 mm
    return base_board_service.service_base(s) if board_service else s


BUMPER_TABS = (30.0, 90.0, 150.0, 210.0, 330.0)   # none straight ahead: the lidar is 10 mm from the bumper there
# the 4 mm bumper is widened to a lug at each tab (r 80..87.5) for its screw and washer
BUMPER_LUG = (80.0, 87.5)
BUMPER_BOLT_R = 84.0
DT_Z = 19.0
# the base-board bay (docs/turret-plan.md 3.3): the 555 safety-pulse oscillator, the pan servo's 12 V regulator, the
# ring's stator connector; a 50 x 35 board standing on 5 mm standoffs on the wall's inner face, components inwards
BB = {'x0': 53.0, 't': 3.0, 'w': 54.0, 'h': 38.0, 'holes': ((-22.4, 9.0), (22.4, 9.0), (-22.4, 33.0), (22.4, 33.0)),
      'board': (30.0, 50.8, 1.6), 'standoff': 5.0, 'parts_h': 12.0}   # Adafruit 1608 Perma-Proto cut to 30 x 50.8, corners drilled
# the ring's rotor leads: a Ø7.5 bundle on -y, 13 mm off the axis (3 mm from the turntable's bore)
LEADS = {'d': 7.5, 'r': 13.0, 'z_run': 89.0}


def sector_z(r0, r1, a0, a1, z0, z1, n=16):
    """An annular sector about the z axis (angles in degrees)."""
    a = [math.radians(a0 + (a1 - a0) * k / n) for k in range(n + 1)]
    pts = [polar(r1, t) for t in a] + [polar(r0, t) for t in reversed(a)]
    return cq.Workplane('XY').polyline(pts).close().extrude(z1 - z0).translate((0, 0, z0))


def pan_clamp(G):
    """The clamp ring, laser-cut by SendCutSend from 0.125 in (3.175 mm) 6061-T6 aluminium (exports/turret/pan_clamp.dxf):
    Ø61 to Ø74, its bore over the 6810's outer race by 1.5 mm, holding it down with 5 x M3 x 8 into the housing ears at
    CLAMP_EARS (none at 180 deg, where the pan servo stands); its Ø74 outside keeps 1.25 mm from the pinion's tips. A
    printed ring of the same outline needed 5 mm of PA6-CF and still only just passed (FEA); aluminium is four times as
    strong and 1.8 mm thinner. The turntable's shoulder passes through it with 2.5 mm to spare. The pan index
    magnet (3/16 x 1/8 in disc) sits through it on the housing's top at pan 0, under the hall switch in the turntable."""
    z0 = G.brg_z + BRG['B']
    t = CLAMP_T
    s = ring_z(G.housing_r_out, 30.5, z0, z0 + t)
    for a in CLAMP_EARS:
        lug = box(0, 46.0, -7, 7, z0, z0 + t).rotate((0, 0, 0), (0, 0, 1), a)
        s = s.union(lug.cut(cyl_z(G.housing_r_out, z0 - 1, z0 + t + 1)).union(cyl_z(7.0, z0, z0 + t, *polar(42.0, math.radians(a)))))
        s = s.cut(through_z(*polar(42.0, math.radians(a)), FAST['M3']['clear']))
    s = s.cut(cyl_z(30.5, z0 - 1, z0 + t + 1))
    s = s.cut(cyl_z(MAGNET['d'] / 2 + 0.05, z0 - 1, z0 + 4, MAGNET['r'], 0.0))      # the pan index magnet: on the housing's top, through the clamp
    return s


def pan_pinion(G):
    """21 T module 1.25 spur pinion (printed PA6-CF, 16 mm face, full-round roots) on a Ø20 flange that screws to the
    STS3215's aluminium horn: 4 x M3 x 16 on Ø14 into the horn's tapped holes, their heads sunk flush, a Ø6.5 hole over
    the horn's centre screw. 63 : 21 = 3 : 1, so the 2.94 N·m servo gives 8.8 N·m at the turntable. FEA of one tooth
    loaded at the pitch line (cad/turret_studies.py, layer-aware): 2.1 at the firmware's 50 % torque cap (everyday,
    >= 2) and 1.31 at the servo's own EEPROM ceiling of 80 % (rare, >= 1.2; firmware/turret/config.py PAN_MAX_TORQUE,
    verified at every init); at a full 100 % stall the root fillet read 1.05, which is why the ceiling is set."""
    m = G.gear
    x, y = G.servo_pan_xy
    z0 = G.servo_z0 + SERVO['H'] + SERVO['horn_t']
    z1 = z0 + 1.0 + PINION_FACE
    s = spur(m['m'], m['z_pinion'], z0 + 1.0, z1, x, y).union(cyl_z(10.0, z0, z0 + 1.0, x, y))
    s = s.cut(cyl_z(3.25, z0 - 1, z1 + 1, x, y))                                         # over the horn's centre screw
    for k in range(4):
        hx, hy = polar(SERVO['horn_pcd'] / 2, math.pi / 4 + k * math.pi / 2)
        s = s.cut(cyl_z(FAST['M3']['clear'] / 2, z0 - 1, z1 + 1, x + hx, y + hy)).cut(cyl_z(2.9, z1 - 3.4, z1 + 1, x + hx, y + hy))
    return s


def bumper_ring(G):
    """TPU 95A ring, 4 mm wide and 14 mm tall, widened to a lug at each of the base's five tabs for its M3 screw and
    washer; a gap
    on -y lets the DT plug in. It takes the knocks before the pan base does."""
    s = ring_z(G.bumper_r[1], G.bumper_r[0], *G.bumper_z)
    for a in BUMPER_TABS:
        s = s.union(sector_z(BUMPER_LUG[0], BUMPER_LUG[1], a - 7.0, a + 7.0, *G.bumper_z))
    s = s.cut(box(-31, 31, -120, -50, 0, 40))
    for a in BUMPER_TABS:
        s = s.cut(through_z(*polar(BUMPER_BOLT_R, math.radians(a)), FAST['M3']['clear']))
    return s


# ------------------------------------------------------------------------------------------------ pan parts (turn with pan)

def circlip_z(G):
    """(bottom, top) of the DIN 471-50 ring: it pushes the pan_spacer up into the 61810's inner race."""
    top = G.brg_z - SPACER['h']
    return top - CIRCLIP['s'], top


def pan_ring(G):
    """The turntable, printed PA6-CF upside down (100 % solid): a 63 T module 1.25 spur gear (16 mm face) with a
    Ø40 open centre, a shoulder that sits on the 61810's inner race (only inside Ø52.4: a 1 mm relief keeps it off
    the shield), a Ø50 journal through it, the pan_spacer and a DIN 471-50 circlip below the race (the journal runs
    6 mm past the groove), 4 x M4 inserts for the tilt yoke, the pan index hall switch in a pocket in its underside
    3 mm over the magnet in the clamp ring (its leads up a Ø2.8 hole), and, only with CONTINUOUS_PAN off, the pan stop
    finger at the rear (reaches over the pinion and meets the base's post at +-173.5 deg; software limit +-170)."""
    z0, z1 = G.turntable_z
    m = G.gear
    s = spur(m['m'], m['z_ring'], z0, z1)
    s = s.union(ring_z(28.0, 20.0, G.brg_z + BRG['B'], z0 + 0.01))                         # shoulder on the inner race
    cz0, cz1 = circlip_z(G)
    groove0 = cz1 - CIRCLIP['m']
    s = s.union(ring_z(BRG['d'] / 2, 20.0, groove0 - JOURNAL_LIP, G.brg_z + BRG['B'] + 0.01))   # journal
    if not CONTINUOUS_PAN:
        s = s.union(box(-G.post_r[1], -30.0, -4, 4, z1, z1 + 3.0))                          # stop finger: arm over the pinion
        s = s.union(box(-G.post_r[1], -G.post_r[0], -4, 4, z0, z1 + 3.0))                   # ... and down beside it
    s = s.cut(cyl_z(20.0, z0 - 30, z1 + 1))
    s = s.cut(ring_z(BRG['d'] / 2 + 1, CIRCLIP['d2'] / 2, groove0, cz1))                   # circlip groove
    s = s.cut(ring_z(28.5, BRG['d_land'] / 2, G.brg_z + BRG['B'] - 0.1, G.brg_z + BRG['B'] + 1.0))   # shield relief
    for (x, y) in YOKE_BOLTS:
        s = s.cut(insert_hole(x, y, z1, 'M4'))
    for k in range(6):                                                                      # lightening pockets from below
        a = 30.0 + 60.0 * k
        # outside the shoulder (r 28) by 1 mm: cut from r 23 they notched the shoulder's root, where the side-fall case
        # peaked (FEA: SF 1.12); 1 mm under the yoke's insert pilots
        s = s.cut(sector_z(29.0, 34.0, a - 20.0, a + 20.0, z0 - 0.01, z0 + 7.0))
    hx, hy, hz = HALL['size']
    s = s.cut(box(MAGNET['r'] - hx / 2 - 0.2, MAGNET['r'] + hx / 2 + 0.2, -hy / 2 - 0.2, hy / 2 + 0.2, z0 - 1, z0 + 0.1 + hz))  # hall switch: CA'd up against the pocket's roof
    s = s.cut(cyl_z(1.4, z0, z1 + 1, MAGNET['r'] - 3.5, 0.0))                              # its 3 leads up through
    return s


def pan_spacer(G):
    """Printed PA6-CF thrust ring (100 % solid) between the 61810's inner race and the DIN 471-50 circlip: it slides
    up the journal (Ø50.3 bore), bears on the race only inside Ø52.4 (a 1 mm land) and holds the circlip, whose back
    and lugs reach Ø60.8, 4 mm below the bearing's shield. Print it standing on its wide end."""
    z1 = G.brg_z
    z0 = z1 - SPACER['h']
    s = ring_z(SPACER['r_out'], BRG['d'] / 2 + 0.15, z0, z1 - SPACER['land_h'])
    return s.union(ring_z(BRG['d_land'] / 2, BRG['d'] / 2 + 0.15, z1 - SPACER['land_h'] - 0.01, z1))


YOKE_BOLTS = [(10.0, 28.0), (-10.0, 28.0), (10.0, -28.0), (-10.0, -28.0)]
# sheet stock for the parts ordered from SendCutSend (D40), by their catalogue names
SHEET = {'al6061': {'name': '6061-T6 aluminium', 'thickness_mm': 3.175, 'thickness_in': 0.125, 'density_g_cm3': 2.70,
                    'vendor': 'SendCutSend', 'url': 'https://sendcutsend.com/materials/6061-t6-aluminum/'},
         'al6061_100': {'name': '6061-T6 aluminium', 'thickness_mm': 2.54, 'thickness_in': 0.100, 'density_g_cm3': 2.70,
                        'vendor': 'SendCutSend', 'url': 'https://sendcutsend.com/materials/6061-t6-aluminum/'}}
# the SendCutSend cart (D40, D48): the pan clamp, the cradle's two cheek plates and the hard-stop lug; each with what
# the order adds to the plain cut (tapped holes, countersinks), and which face of the part is its DXF's face
SHEET_PARTS = {'pan_clamp': 'al6061', 'cradle_plate_l': 'al6061', 'cradle_plate_r': 'al6061', 'stop_lug': 'al6061_100'}
SHEET_OPS = {'pan_clamp': 'none',
             'cradle_plate_l': '4 holes countersunk 90 deg to Ø6.4 on the face drawn (the face on the rail; DIN 7991 M3 flat heads)',
             'cradle_plate_r': 'the Ø4.2 hole tapped M5 x 0.8; 2 holes countersunk 90 deg to Ø6.4 on the face drawn (the face on the rail)',
             'stop_lug': '2 holes tapped M3 x 0.5'}
# D48 (docs/turret-next-plan.md 1.3): the cradle is a printed PA6-CF rail frame with two laser-cut cheek plates. Each
# plate is an inverted T in the x-z plane (C frame): a foot on its rail along x -10..80 (10 mm, the rail's depth there)
# with four M3 x 8 button heads into inserts in the rail's 3.2 mm rebate, and a 44 mm cheek up to the Ø44 round at the
# tilt axis. The rebate brings the plate's outer face back to where the printed cheek's was (y +-56.5): 4 mm from the
# yoke's arm, as before. The +y plate carries the tilt servo's horn through a printed boss (horn_boss, 4 x M3 x 14 flat
# heads from the plate's inner face); the -y plate is tapped M5 for the shoulder screw (the printed pivot_spacer and its
# land between the plate and the MR126) and carries the aluminium hard-stop lug on its outer face.
# The plan's 12 mm feet (rails 12 deep there) passed 0.37 mm over the slip ring's rotor-lead bundle where it crosses the
# yoke's bridge (z 89) at full depression: 10 mm keeps 2.3 mm.
PLATE = {'foot_x': (-10.0, 84.0), 'foot_h': 10.0, 'half_w': 22.0, 'rebate': 3.2, 'foot_holes_x': (-3.0, 33.0, 58.0, 77.0),
         'fillet': 5.0, 'csk_d': 6.4, 'horn_screw_l': 14.0, 'rebate_back': 2.5, 'rebate_fillet': 2.0}      # csk: DIN 7991 M3 heads are Ø6.0 (McMaster 91294A, 92125A)
# the hard stop (D48): a 2.54 mm 6061-T6 lug on the -y plate's outer face, 1.5 mm from the yoke's arm. Its stop band
# (+-STOP_HALF_DEG about straight down at tilt 0, r 22.5..32) meets the yoke's two sectors (r 24..32, YOKE_STOP_PROUD off
# the arm's inner face: 1.5 mm onto the lug); its pad (r 11..22.5, +-32 deg) sits inside the sectors' annulus with two
# M3 x 6 flat heads from the plate's inner face into holes tapped in it (and a drop of CA gel). Wider than v0's printed
# lug (+-7.5 deg): the band's root is the lug's weak section, and the sectors moved with it, so the range was still 0..-25 (+12..-25 since D77).
STOP_HALF_DEG = 10.0
YOKE_STOP_PROUD = 3.0
YOKE_ROOT_FILLET = (6.0, 3.0)     # where the arms meet the bridge (D48's FEA): 6 mm, but 3 under the rotor leads ...
YOKE_LEAD_GAP = 6.0               # ... within this of x = 0, where they cross the bridge's top (1.25 mm over the 3 mm fillet)
YOKE_STOP_BUTTRESS = 5.0          # each stop sector's buttress reaches this far past its r 32
YOKE_WINDOW_R = 3.0               # the -y arm's lead window, its corners ...
YOKE_WINDOW_HALF_X = 6.0          # ... and its half width (the rotor-lead bundle is Ø7.5 at x = 0)
LUG = {'band_r': (22.5, 32.0), 'pad_r': (11.0, 22.5), 'pad_half_deg': 32.0, 'screw_r': 17.0, 'screw_deg': 15.0, 'fillet': 1.5,
       'screw_l': 6.0}
# the printed parts between the plates and the yoke: the horn boss (+y, Ø20, the horn's 4 x M3 on Ø14 and its centre
# screw's Ø6.5) and the pivot spacer (-y: a Ø18 boss on the plate and a Ø6.8 x 1 land on the MR126's inner race, the
# shoulder screw's step seated on the land as v0's was on its insert; bore Ø5.3 for the M5 thread)
HORN_BOSS = {'d': 20.0}
PIVOT = {'boss_d': 18.0, 'land_d': 6.8, 'land_h': 1.0, 'bore': 5.3}
CLAMP_EARS = (0.0, 60.0, 120.0, 240.0, 300.0)      # the pan servo stands at 180 deg
CLAMP_T = 3.175                                   # SendCutSend 6061-T6 aluminium, 0.125 in
YOKE_RELIEF = {'r': 35.0, 'h': 1.5, 'chamfer': 3.0}    # the bridge bears on the turntable inside r 35; a cone to 1.5 mm up at r 38
# printed with 4 perimeters, 5 top and bottom layers and 40 % gyroid instead of solid (mass): the pan base's walls are
# all perimeter at that, and its FEA peaks sit in them (cad/turret_studies.py)
PARTIAL_FILL = {'pan_base'}
PINION_FACE = 16.0


def ring_geom(G, model=None):
    """z of the slip ring's flange seat, body top and stub top, and the driver's socket (T frame)."""
    M = RING_MODELS[model or RING_MODEL]
    seat = CARRIER['h'] - CARRIER['flange_seat']
    body0 = seat + M['flange'][1]
    top = body0 + M['body_l'] - M['flange'][1]
    stub_top = top + M['stub'][1]
    drv0 = G.turntable_z[1] - 6.0
    return {'seat': seat, 'body0': body0, 'top': top, 'stub_top': stub_top, 'driver': (drv0, G.turntable_z[1]),
            'socket': (drv0 - 8.0, drv0), 'M': M}


def ring_carrier(G):
    """The slip ring's carrier, printed PA6-CF on its top face (100 % solid): a Ø64.5 x 12 disc in the foot's Ø65
    opening with three tabs that sit flush in pockets under the foot (3 x M3 x 10 flat heads up into the housing
    tube's inserted bosses); a Ø44.6 x 2.6 seat on top for the ring's flange (3 x M3 x 8 with washers into inserts on
    Ø35: measure the ring in hand), a Ø23.1 bore for its body, and a slot from the bore to the side towards -y for the
    stator leads, which climb the housing to its cable window. The head ring (or the stand's top) traps it from
    below once the turret is mounted: the ring is serviced with the turret off its mount."""
    C = CARRIER
    rg = ring_geom(G)
    M = rg['M']
    s = cyl_z(C['r'], 0, C['h'])
    for a in C['tab_angles']:
        s = s.union(sector_z(C['r'] - 1.0, C['tab_r'], a - 12.0, a + 12.0, 0, C['tab_t']))
    s = s.cut(cyl_z(M['flange'][0] / 2 + 0.05, rg['seat'], C['h'] + 1))                        # flange seat
    s = s.cut(cyl_z(C['bore'] / 2, -1, C['h'] + 1))                                          # body / stator leads
    s = s.cut(box(-5.0, 5.0, -C['r'] - 1, 0, 1.5, rg['seat'] - 1.0))                         # stator lead slot to -y
    for k in range(3):
        x, y = polar(M['pcd'] / 2, math.radians(90 + 120 * k))
        s = s.cut(cyl_z(FAST['M3']['insert_pilot'] / 2, rg['seat'] - 6.0, rg['seat'] + 0.1, x, y))     # flange screws
    for a in C['tab_angles']:
        x, y = polar(C['screw_r'], math.radians(a))
        s = s.cut(through_z(x, y, FAST['M3']['clear'], -1, C['tab_t'] + 1))
        s = s.cut(cq.Workplane('XY').circle(3.4).workplane(offset=1.9).circle(1.7).loft().translate((x, y, -0.01)))   # countersink
    for k in range(3):                                                                      # pockets from below, between the
        a = 90 + 120 * k + 60                                                               # flange inserts, off the tabs
        if any(abs(((a - t + 180) % 360) - 180) < 22 for t in C['tab_angles']) or abs(((a - 270 + 180) % 360) - 180) < 25:
            continue
        s = s.cut(sector_z(C['bore'] / 2 + 2.0, C['r'] - 3.0, a - 32, a + 32, -1, rg['seat'] - 2.0))
    return s


def ring_driver(G):
    """The slip ring's driver, printed PA6-CF: a Ø39.6 x 6 disc held in the top of the turntable's Ø40 bore (three
    crush ribs, a drop of CA), a socket under it (Ø7.64 inside, 8 deep) that grips the rubber tube coupling the
    ring's rotor stub (the tube pushed in), and a crescent slot beside it for the rotor leads. It turns the ring's rotor with the
    turntable and never pushes on it: the tube takes the misalignment."""
    rg = ring_geom(G)
    d0, d1 = rg['driver']
    k0, k1 = rg['socket']
    s = cyl_z(19.7, d0, d1)
    for k in range(3):
        s = s.union(cyl_z(0.5, d0, d1, *polar(19.7, math.radians(30 + 120 * k))))             # crush ribs (0.2 mm interference)
    s = s.union(ring_z(7.0, TUBE['socket_d'] / 2, k0, d0 + 0.01))                            # the socket (the tube pushed in)
    s = s.cut(cyl_z(TUBE['socket_d'] / 2, k0 - 1, d1 - 2.0))
    s = s.cut(sector_z(LEADS['r'] - LEADS['d'] / 2 - 0.75, LEADS['r'] + LEADS['d'] / 2 + 0.75, 230.0, 310.0, d0 - 1, d1 + 1))   # the leads' crescent
    return s


# the turret-board bay (docs/turret-plan.md 2.4, 3.3): a PETG tray on the -y yoke arm's outer face holding three
# 52 x 50 boards (perfboard cut to size, Ø3.2 holes drilled at the corners), stacked on M3 standoffs. What sits on each
# is cad/turret_boards.py's (checked there part by part): level 0 (on the tray's bosses) the D24V150F12 12 V regulator
# (43.2 x 31.8 x 11) and the laser's switch; level 1 (on 12 mm standoffs) the Pololu 2815 switch, the D36V28F5 5 V
# regulator, the 2 x 1000 uF bank lying down, the opto and the one-shots; level 2 (on 14 mm standoffs) the Feather M4
# CAN (50.8 x 22.8), the trip latch, the ARM gate and the servo bus buffer. The tray reaches y -118 at x +-29 (r 121.5; 115 until its lid was modelled, when the boards stood 0.8 mm out of it): the tilt servo on the other arm already sweeps r 112, and
# nothing fixed stands above z 69 out there (the pinion's top), so it clears every pan.
TB = {'x': 29.0, 'z': (71.0, 128.0), 'y_out': 118.0, 'wall': 1.2, 'back': 3.0, 'board': (52.0, 50.0, 1.6), 'boss': 5.0,
      'levels': ((13.0, 14.0), (11.0, 12.0), (8.5, None)),        # (tallest part, standoff to the next board) per level
      'screws': ((10.0, 78.0), (-10.0, 78.0), (10.0, 121.0), (-10.0, 121.0)), 'mass_g': 100.0}


def bay_boards(G):
    """The boards' corner holes (x, z) and each board's underside y (T frame), level 0 first."""
    a1 = G.arm_y[1]
    zc = sum(TB['z']) / 2
    bw, bh, bt = TB['board']
    holes = [(sx * (bw / 2 - 3.0), zc + sz * (bh / 2 - 3.0)) for sx in (1, -1) for sz in (1, -1)]
    ys = [-a1 - TB['back'] - TB['boss']]
    for _, gap in TB['levels'][:-1]:
        ys.append(ys[-1] - bt - gap)
    return holes, ys


def board_bay(G):
    """The turret-board bay, printed PETG on its back: a 58 x 57 tray with 1.2 mm walls (TB) out to y -118, screwed to the -y
    yoke arm's outer face with 4 x M3 x 8 flat heads (countersunk in its 3 mm back, into inserts in the arm, beside and
    under the arm's lightening window; fit them before the boards), 4 bosses with M3 inserts for the level-0 board,
    and a window in the back for the ring's rotor leads, which come through the arm's window. The open face takes the
    snap lid (board_bay_lid): a 30 deg ridge on the outside of the top and of the bottom wall, by the rim, catches its
    two latches (bay_ridges; cad/turret_snaps.py). Printed on its back, the open face up, so the ridges stand out of a
    wall that grows upwards: their back faces overhang 30 deg from the vertical, no support."""
    a1 = G.arm_y[1]
    X, (z0, z1), Y, w, t = TB['x'], TB['z'], TB['y_out'], TB['wall'], TB['back']
    s = box(-X, X, -Y, -a1, z0, z1).cut(box(-X + w, X - w, -Y - 1, -a1 - t, z0 + w, z1 - w))
    holes, ys = bay_boards(G)
    y1 = ys[0]
    for (x, z) in holes:
        s = s.union(cyl_y(5.0, y1, -a1 - t + 0.01, x, z))                                  # into the side wall and floor
        s = s.cut(cyl_y(FAST['M3']['insert_pilot'] / 2, y1 - 0.1, y1 + 6.0, x, z))      # 5.7 mm insert: into the back
    for (x, z) in TB['screws']:
        s = s.cut(cyl_y(FAST['M3']['clear'] / 2, -a1 - t - 1, -a1 + 0.1, x, z))
        s = s.cut(cq.Workplane('XZ').circle(3.3).workplane(offset=-1.8).circle(1.7).loft().translate((x, -a1 - t - 0.01, z)))   # countersink
    rl = LEADS['d'] / 2 + 1.5
    s = s.cut(box(-11.0, 11.0, -a1 - t - 1, -a1 + 0.1, LEADS['z_run'] - rl, LEADS['z_run'] + rl))   # the rotor leads come in
    return s.union(bay_ridges(G))


# ---- the snap latches of the two lids (#131): every size in cad/turret_snaps.py, drawn in its (s, n) frame: s past the
# seat plane in the closing direction, n out from the caught wall's outer face (snaps.profile())

def _sn_extrude_x(pts, x0, x1, y_seat, z_wall):
    """An (s, n) polygon on the bay's top wall, extruded along x: y = y_seat + s (the lid closes towards +y), z =
    z_wall + n."""
    return cq.Workplane('YZ', origin=(x0, 0, 0)).polyline([(y_seat + s, z_wall + n) for s, n in pts]).close().extrude(x1 - x0)


def _sn_revolve(pts, a0, a1, r_wall, z_seat):
    """An (s, n) polygon on the hopper's outer wall, revolved about the z axis from a0 to a1 (deg): r = r_wall + n, z =
    z_seat - s (the lid closes downwards)."""
    w = cq.Workplane('XZ').polyline([(r_wall + n, z_seat - s) for s, n in pts]).close().revolve(a1 - a0, (0, 0, 0), (0, 1, 0))
    return w.rotate((0, 0, 0), (0, 0, 1), a0)


def _barb_pts():
    """The barb in (s, n), run 0.5 into the tongue so the two fuse."""
    b = snaps.profile()['barb']
    return b + [(b[-1][0], snaps.TONGUE_N + 0.5), (b[0][0], snaps.TONGUE_N + 0.5)]


def bay_sweep_flip(G, s):
    """The bay's bottom latch and ridge are the top ones turned 180 deg about the bay's axis (y, through x 0 and the
    bay's mid-height): the lid goes on either way up."""
    zc = sum(TB['z']) / 2
    return s.rotate((0, 0, zc), (0, 1, zc), 180.0)


def bay_latch_x(G):
    """The top latch's x extents: the root block's, the tongue's (root face to its free end) and the barb's."""
    B = snaps.BAY
    xr = B['x_root']
    x_tip = xr + B['L'] + B['barb_w'] / 2
    return {'root': (xr - B['root_w'], xr), 'tongue': (xr, x_tip), 'barb': (x_tip - B['barb_w'], x_tip),
            'ridge': (x_tip - B['barb_w'] - B['ridge_extra'], x_tip + B['ridge_extra'])}


def bay_ridges(G):
    """The two ridges on the bay's top and bottom walls that the lid's latches catch (snaps.profile()['ridge'])."""
    Y, z1 = TB['y_out'], TB['z'][1]
    x0, x1 = bay_latch_x(G)['ridge']
    top = _sn_extrude_x(snaps.profile()['ridge'], x0, x1, -Y, z1 - 0.01)
    return top.union(bay_sweep_flip(G, top))


def bay_latch(G):
    """One latch of the bay lid, on its top edge: a tongue h thick (in z) lying in the lid's plane outside the bay's top
    wall, from a root block on the plate's edge along x to a barb that hooks the wall's ridge; the root's inside
    corner rounded to 0.6 h. The tongue bends in z, in the bed plane of the lid's print (along the layers)."""
    B = snaps.BAY
    Y, z1 = TB['y_out'], TB['z'][1]
    xs = bay_latch_x(G)
    s0, s1 = snaps.tongue_s(B)
    zi, zo = z1 + snaps.TONGUE_N, z1 + snaps.TONGUE_N + B['h']
    tongue = box(*xs['tongue'], -Y + s0, -Y + s1, zi, zo)
    zb = zo + B['root_out']
    root = (box(*xs['root'], -Y + s0, -Y, z1 - 1.0, zb)                                # on the plate's edge ...
            .union(box(*xs['root'], -Y - 0.01, -Y + s1, z1 + snaps.WALL_CLEAR, zb)))     # ... and outside the wall
    s = root.union(tongue)
    sm = -Y + (s0 + s1) / 2
    s = s.edges(cq.selectors.NearestToPointSelector((xs['root'][1], sm, zi))).fillet(B['root_r'])
    if B['root_out'] > 0:
        s = s.edges(cq.selectors.NearestToPointSelector((xs['root'][1], sm, zo))).fillet(B['root_r'])
    return s.union(_sn_extrude_x(_barb_pts(), *xs['barb'], -Y, z1))


def hopper_latch_angles(G):
    """Each hopper latch's angles (deg): the root block's start, the root face, the barb's centre and the tongue's free
    end, from its footprint's centre in snaps.HOPPER['centres_deg'] (the tongue runs anticlockwise from its root)."""
    Hs = snaps.HOPPER
    r_mid = G.dial_wall_r + HOPPER_WALL + snaps.TONGUE_N + Hs['h'] / 2
    deg = lambda mm: math.degrees(mm / r_mid)
    span = deg(Hs['root_w'] + Hs['L'] + Hs['barb_w'] / 2)
    out = []
    for c in Hs['centres_deg']:
        a0 = c - span / 2
        root = a0 + deg(Hs['root_w'])
        barb = root + deg(Hs['L'])
        out.append({'start': a0, 'root': root, 'barb': barb, 'end': barb + deg(Hs['barb_w'] / 2),
                    'barb_half': deg(Hs['barb_w'] / 2), 'ridge_half': deg(Hs['barb_w'] / 2 + Hs['ridge_extra'])})
    return out


def hopper_ridges(G):
    """The three ridges on the hopper's outer wall, just under its top edge, that the lid's latches catch. The lid's
    spigot sits 0.1 mm inside the wall over their whole height, so the wall cannot give under a barb."""
    r_w = G.dial_wall_r + HOPPER_WALL
    s = None
    for a in hopper_latch_angles(G):
        r = _sn_revolve([(sv, n - 0.01) for sv, n in snaps.profile()['ridge']], a['barb'] - a['ridge_half'], a['barb'] + a['ridge_half'],
                        r_w, G.hopper_top)
        s = r if s is None else s.union(r)
    return s


def hopper_latch(G, a):
    """One latch of the hopper lid (angles from hopper_latch_angles): a curved tongue h thick (radially) lying in the
    lid's plane outside the hopper's wall, from a root block on the disc's rim round to a barb that hooks the wall's
    ridge; the root's inside corner rounded to 0.6 h. The tongue bends radially, in the bed plane of the lid's print
    (upside down: along the layers)."""
    Hs = snaps.HOPPER
    r_w, z1 = G.dial_wall_r + HOPPER_WALL, G.hopper_top
    s0, s1 = snaps.tongue_s(Hs)
    n_o = snaps.TONGUE_N + Hs['h']
    ri, ro = r_w + snaps.TONGUE_N, r_w + n_o
    tongue = _sn_revolve([(s0, snaps.TONGUE_N), (s1, snaps.TONGUE_N), (s1, n_o), (s0, n_o)], a['root'], a['end'], r_w, z1)
    n_b = n_o + Hs['root_out']
    block = _sn_revolve([(s0, -1.5), (0.0, -1.5), (0.0, snaps.WALL_CLEAR), (s1, snaps.WALL_CLEAR), (s1, n_b), (s0, n_b)],
                        a['start'], a['root'], r_w, z1)
    s = block.union(tongue)
    t, zm = math.radians(a['root']), z1 - (s0 + s1) / 2
    for r in ((ri, ro) if Hs['root_out'] > 0 else (ri,)):
        s = s.edges(cq.selectors.NearestToPointSelector((r * math.cos(t), r * math.sin(t), zm))).fillet(Hs['root_r'])
    return s.union(_sn_revolve(_barb_pts(), a['barb'] - a['barb_half'], a['barb'] + a['barb_half'], r_w, z1))


def hopper_key(G):
    """The hopper lid's rotation key (snaps.KEY): the tab on the lid's spigot and the notch in the hopper's rim it
    drops into, clear by KEY['clear'] round it (cad/turret_snaps.py)."""
    K, z1 = snaps.KEY, G.hopper_top
    tab = box(K['r_in'], K['r_out'], -K['w'] / 2, K['w'] / 2, z1 - K['depth'], z1 + 0.01)
    c = K['clear']
    notch = box(G.dial_wall_r - 0.5, G.dial_wall_r + HOPPER_WALL + 0.5, -K['w'] / 2 - c, K['w'] / 2 + c, z1 - K['depth'] - c, z1 + 0.5)
    turn = lambda s: s.rotate((0, 0, 0), (0, 0, 1), K['deg'])
    return turn(tab), turn(notch)


def _print_pose(s, rot):
    """A part turned by its MADE print rotation and set on the bed: centred on x and y, its underside at z 0."""
    if rot:
        s = s.rotate((0, 0, 0), rot[0], rot[1])
    bb = s.val().BoundingBox()
    return s.translate((-(bb.xmin + bb.xmax) / 2, -(bb.ymin + bb.ymax) / 2, -bb.zmin))


def snap_coupon_regions(G):
    """The pieces of the parents each snap coupon keeps (build frames): one latch of each lid with the plate, spigot
    or pad round it, and the stretch of wall with its ridge. One pair per lid: its latches are copies."""
    a = hopper_latch_angles(G)[0]
    r_w, zs = G.dial_wall_r + HOPPER_WALL, G.hopper_top
    reg = lambda z0, z1: _sn_revolve([(zs - z1, 45.0 - r_w), (zs - z0, 45.0 - r_w), (zs - z0, 60.0 - r_w), (zs - z1, 60.0 - r_w)],
                                     a['start'] - 4.0, a['end'] + 4.0, r_w, zs)
    x = bay_latch_x(G)
    x0, x1 = x['root'][0] - 3.0, x['ridge'][1] + 3.0
    Y, z1 = TB['y_out'], TB['z'][1]
    s_hi = snaps.HOPPER['s_hi']
    return {'hopper_lid': reg(G.hopper_top - s_hi - 1.0, G.hopper_top + snaps.PLATE_T + snaps.LID_LUG_PROUD + 1.0),
            'hopper': reg(G.hopper_top - s_hi - 3.0, G.hopper_top + 0.5),
            'board_bay_lid': box(x0, x1, -Y - 3.0, -Y + snaps.BAY['s_hi'] + 1.0, z1 - 10.0, z1 + 8.0),
            'board_bay': box(x0, x1, -Y - 0.5, -Y + 14.0, z1 - 10.0, z1 + 8.0)}


def snap_coupons(G):
    """A printable coupon per snap (#131), cut from the parent parts (the latch from its lid, the ridge with its wall)
    and turned to the parent's print orientation (MADE), on the bed. Each pair snaps together as the real joint does:
    push it on and pull it off on a scale for the forces at the low and the high bound, cycle it past the expected
    cycles (research/snap-fits/summary.json), and print it in the same filament and settings as the parts.
    summary.json's 'coupon' per lid holds the pass bands (each latch's pull-off between the share of the required
    retention and of the hand limit, its push-on under the hand limit's share), the cycles and what to look for, and
    which way to turn the undercut if a band is missed; research/snap-fits/snaps.py coupon_verdict() reads a
    measurement against them."""
    rot = {m[0]: m[5] for m in MADE}
    parents = {'hopper_lid': hopper_lid, 'hopper': hopper, 'board_bay_lid': board_bay_lid, 'board_bay': board_bay}
    return {f'coupon_{name}': _print_pose(parents[name](G).intersect(region), rot[name])
            for name, region in snap_coupon_regions(G).items()}


TILT_POCKET_DEPTH = SERVO['H'] + SERVO['bump'] + 1.0       # 34.9 (15 until 2026-10-27: the servo stood 19 mm proud)


def board_bay_lid(G, latches=True):
    """The board bay's lid, printed PETG flat (the plate on the bed): a 2 mm plate over the bay's open face with a 1.5 mm
    lip inside its walls, held by two snap latches, one on its top edge and one on its bottom edge (bay_latch;
    cad/turret_snaps.py, checked by cad-agent snapfit in research/snap-fits/): push it on, pull it off by the latches,
    no tool. The same latch turned 180 deg, so it goes on either way up. Behind each ridge a pad on the lip, 4 mm deep,
    backs the bay's 1.2 mm wall, so the wall cannot give under the barb (1.3 mm clear of the boards' envelope).
    latches=False: the lid as it was, for the tests' control."""
    X, (z0, z1), Y, w = TB['x'], TB['z'], TB['y_out'], TB['wall']
    s = box(-X, X, -Y - snaps.PLATE_T, -Y, z0, z1)
    # the lip stood 0.01 mm off the plate until #131 (two solids); latches=False keeps that, as the part was
    lip_y0 = -Y - 0.01 if latches else -Y + 0.01
    lip = box(-X + w, X - w, lip_y0, -Y + 1.5, z0 + w, z1 - w).cut(box(-X + w + 1.5, X - w - 1.5, -Y - 1, -Y + 2.5, z0 + w + 1.5, z1 - w - 1.5))
    s = s.union(lip)
    if latches:
        x0, x1 = bay_latch_x(G)['ridge']
        top = bay_latch(G).union(box(x0, x1, -Y - 0.01, -Y + snaps.BACKING_DEPTH, z1 - w - snaps.BAY_PAD_T, z1 - w))
        s = s.union(top).union(bay_sweep_flip(G, top))
    return s


def tilt_yoke(G):
    """Printed PA6-CF on its back (layers run along the arms): a 12 mm bridge on the turntable (4 x M4) and two 8 mm
    arms up to the tilt axis, a 3 mm fillet where each meets the bridge. +y arm: a pocket for the STS3215 tilt servo on its outer face, the servo's output face
    on four pads round its M2 holes (the rest relieved 1.5 mm for its label band), 4 x M2 x 10 from the arm's inner face
    (heads sunk), its horn through a Ø26 hole; its bus plugs face outwards. -y arm: the MR126 seat on the inner face (a Ø9.4 x 1.3 relief in its floor, so only
    the fixed outer race sits on it, not the inner race that turns with the cradle), a Ø6.5 hole for the ISO 7379
    6 x 12 shoulder screw. The hard stop: two sectors on the -y arm's inner face, 3.0 mm proud, that the cradle's
    aluminium lug (D48) hits at tilt 0 (barrel horizontal; it cannot go above) and at -25 deg. Outside r 37 its underside stands 1.5 mm above the
    turntable's top, so the pan pinion (16 mm face, level with the turntable's top) passes under it."""
    zt = G.tilt_t
    b0, b1 = G.bridge_z
    a0, a1 = G.arm_y
    s = box(-20, 20, -a1, a1, b0, b1)
    for sgn in (1, -1):
        y0, y1 = (a0, a1) if sgn > 0 else (-a1, -a0)
        arm = box(-20, 20, y0, y1, b0, zt).union(cyl_y(20.0, y0, y1, 0, zt))
        s = s.union(arm)
        # a concave fillet where the arm's inner face meets the bridge's top: the 50 N push and the falls peaked in that
        # sharp corner (FEA, with the stresses split by the layers: interlaminar shear at the arm's foot)
        yi = sgn * a0
        r = YOKE_ROOT_FILLET[1]
        s = s.union(box(-20, 20, yi - sgn * r, yi, b1 - 0.01, b1 + r).cut(cyl_x(r, -21, 21, yi - sgn * r, b1 + r)))
        r = YOKE_ROOT_FILLET[0]                                 # the bigger fillet everywhere but under the rotor leads
        for xa, xb in ((-20.0, -YOKE_LEAD_GAP), (YOKE_LEAD_GAP, 20.0)):
            s = s.union(box(xa, xb, yi - sgn * r, yi, b1 - 0.01, b1 + r).cut(cyl_x(r, xa - 1, xb + 1, yi - sgn * r, b1 + r)))
    # tilt servo pocket on the +y arm (servo + 0.3, walls 3): its walls run out over the whole case (the servo's height
    # and its idler bump, TILT_POCKET_DEPTH), so the servo sits in the arm, not on it; only its bus plugs stand out
    W, L, sft = SERVO['W'], SERVO['L'], SERVO['shaft_from_end']
    pocket = box(-W / 2 - 3.3, W / 2 + 3.3, a1, a1 + TILT_POCKET_DEPTH, zt - (L - sft) - 3.3, zt + sft + 3.3)
    s = s.union(pocket).cut(box(-W / 2 - 0.3, W / 2 + 0.3, a1, a1 + TILT_POCKET_DEPTH + 1, zt - (L - sft) - 0.3, zt + sft + 0.3))
    holes = [(sgn * SERVO['holes_x'], zt - d) for sgn in (1, -1) for d in SERVO['holes_out']]
    relief = box(-W / 2 - 0.3, W / 2 + 0.3, a1 - 1.5, a1 + 0.01, zt - (L - sft) - 0.3, zt + sft + 0.3)
    for (x, z) in holes:
        relief = relief.cut(cyl_y(3.0, a1 - 2, a1 + 1, x, z))
    s = s.cut(relief)
    for (x, z) in holes:
        s = s.cut(cyl_y(1.2, a0 - 1, a1 + 1, x, z)).cut(cyl_y(2.1, a0 - 1, a0 + 2.0, x, z))
    # hard stops on the -y arm's inner face; the cradle's aluminium lug (D48) sits at -90 deg at tilt 0 and sweeps to
    # -115 at -25. The sectors stand YOKE_STOP_PROUD (3.0) off the arm: 1.5 mm onto the lug, 1.0 mm from the -y plate
    w = STOP_HALF_DEG
    up_face, low_face = -90 + G.tilt_max + w, -90 + G.tilt_min - w
    # each sector clipped to the arm's width: their far ends overhung the arm's edges (never loaded) and left slivers
    # where the faceted arcs crossed them (zero-volume elements in the FEA mesh)
    clip = box(-20.0, 20.0, -a0 - 1.0, -a0 + YOKE_STOP_PROUD + 1.0, b0, zt + 40.0)
    s = s.union(arc_sector_y(G.stop_r[0], G.stop_r[1], up_face, up_face + 30, -a0, -a0 + YOKE_STOP_PROUD, 0, zt).intersect(clip))
    s = s.union(arc_sector_y(G.stop_r[0], G.stop_r[1], low_face - 30, low_face, -a0, -a0 + YOKE_STOP_PROUD, 0, zt).intersect(clip))
    # behind each stop face a buttress carries the sector's root further out (the push's peak was the interlaminar shear
    # at the root's outer corner beside the stop face); it starts 2 deg behind the face, so the lug's contact is still
    # r 24..32 and the lug never reaches it (1.1 mm at the stop)
    b0r, b1r, off = G.stop_r[1] - 1.0, G.stop_r[1] + YOKE_STOP_BUTTRESS, 2.0
    s = s.union(arc_sector_y(b0r, b1r, up_face + off, up_face + 30, -a0, -a0 + YOKE_STOP_PROUD, 0, zt).intersect(clip))
    s = s.union(arc_sector_y(b0r, b1r, low_face - 30, low_face - off, -a0, -a0 + YOKE_STOP_PROUD, 0, zt).intersect(clip))
    # holes
    # a window in the -y arm for the ring's rotor leads (round-cornered: the side falls peaked at a square corner); the
    # +y arm has none since D48 (nothing passes it, and the +y fall peaked at its window's corner)
    # (12 x 10.5, just round the Ø7.5 bundle: v0's 24 x 14 window left 8 mm of arm each side, and with the stiffer root
    # fillets the side fall and the push peaked at its corners)
    wz0, wz1 = LEADS['z_run'] - LEADS['d'] / 2 - 0.75, LEADS['z_run'] + LEADS['d'] / 2 + 2.25
    s = s.cut(cq.Workplane('XZ', origin=(0, -a0 + 1, 0)).center(0, (wz0 + wz1) / 2).rect(2 * YOKE_WINDOW_HALF_X, wz1 - wz0)
              .extrude(a1 - a0 + 2).edges('|Y').fillet(YOKE_WINDOW_R))
    s = s.cut(cyl_y(13.0, a0 - 1, a1 + 1, 0, zt))                                           # servo horn
    s = s.cut(cyl_y(MR126['D'] / 2, -a0 - MR126['B'], -a0 + 3, 0, zt))                      # MR126 seat (inner face)
    s = s.cut(cyl_y(4.7, -a0 - MR126['B'] - 1.3, -a0 - MR126['B'] + 0.01, 0, zt))          # relief: only the outer race sits
    s = s.cut(cyl_y(3.25, -a1 - 1, -a0, 0, zt))
    rl = LEADS['d'] / 2 + 3.0                                                               # the ring's rotor leads pass here (3 mm clear)
    s = s.cut(box(-rl, rl, -LEADS['r'] - rl, -LEADS['r'] + rl, b0 - 1, b1 + 1))
    # the pinion's top is level with the turntable's (z 69): outside the turntable's gear (r 38 up, where the pinion's
    # teeth reach) the bridge and the arms' feet stand 1.5 mm clear of that plane, so the pinion passes under them at
    # every pan. The relief is a 27 deg cone from r 35 to r 38 (it was three 0.5 mm steps: the E-push case's peak sat
    # in the first step's re-entrant corner, cad/turret_studies.py)
    r0r, hr, ch = YOKE_RELIEF['r'], YOKE_RELIEF['h'], YOKE_RELIEF['chamfer']
    cone = (cq.Workplane('XZ').polyline([(r0r, b0), (r0r + ch, b0 + hr), (110.0, b0 + hr), (110.0, b0 - 1.0), (r0r, b0 - 1.0)])
            .close().revolve(360.0, (0, 0, 0), (0, 1, 0)))
    s = s.cut(cone)
    for (x, z) in TB['screws']:                                                             # the turret-board bay's inserts
        s = s.cut(cyl_y(FAST['M3']['insert_pilot'] / 2, -a1 - 0.1, -a1 + 6.0, x, z))
    for (x, y) in YOKE_BOLTS:
        # the heads sit 6 mm above the bridge's underside, so an M4 x 12 keeps 6 mm (1.5 d) in the turntable's insert and
        # stops 2 mm off its 8 mm pilot's floor (an M4 x 10 kept 4 mm, 1.0 d: #137)
        s = s.cut(through_z(x, y, FAST['M4']['clear'], b0 - 1, b1 + 1)).cut(cyl_z(4.0, b0 + 6.0, b1 + 1, x, y))
    # the CT latch's knurled head (Ø16, under the cradle's rail) swings down past the bridge's front top edge as the
    # cradle depresses: from about -22.9 deg it would cut 1.7 mm into the bridge, short of the -25 deg stop (cad-agent's
    # motion gate, #61). Relieve the bridge by the head's sweep to the stop plus 2 deg, 1 mm clear all round.
    return s.cut(thumb_sweep(G, clear=1.0, to_deg=G.tilt_min - 2.0))




def thumb_solid(G, clear=0.0, round_edge=0.0):
    """The CT latch thumbscrew's head and collar in the tilt (C) frame, each radius grown by clear (mm). round_edge
    fillets the head's bottom edge: with round_edge = clear the grown head still clears the real one by clear there, and
    the notch it sweeps has an R(clear) floor instead of a sharp re-entrant corner (#178 review)."""
    lx, ly = ct_points(G)[1]
    z0r = G.rail_z[0] - RAIL_DEEP['dz']
    hd, hh = THUMB['head']
    cd, ch = THUMB['collar']
    head = cyl_z(hd / 2 + clear, z0r - ch - hh - clear, z0r - ch + 0.01, lx, ly)
    if round_edge:
        head = head.edges('<Z').fillet(round_edge)
    return cyl_z(cd / 2 + clear, z0r - ch, z0r + 0.01, lx, ly).union(head)


def thumb_sweep(G, clear=1.0, to_deg=-27.0, step=1.0):
    """The latch head's swept volume in the pan frame from tilt 0 to to_deg (as Turret.pose_shape poses the tilt frame):
    the union of its poses every step degrees, each grown by clear, the head's bottom edge rounded by clear."""
    t = thumb_solid(G, clear, round_edge=clear).translate((-G.tilt_x, 0, G.path_t))
    n = max(1, math.ceil(abs(to_deg) / step))
    out = None
    for i in range(n + 1):
        a = to_deg * i / n
        p = t.rotate((0, 0, G.tilt_t), (0, 1, G.tilt_t), -a)
        out = p if out is None else out.union(p)
    return out


# ------------------------------------------------------------------------------------------------ tilting parts (C frame)

def cradle(G):
    """The cradle's rail frame (D48), printed PA6-CF flat (100 % solid, no supports): two rails under the cartridge
    joined by a rear cross bar (the latched cartridge ties the front; nothing hangs low at the nose when it tilts), the
    CT interface on the rails as v0 (2 x Ø4 dowel holes, the captive DIN 464 M4 x 12 thumbscrew up from below on an
    O-ring in a counterbore on the rail's top). The laser is on the cartridge now (laser_mount), so no tab. Along the cheek plates' feet (x -10..80) each rail is 10 mm deep and its outer face is rebated 3.2 mm: the
    aluminium plate sits in the rebate on 4 x M3 x 8 button heads into inserts, its outer face where v0's printed cheek
    was; the latch's collar sits in a pocket under the -y rail, 7 mm under its top as before. v0's cheeks, servo hub, pivot boss and hard-stop lug are gone (cradle_plate, stop_lug, horn_boss,
    pivot_spacer): re-solved by stress direction they failed across the layers in every print orientation
    (docs/turret-next-plan.md 1.3), while the frame is loaded in its own plane, along its layers."""
    r0, r1 = G.rail_y
    z0, z1 = G.rail_z
    xr0, xr1 = -(G.housing_r + 2.0), G.socket_x0 - 2.0
    fx0, fx1 = PLATE['foot_x']
    fz0 = G.foot_z[0]
    zb = min(fz0, z0 - RAIL_DEEP['dz']) - 1.0                    # below everything: the through holes start here
    s = None
    for sgn in (1, -1):
        ra, rb = (r0, r1) if sgn > 0 else (-r1, -r0)
        rail = box(xr0, xr1, ra, rb, z0, z1)
        rail = rail.union(box(xr0, RAIL_DEEP['x1'], ra, rb, z0 - RAIL_DEEP['dz'], z0 + 0.01))   # 2 mm deeper behind the front dowel
        rail = rail.union(box(fx0, fx1, ra, rb, fz0, z0 + 0.01))                                # 10 mm deep along the plate's foot
        s = rail if s is None else s.union(rail)
    s = s.union(box(xr0, xr0 + 8, -r1, r1, z0 - RAIL_DEEP['dz'], z1))                          # rear cross bar
    # the plates' rebates (0.3 mm longer than the foot at each end) and their 4 x M3 inserts (PLATE foot_holes_x), put in
    # from the rebate
    p0 = G.plate_y[0]
    zf = (fz0 + z1) / 2
    for sgn in (1, -1):
        ya, yb = (p0, r1 + 1.0) if sgn > 0 else (-r1 - 1.0, -p0)
        # the rebate starts REBATE_BACK behind the plate's rear end, its inner corner rounded there (the rail's root, where
        # the FEA peaked), so the plate's square corner never meets the fillet
        s = s.cut(box(fx0 - PLATE['rebate_back'], fx1 + 0.3, ya, yb, zb, z1 + 1))
        s = _fillet_edge_near(s, (fx0 - PLATE['rebate_back'], sgn * p0, (z0 + z1) / 2), PLATE['rebate_fillet'], sel='|Z')
        for x in PLATE['foot_holes_x']:
            y0, y1 = (p0 - INSERT_M3_SIDE, p0 + 0.1) if sgn > 0 else (-p0 - 0.1, -p0 + INSERT_M3_SIDE)
            s = s.cut(cyl_y(FAST['M3']['insert_pilot'] / 2, y0, y1, x, zf))
    ct_dowels, ct_latch = ct_points(G)
    for (x, y) in ct_dowels:
        s = s.cut(cyl_z(2.0, zb, z1 + 1, x, y))
    s = s.cut(through_z(*ct_latch, FAST['M4']['clear'], zb, z1 + 1))
    s = s.cut(cyl_z(THUMB['oring_seat'][0] / 2, z1 - THUMB['oring_seat'][1], z1 + 1, *ct_latch))      # the captive O-ring
    # under the latch (now at the rail's front, x 91) the rail is made 10 mm deep locally, as in the plate's foot zone
    lx0, ly0 = ct_latch
    s = s.union(box(fx1 - 1.0, xr1, -G.plate_y[0], -r0, G.foot_z[0], z0 + 0.01))     # on from the plate's foot: no neck
    s = s.union(box(fx1 + 0.3, xr1, -r1, -G.plate_y[0] + 0.01, G.foot_z[0], z0 + 0.01))    # (clear of the plate's rebate)
    s = s.cut(through_z(*ct_latch, FAST['M4']['clear'], zb, z1 + 1))
    # a pocket from below keeps its collar's seat
    # 7 mm under the rail's top as in v0 (the M4 x 12 keeps 5 mm in the cartridge's insert), open to the rail's inner side
    lx, ly = ct_latch
    zs = z0 - RAIL_DEEP['dz']
    s = s.cut(cyl_z(THUMB['collar'][0] / 2 + 1.0, zb, zs, lx, ly)).cut(box(lx - THUMB['collar'][0] / 2 - 1.0, lx + THUMB['collar'][0] / 2 + 1.0,
                                                                             ly, -r0 + 1.0, zb, zs))
    # lightening windows in the rails, kept 4 mm clear of every CT hole and off the plates' feet
    holes = ct_dowels + [ct_latch]
    for sgn in (1, -1):
        yc = sgn * (r0 + r1) / 2
        for xa, half in RAIL_WINDOWS:
            win = (xa - half, xa + half, yc - 3, yc + 3)
            if any(win[0] - 6 < hx < win[1] + 6 and abs(hy - yc) < 9 for hx, hy in holes) or (win[0] < fx1 + 4 and win[1] > fx0 - 4):
                continue
            s = s.cut(box(win[0], win[1], win[2], win[3], zb, z1 + 1))
    return s


RAIL_WINDOWS = [(-38.0, 8.0), (2.0, 8.0), (82.0, 4.0)]             # (centre x, half length); C frame
RAIL_DEEP = {'x1': 80.0, 'dz': 2.0}                                 # deeper rails behind the front dowel
INSERT_M3_SIDE = 6.5                                                # an M3 x 5.7 insert's pilot, put in from a side face


def _fillet_edge_near(s, point, r, sel='|Y'):
    """Fillet the one edge parallel to `sel` nearest to `point` (a re-entrant corner of a flat part)."""
    return s.edges(sel).edges(cq.selectors.NearestToPointSelector(point)).fillet(r)


def _csk_y(x, z, y_face, direction, d_head=PLATE['csk_d'], d_hole=FAST['M3']['clear']):
    """A 90 deg countersink for an ISO 10642 flat head, from the face at y_face into the part along `direction` (+1/-1)."""
    h = (d_head - d_hole) / 2
    return cq.Workplane('XY').add(cq.Solid.makeCone(d_head / 2, d_hole / 2, h, cq.Vector(x, y_face - direction * 0.01, z),
                                                    cq.Vector(0, direction, 0)))


def cradle_plate(G, side):
    """One of the cradle's two cheek plates (D48), laser-cut by SendCutSend from 0.125 in (3.175 mm) 6061-T6 (DXF and
    STEP in exports/turret/): an inverted T in the x-z plane, a 90 x 10 foot in its rail's rebate (4 x Ø3.4 for M3 x 8
    button heads into the rail's inserts; it reaches 10 mm short of the rear CT dowel, so the printed rail is never a
    long cantilever) and a 44 mm cheek up to the Ø44 round at the tilt axis (5 mm radii where its edges meet the foot). side +1, the +y plate (cradle_plate_l): the tilt servo's horn, Ø6.5 at the
    axis over its centre screw and 4 x Ø3.4 on Ø14, countersunk 90 deg on the plate's inner face for M3 x 14 flat heads
    through the plate and the printed horn_boss into the horn. side -1 (cradle_plate_r): the pivot, Ø4.2 tapped M5 for
    the ISO 7379 shoulder screw, and 2 x Ø3.4 countersunk on its inner face for the stop lug's M3 x 6 flat heads."""
    xt, zt = G.tilt_x, G.tilt_c
    fx0, fx1 = PLATE['foot_x']
    fz0, fz1 = G.foot_z
    hw = PLATE['half_w']
    p0, p1 = G.plate_y
    ya, yb = (p0, p1) if side > 0 else (-p1, -p0)
    s = box(fx0, fx1, ya, yb, fz0, fz1)
    s = s.union(box(xt - hw, xt + hw, ya, yb, fz1 - 0.01, zt)).union(cyl_y(hw, ya, yb, xt, zt))
    for xe in (xt - hw, xt + hw):                       # where the cheek's edges meet the foot's top
        s = _fillet_edge_near(s, (xe, (ya + yb) / 2, fz1), PLATE['fillet'])
    zf = (fz0 + fz1) / 2
    for x in PLATE['foot_holes_x']:
        s = s.cut(cyl_y(FAST['M3']['clear'] / 2, ya - 1, yb + 1, x, zf))
    inner, inward = (p0, 1) if side > 0 else (-p0, -1)           # the inner face (on the rail) and the way into the plate
    if side > 0:
        s = s.cut(cyl_y(3.25, ya - 1, yb + 1, xt, zt))                                            # over the horn's centre screw
        for k in range(4):
            hx, hz = polar(SERVO['horn_pcd'] / 2, math.pi / 4 + k * math.pi / 2)
            s = s.cut(cyl_y(FAST['M3']['clear'] / 2, ya - 1, yb + 1, xt + hx, zt + hz)).cut(_csk_y(xt + hx, zt + hz, inner, inward))
    else:
        s = s.cut(cyl_y(FAST['M5']['tap'] / 2, ya - 1, yb + 1, xt, zt))                          # tapped M5 by SendCutSend
        for (hx, hz) in lug_screws(G):
            s = s.cut(cyl_y(FAST['M3']['clear'] / 2, ya - 1, yb + 1, hx, hz)).cut(_csk_y(hx, hz, inner, inward))
    return s


def lug_screws(G):
    """The stop lug's two M3 screws (x, z), C frame: on r = LUG['screw_r'] about the tilt axis, +-LUG['screw_deg'] off
    straight down."""
    return [(G.tilt_x + LUG['screw_r'] * math.cos(math.radians(-90 + sg * LUG['screw_deg'])),
             G.tilt_c + LUG['screw_r'] * math.sin(math.radians(-90 + sg * LUG['screw_deg']))) for sg in (-1, 1)]


def stop_lug(G):
    """The hard stop (D48), laser-cut by SendCutSend from 0.100 in (2.54 mm) 6061-T6 with two holes tapped M3: on the
    -y plate's outer face, 1.5 mm from the yoke's arm. Its stop band (r 22.5..32, +-STOP_HALF_DEG about straight down at
    tilt 0) meets the yoke's sectors (r 24..32) at the two stops (G.tilt_max, G.tilt_min), 1.5 mm deep, loaded in its own plane: a push on
    the muzzle puts 262 N on it (50 N x 147 / 28 mm). Its pad (r 11..22.5, +-32 deg) lies inside the sectors' annulus,
    held by 2 x M3 x 6 flat heads from the plate's inner face (and a drop of CA gel). The barrel cannot be pushed above
    level while it is there: it is the kid-safety stop."""
    xt, zt = G.tilt_x, G.tilt_c
    p1 = G.plate_y[1]
    t = SHEET['al6061_100']['thickness_mm']
    y0, y1 = -p1 - t, -p1
    a, b = STOP_HALF_DEG, LUG['pad_half_deg']
    (ri, rm), ro = LUG['pad_r'], LUG['band_r'][1]
    P = lambda r, d: (xt + r * math.cos(math.radians(d)), zt + r * math.sin(math.radians(d)))
    w = (cq.Workplane('XZ', origin=(0, y1, 0)).moveTo(*P(ri, -90 - b)).threePointArc(P(ri, -90), P(ri, -90 + b))
         .lineTo(*P(rm, -90 + b)).threePointArc(P(rm, -90 + (a + b) / 2), P(rm, -90 + a))
         .lineTo(*P(ro, -90 + a)).threePointArc(P(ro, -90), P(ro, -90 - a))
         .lineTo(*P(rm, -90 - a)).threePointArc(P(rm, -90 - (a + b) / 2), P(rm, -90 - b)).close())
    s = w.extrude(y1 - y0)
    for sg in (-1, 1):                                                    # the band's root into the pad
        px, pz = P(rm, -90 + sg * a)
        s = _fillet_edge_near(s, (px, (y0 + y1) / 2, pz), LUG['fillet'])
    for (hx, hz) in lug_screws(G):
        s = s.cut(cyl_y(FAST['M3']['tap'] / 2, y0 - 1, y1 + 1, hx, hz))
    return s


def horn_boss(G):
    """Printed PA6-CF (100 % solid, on an end face): a Ø20 x 9 boss between the +y cheek plate's outer face and the tilt
    servo's horn, with the horn's 4 x Ø3.4 on Ø14 and a Ø6.5 hole over its centre screw. The 4 x M3 x 14 flat heads go
    through the plate and the boss into the horn: 1.8 mm of thread in the horn's 2.5 mm flange (the tip short of the
    servo's face), the heads flush with the plate's inner face, 4.3 mm from the cartridge."""
    xt, zt = G.tilt_x, G.tilt_c
    y0, y1 = G.plate_y[1], G.arm_y[1] - SERVO['horn_t']
    s = cyl_y(HORN_BOSS['d'] / 2, y0, y1, xt, zt).cut(cyl_y(3.25, y0 - 1, y1 + 1, xt, zt))
    for k in range(4):
        hx, hz = polar(SERVO['horn_pcd'] / 2, math.pi / 4 + k * math.pi / 2)
        s = s.cut(cyl_y(FAST['M3']['clear'] / 2, y0 - 1, y1 + 1, xt + hx, zt + hz))
    return s


def pivot_spacer(G):
    """Printed PA6-CF (100 % solid, on its boss face): between the -y cheek plate's outer face and the MR126's inner
    race, a Ø18 boss and a Ø6.8 x 1 land that bears only on the inner race (inside its Ø7.2; the shields 0.3 mm
    clear), bore Ø5.3. The ISO 7379 shoulder screw's step seats on the land, as v0's did on its insert, and its M5 thread
    goes on into the plate's tapped hole: snug, a drop of CA gel on the thread (the shank carries the load; the thread retains it).
    It carries the cradle's -y loads (a side fall) into the bearing."""
    xt, zt = G.tilt_x, G.tilt_c
    yp, yr = -G.plate_y[1], -G.arm_y[0]                    # the plate's outer face, the inner race's face
    yl = yr + PIVOT['land_h']
    s = cyl_y(PIVOT['boss_d'] / 2, yl, yp, xt, zt).union(cyl_y(PIVOT['land_d'] / 2, yr, yl + 0.01, xt, zt))
    return s.cut(cyl_y(PIVOT['bore'] / 2, yr - 1, yp + 1, xt, zt))
# The CT latch is the one part of the interface that holds the cartridge down (the dowels only locate it, a slip fit).
# A push up at the muzzle turns the cartridge nose-up about its base's rear edge: with the latch at x 20 the latch pulled
# 175 N and the rear of the base pressed 125 N on the rails' cross bar for a 50 N push (cradle FEA 0.58); at x 91, ahead
# of the tilt axis, 88 N and 38 N. x 91 keeps its Ø10 boss clear of the right motor's way in from below.
def ct_points(G):
    """The CT interface (cradle <-> cartridge), C frame: two Ø4 x 8 dowels and the M4 captive thumbscrew up through the
    cradle's rail into an insert in the cartridge's base, 6 mm inside the cartridge's sides."""
    yy = G.cage_y - 6.0
    return [(-20.0, yy), (50.0, -yy)], (91.0, -yy)       # the latch at the front (it was x 20, behind the tilt axis)       # the front dowel at x 50 (it was 75: inside the right motor's
    #                                    way in from below, which cadagent's assembly gate found once a boss stood there)


# the CT latch: a DIN 464 knurled thumbscrew M4 x 12 (McMaster 92581A250: head Ø16 x 3.5 on a Ø8 x 6 collar) up through
# the rail into the cartridge's M4 insert, kept in the rail by an O-ring on its thread in a counterbore on the rail's top
THUMB = {'head': (16.0, 3.5), 'collar': (8.0, 6.0), 'l': 12.0, 'oring_seat': (8.6, 2.0), 'mass_g': 4.0}   # O-ring: AS568-006, 9452K14
# the aiming laser on the cartridge's top, over the barrel (it was on a tab at the cradle's front left, which read as a box
# stuck on the side): its holder's foot on the barrel socket's pad (2 x M3 x 10 into inserts), its ring over the barrel
# with the beam 29.5 mm above the bore's axis and on its plane (no sideways parallax); it comes off with the cartridge,
# so the boresight is to the barrel it sits on
LASER_X = (112.0, 132.0)       # the holder's ring (C frame x); the laser from LASER_X[0] - 2
LASER_Y = 0.0
LASER_Z = 29.5
LASER_FOOT = {'x0': 99.0, 'half_w': 12.5, 'screws': ((108.0, 9.0), (108.0, -9.0))}   # y +-9: the heads clear the
#                                                    laser's Ø11 bore (at +-7 the fastener gate found them over its edge)   # x 108: the hex key clears the
#                                                                                     cartridge board's front edge (x 104)
LASER_SCREW = {'d': 3.0, 'l': 6.0, 'mass_g': 0.3,
               'name': '3 x McMaster 93285A115 M3 x 6 nylon-tip set screws (18-8): the laser\'s boresight, in its holder\'s tapped ring'}


def cartridge_body(G):
    """The ball cartridge, printed PA6-CF on its base (100 % solid, 2.5 mm walls): a base plate on the cradle rails
    (CT dowels, thumbscrew insert), the dial housing (its floor carries the feed servo: an STS3215 hanging under it, its
    output face 0.75 mm up in a pocket in the floor's underside (so its horn's top is level with the dial's underside)
    with a relief for its label band, the horn up through a Ø21 hole, 4 x M2 x 6 countersunk from above flush with the
    floor (3.75 mm into the servo); the servo's length runs to the rear and its bus plugs face down
    through the base plate's window; side windows in the housing below the floor), the chute that drops the ball out of
    the dial and turns it forward onto the path, the flywheel cage (two shells round the wheels and the hanging motors; a
    top plate the X2216s screw under, 4 x M3 x 6 each in four radial slots that take the motor's 16/19 cross in any
    quarter turn, a Ø10.5 hole over its shaft's rear end and clip, a slot outboard of each for its leads; four printed
    posts with M3 inserts that carry the cartridge board over the plate (the two ESCs lie on the plate under it); a hole over the hopper's front
    lug for its screw; a Ø37.5 opening in the bottom plate under each wheel, through which a motor goes in with its wheel
    already on), the ball channel and the barrel socket (M3 insert on top)."""
    br, w = G.br, G.wall
    hr = G.housing_r
    fz = G.floor_z
    bz0 = G.base_z0
    fz0 = fz - G.floor_t                                                                    # the floor's underside
    # base plate (windowed) under everything; the window takes the feed servo (its length runs to the rear)
    s = box(-hr - 2.0, G.cage_x1, -G.cage_y, G.cage_y, bz0, bz0 + 3)
    s = s.cut(box(-37, 26, -34, 34, bz0 - 1, bz0 + 4).edges('|Z').fillet(6.0))   # corners rounded: the latch's load
    #                                                                                   peaked at a square one (FEA)
    # dial housing: wall from the base to the top, floor, flange lugs for the hopper
    s = s.union(ring_z(hr, G.dial_wall_r, bz0 + 3, G.housing_top))
    s = s.union(cyl_z(G.dial_wall_r, fz0, fz))
    for a in HOPPER_LUGS:
        lug = cyl_z(5.0, G.housing_top - 6, G.housing_top, *polar(hr + 3.5, math.radians(a)))
        s = s.union(lug.union(box(hr - 1.0, hr + 3.5, -5.0, 5.0, G.housing_top - 6, G.housing_top).rotate((0, 0, 0), (0, 0, 1), a)))
    for sy in (1, -1):
        # side windows, clear of the CT dowel (x -20) and the latch (x +20) under them, their corners rounded (the
        # FEA found the 30 g fall and the recoil peaking at a square corner straight over the latch's insert)
        s = s.cut(box(-11, 11, sy * 20, sy * 60, -5, fz0 - 3).edges('|Y').fillet(3.0))
    # chute and channel walls
    chute = cq.Workplane('XY').add(cq.Solid.makeTorus(G.chute_r, br + w, cq.Vector(G.chute_cx, 0, G.chute_r), cq.Vector(0, 1, 0)))
    quad = box(G.exit_x - br - w - 1, G.chute_cx, -br - w - 1, br + w + 1, -br - w - 1, fz - G.floor_t + 0.5)
    s = s.union(chute.intersect(quad))
    s = s.union(cyl_x(br + w, G.chute_cx, G.socket_x0))
    s = s.union(box(G.exit_x - 4, G.chute_cx, -br - w + 1.5, br + w - 1.5, bz0, 0))        # web under the chute
    # flywheel cage: two shells, plates, socket
    for sy in (1, -1):
        s = s.union(ring_z(G.cav_r + w, G.cav_r, bz0, G.plate_z1, G.wheel_x, sy * G.wheel_y))
    plate = cyl_z(G.cav_r + w, 0, 1, G.wheel_x, G.wheel_y).union(cyl_z(G.cav_r + w, 0, 1, G.wheel_x, -G.wheel_y)) \
        .union(box(G.cage_x0, G.cage_x1, -G.wheel_y, G.wheel_y, 0, 1))
    hop = G.dial_wall_r + HOPPER_WALL + 1.0                                                 # the hopper's outside + 1 mm
    s = s.union(_slab(plate, G.plate_z0, G.plate_z1).cut(cyl_z(hop, G.plate_z0 - 1, G.plate_z1 + 1)))   # not over the hopper
    s = s.union(_slab(plate, bz0, bz0 + 3))
    s = s.union(box(G.cage_x1 - w, G.cage_x1 + 1.5, -br - w - 3, br + w + 3, bz0, br + w + 3))   # front wall
    # the spine (2026-10-28): a 5 mm web on the cage's centre plane from the channel up to the top plate, between the
    # motors' bells and outside the tyres' cavities: D68's recoil (53 N back on each motor at a 105 fps shot) and the
    # nip's squeeze (79 N a tyre) twisted the shells on the chute (FEA layer-aware 0.53); it ties the plate to the base
    lug_x = G.housing_r + 3.5 + 6.0                          # clear of the hopper's front lug and its screw
    s = s.union(box(lug_x, G.cage_x1 - w + 0.01, -CAGE_SPINE_T / 2, CAGE_SPINE_T / 2, 10.0, G.plate_z0 + 0.01))
    s = s.union(box(53.0, lug_x + 0.01, -CAGE_SPINE_T / 2, CAGE_SPINE_T / 2, 10.0, G.housing_top - 1.0))
    for sy in (1, -1):                       # and a web each side from the shell's rear onto the chute (the recoil's peak)
        s = s.union(box(G.cage_x0 - 1.0, G.wheel_x - 8.0, sy * 13.0 - 2.0, sy * 13.0 + 2.0, bz0, G.housing_top - 1.0))
    s = s.union(cyl_x(br + 6.0, G.socket_x0 - 1.5, G.socket_x1))                            # barrel socket
    s = s.union(box(G.socket_x0 + 1, G.socket_x1, -12.5, 12.5, 0, SOCKET_PAD_Z))           # socket pad: set screw, laser foot
    cb = CART_BOARD
    for (x, y) in cb['bosses']:                                                             # posts for the cartridge board
        s = s.union(cyl_z(3.5, G.plate_z1 - 0.01, G.plate_z1 + cb['boss_h'] + cb['standoff'], x, y))
    # cuts: cavities, ball path, mounts
    for sy in (1, -1):
        xw, yw = G.wheel_x, sy * G.wheel_y
        s = s.cut(cyl_z(G.cav_cut, -8.0, G.bell_z0 - 0.5, xw, yw))                         # the tyre and the adapter
        s = s.cut(cyl_z(MOTOR['d'] / 2 + 1.5, G.bell_z0 - 0.6, G.plate_z0, xw, yw))        # the motor (its bell turns)
        s = s.cut(cyl_z(18.5, G.plate_z0 - MOTOR['base_h'] - 1.0, G.plate_z0, xw, yw))     # room for the leads at its base
        s = s.cut(cyl_z(5.25, G.plate_z0 - 1, G.plate_z1 + 1, xw, yw))                    # the shaft's rear end and clip
        for a in (45.0, 135.0, 225.0, 315.0):                                               # 4 x M3: radial slots r 8..9.5
            for r in MOTOR['holes_r']:
                s = s.cut(through_z(xw + r * math.cos(math.radians(a)), yw + r * math.sin(math.radians(a)), FAST['M3']['clear'],
                                    G.plate_z0 - 1, G.plate_z1 + 1))
            slot = box(MOTOR['holes_r'][0], MOTOR['holes_r'][1], -FAST['M3']['clear'] / 2, FAST['M3']['clear'] / 2, G.plate_z0 - 1, G.plate_z1 + 1)
            s = s.cut(slot.rotate((0, 0, 0), (0, 0, 1), a).translate((xw, yw, 0)))
        s = s.cut(box(xw - 4, xw + 4, yw + sy * 14.0, yw + sy * 18.0, G.plate_z0 - 1, G.plate_z1 + 1))   # its leads, outboard
        s = s.cut(cyl_z(G.wheel_d / 2 + 0.75, bz0 - 1, -7.9, xw, yw))                      # a motor + wheel go in here
    for (x, y) in cb['bosses']:
        s = s.cut(insert_hole(x, y, G.plate_z1 + cb['boss_h'] + cb['standoff'], 'M3', 6.0))
    s = s.cut(ball_path(G))
    s = s.cut(cyl_x(G.barrel_od / 2 + 0.1, G.socket_x0, G.socket_x1 + 1))
    s = s.cut(insert_hole(G.socket_x0 + 7, 0, SOCKET_PAD_Z, 'M3', SOCKET_PAD_Z - br))       # the barrel's set screw
    for (x, y) in LASER_FOOT['screws']:                                                     # the laser holder's 2 x M3
        s = s.cut(insert_hole(x, y, SOCKET_PAD_Z, 'M3', 6.5))
    # the feed servo under the floor: the horn's hole, the label band's relief, 4 x M2 countersunk from above
    s = s.cut(cyl_z(10.5, fz0 - 1, fz + 1))
    L_, W_, sft = SERVO['L'], SERVO['W'], SERVO['shaft_from_end']
    s = s.cut(box(-(L_ - sft) - 0.3, sft + 0.3, -W_ / 2 - 0.3, W_ / 2 + 0.3, fz0 - 1, G.feed_face))   # its face, 0.75 up into the floor
    for (x0, x1, y0, y1, z0, z1) in feed_servo_cuts(G):
        s = s.cut(box(x0, x1, y0, y1, z0, z1))
    for (hx, hy) in feed_servo_holes():
        s = s.cut(through_z(hx, hy, 2.4, fz0 - 1, fz + 1))
        s = s.cut(cq.Workplane('XY').circle(1.2).workplane(offset=1.1).circle(2.3).loft().translate((hx, hy, fz - 1.09)))
    ct_dowels, ct_latch = ct_points(G)
    for (x, y) in ct_dowels:                 # a Ø12 x 8 boss over each dowel: the recoil's shear peaked round the
        s = s.union(cyl_z(6.0, bz0 + 2.9, 10.0, x, y))        # holes in the 3 mm plate (FEA E-recoil, 2026-10-28), up into
    #                                                             the shell and the floor (a boss ending at z 0 peaked at its top)
        s = s.cut(cyl_z(2.0, bz0 - 1, bz0 + 2.5, x, y))
    # the latch's boss: the CT's one screw takes the push's, the recoil's and a fall's pull
    s = s.union(cyl_z(5.0, bz0, -7.5, *ct_latch))          # Ø10, under the tyre's cavity (its cut starts at z -8)
    s = s.cut(cyl_z(FAST['M4']['insert_pilot'] / 2, bz0 - 1, -8.5, *ct_latch))            # insert from below, 1 mm cap
    for a in HOPPER_LUGS:
        s = s.cut(insert_hole(*polar(hr + 3.5, math.radians(a)), G.housing_top, 'M3', 6.0))
    return s


HOPPER_LUGS = (45.0, 150.0, 210.0)   # not 0 deg: a lug there sat under the cage's top plate, so the hopper could not
#                                      be lowered onto the housing (cadagent's assembly gate, 2026-10-28)
CAGE_SPINE_T = 5.0             # the cage's centre web (cartridge_body)
HOPPER_WALL = 1.6
SOCKET_PAD_Z = 22.6            # the socket pad's top (C frame): the laser holder's foot sits on it


def feed_servo_holes():
    """The feed servo's four M2 holes in its output face (SERVO: +-10.25 across, 8.30 and 29.00 from the axis towards
    its far end), in the C frame: the servo's axis on the dial axis, its length running to the rear (-x)."""
    return [(-d, sgn * SERVO['holes_x']) for d in SERVO['holes_out'] for sgn in (1, -1)]


def feed_servo_cuts(G):
    """Boxes (x0, x1, y0, y1, z0, z1) cut from the floor's underside for the feed servo's label band (1.1 mm, 13 wide,
    from 12 mm off the axis to 1 mm short of the far end: est), with 0.3 mm to spare."""
    L, s = SERVO['L'], SERVO['shaft_from_end']
    return [(-(L - s - 1.0) - 0.3, -12.0 + 0.3, -6.8, 6.8, G.feed_face - 0.01, G.feed_face + SERVO['band'] + 0.3)]


def _slab(plate, z0, z1):
    """The outline of `plate` (built 0..1 thick, z from 0) as a slab from z0 to z1."""
    face = plate.faces('<Z').val()
    return cq.Workplane('XY').add(cq.Solid.extrudeLinear(face, cq.Vector(0, 0, z1 - z0))).translate((0, 0, z0 - face.Center().z))


def ball_path(G):
    """The ball's free space: from a dial pocket down through the floor, round the chute and along the path to the nip
    at ball + 1.5, then from the nip to the barrel socket at ball + 2.0 (the floor steps down 0.25 mm at the nip, in
    the direction of travel)."""
    br = G.br
    up = cyl_z(br, G.chute_r, G.housing_top, G.exit_x, 0)
    t = cq.Workplane('XY').add(cq.Solid.makeTorus(G.chute_r, br, cq.Vector(G.chute_cx, 0, G.chute_r), cq.Vector(0, 1, 0)))
    quad = box(G.exit_x - br - 1, G.chute_cx, -br - 1, br + 1, -br - 1, G.chute_r)
    return up.union(t.intersect(quad)).union(cyl_x(br, G.chute_cx, G.wheel_x + 0.01)).union(cyl_x(G.br_out, G.wheel_x, G.socket_x0 + 0.5))


def flywheel(G):
    """Flywheel hub, printed PA6-CF (100 % solid) on its top face: a Ø30 x 12 rim for the TPU tyre and a 5.5 mm web whose
    top face sits flat on the X2216's prop-adapter flange (Ø17) under the bell, its bore on the adapter's Ø5 pilot
    (printed Ø4.9 and reamed to 5.00: a close slip fit that centres it), clamped by the adapter's Ø14.8 washer and an M5
    nylon-insert nut in the recess under the web, as a propeller is; the stud's thread starts below the web, so the bore
    rides only the pilot. A 0.5 mm chamfer at the top clears the stud's root. Runout is measured on the motor before the
    tyre goes on (bench test 1.5). The tyre's diameter is the launch speed's hardware ceiling (study 8.3,
    sim/turret_launch.py)."""
    x, y = G.wheel_x, G.wheel_y
    top = G.hub_top                                                     # on the adapter's flange
    web0 = top - MOTOR['pilot'][1]                                      # the web's underside: where the pilot ends
    rr = G.wheel_d / 2 - G.tyre_t                                       # the rim, under the tyre
    s = ring_z(rr, rr - 3.0, -G.tyre_w / 2, G.tyre_w / 2, x, y)
    s = s.union(cyl_z(rr - 2.9, web0, top, x, y))
    s = s.cut(cyl_z(2.45, web0 - 1, top + 1, x, y))
    s = s.cut(cq.Workplane('XY').circle(2.45).workplane(offset=0.51).circle(2.96).loft().translate((x, y, top - 0.5)))
    return s


# the tyre's bore is printed 4 % under the hub's rim and the tyre is BONDED to it (D68: a cyanoacrylate for elastomers,
# Loctite 406 class, on the rim before the tyre is stretched on). At D68's ~15,700 rpm a free TPU ring would grow ~8 %
# in its bore on a 10 MPa TPU (docs/turret-physics.md section 4), twice the stretch, so a stretch fit alone would
# float the tyre (2.4 mm of growth, the crush to 61 %, the fastest ball 113 fps); bonded, the rim holds its bore and the
# face grows 0.05 mm. The set: Ø38 at 40 % crush on this cage (D68, sim/turret_launch.py); every accepted ball at 100 %
# throttle on the trimmed rail stays under 105 fps (sim/turret_launch3d.py ceiling_map), the Hasbro ball leaves at ~97.
TYRE_STRETCH = 0.04
TYRE_SET = (38.0,)


def flywheel_tyre(G):
    """TPU 95A tyre as mounted, Ø38 x 12 (TYRE_SET), 4 mm thick on the hub's Ø30 rim and bonded to it (the assembly; the
    printed blank is flywheel_tyre_print). It crushes the 22.7 mm ball 40 % and keeps 2.5 mm from the cavity's wall."""
    rim = G.wheel_d / 2 - G.tyre_t
    return ring_z(TYRE_SET[0] / 2, rim, -G.tyre_w / 2, G.tyre_w / 2, G.wheel_x, G.wheel_y)


def flywheel_tyre_print(G, d=None):
    """The tyre as printed (TPU 95A, flat on the bed): its bore TYRE_STRETCH under the Ø30 rim, its outside sized so
    that stretched on the rim it is Ø d (TPU is nearly incompressible: the cross-section's area is kept)."""
    d = d or G.wheel_d
    rim = G.wheel_d / 2 - G.tyre_t
    ri = rim * (1 - TYRE_STRETCH)
    ro = math.sqrt((d / 2) ** 2 - rim ** 2 + ri ** 2)
    return ring_z(ro, ri, -G.tyre_w / 2, G.tyre_w / 2, G.wheel_x, G.wheel_y)


PRINT_AS = {'flywheel_tyre': lambda G: flywheel_tyre_print(G, TYRE_SET[0])}   # parts printed in a shape other than the one they have mounted


def dial(G):
    """The feed dial, printed PETG: a shelled Ø50 hub (2 mm rim, 2 mm top, four ribs to a Ø22 boss), 8 spokes 4 mm
    thick that push one ball per pocket round the housing to the exit hole, and a 30 deg cone on top with four fins
    that stir the hopper's pile at every step.
    It sits flat on the feed servo's horn (Ø19.95, its top 0.75 above the floor: the dial's running clearance), a Ø7
    pocket over the horn's centre screw, and 4 x M3 x 8 go down through the boss into the horn's tapped holes (Ø14),
    their heads 5.5 above the horn, put in from the top through Ø6.5 holes in the cone with the hopper off. Each shot steps it 45 deg and stops it with a pocket centred over the exit hole (the servo's zero is
    set so): the ball drops while it stands still, and the hopper's baffle covers that pocket, so it cannot refill.
    Parked there, powered or not, the path is blocked: the pockets either side are on the floor behind a spoke."""
    z0, h = G.dial_z0, G.dial_h
    s = ring_z(G.dial_hub_r, G.dial_hub_r - 2.0, z0, z0 + h).union(cyl_z(G.dial_hub_r, z0 + h - 2, z0 + h))
    s = s.union(cyl_z(11.0, z0, z0 + h))
    for k in range(4):
        s = s.union(box(5.0, G.dial_hub_r - 1.0, -1.25, 1.25, z0, z0 + h).rotate((0, 0, 0), (0, 0, 1), 45 + 90 * k))
    # the hub's cone, 30 deg: the pile's middle rolls out to the pocket ring; four fins on it stir the pile at every
    # step (physics finding 1: with a 100 ms step only 3 of 7 pockets filled under a settled pile). The fins end at
    # r 18, inside the baffle (r 19 up), and slope down outwards to 3.5 mm over the hub's top
    s = s.union(cq.Workplane('XY').circle(G.dial_hub_r).workplane(offset=DIAL_CONE['h']).circle(DIAL_CONE['r_top']).loft()
                .translate((0, 0, z0 + h)))
    for k in range(DIAL_CONE['fins']):
        fin = cq.Workplane('XZ').polyline([(DIAL_CONE['r_top'] - 1.0, z0 + h), (18.0, z0 + h), (18.0, z0 + h + 3.5),
                                           (DIAL_CONE['r_top'] - 1.0, z0 + h + DIAL_CONE['fin_top'])]).close() \
            .extrude(DIAL_CONE['fin_t'] / 2, both=True)
        s = s.union(fin.rotate((0, 0, 0), (0, 0, 1), 22.5 + 90 * k))
    for k in range(G.n_pockets):
        a = (k + 0.5) * 360 / G.n_pockets
        sp = box(G.dial_hub_r - 1, G.dial_wall_r - 0.75, -G.spoke_w / 2, G.spoke_w / 2, z0, z0 + h - 2)
        s = s.union(sp.rotate((0, 0, 0), (0, 0, 1), a))
    horn = G.feed_face + SERVO['horn_t']                                   # the horn's top face: the dial's underside
    s = s.cut(cyl_z(3.5, horn - 1, horn + 4.0))                            # over the horn's centre screw
    top = z0 + h + max(DIAL_CONE['h'], DIAL_CONE['fin_top']) + 1
    seat = horn + 5.5                                                      # M3 x 8: 2.5 mm into the horn's thread
    for k in range(4):                                                     # 45 deg off the fins' lines (clear of them)
        hx, hy = polar(SERVO['horn_pcd'] / 2, math.radians(67.5 + 90 * k))
        s = s.cut(cyl_z(FAST['M3']['clear'] / 2, horn - 1, seat + 0.01, hx, hy)).cut(cyl_z(3.25, seat, top, hx, hy))
    return s


BAFFLE = {'half_deg': 24.0, 'r0': 19.0, 't': 3.0, 'land': 0.5, 'chamfer': 2.5}
DIAL_CONE = {'h': 11.0, 'r_top': 6.0, 'fins': 4, 'fin_t': 2.5, 'fin_top': 24.0}


def baffle(G):
    """The exit baffle: a fixed sector over the dial from Ø38 to the housing wall, +-24 deg about the exit (it covers the
    pocket over the exit hole, +-20.2 deg at the wall, and the spokes either side), its underside at the housing top,
    2.3 mm over a seated ball and 4 mm over the hub. Both edges have a 0.5 mm land and a 45 deg chamfer, so a ball
    resting on a full pocket is lifted off as the pocket goes under, not pinched (the dial reverses to clear jams)."""
    z0 = G.housing_top
    B = BAFFLE
    s = sector_z(B['r0'], G.dial_wall_r + 0.5, -B['half_deg'], B['half_deg'], z0, z0 + B['t'], n=24)
    L = G.dial_wall_r + 2.0
    tri = [(-0.01, z0 + B['land']), (-0.01, z0 + B['t'] + 0.01), (B['chamfer'], z0 + B['t'] + 0.01)]
    for a, side in ((-B['half_deg'], 1.0), (B['half_deg'], -1.0)):
        w = cq.Workplane('YZ').polyline([(side * y, z) for y, z in tri]).close().extrude(L).translate((B['r0'] - 1.0, 0, 0))
        # the chamfer's tangential width grows a little with the radius at a fixed angle: cut it along the edge line
        s = s.cut(w.rotate((0, 0, 0), (0, 0, 1), a))
    return s


def hopper(G):
    """The hopper, printed PETG (translucent, so the balls show): a Ø102 tube from the dial housing to z = 100 in the
    cartridge frame (30 balls with the dial's pockets: sim/turret_feed.py fills it in physics), the exit baffle in its bottom (see baffle()), three lugs
    that screw to the housing (M3), two Ø5 holes for the hopper-full IR beam near the top, and three ridges round the
    outside of its top edge that the lid's latches catch (hopper_ridges; cad/turret_snaps.py), and a notch in its rim at
    the front for the lid's key (hopper_key). Printed standing on its bottom rim and the baffle: the ridges' undersides
    overhang 30 deg from the vertical, no support."""
    r_in, r_out = G.dial_wall_r, G.dial_wall_r + HOPPER_WALL
    z0, z1 = G.housing_top, G.hopper_top
    s = ring_z(r_out, r_in, z0, z1).union(baffle(G))
    for a in HOPPER_LUGS:
        x, y = polar(G.housing_r + 3.5, math.radians(a))
        lug = cyl_z(5.0, z0, z0 + 3, x, y).union(box(r_out - 1.0, G.housing_r + 3.5, -5.0, 5.0, z0, z0 + 3).rotate((0, 0, 0), (0, 0, 1), a))
        s = s.union(lug)
        s = s.cut(through_z(x, y, FAST['M3']['clear'], z0 - 1, z0 + 4))
    s = s.cut(cyl_y(2.5, -r_out - 1, r_out + 1, 0, z1 - 6))
    return s.union(hopper_ridges(G)).cut(hopper_key(G)[1])


def hopper_lid(G, latches=True, key=True):
    """Lid, printed PETG upside down: a 2 mm disc with a spigot into the hopper, a Ø32 fill port where the dock's spout
    pushes the sprung flap open, two hinge lugs for the flap (Ø2 steel pin, torsion spring), and three snap latches
    round the rim (hopper_latch; cad/turret_snaps.py, checked by cad-agent snapfit in research/snap-fits/) that hold it
    on, with the 30 balls behind it, in a fall at the -25 deg tilt stop (not upside down: cad/turret_snaps.py
    load_cases, INVERTED_REASON). Push it on, pull it off by the latches. A tab on the spigot (hopper_key) drops into
    a notch in the hopper's rim, so it goes on one way only, the fill port over the spout. The latches sit at the
    front and 120 deg either side, their tops 2.5 mm below the hinge lugs', so upside down the turret lands on the lugs
    and the flap, never on a latch (snaps.LATCH_DROP); the lid prints on the lugs.
    latches=False: the lid as it was (a slip-fit spigot, nothing holding it), for the tests' control; key=False: no
    tab, for the key's control."""
    z1 = G.hopper_top
    r = G.dial_wall_r + 2.0
    s = cyl_z(r, z1, z1 + 2).union(ring_z(G.dial_wall_r - 0.1, G.dial_wall_r - 2.1, z1 - snaps.BACKING_DEPTH, z1 + 0.01))
    s = s.cut(sector_z(12.0, G.dial_wall_r - 3, 30, 150, z1 - 1, z1 + 1.0)).cut(sector_z(12.0, G.dial_wall_r - 3, 210, 330, z1 - 1, z1 + 1.0))
    s = s.cut(cyl_z(16.0, z1 - 5, z1 + 4, FILL_PORT[0], 0))
    for y in (-12.0, 9.0):
        s = s.union(box(FILL_PORT[0] - 22, FILL_PORT[0] - 16, y, y + 3, z1 + 2 - 0.01, z1 + snaps.PLATE_T + snaps.LID_LUG_PROUD))
    s = s.cut(cyl_y(1.05, -15, 15, FILL_PORT[0] - 19, z1 + 6))
    if latches:
        for a in hopper_latch_angles(G):
            s = s.union(hopper_latch(G, a))
        if key:
            s = s.union(hopper_key(G)[0])
    return s


FILL_PORT = (-20.0, 0.0)


def hopper_flap(G):
    """The fill-port flap, printed PETG: a Ø36 x 2 disc and a hinge knuckle between the lid's lugs."""
    z = G.hopper_top + 3
    s = cyl_z(18.0, z, z + 2, FILL_PORT[0], 0)
    s = s.union(box(FILL_PORT[0] - 21, FILL_PORT[0] - 16, -8.6, 8.6, z, z + 2)).union(cyl_y(3.0, -8.6, 8.6, FILL_PORT[0] - 19, z + 3))
    s = s.cut(cyl_y(1.05, -10, 10, FILL_PORT[0] - 19, z + 3))
    return s


GATES = {'x': (22.0, 82.0), 'hole_d': 3.2, 'slit': (1.0, 2.0)}


def barrel(G):
    """Barrel, printed PETG standing up: Ø30 x 100 with a bore of ball + 2.0 mm (docs/turret-physics.md finding 14), 14 mm
    in the socket (a nylon-tip M3 set screw). Two chronograph gates 60 mm apart, 22 and 82 mm from the shoulder (8 mm
    past the socket, clear of the orange tip; physics section 10): on each, a Ø3.2 pocket from either side for the IR
    emitter (TSAL4400) and the receiver (TEFT4300), stopping 1 mm short of the bore, and a 1 x 2 mm slit through to the
    bore, so the beam the ball cuts is 1 mm wide. The last 15 mm printed in blaze orange (15 U.S.C. 5001)."""
    x0, x1 = G.barrel_x0, G.barrel_x1
    s = cyl_x(G.barrel_od / 2, x0, x1)
    sw, sh = GATES['slit']
    for dx in GATES['x']:
        xg = x0 + dx
        s = s.union(cyl_y(4.5, -G.barrel_od / 2 - 2.5, G.barrel_od / 2 + 2.5, xg, 0))
        for sy in (1, -1):
            y0, y1 = sorted((sy * (G.br_out + 1.0), sy * 30.0))
            s = s.cut(cyl_y(GATES['hole_d'] / 2, y0, y1, xg, 0))
        s = s.cut(box(xg - sw / 2, xg + sw / 2, -G.br_out - 1.1, G.br_out + 1.1, -sh / 2, sh / 2))
    s = s.cut(cyl_x(G.br_out, x0 - 1, x1 + 1))
    return s


def laser_mount(G):
    """Laser holder, printed PETG: a ring round the Ø7 laser over the barrel (Ø11 bore with an O-ring at the back) and
    three M3 boresight screws at 120 deg (tapped), on a foot that sits on the barrel socket's pad on the cartridge's top
    (2 x M3 x 10 down into the pad's inserts). A Ø6 hole through the foot over the barrel's set screw takes the hex key;
    the laser's leads leave the bore's open back towards the cartridge board. It comes off with the cartridge, so the
    boresight is to the barrel it sits on."""
    x0, x1 = LASER_X
    y, z = LASER_Y, LASER_Z
    hw = LASER_FOOT['half_w']
    s = cyl_x(9.0, x0, x1, y, z).union(box(LASER_FOOT['x0'], x0 + 1.0, y - hw, y + hw, SOCKET_PAD_Z, z + 9.0))
    s = s.cut(cyl_x(5.5, LASER_FOOT['x0'] - 1, x1 + 1, y, z))
    for o, d in laser_screw_axes(G):
        s = s.cut(cyl_along(1.25, o, d, -1.0, 7.0))
    for (x, yy) in LASER_FOOT['screws']:
        s = s.cut(through_z(x, yy, FAST['M3']['clear'], SOCKET_PAD_Z - 1, z + 10))
        s = s.cut(cyl_z(3.1, SOCKET_PAD_Z + 6.0, z + 10, x, yy))                     # the M3 x 10 head's counterbore
    s = s.cut(cyl_z(3.0, SOCKET_PAD_Z - 1, z + 10, G.socket_x0 + 7, 0.0))              # hex key to the barrel's set screw
    return s


def laser_screw_axes(G):
    """The three boresight screws' seats on the ring's outside and their inward directions (C frame), at the ring's
    middle, 90 / 210 / 330 deg about the beam (one on top, two below at the sides)."""
    xm = (LASER_X[0] + LASER_X[1]) / 2
    out = []
    for k in range(3):
        th = math.radians(120 * k)                                   # from +z, turning about +x
        u = (0.0, -math.sin(th), math.cos(th))
        out.append(((xm, LASER_Y + 9.0 * u[1], LASER_Z + 9.0 * u[2]), (0.0, -u[1], -u[2])))
    return out


INSERT_M3 = {'od': 4.0, 'minor': 2.5, 'l': 5.7, 'mass_g': 0.358, 'name': 'McMaster 94459A140'}
# the gated screws (cad/turret_gates.py fasteners): socket heads, M3 x 0.5, their seats and lengths (C frame)
GATED_SCREWS = {
    'laser_foot_screws': {'clamps': 'laser_mount', 'into': 'laser_inserts', 'length_mm': 10.0, 'seat_z': SOCKET_PAD_Z + 6.0,
                          'xy': list(LASER_FOOT['screws']), 'key': 'turret_screw_m3x10',
                          'why': 'the laser holder on the barrel socket\'s pad'},
    'hopper_screws': {'clamps': 'hopper', 'into': 'hopper_inserts', 'length_mm': 8.0, 'seat_z': None,
                      'xy': None, 'key': 'turret_screw_m3x8', 'why': 'the hopper\'s three lugs on the housing'},
}


def inserts_m3(points):
    """Heat-set M3 inserts, top flush at each (x, y, z_top), going down: a ring at the pilot's diameter and the
    thread's minor diameter (one compound)."""
    sols = [ring_z(INSERT_M3['od'] / 2, INSERT_M3['minor'] / 2, z - INSERT_M3['l'], z, x, y).val() for x, y, z in points]
    return cq.Workplane('XY').add(cq.Compound.makeCompound(sols))


def cyl_along(r, p, d, t0, t1):
    """A cylinder of radius r on the line p + t d (d a unit vector), from t0 to t1."""
    a = cq.Vector(*p) + cq.Vector(*d) * t0
    return cq.Workplane('XY').add(cq.Solid.makeCylinder(r, t1 - t0, a, cq.Vector(*d)))


def laser_screws(G):
    """The three M3 x 6 nylon-tip set screws (McMaster 93285A115) in the ring's tapped holes, their tips on the laser."""
    r_in = LASER['d'] / 2
    out = []
    for (o, d) in laser_screw_axes(G):
        t0 = 9.0 - r_in - LASER_SCREW['l']                          # its head end 0.5 mm proud of the ring
        out.append(cyl_along(LASER_SCREW['d'] / 2, o, d, t0, t0 + LASER_SCREW['l']).val())
    return cq.Workplane('XY').add(cq.Compound.makeCompound(out))


# ------------------------------------------------------------------------------------------------ the head ring (proposal)

def head_ring_tm(L, G=None):
    """PROPOSED replacement for the ring of build.py head_saddle() so the TM interface of docs/cad-plan.md is met
    (today: Ø114/Ø60 x 6 at bodyTop + 20 with 4 x M4 inserts at (+-28.4, +-28.4), legs at r = 44 on the diagonals).
    Change: Ø132 OD (Ø60 ID kept, so the Ø45 TM hole is clear), 8 mm thick (bodyTop + 20 .. + 28), 4 x M5 inserts on
    80 x 80 (Ø6.4 x 8), 2 x Ø5 H7 holes for 5 x 12 dowel pins at (52, 0) and (0, -52), and the four legs moved to
    (+-40, +-40), Ø16, so the bolt loads go straight down; print it in PA6-CF (it now carries the turret's fall load).
    Robot frame."""
    top = L['bodyTop']
    z0, z1 = top + 20.0, top + 20.0 + SADDLE_T
    s = ring_z(66.0, 30.0, z0, z1)
    for (x, y) in TM_BOLTS:
        s = s.union(cyl_z(8.0, top, z0 + 0.01, x, y))
        s = s.cut(cyl_z(FAST['M5']['insert_pilot'] / 2, z1 - 8.0, z1 + 1, x, y))
    for (x, y) in TM_DOWELS:
        s = s.cut(cyl_z(2.5, z0 - 1, z1 + 1, x, y))
    return s


# ------------------------------------------------------------------------------------------------ bought parts
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
