Valpatel/gyropup/hardware/cad/legs/rs04_lug_checks.py

"""Bounded RS-04 front-lug checks using released cad-agent measurements.

Run on the isolated CAD host, with a private vendor cache; nothing is downloaded:
  python hardware/cad/legs/rs04_lug_checks.py --vendor-root /path/references/vendor --out /new/run --export

This checks the actual printed seats and private manufacturer screw against the
selected manufacturer lug plate. The drawing's guaranteed thread depth is a
separate constraint: a deeper modelled hole does not extend that guarantee.
It preserves the candidate's known support failures. Receipt integrity is not
leg qualification. Declared driver access is limited to the stated fitting step.
"""
from __future__ import annotations

# Support direct-file CLI execution as well as checkout package imports.
if __package__ in (None, ''):
    import sys as _checkout_sys
    from pathlib import Path as _CheckoutPath
    _checkout_sys.path.insert(0, str(_CheckoutPath(__file__).resolve().parents[3]))


import argparse
import hashlib
import json
import math
from pathlib import Path
import sys

from hardware.cad.manufacturing.print_provenance import source_files as cad_source_files

ROOT = (Path(__file__).resolve().parents[3])
sys.path.insert(0, str((ROOT / 'hardware/cad')))
PN = '91290A168'
MIN_ENGAGEMENT_MM = 4.0
DEPTH_RESERVE_MM = 0.5
EXPECTED_INSTANCES = {'leg_front': 10, 'leg_rear': 10, 'dyno': 10, 'coupon_nom': 10}
TOOLKIT_COMMIT = '2ad426943ce2c7232875e105e50810849f9a3e5e'
TOOLKIT_SOURCES = 'c2941322d5f3d000d3777b0047567211d06855861fa5e14229d7d7519fef3ed3'
CONTEXT_FILES = ('tests/hardware/interfaces/test-rs04-lug-stacks.py', 'docs/research/actuator-interfaces.md')
OUTPUT_PARTS = ('hip_frame', 'dyno_lug_plate', 'coupon_frame_ring_nom')
READY_FLAGS = ('physical_fit_verified', 'full_assembly_qualified', 'thread_mating_verified',
               'tool_access_verified', 'manufacturing_tolerance_stack_verified', 'strength_verified')
CONTROL_PENETRATION = {'legacy_counterbore_11': 6.9, 'legacy_dyno_14': 6., 'insufficient_engagement': 3.4}
SUPPORT_FAILURE_INSTANCES = {'leg_front_04', 'leg_front_09', 'leg_rear_03', 'leg_rear_08',
                             'coupon_nom_04', 'coupon_nom_09', 'dyno_02', 'dyno_07'}
SUPPORT_FAILURE_LINES = {'leg_front_04': 2, 'leg_front_09': 6, 'leg_rear_03': 2, 'leg_rear_08': 6,
                         'coupon_nom_04': 2, 'coupon_nom_09': 6, 'dyno_02': 0, 'dyno_07': 4}
RECESS_PROBES = {'native_minus_15': ('dyno_02', -15., 0), 'native_165': ('dyno_07', 165., 4)}
DRIVER_NAME = 'declared_3mm_hex_driver'
DRIVER_ENVELOPE = {'segments': [{'d': 4., 'length': 60.}, {'d': 25., 'length': 80.}], 'start': 'head'}
MEASURED_DRIVER_ENVELOPE = {**DRIVER_ENVELOPE, 'offset_mm': 0., 'swing': None}
DRIVER_STEP = {'order': 1, 'fit': 'motor',
               'note': 'Motor fitting on the separate frame/fixture, before upper links and stop posts are installed'}
PRIVATE_HASHES = {
    'robstride-rs-04/RS04.stp': '92859a1e85a8846881432e193c808fe03a3da49ac18ad201c2d89de1746b9082',
    'robstride-rs-04/RS04User_Manual260713.pdf': '6782bf105cf4cc945142e65356bd7a21a9fc007b008ec3616307956030d72b31',
    f'mcmaster/{PN}/{PN}.step': '8673cceae9ae657b9f1123f3cc019893698c47f39fcc0a5c376aee0c8cc3cf71',
    f'mcmaster/{PN}/{PN}.norm.step': '307eceea05ccd5456991bcac212aec25db6c6462895d8b9b1911f48a2061977a',
    f'mcmaster/{PN}/{PN}.norm.json': '1536c07d3dbb37b1690adeab0e8b6464324c157f7221ea13315b3e0d1f447827',
    f'mcmaster/{PN}/{PN}.page.json': 'b4611ea236efce814835b36b177955b5aaa511fafadf6c0a9dfe43afa55a977b',
}
PRIVATE_FILES = (
    'robstride-rs-04/RS04.stp', 'robstride-rs-04/RS04User_Manual260713.pdf',
    f'mcmaster/{PN}/{PN}.step', f'mcmaster/{PN}/{PN}.norm.step',
    f'mcmaster/{PN}/{PN}.norm.json', f'mcmaster/{PN}/{PN}.page.json',
)
LIMITS = [
    'Only the forty declared front-lug screw instances and the authored dyno hub interface are checked.',
    'The selected manufacturer lug plate is checked; the rest of the motor is not modelled in this bounded assembly.',
    'Fastener material rays sample the head seat, stack, hole and receiver. Features between samples can be missed.',
    'Exact screw-to-printed-part relations are checked. Full screw-to-motor thread mating is not checked.',
    'Four millimetres minimum engagement is a declared geometric screen, not a thread pull-out or torque rating.',
    'The 0.5 mm depth reserve is a nominal design allowance, not a verified manufacturing tolerance stack.',
    'Driver access uses a declared 4 mm diameter x 60 mm shaft and 25 mm diameter x 80 mm handle envelope from the screw head, '
    'at the separate motor-fitting step before upper links and stop posts; no actual tool, socket engagement, hand room or final service path is qualified.',
    'The eight unsupported stack sectors over factory-retainer recesses remain failures; their load-spreading capacity is unqualified.',
    'Physical fit, bearing fits, print shrink, fatigue, strength and operation remain unqualified.',
]


def digest(path):
    return hashlib.sha256(Path(path).read_bytes()).hexdigest()


def instance_names():
    return {f'{group}_{i + 1:02d}' for group, count in EXPECTED_INSTANCES.items() for i in range(count)}


def instance_check_ids(name):
    return {f'fastener:{name}:{kind}' for kind in ('seat', 'stack', 'holes', 'engagement', 'tip', 'length', 'tool')} | {
        f'{name}:printed-relation', f'{name}:drawing-depth'}


def expected_check_ids():
    return set().union(*(instance_check_ids(n) for n in instance_names())) | {
        'instance-coverage', 'dyno-hub-clearance', 'coupon-parent-transform', 'input-stability',
        *(f'control:{n}' for n in CONTROL_PENETRATION), 'control:blocked-driver',
        *(f'factory-recess:{n}' for n in RECESS_PROBES)}


def context_inputs(root=ROOT):
    return {name: digest(Path(root) / name) for name in CONTEXT_FILES}


def validate_receipt(data, directory, root=ROOT):
    """Validate integrity of this explicitly FAILING candidate, never leg qualification.

    This validates the receipt's identity and recorded outcome; it does not rerun CAD.
    A changed accepted source/recipe needs a fresh run, never a re-signed old report.
    """
    root, directory = Path(root), Path(directory)
    inputs = data.get('source_inputs') or {}
    project = inputs.get('project') or {}
    source_files = {p.relative_to(root).as_posix(): digest(p) for p in cad_source_files(root)}
    if not source_files or project.get('files') != source_files or inputs.get('context_files') != context_inputs(root):
        raise ValueError('Source/context closure changed')
    if (inputs.get('private_files') != PRIVATE_HASHES or inputs.get('toolkit_commit') != TOOLKIT_COMMIT
            or project.get('toolkit_sources_sha256') != TOOLKIT_SOURCES
            or project.get('versions', {}).get('cad-agent') != '0.4.2'
            or project.get('GYROPUP_CAD_PARAMS_sha256') is not None):
        raise ValueError('Private/toolkit/parameter identity differs')
    if any(data.get(key) is not False for key in READY_FLAGS):
        raise ValueError('Bounded evidence cannot become readiness')
    if (data.get('assumptions') != LIMITS or data.get('schema') != 'cadagent.gate/1'
            or data.get('gate') != 'rs04-front-lugs'
            or data.get('limits') != {'min_engagement_mm': MIN_ENGAGEMENT_MM,
                                      'nominal_depth_reserve_mm': DEPTH_RESERVE_MM}):
        raise ValueError('Check limits differ')
    top = data.get('checks') or []
    ids = [c.get('id') for c in top]
    if len(ids) != len(set(ids)) or set(ids) != expected_check_ids():
        raise ValueError('Check coverage differs')
    counts = {s: sum(c.get('status') == s for c in top) for s in ('pass', 'warn', 'fail')}
    expected_failures = {f'fastener:{n}:stack' for n in SUPPORT_FAILURE_INSTANCES}
    expected_warnings = {f'fastener:{n}:length' for n in instance_names()}
    if ({c['id'] for c in top if c['status'] == 'fail'} != expected_failures
            or {c['id'] for c in top if c['status'] == 'warn'} != expected_warnings):
        raise ValueError('Known failure/warning membership changed; this is not an engineering approval')
    if (data.get('pass') is not False or sum(counts.values()) != len(top)
            or data.get('counts') != counts or data.get('status') != 'fail'
            or data.get('findings') != [c for c in top if c['status'] != 'pass']):
        raise ValueError('Engineering failure was promoted or summary is inconsistent')
    by_id = {c['id']: c for c in top}
    rows = data.get('instances') or []
    names = [r.get('name') for r in rows]
    if len(names) != len(set(names)) or set(names) != instance_names():
        raise ValueError('Instance coverage differs')
    for row in rows:
        name = row['name']
        measured = row.get('measurement') or {}
        depth = drawing_depth(row.get('toolkit_row', {}).get('grip_mm'),
                              measured.get('screw', {}).get('length_mm'), 5.)
        if (depth['pass'] is not True or row.get('drawing') != depth
                or by_id[f'{name}:drawing-depth'].get('evidence') != depth):
            raise ValueError('Measured drawing-depth evidence differs')
        if (by_id[f'fastener:{name}:length'].get('message') != '7.00 mm of thread modelled, the record says 5'
                or abs(row.get('toolkit_row', {}).get('thread_depth_mm', -1) - 7.) > .001):
            raise ValueError('Modelled-depth versus guaranteed-depth warning changed')
        if name in SUPPORT_FAILURE_LINES:
            failure = by_id[f'fastener:{name}:stack']
            angles = failure.get('evidence', {}).get('angles') or []
            if (not failure.get('message', '').startswith('nothing under printed within 0.05 mm')
                    or len(angles) != 8
                    or [a.get('angle') for a in angles if a.get('ok') is False] != [SUPPORT_FAILURE_LINES[name]]):
                raise ValueError('Known support-sector failure evidence changed')
        tool = measured.get('tool') or {}
        if (tool.get('clear') is not True or tool.get('blocked') != [] or tool.get('error')
                or tool.get('tool') != DRIVER_NAME or tool.get('step') != DRIVER_STEP['order']
                or tool.get('present') != ['printed', 'motor', name]
                or tool.get('envelope') != MEASURED_DRIVER_ENVELOPE or tool.get('start_t_mm') != -4.):
            raise ValueError('Declared driver evidence differs')
    controls = data.get('negative_controls') or {}
    if set(controls) != set(CONTROL_PENETRATION):
        raise ValueError('Negative-control coverage differs')
    for name, penetration in CONTROL_PENETRATION.items():
        row = controls[name]
        cs = row.get('checks') or []
        if len(cs) != len(instance_check_ids(name)) or {c.get('id') for c in cs} != instance_check_ids(name):
            raise ValueError('Negative-control check coverage differs')
        depth = drawing_depth(row.get('toolkit_row', {}).get('grip_mm'),
                              row.get('measurement', {}).get('screw', {}).get('length_mm'), 5.)
        if (row.get('caught') is not True or depth['pass'] is not False or row.get('drawing') != depth
                or abs(depth['nominal_penetration_mm'] - penetration) > .01
                or not any(c['id'] == f'{name}:drawing-depth' and c['status'] == 'fail'
                           and c.get('evidence') == depth for c in cs)):
            raise ValueError('Negative-control measured failure lost')
    driver = data.get('driver_approach') or {}
    blocked = driver.get('blocked_control') or {}
    block_evidence = blocked.get('tool') or {}
    if (driver.get('name') != DRIVER_NAME or driver.get('envelope') != DRIVER_ENVELOPE
            or driver.get('step') != DRIVER_STEP or blocked.get('caught') is not True
            or blocked.get('check', {}).get('id') != 'negative:blocked-driver'
            or blocked.get('check', {}).get('status') != 'fail'
            or block_evidence.get('clear') is not False or block_evidence.get('error')
            or not any(r.get('part') == 'blocked_driver_path' and r.get('state') in ('overlapping', 'contains')
                       for r in block_evidence.get('blocked', []))):
        raise ValueError('Driver blocked-path control missing or changed')
    recesses = data.get('factory_recesses') or {}
    if set(recesses) != set(RECESS_PROBES):
        raise ValueError('Factory-recess evidence coverage differs')
    for key, record in recesses.items():
        if (record.get('source_step_sha256') != PRIVATE_HASHES[PRIVATE_FILES[0]]
                or by_id[f'factory-recess:{key}'].get('evidence') != record
                or record.get('representative_instance') != RECESS_PROBES[key][0]
                or not isinstance(record.get('factory_fastener_sha256'), str)
                or len(record['factory_fastener_sha256']) != 64
                or any(c not in '0123456789abcdef' for c in record['factory_fastener_sha256'])
                or abs(record.get('factory_head_z_mm', -1) - 24.79) > .001
                or abs(record.get('factory_head_recess_mm', -1) - .21) > .001):
            raise ValueError('Factory-retainer identity or recess changed')
        if set(record.get('candidate_shapes', {})) != {data.get('manufacturer_lug_plate', {}).get('sha256'),
                                                      record['factory_fastener_sha256']}:
            raise ValueError('Factory-recess candidate membership changed')
        rays = record.get('rays') or []
        if [r.get('radius_mm') for r in rays] != [2.45, 2.825, 3.2]:
            raise ValueError('Factory-recess ray coverage differs')
        for ray in rays:
            intervals = ray.get('material_intervals_t_from_z26') or {}
            starts = [span[0] for spans in intervals.values() for span in spans]
            if (not starts or record['factory_fastener_sha256'] not in intervals
                    or set(intervals) - set(record.get('candidate_shapes', {}))
                    or abs((min(starts) - 1.) - .21) > .001
                    or abs(ray.get('nearest_material_gap_mm', -1) - (min(starts) - 1.)) > 1e-6):
                raise ValueError('Factory-recess measured gap changed')
    artifacts = data.get('artifacts') or {}
    if set(artifacts) != set(OUTPUT_PARTS) or any(set(r.get('files', {})) != {'step', 'stl'} for r in artifacts.values()):
        raise ValueError('Artifact binding incomplete')
    for name, row in artifacts.items():
        mesh = row.get('stl_check') or {}
        if mesh.get('cad_valid') is not True or mesh.get('watertight') is not True or mesh.get('solid_count') != 1:
            raise ValueError('Invalid exported part receipt')
        for ext, expected in row['files'].items():
            path = directory / f'{name}.{ext}'
            if not path.is_file() or digest(path) != expected:
                raise ValueError('Public artifact changed')
    return True


def private_inputs(vendor_root):
    """Preflight the complete input set before importing a CAD kernel; never substitute envelopes."""
    vendor_root = Path(vendor_root)
    missing = [name for name in PRIVATE_FILES if not (vendor_root / name).is_file()]
    if missing:
        raise FileNotFoundError('Missing private inputs: ' + ', '.join(missing))
    return {name: digest(vendor_root / name) for name in PRIVATE_FILES}


def drawing_depth(grip_mm, length_mm, guaranteed_depth_mm, *, minimum=MIN_ENGAGEMENT_MM,
                  reserve=DEPTH_RESERVE_MM):
    """A drawing constraint on *measured* geometry, also usable in kernel-free controls."""
    values = (grip_mm, length_mm, guaranteed_depth_mm, minimum, reserve)
    if any(type(v) not in (int, float) or not math.isfinite(v) for v in values):
        raise ValueError('Finite measured grip, length and drawing limits are required')
    if min(grip_mm, length_mm, guaranteed_depth_mm, minimum) <= 0 or reserve < 0:
        raise ValueError('Invalid measured grip, length or drawing limits')
    penetration = length_mm - grip_mm
    remaining = guaranteed_depth_mm - penetration
    return {'pass': penetration >= minimum - 1e-6 and remaining >= reserve - 1e-6,
            'measured_grip_mm': grip_mm, 'measured_screw_length_mm': length_mm,
            'nominal_penetration_mm': round(penetration, 6),
            'guaranteed_thread_depth_mm': guaranteed_depth_mm,
            'remaining_guaranteed_depth_mm': round(remaining, 6),
            'minimum_engagement_mm': minimum, 'required_nominal_depth_reserve_mm': reserve,
            'basis': 'catalog/interfaces.json: robstride-rs-04.case.bolts.depth; drawing front face 5 Min'}


def _valid(shape, label):
    s = shape.val() if hasattr(shape, 'val') else shape
    if not s.isValid() or len(s.Solids()) != 1 or not math.isfinite(s.Volume()) or s.Volume() <= 0:
        raise ValueError(f'{label}: expected one valid nonempty solid')
    return s
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
