Valpatel/gyropup/(commit log)

2026-10-26 Catalogs, research, default design and the designer's model
    - catalog/: leg actuators, wheel motors, drivers, power and electronics, sensors and compute (273 items,
    each with price, date checked and sources); materials.json built from the cited filament data
    - research/: actuators, wheels, power, sensors, fabrication, toolchain prior art
    - designs/default.json: RS-03 legs, BotWheel + moteus n1, 7S Molicel pack, VN-100 + Teensy 4.1 balance
    loop, VLP-16 + two D435, J501 AGX Orin box
    - designer/model.js: any part in any slot, wheel size from the motor's own tyre, speeds scaled to the bus
    voltage, estimated masses labelled; tools/derive.mjs runs it from the command line
    - tools/check_catal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
    [motor_drivers.json, wheel_motors.json]
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2026-10-26 Rename the robot and repo to Gyropup
    wobbit.com was taken; Gyropup (gyro: it balances itself; pup: a small robot pet) was picked from a
    shortlist whose .com domains were unregistered. README updated to the current sensor set.
    [wheel_motors.json]
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2026-10-26 Fix 3D flicker and replay judder; product images on the designer cards
    - Flicker: tight camera near/far range (depth precision), shadow normal bias, and no near-coplanar
    surfaces (hip motors off the body, hub/tyre/spokes separated, eye bezel proud, tray inset), in the 3D
    page and the MuJoCo visuals
    - Judder: replays blend between the recorded 30 fps physics frames (positions, joints, quaternion)
    - tools/fetch_part_images.py: a product photo per catalog part from the pages it already cites
    (internal use), Amazon product images instead of promo banners, shared banners rejected; cards
    show the photo or a category icon
    [model.py, sim.js]
2026-10-26 Fully dynamic 3D Gyropup with turret, darts and fields of view; FLEXVOLT 40 V is the default
    - 3D model on the design page (replaces the 2D drawing), rebuilt as parts change: body sized to the
    compute box, battery tray sized to the pack(s) with the packs shown, cameras and motor drivers at catalog
    size, leg motors and wheels from their specs, removable turret on the head
    - Simulator: turret with pan/tilt (never above horizontal), FIRE / BURST 8 / RELOAD, 24-dart magazine,
    darts flying at the 24 m/s cap; replays fire at the recoil scenario's shot times; sensor fields of view
    (RealSense pyramids, VLP-16 band) from the catalog
    - Brighter lighting, full-width layouts
    - Default battery: t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
    [model.js, scenarios.py, sim.js]
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2026-10-26 Printed parts in CAD, one 60 V FLEXVOLT as the default, knock-down range, voice and sound
    CAD (cad/build.py, rev 0.1): tray hanging from the J501 standoffs, hip yokes, thighs, shins with knee bearings and
    BotWheel flange, knee cranks and push-rods (four-bar), head saddle, face, camera cradles, lidar hanger. All valid,
    watertight and on the P1S bed; STEP/STL and an assembly with bought-part envelopes in exports/. CAD masses feed
    sim/model.py (17.55 kg; reconciles with the designer plus the CAD delta).
    Power (D25): designs/default.json is one FLEXVOLT in 60 V mode with Flipsky 75100 wheel drivers, DDR-30L-12 and
    DDR-120C-24 converters and an assumed 58 V regen clamp; the 2x20 V build moved to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
    [asm_battery_1.step, asm_camera_cradle_front.step, asm_camera_cradle_rear.step, asm_camera_front.step, asm_camera_rear.step, asm_face.step, asm_head_saddle.step, asm_hip_motor_l.step]
2026-10-26 A tail: RS-06 lift, RS-00 wag, carbon arm, TPU skid shoe and a fail-safe ratchet (D28); Beni as a reference (D29)
    Instead of a third wheel-leg, Gyropup gets a tail (not driven). In simulation:
    - sits on it (2.4 N·m on the lift motor, then parked on the ratchet) and stands up again
    - catches a backward shove of 2.0 m/s per kg (1.2 without the tail), sits, and gets back up
    - e-stop is a controlled stop: sit, engage the ratchet, cut every motor; the lidar stays 80 mm off the ground
    - wags while balancing (8 N·m peak on the wag motor)
    RS-02/RS-00 lift motors manage everything but the hardest catch, so the RS-06 stays. The ratchet sees at most 43 N·m.
    Controller modes (balance, sitting_down,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
    [asm_battery_1.step, asm_camera_cradle_front.step, asm_camera_cradle_rear.step, asm_camera_front.step, asm_camera_rear.step, asm_face.step, asm_head_saddle.step, asm_hip_motor_l.step]
2026-10-26 RL: train Gyropup's balance-and-drive policy with mjlab (PPO on MuJoCo Warp), export ONNX
    Built on mjlab_upkie (Apache-2.0, vendored with its licence). Any design file can be trained; the model comes from
    sim/model.py. Run 2 on designs/default.json (18.96 kg, one 60 V FLEXVOLT): 3000 iterations in 36.5 min on an
    RTX 3080; balances within ~100 iterations, tracks commands by ~300. Drive course without falls (speed error
    0.018 m/s, yaw 0.028 rad/s), the same in plain CPU MuJoCo with the ONNX policy, and still upright with 40 ms of
    command delay. Flat ground and one standing height so far; retrain when the design changes.
    [robot.xml]
2026-10-26 Real mechanical design on a modular interface standard; tail removed; launcher study
    Mechanical design (D31, docs/mechanical-interfaces.md):
    - GMI standard faces: each motor gets an output adapter (dowels into the output, a Ø60 journal, the standard face)
    and a motor plate (its lug pattern and spigot, a 61812 support bearing, standard post/bracket holes); built from the
    vendors' drawings (catalog/interfaces.json, research/actuator-interfaces.md) for RS-03, RS-04, RS-06, RS-00,
    CubeMars AK70-10 and Damiao J10010 alike
    - leg module (cad/leg.py): yoke closed by three posts, 6061 box thigh and shin with the cables inside, knee crank and
    push-rod, wheel adapter; no clashes from full crou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
    [asm_battery_1.step, asm_battery_cradle.step, asm_camera_cradle.step, asm_camera_cradle_front.step, asm_camera_cradle_rear.step, asm_camera_front.step, asm_camera_rear.step, asm_chassis.step]
2026-10-26 Simulator shows the real CAD: per-link meshes from cad/build.py posed by the physics joints
    cad/build.py exports every part's mesh grouped by the link it moves with (exports/links/: body, thigh, shin, wheel,
    crank, push-rod; left leg, mirrored for the right). designer/cadrig.js nests them at their pivots and poses them from
    the joint angles: the crank turns by hip + knee and the push-rod rides on the crank pin parallel to the thigh. The
    3D page uses it whenever the CAD was built from the design on screen, in place of the procedural tray, motors and
    legs. The summary shows the physics model's mass (with the CAD parts).
    [asm_battery_1.step, asm_battery_cradle.step, asm_camera_cradle.step, asm_camera_cradle_rear.step, asm_camera_front.step, asm_camera_rear.step, asm_chassis.step, asm_face.step]
2026-10-26 Overnight design loop: Optuna over motors and dimensions, every candidate built and checked end to end
    tools/iterate.py searches the in-stock 60 V leg actuators (RobStride RS-03/04/06, catalog/availability.json), link
    lengths, the thigh and shin box sections, the yoke and the crank radius; tools/trial_eval.py builds and checks each
    candidate in its own folder (GYROPUP_EXPORTS, GYROPUP_CAD_PARAMS): designer checks, CAD (build --fast), clashes
    from crouch to stand, the nine physics scenarios on that CAD's model, stiffness and strength under its own loads and
    the design floor, cable routes. Objective: the lightest passing robot; cost breaks ties; out-of-stock parts penalised.
    About 4.5 min per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
    [cables.py, leg.py, model.py]
2026-10-26 Designer modules load in older node (type: module); trial_eval records a crashed stage as the candidate's failure
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2026-10-26 Independent mechanical review (Fable 5.1) and the staged CAD plan for robot + turret
    research/mech-review-2026-10-25.md: blockers (the knee parallelogram's dead point sits in the working range; the
    physics treats the coaxial knee as a serial joint, so hip motor loads are wrong; legs, lidar and cameras have no
    collision), majors (6.9 kg of made parts, no head load path, no battery door, docking vs lidar, pinch points, weather,
    60 V pack at the RS-03 limit), and what to keep. docs/cad-plan.md: architecture, part trees, GMI v0.3 faces, stages
    S0-S7 with pass criteria, simulator changes, the overnight loop spec and open questions.
2026-10-26 S0 of the CAD plan: knee lever out of the dead point, the knee motor as it really drives, falls/kerb/landing, rod and fall studies
    - knee: crank and shin lever parallel at -75° (towards the foot), crank 60 mm, M8 rod ends, 14 mm rod; the rod's
    transmission sin stays >= 0.545 over the 48-155° knee range (was 0.005 with the old perpendicular lever)
    - physics: the knee motor drives hip + knee through a fixed tendon (its rotor inertia on that motion); the controller
    turns joint torques into motor torques (hip motor = Q_hip - Q_knee) and clips each on its own speed. The hip motor
    now shows its real load: 97 % of peak in target practice at 22.3 kg (the loop's hard limit is 95 %)
    - collisio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
    [asm_battery_1.step, asm_battery_cradle.step, asm_camera_cradle.step, asm_camera_cradle_rear.step, asm_camera_front.step, asm_camera_rear.step, asm_chassis.step, asm_face.step]
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2026-10-26 Yoke as a bent hat channel (496 g, was 961 g): deck, deep side flanges gusseted to a wall flange, drop plates
    The optimiser varies sheet thickness, flange depth and gusset length. The yoke's wall flange is now held over its
    contact face as well as its bolts (a bolted flange in compression): SF 5.4, 4.4 in falls (0.79 with bolts only: the
    truth lies between; the bench test measures it). Robot 21.4 kg (was 22.3), track 578 mm, 14/14 scenarios, minimum
    safety factor 2.17 everyday, 1.5 in falls.
    [asm_battery_1.step, asm_battery_cradle.step, asm_camera_cradle.step, asm_camera_cradle_rear.step, asm_camera_front.step, asm_camera_rear.step, asm_chassis.step, asm_face.step]
2026-10-26 Lighter motor plates (344 g, was 418: ring pockets, tab window; SF 2.46) and a yoke as wide as its motors
    The yoke's side flanges now clear the bigger motor and the plates' rings and tabs (the RS-04, 120 mm across, used to
    cut into the 110 mm yoke: half the optimiser's candidates failed on that). Both motors clash-free at the deepest yoke.
    [gmi.py, leg.py]
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2026-10-26 Printed robot (D33): PA6-CF structure, RS-04 legs capped at 60 N·m, breaking videos and a Progress page
    - every made part printed: PA6-CF for structure (100 % solid where the CAD has walls), PETG otherwise, TPU guard;
    inserts and through-bolts, bearings line-to-line with screwed retainers, M8 threaded-rod push-rod
    - sized for plastic: bigger thigh flaring into its hub, solid shin foot, no pockets or windows, plate shoulders
    without notches, taller tabs so the yoke screws clear every edge
    - strength in humid PA6-CF allowables per print orientation; every case writes an overload video; a motor
    output joint check (screw clamp + pins: SF 3.2 at the cap); verdict names the weakest part
    - R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
    [asm_battery_1.step, asm_battery_cradle.step, asm_camera_cradle.step, asm_camera_cradle_rear.step, asm_camera_front.step, asm_camera_rear.step, asm_chassis.step, asm_face.step]
2026-10-26 Body levelling by leg height (no hip ab/adduction) and a one-wheel-on-a-plank scenario
    The controller integrates body roll into a left/right leg-height difference (shorter on the high side), as DDT
    Diablo does. side_kerb: the left wheel climbs a 30 mm plank, rides it and drops off; pass needs the body level to
    2.5° rms on the plank: 0.14° (2.7° without levelling). 15/15 scenarios pass. Progress page updated.
    [scenarios.py]
2026-10-26 Print plan: fit each part by turning its real outline on the bed (2° steps), not its bounding box
    The shin's side lever made its box too big at 45°: the loop rejected every shin over 200 mm. A 240 mm thigh and
    shin fit turned.
2026-10-26 Design loop: coarse-mesh strength first, fine mesh only for candidates within 15 % of a target
    Each candidate spent ~28 min in FEA at 3.5 mm with 8 running at once; the 5 mm mesh is ~3x faster but ~10 % off,
    so it only decides clear passes and failures.
2026-10-26 The whole robot in one assembly: every part placed, weighed and shown; an electronics bay; real parts for the placeholders
    - cad/assembly.py: every made, bought and electronic part on the link it moves with, with mass, centre of mass and
    inertia from its geometry (printed from volume, bought at catalogue mass over its CAD); exports/assembly.json
    - sim/model.py takes every link's inertial and the parts' meshes from it: the physics weighs and draws exactly what
    the CAD holds (25.2 kg with the turret's budget; the designer had estimated 20.4)
    - cad/electronics.py: the power electronics did not fit the tub (the 24 V converter alone is 125 mm tall); a printed
    front bay (138 mm, PETG) holds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
    [asm_battery_1.step, asm_battery_cradle.step, asm_camera_cradle.step, asm_camera_cradle_rear.step, asm_camera_front.step, asm_camera_rear.step, asm_chassis.step, asm_electronics_bay.step]
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2026-10-26 Real turret CAD, McMaster-ready CAD fixes, interactive strength viewer, and a thigh sized for plastic
    - cad/turret.py: the foam-ball turret, every part printed (16 parts, 744 g; 1.38 kg loaded): 61810 pan on a 63/21
    ring gear (STS3215), tilt yoke with hard stops at 0 and -25 deg (never above horizontal), cradle + cartridge with a
    30-ball hopper, 8-pocket dial (M2006), chute, twin Snail flywheels, barrel, laser; clash-free over pan/tilt.
    head_saddle carries its TM ring (4 x M5 inserts on 80 x 80, PA6-CF). In the assembly on pan/tilt links; the
    physics takes them (joints, muzzle, tilt range from the CAD); the 3D page shows the CAD turret
    - fixes the McMaster parts called for: knee pin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
    [asm_barrel.step, asm_battery_1.step, asm_battery_cradle.step, asm_bumper_ring.step, asm_camera_cradle.step, asm_camera_cradle_rear.step, asm_camera_front.step, asm_camera_rear.step]
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2026-10-27 One design: the parts explorer, variants and optimiser leave this repo
    Gyropup is now one robot (D36). Removed: the choose-your-own-adventure designer pages,
    the results/comparison page, the five design variants, the overnight optimiser loop
    (iterate, trial evaluation, the 4090 mirror, design summaries, catalogue and material
    tools), the 305 alternative catalogue parts and their product images, the vendor files of
    motors we do not use, and the old leg's explainer. The catalogue keeps what the design and
    the turret use plus the McMaster hardware. No e-stop button or contactor on the robot
    (D37). Everything is kept at the tag explorer-snapshot-2026-10-26; a generic comparison
    framework for cad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
    [motor_drivers.json, wheel_motors.json]
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2026-10-27 Leg v2: a five-bar with both RS-04s in the body; the turret on a bench stand
    The leg (D38): two RS-04s 150 mm apart in one printed hip frame on 61812 support bearings,
    150 mm upper links and 250 mm lower links meeting at the wheel's axle, chosen by a sweep of
    330 printable geometries (tools/leg_synthesis.py: 467 N of push anywhere at the 60 N m cap,
    every joint 33 deg or more from a dead point). The wheel link sits next to the wheel (its
    out-of-plane lever 37 mm), carries the BotWheel in its outer face and a hollow hub; the
    front link rides that hub on two 61812s 28 mm apart, so the apex carries moment and both
    sides of the loop share the wheel's sideways load. 6201 knees on 12 mm shoulder s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
    [stand_bottom.step, stand_bottom.stl, stand_box.step, stand_box.stl]
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2026-10-27 Turret: pan and tilt bearing seats fixed from the McMaster review
    The DIN 471-50 circlip's back (b 5.1) and lugs (a 6.9, DIN 471:2011) reach Ø60.8, past
    the shielded 6810's inner-race land (NSK abutment: da 52..52.5), and the journal ran only
    2.85 mm past the groove (DIN 471 asks n >= 4.5 on steel). Now a printed pan_spacer bears
    on the inner race inside Ø52.4 and holds the circlip 4 mm below the bearing, the journal
    runs 6 mm past the groove, and the turntable's shoulder is relieved 1 mm beyond Ø52.4.
    The tilt yoke's MR126 seat gets a Ø9.4 x 1 relief so the inner race that turns with the
    cradle no longer rubs its floor, and the cradle's spacer shrinks to Ø6.8 to stay on the
    inner race.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
    [turret.py]
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2026-10-27 Turret: drawn to the real bought parts, balanced nose-up, a baffle against double feeds
    The bought parts now follow the makers' drawings (references/vendor/*/SOURCE.txt): the Snail
    2305 hangs on its 16/19 M3 cross and its wheel bolts to the bell's seat (3 x M2 + 2 pins on
    Ø10.3) instead of a grub screw on a round shaft; the M2006 P36 is 47.8 mm deep with a spinning
    rear hub, sits on 3 x M3 countersunk on Ø19 and drives the dial through a Ø6 D shaft held by a
    screw in its end; the STS3215 has its real output position, the 4 x M3 horn, and M2 screws
    into its mounting faces only; the DT04-12PA-L012 flange is the TE drawing's 55 x 36 with 4 x M4.
    Fixes the assembly review found: the pan serv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
    [turret.py]
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2026-10-27 Turret physics handed over: the launch model and the feed simulation as they stand
    sim/turret_launch.py models one shot through the twin flywheels (Hertz foam contact, Hunt-Crossley
    damping, Coulomb tyre friction, the Snail 2305's DJI motor constants behind an ESC current limit) and
    sizes the hardware speed ceiling: Ø36 tyres at 25 % crush on a regulated 12 V flywheel rail give 55 fps
    at 90 % of no-load and at most 66.4 fps for the worst ball at 100 % throttle on a fast motor and a high
    rail. sim/turret_feed.py runs 30 balls through the dial, the baffle and the chute in MuJoCo at every
    pose: the parked dial never leaks; feeding is 27-30 of 30 to -25 deg, with a relevel after empty steps
    bel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
    [turret_feed.py, turret_launch.py]
2026-10-27 Turret: Ø36 tyres at 25 % crush, a 30-ball hopper that really holds 30, the CT interface sized to the cartridge
    From the launch model (sim/turret_launch.py): 12 % crush let the ball's speed swing with the
    foam, 25 % holds it; Ø36 TPU tyres (4 mm on a Ø28 hub rim) on the regulated 12 V flywheel rail keep
    the worst ball under 70 fps at 100 % throttle. The wheels sit 53 mm apart, so the cage narrows.
    From the feed simulation (sim/turret_feed.py): only 15-16 balls fitted under the old 70 mm lid;
    the hopper now rises to 100 mm in the cartridge frame (34 fit, settled and jostled).
    The CT dowels and thumbscrew are placed 6 mm inside the cartridge's sides instead of at fixed
    +-49 mm, which the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
    [turret.py]
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2026-10-27 The turret on the Orin AGX box: fired by hand in the simulator, its mechanism laid open
    A new group in the simulator's design list (sim.html?design=turret-box): the turret from its own CAD on a printed
    adapter on the J501 box, aimed by sliders, keys or a tap on the range, fired only while ARM (the hold-to-run line) is
    held, at knock-down plates, cans and a paper target that keeps the spread. SOLID, X-RAY, CUT and APART views with
    callouts, every part's card, and a step-through of one ball's journey (hopper, dial, chute, the 2.7 mm squeeze in
    the flywheels, barrel, flight) with the numbers from the CAD and the catalogue.
    The adapter (cad/turret_box.py, 3 PETG parts, 261 g, ~10.5 h): the deck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
    [box_deck.step, box_deck.stl, intake_shroud.step, intake_shroud.stl, pod_cover.step, pod_cover.stl]
2026-10-27 Turret program: the box scene's findings on the checklist
    Hardware speed ceiling (the 12 V flywheel rail and Ø36 tyres answer it), a fail-safe ball gate at
    the chute for ARM release and a pre-staged shot, a rear pan keep-out with a clearance check at every
    pose, torque caps for the printed gear and fingers, and the box's own items.
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2026-10-27 Leg v2 fixes: a two-sleeve knee eye, the hip bearing on a lip, real joint loads, corrected strength studies
    CAD (cad/fivebar.py, cad/gmi.py): the knee eye carries two 12 x 18 x 20 steel sleeves (40 mm) in a boss 20 mm proud of
    the upper link's inner face, the nyloc in a pocket at its end, a 12 x 90 shoulder screw (92981A411): the pin
    cantilevers ~46 mm to the lower link's bearings, and in a collapse onto the stops (1.8 kN at the knee) one 20 mm
    sleeve put 110 MPa on the plastic, two put 31. The 61812 hip bearings go in from the motor side onto a 2 mm lip at the
    frame's leg-side face (the GMI standard, both sizes): its outer ring only ever takes outward thrust, so the three
    M3 retainers (whic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
    [apex_spacer.step, apex_spacer.stl, front_link.step, front_link.stl, hip_frame.step, hip_frame.stl, leg_stand.step, output_adapter.step]
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2026-10-27 Turret physics end to end: the ball, the feed under motion, a 3D launch, the bore and flight, the target, the turret's dynamics, power across the ring
    Every stage runs on cad/turret.py at run time and hands its exit state to the next:
    - sim/turret_ball.py: the sourced Rival ball (sizes, masses, foam, TPU) with the unknowns swept and a bench plan
    - sim/turret_feed_dyn.py: the program agent's MuJoCo feed with the M2006 + C610 as a torque/speed-limited loop
    (the real ~100 ms step), pan-slew fictitious forces, body jolts and vibration, the first-touch hand-over, the
    rate-of-fire scan: 4/s clean by stepping, 240 ms command-to-tyres, empty pockets when the dial is driven realistically
    - sim/tu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
    [turret_ball.py, turret_common.py, turret_dynamics.py, turret_e2e.py, turret_feed_dyn.py, turret_flight.py, turret_launch3d.py, turret_power.py]
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2026-10-27 Turret: the slip ring and continuous pan built and swept clean, the physics' findings in the CAD, every part keyed, wiring and firmware plans
    Plan tasks T1 (CAD), T2 (wiring), T3 (parts) and T4 (firmware) of docs/turret-plan.md.
    - Pan joint: ring carrier and driver, the tube coupling, the rotor lead bundle, the index magnet and hall switch, the
    base-board bay and a three-board turret bay on the -y yoke arm; CONTINUOUS_PAN on. The clash sweep at pans 0-350
    every 10 deg x tilts 0/-25 finds no overlap and nothing moving within 1 mm but the tilt stops
    (exports/turret/clash-sweep.json); the 16 mm pinion needed the yoke relieved over it and the ball path 4 mm higher.
    The ring is changed w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
    [box_deck.step, box_deck.stl, intake_shroud.step, pod_cover.step, stand_bottom.step, stand_bottom.stl, stand_box.step, stand_box.stl]
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2026-10-27 Leg v2 at the robot's real weight: loads from the rig's joint forces, an eye-boss fillet, the strength results
    sim/leg_rig.py: the rig carries 13.1 kg (half the 26.2 kg v2 robot). Its ballast was a geom mass on a body with an
    explicit <inertial>, which MuJoCo ignores, so it had carried 8.5 kg (found by the spring study); it is now a welded
    body. Every scenario re-run with videos: standing 12 N m per motor, a capped jump 279 mm, the gearboxes 64-106 N m
    in every event (under the RS-04's 120), the knees 0.55 kN in a 150 mm drop and 0.75 kN in a capped jump's landing;
    an undamped power cut folds the leg onto its stops with 3.0 kN on the knees (0.3 kN with motor damping).
    cad/leg_studies.py: R1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
    [apex_spacer.step, front_link.step, hip_frame.step, leg_stand.step, output_adapter.step, stop_sleeve.step, upper_link.step, upper_link.stl]
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2026-10-27 Requirements and milestones: the parts rule (R47), the power cut as the legs' fault case (R37), the rig's bench tests (M3)
    R47: every part off the shelf with a listed price, printed, or ordered online at an instant price; nothing needs a
    quote (D40). R37: an uncontrolled power cut is the legs' fault case (D39). M3: the bench tests that set the models'
    unknowns: an unpowered RS-04 back-driven (its power-off damping), the TPU stop sleeve's stiffness and travel, an M5
    heat-set insert's torque against preload in printed PA6-CF, the BotWheel tyre's radial stiffness, the RS-04's rotor
    inertia.
2026-10-27 Turret: the parts rule and the decided choices applied, every load path strengthened where the FEA asked, a general clearance check, the assembly order
    - Parts rule (D40) and decisions (D41): the SparkFun ROB-13065 ring on the bench and the robot (2 + 2 power circuits,
    two kept for a camera, 2 x 6 Micro-Fit at both ends; the quote-only rings are gone); the CT signal connector 2 x 5 so
    the three Micro-Fit sizes cannot cross-mate; VXB's chrome-steel 6810-2RS; a Quarton VLM-520-73 LPT laser from
    Digi-Key (Class 2, Ø7, on 5 V); the pan clamp a SendCutSend part in 0.125 in 6061-T6 (exports/turret/pan_clamp.dxf);
    the lidar study on the 30 mm riser; no quote text left.
    - FEA-driven changes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
    [pan_clamp.dxf, stand_bottom.step, stand_box.step]
2026-10-27 Plans to a first physical prototype: the turret, the single-leg rig, the body; and a handoff note
    Fable 5.1 planners reviewed each workstream and wrote the plan an Opus implementer works through: highly available
    parts with a primary and a backup each, simple designs, the parts rule (D40).
    docs/turret-prototype-plan.md: the turret's review, a simple bench v0 and the steps to the robot's v1, available
    replacements for the hard-to-buy parts with the speed ceiling kept physical, the build package and bench tests, the
    implementer's tasks (some bench-kit rows still TODO).
    docs/leg-prototype-plan.md: the single-leg rig (an 8080 post with HGR15 rails, a SendCutSend carriage plate on the
    hip frame'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
2026-10-27 Turret prototype plan finished: v0 is the turret as drawn, on its bench stand, with three swaps for availability
    SunnySky X2216 880 KV flywheel motors (three US sellers in stock) on the fixed 12 V rail with Ø34 tyres (worst-corner
    64.1 fps; Ø36 only if the bench shows headroom), a third Feetech STS3215 stepping the dial in place of the delisted
    M2006 + C610 (one actuator type for every axis and the feed, all on the switched 12 V rail), and the red Quarton
    VLM-650-03 laser. The slip ring, continuous pan, the pulse-train safety line, the chronograph trip and the phase-short
    brake stay. Tasks T0-T15 to a tested v0, T16-T17 to v1; risks: foam bridging over the dial, the thin speed margin
    (test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
2026-10-27 Turret v0 parts (D42): the X2216 880KV motors, the STS3215 feed servo and the red Class 2 laser recorded, every v0 part with a listed price, a buy link and a second seller
    The decision: v0 is the turret as drawn with three swaps forced by stock (docs/decisions.yaml D42). The catalogue gains the SunnySky X2216 (from SunnySky's own drawing), its backup T-Motor MN2212, the Lumenier AM32 backup ESC, the Quarton VLM-650-03 LPT (Ø7 x 22.5), the Bulgin and Switch Components DC rockers, the Mean Well LRS-350-24, the reference chronograph, the servo bus adapter and the tools. Second-source research applied: Digi-Key and Mouser links and prices for the electronics, a second seller for the McMaster ha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
2026-10-27 Leg rig T7-T9: the motor bus (MuJoCo, CAN, HIL), the controller port and its supervisor, logs and verdicts
    rig/bus.py is the interface the controller drives: two RS-04s at a fixed tick, torque feed-forward only
    (MIT Kp = 0). rig/sim_bus.py puts sim/leg_rig.py's MuJoCo rig behind it, with the plant's parts on the
    plant's side (torque-speed line scaled by the bus voltage, the firmware cap, the TPU stops, power-off
    damping) and an optional tick of latency like the CAN request/reply. rig/can_bus.py drives the motors
    over SocketCAN on a real-time schedule (calibration, the 15 rad/s speed rail, the rig node's RUN and
    VBUS frames, start-up configuration with the damper switch logged); rig/hil.py ru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
    [bus.py, can_bus.py, compare.py, faults.py, hil.py, leg_control.py, log.py, node.py]
2026-10-27 Turret sim mode: its own sounds, and audio that starts on a phone tap
    - sfx.turret (additions to sfx.js, same compressor, limiter and room):
    - a flywheel voice set every frame from the wheels' speed, with the phase-short brake on release (D9);
    - the dial step, the ball drop, the nip, and a muzzle shot without the dial click;
    - distinct hits for paper, cans and plates, a can landing, a bounce;
    - the journey's stage sounds, slowed with its time scale;
    - a servo whine at a level you can hear.
    - turret_bench.js calls them for every event and each of the journey's 8 stages. Releasing ARM brakes the simulated
    wheels (10 ms, tau 12 ms) instead of a 1.4 s coast.
    - sfx.js unlocks audio on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
    [sfx.js]
2026-10-27 Turret firmware v0: the STS3215 feed, the X2216 flywheels, a gate-paced burst, the AM32 settings, and a bench host with a simulated turret
    The reference the Feather port follows, pure Python in firmware/turret/:
    - feed.py: the dial on servo ID 3 in step mode (512-count steps, 2,608 counts/s, settled within 23 counts),
    jams (300 ms per 45 deg or 40 % load for 60 ms) reversed 20 deg and retried, three in a row a fault; the
    servo leaving the bus on a release and re-initialised on the next arm; never a blind re-send of a step.
    The burst is paced on GATE_1: 335 ms step to step at least, 3/s at most, two dithers before an empty step.
    - flywheel.py: 52 fps on 34 mm = 8,855 rpm; the 300 ms ram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
    [bench_host.py, can_msgs.py, config.py, dshot.py, feed.py, flywheel.py, sim_servo.py, sim_turret.py]
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2026-10-27 Build page: everything to order and print for the first prototype, by seller
    designer/build.html + build.js, generated from the repo's data on every load (exports/*/bom.json, print plans,
    exports/leg/cnc/, catalog/): the day-1 orders (longest lead first, lead times only where recorded), the order list
    grouped by seller in whole packs with links, alternates and pasteable part numbers, the parts machined or cut to
    order with their files and callouts, and the print queue (the leg in its plan's day order) with totals per material.
    The rig and the body appear when their files land. In the top bar after Progress; the progress page links to it.
    Checked in system Chrome: no page errors, no horizont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
2026-10-27 Turret v0 (D42) in the CAD: the X2216 flywheels, the STS3215 feed servo, the order sheets and the print files
    Plan T2, T4, T1 and the print part of 4.2, with every consumer of the Turret API kept working:
    - cad/turret.py: MOTOR is the SunnySky X2216 880 KV short shaft from SunnySky's drawing (Ø27.7 x 32, 4 x M3 on
    16/19, the bolt-on Ø17 adapter on its M5 stud); the cage plate sits on the bell (plate_z0 42); the cartridge has
    four Ø7 posts with M3 inserts for its board, a lead slot per motor and no C610 window. The dial is stepped by a
    third STS3215 under the floor (its face 0.75 mm up in a pocket so the dial prints flat; 4 x M3 into the horn).
    The flywheel hub is Ø28 x 12 for the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
    [barrel.3mf, board_bay.3mf, cartridge_body.3mf, cradle.3mf, dial.3mf, flywheel.3mf, flywheel_tyre.3mf, hopper.3mf]
2026-10-27 Turret v0 physics (plan T3, T5): the X2216 launch, the servo feed, the brake as built
    - sim/turret_launch.py, turret_launch3d.py: MOTOR is the X2216 880 KV (117 mOhm, 0.5 A at 10 V, rotor 4.8 kg mm^2
    est); each tyre's crush comes from the cage (motor axes 53.0 mm apart). Ø34: 52 fps nominal at 8,855 rpm (84 % of
    no-load); the fastest swept ball at 100 % on a fast motor and a high rail is 67.6 fps (cap 70), so the bench keeps
    the no-load speed at or under 11,180 rpm (66 fps line); Ø36 makes 70.7 and is out. The phase-short brake now runs
    through the FETs and taps (173 mOhm: tau 10.2 ms at low speed) with the winding's inductance swept 0-50 uH:
    5 % speed 40-57 ms after release (48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
    [turret_e2e.py, turret_feed_dyn.py, turret_launch.py, turret_launch3d.py, turret_power.py]
2026-10-27 Leg at the 14.75 kg design mass, machined output adapters (D46), a controller without the simulator
    - Output adapters: CNC 6061-T6 from JLCCNC (exports/leg/cnc/: STEP + callouts). The printed one was SF 0.86 across
    its layers held where it really sits. The standard face is fixed: real dowels (they sat inside bolt holes), holes
    15 deg from every motor screw, M5 x 25 heads below the face (they stood into the upper link). The clash sweep now
    includes those screws: 0 clashes.
    - Hip frame: a relief for the wheel link's hub at the shortest leg; frame_mounts() gives the six M5 mounts.
    - TPU stop sleeves Ø26/Ø10 (E from Bambu's datasheet); the rig at 14.75 kg (half of 29.5 kg); sim/leg_contr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
    [apex_spacer.step, front_link.step, hip_frame.step, hip_frame.stl, leg_stand.step, output_adapter.step, output_adapter.stl, stop_sleeve.step]
2026-10-27 Leg rig T12: bench scripts, calibration, B5 on the rig, and driver fixes
    - rig/calibrate.py: zero each motor on its bare knee-out stop post, check the travel to the
    knee-in post against the CAD (112 deg between the bare posts, within 3 deg), infer the
    direction, write rig/calibration.json; --check prints the leg's angles and length.
    - rig/bench/backdrive.py (B1): the driver motor in velocity mode turns the tested one
    through the dyno's spider, at 0.5-13 rad/s both ways; the drag is the driver's torque
    less its own (friction run); fit c sign(w) + b w. Conditions: friction,
    unpowered_damper0, unpowered_damper1, powered_stopped.
    - rig/bench/spin_down.py (B2): a 2 N m step to 8 rad/s,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
    [calibrate.py, compare.py, leg_control.py, rs04.py, rs04_emu.py]
2026-10-27 Leg rig T2/T3: the rig's CAD, its checks, and the SendCutSend carriage plate
    cad/rig_parts.py and cad/build_rig.py: one 8080 post on a 4040 ladder base with a 4040 brace,
    two HGR15 rails, a 6.35 mm 6061-T6 carriage plate (SendCutSend DXF and STEP, the DXF
    re-imported and checked), the hip frame on fivebar's six M5 insert positions, ballast posts
    for cast-iron plates, TPU bumpers (contact at a leg length of 140 mm, crushed at 115), a top
    stop, the drop-pin bracket, the ToF sensor and target, the electronics pod on the post's back
    face, and the printed parts' print plan.
    Checks (exports/rig/rig.json): 0 part pairs closer than 10 mm over 27 poses; the blocks
    stay on the rails at every pose, th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
    [bumper_base.step, bumper_base.stl, bumper_cap.step, bumper_cap.stl, bumper_tpu.step, bumper_tpu.stl, carriage_plate.dxf, carriage_plate.step]
2026-10-27 Leg rig T4: bench fixtures and fit coupons, with a press cage for B3 and B4
    cad/rig_bench.py -> exports/rig/bench/ (STEP, print-ready STL, print-plan.json, bench.json):
    - the dyno: two lug plates, two hubs on the D46 screws, a TPU spider (B1, B2);
    - the press cage (PETG): a frame round an S-type load cell on the press's axis. For B4 the
    cell hangs from the top beam and a puller (a PA6-CF insert coupon, the insert along the
    print's z as in the hip frame, keyed by wings against the walls) hangs from it on an
    M12 x 80 stud; the screw under test comes up through the bottom beam into the insert, so
    its tension is the cell's reading. For B3 an M12 x 80 bolt through the press base's nut
    l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
    [bearing_disc.step, bearing_disc.stl, coupon_apex_eye_m01.step, coupon_apex_eye_m01.stl, coupon_apex_eye_nom.step, coupon_apex_eye_nom.stl, coupon_apex_eye_p01.step, coupon_apex_eye_p01.stl]
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2026-10-27 Turret v0 electrics part by part (plan T8; D47): 3.3 V arm logic, the 555 on the pendant's 12 V, the brake FETs to GND
    docs/turret-wiring.md section 3 now draws the arm chain with a designator on every part, and cad/turret_boards.py
    (new) lays out each board, checks every placement, writes exports/turret/wiring/parts.md (each part's value, catalogue
    key and pins) and counts the boards' passives for the parts list. Four faults in the plan's wiring are fixed (D47):
    - The arm chain's logic (the one-shots, the trip latch, the AND) runs on the Feather's 3.3 V: the plan's 5 V logic put
    5 V on the Feather's pins (not 5 V tolerant) and its gates' 3.3 V pull-ups were under a 5 V HC input's threshol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
    [turret_boards.py]
2026-10-27 Turret firmware's bench host and simulated turret follow the v0 circuit; the simulated bench run
    - sim_turret.py: one-shot A 18 ms +-10 % (39 k x 1 uF); the brake's RC on the cartridge board, high ~8 ms after ARM
    falls and low 0.2 ms after it rises; config.py: BRAKE_DELAY_S 8 ms and BRAKE_TAU_S 12.7 ms (the X2216's short
    through two FETs and the taps, with the winding's inductance: docs/turret-physics.md section 5).
    - bench_host.py: test 3.1 also reads 3.3 V, the 555's frequency (930-1,045 Hz), the drop across R8 (1.6-2.4 mA in the
    opto) and the highest level on any Feather input (<= 3.4 V); 3.2 judges a wrong-frequency train on the firmware's
    SAFE within 10 ms, as the test document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
    [feed_servo.json, ring_servo_bus.json]
2026-10-27 Turret v0 FEA on the final geometry (plan T9): the yoke's relief a cone, the cartridge's recoil from the X2216
    cad/turret_studies.py on the v0 build (exports/turret/fea/summary.json and a picture per case; everyday target 2,
    rare 1.2):
    - tilt yoke 2.78 / 2.05 / 1.78 in the 30 g falls, 1.82 in the everyday 50 N push on the muzzle (p99 SF 4.4); the
    turntable 8.38 / 2.19, its teeth 3.31 / 1.66; the pinion 2.7 / 1.35; the pan base 6.12 / 1.38, 2.26 at the servo's
    cap and 1.13 at its stall (p99 SF 9); the aluminium clamp 2.89; the cartridge 1.57 down and 1.57 in recoil (p99 SF
    11); the dial 5.75 / 1.72.
    - The cradle's cheeks bend across the layers: 0.78 / 0.62 in the falls and 0.77 in the e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
    [cradle.3mf, tilt_yoke.3mf]
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2026-10-27 Turret: the feed and ball models' text without the M2006 and C610; the program checklist's v0 evidence
    - sim/turret_feed.py, turret_ball.py (and exports/turret/launch/ball.json): the dial is the feed servo's, a jam is
    counted on its load reading.
    - docs/turret-program.md: the brake (to GND, tau 10.2 ms, 5 % at ~48 ms), the strength item with the v0 FEA (open on
    the cradle's cheeks), the bought parts (118 lines, $1,579, the passives from parts.md) and the wiring (D47).
    [turret_ball.py, turret_feed.py]
2026-10-27 Turret bench print plan: v0's parts only, with the slicer's grams and hours
    exports/turret/bench/print-plan.json (which the build page reads for the print queue) leaves out the robot's bumper ring
    and fill flap (not printed for the bench, D42) and takes each part's grams and hours from Bambu Studio where
    cad/turret_print.py has sliced it (marked sliced, with its settings, 3MF and orientation): 19 parts, 1,292 g, 50 h,
    against the rough 21 parts, 1,012 g, 55.5 h. Same format; checked on the build page in Chrome (19 printed parts,
    ~50 h; its only missing files are the rig's and the body's, not generated yet).
2026-10-27 Turret wiring: two small text fixes (BUS_V's levels, a wrapped line)
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2026-10-27 Leg rig T12/T13: the bench test procedure and the safety checklist
    docs/leg-bench-tests.md: the order (coupons, commissioning, B2, B1, B3, B4, B6, the bumpers'
    calibration, the first stand, B5 on the rig, then S2-S6), each test's set-up, steps, data and
    pass/fail; B1 back-drives the unpowered RS-04 with its damper switch at the default (0) and at
    1, and powered-stopped. The simulation's assumptions, the predicted numbers and every run's
    criteria are generated into it from the files they live in (tools/bench_doc.py).
    docs/leg-rig-safety.md: the hazards, the rules (one operator on the pendant, the clear zone, the
    pack as the master switch, the start voltage), a twelve-point checklist for each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
2026-10-27 Leg rig T1/T5: the build page's parts list, the 500 kg load cell, the bench's extras
    tools/rig_orders.py now also writes exports/rig/bom.json as designer/build.js reads a parts
    list: lists rig, electronics and bench of {key, qty, for, part_number, sellers: [primary,
    backups]} and made_to_order (the carriage plate: SendCutSend from the STEP or DXF, Xometry
    backup, about $75). A part that is the same as the leg's or the turret's carries that
    catalogue key, so the page orders it on one line. The bench's extra screws, inserts and
    washers ride on the lines that already buy them. The leg's machined adapters come from
    exports/leg/bom.json's made_to_order (the rig catalogue no longer lists them).
    Th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
2026-10-27 Body (M5) T1-T3, T6 in progress: parameters, sheet-metal parts, open frame, layout, battery drawer, FEA harness
    - cad/body_params.py: every body number read from its source (fivebar.frame_mounts, turret TM, the J501 project's
    parameters incl. its fitted G48R cooler, the lidar catalogue entry, SendCutSend's bend tables for 5052/6061/C110).
    - cad/body_sheet.py: a bent/flat sheet part (formed solid, flat blank, DXF with CUT/BEND layers, SendCutSend rule
    checks: flange minimum, the channel 2x rule, features half a die from bends, PEM K/N, countersink depth).
    - cad/body_frame.py: the spine as two C-channel cheeks (the plan's 36 x 150 U cannot be bent: SendCutSend's base >= 2x
    flange rule) o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
2026-10-27 Leg: fixes from the pre-order review (code; outputs rebuild next)
    - Hip frame: 13 mm flanges (7 mm was SF 0.75 across the print's layers in a landing; the frame is now judged across
    the layers, pa6_cf_z); the six mounts move to z +-70 (frame_mounts()). M4 lug counterbores 11 mm deep (4.9 mm into
    threads the motor drawing promises only 5 deep). Each motor's turn now puts its harness out level and outwards,
    dowels derived from that same turn (the rear's holes were 36 deg off its motor) and clear of the stop posts.
    The bearing lip Ø74 (inside the 61812's outer face).
    - Upper links: the 8 hub screws sit in Ø10 x 5.5 counterbores; at the knee-out stops the front link passed over
    proud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
    [fivebar.py, gmi.py, leg_rig.py, leg_studies.py]
2026-10-27 Turret v0 electrics after an independent review against the datasheets (D47): a set-only trip latch, ARM out of the Feather's reach, the brake FETs held off while the ESC drives, no energy into the 1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
    A separate agent checked the drawn circuit part by part. Fixed before anything is soldered:
    - Trip latch (blocker): with D = the window, the next slower ball cleared a trip. U9's D is now tied high and it is
    clocked by GATE_2 AND the window (a spare U10 gate): only RESET or a power cycle clears it.
    - ARM (blocker): the Feather could raise ARM by driving its "input" pins (A4 on PULSE retriggers one-shot A; D12
    against the AND's output tops the 2815's 1 V). PULSE and ARM now reach the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
    [feed_servo.json, ring_servo_bus.json, stand_box.3mf, stand_box.step, stand_box.stl]
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2026-10-27 Turret program log: the electrics reviewed and fixed (D47 extended), the brake as built, the v0 FEA
2026-10-27 Turret merged: the 3D bench's text follows v0 (the STS3215 feed, the X2216s on 12 V, the measured brake), its export rebuilt
    - turret_bench.js, as the turret program proposed: the feed servo (345:1, a 45 deg step in ~235 ms, 3 balls/s at
    most: the rate slider stops at 3), the speed cap as the 12 V rail's physical ceiling (67.6 fps against the 70 cap),
    the brake modelled as built (5 % speed ~48 ms after release, 1.1 s unbraked), the red 650 nm laser; the feed label
    showed 'undefined' since the v0 swap.
    - exports/sim/turret_box and exports/turret/{box,bench} rebuilt on the merged turret (cad/build_turret_box.py,
    cad/build_turret.py --no-render). The box adapter's intake shroud was draw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
    [box_deck.step, box_deck.stl, intake_shroud.step, intake_shroud.stl, pod_cover.step, pod_cover.stl, stand_bottom.step, stand_box.step]
2026-10-27 Body: 3/16 in spine on standoffs in the bolt rows, loads at the mount plane, the power skid and its electrics
    Frame (D44, D49)
    - The body's strength loads are now the leg's reactions at the hip frame's mount plane (cad/body_legloads.py:
    d'Alembert on the rig's leg module every step; the rig's ballast force checks the vertical): at 16 kg a leg the
    body sees 205 N m of roll and 559 N at the worst landing, 275 N m in the undamped power cut, about 0.4-0.5 of the
    axle force times its 187 mm offset.
    - 1/8 in cheeks fail at those loads with any standoff layout; 3/16 in cheeks (SendCutSend 5052, 30 mm flanges) on
    eight M4 x 31 McMaster standoffs in the hip frames' bolt rows pass (fea results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
2026-10-27 Leg stops: Ø16 pins in blind holes and radial stop faces on the upper links (review M6, S3)
    The stop posts failed the pre-order review: a post's shoulder-screw head sat inside the link's thickness (M6), and
    the moment tore its M8 insert out of the printed web (S3). Checking the fix found the stop's force was also about
    twice what the review took: the link's straight edge met the round post 31 mm from the motor's axis (on the real
    solids), not 58, so a 60 N m stop was 1.9 kN on the post, not 1.0. No pin in a 24 mm printed web carries that at
    SF 2 (a Ø12 pin 22 mm deep: SF 0.6; the rigid embedded pin bears p = F/(dL)(4 + 6e/L) at the hole's mouth).
    - Each upper link gets a radial stop face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
    [fivebar.py, leg_rig.py, leg_studies.py]
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2026-10-27 Body exports for P0/P1: SendCutSend files, print STLs, parts list and order list; the turret's interface taken in
    - exports/body/sendcutsend/: the seven SendCutSend parts as DXF (CUT and BEND layers) and STEP, material and
    thickness in the names (cheeks 5052 3/16 in x2, floor tray, belly plate, deck, compute pallet, power plate,
    C110 bus bars x2); every SendCutSend rule checked, none broken.
    - Printed parts' STEP and STL with exports/body/print-plan.json (50 h, 0.87 kg); renders and flat-pattern pictures;
    body.json (interface, sheet orders, clash sweep: 22 stances, no clashes, nearest moving part 25.1 mm), mass.json
    (P1 29.0 kg, P3 32.1 kg), leg-loads.json, bom.json (the build page's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
    [bay_door.step, bay_door.stl, bay_front.step, bay_front.stl, bay_rear.step, bay_rear.stl, bay_skid.step, bay_skid.stl]
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2026-10-28 Body strength results (T6) and the frame write-up; the floor tray to 1/8 in
    - exports/body/fea/: every case with its picture, overload video and summary.json (the viewer files stay local).
    At the rig's body loads (15.97 kg a leg): S1 landing SF 4.4 away from the standoffs' bonded ends (1.5 at them),
    S1F power cut 2.9 (1.7), S1b one leg 2.8 (1.7), twist 0.013 deg, pitch SF 27; the deck under a 300 N hand
    SF 2.5-2.9 and 0.33-0.38 mm; the 1.70 kg head's 30 g tip-over SF 1.3 (abuse target 1.2) with the riser's new
    Ø36 feet; the tray at the landing's 8.7 g SF 2.5 once 1/8 in (0.100 in was 1.55 where it overhangs the cheeks).
    - The deck and tray cases now load and hold real patches (1 mm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
    [bay_door.step, bay_front.step, bay_rear.step, bay_skid.step, belly_plate_6061-T6_0.100in_x1.dxf, belly_plate_6061-T6_0.100in_x1.step, bus_bar_C110_0.125in_x2.dxf, bus_bar_C110_0.125in_x2.step]
2026-10-28 Body next plan (Fable): the mass decided (design 32.5 kg, 16.25 kg per leg; a 32.0 kg ledger gate), the order fixes, P2/P3 tasks B0-B17
    The robot is 32.27 kg against the old 28.5 budget, which no set of levers reaches (the floor is 30.6-30.8 kg); legs,
    body and turret design to 32.5 kg from now on, the ledger capped at 32.0 kg by cad/test_body.py, with 0.7 kg of
    scheduled cuts and 1.0 kg more on call. Before ordering: every live end on the body a socket, two DDR-120C-24 (an
    EOL flag), the instant prices read into bom.json. New risks found: the P30B pack sags 9 V at the 80 A jump pulse
    (a firmware jump gate at 44 V resting), its prospective short current under the fuses' rating. Tasks: the le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
2026-10-28 Leg stops: the upper links' stop faces taper into the edge and have a filleted root
    The first stop faces ended in an arc that met the link's straight edge square, about 72 mm from the hub: a notch in
    the link's most bent region (the upper link's landing case, R1, at 16.25 kg: SF 1.22 with them, 1.43 without, at the
    4 mm mesh; its peak moved to that corner). Each face now runs flat to 70 mm, rounds its tip (3 mm), tapers straight
    into the edge at 110 mm along the link (a 16 deg step) and leaves the edge through a 10 mm fillet. The contact is
    unchanged (tangent to the sleeve at the stop, arm 57.8 mm). R1 at a 3 mm mesh: 1.37 with the faces, 1.36 without.
    The link weighs 399.5 g (359.9 without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
    [fivebar.py]
2026-10-28 Turret wiring: the robot's DT12 harness and safety line (plan N7, D52)
    docs/turret-wiring.md section 1.1b: on the robot the stand's harness gives way to the body's, and the pendant to a
    dry contact of the body's STOP relay across DT12 pins 7-8 (closed = run; open on the radio stop, the receiver's
    failsafe and when the robot sits, D37). The DT06-12SA plug in a TE 1011-248-1205 90 deg backshell on a 300 mm pigtail
    that drops through the deck at the robot's right rear (-130, -60): the receptacle is on the turret's -y side and the
    TM dowels fix that side (from the body plan's left-rear grommet a 450 mm pigtail). The pin table for the body's end,
    one 120 R at the body's end of the CAN, the contac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
2026-10-28 Body B0, B1: the baseline reproduced; the order fixed and priced (D58)
    B0 (main 8be0561, the plan's 0e1b0ec plus the plan): cad/build_body.py --no-render --quick,
    cad/test_body.py (17 passed), cad/body_bom.py and cad/body_studies.py --only D2 reproduce the
    committed numbers exactly: P1 29.17 kg, P3 32.27 kg, COM unchanged, 0 clashes, every sheet
    rule clean, D2 SF 1.31 (1.5506 mm), bought $1,494.10. The exports' diffs were only STEP/DXF
    timestamps and ezdxf's header order; nothing of them is committed.
    B1, the order:
    - Every live end on the body is a socket (hazard 11): the 48 V branch leads W10-W15 and their
    returns end in XT60H-F, the 24 V and 12 V leads W21, W23, W24 in XT30U-F; the dev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
    [bus_bar_C110_0.125in_x2.dxf, bus_bar_C110_0.125in_x2.step, bus_insulator.step, bus_insulator.stl]
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2026-10-28 Turret cradle on aluminium cheeks (plan N1, D48): the outputs (the FEA's summary follows its full run)
    The turret as built: 1.684 kg with 30 balls (1.629 empty), its centre 95.7 mm above the TM face, inside D49's 1.70 kg
    at 100 mm (exports/turret/turret.json); the tilting group 737 g with its centre 8.6 mm behind the tilt axis (unpowered
    it rises to the 0 deg stop). The clash sweep at pans 0..350 every 10 deg x tilts 0, -5, -12.5, -20, -25: no overlap,
    nothing moving within 1 mm but the lug on the yoke's stops at 0 and -25 only (exports/turret/clash-sweep.json, 939 s);
    over the pan pinion at full depression, every degree of pans 130..230: the rail frame 5.38 mm at its nearest, the barrel
    6.0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
    [cradle.3mf, cradle_plate_l.dxf, cradle_plate_r.dxf, horn_boss.3mf, pan_clamp.dxf, pivot_spacer.3mf, stand_bottom.step, stand_box.step]
2026-10-28 Turret order sheets amended (plan N3, D51): the backup ESC pair, the gates' 39 k alternates, the SendCutSend cart of four
    - D51: the Lumenier Razor Pro F4 45A AM32 pair (RaceDayQuads 22300, $31.49 each; GetFPV, Lumenier's own store, the
    backup) in the first batch beside the Repeat pair, so the first bench hour (N10) can pick the pair that returns
    bidirectional-DShot eRPM. RaceDayQuads joins the parts rule's seller list (a listed price and a buy link).
    - Bench test 3.10's alternate: R41a and R42a, 39 k, on the cartridge board's parts list (cad/turret_boards.py; the 39 k
    line goes from 3 to 5 with its spare). The trip window's selection range (R11 from 60.4 / 63.4 / 66.5 / 69.8 / 73.2 k)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
    [stand_bottom.step, stand_box.step]
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2026-10-28 Turret box adapter on the J501's Rev 0.9 (D50): the collar on the flush grille, sealed on the roof's solid band, a 160 mm duct, the heights, the stand's panel in the pod, the airflow on the 9215, pro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
    - _j501() reads the Rev 0.9 roof: fan_grille (clearance, skirt wall), the cooler's 9215 frame and chamfer, centre_in_pcb
    (the fan at box +10.5, 0), the roof at 97, the fan curve (thermal.fan: 28.1 Pa, 93.9 m3/h) and the operating point from
    the J501's own CFD (exports/thermal/cooled-<rev>.json); Rev 0.8's duct ring and the built-in fallback still build.
    - The collar: Ø103.8 inside, on the open-cell boundary (the fan's octagon + 3 + 2.4 + 1 mm, Ø104.8 on its flats), drawn
    in 0.5 mm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
    [box_deck.step, box_deck.stl, intake_shroud.step, intake_shroud.stl, pod_cover.step, pod_cover.stl]
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2026-10-28 Turret mount file for the body (plan N5): exports/turret/mount.json from the live CAD, and the lidar table at 143 mm
    cad/turret_mount.py writes exports/turret/mount.json at the end of every bench build (cad/build_turret.py, two lines):
    the TM pattern (4 x M5 on 80 x 80, the dowels at (52, 0) and (0, -52), the Ø45 hole), the Ø144 foot and nothing below
    the face; the riser's facts (30 mm, D41, the M5 inserts 8 deep, the screw tips 11 mm under the face); the DT12 on the
    -y pad 19 mm above the face, the plug, its backshell and their 30 mm withdrawal as boxes in the turret frame (the
    plug's checked against the CAD's); the harness pinout, the fuse and the reverse diode; the mass and centre with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
    [bench_host.py, config.py]
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2026-10-28 Leg rig T2/T3: rebuilt on the merged leg, the SendCutSend order sheet, ballast within 2 %
    cad/build_rig.py rebuilt on main's leg (fivebar.frame_mounts(), the new grommet clocking: the
    harness slots moved). It now writes exports/rig/sendcutsend/README.md, the order sheet: the
    files, 6061-T6 0.250 in, deburr, no operations, the units check and the hole table it is
    checked against on arrival. exports/rig/bom.json is left to tools/rig_orders.py. The ballast
    table allows 2 % over rather than a stack of trim washers: at 14.75 kg one 2.5 lb plate per
    post (14.96 kg carried). Checks unchanged: no pair closer than 10 mm, blocks SF 6.6, post
    23.8 MPa, apex 180 mm under the top stop.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
    [bumper_base.step, bumper_cap.step, bumper_tpu.step, carriage_plate.dxf, carriage_plate.step, drop_bracket.step, load_cell_mount.step, pendant_clip.step]
2026-10-28 Leg rig T4/T13: bench fixtures and assembly renders rebuilt on the merged leg
    The press cage's B3 stack now sees the 26 mm stop sleeve (6 mm of slack); the coupons follow
    main's fivebar; the assembly renders and text are regenerated (the calibration checks 125 deg
    between the bare posts). The bench doc notes the pendant in B1's set-up.
    [bearing_disc.step, coupon_apex_eye_m01.step, coupon_apex_eye_nom.step, coupon_apex_eye_p01.step, coupon_frame_ring_m01.step, coupon_frame_ring_nom.step, coupon_frame_ring_nom.stl, coupon_frame_ring_p01.step]
2026-10-28 Leg stops: the leg rebuilt (0 clashes with the stop poses squeezed) and the rig at 16.25 kg, 48.1 V
    - exports/leg: every part, the print plan (the hip frame 1,006 g, 274 x 154 x 81 turned; the upper link 399.5 g;
    the sleeve 15.6 g), the BOM (stop_pin 98432A386 in place of the shoulder screws and M8 inserts, $1,125.11 a leg),
    leg.json (range 101.5-392.4 mm, 9.70 kg a leg, 0 clashes over the sweep and the six stop poses, the cable clear),
    the renders, and the CNC adapter's files as cdda86d's callouts left them to rebuild.
    - rig-results.json and the videos at the 16.25 kg design mass and the 13S pack's 48.1 V: the undamped power cut
    1,965 N on a knee and 117.9 N m on a stop, damped 324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
    [apex_spacer.step, front_link.step, hip_frame.step, hip_frame.stl, leg_stand.step, output_adapter.step, output_adapter.stl, stop_sleeve.step]
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2026-10-28 Turret box adapter on the J501's committed Rev 0.9 (D50): no bosses under the deck, a 40 mm gap, a 158 mm mouth
    While N4 was built the J501 session committed Rev 0.9 (8e33874) with the cooler centred on the module: the fan moved
    from PCB (88, 70.5) to (90, 90.5), 9.5 mm behind the pan axis, and the CFD point to 38.8 m3/h. The provenance check
    said so, and the adapter rebuilt on it failed: the Ø105 collar round the grille ran into the rear TM insert bosses
    (0.0 mm, 3 asked), the duct cost 10.9 % of the fan's flow (10 allowed), a front leg was 2.7 mm from the duct.
    - The TM face's M5 inserts (7.9 mm) now sit wholly in the 8 mm deck and the turret goes on the box with 4 x M5 x 12
    button hea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
    [box_deck.step, box_deck.stl, intake_shroud.step, intake_shroud.stl, pod_cover.step]
2026-10-28 Turret mount file and lidar table rebuilt on the cradle with aluminium cheeks (N5 on N1)
    exports/turret/mount.json from the bench build on the final turret: 1.684 kg with 30 balls, 1.629 empty, the centre
    (-5.6, -4.7, 95.7) mm from the pan axis on the TM face; the TM pattern round-trips. The lidar table at 143 mm (run on
    gb10-02): limited only within pan +-26 deg, -16.5 deg at worst (pan -8, the ball path binding with 11.7 mm), as N5's.
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2026-10-28 Rig parts pictures: tools/part_images.py covers the leg rig
    tools/part_images.py now reads the rig's parts list (exports/rig/bom.json), its catalogue
    (catalog/rig.json) and its two print plans (exports/rig/, exports/rig/bench/). 40 renders of
    the rig's printed parts and bench fixtures (rendered on gb10-02) and 63 product photos of its
    bought parts (the photos stay local in references/vendor/thumbs, as the leg's; catalog/images.json
    records them). Six sellers' pages block reading: the plywood, the LEV100 contactor, the two
    resistors, the 3.5 mm jack and the 5 A fuse have no picture yet. catalog/sourcing.json names a
    backup seller's page for the six whose primary page refused.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
2026-10-28 Turret design gates and the settled pile: balls in their cavities, one body per moving group, the 3D page's tilt frame fixed
    - cad/gates.py: generic gates (spheres in cavities by OCC boolean, sphere overlaps, rigid-group connectivity with
    joints, clearance over a sweep of poses), no turret names inside, for cad-agent later
    - cad/turret_gates.py: the turret's parts through them; exports/turret/gates.json with a fingerprint of the CAD and
    the pile; cad/build_turret_box.py refuses a failing or stale result
    - sim/turret_feed.py --pile: the full hopper settled in MuJoCo on the dial's real cone and fins (pile.json), replacing
    the hand-placed rings (they interpenetrated and sat in the cone)
    -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
    [turret.py, turret_feed.py]
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2026-10-28 Body B3, B4, B6, B7, B10: the robot model from the real body, the turret plate, the P3 shell, the thermal hand model, the J501 snapshot
    B3: sim/robot_v2.py builds the base from the P3 ledger row for row (mass reconciles), collision boxes for the frame,
    shell and tub; 15/15 scenarios pass at 32.15 kg, 48.1 V (exports/body/sim-v2.json). body_legloads at the design
    half-mass 16.25 kg and 48.1 V.
    B4 (D59): a 6061 0.125 turret plate under the deck, open over the fan's cells (none covered), 2 PEM M5; the deck
    cases judged per part (deck 5052, plate 6061), the post-pad corners reported apart like the standoffs' ends.
    B6: cad/body_shell.py, every P3 part (PETG walls with ribs, faces, hatch, door, ea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
    [apex_fillet_envelope.step, bay_door.step, bay_door.stl, bay_front.step, bay_front.stl, bay_rear.step, bay_rear.stl, bay_skid.step]
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2026-10-28 Body B8 after B3: the firmware's model and LQR table regenerated on the real body's model (32.15 kg); plan notes
    The robot SIL (hil/sil_robot.py) falls on the new model while sim/controller_v2.py balances it: recorded in
    hil-results.json and open (the firmware workstream's fix). The other 9 HIL tests and 154 unit checks pass.
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2026-10-28 Body B5: the fuse board's KiCad 10 project, generated from design.py
    hardware/fuse-board/: design.py (parts, nets, placement, pours), generate.py (the schematic, the PCB with its
    zones, the project file with JLCPCB's 2 oz rules and the net-class clearances in fuse-board.kicad_dru, the custom
    footprints), build.sh (ERC, DRC with schematic parity, gerbers and drills for JLCPCB, BOM/CPL, pictures).
    88 x 76 mm, 2 layers, 2 oz, 1.6 mm; twelve Littelfuse MINI FL1 holders (58 V DC, 22 A continuous), the 1 mOhm
    Bourns CSS2H-3920 shunt on the high side with Kelvin taps to an INA228 footprint (or an Adafruit 5832 on TP1-TP3),
    M6/M4 lug studs, the star point, the frame bond and the plate bond. DRC and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
    [bom-jlcpcb.csv, fuse-board.kicad_pcb, fuse-board.kicad_sch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]
2026-10-28 Ammo per D67: the official Nerf Rival refill beside the third-party pack, and the ammo-range gate (22.2-22.8 mm)
    - catalog: Nerf Rival 60 Accu-Round Refill (Hasbro F5052, Walmart US$19.99, eBay US$16.95), with its picture;
    Worker Cheetah 100-pack kept, cheapest a round first; the bench BOM buys 2 x 100 + 1 x 60
    - cad/turret_gates.py ammo_range: the biggest round along the path and in every pocket clear of the solids, the
    smallest one to a pocket and still squeezed at the nip, the bore's play (pass: 1.4-2.0 mm feed, 1.9-2.5 mm barrel,
    nip squeeze 23.3-25.3 %)
    - the box scene rebuilt with the corrected tilt frame (the balls' centre of mass now 8.6 mm behind the tilt axis)
    Co-Authored-By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
    [box_deck.step, intake_shroud.step, pod_cover.step]
2026-10-28 Turret FEA on the D48 geometry (the full run, gb10-01): the cradle fixed; the pan base's servo posts and the pinion under a full stall named for section 1
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2026-10-28 Body B5: stitching vias on the main path; JLCPCB's instant price read (5 boards, 2 oz: $40.60)
    hardware/fuse-board/jlcpcb_quote.py uploads fab/fuse-board-gerbers.zip on cart.jlcpcb.com/quote (no account),
    picks 2 oz outer copper and lead-free HASL (5 pieces, 1.6 mm, 2 layers as detected) and records the page's price in
    fab/jlcpcb-price.json: $40.60 ($35.30 of it the 2 oz copper), DHL estimate $31.49, 3 days' build.
    [fuse-board.kicad_pcb]
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2026-10-28 Body B8: docs/body-firmware.md for the 10S pack (D65), the cut-off, the current limit and the SIL fix
    The acceptance table on today's numbers (36 V, B3's 32.15 kg model); section 5's UVLO, cut-off, jump gate and current
    limit rows; 5.1 the battery windows per cell with where they come from (D65) and the one place they live
    (gp_config.h); the CAN tables without the BMS bridge, with reason 7 and FAULTS b4 bits 5-6; section 8 on B3's header
    and the SIL's gyro bug; section 9's open items: the motor calibrations (rig/calibrate.py), the pack's resistance and
    the current limits to measure, pack-level (not cell-level) cut-off, regeneration into a full pack, the 24 V converter,
    and the 13S/15S number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
2026-10-28 Body B5: the board's numbers, its facts for the body, and its catalogue entries
    hardware/fuse-board/analysis.py: every branch's copper against its fuse (IPC-2221 per layer: the 6 mm runs on both
    layers rise 4 C at 20 A and 11 C at 30 A; the 2.6 mm necks past the holders' pegs add under 0.5 C), the main path
    (continuous 40 A, the 80 A jump pulse adds 2-3 C), the copper against each fuse's let-through, the INA228's error
    budget (within 1 % from 2 A to 80 A after the bring-up's one-point calibration; 2.0-2.5 % worst case without it),
    the mass (132 g with hardware and standoffs). measure.py reads the filled board's copper for it.
    cad/body_fuse_board.py: the envelope in the robot frame (x 34..122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
    [fuse-board.kicad_pcb, fuse-board.kicad_sch]
2026-10-28 Body B5: docs/body-fuse-board.md
    What the fuse board is and why it differs from the brief (the shunt on the high side: the INA228's inputs may not go
    below its ground, which a low-side shunt before a low-side switch does when the switch opens; Littelfuse MINI FL1
    holders, 58 V DC and 22 A continuous, where the Keystone 3568 is 20 A at 500 V AC with no DC rating), the schematic
    in words, the layout and mounting, the copper sizing, the INA228's error budget, JLCPCB's rules, files and price, the
    parts and prices, the P3 wire rows, the build and test steps, and what stays open (P0's INA228 on the - lead shunt,
    the VESCs' battery current at 20 A, PA6-CF as an insulator).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
2026-10-28 Leg rig: the design reviewed section by section, integrity checks in the build, review renders
    docs/leg-rig-sections.md: the frame and rail, the carriage and plate, the leg mount, the stops
    and catch, the load path and weights, the pod and wiring, and the bench fixtures. Each has its
    function with numbers, interfaces, parts (material, process, how held), the decisions with
    their rationale and the alternatives rejected, and the checks.
    cad/assembly_checks.py: generic checks with shapes in and no names inside:
    - floating parts: a contact graph per body;
    - the joints between bodies;
    - interference, pairwise and over a sweep of poses;
    - screw stacks: engagement and tip room.
    cad/rig_hardware.py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
    [ballast_spacer.step, ballast_spacer.stl, bumper_base.step, bumper_base.stl, bumper_cap.step, bumper_cap.stl, bumper_tpu.step, bumper_tpu.stl]
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2026-10-28 Body: integrity checks (every screw a modelled joint, no floating parts) and the D65 battery bay; what the checks found, fixed
    cad/body_joints.py: 71 joints, 183 screws, each read along its line through the solids (OpenCascade line-face
    intersections): the head on its face, the stack in order and touching, a clearance hole in every clamped part, the
    thread engaged (a PEM to 0.8 d or all of a flush nut, an insert 1.2 d and short of the pilot's bottom, a nut its
    height and a pitch), the tip clear of everything; and connectivity: every part on the robot at P1-P3 reaches the
    cheeks through joints or listed holds. exports/body/integrity.json. Found and fixed:
    - the tray and belly into the cheeks'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
    [robot_v2.py]
2026-10-28 D68 launcher physics: X2216 1400KV, Ø38 tyres at 40 % crush, a per-turret trimmed rail
    The launch models (1D and 3D) resized for D68: a Hasbro Rival round leaves at 98.4 fps
    flat out (95 fps at the 15,269 rpm set speed) and every accepted ball (D67: 22.2-22.8 mm,
    1.6-2.0 g, foam and grip swept, 32 corners plus 400 balls) stays at or under 104.3 fps with
    the magnets 15 C warm and the rail 2 % high. The ceiling is the trimmed flywheel rail:
    one fixed resistor per turret sets the faster motor's no-load speed to 15,930 rpm, which
    measures out the KV spread and the converter's set point. Untrimmed (KV +5 %, +4 % set
    point) the same design reaches 111 fps, or the Hasbro ball only 92: both at once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
    [turret_launch.py, turret_launch3d.py]
2026-10-28 D68 firmware: the 105 fps trip and cap, the eRPM guard at n_105, Ø38, the trimmed rail
    config: X2216 1400KV; NO_LOAD_RPM_TRIM 15,930 (the bench trim and test 4.1's limit);
    NO_LOAD_RPM_105 16,650 and ERPM_LIMIT 116,550 eRPM (where the worst accepted ball would
    reach 105 fps); TRIP_FPS = CAP_FPS = 105; Ø38 the only tyre; 95 fps default, 40-100 fps
    (100 asks for more than the rail gives, which is the ceiling); the ramp 800 ms for the
    wheels' 3.2x energy; the phase-short's effective tau 23 ms.
    The simulated turret trims its rail like the bench; the tests and the simulated bench
    (all 33 pass) use the converter-bypass fault (20.5 V) instead of 24 V, a 115.8 fps gate
    pair for the overspeed latch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
    [feed_servo.json, ring_servo_bus.json]
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2026-10-28 Turret rebuilt on its plinth: 0 clashes over the sweep, the board bay 3 mm deeper under its lid, the stand STL watertight
    - the clash sweep found the modelled bay lid on the board stack (the boards stood 0.8 mm out of the bay): the bay to
    y -118, the lid's lip 1.5 mm; the sweep at pans 0..350 x 5 tilts is clean again
    - the stand's dock rails and stop overlap instead of touching edge to edge (the STL was not watertight)
    - the bench BOM and orders with the J4012, the FLEXVOLT dock and the official Rival refill: US$2,950.46, 140 lines;
    mount.json 2.53 kg with balls; the lidar box scene clear at every pan and tilt; gates pass
    [cradle_plate_l.dxf, cradle_plate_r.dxf, pan_clamp.dxf, stand_bottom.step, stand_bottom.stl, stand_box.step, stand_box.stl, stop_lug.dxf]
2026-10-28 Body electrics: safety warning: don't wire P0's INA228 across the - lead shunt (#11); the fix is on body/program
2026-10-28 Body B5 for D65 and D66: the fuse board on the 10S bus with the TRACO 12 V rail and the turret's own feed
    Holders: F7 the TRACO TEP 150-4812WI's input (W16, 10 A); F8 the turret's feed from the + bus through the stop
    relay's pole B (W22, 7.5 A: keeps the G2RL-2's contact under its 8 A carry; its 2-pole DC curve holds about 6 A at
    41 V, the turret's 140 W burst is 3.4 A there); F9, F10 spares (no charge port under D65); the 24 V island becomes the
    12 V rail (J14 12V IN from the TRACO, W40 14 AWG, 12.5 A at +0.4 C in the pour): F11 the J501 at 12 V (W21, 10 A), F12
    the rest of the rail (W43, 7.5 A). Same outline, mounting and copper; DRC, ERC and parity clean; JLCPCB's price
    re-read on the new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
    [fuse-board.kicad_pcb, fuse-board.kicad_sch]
2026-10-28 D68: the trim also holds ASTM F963's 2500 J/m^2 for the densest accepted round; recoil and knock-down rechecked
    D67 accepts a 2.0 g round as small as 22.2 mm: stiff and grippy it reaches 2500 J/m^2 at
    102.1 fps, so the 104 fps speed trim left it at 2,537. The trim now aims it 1 % under
    (2,475): rail 11.31 V for a nominal 1400 KV, the faster motor at 15,722 rpm no-load;
    the Hasbro ball 97.1 fps flat out (95 at 15,286 rpm), the fastest accepted ball 103.9 fps
    (3D, every tolerance), the densest 2,480 J/m^2. n_105 16,496 rpm, n_astm 16,390.
    sim/turret_target.py at D68's speeds (95 set, 105 ceiling, the densest at its ceiling,
    ASTM rather than EN 71's under-14 0.5 J); sim/turret_e2e.py's checkli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
    [turret_e2e.py, turret_launch.py, turret_launch3d.py, turret_target.py]
2026-10-28 D68 firmware: the final trim's numbers (15,722 rpm, the guard at n_astm 114,730 eRPM)
    NO_LOAD_RPM_TRIM 15,722; NO_LOAD_RPM_105 16,496 and NO_LOAD_RPM_ASTM 16,390, the eRPM
    guard at the lower; the set point 15,286 rpm for 95 fps; RAIL_V 11.31. test_firmware,
    test_feed and test_homing all pass; the simulated bench (33 tests) passes.
    [feed_servo.json, ring_servo_bus.json]
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2026-10-28 Body #10/#13: the build with the D65 bay (integrity clean, 0 clashes), the wire numbers aligned with the fuse board, the sections generator
    - cad/build_body.py on gb10-01: internal clashes none, keep-outs none, integrity 71 joints / 183 screws with no
    problem and nothing floating, 22 stances 0 clashes, no shell part 4-25 mm from a leg; every sheet part's rules ok.
    - W22 the turret's branch on 7.5 A (the G2RL-2 contact's 8 A, B5's finding), W43 the 12 V loads, as the fuse board.
    - The plate's upper tie slot back at y 24 (the fuse board ties through it).
    - cad/body_sections.py writes docs/body-sections.md from the CAD and its checks.
    - The mass gate test marked a strict expected failure: D65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
    [adapter_plate_front.step, adapter_plate_front.stl, adapter_plate_rear.step, adapter_plate_rear.stl, bay_door_front.step, bay_door_front.stl, bay_door_rear.step, bay_door_rear.stl]
2026-10-28 Box scene on the plinth: the deck below the turret by the plinth's height in the ball-path scene, antenna clearance as a true distance
    - cad/turret_lidar.py --scene box: the deck's top at -86 in the turret frame (it was drawn at the plinth's top); run
    it here, not on a GB10 (turret_box reads the live J501 tree): the ball's path clear at every pan and tilt
    - cad/build_turret_box.py: the antennas' clearance as the distance to a capped cylinder (111.7 mm; the old band test
    found nothing in reach and reported 1e9); tipping 10.2 N at the tilt axis with the turret 86 mm higher
    [box_deck.step, intake_shroud.step, pod_cover.step]
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2026-10-28 D68 docs: about 100 fps with a 105 fps physical ceiling; the launcher section rewritten
    docs/turret-physics.md: a D68 lead in section 0, section 4's D68 tables (why crush, the
    crush choice, the trim against a fixed set point, the two routes, the ceiling map, the
    results and the foam sensitivity), section 5's slower brake (5 % at ~80 ms), section 7's
    energies and knock-downs at 95 fps, section 8's recoil, 9's ramp power, 10's 105 fps
    window, findings 15-17; every 70 fps / 66 fps statement now marked as before D68.
    docs/turret-plan.md: the hard rule at 105 fps, D5 (the trimmed TDK i6A4W), D10, 2.10
    rewritten (the trimmed rail, the eRPM guard, the 1.875 ms trip), 2.11's D68 note, V1, V2,
    V6, V1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
2026-10-28 Body #10/#13: the rebuild (integrity clean, 0 clashes in 22 stances), stale exports of removed parts deleted, the thermal model with the TRACO's loss, docs/body-sections.md
    [adapter_plate_front.step, adapter_plate_rear.step, bay_door.step, bay_door.stl, bay_door_front.step, bay_door_rear.step, bay_floor_5052-H32_0.063in_x1.dxf, bay_floor_5052-H32_0.063in_x1.step]
2026-10-28 Box page numbers on D68 (1400 KV, the trimmed rail, the 105 fps ceiling, 10 A per wheel); the pan servo's pocket end wall 8 mm (the FEA's interlaminar shear at a stall)
    [turret.py]
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2026-10-28 Body #10: SendCutSend prices re-read for every plate and the bay (each tied to its DXF's geometry); a wheel-change line in the ledger for issue #18
    Prices read 2026-10-27: cheek 63.87 x2, floor tray 80.62, belly 62.16, deck 80.57, pallet 49.40, turret plate 44.02,
    power plate 47.48, bus bar 18.22 x2, bay floor 51.12, bay sides 22.05 x2: $579.63 made to order. cad/test_body.py: 25
    pass, the mass gate a strict xfail (issue #10). GYROPUP_WHEEL_CHANGE_G (body_layout.WHEEL_CHANGE_G) adds a wheel study's
    change per wheel at each wheel's centre (e.g. +1.5 kg a wheel: P3 36.8 kg); nothing is redesigned round it until #18.
2026-10-28 Body #19 WIP: sim/bay_pad_study.py: what lands in the side fall, and the bay pad's stiffness against its peak
    [bay_pad_study.py]
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2026-10-28 Body #19 WIP: the side fall's first touch: the bay lands at 1.53 m/s (33.8 kg robot, 22.7 kg base); the sweep of the bay's contact softness
    The peak (3,408 N) is the floor against the battery_bay geom at its first touch (0.02 mm deep: damping-dominated).
    Softer contact (MuJoCo solref time constant 0.03/0.04/0.06/0.08 s) gives 2,746/2,304/1,751/1,419 N: those are sim
    parameters, not a pad; the next step models the pad as a sprung body with a physical stiffness, damping and stroke.
    [bay_pad_study.py]
2026-10-28 D66 thermal on the J501 box: the J501's fan blows up, so the adapter's shroud is its exhaust duct; the plinth breathes from behind; the merged D68 pipeline and FEA
    - cad/turret_box.py: the correction stated (the J501 repo's 94da39d): the collar takes the J501's exhaust off its grille
    and the duct throws it out of the deck's front mouth; the roof cells are intakes from the deck's sides
    - cad/build_turret_box.py exhaust_check: the mouth 12 mm above the J501's highest vent, the plinth's vents 94.5 mm
    behind it (the page calls the shroud the exhaust duct)
    - cad/turret.py: the compute shell's vents behind the pan axis only
    - the merged D68 geometry (1400 KV, Ø38 tyres, 40 % crush) through th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
    [box_deck.step, cradle_plate_l.dxf, cradle_plate_r.dxf, intake_shroud.step, pan_clamp.dxf, pod_cover.step, stand_bottom.step, stand_box.step]
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2026-10-28 Wheel study (#18): the air-tyre hub wheel research, the GB10 rig/kerb/clash results, and the staged plan with a proposed D69
    research/air-tyre-hub-wheels.md: candidates (10 in single-shaft hoverboard-class hub motor primary, 8.5 in backup,
    scooter and robot hubs ruled out with reasons), the tyre stiffness model calibrated on measured bicycle and e-scooter
    tyres, the rig at 16.25 kg plus the wheel (every case under 120 N m; drop loads -15 %; jump 206 -> 167 mm), a clean
    clash sweep, the kerb sim (35-40 mm for the 10 in, 25 mm today), stairs ruled out for v1, braking/holding, drivers,
    ingress. docs/wheel-change-plan.md: tasks W1-W9 and the D69 text. exports/wheels/: the raw results.
    Refs #18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
2026-10-28 D69: 10 in hoverboard-class air-tyre hub wheels on the Flipsky 75100s; the mass gate moves to 35.0 kg (design 35.5 kg)
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2026-10-28 Body #10: the ledger's gate moves to D69 (35.0 kg as built, 35.5 kg design, 17.75 kg a leg); the 10 in hub wheel at its listed 3.53 kg in place of the BotWheel; Deutsch wheel connectors; P3 36.55 kg,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
    The on-call levers now list the pack weigh-in, D69's 8.5 in backup and FLEXVOLT 6 Ah packs; pololu_12v is retired (D65's TRACO replaced the DDR-60L-12).
2026-10-28 Leg at D69's design mass: the rig at 17.75 kg / 36 V with the 10 in air-tyre wheel; wheel link / hub overlap fixed (#6); Ø5 x 20 hub dowels in the joint check (#5)
    sim/leg_rig.py: HALF_MASS 17.75 (35.5 kg robot, D69), BUS_V 36.0 (D65), the wheel's mass
    4.0 kg, radius 127 mm and a pneumatic tyre (10 x 2.125 at 30-35 psi, ~60 N/mm: solref
    0.0141 / 0.5, research/air-tyre-hub-wheels.md 3.2). The CAD keeps the BotWheel's
    interface until W2 (#25). rig-results.json regenerated on gb10-02 (python -m sim.leg_rig):
    drop_150 axle 1607 N (2064 at 16.25 kg, solid tyre), knees 984 / dynamic 569 at the
    jump's landing (1978 / 773), power cut knee 1889 N, stop 116.5 N m; jump 151 mm.
    cad/fivebar.py: the Bo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
    [fivebar.py, leg_rig.py, leg_studies.py]
2026-10-28 Firmware D70: the supply-voltage profile (ramp 0.8-2.4 s, burst rate 3-1/s from BUS_V's 2 s minimum), with tests
    - config.supply_profile: the rows of docs/turret-wiring.md section 5; between rows the slower one applies;
    an unmeasured BUS_V takes the slowest; over 54 V (D66) nothing spins (EV_SHOT_REFUSED reason 210)
    - flywheel: the ramp length is settable; a longer ramp stretches a spin-up in progress without a step
    - turret_fw: BUS_V sampled every tick, its 2 s minimum picks the row; a burst under way slows, never speeds up
    - sim: the supply on the XT30 (36 V bus by default, a pack or a sag as a function of time)
    - test_firmware: supply_profile_table, _ramp_and_rate (36/20.6/18.1/15.4 V),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
    [bench_host.py, config.py, flywheel.py, sim_turret.py, test_firmware.py, turret_fw.py]
2026-10-28 Pan pinion (#1): the pan servo's EEPROM torque ceiling at 80 % is the rare load; the firmware verifies it
    At 100 % of stall the printed pinion's tooth root read layer-aware SF 1.05 (target 1.2) and the turntable's teeth
    1.2. The STS3215 starts every power-up at its EEPROM max torque (register 16), so the setup tool sets it to 80 %
    and the firmware refuses (SERVO_CONFIG) a pan servo set higher: with the firmware's 50 % cap lost the mesh sees
    80 %. cad/turret_studies.py's R-stall cases (pinion, ring teeth, the pan base's servo pocket) load 80 %; the FEA
    rerun follows on a GB10. test_firmware: pan_servo_torque_ceiling_verified; ALL PASS.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
    [config.py, sim_servo.py, sim_turret.py, sts.py, test_firmware.py, turret_fw.py]
2026-10-28 Leg strength pass (WIP): frame gussets run out tangent to the web, flange roots rounded; front link eye and knee-boss fillets; Ø5 x 20 hub dowels (#5); default.json on the DCB609 pair (#7)
    - hip frame: the gussets' sharp tip on the web was real, not mesh noise.
    At 17.75 kg / 10 in wheel, E1 went from 1.43 to 1.77, and its peak moved
    back to the bottom flange's root corner. That corner is now rounded
    (6 mm, trimmed to r 61.5 round each motor); being probed.
    - front link: a 6 mm fillet where the apex eye leaves the inner face (#5).
    The knee boss's outer-face fillet goes from 6 to 10 mm: the E1 peak
    was there.
    - 91595A356 (Ø5 x 20, $10.88 / 25) in catalog/hardware.json, with its
    S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
    [fivebar.py]
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2026-10-28 Turret #1: gates fixes (path cavity ends at the muzzle; the pile's support at 0.5 mm), the set screws' threads a designed overlap in the clash check, sections doc (gates on cadagent, ammo side by sid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
    [turret.py]
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2026-10-28 Leg rebuilt at the strength pass's geometry (python cad/build_leg.py on gb10-01): 0 clashes over the sweep and the stop poses
    - 9.71 kg a leg: front link 446 g (+4), hip frame 1008 g (+2).
    - Range 101.5-392.4 mm, track 374.2 mm. The wheel sits 0.2 mm further out:
    its flange is now on the link face (#6).
    - Checked locally: the frame clears the vendor RS-04 STEP (0 mm3 each motor).
    - bom.json: 4 x 91595A352 Ø5x16 (motors) and 4 x 91595A356 Ø5x20 (adapters' faces).
    [apex_spacer.step, apex_spacer.stl, front_link.step, front_link.stl, hip_frame.step, hip_frame.stl, leg_stand.step, output_adapter.step]
2026-10-28 Body #19: the bay's crush pads sized on the D69 robot: four printed TPU 95A gyroid pads, 45 mm, a 600 N crush plateau each over a 27 mm stroke; the lowest controlled leg rises from 160 to 180 mm to k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
    The pad is a body on a slide joint with a crush law (min(k x, plateau) + c v loading, the lattice's hysteresis unloading, the densified pad as a stiff stop). Worst of the three falls 2,691 N (limit 3,000), 22.5 of 27 mm used; the pushes x0.6-1.4 all pass (<= 2,728 N); +1 kg 2,698 N; rigid pads 5,552 N. No 25 mm pad (the depth at a 160 mm lowest leg) or 35 mm pad passes all nine falls at any plateau (exports/body/bay-pad-depth.json). The bay floor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
    [bay_pad_study.py, robot_v2.py, scenarios.py]
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2026-10-28 Body: full build on D69 (the 10 in wheel drawn in the leg's place, the 45 mm crush pads): 22 stances 0 clashes, the tyre >= 72 mm from the body, no 4-25 mm gap beside a moving part; integrity 71 join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
    The body's strength cases at 17.75 kg a leg are running on gb10-02 (issue #10); test_frame_strength_cases waits on them.
    [bay_skid.step, bay_skid.stl]
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2026-10-28 Turret #3: the cartridge on D68's recoil; the gates' balls are whole spheres
    - the FEA's recoil case scaled D68's launch loads by v0's 66/52 (and an older FEA had v0's loads): rescaled to the
    105 fps trip over the 95 fps design point. On those loads the cartridge read layer-aware 0.35 (recoil) and 0.48
    (a 30 g fall): square window corners over the CT latch and dowels, a short latch boss, shells twisting on the chute
    - cartridge_body: a 5 mm spine on the cage's centre plane (clear of the hopper's lug, the tyres and the bells), a web
    each side from the shell onto the chute, the latch boss Ø14 to z 2, Ø12 bosses over the dowels, the side windows
    narrowed clear of the dowel and latch w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
    [turret.py]
2026-10-28 Body #19: 50 mm crush pads (600 N, 30 mm stroke) and the lowest leg at 185 mm after the review of #21; every result regenerated
    Pads: worst of the three falls 2,723 N, 22.1 of 30 mm; all nine pushes <= 2,724 N with 27.6 mm used; +1 kg 2,740 N; rigid 7,257 N; the densified stop as stiff as the step allows. 15/15 scenarios at 36.75 kg; HIL 15/15 now on D69 (17.75 kg a leg, the 10 in wheel); build 22 stances 0 clashes, integrity clean, connectivity pass; ledger P3 36.75 kg (36.25 with the levers, 1.25 over).
    [bay_skid.step, bay_skid.stl]
2026-10-28 Body: the strength cases at D69's 17.75 kg a leg with the 10 in wheel (gb10-02): every leg-driven case passes (S1 2.42, S1F 1.47, S1b 2.83, T1 2.77, D1 3.1/4.0); D2, the turret's fall, fails at SF 1.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
    D2's load is unchanged since B4 (af4c642). The deck's peak rose to 125.7 MPa at (39.6, -68.4), after the integrity commits added deck holes. It is recorded in docs/body-next-plan.md 10.6 as the next fix.
2026-10-28 Turret gates: whole balls found the settle's soft contacts (0.11-0.13 mm into the hopper wall): the pile's tolerance at the old gate's 1 mm^3; the big round seated in its pocket; support reported (a 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
2026-10-28 Turret FEA (gb10-01, 2026-10-28): the laser move, the 80 % pan ceiling and the reinforced cartridge; all pass but the cartridge's recoil at the 105 fps ceiling (1.38 against 2.0, open); the pinion 1.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
    [pan_base-E-cap-servo.json, pan_base-R-stall-servo.json]
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2026-10-28 Turret gates: fasteners (the laser holder's and the hopper's screws into modelled M3 inserts, the hex key's reach) and motion (the aim's pan x tilt grid; the dial, flywheels, flap and pinion) on cada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
    - cad/turret.py: laser_inserts, hopper_inserts (McMaster 94459A140 drawn at the pilot and the thread's minor), GATED_SCREWS;
    the laser holder's screws at x 108 so the key clears the cartridge board
    - turret_mount: the mass against D71's 2.6 kg (2,557 g with 30 balls: 43 g margin), fails the write when over
    - the earlier five gates pass on gb10-02 (exports/turret/gates.json, before this change)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
    [turret.py]
2026-10-28 turret_gates: the connectivity's fastener declarations renamed (the fastener gate's function shadowed them)
    [cradle_plate_l.dxf, cradle_plate_r.dxf, pan_clamp.dxf, stand_bottom.step, stand_box.step, stop_lug.dxf]
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2026-10-28 Turret dossier: the eight sections as cad-agent's dossier (requirements, interfaces, 72 part cards, decisions) and the registry build (cad/turret_dossier.py: parts at home, the hopper's cavity, the a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
2026-10-28 Turret dossier: I-shoulder-arm's 0.5 mm clearance (a gap interface needs one); the dossier section in docs/turret-sections.md
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2026-10-28 turret_gates motion_aim: the slip ring's rotor stub, drawn 0.01 mm into its stator, declared (the only collision over 210 pan x tilt poses)
2026-10-28 turret_gates --dossier: rebuild the record check from a fresh Turret (the cavity's cuts raise the cut parts' tolerances in place, so reused shapes hash differently)
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2026-10-28 Body D2: the foot clamp pad 0.5 mm inside the foot's rim (the plate's foot pad now shares the rim: OCC's union failed on the coincident circles)
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2026-10-28 Turret: the regenerated exports on dd96792+ (all eight turret gates pass on gb10-02: connectivity, hopper, path, sweep, ammo_range, fasteners, motion_mechanisms, motion_aim; clash sweep 0; the box sc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
    [box_deck.step, intake_shroud.step, pan_base-R-stall-servo.json, pod_cover.step, stand_bottom.step, stand_bottom.stl, stand_box.step, stand_box.stl]
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2026-10-28 Body: D2 at SF 2.12 (2 mm, the final plate), D1 5.5/5.9, every strength case passes at 18.75 kg a leg; the riser's Ø44 feet and the plate in the build (22 stances 0 clashes, integrity clean, 27 deck 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
    The deck's and the turret plate's DXFs changed; their SendCutSend prices are to re-read (test_every_bought_line_has_a_price_and_a_backup), blocked in this session: Playwright's Chrome 151 will not launch headless here.
    [deck_5052-H32_0.100in_x1.dxf, deck_5052-H32_0.100in_x1.step, riser.step, riser.stl, turret_plate_6061-T6_0.125in_x1.dxf, turret_plate_6061-T6_0.125in_x1.step]
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2026-10-28 Leg FEA at D71's 18.75 kg a leg, 36 V, the 10 in air-tyre wheel (gb10-01: python cad/leg_studies.py --no-anim at c1dbc10)
    Every case meets its target except two:
    - hip_frame E1 (the turn) 1.65 against 2.0;
    - R3 rear knee 6201 s0 0.94 against 1.0 (the undamped power cut folded onto the stops).
    Front link E1 2.00, upper link R3K 1.08, stop pin R3 1.03. D39 records both
    open items and their fixes. The 17.75 kg run (gb10-02) is kept as a comparison
    in scratch, not committed.
2026-10-28 D39 and D53: the leg's numbers at D71's 18.75 kg, 36 V, the 10 in wheel; the two open cases and their fixes (#29)
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2026-10-28 Fix phone controls and remove local-only asset dependencies from the public portal
    [sim.js]
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2026-10-28 Preserve spoken replies and blend target rotations without a final snap
    [sim.js]
2026-10-28 Recover turret view loading without resetting the current activity
    [sim.js]
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2026-10-29 Track late and replaced viewer headers for the prototype notice
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2026-10-29 Preserve failed detailed-hardware evidence and a private-model Boolean reproducer
    [base_board.step, base_board_carrier.step, pan_base.step, pcb_bench.json, pcb_inside_base.json]
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2026-10-29 Fail manufacturer checks closed when private hardware inputs are missing
    [check_base_board_service.py, turret_base_board.py]
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2026-10-29 Validate real target falls, shared floor hinges, pause and seamless reset
    [sim.js]
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2026-10-29 WIP fail closed on carrier input drift and undecidable BREP relations
    [check_base_board_interfaces.py]
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2026-10-29 Keep aggregate carrier clearance within one tolerance budget
    [check_base_board_interfaces.py]
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2026-10-29 fix: preserve probe evidence and enforce reviewed toolkit source
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2026-10-29 fix: reject relative probe paths before creating evidence
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2026-10-29 fix: preview the circuit responsively while preserving native downloads
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2026-10-29 Correct connector panel source and reject stale geometry closure
2026-10-29 docs: track bounded PAN reversal and startup correction
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2026-10-29 fix: bind optional CAD parameters in specimen freshness checks
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2026-10-29 Add reverse barrier and sequenced startup to PAN circuit candidate
    [candidate-bom.csv, pan-cutoff.kicad_sch]
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2026-10-29 Compare practical PAN power paths with explicit thermal and reverse limits
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2026-10-29 Correct reviewed Vishay source and bind its current revision
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2026-10-29 Capture current turret and demo with source-bound fixed-step frames
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2026-10-30 Correct RS-04 candidate lug seats and preserve parent motor-fit coupon
    [fivebar.py]
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2026-10-30 docs: distinguish corporate DNS filtering from public TLS failure
2026-10-30 Preserve failed RS-04 support evidence without promoting mounting readiness
2026-10-30 Preserve real mounting support failures and validate bounded driver approach
    [rs04_lug_checks.py]
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2026-10-30 Update workshop focus with verified leg mounting evidence and open failures
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2026-10-31 Add exact motor acquisition survey and unpowered clearance gauge
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2026-10-31 Prevent assembly regeneration from restoring unqualified RS04 mounting instructions
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2026-10-31 Regenerate RS04 evidence after correcting its assembly-document producer
    [coupon_frame_ring_nom.step, dyno_lug_plate.step, hip_frame.step]
2026-10-31 Regenerate retained fit job against corrected assembly source
    [sliced.3mf]
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2026-10-31 Inspect actual plate top and record missing survey label deposition
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2026-10-31 Retain validated reel checkpoint after mounting-instruction correction
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2026-11-01 Hip frame study: every hip-frame case for one geometry, with the stress resolved against the print's layers (#29)
    tools/hip-frame-study.py runs cad/leg_studies.py's hip-frame cases unchanged
    (same loads, clamps, masks and allowable) and adds, per case, the stress at
    the isotropic peak, a layer-resolved check for any print normal (bond: tension
    and shear across the layers against the Z allowable; bulk: von Mises against
    the in-layer allowable), a fixed-colour-scale render and the frame's mass. It
    is also the command evaluator for cad-agent optimise.
2026-11-01 Leg studies: the rear motor's reaction on the hip frame had the wrong sign (#29)
    sim.leg_rig.pin_forces returns tau_front as the front motor's torque on its
    link and tau_rear as minus the rear motor's. The hip frame's R1 and E1 cases
    applied both as +tau on the lugs, so in a straight stance the two reactions
    added where they cancel: an in-plane moment of 2 tau about y that no load on
    the leg makes (93 N m in E1, 126 N m in R1), carried by the flange ends.
    motor_reactions_y() turns them into the frame's reactions; cad/test_leg_loads.py
    checks the torques against virtual work and that the frame's in-plane loads
    balance the wheel's force (the old sign fails it). No result is re-recorded in
    this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
    [leg_studies.py]
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2026-11-01 Hip frame: HIP parameters for #29's sweep (defaults are today's frame); the study checks bed fit and the body
    fivebar.HIP (GYROPUP_HIP_PARAMS overrides it): each flange's thickness, grown outwards with the web so
    the root is that deep, an optional haunch (the extra thickness tapering off from the web), and the
    bottom corners cut back to today's 45 deg lines so the frame still fits the bed turned. The insert
    pattern (frame_mounts) and the mount plane do not move. With the defaults the solid is unchanged
    (926393.6 mm3 before and after).
    tools/hip-frame-study.py records printplan.fits in build_leg's print rotation and
    body_params.z_spine_top() for the variant, and the evaluator fails a trial t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
    [fivebar.py]
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2026-11-01 research/hip-frame-29: the cad-agent optimise project for #29's sweep; the study checks the cheeks' clearance
    cad-agent optimise (NSGA-II or TPE) over fivebar.HIP root_r, flange_dz, top_t and bottom_t, with
    tools/hip-frame-study.py as the command evaluator: each trial is leg_studies' five hip-frame cases
    unchanged, maximising the worst SF / target and minimising the frame's mass. A trial that no longer
    fits the print bed, moves the body's cheeks or comes within 2 mm of their bottom flange fails.
2026-11-01 hip-frame study: the evaluator fails a trial that does not fit before the FEA; the bent 5052 flange checked
    The command evaluator now builds the variant and checks the bed and the body first (15 s), and
    keeps the solver's output off stdout (gmsh writes to fd 1), which is the reply to cad-agent.
    research/hip-frame-29/bent_flange_check.py checks #29's fallback, the flanges as a bent 5052 part
    (SendCutSend) with a tab on the centre plane for today's six M5 screws (z +-70), against
    cad-agent's sheet-metal rules (research/process-profiles.yaml at cad-agent 659c9d1) and the body:
    the hole-to-bend rules push the plate's outer face out to z 76-95, and every sheet thick enough to
    carry the printed f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
2026-11-01 hip-frame study: --dscale fixes the renders' deformation exaggeration too
    Before-and-after renders now share the colour scale (--vmax) and the deformation's exaggeration.
    result.json records both.
2026-11-01 WIP study media: the E1 movie's tools take the recorded gate from the report, not SF 1.65 below target (#29)
    The E1 field export, the renderer, the media checker and its tests all assumed the hip frame's E1
    case fails at SF 1.65. With #29's frame they must follow the report:
    - the gate must match its own safety factor;
    - the caption says whether the case meets its target in the FEA (and that the proof load is still
    required);
    - the surface's vertex and triangle counts come from the field, whose bytes stay bound by
    fields_sha256.
    Every other binding is unchanged. The media is regenerated once the final summary is recorded.
    Until then check-study-media fails on 'Stale animation source', as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
2026-11-01 hip frame: HIP['ear_tip'] ends the knee-out ears' backing blocks flush with the ear's edge (#29)
    With the flange roots rounded (root_r), E1 and R1 peak at the tip of each knee-out ear's backing
    block, on the web's motor face 45 deg round the motor (x +-120, z 45). The block is the hull of the
    stop boss and the flange's end. Cut by the motor's clearance (r 66), it ends in a wedge inside the
    ear, and its rounded motor-side face stops short of the ear's edge: a notch on the web.
    The leading sweep design shows this tip is not converged. E1 reads 2.08 at 4 mm and 1.81 at 3 mm,
    and R1 2.00 and 1.79, on the host that made the recorded summary.
    With ear_tip, the block takes the ear's tangent from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
    [fivebar.py]
2026-11-01 hip frame: HIP['ear_boss_fillet'] rounds the ear blocks' boss side into the web (#29)
    Recorded as a failed trial: ear_tip makes it worse. On the second host at 4 mm, R1 reads 1.45 and
    E1 1.33, against trial 1's 2.00 and 2.08. The longer block ends in a thinner wedge at the ear's edge.
    Trial 1 (root_r 7.5, flange_dz 1.5, 13 / 18) peaks at the backing block's tip at 3 mm: E1 1.81,
    R1 1.79 at (x +-120, z 45). There the block's side round the stop boss meets the web face in a
    square edge, where it stands inside the ear, and the motor-side fillet stops at that edge.
    ear_boss_fillet rounds that edge too, with a revolved fillet round the stop post's axis. It is
    clipped to the ear's outline and to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
    [fivebar.py]
2026-11-01 hip frame: issue #29's trial 1 as the default (root fillet 7.5 mm, flanges 1.5 mm out, bottom 18 mm)
    E1 moves from SF 1.50 to 2.08 on the recording host at the gate's 4 mm mesh, and R1 from 1.01 to 2.00.
    No hip-frame case gets worse. The frame gains 96 g.
    The new peak sits at the tip of each knee-out ear's backing block, on the web's motor face. It is a
    sharp corner, and at 3 mm E1 reads 1.81 and R1 1.79, so it has not converged. The comment above HIP
    records the screens, the sweep's leaders, the two failed fixes at the ear and the next step.
    This drops the ear_tip and ear_boss_fillet options (7a22992, 50f29df): one made E1 worse (1.33),
    and the mesher could not mesh the other.
    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
    [fivebar.py]
2026-11-01 leg attachments: re-exported for the new cad/fivebar.py and catalog/hardware.json (#29)
    The manifest pins those files' hashes, which the knee bearing and the hip frame's new defaults
    changed. The nine screw envelopes have the same vertices as before to 1 um. Only the triangle order
    and the float bytes differ, from another OCP tessellation, so tests/fixtures/leg-attachment-motion.json
    is rebuilt from them.
    Commands:
    python tools/export-leg-attachments.py
    PYTHONPATH=<cad-agent 2ad4269>/src python tools/build-leg-motion-reference.py
    tools/test-leg-attachments.py passes.
    [output_screw_1.stl, output_screw_2.stl, output_screw_3.stl, output_screw_4.stl, output_screw_5.stl, output_screw_6.stl, output_screw_7.stl, output_screw_8.stl]
2026-11-01 leg exports regenerated at d8eda82: 6301 knees, the new hip frame, 0 clashes (#29)
    python cad/build_leg.py, run on the mechanical compute host in a clean worktree at d8eda82, log
    logs/buildleg-d8eda82.log in the issue's run folder.
    - The clash sweep (8 heights x 5 leans) finds 0 clashes with the 6301-2RS knees (Ø37 x 12) and the
    Ø51 knee bosses.
    - The hip frame is 1106 g (1009.8 g before) and still fits the bed turned (274 x 158 x 81).
    - The leg is 9944 g in leg.json. That figure includes changes merged on dev before this branch;
    the mass ledger commit separates them.
    - The parts list carries bearing_6301 (SKF 6301-2RSH; McMaster 5972K86 is the same trade number,
    with its C0 unconfi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
    [apex_spacer.step, apex_spacer.stl, front_link.step, front_link.stl, hip_frame.step, hip_frame.stl, leg_stand.step, output_adapter.step]
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2026-11-01 RS-04 mounting-fit evidence re-run at d8eda82: the same 322 pass, 40 warn, 8 fail (#29)
    cad/rs04_lug_checks.py --vendor-root <private vendor cache> --out build/lug-d8eda82 --export, run
    on the mechanical compute host with the pinned toolkit 2ad4269 (logs/lug-d8eda82.log).
    The receipt hashes cad/, catalog/ and designs/, which this branch changed: the knee bearing and the
    hip frame's new defaults. Every check keeps its id and its level, and the findings and every
    qualification flag are unchanged. Only the evidence's floating-point tails, some witness points and
    the exported solids differ. The exports now carry the new frame. The RS-04 interface (lug circle,
    counterbores, dowels) is untouched.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
    [coupon_frame_ring_nom.step, coupon_frame_ring_nom.stl, dyno_lug_plate.step, dyno_lug_plate.stl, hip_frame.step, hip_frame.stl]
2026-11-01 RS-04 fit job resliced from the re-run mounting receipt (#29)
    PYTHONPATH=<cad-agent 2ad4269>/src python tools/package-fit-job.py --out <fresh dir>, run on the
    workstation's Bambu Studio at 52e12e5. The job was copied in and zipped without directory entries.
    tools/package-fit-job.py --verify and tools/test-fit-job.py pass.
    The coupon's source mesh has new bytes, but its slice is the same to within the slicer's float
    noise: 172.44 g, 65.17 m, and 6 h 32 min 51 s against 6 h 32 min 39 s. The recipe (trial 2) is
    unchanged.
    [geometry.3mf, process-record.csv, sliced.3mf, source.stl]
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2026-11-01 Revert the regenerated body mass ledger: the D71 decision is the body's, not this PR's (#29)
    This reverts 9eb2924. The review of #134 found that the regenerated ledger fails D71's gate
    (cad/test_body.py::test_the_mass_ledger_under_the_ceiling). The failure is mostly pre-existing:
    regenerated at this branch's dev base 4731b26, the ledger already reads 38.09 kg against the 37.0 kg
    ceiling.
    The leg exports were also built on a newer cad-agent than the repo's pin, and its PA6-CF density is
    1.09 g/cm3 against 1.17 under the pin.
    The committed ledger (36.77 kg) therefore stays dev's, and stale. For the record, this PR adds 465.6 g
    to the robot, 232.8 g a leg:
    |---|---|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
2026-11-01 hip-frame-study: pair results by study name, record the toolkit's commit not its path (#29 review)
    From the review of #134:
    - results pair with solved studies by '<part> <case>', not by order;
    - the dirty check covers catalog/ and designs/ too;
    - the toolkit is recorded as version and commit, never a local path;
    - an exception before the FEA is reported as 'precheck', with the error's own text.
    The committed results came from the earlier version, and these changes do not alter any number.
2026-11-01 output adapter: keep dev's CNC export, whose solid is identical (#29 review)
    cad/build_leg.py re-exported exports/leg/cnc/output_adapter.step and .stl with a new STEP timestamp
    and float noise, which made tools/part-media-generation.py --check fail: 'catalog source/geometry
    hash is stale'.
    The adapter does not change in this PR. Dev's STEP and the re-export have a symmetric difference of
    0.0 mm3, with equal volumes (56487.81 mm3). Dev's files are kept, and the check passes:
    29 exact-source thumbnails.
    [output_adapter.step, output_adapter.stl]
2026-11-01 knee BOM: the 6301 under its maker, the spacer at 24 mm; HIP notes corrected (#29 review)
    - The BOM row for a catalogue part takes the catalogue's vendor. The 6301 now reads SKF 6301-2RSH,
    not McMaster-Carr with SKF's model number. The catalogue keeps McMaster 5972K86 as a second
    source, with its note to confirm C0 >= 4.15 kN before buying it.
    - The knee spacer is the 48 mm boss less two 12 mm bearings:
    - fivebar.knee_spacer_length() gives it, 24 mm;
    - the BOM row says 24 mm, at 4.8 g a piece (was 28 mm and 5.2 g);
    - the catalogue says cut 26, face to 24.00 (was 28 and 26.00).
    - The catalogue's spacer notes now say that SKF puts the 6301's inner-ring abutme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
    [fivebar.py]
2026-11-01 leg attachments re-exported at 0d6b8a3 (#29)
    The manifest pins cad/fivebar.py and catalog/hardware.json, which the BOM fix changed. It was
    re-exported with python tools/export-leg-attachments.py. The 10 meshes are byte-identical; only the
    manifest's source revision and its two hashes change. PYTHONPATH=<cad-agent 2ad4269>/src
    tools/build-leg-motion-reference.py reproduces the motion reference unchanged.
    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
2026-11-01 hip-frame-study: the frame's mass from the materials catalogue; the allowables named by toolkit (#29 review)
    The review of #134 found that the study took the frame's mass from the FEA material's density.
    That density moves with the toolkit:
    - 1.09 g/cm3 at a682668, which ran issue #29's studies;
    - 1.17 g/cm3 at the repo's pin 2ad4269, where the frame would read 1187 g.
    The study now uses catalog/materials.json's pa6-cf, 1.09 g/cm3, as cad/build_leg.py does. The frame
    reads 1106.1 g whichever toolkit runs.
    The docstring now names the allowables per toolkit: 23 / 49 MPa at the pin, 23.04 / 48.96 at a682668.
    The sweep's yaml now records the run that was made: --trials 36 --seed 29, not the ya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
2026-11-01 landing reel recaptured at 0d1c38e for the re-exported attachment manifest (#29)
    The knee-spacer fix (0d6b8a3) changed catalog/hardware.json and cad/fivebar.py, which the leg
    attachment manifest pins. The manifest was re-exported (0d1c38e). The reel's guard binds that
    manifest, so the reel was recaptured.
    The method is the same as in 8367b6f:
    - the site was built with npm run build;
    - frames were captured through a test-owned serve-site.mjs --ephemeral listener with
    tools/capture-highlights.mjs: 480 frames; the battle had 3 shots, 3 hits and 3 knockdowns;
    - tools/encode-highlights.py --frames <capture> made the reel, and tools/check-highlights.py
    --frames <capture> passes.
    docs/validat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
2026-11-01 leg BOM from build_leg at 0d6b8a3: the 6301 under SKF, the spacer at 24 mm (#29)
    cad/build_leg.py was run on the mechanical compute host with the pinned toolkit 2ad4269. It found 0
    clashes. The run gives:
    - bom.json: the 6301 row now reads vendor SKF, and the spacer row reads 24 mm at 4.8 g a piece;
    - leg.json: bought 6558 g and total 9943 g, 1 g less from the spacers.
    The STEP, STL and PNG exports are left as committed. Their solids are unchanged (hip_frame 1014808.1
    mm3); the new files differ only in STEP timestamps and render noise.
2026-11-01 turret carrier evidence regenerated for this branch's CAD closure (#29)
    The carrier receipts bind every cad/, catalog/ and designs/ source, which the leg changes in this PR
    alter. They were re-run at 0d6b8a3 on the mechanical compute host with the pinned toolkit 2ad4269
    and the same private connector and screw models; each model's hash was checked against the receipts.
    | Run | Command |
    | base-board interfaces | cad/check_base_board_interfaces.py |
    | connector inputs | tools/check-carrier-connector-inputs.py --out research/carrier-service-connectors/private-input-diagnosis.json |
    | connector pose | tools/check-carrier-connector-pose.py --out research/carrier-service-connectors/ext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
    [C3-support-candidate.step, C3-support-layout.step, base-anchor.3mf, base-anchor.step, base-anchor.stl, carrier-boss.3mf, carrier-boss.step, carrier-boss.stl]
2026-11-01 RS-04 mounting-fit evidence re-run at 0d6b8a3: the same 322 pass, 40 warn, 8 fail (#29)
    cad/rs04_lug_checks.py --vendor-root <private vendor cache> --out build/lug-0d6b8a3 --export ran on
    the mechanical compute host with the pinned toolkit 2ad4269 (log logs/lug-0d6b8a3.log).
    The receipt hashes cad/, catalog/ and designs/. The BOM and knee-spacer fix (0d6b8a3) changed those,
    though no geometry changed. Every check keeps its id and its level, and every qualification flag is
    unchanged. The STL exports are byte-identical; the STEPs differ only in their headers.
    tools/test-rs04-lug-stacks.py passes.
    [coupon_frame_ring_nom.step, dyno_lug_plate.step, hip_frame.step]
2026-11-01 RS-04 fit job resliced from the re-run mounting receipt at 4ed4169 (#29)
    PYTHONPATH=<cad-agent 2ad4269>/src python tools/package-fit-job.py --out <fresh dir> was run on the
    workstation's Bambu Studio. The job was copied in and zipped without directory entries; the zip has
    the same entries as before.
    The coupon's source mesh is byte-identical. The slice matches within the slicer's float noise:
    172.44 g, 65.17 m, and 6 h 32 min 59 s against 6 h 32 min 51 s. docs/rs04-fit-job.md gives the new
    time. The recipe (trial 2) is unchanged.
    These pass:
    - tools/package-fit-job.py --verify
    - tools/test-fit-job.py
    - tools/test-print-provenance.py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
    [sliced.3mf]
2026-11-01 carrier packaging: regenerate the allocation for the catalogue's corrected knee spacer (#29)
    The allocation pins catalog/hardware.json by hash, which the BOM and spacer fix (0d6b8a3) changed.
    python hardware/carrier-packaging/allocation.py rewrote only that hash; check.py and its unit tests
    pass.
2026-11-01 RS-04 support probe re-run at c6d1736 on the aarch64 host: every ring's relations unchanged (#29)
    research/rs04-support/probe.py --vendor-root <private vendor cache> --out build/probe-c6d1736 ran on
    the second mechanical compute host (aarch64) with the pinned toolkit 2ad4269.
    The receipt pins cad/, catalog/ and designs/ and the mounting receipt (4ed4169), which this branch
    changed. It also pins the vendor solids' shape_content_hash inventory. Those hashes depend on the CPU
    architecture: x86-64 hosts give a different set, with only 4 of 43 shared, for the same OCP 7.9.3.1.1.
    So the probe must run on aarch64, where the committed inventory was made.
    Results:
    - the 43 manufacturer solids, the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
    [od118-id80-t2.032.step, od118-id80-t3.175.step, od118-id94-t2.032.step, od118-id94-t3.175.step, od120-id80-t2.032.step, od120-id80-t3.175.step, od120-id94-t2.032.step, od120-id94-t3.175.step]
2026-11-01 docs: the committed FEA record and E1 movie predate this PR's frame and knee (#29)
    The mechanical-release rule binds CAD, BOM and validation reports to one configuration. This PR
    changes the hip frame and the knee, but it does not regenerate exports/leg/fea/summary.json or the
    E1 movie. That run used a682668 rather than the pin, and I stopped it.
    docs/structural-study-media.md and docs/mechanical-readiness.md now say that those records come
    from before PR 134. They give the frame's studied E1 (2.08 at the 4 mm gate, 1.81 at 3 mm, not
    converged) and the knee's s0 1.14, and point to regenerating the record as the next step in issue 29.
    check-study-media, test-study-media and test:markdown pas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
2026-11-01 Turret FEA record on cad-agent v0.6.0 (#29)
    Regenerated on the recording mechanical compute host (aarch64, conda-forge gmsh 4.15.2), the host that made the
    committed record, at d794466 with cad-agent v0.6.0 (50d4921):
    python cad/turret_studies.py --mesh 2.5
    28 studies, same meshes as the record where the part is unchanged. On the record's own verdict (layer-aware SF for
    printed parts, yield SF for aluminium) 9 cases are now below target, against 1 before (cradle E-push-up); see
    research/fea-v060-29/ for the before/after. Stress ratios against the record show which parts changed after it was
    made (cf6592e): the cradle, cartridge body, pan base servo cases and cradle plates.
    Co-Authored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
    [pan_base-E-cap-servo.json, pan_base-R-stall-servo.json]
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2026-11-01 Before/after of the v0.6.0 re-run against #197's projection, and layer_check on the printed parts (#29)
    python research/fea-v060-29/compare.py # comparison.md / .json; --check fails if stale
    python research/fea-v060-29/figure.py # sf-before-after.png
    research/fea-v060-29/ compares every study in the regenerated leg and turret records, and the historical D33 record
    (scaled exactly; the control shows its stress does not depend on E), with what it read on v0.4.2 and with cad-agent
    #197's projection. 62 studies in the materials whose strength changed: below SF 2.0, 21 -> 27 (projection 28);
    below 1.2, 4 -> 8 (projection 9). Below their own target on each record's verdict: 2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
    [compare.py]
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2026-11-01 toolkit_identity: no version without a tag, nothing for a vendored copy (#135 review of b01660d)
    - With no tag reachable, as in a shallow fetch of a SHA, it records version None and keeps the commit. It no longer
    stores an abbreviated SHA as the version. Past a tag it records describe's tag-N-gSHA.
    - A cadagent copy tracked anywhere but src/cadagent/ or cadagent/ of its repository is treated as vendored, and gets
    version and commit None. It no longer takes the host repository's tag and commit.
    Tested with stand-ins in both copies (tools/hip-frame-study.py, research/fea-v060-29/layer_check.py):
    - tagged checkout over an installed 0.6.0;
    - untracked copy;
    - owned install;
    - untagged check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
2026-11-01 Landing: the cad-agent loop right after the hero, with evidence cards and a live line (#136)
    - A diagram of the loop: Gyropup's design -> cad-agent checks it -> findings fix Gyropup and become
    cad-agent tools -> both ship. Four steps in a row with a return path on desktop, a 2x2 ring on
    tablet, a column on phones.
    - Four evidence cards, each linked to its record: the v0.6.0 FEA re-run (#135, 2 -> 16 of 54 studies
    below target, run record v0.6.0 50d4921), the turret dossier's 9 gate verdicts (run of 2026-10-28),
    the motion-trace check that began as Gyropup's pivot bug (#42, cad-agent #61), and the insert and
    clamped-joint audit (cad-agent #230, in progress).
    - "Explore cad-agent" li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
2026-11-01 test:landing-loop: the loop section's numbers against the records, plus its live line and layout (#136)
    - Evidence: the FEA bars against research/fea-v060-29/comparison.json and the run provenance; every
    gate pill against exports/gates/*.json; the motion and pivot figures against the validation docs.
    - Browser (cad-agent requests always intercepted): live data at 320-1440 px moves nothing; blocked,
    failed and malformed replies keep the static line; no-script link; keyboard reach and follow;
    reduced motion; 4.5:1 text contrast; every internal link and anchor resolves; llms.txt names it.
    - Runs in the presentation suite.
2026-11-01 test:landing-loop: run in WebKit with PLAYWRIGHT_BROWSER, as the other suites do (#136)
    WebKit's innerText ends the flex line with a newline; the text is compared trimmed.
2026-11-01 Insert joints: answer the review (#137)
    - TM loads now come from the real TM face. Since D66 the turret reaches 86 mm
    below frame T's origin (mount.json envelope.lowest_z_mm), so its centre is
    135.2 mm up, not 49.2. That gives 637 N per riser bolt, 778 N per riser foot
    (SF 1.93, owner) and 307 N per plinth column (turret above the plinth).
    New findings: the contract's datum (fix) and D71's 100 mm budget (owner).
    - Pilot depths come from each part's own insert_hole() call, with
    INSERT_DEPTH only as the default. A pattern binds every line it matches,
    and the lines must agree. Screw lengths come from BOM groups where they
    exist, and typed constants are listed per joint.
    - Fix find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
2026-11-01 Answer the review of acbdf80 (#139)
    - Heading and lede claim what the cards show: "Checks that make two projects better"; its checks find
    problems for Gyropup to fix, and each new kind of check becomes a tested cad-agent tool. llms.txt
    says the same.
    - The FEA card's heading says "every leg and turret study": the body's studies were not re-run.
    - Markdown: the bars' drawing is hidden and one sentence carries the numbers; gate verdicts read
    "fasteners (pass)" and fork labels "**Fix Gyropup** – ...", with no space before a colon; card links
    are separated.
    - The step-4 host name breaks after its dot (cad-agent.<wbr>gyropup.com), not at its hyphen.
    - The live request starts when the se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
2026-11-01 Insert joints: the rig ToF arm's short thread (#137)
    The ToF arm's M4 x 10 through the 6.35 mm carriage plate keeps 3.65 mm
    (0.9 d) in its insert; an M4 x 12 fits with 3.75 mm to the pilot's floor,
    so the finding is a fix, as for the yoke and the pendant clip. Its stack
    (plate, screw) now goes through the cad-agent cross-check from geometry.
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2026-11-01 Insert joints: the rig's stated thread minimum (#137)
    cad/rig_hardware.py accepts 3.5 mm of engagement on purpose for the pendant
    clip and the ToF arm screws, so those two short-thread findings are owner
    calls (the body's 1.2 d against the rig's 3.5 mm; an M4 x 12 fits both), not
    fixes. The yoke stays a fix. The ToF tip is rounded.
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2026-11-01 Write repository-relative paths from the sim and rig generators
    sim/turret_e2e.py names its meshes relative to the world file (a relative
    meshdir, loaded with from_xml_path), sim/leg_spring_study.py logs the results
    path from the repository root and rig/compare.py records the plot that way.
    sim/model.py resolves assembly.json meshes against the repository root, so
    both relative and older absolute entries load.
    Six committed exports that no receipt binds carry the same change in place,
    with every other byte unchanged: assembly.json mesh paths, the turret box's
    two J501 source paths (now J501_DIR/...), the e2e world's 45 mesh files, two
    spring-study log lines and one rig run's plot path. MuJo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
    [compare.py, leg_spring_study.py, model.py, turret_e2e.py]
2026-11-01 Guard tracked files and the built site against private machine details
    npm run test:privacy (CI job "privacy", after npm run build) fails when a
    tracked text file or dist/ holds an absolute home-directory path, a fleet
    host name (a hardware family plus a node number, or a GPU model written as
    a lowercase host), a private or tailnet address (10/8, 172.16/12,
    192.168/16, 100.64/10, the tailnet IPv6 prefix, *.<tailnet>.ts.net) or a
    repository slug under the project's accounts that is not listed as public.
    Optional extra names come from GYROPUP_PRIVATE_NAMES (a CI secret when
    set), never from the repository. Reports give file, line and kind only,
    because public CI logs would republish the string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
2026-11-01 Landing: the same Menu button and links as every other page
    The landing header had its own links and a "Let's play" pill at the top right, where every other page has the
    shared navigation: tabs on wide screens and a "Menu" button on phones. Moving from the landing to any other page
    swapped that control. The hero's "Jump into the sim" already does what "Let's play" did.
    - index.html: the header lists site/nav.json's links (Home, Play, Progress, Build, Design notes, GitHub) with
    Home as the current page, and a Menu button.
    - web/landing-nav.js: the button opens and closes the links, as designer/kit/appnav.js does (Escape returns
    focus, a link or an outside click closes). Without script th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
2026-11-01 CAD: insert pilots that fit their screws, notes that match the joints, the turret contract from the TM face (#137, #133)
    Geometry:
    - riser: TM pilots 9.5 -> 13 mm (the plinth tray's M5 x 16 tips end 11.5 mm down) and dowel holes 8 -> 9.5 mm on
    Ø12 bosses under the ring (8.5 needed: 8 of each 16 mm pin is in the tray)
    - compute plinth columns: M5 pilots 8 -> 12.5 mm (the pan base's M5 x 16 ends 11 mm down; solid to 16)
    - stand dock: the short M3 insert (94459A130, 4.3 mm) in 5.3 mm pilots, two on the bench BOM
    - tilt yoke: M4 x 12 (6 mm, 1.5 d, in the turntable's inserts; was M4 x 10, 1.0 d), its own BOM line (screw_m4x12_socket)
    - rig pod: four Ø10 corner bosses with M3 inserts (8.5 mm p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
    [fivebar.py, turret.py]
2026-11-01 Insert joints inventory: read the fixed CAD, findings that clear when their source is fixed (#137)
    - stale-note findings use Repo.present(): a fixed note drops its finding instead of stopping generation
    - mount.json in its TM frame (frame_t_above_face_mm); a tm-hand-check finding when hand_checks.tm_bolts disagrees
    with the TM-face moment or its source takes the lever from frame T
    - riser, plinth tray dowel, yoke (with its BOM line), stand dock (the insert the bench buys) and the rig pod lid
    (now a real family) read from their new constants
    - the rig's stated minimum "sets" 3.5 mm; tests flip the ToF arm (4.0) and the pendant clip (4.5) from owner to fix
    - tests: the fixed families have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
2026-11-01 Generators: repository-relative mesh and J501 sources, no host in the gates' example (#141 hand-off)
    The #141 hand-off patch, applied with this branch's regeneration because any byte change under cad/ invalidates the
    carrier receipts: cad/assembly.py names meshes from the repository root, cad/turret_box.py's j501_label() and
    cad/build_turret_box.py name J501 files from J501_DIR, and cad/turret_gates.py's gp-remote example no longer names a
    host (gp-remote picks one).
    [assembly.py]
2026-11-01 Leave the leg's joints to the leg's print-readiness work (coordinator's scope change)
    Reverts this branch's leg edits: the wheel link docstring (M6 x 40), screw_m6x40's use, and the rig assembly's stop
    post text (D53 pins), so leg.wheel_botwheel and leg.stop_posts keep their note findings for the leg's branch. The
    inventory's handling stays: those findings clear when their notes are fixed. The pod lid's assembly step stays.
    [fivebar.py]
2026-11-01 Landing menu: fit the open panel at 360 px, lay out without script, match the app bar
    Review of #144:
    - At 360 px and below the page margin is 16 px, so the open panel spilled 4 px past each side. It now uses
    that margin there.
    - The phone layout (button shown, links in the panel) is pure CSS, so the header no longer starts taller
    and jumps when the script arrives. With scripting off, `@media (scripting: none)` shows the links and
    hides the button.
    - The outside-click close is gone, so the menu behaves exactly like designer/kit/appnav.js on the other
    pages.
    - tools/test-site.mjs: overflow is checked with the menu open too; a missing Menu button fails at once
    with a clear message; a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
2026-11-01 Answer the review of 09046d7 (#142): wider rules, one exempt file, e2e frames
    - The home-path rule also catches a bare home directory, /var/home/<name>
    and the folded /-home-<name>- folder form; the tailnet rule also catches
    <tailnet>.ts.net with no host label. Neither changes any count.
    - Only the one vendored file that needs it is exempt (occt-import-js.js,
    whose upstream build embeds its builder's paths); the test now proves each
    exempt file still needs its exemption, so new vendored files are scanned.
    - In CI (GITHUB_ACTIONS) the shrink-only check fails when it cannot find the
    base commit, instead of skipping.
    - sim/turret_e2e.py records kept video frames from the repository ro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
    [turret_e2e.py]
2026-11-01 Leg pre-print: a layer-check screen of the leg's printed parts in three print orientations (#29)
    Re-resolves each single-part study's solve on the y (today), z (on edge) and x (on end) layer planes.
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2026-11-01 Leg: the pre-D53 notes and checks the stop pins left behind (#29)
    - cad/rig_integrity.py: the rig's leg allowances gain the four TPU stop sleeves on their pins. D53 drew each sleeve
    as a stretch fit (bore 0.2 mm under the Ø16 pin, 84.9 mm3 overlap) and listed it in fivebar.MATES, but the rig's
    checks were recorded on a leg without the pins (c2cf8dc) and never learnt it, so the rig build found 4 x 22 = 88
    interferences once the branches met (0054d45).
    - tools/rig_orders.py stopped on the bench's M8 insert, which no line buys since D53. B4c (the M8 insert for the stop
    posts) is dropped with its puller and washer, and B3's sleeve block now holds the Ø16 pin in a blind hole drawn as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
    [fivebar.py]
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2026-11-01 Leg: press-fit holes drawn for the printed band, lead-ins at the bed-face mouths (#29, D74)
    - PRINT_HOLE_COMP (0.125 mm on the diameter, the middle of the assumed -0.20 to -0.05 a printed vertical hole closes
    up; coupon C1 measures it). The knee-eye sleeve holes go from 17.96 to 18.125 (printed: -0.06 to +0.10 mm on the
    DIN 179 sleeves instead of +0.10 to +0.26, 53 MPa hoop and 19 kN to press). The RS-04 dowel holes go from 4.94 to
    5.155, a close bonded fit (37 MPa hoop at the tight end instead of 178): the dowel locates the motor in its own H7
    hole.
    - MOUTH_CHAMFER 0.5 x 45 deg where a press-fit hole opens on the bed face: the knee sleeves (upper link), the inner
    apex 61812 (front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
    [fivebar.py]
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2026-11-01 Leave the knee bearing's catalogue note to the leg's print-readiness work
    bearing_6301 is the knee's bearing, and any byte change in catalog/hardware.json re-exports the leg attachment
    manifest, which the landing reel's receipt binds. The leg's branch owns the leg's catalogue now (coordinator's scope
    change); the corrected note (s0 1.13 at 3,672 N, exports/leg/fea/summary.json R3) is listed for it in #145.
2026-11-01 Leg pre-print review: answer the review (#147)
    - Finding 3 and D74 state the insert-preload condition the inventory sets (the cheek bears on the brass face); D74's
    case rests on the 851 N fault tension against the 1,500 N humid pull-out, and no longer compares fixed creep steps.
    - The layer-check notes: "S_s needed" is a lower bound at today's worst corner; tensile rows below their share of S_z
    have a finite S_s; the hip frame passes every row on end but is 274 mm tall and its bores turn horizontal.
    - The damping behind 364 N is assumed (20 % of shorted phases), not measured; no rig scenario has the bumper.
    - Brims: 3 mm at most on the hip frame at 45°. Play: about 0.38 mm worst case, 0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
2026-11-01 Turret and body exports regenerated for the insert-joint fixes; cut previews and part thumbnails re-rendered (#137)
    On the aarch64 CAD host at b48b4f3 (cad-agent v0.6.0, its own venv; the RS-04 vendor STEP and the BOM thumbnails in
    references/vendor as on the earlier body runs):
    - cad/build_turret.py --no-render, cad/turret_studies.py --hand-checks, cad/turret_assembly.py
    - cad/build_body.py --no-render (the full 22-stance clash sweep)
    - tools/export-turret-cut-previews.py (at ba0946f): the STLs are byte-identical, the STEPs differ in their headers
    Locally (the same CadQuery 2.8.0, pyvista 0.49.1, VTK 9.6.2 as the last receipt): tools/part-media-generation.py
    --render --check, 29 exact-sourc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
    [adapter_plate_front.step, adapter_plate_rear.step, bay_door_front.step, bay_door_rear.step, bay_floor_5052-H32_0.063in_x1.dxf, bay_floor_5052-H32_0.063in_x1.step, bay_rail_l.step, bay_rail_r.step]
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2026-11-02 Body strength cases and the sections page regenerated at the turret's real centre (#137)
    On the aarch64 CAD host at b48b4f3 (cad-agent v0.6.0): cad/body_studies.py --no-anim (all nine cases) and
    cad/body_sections.py, after the body build in the previous commit.
    - D2, the head's 30 g tip-over, now takes the turret from exports/turret/mount.json: 2.57 kg with its centre 135 mm
    above the TM face (it took D49's 1.70 kg budget at 100 mm). The deck reads SF 1.21 against the 2.0 target (was
    2.12): FAIL. This is an owner decision (raise the budget and stiffen the deck under the riser, or lower the turret).
    - D1 front and riser 5.52 / 5.90, T1 and the five S cases unchanged: pass.
    - docs/body-se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
2026-11-02 Insert joints inventory regenerated from the regenerated exports (#137)
    python3 research/insert-joints/inventory.py, then --check and --cad-agent <cad-agent dev 8fa60d2>/src:
    46 families, 151 inserts on the robot, 2 fixes (both the leg's: the wheel link's M6 note and the rig page's stop
    posts, left to the leg's print-readiness work), 11 owner decisions, 11 checks. The cross-check through cadagent
    (7 stacks from geometry, 15 from the tip depth, 8 preloads) disagrees nowhere.
2026-11-02 leg: print-ready FEA record, generated print-package summary and chart
    The leg FEA and layer check re-run at f58ce4d on the compute host (cad-agent v0.6.0, as the records pin):
    exports/leg/fea and research/leg-preprint/evidence. screen.py now writes the print package's summary and
    section 8 from that evidence, against dev's record, with the printed strength each short layer row needs
    (S_s, or S_z where through-layer tension alone fails), and figure.py draws the before/now chart from the
    same rows. Tests check the needed strength puts each row back at its target.
    Folds in the #147 review's nits: the preload ratio's condition, the assumed (not measured) damping,
    E_z from the pa6_cf_z row, the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
2026-11-02 leg: print-ready exports from the compute host (build_leg, rig_bench at e53ab4e)
    The leg's printed parts as STEP, STL and 3MF in print orientation, the BOM with the DIN 433 wheel
    washers, the print plan and renders; the bench coupons that follow the leg (knee eye with hole
    compensation and lead-in, the knee seat at the 6301's width, the new hip-frame pin coupon), the B3
    sleeve block, and puller_m8 removed. Only parts whose geometry changed are replaced: the others
    differ only by platform tessellation and keep their committed files. rig_orders, the joint inventory
    and the screen regenerated from them.
    [apex_spacer.3mf, coupon_frame_pins_m01.step, coupon_frame_pins_m01.stl, coupon_frame_pins_nom.step, coupon_frame_pins_nom.stl, coupon_frame_pins_p01.step, coupon_frame_pins_p01.stl, coupon_frame_ring_m01.step]
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2026-11-02 rig: integrity record at e53ab4e: 86 screws, 22 poses, 0 failures, with the D53 stop-sleeve stretch fits declared
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2026-11-02 RS-04 fit job resliced from the re-run mounting receipt at 22db4c9 (#137)
    PYTHONPATH=<cad-agent 2ad4269>/src python tools/package-fit-job.py --out <fresh dir> was run with the
    workstation's Bambu Studio. The job was copied in and zipped without directory entries; the zip has the same 31
    entries as before.
    The coupon's source mesh is byte-identical. The slice matches within the slicer's float noise: 172.44 g, 65.17 m,
    and 6 h 32 min 53 s against 6 h 32 min 59 s; docs/rs04-fit-job.md gives the new time. The recipe is unchanged.
    These pass: tools/package-fit-job.py --verify (with the pinned toolkit), tools/test-fit-job.py,
    tools/test-print-provenance.py.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
    [sliced.3mf]
2026-11-02 Site: a design status board from the records, and a wall-of-text gate (#150)
    - tools/status-board.mjs: one panel a subsystem (leg, turret, body, wheels, rig, electronics), built when the site is
    built from committed records only: cad-agent gate verdicts, strength studies against their own targets, the
    insert-joint inventory, the leg's pre-print screen, print plans and release flags, bench measurement sheets, mass
    against D71. Below target is amber, under 1.0 or a fix is red, not measured is hatched grey. Each panel shows git's
    newest commit to its records and a render of the real part. On the landing page (after the cad-agent loop; three
    meters a panel, a swipe row on phones) and P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
2026-11-02 leg: coupons C3 and C4 drawn, C4's FEA, seat coupons from the bed face; review fixes (#148)
    - cad/rig_bench.py: C3's flange blocks (sleeved, plain) and wheel-foot blocks (M6 on a DIN 433), and C4's knee-end
    coupon with dev's stub and the drawn one, cut from the real upper link and printed as it is. coupon_knee_boss and
    coupon_apex_eye now open their seats on the bed face with the leg's lead-in, as the links do.
    - research/leg-preprint/c4_fea.py: the FEA of C4 itself at 1 kN, which gives the load at which each stub's root should peel.
    - cad/fivebar.py: front_link() and wheel_link() read their fillets from P when they are called, so sweeps change
    them; the comments quote the rerun's numb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
    [fivebar.py]
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2026-11-02 Review fixes: the turret's centre in both frames, the head's labels from the ledger, the dock's screws (#137)
    From the independent review of #145:
    - cad/turret.py prints and writes the centre in frame T (com_frame_t_mm) and from the TM face (com_from_tm_face_mm).
    turret.json's com_from_mount_mm was frame T's under a TM-face name, the same mislabel #137 fixed in mount.json.
    - The body's head labels come from the ledger, not the 1.70 kg budget: body_sections' mass-gate text,
    body_studies' D2 label, and body_layout's turret item.
    - Turret stand: the dock adapter's M3s go no longer than its base + 5 mm, the inserts go in flat, and the seat is checked
    flat afterwards. Recorded in the part n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
    [turret.py]
2026-11-02 leg: E1 study media at the 1.60 record; coupons C3/C4 and the flipped seat coupons exported; hip-frame mesh check
    - The hip-frame E1 movie is re-rendered from the reproduced field, captioned SF 1.60 at 4 mm and 1.40 at 3 mm (this
    branch's mesh study), and its checker pins the new surface.
    - rig_bench at a18b73e (compute host): coupon_c3_sleeved/plain/wheel and coupon_c4_today/pr2. coupon_knee_boss and
    coupon_apex_eye now open their seats on the bed face. The leg's BOM and print plan say the stop pins are epoxy-bonded.
    - Section 8 gains the hip frame's 3 mm gate: E1 1.40 and R3o 0.98, so the frame's rows are screens.
    [coupon_apex_eye_m01.step, coupon_apex_eye_m01.stl, coupon_apex_eye_nom.step, coupon_apex_eye_nom.stl, coupon_apex_eye_p01.step, coupon_apex_eye_p01.stl, coupon_c3_plain.step, coupon_c3_plain.stl]
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2026-11-02 leg: second-review fixes: C4 conditioned humid and cut 90 mm back, C3 creep per mm, stale numbers (#148)
    - C4: the prediction is humid, so the coupon is conditioned humid first (sheet: dry and conditioned mass); the
    knee end is cut 90 mm back so the clamp's 20 mm stays about 50 mm from the stub's root.
    - C3: the blocks clamp 13 mm against the frame's ~77; the creep is reported per mm of clamped plastic and scaled.
    - The washer's area (61 mm2) and the screw's engagement (7.4 mm) in fivebar.py and the catalogue; the 6301 in the
    bench page and the README.
    - The hub-root fillet the review found room for is noted for the revision that takes C1's numbers.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
    [c3-through-bolt.csv, c4-boss-root.csv]
2026-11-02 Site: the status board's second review: weighed rows, gates with none to fix, sheets being measured (#151)
2026-11-02 Site: "what changed", a dated timeline of design changes from git (#150)
    Each first-parent commit that changed CAD, geometry, renders, hardware or
    decisions, or added a record: git's date, the PR title's first clause,
    subsystem chips from its paths, the decisions it added or revised, and the
    render it changed before and after, copied from git's objects. Newest 4 on
    the landing page, all 40 on Progress (8 shown, the rest folded), and
    /site/timeline.json. Changes slide in as they come into view; reduced motion
    and no script keep them still.
    npm run test:timeline reads git again: dates, PRs, decision diffs, image
    blobs byte for byte, and no CAD/hardware/decision commit skipped.
    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
2026-11-02 Site: answer the review of the timeline (#152)
    - Release merges (dev into main) and syncs are opened into the pull
    requests they carry, so main, which publishes the site, shows the same
    changes as dev, never a "Release" card. Tested by building from main.
    - A decision moved within the file is revised, not new; titles are read
    from the decisions file as it was in that commit.
    - "Nothing skipped" applies the generator's rule, written out again, to
    every pull request and direct commit in the span, over all design paths.
    - The newest dot marks only the first visible change; the lede gives the
    span of dates; alt text names the change.
    - Progress shows the newest 5 before the fold, keepi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
2026-11-02 Site: design notes without walls of text (#150)
    Every note rendered from docs/, research/ and hardware/ goes through
    tools/doc-page.mjs, which changes how it is shown, never what it says:
    - a lead card: git's date, length, sections, and for a one-subsystem note
    that subsystem's render and first three status-board readings;
    - status strips over tables whose Status/Verdict/Result/State column is a
    real scale, counted from the table (requirements, insert joints, body frame);
    - folds: each stretch of prose between pictures is kept under about a screen
    (opening kept, then a short first paragraph, then the heading as summary);
    pictures, diagrams and strips never fold; long outlines go two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
2026-11-02 body_sections: the head's mass source from the ledger item's basis, not its label; the inventory regenerated (#137)
    f697e07 quoted the turret item's label where it meant its mass basis. docs/body-sections.md is regenerated, and
    only that sentence changes: it now reads "from exports/turret/mount.json (the budget when larger)".
    research/insert-joints is regenerated with the review round's changes: the dock record's screw-length limit, and the
    plinth's hanging mass from the new turret.json (831 g). The counts are unchanged: 46 families, 151 inserts, 2 fixes
    (both the leg's), 11 owner, 11 checks.
2026-11-02 Carrier and RS-04 lug receipts regenerated at 79d7c05 on the x86 CAD host (pinned toolkit 2ad4269) (#137)
    The review round changed cad/ and catalog/, and every one of these receipts hashes both, so they were run again with
    receipts.sh 79d7c05: the five carrier receipts, then cad/rs04_lug_checks.py --export. The insert-fit and lug
    outputs were copied in as before.
    The check ids, results and flags are all the same:
    - 58 base-board checks;
    - 58 connector-support rows;
    - 398 lug rows (322 pass, 40 warn, 8 fail);
    - 2 insert-fit specimens.
    Only source hashes and STEP headers changed. The STL and 3MF files are byte-identical. These pass locally:
    - tools/test-rs04-lug-stacks.py;
    - tools/test-base-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
    [C3-support-candidate.step, C3-support-layout.step, base-anchor.step, carrier-boss.step, carrier-support-candidate.step, carrier-wiring-candidate.step, carrier-wiring-layout.step, coupon_frame_ring_nom.step]
2026-11-02 RS-04 fit job resliced from the mounting receipt at 4db8ebb (#137)
    The same recipe as 28b2863 was used. `PYTHONPATH=<cad-agent 2ad4269>/src python tools/package-fit-job.py --out
    <fresh dir>` ran with the workstation's Bambu Studio. The job was copied in and zipped without directory entries, and
    the zip still has 31 entries.
    The result is 172.44 g, 65.17 m and 6 h 32 min 55 s, which is slicer float noise; docs/rs04-fit-job.md gives the new
    time. Both `tools/package-fit-job.py --verify exports/leg/rs04-fit-job` and `tools/test-fit-job.py` pass.
    [sliced.3mf]
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2026-11-02 Site: timeline labels wrap anywhere, so a pull request's merge-ref subject cannot widen the phone page
    On a pull request, CI builds `refs/pull/N/merge`. Its head commit is the synthetic "Merge <40-hex sha> into
    <40-hex sha>". When the PR changes design files, tools/timeline.mjs lists that commit as the newest change, and its
    label carries the unbreakable sha. At 320 px the landing page then scrolls sideways (scrollWidth 415), which fails
    test:notice and test:loading-hero's overflow checks. dev's own pushes never have that commit, so dev stays green.
    I reproduced this locally with a CI-like merge commit on origin/dev. With `overflow-wrap:anywhere` on `.tl-label`
    the page is 320 px wide, and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
2026-11-02 Answer the #159 review: meter counts footprints, build.sh names the cad-agent it needs, doc states every assumption
    - The status board's 3D-body meter subtracts footprints with findings, not findings.
    - build.sh stops with a clear message when CAD_AGENT has no library command.
    - The doc lists every body assumption (pins, peg, lug, unverified tables, J15's
    second lug), all three board differences, and that the oval peg slot locates the
    holder but may not grip it.
    - generate.py drops the footprint-drawing helpers the library replaced.
2026-11-02 Carrier and RS-04 lug receipts regenerated at e90a000 on the x86 CAD host (pinned toolkit 2ad4269) (#29)
    `receipts.sh e90a000` ran the five carrier receipts, then `cad/rs04_lug_checks.py --export`, and the outputs were
    copied in as on #145. The check ids and results are the same as this branch's last receipt: 398 lug rows (342 pass,
    42 warn, 14 fail), 58 base-board checks and 2 insert-fit specimens.
    The hip frame and the frame-ring coupon STLs change because this branch's D74 hole compensation and lead-ins change
    that geometry. Everything else differs only in source hashes and STEP headers.
    These pass locally:
    - test-base-board-interfaces;
    - test-carrier-co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
    [C3-support-candidate.step, C3-support-layout.step, base-anchor.step, carrier-boss.step, carrier-support-candidate.step, carrier-wiring-candidate.step, carrier-wiring-layout.step, coupon_frame_ring_nom.step]
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2026-11-02 Status board test exercises a part with two missing models; pin depth measured from the seat
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2026-11-02 Body sheet-metal study: answer the review (#155, PR #158)
    - The riser's feet keep their inserts in A: a deck PEM there would be loaded on its head side (the feet are
    solid legs under the TM bolts). deck_2b re-quoted without them (1.20).
    - Margins against the M5 8.8 screw's proof load (x9.7), not the nut's axial strength.
    - D2's 1.38 / 1.95 read as a comparison (both peaks at the riser feet's mask edge); the rigid-pad rows
    marked reported-only; B's rivets hand-checked (about 230 N a rivet, 3.3x IFI-114 shear); B's total
    saving over A is $4; C's deflection an upper bound; C drops the isolators; the 3.7 N m tightening
    explained; browser logs trimmed from the price records.
    Co-Authored-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
    [deck_2b_5052-0.125_x1.dxf]
2026-11-02 Motor day: every rung at or under the PLA cap, power-cut knee loads checked, ladder uses --cap (#156)
    - The stand-up, squat and power-cut rungs run at 12 N m (were 20, above the PLA
    cap); the generator refuses a stand cap above the PLA cap.
    - Knee FEA rows are also checked at the power cut's knee load (fault target 1):
    the front link's R1 comes to 1.17, so L6 is flagged as a close call.
    - Ladder commands carry --cap and --half-mass (the simulated 11.1 kg); the cap
    is no longer set by hand with rig.rs04 (rig.run overwrote it with 60).
    - The derating table's knee column is the knee pin (was the apex joint).
    - MD-02 gets the hip-to-knee and adapter dimensions.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
2026-11-02 Motor day: review fixes (#157)
    - Power cut: rows scaled by their worst joint (knee or hip) and the
    backdriven hub torque, against target 1, separately from the PLA cap; the
    simulation adds the damped power cut. A deliberate undamped cut is not on
    the PLA ladder unless every row holds.
    - Mass: the simulated forces are scaled by the stand's larger mass (weight at
    the foot or inertia) over the simulated mass; no ballast; --half-mass is
    the scale reading; the page gives the heaviest stand the cap holds.
    - Ladder commands carry --damper 0; hub torque compared with the clamp.
    - rig.run: --cap reaches the HIL backend; a run without --cap refuses to
    raise a lower limit_torque held in the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
    [run.py, test_rs04.py]
2026-11-02 Motor day: the damped power cut is skipped until B1; wording (#157)
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2026-11-02 Motor day: the package regenerated after the review fixes (#157)
    sim.json by tools/motor_day_sim.py (adds the damped power cut), everything else
    by tools/motor_day.py at 8433333; slices unchanged.
    [drill_template.3mf, drill_template.step, end_plate.step, foot.3mf, foot.step, other-vendors.csv]
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2026-11-02 Loading-hero test: take the handoff baseline after the screenshot
    The delayed-entry case measured the hero, then took the loading screenshot,
    then released landing.js. At 844x390 the hero is taller than the viewport,
    so Playwright captures it beyond the viewport; Chromium briefly resizes the
    viewport for that, and on a slow runner scroll anchoring leaves the page
    20 px further down. The hero never moved in the document; the test blamed
    the screenshot's scroll on the scene load, so the required loading job
    failed intermittently on unrelated PRs.
    Follow the rule test-hero-preview already uses: fonts and the screenshot
    are setup, so take the strict baseline after them and two frames, while
    the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
2026-11-03 Site dark theme: system preference plus a header button
    web/theme.css holds every page colour as a --gp-* token, a light set and a
    dark set (deep green page, cream ink, lighter orange, warm brown tiles); every
    stylesheet uses the tokens. web/theme.js, loaded first in <head>, applies the
    reader's stored choice before the first paint, handles every .theme-toggle
    button (landing nav, app bar, Talk, file viewer) and keeps the choice in
    localStorage only. The build fails if a page does not load both first.
    The WebGL stage sky and the Play yard follow the theme, the file viewer has a
    Gyropup dark palette, Mermaid diagrams are drawn in the page's theme and redrawn
    on a change, and renders drawn on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
    [sim.js]
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2026-11-03 Landing highlights recaptured at cb5c453 for the theme's source hashes
    The reel's guard binds the simulator's stylesheets, stage, app bar and notice,
    which the dark theme moved onto colour tokens. The recorder runs in the light
    theme, so the footage is the same light page; all 480 frames, nine mechanism
    shots, three hits and three knockdowns.
2026-11-03 README banner: review fixes (#167)
    - The generator link pointed at mvalancy/mvalancy's main, where the generator has not
    landed yet (404). It is now pinned to the pushed commit, ac04a7d, which resolves.
    - The tagline and alt text said the robot balances; the status is CAD and simulation,
    no assembled robot. Now "designed to balance ... CAD and simulation in the open".
    - The MIT chip wrapped onto its own row; the licence badge already says MIT, so the
    banner keeps three chips on one row.
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2026-11-03 CAD pictures and view from the five-bar robot: cad/robot_view.py, cables.py on the five-bar route
    cad/robot_view.py puts the robot together as drawn today (the P3 body, both
    five-bar legs at 300 mm, the turret on its riser) and writes exports/robot/*.step
    for cad-agent view plus cad/assembly.png and cad/exploded.png, which showed the
    retired serial leg. cad-agent.yaml's view now reads those STEP files.
    cad/cables.py checked the serial leg's thigh/shin harness. It now measures
    fivebar.cable_points() (split out of fivebar.cable(), same route) over the
    leg's range: length, tightest bend, and with --clash the swept-cable check.
    [cables.py, fivebar.py]
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2026-11-03 Rig predictions at D71's 18.75 kg a leg; mass-dependent pass/fail limits follow it (#8)
    rig/run.py's DESIGN_KG moves from 14.75 kg (the 29.5 kg body plan) to D71's 18.75 kg, half the
    37.5 kg design mass. The scenarios the rig runs are unchanged: the stand-up still starts from the
    bumpers at 140 mm, and the CAN backend's motor-day ladder passes its own --half-mass. Re-run on
    the current dev leg with python -m rig.run --predict, --faults and --reproduce:
    - stand-up 16.5 N m (was 14.0), squat 16.7, jump 164 mm at the 60 N m cap (was 207), wheel 2,667 N;
    - S6, the undamped power cut onto the stops: 2,027 N on a knee (was 1,713);
    - every injected fault stops as designed; T7 passes.
    rig/criteria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
    [run.py, test_control.py]
2026-11-03 Pictures: the real turret and a VLP-16 that looks like one, in the robot view and the body's renders
    cad/body_layout.py keeps the turret as a Ø172 can (its mass and height, the P1
    dummy) and the VLP-16 as a plain cylinder: right for the ledger and the checks,
    wrong in a picture, where the can reads as a broken turret. tools/robot_view.py
    now draws the turret from cad/turret.py and the VLP-16 with its window band and
    cap; tools/body_pictures.py redraws build_body's and body_views' pictures with
    the same swap (the layout and its checks are unchanged).
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2026-11-03 Rig review: --half-mass required on the motors; the load plate judged at the carried weight (#8)
    From the independent review of #170:
    - rig.run --backend can refuses to start without --half-mass. With the new 18.75 kg default, the
    gravity feed-forward on a rig still ballasted to 14.75 kg (15.1 kg carried) would hold the leg
    high: in the review's simulation, the stand-up held at 316.5 mm. The motor-day ladder already
    passes --half-mass. The bench doc's C7, S1, B5 and S2 commands now do too, with where KG comes
    from (exports/rig/rig.json's ballast table, or a scale).
    - S1's load plate is judged against the run's own carried mass (half_mass_kg in the run's meta)
    +-25 N, not a fixed wi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
    [compare.py, run.py, test_control.py]
2026-11-03 Pictures from the current CAD: robot view, README pictures, five-bar harness, README hero
    - exports/robot/*.step + robot.json and cad/assembly.png, cad/exploded.png:
    tools/robot_view.py, fleet job 113 (cpu-b) at 68f7bd4.
    - exports/leg/cables.json, cables.png: tools/leg_cables.py --clash, same job.
    The drawn route's tightest bend is 7.5 mm (rule 3 asks 20) and the swept
    cable runs 107-124 mm3 into the rear upper link: both open.
    - docs/hero.jpg: tools/readme_hero.py, fleet job 112 (cpu-c) at 853969a. The
    turret now stands on its compute plinth (D66); 2400 x 1100 as before.
    [battery.step, bay_doors.step, brackets.step, bus_bars.step, cameras.step, compute.step, deck.step, ear_pods.step]
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2026-11-03 Landing highlights recaptured at 0b0c8b6 for the new theme tokens
    The reel's guard binds web/theme.css, whose colour tokens this PR changes.
    The recorder runs in the light theme; all 480 frames, the encoder and the
    guard pass unchanged.
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2026-11-03 Site follow-ups (#106): CI's merge commit opened in the timeline, Under/Over controls, docs point at #31/#66
    - tools/timeline.mjs: GitHub's pull-request merge commit ("Merge <sha> into <sha>") is opened like a
    release, so a CI preview shows the pull request's commits instead of that subject. tools/test-timeline.mjs
    reads it the same way by its own commands, and a fake history checks the rule (it fails without it).
    - tools/test-status-board.mjs: the mass strip's Under/Over wording is checked at, below and above the
    gate with a ledger made up for the test, not only at the committed ledger.
    - docs: the handoff, the docs map, the readiness guide and the base-board checklist point at #31 (p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
2026-11-03 Review fixes (#176): the preview/dev note, the gate's own number in the Under/Over check, every line linking the fit job
    - tools/timeline.mjs: the docstring says a preview's list is finer than dev's one merge unit, not other.
    - tools/test-status-board.mjs: the control reads the gate from the ledger and fails with the strip's text.
    - tools/test-fit-job.py: any Markdown line that links the fit job and gives a gram figure must give the
    receipt's (outside the archive and the agents' inbox), beyond the two docs that quote the full estimate.
    - hardware/carrier-packaging: the envelopes point at #66, which took over #96 and #85.
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2026-11-03 Insert joints phase 2 (#137): run the joints through cad-agent's insert and limiter checks
    research/insert-joints/phase2.py reads joints.json (not regenerated) and runs each joint
    through cad-agent v0.18.2's cadagent.formulas.inserts, cadagent.formulas.limiters and
    cadagent.mechanical.inserts (check_joint, check_clamp). It sets each result beside
    inventory.py's own figure or verdict with a stated tolerance, and every disagreement and
    skip carries its reason. It writes phase2.json (SI inputs with their source fields,
    toolkit outputs, ratio, the toolkit tag and commit, the sha256 of joints.json and of the
    generator) and phase2.md.
    Of 271 comparisons on 41 of the 46 joints, 196 agree and 75 do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
2026-11-03 Body #26: exports and receipts regenerated for the pad retention on the recording mechanical compute host
    At 7c96890 on the aarch64 CAD host. Body record on cad-agent v0.6.0: cad/build_body.py --no-render,
    cad/body_bom.py, cad/body_sections.py. The receipts whose source closure hashes cad/body_*.py, on the
    pinned toolkit 2ad4269: cad/rs04_lug_checks.py --export (into a fresh folder, copied in; exit 1 for the
    known support failures as before), the RS-04 support probe (complete), the three carrier-connector
    checks, cad/check_base_board_interfaces.py and the carrier insert fit (generate + verify). Then
    research/insert-joints/inventory.py locally: the four pad joints join body.printed_clamps (47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
    [C3-support-candidate.step, C3-support-layout.step, adapter_plate_front.step, adapter_plate_rear.step, base-anchor.3mf, base-anchor.step, base-anchor.stl, bay_door_front.step]
2026-11-03 Insert joints phase 2 (#137): address review of #177
    - Melt volume is now taken at the as-printed hole: the drawn pilot less 0.25 mm, the
    middle of the toolkit's printed-hole allowance. The drawn-hole figures are still
    recorded. 7 of the 12 melt disagreements now agree, and the claim that no melt needs
    the pocket is gone.
    - PA6-CF pull-out bands and margins are scaled by 22.67 / 25.5 to the inventory's humid
    basis. mapping.materials records which way the stand-in sheet errs. On that basis the
    TM riser's low-end margin is 1.58.
    - The wheel bolts are checked on their own DIN 433 face, through bearing_area with the
    head turning on steel: 1.18 N m. At that torque the preload is 649-1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
2026-11-03 Review fixes (#175): the lips clear the x 0 screw heads, the web prints on a chamfer, the lip screws snug with threadlocker and a Ø9 washer ordered
    - cad/body_battery.py: a lip stops LIP_HEAD_CLEAR (4 mm) short of a low side-plate screw it does not take,
    so the x 0 M3 x 6 heads (Ø5.5) seat on the side plate, not 1.75 mm onto both lips. The web gets a 45 deg
    solid chamfer down to the lattice's outer face (pad_web_chamfer): the upright print has no 5.65 mm ledge,
    and its foot stays 38.4 mm over the ground, above the 30 mm stroke. The ledger's solid-TPU row counts it
    (pad_solid_volume_mm3). The side plate's low hole note names both screws.
    - The lip screws clamp 3 mm of TPU 95A, which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
2026-11-03 Body #26: exports and receipts regenerated at df492b4 (the review fixes)
    On the recording mechanical compute host (aarch64) at df492b4: cad/build_body.py --no-render,
    cad/body_bom.py, cad/body_sections.py on cad-agent v0.6.0, then the carrier-connector checks, the
    base-board interfaces and the carrier insert fit on the pinned 2ad4269. The RS-04 lug receipt ran on
    this x86 workstation on the pinned 2ad4269 (installed with its metadata, so the receipt's toolkit row
    reads 0.4.2): 322 pass, 40 warn, 8 fail as before (exit 1, the known support failures).
    Integrity: bay_pad_1..4 clean (grip 7.05 mm with the 0.8 mm washer, engagement 3.71 mm); the x 0
    heads clear of the lips. The BOM orders 8 x 91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
    [C3-support-candidate.step, C3-support-layout.step, adapter_plate_front.step, adapter_plate_rear.step, base-anchor.step, bay_door_front.step, bay_door_rear.step, bay_floor_5052-H32_0.063in_x1.step]
2026-11-03 turret: relieve the tilt yoke's bridge for the CT latch head (#61)
    cad-agent's motion_aim gate found the Ø16 latch head 1.7 mm into the yoke
    bridge from -22.9 deg to the -25 deg stop (51.5 mm3). The bridge is now cut
    by the head's swept envelope (1 mm clearance, 2 deg past the stop); the
    notch is ~365 mm3 at the bridge's front top corner. Tests pose the pair
    across the range, with a control showing the unrelieved bridge is hit.
    [turret.py]
2026-11-03 Body #26: receipts regenerated at e25a5d2 (after the thumbnail re-render changed catalog/)
    Body exports, BOM and sections, the carrier connector checks, the base-board
    interfaces and the carrier insert fit on the recording mechanical compute
    host (cad-agent v0.6.0 for the body, the pinned 2ad4269 toolkit for the
    receipts); the RS-04 lug receipt locally on the pinned toolkit (322 pass,
    40 warn, 8 fail: unchanged counts, only its source hashes move).
    [C3-support-candidate.step, C3-support-layout.step, adapter_plate_front.step, adapter_plate_rear.step, base-anchor.step, bay_door_front.step, bay_door_rear.step, bay_floor_5052-H32_0.063in_x1.step]
2026-11-03 Body #26: the retained RS-04 fit job resliced on the regenerated lug receipt
    Same coupon, same slice (6 h 32 min 46 s, 172.41 g, 65.16 m); job.json binds
    the new checks.json. Verified with package-fit-job.py --verify and
    tools/test-fit-job.py.
    [sliced.3mf]
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2026-11-03 Body #26: body STEPs back to the bytes the part-media catalogue records
    a5e496a's body re-export rewrote only the FILE_NAME timestamp in 37 STEPs, which broke 10
    catalogue source hashes (tools/part-media-generation.py --check). No receipt binds the
    body STEPs' bytes, so they return to e25a5d2's; --check passes for all 29 parts.
    [adapter_plate_front.step, adapter_plate_rear.step, bay_door_front.step, bay_door_rear.step, bay_floor_5052-H32_0.063in_x1.step, bay_rail_l.step, bay_rail_r.step, bay_side_5052-H32_0.063in_x2.step]
2026-11-03 Turret lid snaps: the declaration and cad-agent snapfit v0.18.2 (#131)
    cad/turret_snaps.py holds every snap dimension of wave 1's two lids (the
    board bay lid: 2 latches; the hopper lid: 3), the shared barb/ridge
    profile, the loads and the friction bounds. research/snap-fits/snaps.py
    writes snaps.yaml from it, runs `cad-agent snapfit` at v0.18.2 and
    writes summary.json with the checks the toolkit does not make: pull-off
    at the high bound against the 50 N hand load, totals per lid, the
    hopper's curved tongues, layer shear in the barb and ridge, the tongue
    bent out of plane, and the wall backing to the release.
    Every toolkit row passes (PETG, 'along', repeated use). Hopper lid:
    retention 14.9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
2026-11-03 Turret: snap latches on the board bay lid and the hopper lid (#131)
    Each latch is a PETG tongue lying in its lid's plane, outside the wall it
    catches, with a 30/30 deg barb on its free end over a ridge on that
    wall: push on, pull off, no tool. Both lids print with the tongues in
    the bed plane, so they bend along the layers.
    - board_bay_lid: two latches (top and bottom edge, one turned 180 deg,
    so it fits either way up), L 25, h 2.5, b 8.58, undercut 1.0; pads on
    the lip back the bay's 1.2 mm walls behind the ridges. The lip now
    fuses to the plate (it stood 0.01 mm off: two solids).
    - board_bay: two ridges by the rim.
    - hopper_lid: three curved latches (footprints centred 60/180/300 de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
    [turret.py]
2026-11-03 turret #61: keep this PR to the CAD fixes and the passing gates
    The turret box rebuild moves the web scene (86 parts, the pan axis 90 mm
    higher in the box), which needs the turret motion reference, the model
    part counts and the landing highlights regenerated. That goes in its own
    follow-up on fix/turret-box-rebuild; this branch returns the scene, the
    box exports, the frame test and the privacy ratchet to dev's.
    [barrel.stl, base_board.stl, base_board_carrier.stl, base_board_inserts.stl, base_board_screws.stl, base_carrier_inserts.stl, base_carrier_screws.stl, board_bay.stl]
2026-11-03 Insert joints phase 2: rebind to the joints.json from #175
    #175 regenerated joints.json: body.printed_clamps grew from 18 to 22
    joints (47 to 55 screws, adding bay_pad_1..4). #177 had recorded the
    earlier file's sha256, so on dev phase2.py --check exits 1 and
    test_phase2.py fails test_current and test_bound_to_joints_and_toolkit.
    Rerun against cad-agent v0.18.2. The results are unchanged: 41 joints
    evaluated, 5 skipped, 203 agree, 68 disagree. The skip reason now counts
    the group's joints from joints.json, so it cannot go stale again.
2026-11-03 turret #61: receipts regenerated on the merged head (cad/turret.py moved the closure)
    On a6f6ab8 (dev with #175, plus this branch): the carrier connector checks,
    the base-board interfaces and the carrier insert fit on the recording
    mechanical compute host (pinned 2ad4269 toolkit); the RS-04 lug receipt
    locally on the same pinned toolkit (322 pass, 40 warn, 8 fail: unchanged,
    only its source hashes move).
    [C3-support-candidate.step, C3-support-layout.step, base-anchor.step, carrier-boss.step, carrier-support-candidate.step, carrier-wiring-candidate.step, carrier-wiring-layout.step, coupon_frame_ring_nom.step]
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2026-11-03 turret #61: the yoke notch's floor rounded R1; the relief follows the stop (review of #178)
    - thumb_sweep rounds the swept head's bottom edge by its 1 mm clearance, so
    the notch's floor meets its wall on an R1 instead of a sharp re-entrant
    corner 2.5 mm from the bridge's root fillet; the head still clears by 1 mm
    there. The notch is 360.5 mm3 (was 365.5), the same extent.
    - The sweep ends 2 deg past G.tilt_min instead of a repeated TILT_STOP_DEG.
    - test_the_latch_head_clears_the_yoke_to_the_stop measures the gap from
    -22.9 deg on (> 0.98 mm), not only zero overlap.
    - The rotor-lead ball's comment says the model's corner is zero-radius; the
    bundle's own bend radius is not checked by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
    [turret.py]
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2026-11-03 Turret gates: the hopper lid snaps on after the hopper's screws (#131)
    The wave-1 hopper lid's latch at 60 deg sits over the hopper's 45 deg lug, so
    the fastener gate's hex-key envelope hit it (28.9 mm3, 52 mm above the head).
    The lid is fitted last and comes off for service, which is now the declared
    assembly step; the gate reports the reach through it as a service-access
    warning instead of a failure.
2026-11-03 Turret lid snaps (#131): cut-part previews re-exported and the media catalogue refreshed
    at 113ddb1 (cad/turret.py is unchanged since); --render --check passes all 29.
    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
    [cradle_plate_l.step, cradle_plate_r.step, pan_clamp.step, stop_lug.step]
2026-11-03 Turret lid snaps (#131): gates pass and receipts regenerated at 1bf8c95
    - Gates (61c957a, recording mechanical compute host, cad-agent v0.6.0): all
    pass; fasteners warns that the hopper lid comes off before the 45 deg hopper
    screw can be reached.
    - Receipts on the pinned 2ad4269 toolkit: the carrier connector checks, the
    base-board interfaces, the carrier insert fit (host) and the RS-04 lug
    receipt (local; 322 / 40 / 8, unchanged).
    [C3-support-candidate.step, C3-support-layout.step, base-anchor.step, carrier-boss.step, carrier-support-candidate.step, carrier-wiring-candidate.step, carrier-wiring-layout.step, coupon_frame_ring_nom.step]
2026-11-03 Turret lid snaps (#131): the retained RS-04 fit job resliced on the new lug receipt
    [sliced.3mf]
2026-11-03 Turret lid snaps (#131): RS-04 support probe regenerated at 9bc8183
    [od118-id80-t2.032.step, od118-id80-t3.175.step, od118-id94-t2.032.step, od118-id94-t3.175.step, od120-id80-t2.032.step, od120-id80-t3.175.step, od120-id94-t2.032.step, od120-id94-t3.175.step]
2026-11-03 tools/turret-fea-refresh.py: re-solve one turret part's FEA and merge it into the record
    A full cad/turret_studies.py run is 28 studies and now takes hours on the
    compute hosts (the pan pinion's 290k-tet solves alone run 2 h each), and
    --only leaves summary.json untouched. This re-solves the named parts with
    turret_studies.run(only=...), replaces only their results in the committed
    summary and rebuilds the verdict and table as run() does. The test checks
    that mirror against the committed record, that a merge leaves every other
    result as it was, and refuses a missing part or a different mesh.
2026-11-03 turret #61: the tilt yoke's FEA re-solved with its rounded notch
    tools/turret-fea-refresh.py tilt_yoke on a mechanical compute host (cad-agent
    v0.6.0, mesh 2.5), merged into exports/turret/fea/summary.json; every other
    part keeps its recorded result (their geometry is unchanged). Layer-aware SF,
    dev's record in brackets: R-fall-down 2.45 (2.4), R-fall-side 1.44 (1.47; its
    peak moves into the notch), R-fall-side+ 4.44 (4.44), E-push-up 1.66 (1.66,
    below its 2.0 target on dev already). The turret verdict is unchanged.
2026-11-03 turret-fea-refresh: test against run()'s own source, keep every refresh, keep the record's order (review of #178)
    - The mirror test evaluates the verdict and table expressions it takes from
    cad/turret_studies.py's run() (by AST, no CAD kernel), so a later change
    there fails it; the committed summary must equal both.
    - `refreshed` is a list: each refresh appends its parts, reason, masses,
    commit, cad/turret.py SHA-256 and cad-agent version. The committed entry
    gets the 4bcd8e0 run's provenance.
    - merge() replaces each (part, case) in place, so non-adjacent parts keep the
    record's order; a new case goes after its part's last.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
2026-11-03 turret_gates: fingerprint every geometry source, test the coverage (review of #181)
    geometry_fingerprint() hashed turret.py, turret_base_board.py and turret_boards.py but not turret_snaps.py, so a
    stored gate result read as current after the lids' snap constants changed. GEOMETRY_SOURCES now lists every file
    the turret's geometry is built from: turret_snaps.py, gmi.py and the data read at import (cad/interfaces.json,
    catalog/interfaces.json, catalog/materials.json).
    cad/test_turret_gate_sources.py walks turret.py's imports (transitively, the cad/ modules) and the .json files
    their top-level code names, and fails on any not listed; print_provenance (imported in main() for the export
    record)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
2026-11-03 turret lid snaps: resize for the combined root strain and the root's layers, key the hopper lid (review of #181)
    The tongues bent out of their plane by the pull at the barb (their narrow 8.6 mm width) added up to 0.32 % of
    strain at the root's corner on top of the in-plane bending: 0.96 % (hopper) and 0.91 % (bay) against 0.771 %
    at the high friction bound. The root blocks' layers took the tongue's moment as a twist of 9 MPa against 10.
    Resized (cad/turret_snaps.py), each tongue's width now its own s_lo..s_hi:
    hopper lid L 26, h 2.0, b 24 (s -9..15), root block 8 x 6.3: combined 0.515 % (mu 0.60), 0.490 % (0.35);
    retention 14.5 N vs 13.0 N; pull-off and push-on 42.8 N vs 50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
    [turret.py]
2026-11-03 Leg #8: the leg record re-solved on the regenerated rig results
    On the recording mechanical compute host at a0140a3 (cad-agent v0.6.0,
    conda-forge gmsh): cad/leg_studies.py --mesh 4 (exports/leg/fea), the
    layer check, the hip-frame E1 field and the print-ready hip-frame study at
    4 and 3 mm (research/leg-preprint/evidence). Hip frame, layer-aware SF at
    4 / 3 mm: R1 1.62 / 1.37, E1 1.6 / 1.4, E3o 2.04 / 2.01, E3i 2.21 / 2.39,
    R3o 1.01 / 0.99.
2026-11-03 Leg #8: the leg screen, its sheets and the print package's blocks from the new record
    research/leg-preprint/screen.py and figure.py on the re-solved leg FEA.
2026-11-03 Leg #8: motor-day package and bench doc from the new leg record; screen golden on the new axle loads
    tools/motor_day.py and tools/bench_doc.py read the re-solved record: the PLA
    cap stays 12 N m (wheel_link R1w 2.13 at it). The proof-block golden takes
    the record's new R3 / R1 axle loads (1811.8 / 938.3 N, were 1830.7 / 945.3).
    [drill_template.3mf, drill_template.step, end_plate.step, foot.3mf, foot.step]
2026-11-03 Leg #8: E1 field re-exported against the new leg record; movie receipts and media docs at SF 1.60 / 1.40
    The field receipt bound the earlier summary, so the movie renderer refused it.
    The solved E1 field is unchanged and the MP4 is byte-identical.
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2026-11-03 Insert joints: inventory and phase 2 rebound to the re-solved leg record (#8)
    joints.json reads exports/leg/fea/summary.json's hub joint moments: R1
    115.7 -> 114.9 N m and R3 190.1 -> 188.1 N m (sf_tip 1.52 -> 1.53).
    Phase 2 re-run on cad-agent v0.18.2 for the new joints.json hash; its
    results are unchanged (41 evaluated, 5 skipped, 203 agree, 68 disagree).
2026-11-03 Turret #131: receipts regenerated at 5ac7496 (carrier connectors, base-board interfaces, carrier insert fit, RS-04 lugs)
    Carrier and base-board receipts on the pinned 2ad4269 toolkit on the
    recording mechanical compute host; the RS-04 lug receipt locally on the
    same pin (322 pass / 40 warn / 8 fail, unchanged).
    [C3-support-candidate.step, C3-support-layout.step, base-anchor.step, carrier-boss.step, carrier-support-candidate.step, carrier-wiring-candidate.step, carrier-wiring-layout.step, coupon_frame_ring_nom.step]
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2026-11-03 Recorded voice for every fixed line, and one pronunciation key for every voice
    Gyropup is now said "gyro pup". designer/character/pronunciation.json maps a
    written name to a plain respelling: whole-word and case-insensitive, keeps 's
    and plural endings, never inside URLs or domains, idempotent. pronounce.js
    (browser) and tools/pronunciation.py (sidecar, renderer) apply the same file;
    stress is set by splitting (space: separate stressed words, hyphen: one word
    stressed first), the one form espeak and browser voices both honour.
    Every fixed line now lives in designer/character/lines.js (talk.js, sim.js
    intros, the landing page, the talk demo). tools/render-voice.py records each
    with the sidec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
    [sim.js]
2026-11-03 Turret lid snaps: no hopper latch is first contact upside down; 0.6 mm undercut floor (review of #181)
    The latch at the back stood 6 mm above the rest of the turret at the -25 deg
    stop, and the latch tops were level with the hinge lugs at tilt 0, so an
    upside-down landing could load a tongue. The hopper latches move to 0, 120
    and 240 deg (the back is left to the flap's hinge lugs; the 90/270 beam
    keep-out and the cartridge board stay clear) and their tops drop 2.5 mm
    below the lugs (s -6.5..17.5, b 24 kept). Upside down at every 2.5 deg from
    0 to -25 every latch is 1.59 to 2.5 mm below the lugs and the flap
    (test_no_latch_is_first_contact; control: the fa7e3c4 layout is the top,
    5.98 mm abov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
    [turret.py]
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2026-11-03 Highlights recaptured for the moved voice lines (review of #185)
    The reel's guard binds designer/character/talk.js and designer/sim.js, whose
    fixed lines this PR moves into lines.js. Recaptured at 7ce6684 through an owned
    ephemeral listener; the unchanged encoder and guard pass. No pixels depend on
    the change: the reel has no audio.
2026-11-03 Turret #131: RS-04 lug receipt at 06ef3ad (322 pass / 40 warn / 8 fail, unchanged)
    [coupon_frame_ring_nom.step, dyno_lug_plate.step, hip_frame.step]
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2026-11-03 Pronunciation key: same whitespace and word rules in JS and Python, tighter domains, Bullseye (review of #185)
    - Whitespace in the key's protect pattern and in multi-word matches is spelled
    out (JavaScript's \s), so Python with re.A splits text the same: a URL ending
    in a no-break space no longer differs between the two sides.
    - Bare domains need a common top-level domain, and their port, path and query
    are protected too: "Gyropup.Want", "Mr.Gyropup" are said right, and
    "gyropup.com:8080/Gyropup?q=Gyropup" is left alone.
    - Latin letters bound words on both sides: "éGyropup" is left alone.
    - talk.js waits a minute after a failed manifest fetch instead of refetching
    (and waiting up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
2026-11-03 Turret assembly steps 7-12 re-rendered with the latched lids (#131)
    cad/turret_assembly.py: the hopper lid's latches at 0/120/240 deg and the
    board bay lid's latches now show in the step pictures (they showed the lids
    as before #131). Steps 1-6 differ only by renderer noise (18 px at most) and
    keep their committed bytes.
2026-11-03 Turret lid snaps: the upside-down exclusion holds for square landings; supported latch tops lightly loaded (review of #181)
    A roll of about 4 deg or more makes a side latch the turret's top (the lugs
    sit about 12 mm off the roll axis, those latches about 48 mm): the reason now
    says an off-square top landing can break that latch. The latches' supported
    top faces carry the out-of-plane bending's peak, 1.93 MPa: lightly loaded,
    not unloaded.
2026-11-03 Empty-space gate: answer the review of #186
    - Pixel check: a column of colour changes 64 px tall or more (a card's side,
    a border, a rule, a timeline spine) is not content, so a blank band inside
    nested bordered boxes still fails.
    - DOM: an <svg> counts by its painted shapes, a chart drawn in HTML
    ([data-visual], a rendered diagram) by its painted parts, and a button only
    with a fill or border, so a decorative layer stretched over a section
    cannot hide a gap.
    - Columns: words and lines are counted per block, so inline markup cannot
    hide a squeezed link; diagram labels and text broken by <br> are left out.
    - Screenshots hide fixed elements and only sticky elements that are stuck.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
2026-11-03 Restore the section spacing and seller-name fixes
    The previous commit picked up the merge base's landing.css and
    portal-parts.css from a before/after measurement run in progress. This puts
    back the screen-sized section step (with the closing card's symmetric
    padding) and the seller-name flex basis.
2026-11-03 Turret lid snaps: gates, previews and receipts at 2b2d604 (after the dev merge)
    Gates fingerprint 0d15369f63dc0bbe, fasteners 35/35; component preview
    manifest from the recording host with the committed STEP bytes kept;
    carrier and base-board receipts and the RS-04 lug receipt (322/40/8)
    regenerated for the receipt closure.
    [C3-support-candidate.step, C3-support-layout.step, base-anchor.step, carrier-boss.step, carrier-support-candidate.step, carrier-wiring-candidate.step, carrier-wiring-layout.step, coupon_frame_ring_nom.step]
2026-11-03 Turret lid snaps: reslice the RS-04 fit job against the regenerated receipts
    Same slice: 172.41 g, 65.16 m of filament, 6 h 32 min 48 s.
    [sliced.3mf]
2026-11-03 Turret lid snaps: RS-04 support probe at 9f9096d
    [od118-id80-t2.032.step, od118-id80-t3.175.step, od118-id94-t2.032.step, od118-id94-t3.175.step, od120-id80-t2.032.step, od120-id80-t3.175.step, od120-id94-t2.032.step, od120-id94-t3.175.step]
2026-11-03 Turret lid snaps: re-render turret.png with the snap-on hopper lid
    The overview still showed the hopper lid from before the snaps (no latches, lugs or flap). Re-rendered from
    cad/turret.py's render() with cad-agent v0.6.0 at the final CAD; turret-section.png and turret-pan-joint.png
    differ only in render noise, so they are not committed.
2026-11-03 timeline: fold text-only changes even when none of the newest has a picture
    The open list already ended on the last change with a picture, but only on
    Progress and only when one of the first few had a picture. A pull request
    that ends on several receipt, fit-job or probe commits put five text-only
    changes at the top, and the home page and Progress both grew a wall of text
    (tools/test-walls.mjs failed on #181).
    Now the rule is the same on both pages: the open list ends on the last
    picture among the newest `show`; with no picture there, only the first two
    stay open and the rest fold under "N earlier changes". The home page folds
    its own tail too. A new control in tools/test-timeline.mjs plant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
2026-11-03 walls: run the text-only timeline control under SITE_URL too; plain rail after a fold
    Review on #189: CI sets SITE_URL, so the control was skipped there. It
    fulfils both pages from the local dist/, so it now runs either way, and it
    reports a page with no #changes section instead of planting nothing. Under
    SITE_URL on the old renderTimeline it fails with 1347 and 1841 px.
    The open list shown after a folded text-only run keeps the plain rail; only
    the newest list fades from the accent.
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2026-11-04 Motor thermal model: start (issue #194)
2026-11-04 Motor day: review fixes (#191)
    - The Ø6 socket drill goes to 5.5 mm at the tip so the full diameter
    reaches 3.5 mm.
    - The case's locating features are holes in the STEP, but the drawing's
    callout reads like pins: look first, leave the dowels out if pins.
    - The mass line is stated as read: 7 kg for four boxed motors.
    - The one-printer paragraph is split into shorter sentences.
    - The RS-04 is "arrived", not "arriving".
    - --no-render compares the whole BOM item map stored with the drawings
    (drawings/sheets.json).
    - print_queue() checks the phases and the step numbering.
    [bom.csv, other-vendors.csv]
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2026-11-04 Link the motor thermal model from the leg bench tests, body frame and docs map
    The bench tests log the temperatures the model's re-fit needs and keep a
    PLA hip frame's motor cases under 50 C; the body frame notes the rear
    covers' 2 mm gap to the cheeks and the recommended heat path.
    Issue #194.
2026-11-04 CI: run the motor thermal model's tests in the mechanism suite
    Standard library only; the CadQuery geometry check skips there.
    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
2026-11-04 Diagrams inventory: 10 published diagrams (the motor thermal page's heat path)
    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
2026-11-04 Motor thermal model: review fixes (PR #195)
    - Move the model and its tests from cad/ to sim/: the RS-04 lug receipts
    hash every .py under cad/, and two new files there changed their
    source closure (CI's mechanism and retained-fit-job failures).
    - The stand: the rear covers face the plywood 2 mm away, so they lose
    nothing there (the robot already modelled the cheek); the PLA limit
    falls from 8.3 to 6.8 N m at 25 C. A second limit with the case bare
    and shaded (eps 0.3, 30 % exposed), and the page now leads with the
    stop rule: a motor's case over 50 C.
    - Driving: the fore-aft tyre force at the contact patch (the hub motor's
    stator is fixed to the wheel link): 18.27 N m rms on the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
    [motor_thermal.json]
2026-11-04 Motor thermal model: re-review fixes (PR #195)
    - The stand's plywood end plate covers the whole rear face, not just the
    cheek's overlap: the PLA limit at 25 C is 6.1 N m (3.1 bare and shaded).
    - The drive_fx_g sensitivity rescales from the drive case's own static
    torque and d tau / d Fx (recorded by loads()), not the 300 mm stance.
    - Every extra key of an input (tray_top_m2's L_m) goes into the JSON.
    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
    [motor_thermal.json]
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2026-11-04 kit/gamepad: reusable standard-gamepad component (input, bindings, config dialog, diagram)
    A self-contained ES module folder with no Gyropup imports: hot-plug for
    several pads, the W3C standard mapping under Xbox names, radial stick dead
    zones with a full-scale point and response curve, trigger dead zones,
    per-axis inversion, rumble behind a feature check, action bindings
    persisted in localStorage (try/catch, memory fallback) with reset, a
    rebind capture that ignores inputs already held, and a native <dialog>
    settings UI with a live SVG controller diagram. Polling is tied to
    requestAnimationFrame (or the page's own frame) and never touches
    keyboard or mouse events. Unit tests run under node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
2026-11-04 firmware reference: the tilt range is the CAD's stops, checked against limits.json (#201)
    tilt_never_above_level becomes tilt_within_stops, and tilt_range_is_the_cad_stops fails
    if config.py's TILT_MIN/MAX_DEG drift from exports/turret/limits.json.
    [config.py, host.py, test_firmware.py, turret_fw.py]
2026-11-04 turret: studies of the tilt range above level (#201)
    cad/turret_tilt_range.py sweeps every tilting part, and the envelope and beam reserved
    for the #203 rangefinder, against the pan group and the fixed base at every pan from 0 to
    +45 deg, the stop pair left out, and reports the first tilt that closes a gap below the
    margin and the room the -y arm leaves for the upper stop sector. sim/turret_feed.py
    --elevated feeds and parks the hopper at +10 to +40 deg.
    [turret_feed.py]
2026-11-04 docs: D77, the tilt range is the real mechanical stops; the never-above-horizontal rule goes (#201)
    The decision quotes the owner and keeps every other turret safety rule (hold-to-ARM,
    the 105 fps ceiling of D68, the chronograph trip, the head-zone prediction). The rule
    is replaced in the plans, sections, firmware and physics notes and the dossier (R3), and
    marked superseded in the research. The aiming laser's class (Class 2) is an open item.
2026-11-04 Leg limits per build profile, soft stops and command window in the balance firmware (#202)
    sim/leg_limits.py derives the leg's protection limits once, into exports/leg/limits.json:
    the RS-04 torque per leg build from the record's FEA rows (the PLA bench leg's 12 N m from
    the motor-day derating; the PA6-CF + 6061 robot leg's 61 N m every day, governed by the
    hip frame's knee-out stop post at SF 2, and 69 N m in a jump's push only, governed by the
    front lower link's R1 row through the knee force the jump sweep measures), the rms limit
    (the RS-04 stall table's rated 28.5 N m over the winding's 30 s, as PR #195 takes it), the
    soft stops, the measured-angle window and the commanded leg-length win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
    [fwlib.py, gp_app.c, gp_app.h, gp_config.h, gp_control.c, gp_control.h, gp_guard.c, gp_guard.h]
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2026-11-04 Playground: designer/leg_limits.js, the firmware's command rates and reach window for the sliders and gamepad (#202)
    createLegLimits() slews height, pitch, leg difference and drive speed at gp_model.h's rates
    and fits each leg inside exports/leg/limits.json's commanded window at its lean (the
    firmware's gp_guard_clamp_L), clamping rather than refusing. tools/test-leg-limits.mjs
    checks the rates against the header, the table against the generated file, and that no
    random pose leaves the window. Not yet called from designer/sim.js: the hook is a few lines
    in the live frame loop, left to the gamepad PR, which re-records the highlights reel that
    hash-binds sim.js anyway.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
2026-11-04 Highlights recaptured at 1fc6135 for the gamepad wiring (sim.js, turret_bench.js, kit/gamepad)
    The reel guard binds the simulator sources the capture loads; this PR
    changes sim.js and turret_bench.js and adds sim_gamepad.js and the kit
    modules, so the old receipt no longer matched. Same recipe, encoder and
    guard; mechanism nine shots, target practice three shots, three hits,
    three knockdowns.
    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
2026-11-04 Docs: the leg protection audit, per-build torque and the 60 vs 120 N m jump; D78 replaces D33's cap (#202)
    docs/leg-protection.md: every layer from command to plastic with what existed, the gap, what
    was added and its test; the every-day, peak and rms derivation for the robot's leg and the
    PLA bench leg; the rig's jump at 30-120 N m with the gearbox and knee loads. D78 quotes the
    owner's question. docs/body-firmware.md takes the new limit_torque, reasons 17-18 and
    refusals 6-7 (and hil/fwlib.py's names for them); the docs map links the page.
    [fwlib.py]
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2026-11-04 RS-04 motor tool: review fixes for PR #209 (#206)
    - STOP (button, Space, Esc, a hidden tab) while the arm step runs cancels it: the page never arms or enables after
    a STOP, and stops the motor again if the enable was already on the bus; Playwright covers the race.
    - The jog keeps its target within (jog torque - Kd x jog speed) / Kp of the motor's angle, so the commanded torque
    stays at the jog torque without counting on the motor's own limit_torque clip.
    - The overspeed stop watches the armed motor, in the jog loop and the poll, whichever motor is selected.
    - Both guards refuse a set-id to 0 or over 127 and a NaN limit_torque read-back; new vector scenarios cover them.
    - The bridge compa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
    [guard.js, rs04_bridge.py, rs04_guard.py, rs04_vectors.py, tool.js]
2026-11-04 Build page: "Print these now" card from the motor-day print list; home page link
    The motor-day print order (exports/motor-day/prints.csv) was only reachable from
    Design notes. The Build page now opens with it: one line per print step, in order,
    with time, filament and the file to download, plus links to the plan, the zip and
    the CSV. The home page's Build step links straight to it. Generated from the CSV on
    load, so it follows tools/motor_day.py; fail-soft if the CSV cannot be read.
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2026-11-04 Review of #205: ARM stays off after blur until pressed again; capture, takeover and hop fixes
    - sim_gamepad.js: a hidden tab or window blur releases ARM and latches it
    off until the pad reports ARM let go (a level check alone re-armed on
    the next frame).
    - control.js: the input that finishes a capture keeps the actions
    suspended until it is released, so a rebind press never also fires.
    - gamepad.js: a pad that takes over a slot releases the old pad's held
    buttons before the disconnect.
    - bindings.js: only own action names (Object.hasOwn).
    - sim.js: the hop's 151.9 mm is the hip's rise above standing, as in the
    rig; the wheels clear by that plus the tuck (to ~266 mm, as the rig).
    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
    [sim.js]
2026-11-04 Print-now card: land the deep link on phones; fit tag from phase 0; stricter tests
    - After the card fills in, scroll to it again when the URL is #print-now: on a phone
    the card is ~1,500 px tall and scroll anchoring left the jump past it.
    - The "fit check" tag and the lede's count come from the CSV's phase 0, not the
    position; rows with an empty or non-positive order are skipped (Number('') is 0).
    - Tests: PLA and TPU grams against the CSV, the card's totals against the ones
    docs/motor-day.md publishes, a rejected fetch, and a browser check that the deep
    link starts the card on screen at 390 and 1280 px with a download and a preview
    per file.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
2026-11-04 Robot sim: the reach window and soft stops in controller_v2; the rms limit from the merged heat model (#202)
    sim/controller_v2.py clamps each leg's commanded length to the window at its lean
    (leg_limits.clamp_L, the C gp_guard_clamp_L) and runs each leg motor's torque through the
    soft stops before the clip, as the firmware does (guard=True by default).
    sim/test_controller_v2_guard.py checks both without building the robot.
    #195 has merged: leg_limits reads exports/leg/thermal/motor_thermal.json (its calibration's
    r_wc_k_per_w and c_w_j_per_k), so the rms limit is no longer pending. It stays the motor's
    28.5 N m: the model finds the PA6-CF hip frame overheats the motor even driving under
    20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
    [controller_v2.py, leg_limits.py, test_controller_v2_guard.py]
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2026-11-04 test-build-portal: run the print-now deep-link check in its own browser context
    Verified it fails without the fix (the card started at -1503 px at 390 px wide).
2026-11-04 Motor day: the RS-04 case has holes, not pins; drill the dowel holes to 13 mm
    Owner, 2026-11-03: the case has two Ø5 locating holes and no pins; the
    only pins are the three Ø6 on the output. Phase 0.3 and assembly step 3
    lose the holes-or-pins hedge, and the measured table records it.
    The frame's and the coupon's dowel holes are 12.0 deep (all four STEP
    exports), so a bottomed Ø5 x 16 stands 4.0 proud into the case's 4.5 mm
    hole: 0.5 mm of nominal clearance. Until the CAD changes, the page has
    the printed holes drilled to 13 mm with a 5.0 mm drill (3.0 proud, 1.5
    clear; checked to stay in solid material).
    tools/test-rs04-dowel-protrusion.py reads the hole depths from the STEP
    files' B-r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
2026-11-04 Playground hop: stop the push short from a low start
    From a Height below about 0.55 a full push already carried the hip past
    its apex (226 mm above standing from a full crouch) and the wheels left
    the ground only by the legs snapping up at about 11 m/s. The push now
    ends where at least 50 mm of the rise is flight, and the tuck goes below
    the push height, so the hip tops out 152 mm above standing from every
    start (wheels 117-260 mm up, legs at most 2.5 m/s). Starts from 0.55 up
    are unchanged. test-gamepad runs jumpPose across start heights.
    [sim.js]
2026-11-04 Hardware folders per component and the robot Jetson's deployment (#210)
    hardware/<category>/<component>/ for every part the robot uses, all with one skeleton:
    - a README with References, Interfaces, Config and profiles, Driver, Inventory, Bring-up and tests, and Open
    questions;
    - interfaces.md;
    - versioned config JSON;
    - inventory.json.
    The components:
    - actuators: rs04, with its bring-up checklist, and wheel-hub-motor (D69);
    - drives: flipsky-75100;
    - sensors: vn100-imu, vlp16-lidar, d435-depth-camera;
    - power: ina228-monitor, dcb609-packs;
    - compute: balance-mcu, robot-computer (which Jetson is open);
    - comms: pcan-usb;
    - turret: turret-controller.
    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
    [wheel-vesc.json]
2026-11-04 turret: tilt-range and elevated-feed results (#201)
    tilt-range.json: fleet job 124 on cpu-b (sha cce0d00, --up 45 --step 2.5
    --pan-step 10). The feed servo under the dial drops onto the fixed pan
    pinion near pan 0: 3 mm margin to +14.75 deg, contact past +17.25 deg.
    feed-elevated.json: fleet job 125 on cpu-c (sha cce0d00, --elevated).
2026-11-04 Motor day: review fixes (#212)
    - The dowel holes are drilled with a 5.2 mm drill, which keeps the
    CAD's slip fit for the epoxy (a 5.0 drill would make the m6 dowel a
    press fit in PLA). The page now accepts 2.5 to 3.5 mm proud, and the
    C1 row no longer sets these holes from PRINT_HOLE_COMP.
    - Removed the drill-shank fallback. If a dowel will not slide into the
    case by hand, do not force it. The case-hole depth is measured with a
    dowel: 16 minus what stands out.
    - Step 3: wipe the epoxy squeeze-out flush, then check the protrusion
    after the cure.
    - The test reports complex surface entities, handles reversed axes,
    widens HOLE_R with a clear message, and checks the drill-out and th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
2026-11-04 Hardware folders: review fixes for PR #213 (#210)
    - The bridge's default interface is rs04, the stable name to give the PCAN-USB, never can0, which on the J501 is the
    module's own bus C. The bring-up checklist covers the laptop and the Jetson cases.
    - Adapter names drop "-" (systemd escapes it in the device unit). can-names.conf reads its last line without a
    newline and refuses one match with two names. The udev trigger replays CAN interfaces only, and the install says
    a rename applies on the next plug-in. --help prints the header only, and the root message no longer re-splits
    the arguments. New tests cover all of these.
    - check-hardware: a JSON pointer that does not resolve is repor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
2026-11-04 D76: refresh the cut-part previews and part thumbnails for the new turret source
    The cut parts' geometry is unchanged (float noise only); the preview manifest now binds the D76 cad/turret.py. The body thumbnails follow the regenerated body STLs.
    [cradle_plate_l.step, cradle_plate_l.stl, cradle_plate_r.step, cradle_plate_r.stl, pan_clamp.step, pan_clamp.stl, stop_lug.step, stop_lug.stl]
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2026-11-04 Diagrams inventory: 11 published diagrams (the RS-04 motor tool's bridge path)
    dev reached 10 with the motor thermal page (842ebae); this page adds the 11th, which failed the presentation job's
    inventory check once the PR was brought up to date with dev.
2026-11-05 Leg limits: 61 N m in the push too (D78); free swing on the motor's torque-speed line; inertia bound over a locked wheel
    The owner's decision (2026-11-04): the robot's every-day 61 N m everywhere, the jump's push and each
    RS-04's limit_torque too (push_allows_nm keeps what the push rows would allow). The free swing's motors
    follow the RS-04's torque-speed line (clip_motor, as the jump sweep), so the unguarded runs no longer
    reach three times the no-load speed. The inertia survey also takes the wheel locked to its link (the
    hub motor holding or braking): 0.1688 kg m^2 worst, so the bound covers both. The playground's
    command passes the turn through (clamped next). limits.json is regenerated b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
    [leg_limits.py]
2026-11-05 D79 supersedes D71: no mass budget; the ledger is information
    The owner, 2026-11-04: "take out the weight budget." D71's 37.0 kg gate, its sub-budgets, its margin and the turret's
    2.6 kg ceiling are removed, with the tests that failed on mass over a budget. The ledger (exports/body/mass.json) stays,
    with the design mass the strength cases and the rig were run at (37.5 kg, 18.75 kg a leg). The status board's mass meters
    are information (grey, no limit). mass.json, body.json's mass section, docs/body-sections.md, mount.json and the bench
    BOM are regenerated.
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2026-11-05 D79: reslice the retained RS-04 fit job on the rebound lug receipt (172.41 g, 65.16 m, 6 h 32 min 46 s)
    The published archive (exports/leg/rs04-fit-job.zip) is rebuilt from the retained directory, and the two docs quote the
    new estimate (2 s shorter).
    [sliced.3mf]
2026-11-05 Turn clamp: assert the robot's centre of mass is at or below the hips (#204's h = 0.502 m)
    The P3 ledger's centre is 50.7 mm below the hips at its 300 mm stance, so at full height it is at most 0.451 m above
    the ground, under the clamp's h. A heavier or higher turret that lifts it above the hips now fails this test.
    [test_leg_limits.py]
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2026-11-05 Browser tests: follow the D76 box scene; load turret parts four at a time
    - The motion reference is regenerated from the new full-build snapshot
    (4769888) with CAD datums: TM face z 145, tilt axis 285, wheels at
    25, +-25.81. Group origins come from those datums, cross-checked
    against the scene's frames. 80 components, 46 poses.
    - Muzzle 150/270, laser 84.5/0/299.5, path start on the 285 tilt axis;
    current launch speed 28.96 m/s (95 fps set); 62 current turret parts.
    - Pocket-to-chute tolerance 0.05 mm: the pockets are the settled MuJoCo
    pile, 0.02 mm under the dial exit since the gates rerun.
    - The motion test raises the Resource Timing buffer; 80 meshes overflowed it.
    - designer/c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
2026-11-05 turret: the upper tilt stop at +12 deg, set from the mechanism (#201, D77)
    Geo.tilt_max = 12: the feed servo under the dial comes 3 mm from the fixed
    pan pinion at +14.75 deg near pan 0 (contact past +17.25) and 3 mm from the
    pan ring at +18.5 elsewhere; +12 leaves 2.75 deg for the lug's give and
    keeps about 17 deg of the upper sector on the -y arm.
    Every user of the old 0 deg stop takes Geo.tilt_max: the clash checks and
    sweeps (and the gate sweep) include the upper stop, the stop's FEA loads the
    raised sector with the push square to the barrel, the lidar study and the
    box clearance search above level too, the motion gate and the dossier joint
    cover -12..25 deg, and the robot, bench, box a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
    [turret.py, turret_motion.py]
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2026-11-05 docs: D77 with the +12 deg stop, the +10 deg firing limit and the green laser (#201)
    The owner's answers: the stop is set mechanically, resting on the raised
    stop is accepted if the checks pass, and a green pointer module replaces the
    red dot (its class from its label, Class 2 at most; the open item stays).
    D77 is mirrored into the dossier; no doc claims a Class 1 laser.
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2026-11-05 turret FEA: the yoke, cradle and stop lug re-solved at the +12 deg stop (#201)
    tools/turret-fea-refresh.py tilt_yoke stop_lug cradle (cad-agent 0.20.0).
    Layer-aware SF: tilt_yoke E-push-up 1.62 (was 1.66), R-fall-down 2.32,
    R-fall-side 1.47, R-fall-side+ 4.41; cradle E-push-up 1.50 (was 1.53),
    R-fall-down 1.87, R-fall-side 3.31; stop_lug E-push-up 2.24 on yield (was
    2.45). The below-target list is the same nine cases as before the move.
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2026-11-05 fix: reject stale motor-day explode and camera inputs
2026-11-05 docs: retain genuine motor-day visual bindings from fleet job 156
    [drill_template.3mf, drill_template.step, drill_template.stl, end_plate.step, foot.3mf, foot.step, foot.stl]
2026-11-05 fix: preserve validated slice inputs during picture refresh
    [drill_template.3mf, drill_template.step, drill_template.stl, end_plate.step, foot.3mf, foot.step, foot.stl]
2026-11-05 fix: apply query audio before the first talk mount
    [sim.js]
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2026-11-06 fix: emit owning body links in the generated motor thermal page
    [motor_thermal.py]
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2026-11-07 fix: resolve body frame through its canonical package
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2026-11-07 fix: regenerate evidence after canonical body imports
    [C3-support-candidate.step, C3-support-layout.step, base-anchor.step, carrier-boss.step, carrier-support-candidate.step, carrier-wiring-candidate.step, carrier-wiring-layout.step, coupon_frame_ring_nom.step]
2026-11-07 fix: refresh the source-bound RS04 fit package
    [sliced.3mf]
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2026-11-07 Give the spoken Gyropup name an explicit short word boundary
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2026-11-07 fix(turret): enforce separate firing bounds and applied tilt stops
    [test_turret_limits.py, turret.py]
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2026-11-07 Prepare bounded current turret scene collection with retained errors
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2026-11-07 Adopt reviewed current turret scene and retain model failures
    [barrel.stl, base_board.stl, base_board_carrier.stl, base_board_inserts.stl, base_board_screws.stl, base_carrier_inserts.stl, base_carrier_screws.stl, board_bay.stl]
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2026-11-07 fix: size E1 address-space bound for sparse assembly
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2026-11-07 fix: distinguish captured inputs from refreshed E1 inserts
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2026-11-10 test: bind Build guide fallback, version fixtures and persistent CI
    [one-base.stl, one-cover.stl, two-brace.stl, two-cap.stl, two-frame.stl]
2026-11-10 fix: keep unauthored fittings unplaced and bind guide progress
    [board_bay_lid.stl, dt_plug.stl, hopper_inserts.stl, laser_inserts.stl, laser_screws.stl]
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2026-11-10 Add genuine source-bound Robot and Combined assembly snapshots [skip ci]
    [L__apex_61812.stl, L__apex_circlip.stl, L__apex_spacer.stl, L__bearing_61812_front.stl, L__bearing_61812_rear.stl, L__eye_sleeve_front.stl, L__eye_sleeve_rear.stl, L__front_link.stl]
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2026-11-10 Connect verified hip projects to exact-part print preparation [skip ci]
2026-11-10 Exercise actual model workspace, playback and verified Print faults [skip ci]
2026-11-10 Pin candidate safety fix and strengthen scoped workspace observers [skip ci]
2026-11-10 Bind reviewed toolkit candidate and frame readable actual diagrams [skip ci]
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2026-11-10 Keep explicit version links bound to their indexed assembly [skip ci]
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2026-11-10 test: await actual print verification state [skip ci]
2026-11-10 fix: keep phone BOM identity and status columns reachable [skip ci]
2026-11-10 ci: pin browser runtime and preserve bounded presentation coverage [skip ci]
2026-11-10 test: seal fresh phone BOM visual contract [skip ci]
2026-11-10 media: freshly capture highlights for stage lifecycle closure [skip ci]
2026-11-10 docs: track desktop Build instruction docking fix
2026-11-10 Retain independently checked native frame evidence [skip ci]
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2026-11-10 Replace belly bay with conditional end holders and rigid sit supports
    [robot_v2.py]
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2026-11-10 fix(body): propagate fresh model outputs and source sensor frames
    [bay_pad_study.py, robot_v2.py, wheel_study.py]
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2026-11-10 fix(assembly): support isolated correspondence command imports
2026-11-10 fix(assembly): require the owning current correspondence module
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2026-11-10 Define honest browser frame and static preview test contracts [skip ci]
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2026-11-10 Plan current-body promotional capture through existing media tools [skip ci]
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2026-11-10 Bind current-body reel capture to accepted model bytes and complete inventory [skip ci]
2026-11-10 Plan fresh current-hero poster output through the existing hook [skip ci]
2026-11-10 Reserve fresh current-hero poster candidates before browser capture [skip ci]
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2026-11-10 test: require adopted current motion and preserve legacy fixture scopes
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2026-11-10 test: bind the interim-body laser check to its legacy fixture
2026-11-10 Adopt reviewed current CAD poster and highlight reel
    Copy the exact seven accepted media outputs from the frozen 76cc5b3d capture. Retain the original dependency failure and qualified opaque-document diagnostics alongside byte and decoder evidence.
2026-11-11 Retain stage state when the turret motion fixture times out
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2026-11-11 ci: scope the demonstrated stalled capture control to Chromium
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2026-11-11 fix(build): preserve planner pagination and filters during toolkit adoption
2026-11-11 fix(build): keep one-part printable checklist actions reachable
2026-11-11 fix(build): keep printed numbers readable and retain pending export warnings
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2026-11-11 fix(build): preserve readable annotated BOM checklists and failures
2026-11-11 fix(build): separate all procurement block notes in printable text
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2026-11-11 fix(build): preserve original print setup and part disclosures
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2026-11-11 Repair checklist acceptance framing and identity with preserved public failures
    [run.py]
